MarinGE23/axi-plpuf-ip/README.md

# axi-plpuf-ip
AXI4-Lite PLPUF IP for Xilinx/AMD FPGAs — Verilog core, C drivers, Vivado/Vitis projects, and validation apps for hardware security and embedded systems.
