MarinGE23/axi-plpuf-ip/vivado-axi-plpuf/vivado-axi-plpuf.runs/design_1_clk_wiz_0_0_synth_1/.vivado.begin.rst

<?xml version="1.0"?>
<ProcessHandle Version="1" Minor="0">
    <Process Command="vivado.bat" Owner="emari" Host="EMANUEL" Pid="20808" HostCore="8" HostMemory="014968041472">
    </Process>
</ProcessHandle>
