MarinGE23/axi-plpuf-ip/documento_tfg_emanuel_marin_overleaf/Documento_TFG_EmanuelMarin/agradecimientos.tex

%% ---------------------------------------------------------------------------
%% agradecimientos.tex
%% Agradecimientos
%% ---------------------------------------------------------------------------

\thispagestyle{empty}
\cleardoublepage

\begin{center}
  \vspace*{1.5cm}
  {\Huge\bfseries Agradecimientos}
\end{center}

\vspace{1.5cm}

A mi querida mamá, a mi familia y a mis amigos, por su apoyo incondicional a lo
largo de toda mi formación universitaria. Su confianza y paciencia fueron el
motor que me permitió llegar hasta aquí.

A los profesores de la Escuela de Ingeniería en Computadores y la Escuela de
Ingeniería en Electrónica del Instituto Tecnológico de Costa Rica, quienes con
su dedicación y exigencia me transmitieron no solo conocimientos técnicos, sino
también la disciplina y la curiosidad necesarias para enfrentar problemas
complejos. Cada curso, cada laboratorio y cada proyecto contribuyó a forjar al
ingeniero que soy hoy.

Agradezco especialmente al Dr.\ Jeferson González Gómez, quien me asignó este
trabajo final de graduación y confió en mis capacidades para llevarlo a cabo. Su
conocimiento en el área de seguridad de hardware fue
determinante para definir el rumbo del proyecto. 

A todos quienes de una u otra forma contribuyeron a la realización de este
proyecto, mi más sincero agradecimiento.

\vspace*{\fill}

\begin{flushright}
\scriptAuthor\\[1mm]
Cartago, June, 2026
\end{flushright}

\cleardoublepage

%%% Local Variables:
%%% mode: latex
%%% TeX-master: "main"
%%% End:
