MarinGE23/axi-plpuf-ip/documento_tfg_emanuel_marin_overleaf/Documento_TFG_EmanuelMarin/titlepage.tex

%% ---------------------------------------------------------------------------
%% titlepage.tex
%%
%% Title page
%%
%% $Id: titlepage.tex 1452 2010-07-07 00:55:16Z palvarado $
%% ---------------------------------------------------------------------------

\thispagestyle{empty} 

\begin{center}

{\large\bf{Tecnológico de Costa Rica}}

\par\vspace{15mm}

{\large\bf{Escuela de Ingeniería en Computadores}}\\
{\normalsize (Computer Engineering School)}

\par\vspace{20mm}

{\large\bf{Programa de Licenciatura en Ingeniería en Computadores}} \\
{\normalsize (Licentiate Degree Program in Computer Engineering)}

\par\vspace{15mm}



\par\vspace*{\fill}

{\large\bf{Diseño e Integración de un Módulo PLPUF Programable para Sistemas Embebidos}}
\\
{\normalsize (Design and Integration of a Programmable PLPUF Module for Embedded Systems)}

\par\vspace*{\fill}

{\large \bf{Informe de Trabajo de Graduación para optar por el título de Ingeniero en Computadores con grado académico de Licenciatura}}\\
{\scriptsize(Report of Graduation Work in fulfillment of the requirements for the degree of Licentiate in Computer Engineering)}

\par\vspace{20mm}

\large \bf{Emanuel Antonio Marín Gutiérrez}
\vspace*{\fill}

\normalsize {Cartago, Junio, 2026} \\
\scriptsize {(Cartago, June, 2026)}

\end{center}
%\newpage 
%\cleardoublepage 

%%% Local Variables: 
%%% mode: latex
%%% TeX-master: "main"
%%% End:
