MarinGE23/axi-plpuf-ip/documento_tfg_emanuel_marin_overleaf/Documento_TFG_EmanuelMarin/acta.tex

\thispagestyle{empty}

%%
%% Los nombres de lectores y asesor se definen en el archivo tribunal.tex
%%

\begin{center}
  \begin{tabular}{c}
    Instituto Tecnológico de Costa Rica \\
    Escuela de Ingeniería en Computadores \\
    Proyecto de Graduación \\
    Tribunal Evaluador \\
    Acta de Evaluación
  \end{tabular}
\end{center}

\vfill

Proyecto de Graduación defendido ante el presente Tribunal Evaluador como 
requisito para optar por el título de Ingeniero en Computadores con el grado 
académico de Licenciatura, del Instituto Tecnológico de Costa Rica.

\vspace*{15mm}

\begin{center}
  Estudiante: \\
  \emph{Emanuel Antonio Marín Gutiérrez}
\end{center}

\vfill

\begin{center}
  Nombre del Proyecto:\\ \emph{name_here}
\end{center}

\vspace*{20mm}
\begin{center}
 Miembros del Tribunal
\end{center}
\vspace*{8mm}

\vfill

\begin{center}
  \begin{tabular}{ccc}
    \rule{70mm}{0.5pt} & \rule{15mm}{0pt} & \rule{70mm}{0.5pt} \\
    \lectorI && \lectorII \\ %% Nombres definidos en tribunal.tex
    Profesor Lector && Profesor Lector
  \end{tabular}
  
  \vspace{10mm}

  \begin{tabular}{c}
    \rule{6cm}{0.5pt} \\
    \director \\ %% Definido en tribunal.tex
    Profesor Asesor
  \end{tabular}
\end{center}

\vfill

Los miembros de este Tribunal dan fe de que el presente trabajo de graduación
ha sido aprobado y cumple con las normas establecidas por la Escuela de Ingeniería en Computadores.

\vfill

\begin{center}
  Nota final del Proyecto de Graduación: \rule{3cm}{0.5pt}
\end{center}
\vfill

\begin{center}
  Cartago, Julio de 2026\par
\end{center}

\cleardoublepage

%%% Local Variables: 
%%% mode: latex
%%% TeX-master: "main"
%%% End:
