MarinGE23/axi-plpuf-ip/documento_tfg_emanuel_marin_overleaf/Documento_TFG_EmanuelMarin/disclaimer.tex

%\thispagestyle{empty}

\rule{10mm}{0pt}

\vfill

Declaro que el presente Proyecto de Graduación ha sido realizado enteramente por mi persona, utilizando y aplicando literatura referente al tema e introduciendo conocimientos propios.

En los casos en que he utilizado bibliografía he procedido a indicar las fuentes mediante las respectivas citas bibliográficas.  En consecuencia, asumo la responsabilidad total por el trabajo de graduación realizado y por el contenido del presente documento.

\vspace*{8mm}
\hfill
\vspace*{-10mm}
\begin{flushright}
\rule{60mm}{0.1pt} \\
\vspace*{5mm}
  Emanuel Antonio Marín Gutiérrez\par
    Céd: 7-0274-0530\par
  Cartago, [fecha]

\end{flushright}

\cleardoublepage

%%% Local Variables: 
%%% mode: latex
%%% TeX-master: "main"
%%% End:
