MarinGE23/axi-plpuf-ip/documento_tfg_emanuel_marin_overleaf/Documento_TFG_EmanuelMarin/Calificacion.tex

\vspace{3cm}
\includepdf[pages={1},scale=1.05,keepaspectratio, offset=70 -100]{acta_firmada/acta_firmada.pdf}
%\textbf{Pagina Reservada}
