MarinGE23/axi-plpuf-ip/documento_tfg_emanuel_marin_overleaf/Documento_TFG_EmanuelMarin/tribunal.tex

\thispagestyle{empty}

%%
%% Indique los nombres de los lectores y asesor
\newcommand{\lectorI}{name_here}
\newcommand{\lectorII}{name_here}
\newcommand{\director}{name_here}
%% Revise además que 

\begin{center}
  \begin{tabular}{c}
    Instituto Tecnológico de Costa Rica \\
    Escuela de Ingeniería en Computadores \\
    Proyecto de Graduación \\
    Tribunal Evaluador
  \end{tabular}
\end{center}

\vfill

Proyecto de Graduación defendido ante el presente Tribunal Evaluador como 
requisito para optar por el título de Ingeniero en Computadores con el grado 
académico de Licenciatura, del Instituto Tecnológico de Costa Rica.  

\vfill

\vspace*{20mm}
\begin{center}
 Miembros del Tribunal
\end{center}
\vspace*{8mm}

\vfill

\begin{center}
  \begin{tabular}{ccc}
    \rule{70mm}{0.5pt} & \rule{15mm}{0pt} & \rule{70mm}{0.5pt} \\
    \lectorI && \lectorII \\
    Profesor Lector && Profesor Lector
  \end{tabular}
  
  \vspace{10mm}

  \begin{tabular}{c}
    \rule{6cm}{0.5pt} \\
    \director \\
    Profesor Asesor
  \end{tabular}
\end{center}

\vfill

Los miembros de este Tribunal dan fe de que el presente trabajo de graduación
ha sido aprobado y cumple con las normas establecidas por el Área Académica de Ingeniería en Computadores.

\vfill

\begin{center}
  Cartago, Junio 2020\par
\end{center}

%\cleardoublepage

%%% Local Variables: 
%%% mode: latex
%%% TeX-master: "main"
%%% End:
