MarinGE23/axi-plpuf-ip/vivado-axi-plpuf/vivado-axi-plpuf.runs/impl_1/clockInfo.txt

-------------------------------------
| Tool Version : Vivado v.2025.1
| Date         : Thu Apr  2 01:15:43 2026
| Host         : Emanuel
| Design       : design_1
| Device       : xc7a35t-cpg236-1--
-------------------------------------

For more information on clockInfo.txt clock routing debug file see https://support.xilinx.com/s/article/000035660?language=en_US
