MarinGE23/axi-plpuf-ip/documento_tfg_emanuel_marin_overleaf/Documento_TFG_EmanuelMarin/solucion.tex

%% ---------------------------------------------------------------------------
%% solucion.tex
%% Marco metodológico
%% ---------------------------------------------------------------------------

\chapter{Marco metodológico}
\label{ch:solucion}

Este capítulo describe la metodología empleada para el diseño,
implementación, integración y evaluación del módulo PLPUF como
periférico AXI dentro de un \textit{System-on-Chip} basado en MicroBlaze~V.
Se presenta, en primer lugar, la estrategia metodológica adoptada y su
justificación; a continuación, el diagrama de la secuencia del proceso
seguido y la propuesta metodológica desglosada por objetivo específico;
seguidamente, las herramientas de desarrollo utilizadas y el diagrama
general de la solución; y, finalmente, las decisiones de diseño en cada
etapa del proyecto (módulo HDL, interfaz AXI, integración SoC, software
y protocolo de evaluación).

% ============================================================================
\section{Estrategia metodológica}
\label{sec:estrategia}
% ============================================================================

El desarrollo de sistemas digitales integrados que abarcan desde el
diseño de hardware hasta el software embebido y la validación experimental
requiere una estrategia metodológica que garantice la trazabilidad entre
los entregables y la verificación progresiva de cada componente. Dentro
de las aproximaciones disponibles en la ingeniería de sistemas, el modelo
secuencial por fases, también conocido como modelo en cascada, se
caracteriza por organizar el desarrollo en etapas lineales, donde cada
fase produce artefactos verificables que constituyen la entrada directa
de la fase siguiente~\cite{ug994}.

A diferencia de los modelos iterativos o ágiles, que favorecen la
entrega incremental y la retroalimentación temprana del usuario, el
modelo secuencial resulta especialmente adecuado cuando los requisitos
están bien definidos desde el inicio y existe una dependencia estricta
entre los entregables de cada etapa. En el contexto de este proyecto,
la relación de precedencia es clara: el módulo HDL del PLPUF (Fase~1)
es prerrequisito de la interfaz AXI4-Lite (Fase~2); la interfaz
empaquetada como IP es necesaria para la integración del SoC (Fase~3);
y el sistema completo y funcional es indispensable para la evaluación
estadística (Fase~4). Un modelo iterativo habría introducido riesgos de
retrabajo sin beneficio significativo, dado que el alcance del proyecto
estaba bien definido desde el anteproyecto y no se requería la
participación de usuarios finales durante el desarrollo.

Por estas razones, se adoptó una metodología secuencial por
fases organizada en cuatro etapas, cada una alineada con un objetivo
específico del proyecto. La ejecución siguió el orden estricto
Fase~1~$\rightarrow$~Fase~2~$\rightarrow$~Fase~3~$\rightarrow$~Fase~4,
con puntos de verificación al final de cada fase para confirmar que los
entregables satisfacían los criterios de aceptación antes de avanzar a
la siguiente. La verificación en cada punto incluyó revisiones de
simulación, pruebas de síntesis, pruebas de integración y análisis
estadístico, según correspondiera a la naturaleza de los entregables.

% ============================================================================
\section{Diagrama de la secuencia del proceso}
\label{sec:secuencia}
% ============================================================================

La Figura~\ref{fig:methodology_phases} ilustra las cuatro fases del
proyecto, sus relaciones de dependencia y los entregables asociados a
cada fase. Cada fase se alinea con un objetivo específico (OE) y genera
artefactos verificables que habilitan la fase subsiguiente.

\begin{figure}[h]
  \centering
  \begin{tikzpicture}[
      font=\small,
      phase/.style={
        rectangle, draw=black!70, thick, rounded corners=2pt,
        minimum width=3cm, minimum height=1.4cm,
        fill=blue!8, align=center
      },
      deliv/.style={
        rectangle, draw=black!50, dashed,
        minimum width=3cm, minimum height=1.4cm,
        fill=gray!5, align=center, font=\scriptsize
      },
      arrow/.style={-{Latex[length=2.5mm,width=2mm]}, thick, black!70},
      darrow/.style={-{Latex[length=2mm,width=1.6mm]}, dashed, black!50}
    ]
    \node[phase] (f1) at (0,0)    {\textbf{Fase 1}\\Diseño HDL\\\footnotesize(OE1)};
    \node[phase] (f2) at (3.6,0)  {\textbf{Fase 2}\\Interfaz AXI\\\footnotesize(OE2)};
    \node[phase] (f3) at (7.2,0)  {\textbf{Fase 3}\\Integración SoC\\\footnotesize(OE3)};
    \node[phase] (f4) at (10.8,0) {\textbf{Fase 4}\\Evaluación\\\footnotesize(OE4)};

    \draw[arrow] (f1) -- (f2);
    \draw[arrow] (f2) -- (f3);
    \draw[arrow] (f3) -- (f4);

    \node[deliv] (d1) at (0,-2.6)    {Código Verilog\\Reportes síntesis\\Simulación};
    \node[deliv] (d2) at (3.6,-2.6)  {Esclavo AXI4-Lite\\Mapa de registros\\IP empaquetado};
    \node[deliv] (d3) at (7.2,-2.6)  {\textit{Block design}\\\textit{Bitstream}\\\textit{Firmware} en C};
    \node[deliv] (d4) at (10.8,-2.6) {\textit{Dataset} CRPs\\Métricas\\Figuras y análisis};

    \draw[darrow] (f1) -- (d1);
    \draw[darrow] (f2) -- (d2);
    \draw[darrow] (f3) -- (d3);
    \draw[darrow] (f4) -- (d4);

    \node[font=\scriptsize\itshape, anchor=east, rotate=90] at (-2.2,-1.3) {Entregables};
  \end{tikzpicture}
  \caption{Metodología secuencial por fases del proyecto. Cada fase se
    alinea con un objetivo específico (OE) y produce entregables verificables
    que habilitan la fase siguiente.}
  \label{fig:methodology_phases}
\end{figure}

Las cuatro fases se describen a continuación:

\paragraph{Fase~1 -- Diseño del módulo PLPUF en HDL (OE1).}
Se implementó el núcleo PLPUF en Verilog siguiendo la arquitectura propuesta
por Hori~et~al.~\cite{hori_2011_pseudolfsr}. Esta fase incluyó la
definición de los parámetros del diseño, la implementación de la cadena de
inversores y la máquina de estados finitos, la simulación funcional y la
verificación de la síntesis con las restricciones necesarias para preservar
el lazo combinacional.

\paragraph{Fase~2 -- Desarrollo de la interfaz AXI4-Lite (OE2).}
A partir del módulo HDL validado en la fase anterior, se desarrolló la
interfaz esclava AXI4-Lite que expone el PLPUF como periférico controlable
por software. Se definió el mapa de registros, se implementó la lógica de
lectura/escritura y se empaquetó el conjunto como un núcleo IP reutilizable.

\paragraph{Fase~3 -- Integración del sistema SoC (OE3).}
Con el IP empaquetado, se construyó el sistema completo en Vivado
IP~Integrator: procesador MicroBlaze~V, memoria BRAM, UART, módulo de
depuración y el periférico PLPUF. Se generó el \textit{bitstream}, se
exportó el diseño a Vitis y se desarrolló el \textit{firmware} de control en
lenguaje~C, incluyendo el \textit{driver} y las aplicaciones de prueba.

\paragraph{Fase~4 -- Evaluación estadística (OE4).}
Finalmente, sobre el sistema funcional se ejecutó el protocolo de evaluación
exhaustiva: 10~corridas independientes con 20~desafíos, 50~repeticiones y
10~duraciones de activación, acumulando más de 140\,000~evaluaciones. Se
calcularon las métricas de uniformidad, confiabilidad, distancia de Hamming y
efecto avalancha, y se compararon los resultados con la literatura de
referencia.

% ============================================================================
\section{Propuesta metodológica por objetivo}
\label{sec:metodologia_obj}
% ============================================================================

La Tabla~\ref{tab:metodologia} resume la relación detallada entre cada
objetivo específico, las actividades principales realizadas, los
entregables esperados, las herramientas empleadas y las estrategias de
verificación y validación aplicadas.

\begin{table}[htbp]
\centering
\caption{Propuesta metodológica por objetivo específico.}
\label{tab:metodologia}
\small
\renewcommand{\arraystretch}{1.3}
\begin{tabular}{|p{3.0cm}|p{3.0cm}|p{2.5cm}|p{2.5cm}|p{2.5cm}|}
\hline
\textbf{Objetivo específico} &
\textbf{Actividades principales} &
\textbf{Entregables} &
\textbf{Herramientas} &
\textbf{Verificación} \\
\hline

OE1: Implementar el módulo PLPUF en HDL con ancho parametrizable. &
Definir arquitectura PLPUF.\newline
Implementar en Verilog.\newline
Simulación y síntesis.\newline
Optimización de recursos. &
Código HDL del PLPUF.\newline
Reportes de síntesis.\newline
Resultados de simulación. &
Vivado.\newline
Verilog.\newline
\textit{Testbenches}. &
Simulación funcional.\newline
Revisión de tiempos y uso de recursos. \\
\hline

OE2: Desarrollar una interfaz AXI-\textit{slave} para el control del módulo. &
Diseño del mapa de registros.\newline
Implementación AXI-\textit{slave}.\newline
Integración preliminar.\newline
Pruebas de lectura/escritura. &
Módulo AXI-\textit{slave} funcional.\newline
Mapa de registros documentado. &
Vivado IP Integrator.\newline
Plantilla AXI4-Lite. &
Validación con simulación AXI.\newline
Pruebas de comunicación con software. \\
\hline

OE3: Integrar el módulo en un sistema embebido completo con MicroBlaze~V. &
Construcción del SoC.\newline
Conexión del PLPUF vía AXI.\newline
Generación del \textit{bitstream}.\newline
Desarrollo de software en Vitis. &
Sistema SoC funcional.\newline
Software de control.\newline
\textit{Bitstream} final. &
Vivado.\newline
Vitis.\newline
UART.\newline
MicroBlaze~V. &
Comunicación serial exitosa.\newline
Depuración con Vitis. \\
\hline

OE4: Evaluar el PLPUF con métricas de seguridad. &
Pruebas masivas de desafío-respuesta.\newline
Automatización de recolección.\newline
Análisis estadístico.\newline
Comparación con métricas esperadas. &
\textit{Dataset} de respuestas.\newline
Informe de evaluación.\newline
Gráficos y análisis. &
\textit{Scripts} en C.\newline
Python.\newline
Software de prueba. &
Verificación repetida de muestras.\newline
Análisis estadístico.\newline
Revisión de consistencia. \\
\hline
\end{tabular}
\end{table}

% ============================================================================
\section{Herramientas de desarrollo}
\label{sec:herramientas}
% ============================================================================

A continuación se describen las herramientas de hardware y software empleadas
en el proyecto. La selección de cada herramienta se fundamenta en los
requisitos del diseño y en la disponibilidad de recursos proporcionados por
la Escuela de Ingeniería en Computadores del TEC.

% ---------------------------------------------------------------------------
\subsection{Hardware: placa Basys\,3}
\label{sec:hw_basys3}

La plataforma de desarrollo seleccionada es la placa Basys\,3 de Digilent,
descrita en la Sección~\ref{sec:artix7}. Su FPGA Artix-7
(\texttt{XC7A35T-1CPG236C}) ofrece recursos suficientes para instanciar el
procesador MicroBlaze~V junto con el periférico PLPUF y los módulos
auxiliares (UART, controlador de memoria, gestión de reloj). El oscilador de
100\,MHz integrado en la placa proporciona la frecuencia base del sistema, y
el puerto USB-UART permite la comunicación serial con el computador anfitrión
para la extracción de datos de prueba~\cite{basys3rm}.

La placa fue proporcionada por la Escuela de Ingeniería en Computadores y
constituye la única plataforma física de evaluación, lo que implica que los
resultados experimentales corresponden a un único dispositivo FPGA
\cite{wilde_2020_confidence}.

% ---------------------------------------------------------------------------
\subsection{AMD Vivado Design Suite}
\label{sec:hw_vivado}

AMD Vivado Design Suite (versión 2025.1) se utilizó para
todas las tareas de diseño de hardware: creación del \textit{block design}
con IP~Integrator, empaquetado del IP personalizado del PLPUF, síntesis
lógica, implementación física (\textit{place and route}), verificación de
restricciones temporales y generación del \textit{bitstream}~\cite{ug994}.
Vivado también se empleó para la definición de restricciones de síntesis
específicas del PLPUF (lazos combinacionales, atributos \texttt{DONT\_TOUCH})
mediante archivos XDC~\cite{ug1037}.

% ---------------------------------------------------------------------------
\subsection{AMD Vitis}
\label{sec:hw_vitis}

AMD Vitis Unified Software Platform (versión 2025.1) se empleó para el
desarrollo del software embebido. A partir del archivo \texttt{.xsa}
exportado por Vivado, Vitis genera automáticamente la plataforma de hardware,
el \textit{Board Support Package} (BSP) y los controladores de periféricos
\cite{ug1701}. Las aplicaciones de prueba se desarrollaron en lenguaje~C,
compiladas con la cadena de herramientas \texttt{riscv64-unknown-elf-gcc}
incluida en Vitis. La carga del \textit{bitstream} y del ejecutable en la
FPGA se realizó a través de JTAG mediante el puerto USB~J4 de la
Basys\,3~\cite{ug1701}.

% ---------------------------------------------------------------------------
\subsection{Terminal serial y Python}
\label{sec:hw_terminal}

La comunicación entre la FPGA y el computador anfitrión se realizó mediante
el periférico AXI UART~Lite configurado a 9\,600~baudios. Para la captura de
los datos de salida del sistema se utilizó un emulador de terminal serial
(PuTTY). Los datos recolectados en formato texto fueron
procesados posteriormente con \textit{scripts} en Python para generar
gráficos y cálculos estadísticos complementarios.

% ============================================================================
\section{Diagrama general de la solución}
\label{sec:diagrama_general}
% ============================================================================

La
Figura~\ref{fig:system_diagram} muestra el diagrama general del sistema,
donde los componentes se agrupan por colores según su función: en
\textcolor{blue!70}{\textbf{azul}} los componentes del SoC (procesador,
memoria e interconexión), en \textcolor{green!60!black}{\textbf{verde}} el
periférico PLPUF desarrollado en este proyecto, en
\textcolor{orange!80!black}{\textbf{naranja}} los elementos de comunicación
serial y en \textcolor{red!60!black}{\textbf{rojo}} el computador anfitrión
externo. Los números circundados indican el flujo de operación descrito a
continuación.

\begin{figure}[htbp]
  \centering
  \scalebox{0.80}{%
  \begin{tikzpicture}[
      font=\small,
      soc/.style={rectangle, draw=blue!60, thick, fill=blue!6,
        minimum width=2.4cm, minimum height=1.1cm, align=center,
        rounded corners=2pt},
      plpuf/.style={rectangle, draw=green!60!black, thick, fill=green!8,
        minimum width=2.4cm, minimum height=1.1cm, align=center,
        rounded corners=2pt},
      comm/.style={rectangle, draw=orange!70, thick, fill=orange!8,
        minimum width=2.4cm, minimum height=1.1cm, align=center,
        rounded corners=2pt},
      ext/.style={rectangle, draw=red!50, thick, fill=red!6,
        minimum width=2.8cm, minimum height=1.4cm, align=center,
        rounded corners=2pt},
      arrow/.style={-{Latex[length=2.5mm,width=2mm]}, thick, black!70},
      biarrow/.style={{Latex[length=2.5mm,width=2mm]}-{Latex[length=2.5mm,width=2mm]},
        thick, black!70},
      step/.style={circle, draw=black!70, fill=white, inner sep=1pt,
        font=\scriptsize\bfseries, minimum size=14pt}
    ]
    % --- Computador anfitrión ---
    \node[ext] (pc) at (-6.5, 0) {
      \textbf{Computador}\\
      \textbf{anfitrión}\\[-1pt]
      \scriptsize Terminal serial\\[-2pt]
      \scriptsize Scripts Python
    };
    % --- SoC boundary ---
    \draw[dashed, thick, black!40, rounded corners=6pt]
      (-2.6, -4.0) rectangle (8.8, 3.2);
    \node[font=\footnotesize\itshape, anchor=north west, black!50]
      at (-2.5, 3.1) {SoC -- FPGA Artix-7};
    % --- SoC components ---
    \node[soc] (mbv)  at (2.0,  2.0) {
      \textbf{MicroBlaze~V}\\
      \scriptsize RV32I, 100\,MHz
    };
    \node[soc] (bram) at (6.0,  2.0) {
      \textbf{BRAM}\\
      \scriptsize 64\,KB
    };
    \node[soc] (smc)  at (2.0,  0.0) {
      \textbf{SmartConnect}\\
      \scriptsize AXI4-Lite
    };
    \node[soc, minimum width=1.6cm, minimum height=0.7cm]
                (mdm) at (6.8,  0.0) {\scriptsize\textbf{MDM~V}};
    \node[comm] (uart) at (-0.2, -2.4) {
      \textbf{UART Lite}\\
      \scriptsize 9600 baud
    };
    \node[plpuf] (puf) at (5.2, -2.4) {
      \textbf{AXI PLPUF}\\
      \scriptsize 128 bits
    };
    % --- Connections ---
    \draw[biarrow] (mbv)  -- node[above, font=\scriptsize] {LMB} (bram);
    \draw[biarrow] (mbv)  -- node[right, font=\scriptsize] {M\_AXI\_DP} (smc);
    \draw[biarrow] (smc)  -| (uart);
    \draw[biarrow] (smc)  -| (puf);
    \draw[biarrow] (mbv)  -- (mdm);
    % --- UART to PC ---
    \draw[biarrow] (pc) -- node[above, font=\scriptsize] {USB-UART} (uart);
    % --- Flow numbers ---
    \node[step] at (2.0, -0.85)  {1};
    \node[step] at (5.2, -0.85)  {2};
    \node[step] at (5.2, -3.3)   {3};
    \node[step] at (-0.2, -0.85) {4};
    \node[step] at (-4.4,  0.0)  {5};
  \end{tikzpicture}%
  }
  \caption{Diagrama general de la solución: sistema SoC con PLPUF integrado.
    Los colores agrupan los componentes por función y los números indican el
    flujo de operación.}
  \label{fig:system_diagram}
\end{figure}

El sistema se compone de los siguientes grupos de componentes:

\begin{itemize}
  \item \textbf{Componentes del SoC} (\textcolor{blue!70}{\textbf{azul}}): el
    procesador suave MicroBlaze~V ejecuta el software de control; la memoria
    BRAM almacena instrucciones y datos; el AXI SmartConnect interconecta el
    procesador con los periféricos; y el módulo de depuración MDM~V permite
    la carga de programas vía JTAG.

  \item \textbf{Periférico PLPUF} (\textcolor{green!60!black}{\textbf{verde}}): el
    módulo desarrollado en este proyecto, conectado como esclavo AXI4-Lite al
    SmartConnect. Contiene la cadena de inversores generadora de entropía, la
    FSM de control y los registros de interfaz.

  \item \textbf{Comunicación} (\textcolor{orange!80!black}{\textbf{naranja}}): el
    periférico AXI UART~Lite transmite los resultados al exterior a través
    del puerto USB-UART de la Basys\,3.

  \item \textbf{Computador anfitrión} (\textcolor{red!60!black}{\textbf{rojo}}):
    recibe los datos por terminal serial y ejecuta los \textit{scripts} de
    Python para el análisis estadístico.
\end{itemize}

El flujo de operación, indicado por los números circundados en la
Figura~\ref{fig:system_diagram}, es el siguiente:

\begin{enumerate}
  \item[\ding{1}] El software embebido, ejecutándose en MicroBlaze~V, genera un
    desafío de 128~bits y una duración de activación~$c$, y los envía al
    periférico PLPUF a través del bus AXI4-Lite vía el SmartConnect.

  \item[\ding{2}] El SmartConnect enruta la transacción AXI hacia el periférico
    PLPUF, donde se escribe el desafío en los registros CHAL\_0 a
    CHAL\_3, la duración en DURATION y el bit de inicio en CTRL.

  \item[\ding{3}] El núcleo \texttt{plpuf\_core} ejecuta la secuencia FSM:
    \texttt{LOAD} (1~ciclo) $\rightarrow$ \texttt{ACTIVE} ($c$~ciclos)
    $\rightarrow$ \texttt{DONE} (1~ciclo), capturando la respuesta de
    128~bits en los registros RESP\_0 a RESP\_3.

  \item[\ding{4}] El software lee la respuesta y la transmite al computador
    anfitrión a través de la UART.

  \item[\ding{5}] En el computador anfitrión, los datos son capturados por un
    emulador de terminal serial y procesados con \textit{scripts} de Python
    para generar las métricas de evaluación y los gráficos correspondientes.
\end{enumerate}

Este flujo se repite de forma automatizada para todas las combinaciones de
desafíos y duraciones definidas en el protocolo de evaluación
(Sección~\ref{sec:protocolo}), permitiendo la recolección sistemática de los
datos necesarios para la caracterización completa del PLPUF.

Las secciones siguientes describen en detalle el diseño de cada componente
del sistema, comenzando por el núcleo PLPUF, luego la interfaz AXI4-Lite, la
integración del SoC, el software de control y, finalmente, el protocolo de
evaluación.

% ============================================================================
\section{Diseño del módulo PLPUF en HDL}
\label{sec:diseno_plpuf}
% ============================================================================

Esta sección describe las decisiones de diseño adoptadas para la
implementación del núcleo PLPUF en Verilog, correspondiente al archivo
\texttt{plpuf\_core.v}. El diseño sigue la arquitectura propuesta por
Hori~et~al.~\cite{hori_2011_pseudolfsr} y descrita en la
Sección~\ref{sec:plpuf}.

% ---------------------------------------------------------------------------
\subsection{Visión general del módulo}
\label{sec:plpuf_overview}

La Figura~\ref{fig:plpuf_blackbox} presenta el diagrama de primer nivel del
módulo \texttt{plpuf\_core}, mostrando su interfaz externa como caja negra.

\begin{figure}[htbp]
  \centering
  \scalebox{0.80}{%
  \begin{tikzpicture}[
      font=\small,
      port/.style={font=\scriptsize\ttfamily},
      arrow/.style={-{Latex[length=2mm,width=1.5mm]}, thick, black!70}
    ]
    % Main module box
    \draw[thick, fill=blue!5, rounded corners=3pt]
      (0, 0) rectangle (5.5, -5.5);
    \node[font=\normalsize\bfseries] at (2.75, -0.4) {plpuf\_core};
    \draw[thick, black!30] (0, -0.8) -- (5.5, -0.8);

    % Input ports (left side)
    \foreach \y/\name/\width in {
      -1.3/clk/1,
      -2.0/rst\_n/1,
      -2.7/challenge/128,
      -3.4/activation\_duration/16,
      -4.1/start/1%
    }{
      \draw[arrow] (-2.2, \y) -- (0, \y);
      % bus-width sobre la flecha, fuera del cuadro
      \node[port, anchor=south, black!50] at (-1.1, \y) {[\width]};
      % nombre de la señal dentro del cuadro, pegado al borde izquierdo
      \node[port, anchor=west] at (0.15, \y) {\name};
    }

    % Output ports (right side)
    \foreach \y/\name/\width in {
      -1.8/response/128,
      -3.0/done/1,
      -3.7/busy/1%
    }{
      \draw[arrow] (5.5, \y) -- (7.7, \y);
      % bus-width sobre la flecha, fuera del cuadro
      \node[port, anchor=south, black!50] at (6.6, \y) {[\width]};
      % nombre de la señal dentro del cuadro, pegado al borde derecho
      \node[port, anchor=east] at (5.35, \y) {\name};
    }

    % Labels
    \node[font=\scriptsize\itshape, black!50] at (-1.2, -5.0) {Entradas};
    \node[font=\scriptsize\itshape, black!50] at (6.7, -5.0) {Salidas};
  \end{tikzpicture}%
  }
  \caption{Diagrama de primer nivel del módulo \texttt{plpuf\_core}: interfaz
    de puertos con anchos de señal.}
  \label{fig:plpuf_blackbox}
\end{figure}

La Tabla~\ref{tab:plpuf_ports} describe en detalle cada puerto de la
interfaz.

\begin{table}[htbp]
\centering
\caption{Interfaz de puertos del módulo \texttt{plpuf\_core}.}
\label{tab:plpuf_ports}
\begin{tabular}{lclp{7cm}}
\hline
\textbf{Puerto} & \textbf{Ancho} & \textbf{Dir.} & \textbf{Descripción} \\
\hline
\texttt{clk}                  & 1   & E & Reloj del sistema. \\
\texttt{rst\_n}               & 1   & E & \textit{Reset} activo en bajo. \\
\texttt{challenge}            & 128 & E & Desafío de entrada. \\
\texttt{activation\_duration} & 16  & E & Ciclos de oscilación libre ($c$). \\
\texttt{start}                & 1   & E & Pulso de inicio de evaluación. \\
\texttt{response}             & 128 & S & Respuesta generada por el PLPUF. \\
\texttt{done}                 & 1   & S & Pulso de un ciclo al completar. \\
\texttt{busy}                 & 1   & S & Evaluación en curso. \\
\hline
\end{tabular}
\end{table}

El protocolo de operación es sencillo: el maestro escribe el desafío de
128~bits y la duración de activación, emite un pulso en \texttt{start} y
espera a que \texttt{done} se active. Al finalizar, la respuesta de
128~bits está disponible en el puerto \texttt{response}.

El diseño es parametrizable para facilitar su adaptación a diferentes anchos
y polinomios primitivos. La Tabla~\ref{tab:params} resume los cinco
parámetros disponibles y sus valores por defecto.

\begin{table}[htbp]
\centering
\caption{Parámetros configurables del módulo \texttt{plpuf\_core}.}
\label{tab:params}
\begin{tabular}{llp{7cm}}
\hline
\textbf{Parámetro} & \textbf{Valor} & \textbf{Descripción} \\
\hline
\texttt{WIDTH}          & 128 & Ancho en bits del PLPUF (tamaño del desafío y la respuesta). \\
\texttt{DURATION\_BITS} & 16  & Ancho del contador de duración de activación, permite hasta $2^{16}-1 = 65\,535$ ciclos. \\
\texttt{TAP\_1}         & 125 & Posición del primer \textit{tap} XOR (corresponde al término $x^{126}$ del polinomio). \\
\texttt{TAP\_2}         & 101 & Posición del segundo \textit{tap} XOR ($x^{102}$). \\
\texttt{TAP\_3}         & 98  & Posición del tercer \textit{tap} XOR ($x^{99}$). \\
\hline
\end{tabular}
\end{table}

Las posiciones de \textit{tap} corresponden al polinomio primitivo
$p(x) = x^{128} + x^{126} + x^{102} + x^{99} + 1$, el mismo utilizado en la
propuesta original~\cite{hori_2011_pseudolfsr}.

Internamente, el módulo se compone de dos bloques funcionales:

\begin{itemize}
  \item \textbf{Cadena de inversores con retroalimentación XOR:} constituye
    el elemento generador de entropía, aprovechando las variaciones físicas
    del silicio (Sección~\ref{sec:cadena}).
  \item \textbf{Máquina de estados finitos (FSM) de 4~estados:} controla las
    fases de carga del desafío, oscilación libre y captura de la respuesta
    (Sección~\ref{sec:fsm_impl}).
\end{itemize}

% ---------------------------------------------------------------------------
\subsection{Cadena de inversores y retroalimentación}
\label{sec:cadena}

La cadena de inversores constituye el núcleo generador de entropía del
PLPUF. Se compone de 128~celdas idénticas, generadas mediante un bloque
\texttt{generate} de Verilog. Cada celda contiene un multiplexor y un
inversor: durante la fase de carga, el multiplexor selecciona el bit
correspondiente del desafío; durante la fase activa, selecciona la señal de
retroalimentación del vecino, cerrando así el lazo combinacional.

La retroalimentación sigue la topología Fibonacci: la mayoría de las celdas
reciben la salida de la celda adyacente, mientras que las celdas en las
posiciones de \textit{tap} (125, 101 y 98) reciben una XOR entre la salida
de su vecina y la de la celda~0, reproduciendo el polinomio primitivo de
128~bits. Esta estructura forma un lazo puramente combinacional (sin
registros de desplazamiento) que oscila libremente durante la fase activa,
generando la entropía a partir de las variaciones de retardo del
silicio~\cite{hori_2011_pseudolfsr}.

% ---------------------------------------------------------------------------
\subsection{Máquina de estados finitos}
\label{sec:fsm_impl}

El control del PLPUF se implementó mediante una FSM de cuatro estados
codificada en 2~bits, cuyo diagrama de transiciones se muestra en la
Figura~\ref{fig:plpuf_fsm}. La secuencia de operación es la siguiente:

\begin{enumerate}
  \item \textbf{\texttt{S\_IDLE}:} estado de reposo. Al recibir el pulso
    \texttt{start}, la FSM almacena el desafío y la duración de activación, y
    transiciona a la fase de carga.

  \item \textbf{\texttt{S\_LOAD}:} el desafío se propaga a través de la
    cadena de inversores durante un ciclo de reloj, estableciendo el estado
    inicial del lazo.

  \item \textbf{\texttt{S\_ACTIVE}:} la retroalimentación se cierra y la
    cadena oscila libremente durante $c$~ciclos. Al finalizar, el estado de la
    cadena se captura como respuesta.

  \item \textbf{\texttt{S\_DONE}:} se emite el pulso \texttt{done} y la FSM
    retorna a reposo.
\end{enumerate}

% ---------------------------------------------------------------------------
\subsection{Restricciones de síntesis}
\label{sec:constraints}

El lazo combinacional del PLPUF genera violaciones DRC (\texttt{LUTLP-1}) en
Vivado, ya que la herramienta identifica correctamente la existencia de
caminos combinacionales cíclicos. Para permitir la síntesis y la
implementación sin errores, se definieron las siguientes restricciones en el
archivo \texttt{plpuf.xdc}:

\begin{enumerate}
  \item \textbf{\texttt{ALLOW\_COMBINATORIAL\_LOOPS}:} aplicado a las redes
    del lazo (\texttt{*plpuf\_core\_inst/core\_in*}) para permitir que Vivado
    acepte el ciclo combinacional.

  \item \textbf{\texttt{DONT\_TOUCH}:} aplicado a todas las celdas del
    núcleo (\texttt{*plpuf\_core\_inst*}) para prevenir la optimización o
    eliminación de inversores y multiplexores durante la síntesis.

  \item \textbf{\texttt{set\_false\_path}:} aplicado a las mismas redes del
    lazo para indicar al motor de temporización que no analice estos caminos,
    ya que no representan rutas de datos síncronas convencionales.
\end{enumerate}

Los \textit{wildcards} utilizan nombres de redes post-síntesis
(\texttt{core\_in[N]}, \texttt{core\_in\_inferred\_i\_N}) y no los nombres
del bloque \texttt{generate} (\texttt{gen\_core}), ya que estos últimos no
se preservan tras la síntesis.

% ============================================================================
\section{Diseño de la interfaz AXI4-Lite}
\label{sec:diseno_axi}
% ============================================================================

Para integrar el PLPUF como periférico controlable por software, se
implementó una interfaz AXI4-Lite esclava siguiendo la plantilla estándar
generada por Vivado~\cite{ug1037}. Esta interfaz permite al procesador
MicroBlaze~V configurar el desafío y la duración de activación, iniciar la
evaluación y leer la respuesta mediante operaciones de lectura/escritura
sobre registros mapeados en memoria~\cite{ihi0022h}.

La Figura~\ref{fig:axi_design} presenta el diagrama del diseño de la
interfaz, mostrando la relación entre los canales AXI, el bloque de
registros y el núcleo PLPUF.

\begin{figure}[htbp]
  \centering
  \begin{tikzpicture}[
      font=\small,
      block/.style={rectangle, draw=black!60, thick, fill=blue!5,
        minimum width=3cm, minimum height=1.2cm, align=center,
        rounded corners=2pt},
      regblock/.style={rectangle, draw=orange!70, thick, fill=orange!6,
        minimum width=3.2cm, minimum height=4.5cm, align=center,
        rounded corners=2pt},
      coreblock/.style={rectangle, draw=green!60!black, thick, fill=green!6,
        minimum width=3cm, minimum height=4.5cm, align=center,
        rounded corners=2pt},
      arrow/.style={-{Latex[length=2mm,width=1.5mm]}, thick, black!70},
      biarrow/.style={{Latex[length=2mm,width=1.5mm]}-{Latex[length=2mm,width=1.5mm]}, thick, black!70},
      lbl/.style={font=\scriptsize\ttfamily}
    ]
    % AXI channels
    \node[block] (axi) at (0, 0) {
      \textbf{Canales AXI}\\
      \scriptsize AW, W, B, AR, R\\
      \scriptsize \textit{handshake}
    };
    % Register block
    \node[regblock] (reg) at (5.0, 0) {
      \textbf{Registros}\\
      \scriptsize CTRL, STATUS\\
      \scriptsize DURATION\\
      \scriptsize CHAL\_0..3\\
      \scriptsize RESP\_0..3
    };
    % PLPUF core
    \node[coreblock] (core) at (10.0, 0) {
      \textbf{plpuf\_core}\\
      \scriptsize Cadena inversores\\
      \scriptsize FSM 4 estados
    };
    % AXI <-> Registros
    \draw[biarrow] (axi) -- node[above, lbl] {R/W} (reg);

    % Registros -> plpuf_core: entradas
    \draw[arrow] ([yshift=+18mm]reg.east) -- ([yshift=+18mm]core.west)
      node[midway, above=2pt, lbl] {challenge};
    \draw[arrow] ([yshift=+10mm]reg.east) -- ([yshift=+10mm]core.west)
      node[midway, above=2pt, lbl] {duration};
    \draw[arrow] ([yshift=+2mm]reg.east)  -- ([yshift=+2mm]core.west)
      node[midway, above=2pt, lbl] {start};

    % plpuf_core -> Registros: salidas
    \draw[arrow] ([yshift=-6mm]core.west)  -- ([yshift=-6mm]reg.east)
      node[midway, above=2pt, lbl] {response};
    \draw[arrow] ([yshift=-13mm]core.west) -- ([yshift=-13mm]reg.east)
      node[midway, above=2pt, lbl] {done};
    \draw[arrow] ([yshift=-20mm]core.west) -- ([yshift=-20mm]reg.east)
      node[midway, above=2pt, lbl] {busy};

    % From SmartConnect
    \draw[arrow] (-2.8, 0) -- (axi.west)
      node[near start, above, font=\scriptsize] {SmartConnect};
  \end{tikzpicture}
  \caption{Diagrama del diseño de la interfaz AXI4-Lite: los canales AXI
    comunican el bus con el bloque de registros, que a su vez controla el
    núcleo PLPUF.}
  \label{fig:axi_design}
\end{figure}

% ---------------------------------------------------------------------------
\subsection{Mapa de registros}
\label{sec:regmap}

El periférico expone 11~registros activos dentro de un espacio de direcciones
de 64~bytes (\texttt{C\_S\_AXI\_ADDR\_WIDTH\,=\,6}, equivalente a
16~ranuras de 32~bits). La Tabla~\ref{tab:regmap} describe el mapa de
registros completo.

\begin{table}[htbp]
\centering
\caption{Mapa de registros del periférico AXI PLPUF.}
\label{tab:regmap}
\small
\begin{tabular}{cllp{6.5cm}}
\hline
\textbf{Offset} & \textbf{Nombre} & \textbf{R/W} & \textbf{Descripción} \\
\hline
0x00 & CTRL     & R/W & {[0]} \texttt{start}: inicia evaluación (auto-limpia). {[1]} \texttt{soft\_reset}: reinicio del núcleo (auto-limpia). \\
0x04 & STATUS   & R   & {[0]} \texttt{busy}: evaluación en curso. {[1]} \texttt{done}: evaluación completada (persistente). \\
0x08 & DURATION & R/W & {[15:0]} Duración de activación en ciclos de reloj. \\
0x0C & CHAL\_0  & R/W & Bits {[31:0]} del desafío. \\
0x10 & CHAL\_1  & R/W & Bits {[63:32]} del desafío. \\
0x14 & CHAL\_2  & R/W & Bits {[95:64]} del desafío. \\
0x18 & CHAL\_3  & R/W & Bits {[127:96]} del desafío. \\
0x1C & RESP\_0  & R   & Bits {[31:0]} de la respuesta. \\
0x20 & RESP\_1  & R   & Bits {[63:32]} de la respuesta. \\
0x24 & RESP\_2  & R   & Bits {[95:64]} de la respuesta. \\
0x28 & RESP\_3  & R   & Bits {[127:96]} de la respuesta. \\
\hline
\end{tabular}
\end{table}

% ---------------------------------------------------------------------------
\subsection{Lógica del esclavo AXI}
\label{sec:axi_logic}

El módulo \texttt{axi\_plpuf\_slave\_lite\_v1\_0\_S00\_AXI} implementa la
lógica completa del esclavo AXI4-Lite y la instanciación del
\texttt{plpuf\_core}. Las características del diseño son:

\begin{itemize}
  \item \textbf{Máquinas de estado AXI:} se mantuvieron las FSM de la
    plantilla de Vivado para los canales de escritura (estados \texttt{Idle},
    \texttt{Waddr}, \texttt{Wdata}) y lectura (\texttt{Idle}, \texttt{Raddr},
    \texttt{Rdata}), garantizando conformidad con el protocolo
    \textit{handshake} \texttt{VALID}/\texttt{READY}~\cite{ihi0022h}.

  \item \textbf{Escritura con tres niveles de prioridad:} en un único bloque
    \texttt{always} con asignaciones no bloqueantes, se definen tres capas de
    escritura donde la última asignación prevalece:
    \begin{enumerate}
      \item Auto-limpieza de los bits \texttt{CTRL[1:0]} (prioridad baja).
      \item Escrituras del maestro AXI con \textit{byte strobes}
        (\texttt{WSTRB}) (prioridad media).
      \item Actualización de registros STATUS y RESP por el hardware del
        PLPUF (prioridad alta).
    \end{enumerate}

  \item \textbf{Bandera \texttt{done} persistente (\textit{sticky}):} el bit
    \texttt{done} en STATUS se activa con el pulso \texttt{plpuf\_done} y
    permanece activo hasta que el software escribe un nuevo \texttt{start} o
    un \texttt{soft\_reset}.

  \item \textbf{Registros de solo lectura:} los registros RESP\_0 a RESP\_3
    se actualizan exclusivamente desde el hardware; cualquier escritura AXI a
    estas direcciones es sobrescrita en el mismo ciclo por la capa de
    prioridad alta, garantizando la integridad de la respuesta.
\end{itemize}

La interconexión entre los registros y el núcleo PLPUF se realiza de la
siguiente manera: el desafío de 128~bits se forma concatenando los registros
CHAL\_3 a CHAL\_0 (\texttt{\{slv\_reg6, slv\_reg5, slv\_reg4, slv\_reg3\}});
la duración de activación se toma de los 16~bits inferiores de DURATION; y la
señal de \textit{reset} del núcleo combina el \textit{reset} global del bus
AXI con el bit de \texttt{soft\_reset} del registro CTRL.

% ---------------------------------------------------------------------------
\subsection{Empaquetado del IP}
\label{sec:ip_packager}

Para que el módulo PLPUF sea reutilizable dentro de cualquier \textit{block
design} de Vivado, se empaquetó como un IP (\textit{Intellectual Property})
mediante el flujo de IP~Packager de Vivado~\cite{ug1037}. El proceso genera
un descriptor IP-XACT (\texttt{component.xml}) que encapsula:

\begin{itemize}
  \item Los tres archivos HDL: \texttt{axi\_plpuf.v}, \texttt{axi\_plpuf\_slave\_lite\_v1\_0\_S00\_AXI.v}
    (esclavo AXI + núcleo) y \texttt{plpuf\_core.v}.
  \item El \textit{driver} en C (\texttt{axi\_plpuf.h}, \texttt{axi\_plpuf.c})
    para generación automática del \textit{Board Support Package} (BSP) en Vitis.
  \item Los parámetros de la interfaz de reloj
    (\texttt{A\_BUSIF\,=\,S00\_AXI},
    \texttt{A\_RESET\,=\,s00\_axi\_aresetn},
    \texttt{FREQ\_HZ\,=\,100000000}), necesarios para que el SmartConnect
    verifique la compatibilidad de dominios de reloj.
\end{itemize}

La jerarquía de módulos del IP se compone de tres niveles, como se ilustra
en la Figura~\ref{fig:plpuf_hierarchy}.

\begin{figure}[htbp]
  \centering
  \scalebox{0.70}{%
  \begin{tikzpicture}[
      font=\small,
      outer/.style={rectangle, draw=black!60, thick, fill=blue!4,
        rounded corners=3pt, align=center},
      mid/.style={rectangle, draw=blue!50, thick, fill=blue!8,
        rounded corners=3pt, align=center},
      inner/.style={rectangle, draw=green!60!black, thick, fill=green!8,
        rounded corners=3pt, align=center},
      arrow/.style={-{Latex[length=2mm,width=1.5mm]}, thick, black!60},
      lbl/.style={font=\scriptsize\ttfamily}
    ]
    % Outer wrapper
    \node[outer, minimum width=12cm, minimum height=9.2cm]
      (wrapper) at (6.0, -4.6) {};
    \node[font=\normalsize\bfseries, anchor=north] at (6.0, -0.15)
      {axi\_plpuf (wrapper)};
    \node[lbl, anchor=north east, black!40] at (12, -0.2) {Nivel 1};

    % Mid: AXI slave
    \node[mid, minimum width=10.5cm, minimum height=7.5cm]
      (slave) at (6.0, -5.0) {};
    \node[font=\small\bfseries, anchor=north] at (6.0, -1.55)
      {S00\_AXI (esclavo AXI4-Lite)};
    \node[lbl, anchor=north east, black!40] at (11.2, -1.6) {Nivel 2};

    % Registros bajados a y=-3.5 para separar del título
    \node[rectangle, draw=orange!50, fill=orange!6, rounded corners=2pt,
      minimum width=3.2cm, minimum height=1.8cm, align=center]
      (regs) at (5.0, -3.5) {
        \scriptsize\textbf{Registros}\\
        \scriptsize CTRL, STATUS, DURATION\\
        \scriptsize CHAL\_0..3, RESP\_0..3
      };

    % FSM AXI alineado con regs
    \node[rectangle, draw=blue!40, fill=blue!6, rounded corners=2pt,
      minimum width=3.0cm, minimum height=1.8cm, align=center]
      (fsm_axi) at (9.5, -3.5) {
        \scriptsize\textbf{FSM AXI}\\
        \scriptsize state\_write\\
        \scriptsize state\_read
      };

    % plpuf_core bajado en la misma proporción
    \node[inner, minimum width=5.5cm, minimum height=2.0cm]
      (core) at (5.0, -6.8) {};
    \node[font=\small\bfseries] at (5.0, -6.45) {plpuf\_core};
    \node[lbl, anchor=north east, black!40] at (7.7, -5.9) {Nivel 3};
    \node[font=\scriptsize, black!50] at (5.0, -7.15)
      {Cadena inversores + FSM + Contador};

    % --- Flechas verticales ---
    % regs.south ≈ y=-3.5-0.9=-4.4
    % core.north ≈ y=-6.8+1.0=-5.8
    % Tramo: -4.4 a -5.8 = 1.4cm
    % Etiquetas en -4.7, -5.1, -5.5

    % Carril izquierdo x=4.4: regs -> core
    \draw[arrow] (4.4, -4.4) -- (4.4, -5.8);
    \node[lbl, black!50, anchor=east] at (4.3, -4.7) {challenge};
    \node[lbl, black!50, anchor=east] at (4.3, -5.1) {duration};
    \node[lbl, black!50, anchor=east] at (4.3, -5.5) {start};

    % Carril derecho x=5.6: core -> regs
    \draw[arrow] (5.6, -5.8) -- (5.6, -4.4);
    \node[lbl, black!50, anchor=west] at (5.7, -4.7) {response};
    \node[lbl, black!50, anchor=west] at (5.7, -5.1) {done};
    \node[lbl, black!50, anchor=west] at (5.7, -5.5) {busy};

    % AXI4-Lite
    \draw[arrow] (-2.0, -3.5) -- (wrapper.west |- regs.west)
      node[midway, above, font=\scriptsize] {AXI4-Lite};

  \end{tikzpicture}%
  }
  \caption{Jerarquía de módulos del IP AXI PLPUF: tres niveles de
    encapsulamiento con el \textit{wrapper}, el esclavo AXI4-Lite
    (registros y FSM AXI) y el núcleo PLPUF.}
  \label{fig:plpuf_hierarchy}
\end{figure}

El \textit{wrapper} \texttt{axi\_plpuf} expone la interfaz AXI4-Lite al
exterior. El módulo \texttt{S00\_AXI} contiene la lógica de decodificación
de direcciones, los \textit{handshakes} de los cinco canales AXI, los
16~registros de 32~bits (de los cuales 11~están activos) y las máquinas de
estado de escritura y lectura. En el nivel inferior, el módulo
\texttt{plpuf\_core} recibe del esclavo AXI las señales de desafío, duración,
inicio y \textit{reset}, y retorna la respuesta junto con las banderas de
estado.

% ============================================================================
\section{Integración del sistema SoC}
\label{sec:integracion}
% ============================================================================

Esta sección describe la construcción del sistema completo dentro de Vivado
IP~Integrator, el flujo de síntesis e implementación, y la exportación del
diseño hacia Vitis para el desarrollo de software.

% ---------------------------------------------------------------------------
\subsection{Diseño de bloques en Vivado}
\label{sec:block_design}

El sistema SoC se construyó como un \textit{block design} en Vivado
IP~Integrator~\cite{ug994}. La Figura~\ref{fig:block_design} muestra el
diagrama de bloques completo del sistema tal como aparece en el entorno
gráfico de IP~Integrator, donde cada rectángulo representa un núcleo IP con
sus puertos de entrada y salida, y las líneas de interconexión representan
los buses AXI, las señales de reloj, \textit{reset} y depuración. Los
núcleos IP instanciados y sus funciones dentro del sistema son los
siguientes:

\begin{itemize}
  \item \textbf{Clocking Wizard (\texttt{clk\_wiz\_0}):} genera la señal de
    reloj de 100\,MHz a partir del oscilador de la placa (pin~\texttt{W5}).

  \item \textbf{MicroBlaze~V (\texttt{microblaze\_riscv\_0}):} procesador
    suave RISC-V configurado con la ISA base \texttt{RV32I}, \textit{pipeline} de 5~etapas,
    depuración habilitada e interfaces AXI de datos
    (\texttt{M\_AXI\_DP})~\cite{ug1629}.

  \item \textbf{Memoria local (BRAM + LMB):} bloque de memoria RAM, 32\,KB para instrucciones y 32\,KB para datos, conectado al
    procesador mediante el bus local de memoria (LMB)~\cite{ug1711}.

  \item \textbf{MicroBlaze Debug Module~V (\texttt{mdm\_1}):} módulo de
    depuración que permite la conexión JTAG para carga de programas y
    depuración paso a paso~\cite{ug1629}.

  \item \textbf{Processor System Reset (\texttt{rst\_clk\_wiz\_0\_100M}):}
    genera las señales de \textit{reset} sincronizadas para el procesador y
    los periféricos.

  \item \textbf{AXI SmartConnect (\texttt{axi\_smc}):} interconexión AXI con
    un puerto maestro y dos puertos esclavos: uno para el UART y otro para el
    PLPUF. Realiza la traducción de protocolo y el arbitraje de
    direcciones~\cite{ug1037}.

  \item \textbf{AXI UART Lite (\texttt{axi\_uartlite\_0}):} periférico UART
    conectado al puerto USB-UART de la Basys\,3, configurado a 9\,600~baudios
    para la comunicación serial con el computador anfitrión.

  \item \textbf{AXI PLPUF (\texttt{axi\_plpuf\_0}):} el periférico PLPUF
    desarrollado en este proyecto, conectado al segundo puerto esclavo del
    SmartConnect.
\end{itemize}

La asignación de direcciones del sistema se resume en la
Tabla~\ref{tab:addrmap}.

\begin{table}[htbp]
\centering
\caption{Mapa de direcciones del sistema SoC.}
\label{tab:addrmap}
\begin{tabular}{llr}
\hline
\textbf{Periférico} & \textbf{Dirección base} & \textbf{Rango} \\
\hline
BRAM local (datos e instrucciones) & \texttt{0x00000000} & 32\,KB \\
AXI UART Lite                      & \texttt{0x40600000} & 64\,KB \\
AXI PLPUF                          & \texttt{0x44A00000} & 64\,KB \\
\hline
\end{tabular}
\end{table}

\begin{figure}[htbp]
  \centering
  
  \caption{Diseño de bloques del sistema SoC en Vivado IP Integrator,
    mostrando la interconexión entre el procesador MicroBlaze~V, la memoria
    local (BRAM/LMB), el módulo de depuración (MDM~V), el AXI SmartConnect,
    el periférico UART~Lite y el periférico PLPUF desarrollado en este
    proyecto.}
  \label{fig:block_design}
\end{figure}

% ---------------------------------------------------------------------------
\subsection{Flujo de síntesis e implementación}
\label{sec:synth_flow}

El flujo de construcción del \textit{bitstream} siguió los pasos estándar de
Vivado~\cite{ug994}:

\begin{enumerate}
  \item \textbf{Generación de productos de salida:} se generaron los
    productos de salida de todos los IPs del \textit{block design},
    incluyendo los \textit{wrappers} HDL.

  \item \textbf{Síntesis lógica:} Vivado sintetiza el diseño completo. En
    esta etapa se producen las advertencias DRC \texttt{LUTLP-1} por el lazo
    combinacional del PLPUF, las cuales son resueltas por las restricciones
    XDC descritas en la Sección~\ref{sec:constraints}.

  \item \textbf{Implementación:} Vivado realiza el \textit{placement} y
    \textit{routing} del diseño sobre los recursos de la FPGA Artix-7. Las
    restricciones \texttt{DONT\_TOUCH} aseguran que las celdas del PLPUF no
    sean reubicadas ni optimizadas.

  \item \textbf{Verificación de temporización:} se verificó que todas las
    rutas de datos síncronas cumplan las restricciones temporales. Las rutas
    del lazo combinacional están excluidas del análisis mediante
    \texttt{set\_false\_path}.

  \item \textbf{Generación del \textit{bitstream}:} se habilitó la
    compresión del \textit{bitstream} para reducir el tiempo de
    carga.
\end{enumerate}

% ---------------------------------------------------------------------------
\subsection{Exportación a Vitis}
\label{sec:export_xsa}

Una vez generado el \textit{bitstream}, se exportó el hardware desde Vivado
en formato \texttt{.xsa} (\textit{Xilinx Support Archive}), que incluye:

\begin{itemize}
  \item La descripción del hardware (mapa de direcciones, IPs instanciados,
    parámetros).
  \item El \textit{bitstream} de la FPGA.
  \item Los metadatos necesarios para que Vitis genere el BSP con los
    controladores de los periféricos~\cite{ug1701}.
\end{itemize}

En Vitis, se creó una plataforma de hardware a partir del archivo
\texttt{.xsa} y se configuró el procesador MicroBlaze~V como objetivo de
compilación. El BSP generado automáticamente incluye el \textit{driver}
del periférico PLPUF (\texttt{axi\_plpuf.h} y \texttt{axi\_plpuf.c}), gracias
a que estos archivos fueron incluidos en el paquete IP durante el proceso de
empaquetado descrito en la Sección~\ref{sec:ip_packager}~\cite{ug1701}.

% ============================================================================
\section{Desarrollo del software de control}
\label{sec:software}
% ============================================================================

El software embebido se organizó en tres componentes: un \textit{driver}
reutilizable para el periférico PLPUF, una aplicación de validación básica
y una aplicación de evaluación exhaustiva. La
Figura~\ref{fig:sw_architecture} muestra la arquitectura en capas del
software.

\begin{figure}[htbp]
  \centering
  \begin{tikzpicture}[
      font=\small,
      layer/.style={rectangle, draw=black!60, thick, rounded corners=2pt,
        minimum width=10cm, minimum height=1.2cm, align=center},
      arrow/.style={-{Latex[length=2mm,width=1.5mm]}, thick, black!50}
    ]

    % Application layer
    \node[layer, fill=blue!8] (app) at (0, 2.4)
      {\textbf{Capa de aplicación}};
    \node[rectangle, draw=blue!40, fill=blue!4, rounded corners=2pt,
      minimum width=4.2cm, minimum height=0.8cm, align=center]
      (app1) at (-2.3, 1.2) {\scriptsize\texttt{test\_app1}\\[-2pt]
        \scriptsize Validación funcional};
    \node[rectangle, draw=blue!40, fill=blue!4, rounded corners=2pt,
      minimum width=4.2cm, minimum height=0.8cm, align=center]
      (app2) at (2.3, 1.2) {\scriptsize\texttt{test\_app2}\\[-2pt]
        \scriptsize Evaluación exhaustiva};

    % Driver layer
    \node[layer, fill=orange!8] (drv) at (0, -0.2)
      {\textbf{Capa de \textit{driver}}\\[-2pt]
       \scriptsize\texttt{Plpuf\_Initialize}, \texttt{Plpuf\_Evaluate},
       \texttt{Plpuf\_SetChallenge}, \texttt{Plpuf\_GetResponse}, ...};

    % Hardware layer
    \node[layer, fill=green!8] (hw) at (0, -2.0)
      {\textbf{Hardware (registros AXI PLPUF)}\\[-2pt]
       \scriptsize CTRL, STATUS, DURATION, CHAL\_0..3, RESP\_0..3};

    % Arrows
    \draw[arrow] (app1.south) -- ++(0, -0.25) -| (drv.north -| app1);
    \draw[arrow] (app2.south) -- ++(0, -0.25) -| (drv.north -| app2);
    \draw[arrow] (drv.south) -- (hw.north);

    % Labels
    \node[font=\scriptsize\itshape, anchor=west, black!50] at (5.5, 1.2) {C};
    \node[font=\scriptsize\itshape, anchor=west, black!50] at (5.5, -0.2) {C (BSP)};
    \node[font=\scriptsize\itshape, anchor=west, black!50] at (5.5, -2.0) {Verilog};

  \end{tikzpicture}
  \caption{Arquitectura en capas del software de control: las aplicaciones de
    prueba utilizan el \textit{driver} del PLPUF, que a su vez accede a los
    registros del periférico mediante operaciones de lectura/escritura AXI.}
  \label{fig:sw_architecture}
\end{figure}

% ---------------------------------------------------------------------------
\subsection{Driver en C para el PLPUF}
\label{sec:driver}

Se desarrolló un \textit{driver} en C siguiendo las convenciones del
ecosistema AMD/Xilinx (macros \texttt{Xil\_In32}/\texttt{Xil\_Out32},
aserciones \texttt{Xil\_Assert}). El \textit{driver} expone una API
estructurada en tres niveles:

\begin{enumerate}
  \item \textbf{Inicialización y \textit{reset}:}
    \texttt{Plpuf\_Initialize()} configura la dirección base del periférico,
    ejecuta un \textit{soft reset} y establece la duración de activación por
    defecto ($c = 5$). \texttt{Plpuf\_SoftReset()} reinicia el núcleo PLPUF
    mediante el bit~1 del registro CTRL.

  \item \textbf{Configuración y control:}
    \texttt{Plpuf\_SetDuration()} escribe la duración de activación;
    \texttt{Plpuf\_SetChallenge()} escribe los 128~bits del desafío en los
    cuatro registros CHAL; \texttt{Plpuf\_Start()} inicia la evaluación
    escribiendo el bit~0 del registro CTRL.

  \item \textbf{Lectura de resultados:}
    \texttt{Plpuf\_IsBusy()} y \texttt{Plpuf\_IsDone()} consultan el registro
    STATUS; \texttt{Plpuf\_WaitDone()} realiza un ciclo de espera activa hasta
    que la evaluación finalice; \texttt{Plpuf\_GetResponse()} lee los cuatro
    registros RESP y almacena la respuesta de 128~bits.
\end{enumerate}

Adicionalmente, la función de conveniencia \texttt{Plpuf\_Evaluate()} encapsula
el ciclo completo de evaluación en una sola llamada. La
Figura~\ref{fig:plpuf_evaluate} muestra el diagrama de flujo de esta función.

\begin{figure}[htbp]
  \centering
  \begin{tikzpicture}[
      font=\small,
      step/.style={rectangle, draw=black!60, thick, fill=blue!6,
        minimum width=3.5cm, minimum height=0.9cm, align=center,
        rounded corners=2pt},
      startstop/.style={rectangle, draw=black!60, thick, fill=gray!10,
        minimum width=2.5cm, minimum height=0.7cm, align=center,
        rounded corners=10pt},
      arrow/.style={-{Latex[length=2mm,width=1.5mm]}, thick, black!70}
    ]

    \node[startstop] (start) at (0, 0) {\texttt{Plpuf\_Evaluate()}};
    \node[step] (s1) at (0, -1.3) {\texttt{SetChallenge()}};
    \node[step] (s2) at (0, -2.6) {\texttt{Start()}};
    \node[step] (s3) at (0, -3.9) {\texttt{WaitDone()}};
    \node[step] (s4) at (0, -5.2) {\texttt{GetResponse()}};
    \node[startstop] (ret) at (0, -6.5) {Retorna respuesta};

    \draw[arrow] (start) -- (s1);
    \draw[arrow] (s1) -- (s2);
    \draw[arrow] (s2) -- (s3);
    \draw[arrow] (s3) -- (s4);
    \draw[arrow] (s4) -- (ret);

  \end{tikzpicture}
  \caption{Diagrama de flujo de la función \texttt{Plpuf\_Evaluate()}: ciclo
    completo de evaluación desafío-respuesta.}
  \label{fig:plpuf_evaluate}
\end{figure}

% ---------------------------------------------------------------------------
\subsection{Aplicación de validación básica (\texttt{test\_app1})}
\label{sec:test_app1}

La primera aplicación de prueba (\texttt{plpuf\_test\_app1}) se diseñó como
una validación funcional rápida del sistema, verificando que todos los
componentes (procesador, bus AXI, periférico PLPUF, UART) operan
correctamente. Las pruebas realizadas son:

\begin{enumerate}
  \item \textbf{Lectura/escritura de registros:} se escribe un valor conocido
    en DURATION y CHAL y se verifica que la lectura retorne el mismo valor.

  \item \textbf{Evaluación individual:} se ejecuta una evaluación con un
    desafío conocido y se verifica que la respuesta sea no nula (128~bits
    $\neq 0$).

  \item \textbf{Repetibilidad:} se ejecuta el mismo desafío 5~veces
    consecutivas y se comparan las respuestas. Se espera que sean idénticas o
    muy similares (dependiendo de la duración de activación).

  \item \textbf{Unicidad inter-desafío:} se evalúan dos desafíos diferentes y
    se verifica que las respuestas sean distintas.

  \item \textbf{Barrido de duración:} se evalúa un mismo desafío con
    duraciones $c = 1, \ldots, 10$ y se imprimen todas las respuestas por
    UART para verificar que varían con~$c$.
\end{enumerate}

% ---------------------------------------------------------------------------
\subsection{Aplicación de evaluación exhaustiva (\texttt{test\_app2})}
\label{sec:test_app2}

La segunda aplicación (\texttt{plpuf\_test\_app2}) implementa el protocolo
completo de evaluación estadística del PLPUF, ejecutando aproximadamente
14\,000 evaluaciones por corrida sobre el hardware. Los parámetros de configuración son:

\begin{itemize}
  \item 20~desafíos aleatorios (generados por un PRNG \texttt{xorshift32}
    con semilla \texttt{0xDEADBEEF} para reproducibilidad).
  \item 50~repeticiones por par desafío-duración (para votación por mayoría).
  \item 10~duraciones de activación ($c = 1, \ldots, 10$).
  \item 32~posiciones de bit para pruebas de efecto avalancha.
  \item 9~evaluaciones con votación por mayoría para las respuestas
    \textit{golden} del efecto avalancha.
\end{itemize}

La aplicación calcula las siguientes métricas directamente en el dispositivo
utilizando aritmética de punto fijo (multiplicación por 100 o 10\,000 y
división entera para obtener dos decimales):

\begin{itemize}
  \item \textbf{Uniformidad} por desafío y promedio por duración.
  \item \textbf{Confiabilidad} (100\,\% $-$ BER) respecto a una respuesta de
    referencia obtenida por votación por mayoría
    (\texttt{golden\_from\_counts}).
  \item \textbf{BER} (\textit{Bit Error Rate}) promedio.
  \item \textbf{Distancia de Hamming intra-dispositivo} (entre repeticiones
    del mismo desafío).
  \item \textbf{Distancia de Hamming inter-desafío} (entre respuestas
    \textit{golden} de desafíos diferentes con la misma duración).
  \item \textbf{Mapa de estabilidad de bits}: para cada posición de bit, se
    califica de~0 (siempre inestable) a~9 (máxima estabilidad), basado en la
    fracción de repeticiones que coinciden con la respuesta \textit{golden}.
  \item \textbf{Efecto avalancha}: se aplican cambios de un solo bit en el
    desafío y se mide la distancia de Hamming respecto a la respuesta
    \textit{golden} original~\cite{maiti_2012_systematic}.
\end{itemize}

Todos los resultados se imprimen por UART en formato legible para su captura
y procesamiento posterior.

% ============================================================================
\section{Protocolo de evaluación del PLPUF}
\label{sec:protocolo}
% ============================================================================

El protocolo de evaluación sigue las recomendaciones de
Maiti~et~al.~\cite{maiti_2012_systematic} y los criterios experimentales
empleados por Hori~et~al.~\cite{hori_2011_pseudolfsr} en la evaluación
original del PLPUF. La evaluación se realizó sobre un único dispositivo FPGA
(Basys\,3), por lo que las métricas reportadas corresponden a una evaluación
intra-dispositivo~\cite{wilde_2020_confidence}.

% ---------------------------------------------------------------------------
\subsection{Recolección de pares desafío-respuesta}
\label{sec:crp_collect}

La recolección de datos se estructuró de la siguiente manera:

\begin{enumerate}
  \item Para cada duración de activación $c \in \{1, 2, \ldots, 10\}$:
  \begin{enumerate}
    \item Se generan 20~desafíos pseudoaleatorios de 128~bits mediante el
      generador \texttt{xorshift32} con semilla fija.
    \item Para cada desafío, se ejecutan 50~evaluaciones consecutivas,
      obteniendo 50~respuestas de 128~bits.
    \item Se construye la respuesta de referencia (\textit{golden}) mediante
      votación por mayoría bit a bit: para cada posición, el valor del bit
      \textit{golden} es el que aparece en más de 25 de las 50~repeticiones.
  \end{enumerate}
  \item Total de evaluaciones: $10 \times 20 \times 50 = 10\,000$
    evaluaciones principales, más las evaluaciones adicionales para el efecto
    avalancha.
\end{enumerate}

% ---------------------------------------------------------------------------
\subsection{Cálculo de métricas}
\label{sec:metricas_calc}

A partir de los datos recolectados, se calculan las métricas definidas en
la Sección~\ref{sec:metricas} de la siguiente manera:

\begin{itemize}
  \item \textbf{Uniformidad:} para cada respuesta \textit{golden}, se calcula
    el peso de Hamming (\textit{Hamming weight}) y se divide entre~128 para
    obtener la proporción de unos. El valor ideal es 50\,\%
    \cite{maiti_2012_systematic}.

  \item \textbf{Confiabilidad y BER:} para cada par desafío-duración, se
    calcula la distancia de Hamming fraccional entre cada una de las
    50~respuestas y la respuesta \textit{golden}, obteniendo el BER
    promedio. La confiabilidad se define como $100\,\% - \text{BER}$
    \cite{maiti_2012_systematic}.

  \item \textbf{Distancia de Hamming intra-dispositivo:} promedio de las
    distancias de Hamming entre todas las repeticiones y la respuesta
    \textit{golden} para un mismo desafío. El valor ideal es~0
    \cite{hori_2011_pseudolfsr}.

  \item \textbf{Distancia de Hamming inter-desafío:} al disponer de un solo
    dispositivo, la métrica de unicidad inter-dispositivo no puede calcularse
    directamente. Como aproximación, se calcula la distancia de Hamming
    fraccional promedio entre las respuestas \textit{golden} de los
    20~desafíos diferentes para una misma duración. Un valor cercano a 50\,\%
    indica que el PLPUF genera respuestas suficientemente diversas ante
    desafíos distintos~\cite{hori_2011_pseudolfsr}.
\end{itemize}

% ---------------------------------------------------------------------------
\subsection{Efecto avalancha}
\label{sec:avalanche}

El efecto avalancha mide la sensibilidad de la PUF a cambios mínimos en el
desafío: al modificar un solo bit del desafío, idealmente el 50\,\% de los
bits de la respuesta debería cambiar~\cite{maiti_2012_systematic}. El
protocolo implementado es:

\begin{enumerate}
  \item Se selecciona un desafío base y se obtiene su respuesta \textit{golden}
    con votación por mayoría (9~repeticiones).
  \item Para cada una de las primeras 32~posiciones de bit del desafío:
    \begin{enumerate}
      \item Se genera un desafío modificado invirtiendo únicamente el bit en
        la posición~$j$.
      \item Se obtiene la respuesta \textit{golden} del desafío modificado
        (9~repeticiones con votación por mayoría).
      \item Se calcula la distancia de Hamming fraccional entre la respuesta
        original y la modificada.
    \end{enumerate}
  \item Se reporta el promedio de las 32~distancias como el efecto avalancha
    del PLPUF.
\end{enumerate}

Cabe señalar que el PLPUF, al basarse en una estructura LFSR con difusión
limitada, exhibe típicamente un efecto avalancha inferior al 50\,\% ideal.
Alsharkawy~et~al.~\cite{alsharkawy_2024_plpufs} documentaron esta limitación
y su relación con la duración de activación.

%%% Local Variables:
%%% mode: latex
%%% TeX-master: "main"
%%% End:
