MarinGE23/axi-plpuf-ip/documento_tfg_emanuel_marin_overleaf/Documento_TFG_EmanuelMarin/glosario.tex

%% ---------------------------------------------------------------------------
%% glosario.tex
%%
%% Lista de abreviaciones
%%
%% ---------------------------------------------------------------------------

\cleardoublepage
\markboth{Lista de abreviaciones}{Lista de abreviaciones}

\chapter{Lista de abreviaciones}

\begin{longtable}{@{}p{2.2cm}@{}p{\dimexpr\textwidth-2.2cm\relax}@{}}

AMBA   & \textit{Advanced Microcontroller Bus Architecture} -- Arquitectura de bus de microcontrolador avanzado \\[4pt]
ASIC   & \textit{Application-Specific Integrated Circuit} -- Circuito integrado de aplicación específica \\[4pt]
AXI    & \textit{Advanced eXtensible Interface} -- Interfaz extensible avanzada \\[4pt]
BER    & \textit{Bit Error Rate} -- Tasa de error de bit \\[4pt]
BRAM   & \textit{Block RAM} -- Bloque de memoria RAM dentro de la FPGA \\[4pt]
BSP    & \textit{Board Support Package} -- Paquete de soporte de tarjeta \\[4pt]
CRP    & \textit{Challenge-Response Pair} -- Par desafío-respuesta \\[4pt]
DRC    & \textit{Design Rule Check} -- Verificación de reglas de diseño \\[4pt]
DSP    & \textit{Digital Signal Processor} -- Procesador digital de señales \\[4pt]
FAR    & \textit{False Acceptance Rate} -- Tasa de falsa aceptación \\[4pt]
FF     & \textit{Flip-Flop} -- Biestable \\[4pt]
FPGA   & \textit{Field Programmable Gate Array} -- Arreglo de compuertas programable en campo \\[4pt]
FRR    & \textit{False Rejection Rate} -- Tasa de falso rechazo \\[4pt]
FSM    & \textit{Finite State Machine} -- Máquina de estados finitos \\[4pt]
HD     & \textit{Hamming Distance} -- Distancia de Hamming \\[4pt]
HDA    & \textit{Helper Data Algorithm} -- Algoritmo de datos auxiliares \\[4pt]
HDL    & \textit{Hardware Description Language} -- Lenguaje de descripción de hardware \\[4pt]
IoT    & \textit{Internet of Things} -- Internet de las cosas \\[4pt]
IP     & \textit{Intellectual Property} -- Propiedad intelectual (núcleo IP) \\[4pt]
ISA    & \textit{Instruction Set Architecture} -- Arquitectura del conjunto de instrucciones \\[4pt]
JTAG   & \textit{Joint Test Action Group} -- Estándar IEEE 1149.1 de depuración \\[4pt]
LFSR   & \textit{Linear Feedback Shift Register} -- Registro de desplazamiento con retroalimentación lineal \\[4pt]
LMB    & \textit{Local Memory Bus} -- Bus local de memoria \\[4pt]
LUT    & \textit{Look-Up Table} -- Tabla de búsqueda \\[4pt]
MDM    & \textit{MicroBlaze Debug Module} -- Módulo de depuración de MicroBlaze \\[4pt]
MMIO   & \textit{Memory-Mapped I/O} -- Entrada/salida mapeada en memoria \\[4pt]
NCR    & \textit{Number of CRPs} -- Número de pares desafío-respuesta requeridos para modelar una PUF \\[4pt]
NLFSR  & \textit{Non-Linear Feedback Shift Register} -- Registro de desplazamiento con retroalimentación no lineal \\[4pt]
NLPUF  & \textit{Non-Linear PUF} -- PUF basada en lógica no lineal \\[4pt]
PLL    & \textit{Phase-Locked Loop} -- Lazo de fase enganchada \\[4pt]
PLPUF  & \textit{Pseudo-LFSR PUF} -- PUF basada en pseudo-LFSR \\[4pt]
PRNG   & \textit{Pseudo-Random Number Generator} -- Generador de números pseudoaleatorios \\[4pt]
PUF    & \textit{Physical Unclonable Function} -- Función físicamente no clonable \\[4pt]
RISC-V & \textit{Reduced Instruction Set Computer~V} -- Arquitectura abierta de conjunto de instrucciones reducido \\[4pt]
RO-PUF & \textit{Ring Oscillator PUF} -- PUF basada en oscilador de anillo \\[4pt]
SoC    & \textit{System-on-Chip} -- Sistema en chip \\[4pt]
SRAM   & \textit{Static Random Access Memory} -- Memoria estática de acceso aleatorio \\[4pt]
TMR    & \textit{Triple Modular Redundancy} -- Redundancia modular triple \\[4pt]
TTM    & \textit{Time to Model} -- Tiempo computacional para modelar una PUF \\[4pt]
UART   & \textit{Universal Asynchronous Receiver-Transmitter} -- Receptor y transmisor asíncrono universal \\[4pt]
XDC    & \textit{Xilinx Design Constraints} -- Archivo de restricciones de diseño \\[4pt]
XOR    & \textit{Exclusive OR} -- Compuerta lógica O-exclusiva \\[4pt]
XSA    & \textit{Xilinx Support Archive} -- Archivo de soporte de Xilinx \\

\end{longtable}
