MarinGE23/axi-plpuf-ip/documento_tfg_emanuel_marin_overleaf/Documento_TFG_EmanuelMarin/teoria.tex

%% ---------------------------------------------------------------------------
%% teoria.tex
%% Marco de referencia teórico
%% ---------------------------------------------------------------------------

\chapter{Marco de referencia teórico}
\label{ch:marco}

En este capítulo se presentan los fundamentos teóricos y tecnológicos que
sustentan el diseño, la implementación y la evaluación del módulo PLPUF
desarrollado en este trabajo. Se describen, en primer lugar, los conceptos de
\textit{System-on-Chip} (SoC) y las interfaces de comunicación empleadas; a
continuación, la plataforma FPGA y las herramientas de desarrollo; luego, la
teoría de las Funciones Físicamente No Clonables (PUFs) con énfasis en la
variante Pseudo-LFSR; y, finalmente, las métricas de seguridad utilizadas
para la evaluación del módulo.

% ============================================================================
\section{Sistemas en chip (SoC)}
\label{sec:soc}
% ============================================================================

Un \textit{System-on-Chip} (SoC) es una arquitectura de circuito integrado que
incorpora en un solo dispositivo un procesador, memoria, periféricos de
comunicación y lógica personalizada. En el contexto de las FPGAs, los SoC se
construyen instanciando procesadores suaves (\textit{soft processors}) dentro
de la lógica programable, conectados a periféricos mediante buses estándar
\cite{ug994}. Esta aproximación permite crear sistemas embebidos completos en
los que tanto el hardware como el software son altamente configurables.

% ---------------------------------------------------------------------------
\subsection{Arquitectura MicroBlaze~V}
\label{sec:microblaze}

MicroBlaze~V es un procesador suave (\textit{soft processor}) de AMD diseñado
para su implementación en FPGAs de la familia AMD/Xilinx. A diferencia de su
predecesor MicroBlaze, que utiliza un conjunto de instrucciones propietario,
MicroBlaze~V implementa la arquitectura de conjunto de instrucciones abierta
RISC-V, específicamente el conjunto base \texttt{RV32I} \cite{ug1629}. RISC-V es una ISA de estándar abierto mantenida por RISC-V
International, lo que permite a cualquier fabricante desarrollar procesadores
compatibles sin costos de licenciamiento~\cite{ug1629}.

El conjunto fijo de características de MicroBlaze~V incluye 32~registros de
propósito general, un contador de programa extensible de 32~bits, un
\textit{pipeline} de emisión única, una unidad aritmético-lógica (ALU), un
\textit{barrel shifter} y las extensiones \texttt{Zicsr} (instrucciones de
registros de control y estado) y \texttt{Zifencei} (barrera de instrucciones)
\cite{ug1629}.

Adicionalmente, MicroBlaze~V es altamente configurable mediante parámetros
que permiten habilitar selectivamente funcionalidades opcionales. Entre las
extensiones configurables se encuentran: \texttt{M} (multiplicación y
división entera), \texttt{A} (instrucciones atómicas), \texttt{C}
(instrucciones comprimidas de 16~bits), \texttt{F} (punto flotante de
precisión simple), \texttt{D} (punto flotante de doble precisión) y
\texttt{Zb[abcs]} (manipulación de bits)~\cite{ug1629}. La profundidad del
\textit{pipeline} es seleccionable entre 3, 4, 5 y 8~etapas, lo que permite
optimizar el diseño para área o frecuencia según la aplicación
\cite{ug1629}.

En cuanto a la interfaz de memoria, MicroBlaze~V ofrece un bus local de
memoria (LMB) para acceso de baja latencia a BRAM, e interfaces AXI4 para
cachés de instrucciones y datos (\texttt{M\_AXI\_IC}, \texttt{M\_AXI\_DC}),
así como un puerto de datos de periféricos (\texttt{M\_AXI\_DP}) que soporta
el protocolo AXI4-Lite~\cite{ug1629, ug1711}. El procesador también integra
opcionalmente cachés de instrucciones y datos con políticas configurables
(\textit{write-back} o \textit{write-through}), soporte de depuración
mediante el módulo MDM~V (\textit{MicroBlaze Debug Module~V}), y capacidades
de tolerancia a fallos como operación en \textit{lockstep} y redundancia
modular triple (TMR)~\cite{ug1629}.

Como se muestra en la Figura~\ref{fig:microblaze_block}, la arquitectura
interna de MicroBlaze~V se organiza en torno a un decodificador de
instrucciones central que alimenta la ALU, el \textit{barrel shifter}, el
multiplicador y el divisor (estos dos últimos opcionales). El banco de
32~registros de propósito general y los registros de control y estado (CSR)
están conectados directamente al decodificador. En el lado de instrucciones,
un búfer de instrucciones recibe datos desde el bus local de instrucciones
(ILMB) o desde la caché de instrucciones (\texttt{M\_AXI\_IC}); un
decodificador de instrucciones comprimidas (extensión~\texttt{C}) procesa
opcionalmente las instrucciones de 16~bits. En el lado de datos, el
procesador accede a la BRAM mediante el bus local de datos (DLMB) y a los
periféricos mediante el puerto AXI de datos (\texttt{M\_AXI\_DP}); la caché
de datos (\texttt{M\_AXI\_DC}) es configurable como \textit{write-back} o
\textit{write-through}. La unidad de punto flotante (FPU), la unidad de
gestión de memoria (MMU con TLBs) y la caché de predicción de saltos
(\textit{Branch Target Cache}) aparecen sombreadas en el diagrama, indicando
que son características opcionales habilitables mediante parámetros de
configuración.

\begin{figure}[h]
  \centering
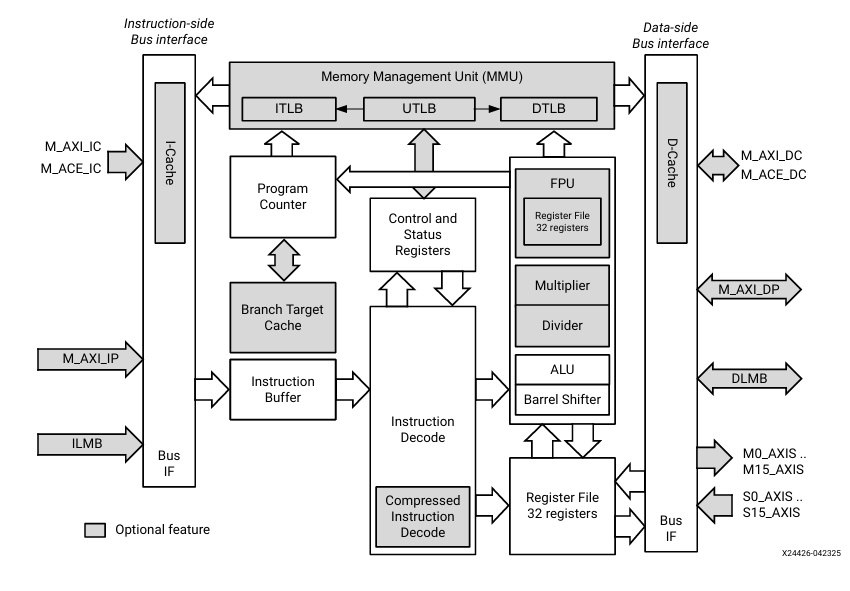
[picture p1: documento_tfg_emanuel_marin_overleaf/Documento_TFG_EmanuelMarin/fig/microblaze_v_block.png]
  
  \caption{Diagrama de bloques del procesador MicroBlaze~V \cite{ug1629}.}
  \label{fig:microblaze_block}
\end{figure}

MicroBlaze~V es totalmente compatible a nivel de hardware con el procesador
MicroBlaze clásico~\cite{ug1629}, lo que permite reutilizar la biblioteca de
periféricos AXI existente del ecosistema AMD/Xilinx. La utilización de
recursos en una configuración básica \texttt{RV32I} optimizada para área
requiere aproximadamente 633~LUTs en una FPGA Spartan-7, mientras que una
configuración \texttt{RV32IMAFC} con extensiones de manipulación de bits
alcanza aproximadamente 4\,826~LUTs~\cite{ug1629}.

% ---------------------------------------------------------------------------
\subsection{Bus AXI4-Lite}
\label{sec:axi}

La interfaz AMBA AXI (\textit{Advanced eXtensible Interface}) es un protocolo
de comunicación \textit{on-chip} desarrollado por Arm Ltd.\ como parte de la
especificación AMBA (\textit{Advanced Microcontroller Bus Architecture})
\cite{ihi0022h}. AMD/Xilinx adoptó AXI como el protocolo estándar de
interconexión para sus FPGAs a partir de la serie~7, reemplazando los buses
PLB y FSL utilizados en generaciones anteriores~\cite{ug1037}.

El protocolo AXI define cinco canales independientes que operan de forma
desacoplada mediante un mecanismo de \textit{handshake} basado en señales
\texttt{VALID} y \texttt{READY}~\cite{ihi0022h}. La
Figura~\ref{fig:axi_channels_writes} ilustra los tres canales involucrados en
una transacción de escritura: el canal de dirección de escritura (AW), por el
que la interfaz maestra (\textit{Manager}) envía la dirección y las señales de
control; el canal de datos de escritura (W), que transporta las palabras de
datos desde el maestro hacia la interfaz subordinada
(\textit{Subordinate}); y el canal de respuesta de escritura (B), por el que
el subordinado retorna el estado de finalización de la transacción. De forma
análoga, la Figura~\ref{fig:axi_channels_reads} muestra los dos canales de
lectura: el canal de dirección de lectura (AR), por el que el maestro emite
la dirección solicitada, y el canal de datos de lectura (R), por el que el
subordinado retorna los datos leídos junto con su estado. Las flechas en
ambos diagramas indican la dirección del flujo de información entre las
interfaces.

\begin{figure}[h]
  \centering
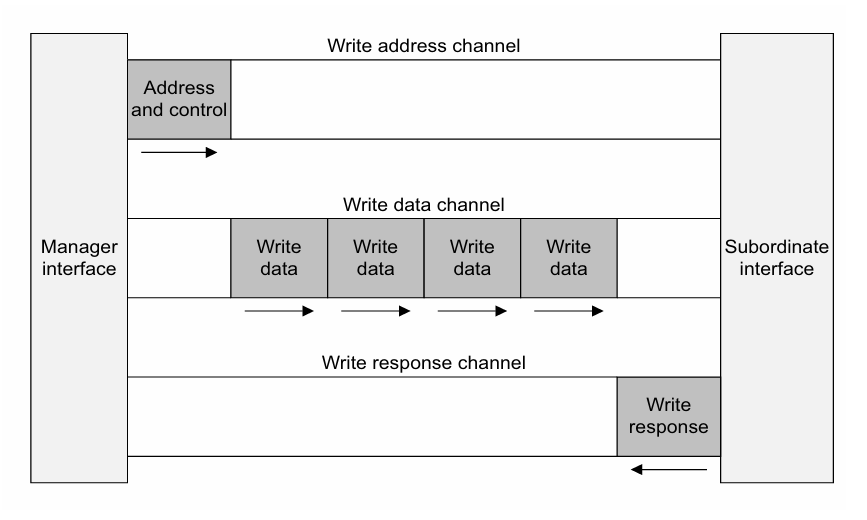
[picture p2: documento_tfg_emanuel_marin_overleaf/Documento_TFG_EmanuelMarin/fig/channel_writes.png]
  
  \caption{Canales de escritura del protocolo AXI: canal de dirección (AW),
    canal de datos (W) y canal de respuesta (B)~\cite{ihi0022h}.}
  \label{fig:axi_channels_writes}
\end{figure}

\begin{figure}[h]
  \centering
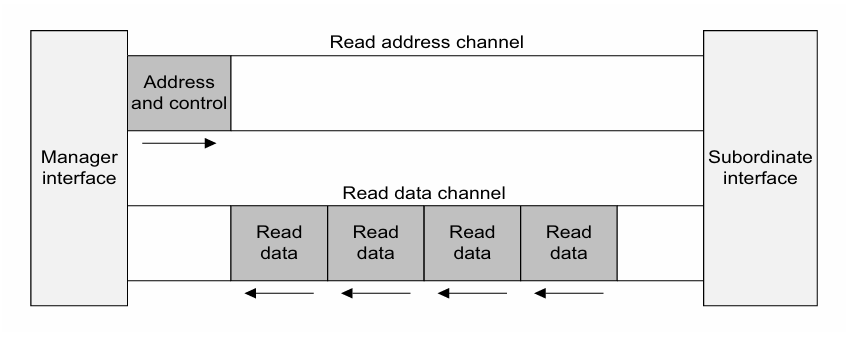
[picture p3: documento_tfg_emanuel_marin_overleaf/Documento_TFG_EmanuelMarin/fig/channel_reads.png]
  
  \caption{Canales de lectura del protocolo AXI: canal de dirección (AR) y
    canal de datos (R)~\cite{ihi0022h}.}
  \label{fig:axi_channels_reads}
\end{figure}

La variante AXI4-Lite es una simplificación del protocolo AXI4 completo
orientada a periféricos de control con mapas de registros accesibles mediante
\textit{memory-mapped I/O} (MMIO). AXI4-Lite restringe las transacciones a
transferencias de una sola palabra (sin ráfagas) y elimina señales avanzadas
como \texttt{AWLEN}, \texttt{AWSIZE} y \texttt{AWBURST}, lo que simplifica
significativamente la lógica del esclavo~\cite{ihi0022h, ug1037}. Cada
transacción se completa cuando el emisor activa \texttt{VALID} y el receptor
responde con \texttt{READY} en el mismo ciclo de reloj.

En el ecosistema Vivado, los periféricos AXI4-Lite se integran en el
\textit{block design} mediante el bloque SmartConnect, que actúa como
interconexión entre el puerto maestro del procesador
(\texttt{M\_AXI\_DP}) y los puertos esclavos de los periféricos. El entorno
IP Integrator automatiza la asignación de direcciones y la conexión de
señales de reloj y \textit{reset}~\cite{ug994, ug1037}.

% ============================================================================
\section{FPGAs y lógica reconfigurable}
\label{sec:fpga}
% ============================================================================

Las FPGAs (\textit{Field Programmable Gate Arrays}) son dispositivos
semiconductores cuya funcionalidad lógica puede ser programada y
reprogramada por el usuario después de su fabricación. A diferencia de los
circuitos integrados de aplicación específica (ASICs), las FPGAs ofrecen
flexibilidad de diseño, menor tiempo de desarrollo y la posibilidad de
actualización en campo, lo que las convierte en plataformas idóneas para
prototipado rápido, sistemas embebidos y aplicaciones de seguridad
\cite{lata_2023_fpgapuf, anandakumar_2021_fpgapufs}.

La naturaleza reconfigurable de las FPGAs resulta particularmente relevante
para la implementación de PUFs, ya que permite explotar las variaciones
físicas inherentes a la lógica programable, como diferencias en los retardos
de propagación de LUTs e interconexiones, para generar identificadores únicos
de dispositivo~\cite{lata_2023_fpgapuf}.

% ---------------------------------------------------------------------------
\subsection{Familia Artix-7 y plataforma Basys\,3}
\label{sec:artix7}

La familia Artix-7 de AMD/Xilinx forma parte de la serie~7 de FPGAs y está
optimizada para aplicaciones que requieren alto rendimiento lógico con bajo
consumo de energía. El presente proyecto utiliza la placa de desarrollo
Basys\,3 de Digilent, que integra una FPGA Artix-7 con número de parte
\texttt{XC7A35T-1CPG236C}~\cite{basys3rm}.

Las principales características del dispositivo \texttt{XC7A35T} son
\cite{basys3rm}:

\begin{itemize}
  \item 33\,280 celdas lógicas distribuidas en 5\,200 \textit{slices}, donde
    cada \textit{slice} contiene cuatro LUTs de 6~entradas y
    8~\textit{flip-flops}.
  \item 1\,800\,Kb de memoria RAM de bloques (BRAM).
  \item 5~\textit{tiles} de gestión de reloj, cada uno con un lazo de fase
    enganchada (PLL).
  \item 90~bloques DSP para operaciones aritméticas aceleradas.
  \item Frecuencias internas de reloj superiores a 450\,MHz.
  \item Conversor analógico-digital integrado (XADC).
\end{itemize}

La placa Basys\,3 complementa la FPGA con periféricos de entrada/salida que
facilitan la validación de diseños: 16~interruptores, 16~LEDs, 5~botones
pulsadores, un \textit{display} de 7~segmentos de 4~dígitos, un puerto
USB-UART para comunicación serial, conectores Pmod para expansión y un puerto
VGA de 12~bits~\cite{basys3rm}. El reloj principal del sistema es un
oscilador de 100\,MHz conectado al pin~\texttt{W5} de la
FPGA~\cite{basys3rm}.

La Figura~\ref{fig:basys3} muestra la disposición física de la placa
Basys\,3 con sus componentes numerados. En la parte central se encuentra el
chip FPGA Artix-7, rodeado por los periféricos de entrada/salida: los
16~interruptores y los 16~LEDs se ubican en el borde inferior de
la placa; los 5~pulsadores se sitúan a la derecha junto a los conectores Pmod
para expansión; el \textit{display} de 7~segmentos de 4~dígitos se encuentra
en la zona inferior izquierda. En el borde superior se localizan el conector
VGA, el puerto USB compartido para UART y JTAG (marcado como \textit{Shared
UART/JTAG USB port}), el conector USB \textit{host} y los controles de
alimentación. El puerto USB-UART compartido (conector~J4) es el que se
utiliza en este proyecto tanto para la carga del \textit{bitstream} vía JTAG
como para la comunicación serial con el computador anfitrión.

La configuración de la FPGA se realiza mediante archivos \textit{bitstream}
generados por Vivado. El \textit{bitstream} del \texttt{XC7A35T} tiene un
tamaño típico de 17\,536\,096~bits y puede cargarse a través de JTAG (puerto
USB~J4), desde la memoria Flash SPI integrada o desde una memoria USB
conectada al puerto HID~\cite{basys3rm}.

\begin{figure}[h]
  \centering
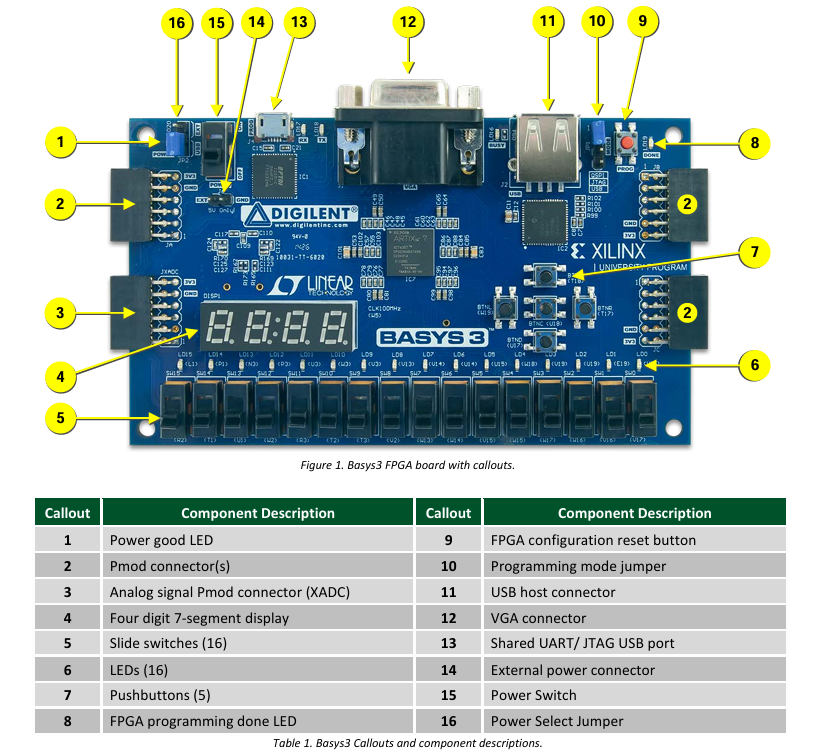
[picture p4: documento_tfg_emanuel_marin_overleaf/Documento_TFG_EmanuelMarin/fig/basys3.png]
  
  \caption{Placa de desarrollo Basys\,3 con FPGA Artix-7 \cite{basys3rm}.}
  \label{fig:basys3}
\end{figure}

% ---------------------------------------------------------------------------
\subsection{Herramientas: Vivado y Vitis}
\label{sec:tools}

El flujo de desarrollo de sistemas embebidos sobre FPGAs de AMD/Xilinx se
sustenta en dos herramientas complementarias: Vivado Design Suite para el
diseño de hardware y Vitis Unified Software Platform para el desarrollo de
software.

\textbf{AMD Vivado Design Suite} es el entorno de diseño para FPGAs de la
serie~7 en adelante. Vivado incluye el módulo IP~Integrator, que permite
construir diseños de bloques (\textit{block designs}) mediante la
interconexión gráfica de núcleos IP (\textit{Intellectual Property}), tales
como procesadores, controladores de memoria, interfaces de comunicación y
periféricos personalizados~\cite{ug994}. El flujo típico de un proyecto en
Vivado comprende: creación del \textit{block design}, generación de productos
de salida de los IPs, síntesis lógica, implementación física (\textit{place
and route}), verificación de restricciones temporales y generación del
\textit{bitstream}~\cite{ug994}. Para integrar periféricos personalizados, como el módulo PLPUF de este proyecto, Vivado ofrece un flujo de
empaquetado de IP que genera la descripción IP-XACT
(\texttt{component.xml}), permitiendo que el periférico sea reutilizable en
cualquier \textit{block design}~\cite{ug1037}.

\textbf{AMD Vitis} es la plataforma unificada de desarrollo de software para
sistemas embebidos basados en procesadores AMD. Vitis importa la descripción
del hardware exportada por Vivado en formato \texttt{.xsa} (\textit{Xilinx
Support Archive}), a partir de la cual genera automáticamente la plataforma
de software, incluyendo el \textit{Board Support Package} (BSP) con
controladores de periféricos y la biblioteca estándar de
C~\cite{ug1701}. El desarrollador crea aplicaciones en C/C++ que se compilan
con la cadena de herramientas GCC para RISC-V (\texttt{riscv64-unknown-elf-gcc})
y se cargan en la FPGA a través de JTAG para su ejecución y
depuración~\cite{ug1701}.

Este flujo HW--SW permite un desarrollo iterativo donde las modificaciones al
hardware (por ejemplo, cambios en el mapa de registros del periférico PLPUF)
se propagan al software mediante la regeneración del archivo~\texttt{.xsa} y
la actualización de la plataforma en Vitis~\cite{ug994, ug1701}.

% ============================================================================
\section{Funciones físicamente no clonables (PUF)}
\label{sec:puf}
% ============================================================================

Las Funciones Físicamente No Clonables (PUFs, por sus siglas en inglés
\textit{Physical Unclonable Functions}) son primitivas de seguridad de
hardware que explotan las variaciones microscópicas e incontrolables
introducidas durante el proceso de fabricación de circuitos integrados para
generar identificadores únicos y respuestas criptográficamente útiles
\cite{shamsoshoara_2020_puf, handschuh_2011_hardware}. Estas variaciones, como diferencias en el voltaje de umbral de los transistores, el espesor del
óxido de compuerta o los retardos de propagación en las
interconexiones, constituyen una fuente natural de entropía que es
reproducible dentro del mismo dispositivo pero impredecible e imposible de
replicar exactamente en otro chip, incluso del mismo lote de fabricación
\cite{anandakumar_2021_fpgapufs, sudhanya_2016_silicon}.

A diferencia de los mecanismos criptográficos convencionales, que dependen de
claves almacenadas en memorias no volátiles (EEPROM, Flash, SRAM con
respaldo de batería), las PUFs generan sus claves directamente desde las
propiedades físicas del silicio, eliminando la necesidad de almacenamiento
permanente de información sensible~\cite{hou_2019_lightweight, handschuh_2011_hardware}. Esta propiedad las hace intrínsecamente resistentes a
ataques físicos de extracción de claves y las posiciona como una alternativa
prometedora para el establecimiento de raíces de confianza en hardware
\cite{shamsoshoara_2020_puf}.

% ---------------------------------------------------------------------------
\subsection{Fundamentos y taxonomía}
\label{sec:puf_fund}

Una PUF se define formalmente como una función implementada por un sistema
físico que es fácil de evaluar pero extremadamente difícil o imposible de
clonar~\cite{anandakumar_2021_fpgapufs}. La interacción con una PUF se
realiza mediante un mecanismo de desafío-respuesta: ante un estímulo de
entrada (desafío), la PUF produce una salida (respuesta) que depende de las
características físicas únicas del dispositivo. Las propiedades esenciales que
debe exhibir una PUF son~\cite{lata_2023_fpgapuf, anandakumar_2021_fpgapufs}:

\begin{itemize}
  \item \textbf{Reproducibilidad:} la respuesta a un desafío dado debe ser
    consistente a lo largo del tiempo y bajo diferentes condiciones
    ambientales.
  \item \textbf{Unicidad:} diferentes dispositivos deben producir respuestas
    significativamente distintas ante el mismo desafío.
  \item \textbf{Inclonabilidad:} debe ser computacional y físicamente
    inviable construir una réplica del dispositivo o un modelo matemático que
    reproduzca fielmente el comportamiento de la PUF.
  \item \textbf{Impredecibilidad:} no debe ser posible predecir la respuesta
    a un desafío no observado previamente.
  \item \textbf{Evidencia de manipulación (\textit{tamper-evidence}):}
    cualquier alteración física del circuito debe modificar las respuestas de
    forma detectable.
\end{itemize}

Las variaciones del proceso de fabricación que explotan las PUFs se
clasifican en dos categorías~\cite{anandakumar_2021_fpgapufs}: variaciones
\textit{die-to-die}, que afectan a todo el chip de manera uniforme (inter-oblea,
inter-lote); y variaciones \textit{within-die}, que ocurren entre diferentes
elementos del mismo chip. Dentro de estas últimas, las variaciones aleatorias, causadas por la naturaleza estocástica del dopado y el crecimiento del óxido
de compuerta, son la fuente principal de entropía y de la propiedad de
inclonabilidad de las PUFs~\cite{anandakumar_2021_fpgapufs,
sudhanya_2016_silicon}.

Las PUFs se clasifican generalmente según el tamaño de su espacio de pares
desafío-respuesta (CRP) en dos categorías
principales~\cite{shamsoshoara_2020_puf, lata_2023_fpgapuf}:

\begin{itemize}
  \item \textbf{PUF débil (\textit{Weak PUF}):} genera un número limitado de
    CRPs, típicamente uno por instancia. Se utiliza principalmente para
    generación de claves criptográficas y almacenamiento seguro de claves.
    Ejemplos representativos incluyen las PUFs basadas en SRAM y
    \textit{flip-flop}~\cite{lata_2023_fpgapuf, chen_2016_fpga}.
  \item \textbf{PUF fuerte (\textit{Strong PUF}):} posee un espacio de CRPs
    exponencialmente grande en relación con su tamaño de implementación, lo
    que dificulta que un atacante capture todos los pares. Es adecuada para
    protocolos de autenticación donde cada CRP se utiliza una sola vez.
    Ejemplos incluyen la Arbiter PUF y la PUF de oscilador de anillo
    (RO-PUF)~\cite{shamsoshoara_2020_puf, lata_2023_fpgapuf}.
\end{itemize}

Desde la perspectiva de la arquitectura del circuito, las PUFs basadas en
FPGA pueden clasificarse en tres familias principales
\cite{lata_2023_fpgapuf, anandakumar_2021_fpgapufs}:

\begin{enumerate}
  \item \textbf{PUFs basadas en retardo:} explotan las diferencias en los
    tiempos de propagación de señales a través de caminos lógicos nominalmente
    idénticos. Incluyen la Arbiter PUF, la RO-PUF y la
    Pseudo-LFSR PUF (PLPUF)~\cite{hori_2011_pseudolfsr}.
  \item \textbf{PUFs basadas en memoria:} aprovechan el estado de
    encendido aleatorio de elementos de memoria biestables, como celdas SRAM
    o \textit{flip-flops}~\cite{chen_2016_fpga}.
  \item \textbf{PUFs híbridas y reconfigurables:} combinan técnicas de las
    dos familias anteriores o incorporan mecanismos de reconfiguración para
    ampliar el espacio de CRPs~\cite{liu_2019_xor}.
\end{enumerate}

% ---------------------------------------------------------------------------
\subsection{PUFs programables: Pseudo-LFSR PUF (PLPUF)}
\label{sec:plpuf}

La Pseudo-LFSR PUF (PL-PUF o PLPUF) es una arquitectura de PUF propuesta
por Hori~et~al.~\cite{hori_2011_pseudolfsr} que se basa en la estructura de
un registro de desplazamiento con retroalimentación lineal (LFSR), pero a
diferencia de un LFSR convencional, \textbf{no contiene registros de
desplazamiento}. En su lugar, el PLPUF emplea una cadena de lógica
puramente combinacional compuesta por inversores y compuertas XOR dispuestos
en una topología de retroalimentación tipo Fibonacci
\cite{hori_2011_pseudolfsr}. 

\subsubsection{Arquitectura del núcleo}

Para un PLPUF de $n$~bits, el diseño requiere únicamente $n$~inversores y un
número reducido de compuertas XOR determinado por el polinomio primitivo
utilizado. En la configuración de 128~bits propuesta
por~\cite{hori_2011_pseudolfsr}, el polinomio primitivo empleado es:
\begin{equation}
  p(x) = x^{128} + x^{126} + x^{102} + x^{99} + 1
  \label{eq:polynomial}
\end{equation}
lo que implica solamente tres compuertas XOR en las posiciones de
\textit{tap} correspondientes (índices 125, 101 y 98, indexados desde cero)
\cite{hori_2011_pseudolfsr}. Cada celda del PLPUF contiene un multiplexor
que selecciona entre el bit de desafío correspondiente (durante la fase de
carga) o la señal de retroalimentación del vecino (durante la fase activa), y
un inversor cuyo retardo de propagación constituye la fuente de entropía
física. Los inversores llevan el atributo \texttt{DONT\_TOUCH} para evitar
que las herramientas de síntesis optimicen o eliminen el lazo
combinacional.

La Figura~\ref{fig:plpuf_arch} presenta la estructura completa del PLPUF de
128~bits. La cadena está formada por celdas de lógica central (\textit{Core
logic}) conectadas en serie: la salida \texttt{Dout[128]} alimenta la entrada
de la siguiente celda, y así sucesivamente hasta \texttt{Dout[1]}. La línea
de retroalimentación conecta \texttt{Dout[1]} de vuelta a la entrada de la
primera celda, cerrando el lazo. En las posiciones de \textit{tap} (celdas
127, 102 y 100, correspondientes a los términos del polinomio primitivo) se
insertan compuertas XOR ($\oplus$) que combinan la señal de
retroalimentación con la salida del vecino adyacente, introduciendo la no
linealidad necesaria para la difusión de la entropía.

La Figura~\ref{fig:plpuf_core_logic} detalla la estructura interna de una
celda individual. Cada celda recibe dos entradas: \texttt{Din} (señal de
retroalimentación del vecino durante la fase activa) y \texttt{Dinit} (bit
de desafío correspondiente durante la fase de carga). La señal de
selección \texttt{SEL} controla
un multiplexor que elige entre ambas entradas. La señal seleccionada pasa a
través de un inversor, cuyo retardo de propagación (determinado por las variaciones del proceso de fabricación) constituye la
fuente de entropía física. La salida \texttt{Dout} alimenta la siguiente
celda de la cadena.

\begin{figure}[h]
  \centering
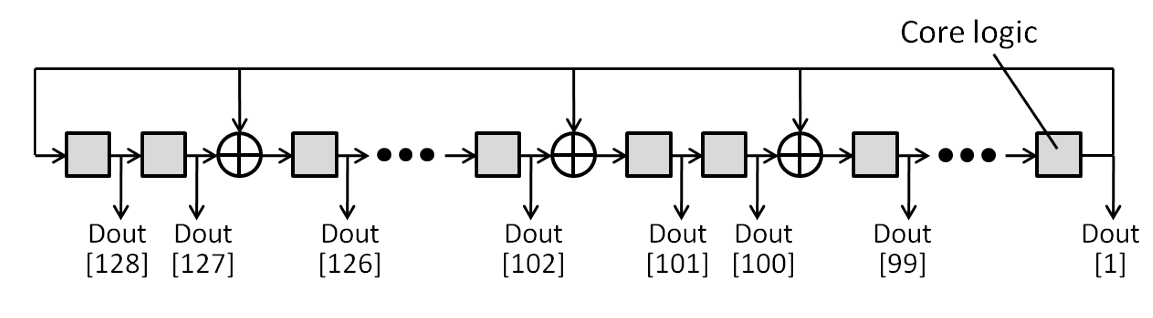
[picture p5: documento_tfg_emanuel_marin_overleaf/Documento_TFG_EmanuelMarin/fig/plpuf1.png]
  
  \caption{Estructura del Pseudo-LFSR PUF de 128~bits: cadena de celdas de
    lógica central con compuertas XOR en las posiciones de \textit{tap} y
    retroalimentación desde \texttt{Dout[1]} hacia la primera
    celda~\cite{hori_2011_pseudolfsr}.}
  \label{fig:plpuf_arch}
\end{figure}

\begin{figure}[h]
  \centering
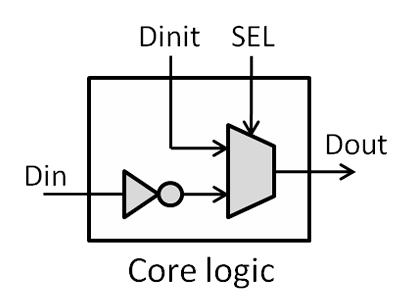
[picture p6: documento_tfg_emanuel_marin_overleaf/Documento_TFG_EmanuelMarin/fig/plpuf2.png]
  
  \caption{Estructura interna de una celda de lógica central: multiplexor
    controlado por \texttt{SEL} e inversor como fuente de
    entropía~\cite{hori_2011_pseudolfsr}.}
  \label{fig:plpuf_core_logic}
\end{figure}

\subsubsection{Operación del PLPUF}

El funcionamiento del PLPUF se controla mediante una máquina de estados
finitos (FSM) con cuatro estados, ilustrada en la
Figura~\ref{fig:plpuf_fsm}~\cite{hori_2011_pseudolfsr}. El diagrama muestra
las transiciones entre estados y las señales de control asociadas a cada uno:

\begin{enumerate}
  \item \textbf{\texttt{IDLE}} (\texttt{enable\,=\,0}, \texttt{busy\,=\,0},
    \texttt{done\,=\,0}): el módulo está inactivo, esperando la señal
    de inicio. Al recibir \texttt{start\,=\,1}, la FSM activa
    \texttt{busy\,=\,1} y transiciona a \texttt{LOAD}.
  \item \textbf{\texttt{LOAD}} (1~ciclo): el desafío de $n$~bits se propaga
    a través de los inversores con la señal de habilitación desactivada
    (\texttt{enable\,=\,0}), permitiendo que la cadena se estabilice en un
    estado determinado por el desafío. Como se observa en la figura, en este
    estado el desafío (\texttt{challenge}) se propaga por la cadena mientras
    \texttt{enable} permanece en cero. Esta fase dura un solo ciclo de reloj,
    tras lo cual \texttt{enable} pasa a~1 y la FSM avanza a \texttt{ACTIVE}.
  \item \textbf{\texttt{ACTIVE}} (\texttt{enable\,=\,1}): el lazo de
    retroalimentación se cierra y el circuito oscila libremente a una
    frecuencia determinada por los retardos acumulados de propagación de cada
    inversor y compuerta XOR, retardos que son únicos para cada chip
    fabricado. Esta fase dura exactamente $c$~ciclos de reloj, donde $c$ es
    la \textbf{duración de activación} configurable por software. Cuando el
    contador descendente alcanza \texttt{duration\,$-$\,1}, el estado de la
    cadena se captura en el registro de respuesta
    (\texttt{response\,$\leftarrow$\,core\_out}) y la FSM transiciona a
    \texttt{DONE}.
  \item \textbf{\texttt{DONE}} (1~ciclo, \texttt{done\,=\,1},
    \texttt{busy\,=\,0}): la señal \texttt{done} emite un pulso de un ciclo,
    indicando que la respuesta de $n$~bits está disponible en los registros de
    salida. La FSM retorna automáticamente a \texttt{IDLE}, quedando lista
    para una nueva evaluación.
\end{enumerate}

\begin{figure}[h]
  \centering
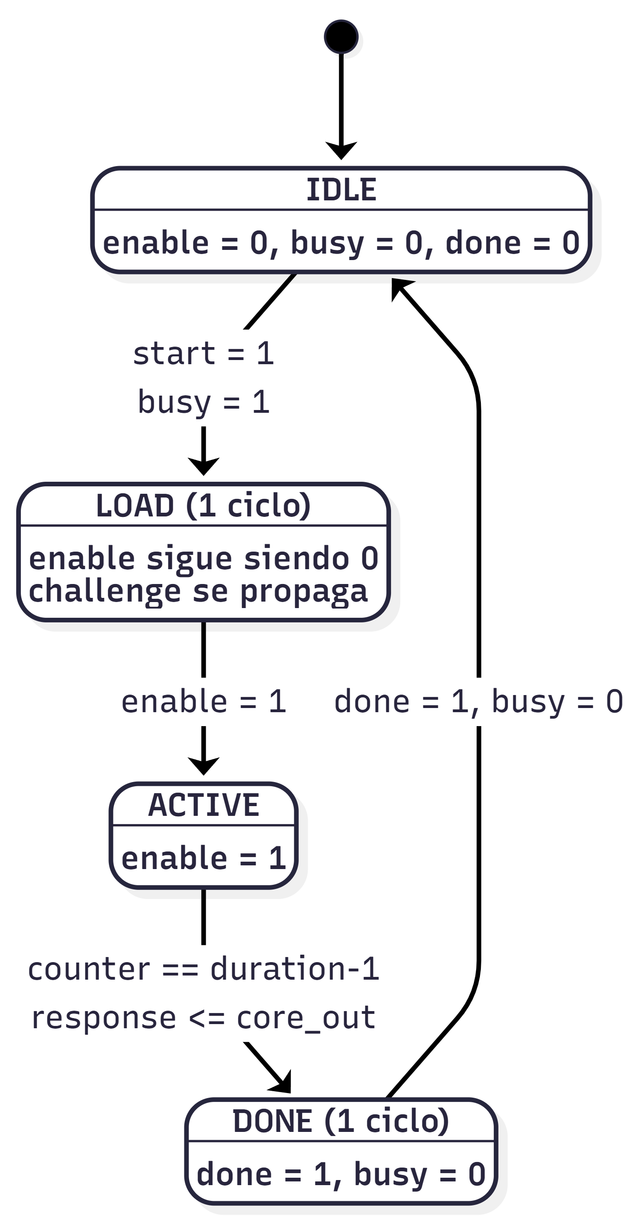
[picture p7: documento_tfg_emanuel_marin_overleaf/Documento_TFG_EmanuelMarin/fig/plpuf_fsm.png]
  
  \caption{Máquina de estados del PLPUF: ciclo de evaluación
           desafío-respuesta con las señales de control y las condiciones de
           transición entre los estados \texttt{IDLE}, \texttt{LOAD},
           \texttt{ACTIVE} y \texttt{DONE}.}
  \label{fig:plpuf_fsm}
\end{figure}

\subsubsection{Propiedades distintivas}

El PLPUF presenta varias propiedades que lo distinguen de otras arquitecturas
de PUF~\cite{hori_2011_pseudolfsr}:

\begin{itemize}
  \item \textbf{Compacidad:} requiere solo $n$~inversores y un número
    reducido de compuertas XOR, en contraste con la Arbiter PUF que necesita
    $2n$~multiplexores para un diseño de $n$~bits.
  \item \textbf{Eficiencia:} genera una respuesta de $n$~bits a partir de un
    solo desafío de $n$~bits en una única evaluación.
  \item \textbf{Multifuncionalidad:} la relación desafío-respuesta puede
    modificarse sin alterar el hardware, simplemente variando la duración de
    activación~$c$. Cada valor de~$c$ genera un mapeo desafío-respuesta
    diferente, lo que equivale conceptualmente a disponer de múltiples
    núcleos PUF dentro de un solo circuito.
  \item \textbf{Configurabilidad de confiabilidad:} la confiabilidad de las
    respuestas puede ajustarse seleccionando un valor adecuado de~$c$. Con
    duraciones cortas ($c < 4$), el PLPUF exhibe una distancia de Hamming
    intra-dispositivo baja (alta confiabilidad); a medida que~$c$ aumenta, la
    variabilidad de las respuestas crece~\cite{hori_2011_pseudolfsr}.
\end{itemize}

\subsubsection{Resultados experimentales de referencia}

Hori~et~al.~\cite{hori_2011_pseudolfsr} implementaron un PLPUF de 128~bits
en 16~FPGAs Virtex-5 \texttt{XC5VLX30} montadas en placas SASEBO-GII,
operando a 24\,MHz con tensión de núcleo de 1,0\,V. Se evaluaron 100~desafíos
aleatorios con 100~repeticiones cada uno para valores de duración de
activación $c = 1, \ldots, 16$. Los resultados mostraron una distancia de
Hamming intra-dispositivo pequeña para valores bajos de~$c$ (por ejemplo,
media de 1,76~bits para $c = 1$) y tasas de falsa aceptación y falso rechazo
(FAR/FRR) iguales a cero para múltiples dispositivos con
$c \leq 4$~\cite{hori_2011_pseudolfsr}.

\subsubsection{Riesgos de la duración de activación}

Investigaciones recientes de Alsharkawy~et~al.~\cite{alsharkawy_2024_plpufs}
demostraron que la duración de activación constituye un parámetro crítico de
seguridad en los PLPUFs. Mediante un análisis de dependencia lineal entre
pares de PLPUFs implementados en 8~FPGAs ARTY~A7 (32~instancias, 8\,192~CRPs
cada una), los autores encontraron que con $c = 1$ la predictibilidad
promedio entre PLPUFs ubicados en la misma posición física alcanza hasta el
96\,\%, mientras que con $c = 31$ la predictibilidad disminuye a
aproximadamente 30\,\%~\cite{alsharkawy_2024_plpufs}. Este hallazgo subraya
la importancia de seleccionar cuidadosamente la duración de activación para
equilibrar confiabilidad y resistencia ante ataques predictivos.

% ---------------------------------------------------------------------------
\subsection{Modelos de desafío-respuesta (CRP)}
\label{sec:crp}

El modelo de desafío-respuesta (\textit{Challenge-Response Pair}, CRP) es el
paradigma fundamental de interacción con una PUF. Un desafío~$C$ es un
estímulo de entrada de $n$~bits que se aplica al circuito PUF, y la
respuesta~$R$ es la salida de $n$~bits producida por la PUF en función de
las características físicas únicas del dispositivo
\cite{shamsoshoara_2020_puf}. Cada dispositivo fabricado genera un conjunto
de CRPs propio y diferente, que actúa como una huella digital del hardware.

El espacio total de CRPs de una PUF determina su clasificación funcional y
sus aplicaciones de seguridad~\cite{shamsoshoara_2020_puf,
alhamarneh_2024_strengthening}:

\begin{itemize}
  \item En una \textbf{PUF débil}, el espacio de CRPs es limitado (a menudo
    un solo par), por lo que se emplea para generación de claves y
    almacenamiento seguro de secretos.
  \item En una \textbf{PUF fuerte}, el espacio crece exponencialmente con el
    tamaño de la implementación ($2^n$ para $n$~bits de desafío), lo que
    permite protocolos de autenticación donde cada CRP se utiliza una sola
    vez para evitar ataques de reproducción
    (\textit{replay attacks})~\cite{shamsoshoara_2020_puf}.
\end{itemize}

En el caso específico del PLPUF, la multifuncionalidad proporcionada por la
duración de activación~$c$ amplía efectivamente el espacio de CRPs: cada
combinación de desafío y duración $(C, c)$ produce una respuesta diferente,
de modo que un PLPUF de $n$~bits con un rango de duraciones de 1 a~$c_{\max}$
ofrece hasta $c_{\max} \times 2^n$ pares desafío-respuesta distintos
\cite{hori_2011_pseudolfsr}.

La seguridad de un esquema basado en CRPs puede evaluarse mediante dos
métricas complementarias~\cite{idriss_2016_puf}: el número de CRPs que un
atacante debe recopilar para modelar exitosamente la PUF con una
predictibilidad del 99\,\% (\textit{NCR, Number of CRPs}); y el tiempo
computacional requerido para construir dicho modelo (\textit{TTM, Time to
Model}). Una PUF es considerada segura cuando ambas métricas exceden los
límites prácticos de un atacante.

% ============================================================================
\section{Seguridad en sistemas embebidos}
\label{sec:seguridad}
% ============================================================================

La seguridad de los sistemas embebidos enfrenta desafíos crecientes debido a
la proliferación de dispositivos IoT en entornos físicamente accesibles, donde
los atacantes pueden realizar ataques invasivos y semi-invasivos sobre el
hardware~\cite{shamsoshoara_2020_puf, parikh_2025_survey}. En este contexto,
las PUFs ofrecen una alternativa de bajo costo y recursos reducidos para
establecer raíces de confianza directamente en el silicio, sin depender de
almacenamiento criptográfico externo~\cite{handschuh_2011_hardware}.

% ---------------------------------------------------------------------------
\subsection{Autenticación de hardware}
\label{sec:autenticacion}

La autenticación de hardware basada en PUFs sigue un esquema de dos fases:
registro (\textit{enrollment}) y verificación
\cite{shamsoshoara_2020_puf, almeer_2023_puf}.

\begin{enumerate}
  \item \textbf{Fase de registro:} en un entorno controlado y seguro, se
    aplican al dispositivo un conjunto de desafíos $\{C_1, C_2, \ldots,
    C_m\}$ y se almacenan las respuestas correspondientes
    $\{R_1, R_2, \ldots, R_m\}$ en una base de datos del servidor
    verificador. Dado que las PUFs no son perfectamente estables, se puede
    emplear votación por mayoría sobre múltiples evaluaciones para obtener
    respuestas de referencia (\textit{golden responses})
    \cite{maiti_2012_systematic}.
  \item \textbf{Fase de verificación:} el servidor envía un desafío~$C_i$ al
    dispositivo y compara la respuesta recibida~$R'_i$ con la respuesta de
    referencia~$R_i$ almacenada. Si la distancia de Hamming entre ambas es
    menor que un umbral predefinido~$t$, el dispositivo se considera
    auténtico~\cite{shamsoshoara_2020_puf}.
\end{enumerate}

Para aplicaciones que requieren generación de claves criptográficas estables
a partir de respuestas PUF ruidosas, se emplean algoritmos de datos
auxiliares (\textit{Helper Data Algorithms}, HDA) que combinan la respuesta
de la PUF con datos públicos y códigos correctores de errores para reproducir
una clave determinística~\cite{delvaux_2015_helper}. Este enfoque permite
derivar claves de hasta 128 o 256~bits con alta confiabilidad, sin almacenar
la clave en sí misma en memoria no volátil~\cite{delvaux_2015_helper,
farha_2019_physical}.

La resistencia de las PUFs a la computación cuántica constituye una ventaja
adicional: dado que la seguridad de las PUFs no depende de la dificultad de
problemas matemáticos (como la factorización de enteros o el logaritmo
discreto), sino de propiedades físicas del silicio, se consideran
intrínsecamente resistentes a ataques cuánticos que amenazan los algoritmos
criptográficos convencionales~\cite{
shamsoshoara_2020_puf, almeer_2023_puf}.

% ---------------------------------------------------------------------------
\subsection{Métricas de evaluación: unicidad, confiabilidad y uniformidad}
\label{sec:metricas}

La evaluación del rendimiento de una PUF requiere un conjunto de métricas
estadísticas bien definidas. Maiti~et~al.~\cite{maiti_2012_systematic}
propusieron un marco sistemático basado en siete parámetros agrupados en tres
dimensiones: dispositivo (variabilidad inter-chip), tiempo (estabilidad
intra-chip) y espacio (distribución de bits). A continuación se describen las
métricas principales empleadas en este trabajo.

\subsubsection{Uniformidad}

La uniformidad mide la distribución de bits en la respuesta de una PUF. Para
una PUF ideal, la proporción de unos en la respuesta debe ser del 50\,\%,
indicando máxima entropía por bit~\cite{maiti_2012_systematic}. Se calcula
como:
\begin{equation}
  \text{Uniformidad} = \frac{1}{n} \sum_{j=1}^{n} r_j \times 100\%
  \label{eq:uniformity}
\end{equation}
donde $r_j$ es el $j$-ésimo bit de la respuesta y $n$ es el ancho en bits de
la PUF. Un valor cercano a 50\,\% indica que la PUF no presenta sesgo
significativo hacia ceros o unos.

\subsubsection{Confiabilidad (fiabilidad)}

La confiabilidad cuantifica la reproducibilidad de las respuestas de una PUF
ante el mismo desafío bajo las mismas condiciones operativas. Se evalúa
midiendo la distancia de Hamming fraccional intra-dispositivo (\textit{intra-HD})
entre la respuesta de referencia y respuestas obtenidas en evaluaciones
sucesivas~\cite{maiti_2012_systematic}:
\begin{equation}
  \text{Confiabilidad} = 100\% - \text{BER}
  \label{eq:reliability}
\end{equation}
donde BER (\textit{Bit Error Rate}) es la tasa de error de bit promedio sobre
$m$~evaluaciones:
\begin{equation}
  \text{BER} = \frac{1}{m} \sum_{i=1}^{m}
    \frac{\text{HD}(R_{\text{ref}},\, R_i)}{n} \times 100\%
  \label{eq:ber}
\end{equation}
con $R_{\text{ref}}$ como la respuesta de referencia (obtenida por votación
por mayoría), $R_i$ como la $i$-ésima respuesta y $\text{HD}(\cdot,\cdot)$ la
distancia de Hamming entre dos vectores binarios. Idealmente, la
confiabilidad debe ser del 100\,\% (BER~$= 0$); en la práctica, valores
superiores al 95\,\% se consideran aceptables para aplicaciones de
identificación~\cite{hori_2011_pseudolfsr, maiti_2012_systematic}.

\subsubsection{Unicidad}

La unicidad mide la capacidad de una PUF para distinguir dispositivos
individuales. Se evalúa mediante la distancia de Hamming fraccional
inter-dispositivo (\textit{inter-HD}) entre las respuestas de referencia de
diferentes chips ante el mismo desafío
\cite{maiti_2012_systematic}:
\begin{equation}
  \text{Inter-HD} = \frac{2}{k(k-1)} \sum_{i=1}^{k-1} \sum_{j=i+1}^{k}
    \frac{\text{HD}(R_i,\, R_j)}{n} \times 100\%
  \label{eq:uniqueness}
\end{equation}
donde $k$ es el número de dispositivos evaluados. El valor ideal es 50\,\%,
lo que indica máxima separación estadística entre los identificadores de
dispositivos diferentes~\cite{maiti_2012_systematic}.

En la evaluación intra-dispositivo (cuando solo se dispone de un chip), la
distancia de Hamming inter-desafío permite estimar indirectamente la
variabilidad: se calculan las respuestas de referencia para $m$~desafíos
diferentes y se mide la HD promedio entre todos los pares de respuestas. Un
valor cercano al 50\,\% indica que el PLPUF es capaz de generar respuestas
suficientemente diversas ante desafíos distintos
\cite{hori_2011_pseudolfsr}.

\subsubsection{Alias de bit (\textit{Bit-Alias})}

El alias de bit mide la tendencia de cada posición individual de la respuesta
a ser predominantemente cero o uno a través de múltiples dispositivos
\cite{wilde_2020_confidence}. Para la posición~$j$, el alias de bit es la
proporción de unos observados en esa posición sobre $k$~dispositivos. El
valor ideal es 0,5 para cada posición; desviaciones significativas indican
bits con baja entropía que podrían ser explotados por un atacante
\cite{wilde_2020_confidence}. Wilde y Pehl~\cite{wilde_2020_confidence}
demostraron la importancia de incorporar intervalos de confianza en la
medición del alias de bit, señalando que se requiere un número elevado de
muestras (del orden de cientos de dispositivos) para obtener estimaciones
estadísticamente confiables.

\subsubsection{Min-entropía}

La min-entropía es una métrica más conservadora que la entropía de Shannon
para cuantificar la impredecibilidad de una PUF, ya que considera la
probabilidad de la respuesta más probable en lugar del
promedio~\cite{frisch_2023_practical}. En sistemas que emplean algoritmos de
datos auxiliares para la corrección de errores, la min-entropía condicional
$\bar{H}_{\infty}(X|Y)$ mide la impredecibilidad residual del secreto dado
el conocimiento de los datos auxiliares públicos~$Y$. Frisch~et~al.\
\cite{frisch_2023_practical} propusieron un método basado en convolución de
histogramas que permite estimar la min-entropía en escenarios con sesgos
arbitrarios y correlaciones realistas, superando las limitaciones de los
enfoques que asumen respuestas independientes e idénticamente distribuidas
(IID).

% ============================================================================

%%% Local Variables:
%%% mode: latex
%%% TeX-master: "main"
%%% End:
