MarinGE23/axi-plpuf-ip/documento_tfg_emanuel_marin_overleaf/Documento_TFG_EmanuelMarin/dedicatoria.tex

%% ---------------------------------------------------------------------------
%% dedicatoria.tex
%% Dedicatoria
%% ---------------------------------------------------------------------------

\thispagestyle{empty}
\cleardoublepage

\vspace*{0.35\textheight}

\begin{center}
  {\Huge\bfseries Dedicatoria}

  \vspace{2cm}

  {\Large\emph{A mi querida mamá, a mi familia y a mis amigos.}}
\end{center}

\vspace*{\fill}
\cleardoublepage

%%% Local Variables:
%%% mode: latex
%%% TeX-master: "main"
%%% End:
