MarinGE23/axi-plpuf-ip/docu/PUFs_PLPUFs/02_PUF_Fundamentals/resumen_02_PUF_Fundamentals.md

# Resumen de la Carpeta: 02_PUF_Fundamentals

Esta sección presenta un análisis detallado de los documentos PDF contenidos en la carpeta `02_PUF_Fundamentals`, enfocándose en los aspectos clave de cada publicación.

---

## A Survey on Physical Unclonable Function (PUF)-based Security Solutions for Internet of Things.pdf

El documento "A Survey on Physical Unclonable Function (PUF)-based Security Solutions for Internet of Things" (Una Encuesta sobre Soluciones de Seguridad Basadas en Funciones Físicas Inclonables (PUF) para el Internet de las Cosas), escrito por Alireza Shamsoshoara, Ashwija Korenda, Fatemeh Afghah y Sherali Zeadally, es una revisión exhaustiva de los desafíos de seguridad en las redes emergentes del Internet de las Cosas (IoT) y explora el papel de las Funciones Físicas Inclonables (PUF) como una solución de seguridad basada en hardware.

**Puntos Clave y Temas Principales Cubiertos:**

El artículo comienza destacando la creciente omnipresencia del IoT en diversas aplicaciones como ciudades inteligentes, transporte, hogares inteligentes, agricultura y salud. A pesar de los beneficios, esta expansión masiva presenta vulnerabilidades de seguridad significativas debido a la gran cantidad de dispositivos, su heterogeneidad, recursos limitados (energía y capacidad computacional) y la falta de estándares de seguridad unificados. Se mencionan ejemplos de ataques notables como ransomware (WannaCry, Petya) y ataques DDoS (Dyn cyber attack) que han afectado a millones de dispositivos y servicios.

El documento clasifica los desafíos de seguridad del IoT en identificación, autenticación, cifrado, confidencialidad, interferencia (jamming), clonación, secuestro y privacidad. Se discute que las soluciones criptográficas convencionales, aunque fundamentales, no son suficientes por sí solas. La generación, distribución y almacenamiento de claves secretas son un desafío particular en entornos IoT a gran escala, ya que las claves suelen almacenarse en memorias no volátiles (NVM) que son susceptibles a ataques físicos invasivos.

El enfoque principal del estudio es la exploración de las **Funciones Físicas Inclonables (PUF)** como una alternativa prometedora para la generación y gestión de claves secretas en dispositivos IoT. Las PUF aprovechan las variaciones microscópicas de fabricación inherentes a cada circuito integrado para generar una "huella digital" única para cada dispositivo, que es intrínseca al hardware y no puede ser clonada. Esto las convierte en una solución atractiva para la identificación y autenticación.

**Ventajas de las PUF:**

*   **Intrínsecas al hardware:** Las claves se derivan directamente de las propiedades físicas del dispositivo, eliminando la necesidad de almacenamiento en NVM y reduciendo la vulnerabilidad a ataques físicos.
*   **Inclonables:** Las variaciones de fabricación son aleatorias y difíciles de replicar, haciendo que cada PUF sea única.
*   **Rentables:** Pueden integrarse en los procesos de fabricación existentes sin costos adicionales significativos.
*   **Eficientes en recursos:** Adecuadas para dispositivos IoT con limitaciones de energía y computación.

**Desafíos y Barreras de las PUF:**

A pesar de sus ventajas, el documento también aborda las limitaciones de las PUF:

*   **Fiabilidad:** La salida de una PUF puede variar ligeramente con cambios de temperatura, voltaje o envejecimiento, lo que requiere mecanismos de corrección de errores.
*   **Unicidad:** Asegurar que cada PUF genere una respuesta suficientemente distinta de otras.
*   **Aleatoriedad:** La imprevisibilidad de la respuesta de la PUF.
*   **Robustez:** Resistencia a ataques de modelado, ataques de aprendizaje automático y otros ataques físicos.

**Metodología Principal y Enfoque de la Encuesta:**

La metodología del documento es una revisión exhaustiva del estado del arte en soluciones de seguridad basadas en PUF para IoT. Se analizan diferentes tipos de PUF y sus aplicaciones, centrándose en cómo abordan los problemas de generación, distribución y almacenamiento de claves. La encuesta compara soluciones basadas en software y hardware, argumentando a favor de estas últimas debido a la creciente amenaza de la computación cuántica contra los algoritmos criptográficos basados en software.

**Prueba de Concepto (Proof-of-Concept):**

El artículo presenta una **prueba de concepto de una solución basada en PUF para la generación de claves secretas utilizando memorias de acceso aleatorio resistivas (ReRAM)** incrustadas en dispositivos IoT. Aunque el extracto proporcionado no detalla completamente la arquitectura o los resultados de esta implementación, la mención indica que el documento va más allá de una mera revisión teórica, proponiendo una aplicación práctica de las PUF. Las ReRAM son un tipo de memoria no volátil que puede exhibir variaciones a nivel de dispositivo que las hacen candidatas para PUF.

**Resultados más Importantes y Conclusiones:**

El documento concluye que las PUF representan una solución prometedora para fortalecer la seguridad de los dispositivos IoT al ofrecer un método robusto y eficiente para la generación y gestión de claves criptográficas. Al aprovechar las características físicas únicas de cada chip, las PUF pueden mitigar los riesgos asociados con el almacenamiento de claves en NVM y los ataques físicos invasivos.

Sin embargo, para que las PUF sean ampliamente adoptadas, es crucial abordar los desafíos de fiabilidad, unicidad y robustez a través de diseños de PUF mejorados y técnicas de post-procesamiento (como códigos de corrección de errores y extractores de entropía). La integración de PUF, especialmente las basadas en ReRAM, podría proporcionar una capa de seguridad de hardware fundamental para el futuro del IoT, protegiendo contra ataques cada vez más sofisticados y la amenaza de la computación cuántica.

En resumen, el documento subraya la necesidad crítica de soluciones de seguridad robustas para el IoT, argumenta que las soluciones tradicionales son insuficientes y posiciona las PUF como una tecnología clave para la seguridad de hardware en el entorno IoT, a la vez que reconoce los desafíos que deben superarse para su implementación a gran escala.

---

## FPGA-Based PUF Designs A Comprehensive Review and Comparative Analysis.pdf

El documento "FPGA-Based PUF Designs: A Comprehensive Review and Comparative Analysis" de Lata y Cenkeramaddi (2023) es una revisión exhaustiva y un análisis comparativo de los diseños de Funciones Físicas Inclonables (PUF) basados en FPGAs. El estudio destaca el papel fundamental de las FPGAs como plataformas dinámicas para la implementación de PUFs, dada su reconfigurabilidad intrínseca y su impacto significativo en la mejora de la seguridad del hardware.

**Puntos Clave y Motivaciones:**

El artículo enfatiza la creciente necesidad de seguridad robusta en los sistemas informáticos modernos, especialmente en el contexto del Internet de las Cosas (IoT). Las PUFs se presentan como una medida de protección de hardware crucial para la autenticación de dispositivos, la generación de claves criptográficas y la fortificación de protocolos de seguridad. Aprovechan las diferencias de fabricación únicas en los componentes de hardware para generar identificadores específicos del dispositivo, añadiendo una capa adicional de defensa contra diversos ataques.

Las FPGAs, con su naturaleza reconfigurable y versatilidad, son una plataforma ideal para implementar PUFs, ofreciendo a los diseñadores la capacidad de construir circuitos digitales únicos a nivel de hardware. Esta combinación fortalece la seguridad de los sistemas de hardware y permite la integración de primitivas de seguridad en una amplia gama de componentes, desde la electrónica de consumo hasta la infraestructura crítica.

El mercado de las FPGAs está en constante crecimiento, proyectándose un aumento significativo en los próximos años. Su flexibilidad, rentabilidad y rápido tiempo de comercialización las convierten en la elección preferida para muchas aplicaciones relacionadas con la seguridad, lo que subraya la importancia de integrar PUFs con FPGAs.

**Aplicaciones de las PUFs basadas en FPGAs:**

El documento ilustra la amplia gama de aplicaciones de las PUFs, incluyendo:
*   Generación de claves secretas.
*   Generación de números aleatorios.
*   Protección de la propiedad intelectual de las FPGAs.
*   Identificación de dispositivos.
*   Autenticación de chips.
*   Protocolos de intercambio/acuerdo de claves.
*   Prevención de falsificaciones.
*   Seguridad del IoT.

**Contribuciones del Estudio:**

Las principales contribuciones del trabajo son:
1.  **Encuesta Exhaustiva de PUFs basadas en FPGAs:** Presenta un estudio detallado de las metodologías actuales y emergentes para el diseño de PUFs basadas en FPGAs, centrándose en sus aplicaciones de seguridad. Se analizan más de 100 publicaciones relevantes para capturar los últimos avances.
2.  **Categorización Profunda de Aplicaciones de PUF:** Clasifica los trabajos de investigación según las diversas aplicaciones de las PUFs basadas en FPGAs, destacando los desafíos específicos de cada tarea y proponiendo soluciones basadas en una extensa investigación bibliográfica.
3.  **Evaluación Crítica del Campo:** Proporciona una evaluación crítica del estado actual del campo, identificando problemas críticos (tanto resueltos como sin resolver) y ofreciendo posibles soluciones para futuros avances.

**Metodología y Estructura del Documento:**

El documento se estructura para ofrecer una comprensión integral de las PUFs y su implementación en FPGAs:
*   **Sección 2:** Introduce los tipos de PUFs y sus implementaciones, enfatizando los conceptos fundamentales.
*   **Sección 3:** Discute la implementación de diferentes tipos de PUFs basadas en FPGAs.
*   **Sección 4:** Define las métricas y criterios utilizados para evaluar y comparar diferentes diseños de PUFs basadas en FPGAs, explicando su importancia para evaluar el rendimiento y la seguridad.
*   **Sección 5:** Explora a fondo las aplicaciones de las PUFs basadas en FPGAs en diversos dominios para fines de seguridad.
*   **Sección 6:** Presenta un análisis comparativo de los diseños de PUFs basadas en FPGAs basado en las métricas definidas.
*   **Sección 7:** Ofrece una discusión y posibles desarrollos futuros para todo el campo.
*   **Sección 8:** Concluye el estudio, ofreciendo soluciones para abordar el rápido desarrollo del campo.

**Características de una Buena PUF:**

El estudio destaca que una buena PUF debe considerar varios parámetros, agrupados en cinco categorías principales:
*   **Sin datos de ayuda:** Idealmente, una PUF no debería requerir datos auxiliares para su operación.
*   **Fiabilidad probada:** La capacidad de la PUF para producir la misma respuesta de manera consistente bajo diferentes condiciones ambientales.
*   **Seguridad:** Resistencia a ataques de modelado, clonación y manipulación física.
*   **Unicidad de las respuestas generadas:** Cada PUF debe generar una respuesta única y distintiva.
*   **Flexibilidad y portabilidad:** La capacidad de la PUF para ser implementada en diferentes plataformas y adaptarse a diversas aplicaciones.

**Resultados Importantes y Análisis Comparativo (Anticipado):**

Aunque el resumen proporcionado no incluye los detalles de la sección de análisis comparativo (Sección 6), se espera que esta sección evalúe los diferentes diseños de PUF basados en FPGA (estáticos, dinámicos e híbridos) en función de métricas como:
*   **Distintividad:** La medida en que las respuestas de diferentes PUFs son únicas.
*   **Fiabilidad:** La consistencia de las respuestas de una misma PUF a lo largo del tiempo y bajo variaciones ambientales.
*   **Resistencia a ataques:** La robustez de la PUF contra ataques físicos y lógicos, incluyendo ataques de modelado, ataques de lectura y ataques de manipulación.
*   **Eficiencia de recursos:** El consumo de área y potencia en la FPGA.
*   **Rendimiento:** La velocidad de generación de respuestas.

**Conclusiones (Anticipadas):**

La investigación tiene como objetivo proporcionar a los diseñadores de sistemas y profesionales de la seguridad la información crucial para seleccionar el diseño de PUF más adecuado para sus aplicaciones específicas. El estudio ofrece una visión completa de la funcionalidad, las capacidades de seguridad y las posibles aplicaciones de los sistemas PUF basados en FPGA, avanzando el campo de la seguridad del hardware y permitiendo la toma de decisiones informadas en la implementación de soluciones PUF basadas en FPGA.

En resumen, el documento es una referencia fundamental para comprender el estado actual de las PUFs basadas en FPGAs, sus aplicaciones, desafíos y las direcciones futuras de investigación en este campo crucial de la seguridad del hardware.

---

## FPGA-based Physical Unclonable Functions A comprehensive overview of theory and architectures.pdf

El documento "FPGA-based Physical Unclonable Functions: A comprehensive overview of theory and architectures" de Nalla Anandakumar, Hashmi y Tehranipoor es una **revisión exhaustiva y un análisis profundo** del estado del arte de las Funciones Físicas Inclonables (PUF) implementadas en FPGAs. Aborda la teoría, arquitecturas, evaluación de rendimiento, ataques y contramedidas, aplicaciones y futuras direcciones de investigación en este campo.

### Puntos Clave del Documento:

1.  **Contexto y Motivación:** El documento destaca el rápido crecimiento del mercado de FPGAs y sus ventajas (menor costo de diseño, tiempo de comercialización, flexibilidad) frente a los ASICs. Sin embargo, subraya las vulnerabilidades de seguridad inherentes a las FPGAs, como la facilidad de clonación de bitstreams y la necesidad de almacenar claves secretas externamente (o en memoria volátil), lo que las hace susceptibles a ataques. Las PUFs se proponen como una solución prometedora para generar y almacenar claves de forma intrínseca y no volátil, aprovechando las variaciones de fabricación microscópicas.

2.  **Concepto de PUF:** Una PUF es una función implementada por un sistema físico que es fácil de evaluar pero difícil o imposible de clonar. Genera una "firma" única a partir de las variaciones intrínsecas del proceso de fabricación del silicio mediante un mecanismo de desafío-respuesta (CRP).

3.  **Características Esenciales de las PUFs:**
    *   **Reproducible:** La respuesta a un desafío dado debe ser consistente a lo largo del tiempo y bajo diferentes condiciones ambientales.
    *   **Única:** Cada dispositivo debe producir respuestas distintivas, incluso si son del mismo diseño.
    *   **Inclonable:** Es extremadamente difícil construir una réplica física o un modelo matemático que imite el comportamiento de la PUF.
    *   **Unidireccional:** A partir de la respuesta, es difícil inferir el desafío que la generó.
    *   **Impredecible:** No es posible predecir nuevas respuestas a desafíos no observados previamente.
    *   **Evidencia de Manipulación (Tamper-evident):** Cualquier alteración física de la PUF debe modificar sus respuestas de manera detectable.

4.  **Variaciones del Dispositivo y su Impacto:** Las PUFs se basan en las variaciones de proceso a nanoescala en la lógica e interconexión de los circuitos integrados. Estas variaciones se clasifican en:
    *   **Variaciones Die-to-Die:** Afectan a todo el chip por igual (inter-wafer, inter-lote, etc.).
    *   **Variaciones Within-Die:** Ocurren entre diferentes elementos del mismo chip. Se subdividen en:
        *   **Sistemáticas:** Causadas por imperfecciones de fabricación con correlación espacial.
        *   **Aleatorias:** No sistemáticas, causadas por la naturaleza estocástica de los dopantes y el grosor del óxido de puerta. Estas últimas son la fuente principal de la aleatoriedad y la inclonabilidad de las PUFs.

5.  **Clasificación de las PUFs:**
    *   **Basadas en Fabricación:**
        *   **Hardware PUFs (Strong PUFs y Weak PUFs):** Implementadas directamente en el hardware.
        *   **Software PUFs:** Basadas en propiedades de software o memoria.
    *   **Basadas en Seguridad (Strong vs. Weak PUFs):**
        *   **Weak PUFs:** Producen un número limitado de CRPs y suelen usarse para generación de claves. Son susceptibles a ataques de modelado si se exponen demasiados CRPs.
        *   **Strong PUFs:** Producen un gran número de CRPs y están diseñadas para autenticación, siendo más resistentes a ataques de modelado.

6.  **Diseños de PUFs Basadas en FPGAs:** El documento explora diversas arquitecturas de PUFs que aprovechan las variaciones de retardo de propagación inherentes a los componentes lógicos de las FPGAs. Las principales categorías son:
    *   **PUFs Basadas en Retardo (Delay-Based PUFs):**
        *   **Arbiter PUF:** Compara los tiempos de propagación de dos caminos idénticos a través de un multiplexor. Suelen ser susceptibles a ataques de modelado.
        *   **Ring Oscillator (RO) PUF:** Se basa en la comparación de las frecuencias de osciladores de anillo idénticos.
        *   **Glitch PUF:** Aprovecha los "glitches" o picos transitorios de voltaje causados por diferencias de retardo.
        *   **Sense Amplifier PUF:** Utiliza amplificadores de sentido para detectar pequeñas diferencias de voltaje.
        *   **Transient Effect Ring Oscillator (TERO) PUF:** Mide los tiempos de estabilización de osciladores.
    *   **PUFs Basadas en Memoria (Memory-Based PUFs):**
        *   **SRAM PUF:** Utiliza el estado inicial aleatorio de las celdas SRAM al encenderse.
        *   **Flip-Flop (FF) PUF:** Aprovecha el estado inicial aleatorio de los flip-flops.
        *   **Latch PUF:** Similar a FF PUF, pero con latches.
        *   **Configurable Logic Block (CLB) PUF:** Explota las características de los bloques lógicos configurables.
        *   **BRAM PUF:** Utiliza el estado inicial de las memorias de bloque (Block RAM) en FPGAs.

7.  **Evaluación de Rendimiento:** Se discuten métricas clave para evaluar la calidad de una PUF:
    *   **Unicidad (Uniqueness):** Mide cuán diferentes son las respuestas de PUFs implementadas en diferentes dispositivos. Se cuantifica con la distancia de Hamming inter-dispositivo idealmente cercana al 50%.
    *   **Fiabilidad (Reliability/Stability):** Mide la consistencia de las respuestas de una misma PUF bajo diferentes condiciones ambientales (temperatura, voltaje) o a lo largo del tiempo. Se cuantifica con la distancia de Hamming intra-dispositivo idealmente cercana al 0%.
    *   **Aleatoriedad (Randomness):** Mide cuán aleatorias son las respuestas generadas. Se evalúa con pruebas estadísticas como las de NIST.
    *   **Entropía (Entropy):** La cantidad de información impredecible en las respuestas.
    *   **Tasa de Error de Bits (BER):** Porcentaje de bits incorrectos en las respuestas.

8.  **Ataques y Contramedidas:**
    *   **Ataques de Modelado:** Un atacante intenta construir un modelo matemático de la PUF observando un conjunto

---

## Hardware Intrinsic Security from Physically Unclonable Functions.pdf

## Resumen Detallado del Artículo "Hardware Intrinsic Security from Physically Unclonable Functions"

El artículo "Hardware Intrinsic Security from Physically Unclonable Functions" de Helena Handschuh, Geert-Jan Schrijen y Pim Tuyls aborda la creciente preocupación por la falsificación de bienes, especialmente electrónicos, y el robo de propiedad intelectual. Propone una solución innovadora basada en la **seguridad intrínseca del hardware (Hardware Intrinsic Security)** mediante el uso de **Funciones Físicamente Inclonables (PUFs)** para generar identificadores secretos e inclonables, utilizándolos en conjunto con técnicas criptográficas para proteger la información crítica.

**1. Introducción y Problema Abordado:**

El documento comienza destacando el impacto negativo de la falsificación en la economía global, la sociedad y la seguridad de infraestructuras críticas. Identifica dos aspectos principales de la falsificación: la clonación de productos y la sobreproducción. Un caso particular y cada vez más peligroso es el robo de Propiedad Intelectual (IP) como software y diseños de hardware.

La solución tradicional de cifrado y autenticación se ve comprometida si la clave secreta puede ser copiada o extraída. Las técnicas actuales para almacenar claves secretas en dispositivos son vulnerables a ataques físicos (ej. microscopios de alta resolución, FIB, cortadores láser) que pueden visualizar y recuperar los bits de la clave. Esto ha llevado a una "carrera armamentista" entre fabricantes de ICs de seguridad y atacantes, donde los métodos tradicionales están alcanzando sus límites, aumentando costos y tiempos de comercialización.

El artículo argumenta que se necesita una tecnología de almacenamiento de claves secretas de bajo costo pero robusta para sistemas de seguridad asequibles, especialmente en smart cards, aplicaciones de defensa, sistemas de e-salud y pasaportes. Un sistema de seguridad es tan fuerte como su eslabón más débil, y el almacenamiento seguro de claves es una parte indispensable.

**2. Limitaciones de los Mecanismos Actuales de Almacenamiento de Claves:**

El documento realiza un análisis crítico de los mecanismos actuales de almacenamiento de claves, tanto volátiles como no volátiles, resaltando sus debilidades:

*   **Memoria ROM:**
    *   **Limitaciones:** Las claves se almacenan permanentemente y son extraíbles con herramientas de análisis de fallos. Son inflexibles (no se pueden cambiar una vez fabricadas) y el tiempo de producción es largo. Las claves ROM suelen ser claves maestras, lo que las hace objetivos atractivos para la ingeniería inversa.
*   **Mecanismos de Almacenamiento Basados en Fusibles (polyfuses, laser fuses, e-fuses, anti-fuses):**
    *   **Limitaciones:** Las claves son permanentes y detectables en el diseño (grandes). Fáciles de analizar con herramientas de fallo. Algunos tipos (anti-fusibles) requieren bombas de carga adicionales, aumentando el costo.
*   **Tecnologías de Puerta Flotante (Flash, EEPROM, EPROM):**
    *   **Limitaciones:** La información es permanente y extraíble con herramientas avanzadas de imagen y análisis de fallos. Vulnerables a ataques de fallos que intentan borrar o modificar valores. No son componentes estándar en todas las tecnologías de proceso y pueden causar retrasos en la comercialización. Requieren de 6 a 10 pasos de máscara adicionales, incrementando significativamente el costo.
*   **RAM con Batería de Respaldo (Battery-backed RAM):**
    *   **Limitaciones:** Requiere un componente adicional (batería), aumentando costo y espacio. Las baterías no siempre son fiables y la pérdida de energía implica la pérdida de la información, pudiendo inutilizar el dispositivo.

La principal limitación común a todos estos mecanismos es la **presencia permanente de la clave en el sistema, incluso cuando está apagado**, lo que los hace vulnerables a ataques persistentes.

**3. Un Nuevo Enfoque Radical para el Almacenamiento Seguro de Claves:**

El artículo propone un enfoque radicalmente nuevo para abordar las limitaciones de los mecanismos actuales, basado en tres criterios fundamentales:

1.  **La clave no debe almacenarse permanentemente en formato digital en el dispositivo.**
2.  **La clave debe extraerse del dispositivo solo cuando sea necesario.** Después de su uso, debe eliminarse de todos los registros internos y memorias para no dejar rastro al apagar el sistema.
3.  **La clave debe estar vinculada de forma única a un dispositivo dado, de modo que no pueda reproducirse ni fabricarse un dispositivo con una clave precisa.**

**4. Metodología Principal: Funciones Físicamente Inclonables (PUFs)**

Aunque el extracto proporcionado no profundiza en la definición y tipos de PUFs, el título y la introducción dejan claro que la solución propuesta son las PUFs. Las PUFs son funciones que, cuando se aplican a un dispositivo físico, producen una respuesta única y no predecible basada en las variaciones microscópicas de fabricación inherentes al propio dispositivo. Estas variaciones son aleatorias y no controlables, lo que hace que cada chip sea ligeramente diferente de otro, incluso si se fabrican en la misma línea de producción.

**5. Conceptos Clave Implicados:**

*   **Seguridad Intrínseca del Hardware:** Utilizar las propiedades físicas inherentes del hardware como base para la seguridad, en lugar de depender únicamente de software o almacenamiento de claves estáticas.
*   **Identificador Inclonable:** Una característica del dispositivo que no puede ser replicada o copiada con precisión, incluso por el fabricante original.
*   **Antifalsificación y Anticlonación:** Mecanismos para detectar y prevenir la creación de copias no autorizadas de productos o IP.
*   **Autenticación:** Proceso para verificar la legitimidad de un dispositivo o componente.

**6. Conclusiones y Propuesta de Valor:**

El artículo concluye que los mecanismos actuales de almacenamiento de claves son insuficientes frente a la sofisticación de los ataques físicos. Propone la seguridad intrínseca del hardware, basada en PUFs, como una solución superior que:

*   Evita el almacenamiento permanente de claves digitales.
*   Genera claves "bajo demanda" a partir de las propiedades físicas del chip.
*   Asegura que las claves sean únicas para cada dispositivo y virtualmente imposibles de clonar.
*   Permite construir sistemas de antifalsificación y anticlonación robustos al combinar PUFs con criptografía.

La capacidad de las PUFs para derivar claves secretas de las propiedades físicas intrínsecas de un chip ofrece una alternativa de bajo costo y alta seguridad a los métodos tradicionales, abordando el dilema de la seguridad y el costo en la fabricación de circuitos integrados. Esta tecnología es crucial para proteger la propiedad intelectual y garantizar la autenticidad de los dispositivos en un mundo donde la falsificación y el robo de IP son amenazas cre

---

## Modeling of physical unclonable functions PUF A systematic literature review.pdf

El documento "Modeling of physical unclonable functions (PUF): A systematic literature review" es una revisión sistemática exhaustiva que analiza las tendencias y el estado del arte en el modelado de Funciones Físicas Inclonables (PUF). El estudio abarca 254 artículos obtenidos a través de un riguroso proceso de búsqueda y cribado, desde 2013 hasta finales de 2024, un período en el que se ha publicado la mayor parte de la investigación en este campo.

**Puntos Clave:**

*   **Tecnología PUF:** Las PUF son tecnologías de huella dactilar de hardware que explotan variaciones de fabricación incontrolables para generar "huellas digitales" intrínsecas del hardware. Estas huellas actúan como secretos altamente sensibles a la manipulación física y se utilizan para la autenticación, la seguridad de la cadena de suministro, el establecimiento de raíces de confianza y operaciones criptográficas en dispositivos interconectados.
*   **Modelado de PUF:** El modelado de PUF se refiere a la capacidad de predecir o manipular estas huellas digitales secretas. Aunque en algunos casos el modelado puede ser beneficioso (por ejemplo, para compartir secretos PUF de forma ligera), generalmente representa una vulnerabilidad significativa que ha impulsado una "carrera armamentista" entre el diseño de PUF seguras y los algoritmos capaces de clonarlas.
*   **Alcance de la Revisión:** La revisión se centra en el modelado de PUF, abordando tanto las vulnerabilidades que introduce como las aplicaciones que habilita. Se clasifican los diseños y protocolos de PUF desde tres perspectivas: aplicación, operación y defensiva. De manera similar, se clasifican las técnicas de modelado basándose en los modelos de PUF definidos y los algoritmos de aprendizaje utilizados.

**Metodología Principal:**

1.  **Búsqueda Sistemática:** Se realizó una búsqueda en las bases de datos Web of Science y Scopus utilizando la siguiente cadena de palabras clave: `(("physical unclonable function(s)" OR "PUF(s)") AND ("model(l)ing" OR "attack(s)" OR "simulatable"))`. La búsqueda se limitó a artículos publicados entre 2013 y finales de 2024.
2.  **Filtrado y Selección:** Inicialmente, una búsqueda amplia arrojó demasiados resultados (más de 1700 por base de datos). Se refinó la búsqueda para que las palabras clave aparecieran solo en el título del documento, resultando en 269 y 263 resultados respectivamente.
3.  **Eliminación de Duplicados y Cribado:** Se combinaron los resultados (532 documentos), se eliminaron duplicados (quedando 367) y se realizó un cribado inicial por título y resumen por uno de los autores.
4.  **Cribado Detallado:** Se realizó un cribado más detallado para identificar artículos directamente relevantes para el modelado de PUF, resultando en los 254 documentos finales analizados.
5.  **Análisis y Clasificación:** Los documentos seleccionados fueron analizados para clasificar los diseños de PUF, los protocolos, las técnicas de modelado (algoritmos y modelos de amenaza), y las medidas defensivas.

**Resultados Más Importantes y Conclusiones:**

*   **Clasificación de PUF:** El estudio proporciona una extensa lista de diseños y protocolos de PUF, clasificados según sus características de seguridad, implementación y métricas de rendimiento.
*   **Técnicas de Modelado y Ataques:** Se identifican y clasifican las diversas técnicas de modelado (ataques) y las medidas defensivas propuestas en la literatura. Esto incluye un análisis de los intentos de modelado (exitosos y no exitosos) contra diferentes tipos de PUF, con y sin medidas defensivas.
*   **Vulnerabilidad vs. Habilitador:** Aunque la mayoría de los trabajos ven las técnicas de modelado como una vulnerabilidad, la revisión también resalta la perspectiva del modelado como un "habilitador" para el intercambio ligero de secretos PUF, donde un modelo puede representar un secreto PUF grande con un costo de memoria bajo.
*   **Tendencias y Brechas:** El estudio identifica tendencias claras y brechas en la investigación actual de PUF.
    *   **Armas de Ataque-Defensa:** Se observa una continua "carrera armamentista" entre el desarrollo de PUF más robustas y los algoritmos de modelado cada vez más sofisticados.
    *   **Enfoque en la Vulnerabilidad:** La mayoría de la investigación se centra en el modelado como una amenaza, lo que indica la necesidad de más investigación sobre las aplicaciones beneficiosas del modelado.
    *   **Necesidad de un Marco Unificado:** Existe una falta de un marco unificado para evaluar la seguridad de las PUF frente al modelado.
    *   **Diversidad de PUF y Modelos:** La gran diversidad de diseños de PUF y las técnicas de modelado utilizadas hacen que sea un campo complejo.
*   **Recomendaciones para el Futuro:** El documento ofrece recomendaciones para futuras direcciones de investigación, tanto en el diseño de sistemas PUF como en las técnicas de modelado, con el objetivo de guiar a investigadores y desarrolladores.

**En resumen,** este trabajo es una revisión sistemática crítica y exhaustiva que compila y analiza el panorama de la investigación sobre el modelado de PUF. Proporciona una base de conocimiento exhaustiva, identifica la evolución de las técnicas de modelado y los diseños de PUF, y destaca la dualidad del modelado como amenaza y como herramienta. Al hacerlo, el documento busca ofrecer una guía clara para la dirección futura de la investigación en seguridad de hardware basada en PUF.

---

## Physically Unclonable Functions - A Survey and Our Direction.pdf

## Resumen Detallado del Artículo: "Physically Unclonable Functions: A Survey and Our Direction"

Este documento, presentado en las "Proceedings of International Conference on Technology and Social Science 2024 (ICTSS 2024)", ofrece una revisión concisa de las Funciones Físicamente Inclonables (PUF) y presenta la dirección de investigación de los autores, enfocada en las PUF basadas en convertidores tiempo-a-digital (TDC PUF). El artículo aborda la creciente amenaza de productos falsificados en la industria de semiconductores y propone las PUF como una solución robusta y de bajo costo para la autenticación de dispositivos y la generación de claves criptográficas.

### 1. Introducción y Contexto

El documento comienza destacando el problema global de los productos falsificados, que no solo causan pérdidas financieras y daño a la imagen de marca, sino que también pueden comprometer la seguridad nacional y la vida de las personas. En la industria de semiconductores, la falsificación conduce a la fuga de información personal y de software, así como al hackeo de dispositivos. Las contramedidas convencionales, como el uso de IDs de autenticación únicos almacenados en memorias no volátiles (EEPROM, flash), son vulnerables a ataques de canal lateral y fáciles de replicar. Aunque las memorias resistentes a la manipulación ofrecen mayor seguridad, su costo es elevado.

Las PUF se presentan como una tecnología de hardware complementaria que utiliza las variaciones inherentes al proceso de fabricación de los dispositivos para generar identificadores únicos. Estas variaciones, como los tiempos de retardo de las señales eléctricas, las corrientes de fuga o el estado inicial de la memoria, son físicas e imposibles de replicar. Las PUF generan cadenas de bits específicas del dispositivo, conocidas como "huellas dactilares del dispositivo", que son reproducibles y reflejan la variabilidad intrínseca de fabricación.

### 2. Conceptos Básicos de PUF

El documento explica los fundamentos de las PUF:

*   **Modelo a Nivel de Sistema:** Una PUF se modela como un sistema de desafío-respuesta (challenge-response system) donde una entrada de desafío `c` produce una salida de respuesta `r`. La respuesta `r` no solo depende del desafío `c`, sino también de las variaciones de fabricación específicas del dispositivo.
*   **Generación de Respuesta Única:** Al aplicar un conjunto común de desafíos (`c1c2...cn`) a diferentes dispositivos con PUF, cada dispositivo generará una secuencia de respuestas (`r11r12...r1n`, `r21r22...r2n`, etc.) que será única para ese dispositivo debido a sus variaciones de fabricación inherentes.
*   **Clasificación: Strong PUF y Weak PUF:**
    *   **Strong PUF:** El número de pares desafío-respuesta (CRP) es exponencial con respecto al área del chip. Se utilizan principalmente para la autenticación de dispositivos y requieren un gran número de CRPs con una pequeña área de chip.
    *   **Weak PUF:** El número de CRPs es lineal con respecto al área del chip. Se utilizan principalmente para la protección de IP y la generación de claves privadas para cifrado. Requieren una mayor fiabilidad que las Strong PUF.

Ambos tipos de PUF requieren suficiente unicidad y reproducibilidad.

### 3. Clasificación de PUF Propuestas

El artículo realiza una breve revisión de los tipos de PUF más comunes propuestos en la literatura académica:

*   **PUF Basadas en Retardo (Delay-Based PUF):** Utilizan la variación en el tiempo de retardo de los circuitos de puerta.
    *   **Arbiter PUF:** Compara los tiempos de retardo de dos líneas de retardo idénticas para generar un bit de respuesta. Es una Strong PUF.
    *   **Ring Oscillator (RO) PUF:** Mide las variaciones en la frecuencia de oscilación de múltiples osciladores en anillo. Es una Weak PUF.
    *   **Loop PUF:** Una Strong PUF que utiliza ROs reconfigurables.
    *   **Ventaja:** Fácil implementación con celdas estándar.
    *   **Desventaja:** Vulnerabilidad a la degradación por envejecimiento.

*   **PUF Basadas en Memoria (Memory-Based PUF):** Aprovechan las variaciones en las características de las celdas de memoria. Generalmente son Weak PUF.
    *   **SRAM PUF:** Utiliza el estado inicial de las celdas SRAM al encenderse, que depende de las variaciones de fabricación.
    *   **DRAM PUF:** Utiliza variaciones en la capacitancia de las celdas DRAM, manifestadas, por ejemplo, en la tasa de decaimiento de la carga (Retention-based DRAM PUF).
    *   **PUF de Memoria No Volátil Emergente:** Utilizan variaciones en el valor de resistencia de celdas de memoria como MRAM (por ejemplo, STT MRAM PUF), ofreciendo alta seguridad y eficiencia, pero con menor fiabilidad.

*   **Otras PUF:**
    *   **PUF de Lógica de Convención Nula (NCL PUF):** Utiliza variaciones características de puertas lógicas en circuitos asíncronos.
    *   **Inverter/Amplifier Analog PUF:** Aprovecha las variaciones en el voltaje de umbral y el voltaje de conmutación de inversores y amplificadores.
    *   **Subthreshold Current PUF:** Utiliza la variación de la corriente subumbral de un dispositivo CMOS como fuente de entropía (Strong PUF).
    *   **RF-PUF:** Basadas en variaciones de características analógicas y de RF en transmisores inalámbricos.
    *   **ADC PUF:** Utilizan variaciones en el array de capacitores dentro de un conversor analógico-digital (CDAC). Las RF-PUF y ADC PUF se suelen usar para autenticación de dispositivos, por lo que su fiabilidad puede ser menor que la de las Weak PUF.

*   **FPGA PUF:** Son PUF implementadas en FPGAs para autenticación de dispositivos FPGA o generación de claves. Pueden ser configuraciones de RO PUF, Arbiter PUF, Loop PUF o Butterfly PUF (usando circuitos de enganche para crear bucles acoplados como celdas SRAM). Su clasificación como Strong o Weak PUF depende de la implementación específica.

### 4. Contribución y Dirección de Investigación de los Autores

Los autores presentan su línea de investigación centrada en las **PUF basadas en convertidores tiempo-a-digital (TDC PUF)**. Al igual que las ADC PUF, las TDC PUF aprovechan las variaciones de componentes existentes del circuito. En el caso de las TDC Flash, se utilizan las variaciones en el retardo de buffer de

---

## Strengthening Internet of Things Security Surveying Physical Unclonable Functions for Authentication, Communication Protocols, Challenges, and Applications.pdf

## Resumen Detallado del Artículo: "Strengthening Internet of Things Security: Surveying Physical Unclonable Functions for Authentication, Communication Protocols, Challenges, and Applications"

Este documento es una **revisión exhaustiva y una taxonomía** sobre las Funciones Físicas Inclonables (PUF, por sus siglas en inglés) aplicadas a la seguridad del Internet de las Cosas (IoT). Aborda la necesidad crítica de fortalecer la seguridad en el IoT frente al creciente número de ciberataques, especialmente los ataques de clonación. Los autores, Raed Ahmed Alhamarneh y Manmeet Mahinderjit Singh, realizan una revisión profunda de la literatura existente y proponen un nuevo modelo conceptual, PUF3S-ML, para la autenticación en IoT.

### 1. Puntos Clave y Temas Principales Cubiertos

El documento se centra en los siguientes puntos clave:

*   **Amenazas de seguridad en el IoT:** Destaca la proliferación de dispositivos IoT y las vulnerabilidades asociadas, con un énfasis particular en los ataques de clonación, suplantación de identidad e interceptación de datos.
*   **Introducción a las PUF:** Explica la naturaleza de las PUF como primitivas de seguridad de hardware que aprovechan las variaciones físicas microscópicas inherentes a los dispositivos para generar respuestas únicas e inclonables a desafíos específicos.
*   **Análisis de la autenticación basada en PUF:** Examina cómo las PUF pueden ser utilizadas para la autenticación de dispositivos y usuarios en entornos IoT.
*   **Protocolos de comunicación basados en PUF:** Revisa los diferentes protocolos que integran PUF para asegurar la comunicación en redes IoT.
*   **Desafíos en la investigación de PUF para IoT:** Identifica y discute once desafíos clave que enfrenta la comunidad investigadora en la implementación y uso de PUF en el IoT.
*   **Aplicaciones de las PUF en IoT:** Presenta diversas aplicaciones donde las PUF pueden mejorar la seguridad.
*   **Ataques de clonación:** Subraya la importancia de abordar los ataques de clonación, que permiten a los atacantes replicar dispositivos legítimos.
*   **Propuesta de un nuevo marco (PUF3S-ML):** Introduce un modelo conceptual para la autenticación de PUF en IoT, diseñado para mitigar ataques de clonación mediante técnicas de cifrado ligero y monitoreo inteligente.

### 2. Metodología Principal

La metodología del estudio se basa en una **revisión sistemática de la literatura**. Los autores realizaron una búsqueda exhaustiva de 125 artículos científicos relacionados con PUF y seguridad en IoT. De estos, identificaron 23 artículos directamente relevantes para su dominio de investigación y, dentro de este subconjunto, 11 estudios que abordaban específicamente la intersección de protocolos de comunicación con PUF.

La revisión se estructura para analizar la arquitectura de las PUF, sus implementaciones, los protocolos de comunicación asociados, los problemas abiertos y las soluciones propuestas, con un enfoque particular en los ataques de clonación.

### 3. Resultados Más Importantes y Tendencias Identificadas

La revisión destaca varias tendencias y hallazgos importantes:

*   **Crecimiento exponencial del IoT:** Se proyecta que el número de dispositivos IoT superará los 64 mil millones para 2025, lo que amplifica la superficie de ataque y la necesidad de soluciones de seguridad robustas.
*   **Insuficiencia de la criptografía tradicional:** Si bien el cifrado es fundamental, no es suficiente por sí solo para prevenir todos los ataques, especialmente aquellos que involucran la suplantación de identidad o la clonación de dispositivos.
*   **Ventajas de las PUF:** Las PUF ofrecen una solución prometedora para la autenticación de hardware debido a su naturaleza única e inclonable, su bajo costo y su resistencia a ataques físicos.
*   **Tipos de PUF:** El documento probablemente clasifica y discute diferentes tipos de PUF (ej., basadas en SRAM, latches, osciladores de anillo) y sus características.
*   **Desafíos en la implementación de PUF:** Los 11 desafíos identificados por el estudio (aunque no se detallan en el extracto, se mencionan como un resultado clave) probablemente incluyen la variabilidad de la respuesta, la estabilidad, la robustez frente a cambios ambientales, la facilidad de modelado (para ataques de aprendizaje automático), el diseño de protocolos eficientes y la integración en dispositivos de bajo consumo.
*   **Necesidad de autenticación multifacética:** Se subraya que la seguridad del IoT requiere no solo cifrado, sino también mecanismos de autenticación sólidos para usuarios y dispositivos.
*   **Ataques de clonación como amenaza crítica:** La capacidad de un atacante para clonar un dispositivo IoT legítimo representa una amenaza significativa, comprometiendo la integridad y la autenticidad de toda la red.

### 4. Modelo Propuesto: PUF3S-ML

El documento propone un **modelo conceptual innovador llamado PUF3S-ML** (que significa "PUF-based Security, Smart, and Sustainable with Machine Learning"). Este modelo está diseñado específicamente para la autenticación de PUF en el IoT y para salvaguardar las redes IoT inteligentes contra ataques de clonación.

**Arquitectura y Componentes Clave:**

El marco PUF3S-ML se compone de tres etapas de autenticación de PUF con dispositivos IoT y una unidad de monitoreo de ciberseguridad inteligente para redes IoT. Aunque el extracto no detalla exhaustivamente las tres etapas, sí menciona los beneficios clave y los componentes innovadores:

*   **Detección y Mitigación de Ataques de Clonación:**
    *   Emplea **algoritmos únicos** durante la fase de procesamiento de datos para identificar irregularidades que sugieran intentos de clonación (ej., ataques de repetición).
    *   Analiza pares Desafío-Respuesta (CRP) y paquetes de bits, utilizando parámetros específicos (como C y R) para detectar desviaciones del comportamiento normal.
    *   Introduce un **algoritmo de cifrado ligero Cipher PRESENT** para asegurar la comunicación y el intercambio de datos, proporcionando una capa adicional de protección contra la clonación.
*   **Utilización Eficiente de Recursos:** El modelo busca un equilibrio óptimo entre rendimiento y consumo de recursos, esencial para los dispositivos IoT restringidos.
*   **Fiabilidad y Resiliencia:**
    *   Incorpora una **unidad especializada de mecanismos de monitoreo vigilante** que examina los comportamientos y patrones de la red.
    *   Genera alertas ante cualquier desviación de la norma, permitiendo respuestas proactivas a amenazas potenciales.
    *   Implementa estrategias para una **rápida restauración del sistema** después de un ataque o fallo, asegurando la continuidad operativa.
*   **Cifrado Ligero para Comunicación Segura (Algoritmo PRESENT):**
    *   Utiliza el **algoritmo PRESENT**, un cif

---

## Study of different silicon Physical Unclonable Functions.pdf

El documento PDF "Study of different silicon Physical Unclonable Functions.pdf" presenta un estudio detallado y una propuesta de diseño para Funciones Físicas Inclonables (PUF) basadas en silicio. El artículo fue revisado por pares y aceptado para ser presentado en la conferencia IEEE WiSPNET 2016.

**Análisis General y Temas Clave:**

Este documento es una revisión exhaustiva de diferentes tipos de PUF de silicio, junto con la propuesta de un nuevo diseño de PUF basado en retardo. Aborda las crecientes preocupaciones sobre la seguridad de los circuitos integrados (CI), como la falsificación, la ingeniería inversa y la manipulación, y posiciona las PUF como una solución prometedora.

Los temas principales cubiertos incluyen:
1.  **Introducción a las PUF:** Definición, concepto de par desafío-respuesta (CRP), propiedades clave (fiabilidad, uniformidad, unicidad) y su cálculo.
2.  **Ventajas y Aplicaciones de las PUF:** Generación de firmas únicas y volátiles, eliminación de la necesidad de memoria no volátil costosa, protección contra ataques, y aplicaciones en identificación de sistemas, generación de claves secretas, generación de números aleatorios y criptografía.
3.  **Objetivos de Diseño de las PUF:** Minimización del área, consumo de energía dinámica y tiempo de evaluación.
4.  **Clasificación y Revisión de PUF Existentes:** Se clasifican las PUF en fuertes y débiles, y basadas en silicio y no silicio. El enfoque principal del documento es en las PUF de silicio, que se subdividen en PUF basadas en electrónica analógica, basadas en memoria y basadas en retardo.
5.  **Propuesta de un Nuevo Diseño de PUF Basado en Retardo:** Aunque el contenido proporcionado se trunca antes de la descripción completa de la propuesta, el resumen indica que se propone un nuevo diseño de PUF basado en retardo.

**Metodología Principal (Revisión de PUF de Silicio):**

El documento realiza una revisión sistemática de las PUF de silicio existentes, categorizándolas y describiendo sus principios de funcionamiento, ventajas y desventajas.

*   **PUF Electrónicas Analógicas:**
    *   **ICID (Identificación de CI):** Utiliza variaciones en las corrientes de drenaje de los transistores. Se considera una PUF débil con un número limitado de CRPs, vulnerable a ataques de lectura exhaustiva.
    *   **PUF de Recubrimiento:** Emplea recubrimientos protectores opacos y químicamente neutros. El desafío es un voltaje con frecuencia y amplitud específicas, y la respuesta es la capacitancia medida.
    *   **Silicio Nanokey:** Explota la varianza de los parámetros eléctricos de transistores MOS de pequeño tamaño, especialmente el voltaje de umbral (Vt).
    *   **LC-PUF:** Consiste en un circuito pasivo LC donde las variaciones de fabricación causan ligeras diferencias en la frecuencia de resonancia pico.
    *   **PUF de Red de Alimentación:** Aprovecha las fluctuaciones de resistencia en la red de alimentación de un chip debido a variaciones aleatorias del proceso de fabricación, afectando las caídas de voltaje.

*   **PUF Basadas en Memoria:**
    *   **SRAM PUF:** Se basa en la asimetría intrínseca de las celdas SRAM (dos inversores acoplados transversalmente) que las hace arrancar en un estado preferido (0 o 1) debido a las variaciones del proceso. Tiene una alta tasa de error y baja fiabilidad si el diseño es demasiado simétrico o sensible a condiciones ambientales.
    *   **Butterfly PUF:** Una versión modificada de la SRAM PUF que utiliza un latch o flip-flop inestable en lugar de inversores. Aprovecha los D-Flip flops comunes en FPGAs, pero requiere un enrutamiento cuidadoso.
    *   **MECCA PUF:** Propuesta para superar la vulnerabilidad de lectura exhaustiva de la SRAM PUF. Utiliza la duración del pulso de escritura como desafío y las fallas de escritura en las celdas de memoria para generar la respuesta. Adecuada solo para memorias embebidas con estructuras específicas.

**Resultados y Conclusiones (hasta el contenido proporcionado):**

El documento establece que las PUF ofrecen una solución eficaz y económica para la autenticación y la seguridad de los CI, abordando amenazas como la falsificación y la ingeniería inversa. Se destaca la importancia de las propiedades de fiabilidad, uniformidad y unicidad para el rendimiento de las PUF.

La revisión de las PUF de silicio existentes muestra una diversidad de enfoques, cada uno con sus propias ventajas y limitaciones:
*   Las **PUF electrónicas analógicas** a menudo tienen un número limitado de CRPs (como ICID), lo que las hace vulnerables a ataques de lectura exhaustiva.
*   Las **PUF basadas en memoria**, como la SRAM PUF, son convenientes para FPGAs pero pueden sufrir de alta tasa de error y baja fiabilidad bajo ciertas condiciones o ser vulnerables a ataques (como la lectura exhaustiva en SRAM PUF estándar). Las variantes como Butterfly PUF y MECCA PUF intentan mitigar estas debilidades.

La conclusión implícita de la revisión es que, si bien existen varias PUF de silicio, hay margen para mejoras en términos de seguridad, fiabilidad y eficiencia. La propuesta de un "nuevo diseño de PUF basado en retardo" sugiere que el documento busca contribuir a este campo ofreciendo una alternativa que podría superar algunas de las limitaciones de los diseños existentes, posiblemente centrándose en las propiedades de retardo de las rutas lógicas o elementos de retardo debido a las variaciones del proceso.

**En resumen, el documento es una importante contribución al campo de la seguridad de hardware, proporcionando una visión general de las PUF de silicio y proponiendo un nuevo diseño para abordar los desafíos existentes en este ámbito.**

---

## Survey on Hardware Security - PUFs, Trojans, and Side-Channel Attacks.pdf

El documento "Survey on Hardware Security: PUFs, Trojans, and Side-Channel Attacks" es una revisión exhaustiva sobre la seguridad de hardware, centrándose en tres áreas críticas: Funciones Físicamente Inclonables (PUFs), troyanos de hardware (HTs) y ataques de canal lateral (SCAs). La publicación, con fecha de enero de 2025, destaca la creciente vulnerabilidad de los sistemas de hardware en sectores críticos como la salud, defensa, automoción y finanzas, y propone un análisis de los avances en mecanismos de seguridad robustos.

**Puntos Clave y Tendencias Identificadas:**

El estudio subraya la necesidad de abordar las vulnerabilidades en hardware debido a la proliferación de dispositivos IoT y la complejidad de las cadenas de suministro globales. Los autores identifican tres desafíos principales:

1.  **Troyanos de Hardware (HTs):** Modificaciones maliciosas en el diseño o fabricación de circuitos integrados (IC) que pueden comprometer la funcionalidad o extraer información sensible. Se mencionan métodos de detección avanzados como pruebas lógicas y análisis de canal lateral, que requieren mayor refinamiento.
2.  **Ataques de Canal Lateral (SCAs):** Explotación de fugas de información no intencionadas (como consumo de energía o emisiones electromagnéticas) para inferir datos críticos, como claves criptográficas. Las contramedidas incluyen enmascaramiento, inyección de ruido y optimizaciones algorítmicas, con el desafío de equilibrar seguridad y rendimiento.
3.  **Clonación y Falsificación de ICs:** Replicación de dispositivos seguros que socava las medidas anti-falsificación, especialmente problemático en dispositivos IoT con recursos limitados.

El documento se enfoca en tres dominios interrelacionados para abordar estos desafíos:

*   **Funciones Físicamente Inclonables (PUFs):** Aprovechan las variaciones intrínsecas de fabricación para generar identificadores únicos para autenticación y generación de claves criptográficas. Se destacan innovaciones como las arquitecturas PUF dinámicas e híbridas para mejorar la seguridad y fiabilidad bajo diversas condiciones ambientales.
*   **Detección y Mitigación de Troyanos de Hardware:** Técnicas modernas que integran ingeniería inversa, análisis de canal lateral y aprendizaje automático para detectar y neutralizar HTs, con la mejora de la precisión mediante protocolos criptográficos híbridos.
*   **Defensas contra Ataques de Canal Lateral:** Métodos criptográficos ligeros, como el enmascaramiento y la escalada dinámica de voltaje, para contrarrestar SCAs en entornos con recursos limitados.

**Metodología Principal y Propuesta Novedosa:**

La metodología del estudio se basa en una revisión exhaustiva de la literatura reciente en seguridad de hardware. Los autores proponen un **modelo PUF híbrido impulsado por IA** para abordar la variabilidad ambiental, los ataques de modelado basados en aprendizaje automático y los desafíos de escalabilidad.

**Resultados y Conclusiones Importantes:**

El estudio sintetiza los avances en seguridad de hardware, destacando:

*   **Evolución de las PUFs:** Se discuten diseños basados en SRAM, Arbiter, XOR y memristores, así como diseños híbridos y ópticos que mejoran la robustez contra la variabilidad y los ataques.
    *   **PUFs SRAM:** Utilizan estados aleatorios de encendido de las celdas SRAM. Ventajas: integración sencilla, bajo overhead. Desafíos: sensibilidad ambiental, vulnerabilidad a la clonación.
    *   **PUFs Arbiter y XOR:** Miden diferencias de retardo en rutas de señal. Ventajas: escalabilidad, resistencia mejorada a ataques ML. Desafíos: mayor complejidad, menor fiabilidad por ruido.
    *   **PUFs basadas en Memristores:** Aprovechan el comportamiento de conmutación estocástico de los memristores. Ventajas: ocultación dinámica, diseño compacto. Desafíos: fabricación compleja, sensibilidad ambiental.
*   **Integración de IA:** El aprendizaje automático se presenta como una herramienta clave para la detección de HTs y la mitigación de SCAs.
*   **Arquitecturas Resilientes a la Cuántica:** Preparación del hardware para las amenazas de la era cuántica.
*   **Eficiencia Energética:** Soluciones que equilibran la seguridad y las limitaciones de recursos para dispositivos IoT y de borde.

Se describe un **Protocolo Avanzado de PUF (APP)** como un avance fundamental para la seguridad basada en PUFs. Sus características clave incluyen:
*   **Transformaciones Dinámicas:** Los desafíos se modifican dinámicamente para aumentar la imprevisibilidad de la respuesta.
*   **Autenticación Mutua:** Ambas partes verifican la autenticidad del otro.
*   **Diseño Libre de Criptografía:** Logra seguridad robusta sin primitivas criptográficas computacionalmente intensivas, ideal para IoT.
*   **Tolerancia a Errores:** Mecanismos para manejar variaciones naturales en las respuestas PUF.

La integración de APP en sistemas de hardware resalta el potencial de las PUFs como soluciones de seguridad ligeras pero robustas. Además, se mencionan avances en protocolos basados en blockchain mejorados con PUFs para verificación de transacciones descentralizadas, y la promesa de protocolos que integran criptografía cuántica-resiliente con PUFs para la seguridad futura.

**Conclusiones Generales:**

El estudio ofrece una hoja de ruta para asegurar los sistemas de hardware modernos. Los hallazgos son especialmente relevantes para industrias donde la confianza, la integridad de los datos y la resiliencia operativa son primordiales. Las futuras direcciones incluyen arquitecturas cuánticas-resilientes, implementaciones energéticamente eficientes y marcos regulatorios escalables para enfrentar las amenazas en evolución. El documento, al ser una revisión, no presenta una arquitectura o implementación específica propia, sino que analiza y propone la dirección de la investigación y desarrollo en el campo.

---
