MarinGE23/axi-plpuf-ip/docu/PUFs_PLPUFs/05_ML_Attacks_Security/resumen_05_ML_Attacks_Security.md

# Resumen de la Carpeta: 05_ML_Attacks_Security

Esta sección presenta un análisis detallado de los documentos PDF contenidos en la carpeta `05_ML_Attacks_Security`, enfocándose en los aspectos clave de cada publicación.

---

## A Lightweight PUF With Immunity to Machine Learning AtacksBased on a Weak-PUF-Assisted Reconfigurable LFSR and TemporalFeedback.pdf

El documento "A Lightweight PUF With Immunity to Machine Learning Atacks Based on a Weak-PUF-Assisted Reconfigurable LFSR and Temporal Feedback" aborda una problemática crítica en la seguridad de hardware para dispositivos IoT: la vulnerabilidad de las Strong Physical Unclonable Functions (PUFs) a los ataques de modelado basados en Machine Learning (ML). Los autores proponen una nueva arquitectura de Strong PUF que transforma el mapeo desafío-respuesta de una función estáticamente aproximable a una Función Pseudoaleatoria con Clave (Keyed-PRF) matemáticamente rigurosa, logrando inmunidad contra estos ataques.

**Problema Abordado:**
Las Strong PUFs tradicionales, a pesar de su gran espacio de Pares Desafío-Respuesta (CRP), son susceptibles a ataques de modelado ML. Esto se debe a que la relación entre desafíos y respuestas a menudo exhibe una naturaleza aditiva lineal o una estructura matemática predecible, lo que permite a los atacantes entrenar modelos ML con un subconjunto de CRPs para predecir respuestas futuras con alta precisión, logrando una "clonación matemática" del dispositivo. Las soluciones previas, como las PUFs XOR o IPUF, que se basan en la simple adición de no linealidad o lógica de ofuscación, aumentan el consumo de hardware y energía, y siguen siendo vulnerables a ataques ML avanzados. La raíz del problema es que la complejidad de ingeniería no cambia las propiedades matemáticas inherentes de las PUFs, que a menudo exhiben baja sensibilidad promedio y sensibilidad al ruido, facilitando el modelado.

**Metodología y Arquitectura Propuesta:**
La propuesta principal es un cambio de paradigma: en lugar de solo ofuscación estructural, la PUF debe incorporar una clave secreta para elevar el mapeo físico a una Keyed-PRF. Esto hace que la seguridad dependa de la dureza criptográfica de distinguir una función pseudoaleatoria de un oráculo aleatorio, haciendo ineficaces las estrategias de aprendizaje basadas en gradientes.

La arquitectura propuesta, diseñada para ser ligera y resistente a ML, se basa en dos innovaciones principales:

1.  **Mecanismo de Configuración Basado en Esponja (SCM - Sponge-Based Configuration Mechanism):**
    *   Utiliza Weak PUFs confiables (como SRAM o Butterfly PUFs) para configurar dinámicamente el polinomio de retroalimentación de un Registro de Desplazamiento de Retroalimentación Lineal (LFSR).
    *   Esto crea una clave secreta específica del dispositivo en tiempo real, derivada de las variaciones de proceso intrínsecas.
    *   La clave es generada "on-demand" y se utiliza para configurar el LFSR.

2.  **Mecanismo de Evolución de Estado Modulado por Respuesta (RM-SEM - Response-Modulated State Evolution Mechanism):**
    *   Las respuestas físicas instantáneas de una Arbiter PUF subyacente determinan el tamaño del paso de evolución del LFSR.
    *   Esto introduce un bucle de retroalimentación temporal profundo, transformando el sistema en un Modelo Oculto de Markov (HMM).
    *   La naturaleza HMM bloquea las estrategias de aprendizaje basadas en gradientes al dificultar la obtención de información de gradiente válida para el optimizador.

Adicionalmente, se introduce una **estrategia de cribado de fiabilidad** basada en un umbral estricto de tasa de error de bits para asegurar la estabilidad del sistema.

**Resultados Clave:**
Los experimentos se realizaron en FPGAs Xilinx Artix-7, y los resultados demuestran la efectividad de la propuesta:

*   **Resistencia a Ataques ML:** La PUF propuesta mantiene una precisión de predicción de aproximadamente el 50% (equivalente a un lanzamiento de moneda aleatorio) frente a cuatro ataques de modelado ML principales, incluso cuando se entrenan con 1 millón de Pares Desafío-Respuesta (CRPs). Esto indica una fuerte inmunidad a los ataques de modelado.
*   **Propiedades de Seguridad:** El diseño exhibe excelentes propiedades de uniformidad, unicidad y fiabilidad.
*   **Eficiencia de Hardware:** Logra estas propiedades de seguridad con una sobrecarga de hardware mínima, lo que la hace adecuada para dispositivos IoT con recursos limitados.

**Conclusiones:**
El documento concluye que la nueva arquitectura de Strong PUF, que combina un LFSR reconfigurable asistido por Weak PUF y una retroalimentación temporal, ofrece una solución robusta y ligera para la autenticación en IoT. Al transformar el mapeo desafío-respuesta en una Keyed-PRF y al introducir un bucle de retroalimentación temporal que crea un HMM, la PUF propuesta logra una inmunidad significativa contra los ataques de modelado basados en Machine Learning, un desafío persistente para las PUFs Strong tradicionales. La capacidad de mantener una precisión de predicción cercana al 50% frente a ataques sofisticados, junto con un bajo overhead de hardware, valida su potencial para establecer una Root of Trust segura en el Internet de las Cosas.

---

## A lightweight general PUF framework for resisting machine learning attacks.pdf

El documento "A lightweight general PUF framework for resisting machine learning attacks" propone un marco de trabajo ligero y general para funciones físicamente inclonables (PUF) que resiste eficazmente los ataques de aprendizaje automático. El artículo aborda la vulnerabilidad de las PUF clásicas a estos ataques y el consumo excesivo de recursos de las soluciones existentes.

**Puntos Clave y Metodología Principal:**

1.  **Vulnerabilidad de las PUF y Limitaciones de Soluciones Actuales:** Las PUF son primitivas de seguridad de bajo costo que aprovechan las variaciones físicas durante la fabricación. Se dividen en PUF débiles (pocos pares desafío-respuesta, CRPs) y PUF fuertes (gran número de CRPs). Las PUF fuertes, como las Arbiter PUF (APUF), son particularmente vulnerables a ataques de aprendizaje automático (ML) debido a la correlación espacial entre los CRPs y la capacidad de los atacantes para construir modelos predictivos. Las defensas existentes, como estructuras no lineales, ofuscación de la relación desafío-respuesta y protección criptográfica, a menudo conllevan un alto consumo de recursos, lo que las hace inadecuadas para dispositivos con recursos limitados.

2.  **Marco de Trabajo Propuesto:** El artículo introduce un marco de trabajo que combina una **estructura no lineal** con la **ofuscación de desafíos** para mejorar la resistencia a los ataques de ML con un bajo consumo de recursos.
    *   **Procesamiento por Segmentos (Estructura No Lineal):** El marco emplea un procesamiento por segmentos que introduce no linealidades estructurales para la autoprotección. Esto se logra mediante una configuración multi-etapa de PUFs y multiplexores (MUX). Una PUF actúa como etapa frontal, su respuesta controla la selección de una de las PUF de la siguiente etapa a través de un MUX. Esta selección dinámica genera una no linealidad en la relación desafío-respuesta.
    *   **Ofuscación de Desafíos (Unidad CXOR):** Para la ofuscación de desafíos, se diseña una unidad de ofuscación llamada **CXOR (Challenge XOR)**. Esta unidad utiliza compuertas XOR para transformar de manera única el desafío de la etapa frontal, la respuesta de la etapa frontal y el desafío de la siguiente etapa. Esto dificulta enormemente la extracción de CRPs auténticos por parte de un adversario, ya que la relación entre los desafíos originales y las respuestas finales se vuelve más compleja y menos predecible.

3.  **PUF de Oscilador de Anillo Basada en MUX (MRO):** Para las PUF de oscilador de anillo configurables (CRO-PUF), se propone una nueva estructura llamada **MRO (MUX-based RO)**. Esta MRO está diseñada para ahorrar recursos, logrando una reducción del 50% en comparación con implementaciones anteriores.

4.  **Implementación y Evaluación:**
    *   El marco propuesto es flexible y escalable, permitiendo configuraciones de dos, tres o más etapas según los requisitos del diseñador.
    *   Se implementan y evalúan seis estructuras diferentes de PUF fuertes dentro del marco propuesto: MRO-MRO, APUF-MRO, APUF-APUF, APUF-MPUF, MPUF-MPUF y 3-APUF.
    *   Se realizan pruebas de resistencia a ataques de aprendizaje automático utilizando algoritmos como Regresión Logística (LR), Estrategia de Evolución de Matriz de Covarianza Adaptativa (CMA-ES) y Redes Neuronales Artificiales (ANN).

**Resultados Más Importantes:**

*   **Resistencia a Ataques ML:** Las pruebas demuestran que las seis configuraciones de PUF implementadas dentro del marco alcanzan tasas de predicción cercanas al 50% bajo los ataques LR, CMA-ES y ANN. Una tasa de predicción del 50% indica que el modelo de aprendizaje automático no puede predecir las respuestas de la PUF mejor que un lanzamiento de moneda aleatorio, lo que significa una fuerte resistencia al ataque.
*   **Ahorro de Recursos:** La MRO propuesta reduce el consumo de recursos en un 50% en comparación con trabajos anteriores. El diseño general del marco, con su estructura simple y la unidad CXOR basada en XOR, contribuye a un bajo consumo de hardware.
*   **Métricas de Calidad de PUF:** Para una instancia de dos segmentos MRO-MRO basada en el marco, la uniformidad, unicidad y fiabilidad son cercanas a los valores ideales. Específicamente, se prueban en Xilinx Virtex-7 y Xilinx Spartan-6, mostrando un rendimiento robusto.
*   **Generalización:** El marco demuestra ser generalizable, mejorando la resistencia a ML para diferentes tipos de PUF fuertes (APUF, MRO, MPUF).

**Conclusiones:**

El documento concluye que el marco de trabajo propuesto es una solución eficaz y eficiente para mejorar la resistencia de las PUF a los ataques de aprendizaje automático. Sus principales ventajas son:

*   **Escalabilidad:** El marco puede ser configurado en múltiples etapas según las necesidades de diseño.
*   **Bajo Consumo de Recursos:** Gracias a la MRO y la unidad CXOR ligera, el consumo de hardware es significativamente reducido.
*   **Fuerte Resistencia a Ataques ML:** Las no linealidades introducidas por el procesamiento por segmentos y la ofuscación de desafíos a través de la unidad CXOR hacen que los modelos de aprendizaje automático sean ineficaces para predecir las respuestas de la PUF.
*   **Alto Rendimiento de PUF:** Las implementaciones demuestran una excelente uniformidad, unicidad y fiabilidad, métricas cruciales para la calidad de una PUF.

En resumen, el trabajo presenta una contribución significativa al campo de la seguridad de hardware al ofrecer una arquitectura PUF robusta, ligera y resistente a los ataques de modelado, adecuada para dispositivos con recursos limitados.

---

## A temperature-invariant and ML-resilient, RO PUF design with improved security and performance metrics.pdf

El documento "A temperature-invariant and ML-resilient, RO PUF design with improved security and performance metrics" presenta un diseño novedoso de Función Físicamente Inclonable (PUF) basada en Oscilador de Anillo (RO) que aborda las limitaciones críticas de los diseños convencionales, como la sensibilidad a la temperatura, el consumo de energía y la vulnerabilidad a ataques de aprendizaje automático (ML). El trabajo fue realizado por Nitish Kumar, Aditya Antil, Himanshu Kesarwani, Dhirendra Kumar, Kavindra Kandpal y Manish Goswami, de instituciones como el Indian Institute of Information Technology, Allahabad, y GLA University, Mathura.

**1. Introducción y Problemas Abordados:**

Las PUF son esenciales para la autenticación y generación segura de claves, explotando las variaciones intrínsecas del proceso de fabricación de semiconductores para crear identificadores únicos. Las PUF de RO son populares por su simplicidad y compatibilidad CMOS, pero sufren de:
*   **Sensibilidad ambiental:** Especialmente a las variaciones de temperatura, que degradan la fiabilidad.
*   **Vulnerabilidad a ataques ML:** Las linealidades en los patrones de frecuencia permiten a los atacantes predecir respuestas con alta precisión usando un número limitado de pares desafío-respuesta.
*   **Alto consumo de energía:** La oscilación continua de múltiples RO consume mucha energía, lo que es problemático para dispositivos de baja potencia y aumenta el riesgo de ataques de canal lateral.

El artículo propone un diseño de PUF de RO que busca mejorar la seguridad y el rendimiento, centrándose en la invarianza a la temperatura, la resistencia a ataques ML y la eficiencia energética.

**2. Metodología Principal y Arquitectura Propuesta:**

La arquitectura propuesta integra varias innovaciones clave:

*   **Osciladores de Anillo con Inversores de Corriente Limitada (CSI):** En lugar de inversores push-pull convencionales, se utilizan CSI en los RO. Esto permite un control preciso sobre el flujo de corriente, reduciendo el consumo de energía dinámico y amplificando la sensibilidad al retardo de las variaciones del proceso. Al polarizar los transistores limitadores de corriente en el punto de Coeficiente de Temperatura Cero (ZTC), se logra una mayor estabilidad térmica, mitigando los cambios de frecuencia inducidos por la temperatura.
*   **Circuito Metaestable:** Se incorpora un circuito metaestable para aleatorizar aún más la respuesta de la PUF, mejorando la impredecibilidad.
*   **Registro de Desplazamiento de Retroalimentación Lineal (LFSR):** Un LFSR de 4 bits genera desafíos internos que se utilizan para seleccionar dinámicamente uno de los 16 RO. Esta generación interna de desafíos dificulta los ataques de modelado al ofuscar el mapeo directo entre los desafíos de entrada y las respuestas de salida.
*   **Contador Único Bidireccional de Subida/Bajada:** A diferencia de los diseños convencionales que usan dos contadores y un comparador, la propuesta utiliza un solo contador bidireccional. Este contador incrementa o decrementa basado en los recuentos de transición de los RO seleccionados consecutivamente, reduciendo el overhead de hardware y el consumo de energía.
*   **Bloque de Lógica Combinacional:** La salida del contador se procesa a través de un bloque de lógica combinacional (compuesto por puertas NOR, NAND y AND) para generar un valor binario intermedio antes de pasar por el circuito metaestable.

**3. Resultados Clave y Mejoras:**

El diseño propuesto demuestra mejoras significativas en varias métricas:

*   **Fiabilidad:** La fiabilidad aumenta del 91.06% al 98.96%, indicando una robustez mejorada contra las variaciones ambientales.
*   **Métricas de PUF:**
    *   Unicidad: 49.24%
    *   Uniformidad: 50.27%
    *   Alias de bits: 49.87%
    Estos valores cercanos al 50% son ideales para características de PUF.
*   **Invarianza a la Temperatura:** El diseño opera de manera consistente en un amplio rango de temperatura (–40 °C a 120 °C) gracias a la estrategia ZTC de los inversores CSI.
*   **Eficiencia Energética:** El consumo de energía se reduce aproximadamente 2.14 veces en comparación con una PUF de RO convencional.
*   **Retraso:** Las simulaciones pre-layout y post-layout reportan retrasos de 1.11 ns y 2.3 ns, respectivamente.
*   **Aleatoriedad:** Las pruebas NIST confirman la aleatoriedad de las respuestas generadas.
*   **Resistencia a Ataques ML:** El diseño resiste ataques de modelado basados en ML, limitando la precisión de predicción entre el 45% y el 65%. Este rango bajo indica una fuerte resistencia, ya que una precisión cercana al 50% significa que el modelo no puede hacer predicciones significativamente mejores que el azar.
*   **Implementación en FPGA:** La implementación en una FPGA Basys-3 Artix-7 utilizando Vivado requiere un hardware mínimo y logra una tasa de generación de bits de 80 Mb/s.

**4. Comparación con Diseños Convencionales:**

El artículo compara el diseño propuesto con el diseño de PUF de RO convencional. Los diseños convencionales utilizan un array de RO con inversores push-pull, dos contadores y un comparador. Este enfoque es sensible a la temperatura y vulnerable a ataques ML. El diseño propuesto supera estas limitaciones mediante la integración de CSI, LFSR, un solo contador bidireccional y un circuito metaestable, lo que resulta en un menor consumo de energía, menor área de chip y mayor seguridad.

**5. Conclusiones:**

El documento concluye que el diseño propuesto de PUF de RO representa un avance significativo en la seguridad de hardware. Al abordar los desafíos críticos de la sensibilidad a la temperatura, el consumo de energía y la vulnerabilidad a los ataques de aprendizaje automático, el diseño ofrece una solución robusta y eficiente para la autenticación digital segura. La combinación de inversores CSI polarizados en ZTC, la aleatorización por LFSR y un circuito metaestable, junto con una arquitectura de contador simplificada, no solo mejora las métricas de rendimiento (fiabilidad, unicidad, uniformidad) sino que también fortalece la resistencia a los ataques de modelado, haciendo que sea una opción prometedora para futuras aplicaciones de seguridad.

---

## Authentication scheme resistant to machine learning based on obfuscation of multiple PUF responses.pdf

El documento "Authentication scheme resistant to machine learning based on obfuscation of multiple PUF responses" propone una nueva arquitectura de Función Físicamente Inclonable (PUF) llamada **multi-Arbiter-PUF obfuscation PUF (MAO PUF)** para mejorar la resistencia de los protocolos de autenticación basados en PUF contra ataques de modelado basados en aprendizaje automático (ML). La investigación aborda la vulnerabilidad de las PUF tradicionales, especialmente en el contexto de la Internet de las Cosas (IoT), donde los dispositivos a menudo carecen de los recursos para mecanismos de seguridad convencionales robustos.

**Puntos Clave y Metodología Principal:**

1.  **Vulnerabilidad de PUFs Tradicionales:** Los protocolos de autenticación basados en PUF fuertes, a pesar de sus ventajas, son susceptibles a ataques de modelado ML que intentan predecir las respuestas de la PUF.
2.  **Arquitectura (n,k)-MAO PUF:**
    *   La propuesta central es la arquitectura (n,k)-MAO PUF, que integra **n Arbiter PUFs (APUFs)** con un **Registro de Desplazamiento con Retroalimentación Lineal (LFSR) de k etapas**.
    *   La innovación radica en usar las respuestas de las APUFs para **ofuscar los parámetros de configuración del LFSR**. Específicamente, las respuestas de `k` APUFs se utilizan como **semilla inicial** para el LFSR, mientras que las respuestas de las `n-k` APUFs restantes se emplean como **coeficientes de retroalimentación** para el proceso de ciclado del LFSR.
    *   Para lograr una ofuscación exhaustiva, la respuesta final se lee en el recuento máximo de ciclos del LFSR, `T = 2^k - 1`.
    *   Esta ofuscación dinámica de los parámetros del LFSR con las respuestas de múltiples APUFs dificulta significativamente que los modelos de ML aprendan la relación desafío-respuesta subyacente.
3.  **Protocolo de Autenticación Propuesto:** Basado en la estructura (n,k)-MAO PUF, el documento también presenta un **protocolo de autenticación altamente seguro** diseñado específicamente para sistemas IoT.
4.  **Mecanismo de Detección de CRPs Confiables:** Se introduce un mecanismo de detección (screening) de Pares Desafío-Respuesta (CRPs) para mejorar la fiabilidad de la PUF en la autenticación y reducir la tasa de error de juicio, utilizando solo CRPs confiables.
5.  **Implementación y Evaluación:** La arquitectura (n,k)-MAO PUF fue implementada en una plataforma **Xilinx Virtex-7 FPGA** para su evaluación.

**Resultados Más Importantes:**

1.  **Rendimiento Óptimo de (5,3)-MAO PUF:** Los experimentos demostraron que la configuración **(5,3)-MAO PUF** (cinco APUFs ofuscando una LFSR de 3 etapas) logra un equilibrio óptimo entre el consumo de recursos y las métricas de rendimiento. En esta configuración, las respuestas de cinco APUFs ofuscan tanto la semilla inicial como los coeficientes de retroalimentación de una LFSR de tres etapas.
2.  **Resistencia a Ataques ML:**
    *   La (5,3)-MAO PUF redujo la **precisión de predicción** de tres ataques de aprendizaje automático principales (CMA-ES, regresión logística (LR) y redes neuronales artificiales (ANN)) a **casi el 50%**. Una precisión del 50% indica que el modelo de ML no puede hacer predicciones mejor que una suposición aleatoria, lo que demuestra una fuerte resistencia.
3.  **Características Estadísticas Cercanas a las Ideales:** La (5,3)-MAO PUF mantuvo características estadísticas cercanas a los valores ideales:
    *   Una tasa de **uniformidad del 50.9%**, indicando una distribución equitativa de 0s y 1s en las respuestas.
    *   Una tasa de **unicidad del 49.90%**, lo que sugiere una alta diferenciación entre las respuestas de diferentes PUFs.
4.  **Bajo Costo de Área:** La arquitectura propuesta logra una mejora en la seguridad con un bajo costo de área, haciéndola adecuada para dispositivos IoT con recursos limitados.
5.  **Verificación de Seguridad del Protocolo:** El protocolo de registro y autenticación propuesto superó la verificación de seguridad estándar.

**Conclusiones:**

El documento presenta una solución prometedora para la vulnerabilidad de las PUF frente a los ataques de modelado basados en aprendizaje automático. La arquitectura (n,k)-MAO PUF, mediante la ofuscación de los parámetros del LFSR con las respuestas de múltiples APUFs, introduce una capa de complejidad que frustra eficazmente los intentos de los algoritmos de ML de predecir las respuestas de la PUF. La implementación en FPGA y los resultados experimentales confirman que la (5,3)-MAO PUF ofrece una resistencia robusta a los ataques ML mientras mantiene características estadísticas deseables y un bajo consumo de recursos, lo que la convierte en una opción viable para la autenticación segura en entornos IoT. El protocolo de autenticación asociado complementa la arquitectura, proporcionando un esquema de seguridad integral.

---

## Deep neural network modeling attacks on arbiter-PUF-based designs.pdf

## Resumen Detallado: Ataques de Modelado con Redes Neuronales Profundas en Diseños Basados en Arbiter-PUF

El documento "Deep neural network modeling attacks on arbiter-PUF-based designs" de Wang et al. (2025) aborda la creciente amenaza de ataques de modelado basados en aprendizaje profundo (Deep Learning, DL) contra Funciones Físicas Inclonables (PUF), específicamente enfocándose en PUF de tipo Strong PUF basadas en la operación lógica de Arbiter PUF (APUF).

**1. Introducción y Contexto:**

Las PUF son estructuras de circuito novedosas que aprovechan las variaciones aleatorias inherentes al proceso de fabricación de semiconductores para proporcionar soluciones de seguridad de hardware ligeras, sin claves y resistentes a manipulaciones. Son utilizadas en aplicaciones como el diseño de chips, IoT, autenticación, protección de la privacidad y tecnología blockchain. Se clasifican en Weak PUF (número limitado de pares desafío-respuesta, CRPs) y Strong PUF (gran número de CRPs, exponencialmente relacionados con los componentes de hardware). Arbiter PUF (APUF) y sus variantes como XOR APUF son ejemplos prominentes de Strong PUF.

Aunque las PUF se concibieron inicialmente como inclonables, se ha demostrado que las Strong PUF son vulnerables a ataques de modelado. El aprendizaje automático (Machine Learning, ML) ha sido una amenaza principal, donde un atacante puede entrenar un modelo para simular el comportamiento de una PUF a partir de CRPs. El documento señala que los ataques clásicos de ML tienen limitaciones en la eficiencia y la capacidad de modelar Strong PUF de estructura compleja. Los ataques de canal lateral, por otro lado, son costosos. Por lo tanto, el aprendizaje profundo emerge como una opción efectiva y eficiente para atacar PUF de estructura compleja.

**2. Contribuciones Principales del Documento:**

*   **Aplicación pionera de DNN a PUF combinacionales:** Por primera vez, se aplica una red neuronal profunda (DNN) para evaluar la resiliencia al modelado de PUF basadas en operaciones lógicas combinacionales (OR, AND, XOR) que utilizan APUF como componentes (denominadas OAX-PUF). Investigaciones anteriores se centraron principalmente en operaciones XOR y métodos de ML clásicos.
*   **Análisis de seguridad de OAX-PUF:** Se completa el modelado y el análisis de seguridad de las OAX-PUF.
*   **Evaluación cuantitativa y límites de seguridad:** Se construye un conjunto de datos de CRPs y se entrena un modelo DNN de 4 capas para realizar la validación experimental y la evaluación cuantitativa de cualquier combinación de las tres operaciones lógicas (OR, AND, XOR) en OAX-PUF, con el fin de determinar los límites de seguridad.
*   **Identificación de patrones de seguridad:** Se exploran los patrones regulares de seguridad en la resiliencia al modelado.
*   **Impacto del sesgo en las respuestas de PUF:** Se demuestra, por primera vez, que el sesgo en las respuestas de PUF puede reducir o incluso destruir la seguridad de las PUF.
*   **Influencia de las operaciones lógicas:** Las operaciones lógicas OR y AND no proporcionan ningún beneficio de seguridad en el diseño de PUF, mientras que las operaciones XOR mejoran la seguridad de las PUF.

**3. Metodología Principal:**

El estudio se enfoca en las OAX-PUF, un modelo de PUF propuesto en 2022, que es una combinación de operaciones lógicas OR, AND y XOR, construida sobre instancias de APUF. Las n-XOR PUF son una variante de APUF ampliamente utilizada y representativa de las Strong PUF.

*   **Modelo de Ataque:** Se emplea un modelo de Red Neuronal Profunda (DNN) de 4 capas. Este modelo se entrena utilizando pares desafío-respuesta (CRPs) obtenidos de las OAX-PUF.
*   **Generación de Datos:** Se construye un conjunto de datos de CRPs para las diferentes configuraciones de OAX-PUF (que incluyen combinaciones de OR, AND y XOR).
*   **Evaluación de la Resiliencia:** La resiliencia al modelado de las PUF se evalúa en función de la capacidad de la DNN para predecir correctamente las respuestas de la PUF. Una mayor precisión del modelo DNN indica una menor resiliencia de la PUF al ataque.
*   **Análisis del Sesgo:** Se investiga cómo el sesgo en las respuestas de la PUF afecta la capacidad de modelado de la DNN.

**4. Resultados y Hallazgos Clave:**

*   **Efectividad de las DNN:** Las redes neuronales profundas son una herramienta efectiva y eficiente para modelar Strong PUF de estructura compleja, superando las limitaciones de los ataques clásicos de ML en ciertos escenarios.
*   **Impacto del Sesgo:** El sesgo en las respuestas de las PUF es un factor crítico que puede comprometer seriamente su seguridad. Las PUF con respuestas más sesgadas son significativamente más fáciles de modelar.
*   **Rol de las Operaciones Lógicas:**
    *   **OR y AND:** Las operaciones lógicas OR y AND, cuando se usan en la construcción de PUF, no aportan beneficios de seguridad. Por el contrario, pueden introducir sesgos o patrones que facilitan los ataques de modelado.
    *   **XOR:** Las operaciones XOR mejoran la seguridad de las PUF. Esto se debe a su naturaleza no lineal, que dificulta la extracción de patrones y el modelado por parte de los algoritmos de ML/DL.
*   **Límites de Seguridad:** El estudio permite establecer límites de seguridad para las OAX-PUF, identificando qué combinaciones de operaciones lógicas y qué niveles de sesgo las hacen vulnerables a ataques de modelado con DNN.

**5. Conclusiones:**

El estudio de Wang et al. (2025) subraya la importancia de considerar la vulnerabilidad a ataques de modelado basados en aprendizaje profundo al diseñar Strong PUF. Demuestra que no todas las operaciones lógicas contribuyen por igual a la seguridad de una PUF. Específicamente, las operaciones XOR son cruciales para mejorar la resiliencia al modelado, mientras que OR y AND pueden ser contraproducentes. Además, el sesgo en las respuestas de la PUF es una métrica crítica de seguridad que debe minimizarse durante el diseño para resistir los ataques de modelado. Los hallazgos proporcionan pautas importantes para el diseño de PUF más robustas contra las crecientes capacidades de los ataques de aprendizaje profundo.

---

## Design of a dynamic obfuscation-based strong PUF resistant to modeling attacks and mutual authentication protocol.pdf

El documento titulado "Design of a dynamic obfuscation-based strong PUF resistant to modeling attacks and mutual authentication protocol" propone una novedosa Función Física Inclonable (PUF) basada en ofuscación dinámica para resistir ataques de modelado mediante aprendizaje automático (ML), y un protocolo de autenticación mutua para sistemas IoT.

**1. Contexto y Motivación:**

El auge del Internet de las Cosas (IoT) ha traído consigo desafíos significativos en la seguridad de los dispositivos. Los protocolos de autenticación convencionales (AES, RSA, Hash) a menudo no son adecuados para dispositivos IoT con recursos computacionales limitados. Las PUFs, que aprovechan las variaciones de fabricación para generar características únicas e intrínsecas del chip, han surgido como una solución prometedora para la seguridad del hardware. Sin embargo, las PUFs fuertes, como la Arbiter PUF (APUF), son vulnerables a ataques de modelado basados en ML, donde un atacante puede predecir las respuestas de la PUF con alta precisión tras recopilar suficientes pares desafío-respuesta (CRP). El documento señala que una APUF puede ser modelada con una precisión del 99% con solo 2555 CRPs usando Regresión Logística.

**2. Problema Abordado:**

El trabajo busca resolver dos problemas principales:
*   La vulnerabilidad de las PUFs fuertes (especialmente APUF) a ataques de modelado basados en ML.
*   La necesidad de un protocolo de autenticación seguro y eficiente para dispositivos IoT, que sea resistente a diversos ataques.

**3. Metodología Principal: PUF de Ofuscación Dinámica (DO PUF)**

El núcleo de la propuesta es una estructura PUF que incorpora **Ofuscación Dinámica (DO)**. Esta estructura no modifica la PUF subyacente (lo que la hace aplicable a una amplia gama de PUFs existentes), sino que utiliza un circuito periférico para ofuscar dinámicamente los desafíos.

**Componentes Clave de la DO PUF:**

*   **Registros de Desplazamiento de Retroalimentación Lineal (LFSRs):** Se utilizan dos LFSRs.
    *   **LFSR 1 (LFSR_A):** Su estado inicial se determina a partir de la respuesta de la PUF. Esto lo hace incontrolable para un atacante, ya que la respuesta de la PUF es intrínseca y única. El estado actualizado de este LFSR determina el bit ofuscado de cada desafío de entrada.
    *   **LFSR 2 (LFSR_B):** [Aunque el extracto no detalla explícitamente el segundo LFSR, el resumen de las contribuciones menciona "dos LFSRs" y que el método "altera las posiciones de los bits de ofuscación y los parámetros". Esto sugiere que el segundo LFSR podría estar involucrado en la selección de la posición del bit a ofuscar o en la generación de los parámetros de ofuscación, contribuyendo a la naturaleza dinámica.]
*   **PUF Subyacente:** La PUF original (por ejemplo, una APUF) que genera la respuesta fundamental.
*   **Puertas Lógicas:** Para implementar la lógica de ofuscación y la interconexión entre los componentes.

**Características de la Ofuscación Dinámica (DO):**

1.  **Estado Inicial Incontrolable del LFSR:** El estado inicial del LFSR se deriva de la respuesta de la PUF, lo que significa que un atacante no puede controlarlo ni predecirlo fácilmente.
2.  **Mapeo Dinámico Desafío-Respuesta:** El estado actualizado del LFSR determina qué bit del desafío de entrada se ofusca. Esto crea un mapeo dinámico y cambiante entre los desafíos y las respuestas, haciendo que la relación funcional sea mucho más compleja y difícil de modelar. Cada CRP tiene un mapeo único debido a esta dinámica.

**4. Protocolo de Autenticación Mutua:**

El documento propone un protocolo de autenticación mutua basado en esta DO PUF, diseñado para sistemas IoT. Este protocolo incorpora:
*   **Números Aleatorios (Nonces):** Para prevenir ataques de repetición.
*   **Marcas de Tiempo:** Para asegurar la frescura de los mensajes y prevenir ataques de reenvío.
*   **Mecanismos de Etiquetado:** [El extracto no detalla este punto, pero sugiere una forma de identificar o categorizar las comunicaciones o dispositivos.]

**5. Implementación y Evaluación:**

*   **Implementación:** Se implementó una **DO APUF de 64 y 128 etapas** en una **FPGA Xilinx Artix-7**.
*   **Evaluación de Resistencia a Ataques de Modelado:**
    *   Se probó la DO APUF contra **cinco algoritmos de aprendizaje automático** (no especificados en el extracto, pero inferidos como los comúnmente usados en ataques a PUFs como Regresión Logística, SVM, ANN, etc.).
    *   **Resultados Clave:** La precisión de predicción de estos algoritmos se redujo significativamente a **casi el 50%**. Una precisión del 50% es equivalente a una adivinación aleatoria, lo que indica una resistencia efectiva a los ataques de modelado.
    *   **Análisis Matemático:** Se realizó un análisis matemático para substanciar la robustez de la PUF propuesta contra los ataques de modelado.
*   **Evaluación del Protocolo de Autenticación:**
    *   **Resultados Clave:** El protocolo propuesto demostró ser efectivo contra diversos tipos de ataques, incluyendo:
        *   **Eavesdropping (Escucha):** La información intercambiada no puede ser interceptada y utilizada.
        *   **Replay Attacks (Ataques de Repetición):** El uso de nonces y marcas de tiempo impide que mensajes antiguos sean retransmitidos con éxito.
        *   **Physical Cloning (Clonación Física):** La naturaleza inclonable de la PUF subyacente y la ofuscación dinámica dificultan la clonación.
        *   **DoS Attacks (Ataques de Denegación de Servicio):** [El extracto no detalla cómo se mitiga esto, pero es una afirmación importante del protocolo.]

**6. Contribuciones Principales del Trabajo:**

1.  **Nueva Estructura de Ofuscación de CRP:** Propone una estructura que ofusca dinámicamente los desafíos sin modificar la PUF subyacente, utilizando dos LFSRs para alterar las posiciones y parámetros de ofuscación, creando un mapeo único para cada CRP y mejorando la seguridad.
2.  **Evaluación Rigurosa y Resistencia Superior:** Demuestra en FPGA que la DO APUF reduce la precisión de predicción de algoritmos de ML a casi el 50%, superando a otras estructuras

---

## Efficient, reliable, and secure PUF architecture with temperature invariance and ML attack resilience.pdf

## Resumen Detallado del Artículo: "Efficient, reliable, and secure PUF architecture with temperature invariance and ML attack resilience"

Este documento presenta una novedosa arquitectura de Función Físicamente Inclonable (PUF) diseñada para superar las limitaciones de las PUF convencionales, particularmente en términos de confiabilidad ante variaciones de temperatura, efectos de envejecimiento y vulnerabilidad a ataques de aprendizaje automático (ML). Las PUF son soluciones de hardware esenciales para la autenticación segura y la generación de claves, aprovechando las variaciones inherentes e impredecibles que surgen durante la fabricación de semiconductores para crear identificadores únicos e inclonables para cada dispositivo.

### 1. Introducción y Motivación

La seguridad de hardware es crucial en el panorama actual de dispositivos conectados. Las PUF ofrecen una forma robusta de proteger los sistemas digitales, generando "huellas dactilares" únicas para cada chip. A pesar de su promesa, las PUF existentes, especialmente las basadas en Arbiter, enfrentan desafíos significativos:
* **Sensibilidad a la temperatura:** Las variaciones de temperatura pueden afectar la confiabilidad de las respuestas de la PUF.
* **Efectos de envejecimiento:** Fenómenos como la inestabilidad de polarización negativa por temperatura (NBTI) y la inyección de portadores calientes (HCI) degradan el rendimiento del transistor con el tiempo, comprometiendo la estabilidad de la PUF.
* **Vulnerabilidad a ataques de ML:** Los atacantes pueden construir modelos predictivos de las respuestas de la PUF, comprometiendo su seguridad.

El documento aborda estas limitaciones proponiendo una arquitectura de PUF Arbiter optimizada que integra inversores "current-starved" (CSI) con punto de coeficiente de temperatura cero (ZTC) e inversores resistentes al envejecimiento (ARI), junto con una lógica de recombinación de respuesta no lineal para mejorar la resistencia a los ataques de ML.

### 2. Contribuciones Clave del Artículo

Las principales contribuciones de este trabajo son:

1.  **Integración de Inversores "Current-Starved" (CS) e Inversores Resistentes al Envejecimiento (ARI):**
    *   Los inversores CS polarizados en el punto ZTC, combinados con los inversores ARI, mejoran significativamente la resistencia a las fluctuaciones de temperatura y a los efectos de envejecimiento (NBTI y HCI), asegurando la confiabilidad a largo plazo.

2.  **Robustez Contra Ataques de Aprendizaje Automático (ML):**
    *   La arquitectura propuesta utiliza una combinación de operaciones bit a bit MAX y MIN (equivalentes a AND y OR), junto con operaciones XOR y modificaciones arquitectónicas en la recombinación de la PUF. Esto se anticipa para mejorar significativamente la resiliencia contra ataques de modelado. La predicción de los ataques de ML sobre las respuestas de la PUF oscila entre aproximadamente el 55% y el 79.3%, lo que indica una seguridad mejorada.

3.  **Confiabilidad en un Amplio Rango de Temperaturas:**
    *   El diseño logra una mejora de la confiabilidad de hasta el 98.06% en un amplio rango de temperaturas (de -40 °C a 120 °C), abordando una limitación crítica en los diseños de PUF convencionales.

4.  **Validación Experimental y Alto Rendimiento:**
    *   La implementación en una FPGA (Digilent Basys 3 Artix-7) demuestra la aplicabilidad práctica y la efectividad del diseño propuesto, con una alta tasa de generación de bits de 95 Mb/s y un uso mínimo de recursos de hardware.

### 3. Metodología Principal y Arquitectura Propuesta

La arquitectura propuesta se basa en la PUF Arbiter convencional, pero introduce varias modificaciones clave:

*   **Inversores "Current-Starved" (CSI):** Se utilizan CSI en las rutas de retardo de la PUF Arbiter. Los CSI son inversores CMOS modificados que incorporan transistores PMOS y NMOS adicionales para limitar el flujo de corriente, permitiendo un ajuste preciso del retardo de propagación. Al operar en el punto de coeficiente de temperatura cero (ZTC), los CSI minimizan el impacto de las variaciones de temperatura en el retardo, asegurando respuestas estables y consistentes.

*   **Inversores Resistentes al Envejecimiento (ARI):** Los ARI están diseñados para contrarrestar los cambios de umbral de voltaje debido a la degradación NBTI (en PMOS) y los efectos HCI (en NMOS). Para mitigar el envejecimiento, se utilizan transistores de "sleep" para aliviar periódicamente el estrés de los dispositivos PMOS, y se emplean bucles de retroalimentación de equilibrio de carga.

*   **Lógica de Recombinación de Respuesta Mejorada:** Para mejorar la resistencia a los ataques de ML, se utiliza una lógica de recombinación no lineal que combina operaciones bit a bit MAX y MIN (AND y OR) junto con operaciones XOR. Esta combinación de operaciones dificulta que los atacantes construyan modelos precisos de las respuestas de la PUF.

La arquitectura propuesta se implementa reemplazando los inversores tradicionales en las rutas de retardo de la PUF Arbiter con elementos CSI y ARI, y modificando la etapa final del árbitro con la lógica de recombinación no lineal.

### 4. Resultados y Evaluación

Los resultados de la evaluación demuestran la eficacia de la arquitectura propuesta:

*   **Confiabilidad:** La confiabilidad se incrementa significativamente del 80.06% al 98.06% en un amplio rango de temperaturas (de -40 °C a 120 °C).
*   **Unicidad, Uniformidad y "Bit-Aliasing":** Se lograron valores de 49.21% para unicidad, 50.08% para uniformidad y 50.08% para "bit-aliasing", que son métricas ideales para PUFs.
*   **Disipación de Potencia:** La disipación de potencia se reduce aproximadamente 1.57 veces en comparación con la PUF Arbiter convencional.
*   **Retardo:** Los resultados de simulación pre-layout y post-layout mostraron retardos de 1.08 ns y 1.95 ns, respectivamente.
*   **Aleatoriedad:** Las pruebas NIST confirmaron la aleatoriedad en las respuestas del diseño propuesto.
*   **Implementación en FPGA:** El diseño se verificó experimentalmente utilizando Xilinx Vivado e implementado en una FPGA Digilent Basys 3 Artix-7, demostrando un bajo uso de recursos de hardware y una alta tasa de generación de bits de 95 Mb/s.
*   **Resistencia a Ataques ML:** El diseño exhibe una resiliencia notable contra ataques de aprendizaje automático,

---

## Modeling and physical attack resistant authentication protocol with double PUFs.pdf

El documento "Modeling and physical attack resistant authentication protocol with double PUFs" propone un protocolo de autenticación mutua de dispositivos basado en PUFs dobles, diseñado para sistemas IoT de bajo costo. El objetivo principal es mejorar la resistencia contra ataques de modelado basados en aprendizaje automático (ML) y ataques físicos, que son vulnerabilidades comunes en las Funciones Físicas Inclonables (PUF) existentes.

**Puntos Clave y Contribuciones Principales:**

1.  **Unidad de Ofuscación Dinámicamente Configurable (DLFSR):** Se introduce una unidad de ofuscación para PUFs que utiliza un Registro de Desplazamiento de Retroalimentación Lineal Dinámico (DLFSR). Esta unidad tiene una estructura y parámetros configurables que cambian con el ciclo de reloj, aumentando significativamente la no linealidad del sistema sin una sobrecarga de hardware adicional. Esto dificulta el modelado de la PUF por parte de algoritmos de ML.

2.  **Protocolo de Autenticación con Doble PUF:** Se propone un protocolo de autenticación mutua de dispositivos que emplea dos instancias de PUF. Este diseño de "doble etapa" (dual-stage) y autenticación "dispositivo a servidor" limita la cantidad de datos que un atacante puede obtener, mejorando la robustez contra ataques de intermediario (man-in-the-middle) y de manipulación.

3.  **Mecanismo de Patrón Aleatorio contra Ataques Físicos:** Se incorpora un mecanismo basado en patrones aleatorios a nivel de protocolo para fortalecer la resistencia contra ataques físicos invasivos. Este enfoque añade una capa adicional de seguridad que no depende únicamente de las propiedades físicas de las PUFs.

4.  **Análisis Teórico y Experimental Riguroso:** Se presenta un modelo matemático de la unidad propuesta y se realiza un análisis de seguridad teórico. El diseño se implementa completamente en FPGA utilizando instancias de Arbiter PUF (APUF) y se evalúa con estándares de seguridad más rigurosos, demostrando su simplicidad, fiabilidad y ligereza.

**Metodología Principal:**

El trabajo aborda la vulnerabilidad de las PUFs a los ataques de modelado, donde un atacante utiliza algoritmos de ML para predecir pares de desafío-respuesta (CRP) no observados. La APUF, aunque es un diseño de PUF robusto y ligero, es susceptible a estos ataques debido a su estructura lineal.

El protocolo propuesto se basa en las siguientes ideas:
*   **Ofuscación a nivel de hardware:** La unidad de ofuscación DLFSR se intercala con la PUF para introducir no linealidad dinámica. El DLFSR genera una secuencia de bits que modifica el desafío de entrada a la PUF de manera impredecible, haciendo que la relación entre el desafío original y la respuesta de la PUF sea mucho más compleja y difícil de modelar. La estructura y los parámetros del DLFSR pueden cambiar, lo que complica aún más el modelado.
*   **Autenticación en dos etapas (Dual-PUF):** El protocolo utiliza dos PUFs separadas en dos etapas de autenticación. Esto significa que un atacante necesitaría modelar dos PUFs diferentes o comprometer dos procesos de autenticación para obtener información suficiente, lo que aumenta la complejidad del ataque. La limitación de la exposición de CRPs es crucial.
*   **Resistencia a ataques físicos:** Se introduce un mecanismo a nivel de protocolo que implica el uso de patrones aleatorios. Si el dispositivo detecta un intento de ataque físico (por ejemplo, mediante sensores de manipulación o análisis de potencia), puede alterar su comportamiento o invalidar los CRPs, frustrando el ataque. El documento explora un escenario típico de ataque físico y propone mejoras para mitigarlo.

**Resultados Más Importantes:**

*   **Resistencia a ataques de ML:** Los resultados experimentales en FPGA demuestran que el diseño es eficaz para resistir ataques basados en ML. La unidad de ofuscación DLFSR aumenta la complejidad de la relación desafío-respuesta, haciendo que los modelos de ML requieran una cantidad significativamente mayor de CRPs para lograr una precisión aceptable, o que no puedan modelar la PUF con la precisión necesaria.
*   **Resistencia a ataques físicos:** El protocolo con patrones aleatorios y el diseño de doble PUF mejora la robustez contra ataques físicos, incluyendo la extracción de claves y la manipulación del dispositivo.
*   **Ligereza y eficiencia:** El diseño es ligero y adecuado para sistemas IoT con recursos limitados, lo que contrasta con las soluciones de seguridad tradicionales que tienen una alta sobrecarga computacional y de memoria.
*   **Fiabilidad:** Las evaluaciones indican que el sistema es más fiable en comparación con las PUFs simples frente a diversas amenazas.

**Conclusiones:**

El documento concluye que el protocolo de autenticación propuesto, que combina una unidad de ofuscación DLFSR con un esquema de doble PUF y un mecanismo de patrón aleatorio, ofrece una solución robusta y ligera para la autenticación de dispositivos en sistemas IoT. Supera las limitaciones de las PUFs tradicionales al proporcionar una fuerte resistencia contra ataques de modelado basados en ML y ataques físicos. La implementación en FPGA valida la viabilidad y eficacia del enfoque, presentando una alternativa prometedora para mejorar la seguridad en dispositivos con recursos limitados. El trabajo sugiere futuras investigaciones para explorar variantes de la unidad de ofuscación y otros mecanismos de seguridad a nivel de protocolo.

---

## Neural Network Modeling Attacks on Arbiter-PUF-Based Designs.pdf

Este documento, titulado "Neural Network Modeling Attacks on Arbiter-PUF-Based Designs", aborda la seguridad de las Funciones Físicas Inclonables (PUFs) basadas en Arbiter PUF y sus variantes, mediante el análisis de ataques de modelado basados en redes neuronales. Los autores revisan, mejoran y extienden ataques existentes, demostrando que las redes neuronales pueden superar a los métodos tradicionales en eficiencia y alcance.

**1. Contexto y Problema Principal:**

Las PUFs son dispositivos que aprovechan las variaciones físicas intrínsecas de los semiconductores para generar claves criptográficas o identidades únicas, ofreciendo una alternativa a la seguridad basada en el almacenamiento de secretos. Sin embargo, las PUFs son vulnerables a ataques de modelado, donde un adversario utiliza pares desafío-respuesta (CRP) observados para construir un modelo matemático que predice el comportamiento de la PUF. Si este modelo es preciso, la seguridad de la PUF se colapsa.

Tradicionalmente, los ataques de modelado se basaban en modelos físicamente motivados. Sin embargo, el reciente auge de las redes neuronales (NN) como herramientas de aprendizaje genéricas ha abierto nuevas vías para ataques de modelado más potátiles y eficientes, incluso sin un conocimiento físico detallado de la PUF. El problema principal que aborda este trabajo es entender la efectividad de estos ataques basados en NN en las Arbiter PUF y sus variantes, y cómo se comparan con los métodos tradicionales. Se busca responder a preguntas clave sobre la complejidad de datos y tiempo, las probabilidades de éxito, y la configuración de hiperparámetros de estos ataques.

**2. Metodología Principal:**

El estudio se centra en las Arbiter PUF y sus variantes (XOR Arbiter PUF, Feed-Forward Arbiter PUF, Interpose PUF), que son comúnmente usadas como puntos de referencia o bloques de construcción. La metodología se basa en la implementación y comparación de varios ataques de modelado:

*   **Ataques de Redes Neuronales (NN):** Se replican y extienden tres ataques basados en redes neuronales de la literatura. Estos ataques utilizan modelos genéricos que no dependen de un conocimiento físico explícito de la PUF. Se utilizan marcos de aprendizaje automático populares como Keras para su implementación.
*   **Ataque de Regresión Logística (LRA):** Este ataque sirve como línea base de comparación, ya que es un método tradicional y bien estudiado basado en un modelo físicamente motivado (el modelo de retardo aditivo).
*   **Comparación Exhaustiva y Justa:** Se realiza una comparación detallada del rendimiento de todos los ataques, considerando la complejidad de datos (número de CRPs requeridos), la complejidad de tiempo (velocidad del ataque) y la capacidad de atacar PUFs con parámetros de seguridad más grandes.
*   **Evaluación en Simulación y Datos de Silicio:** Los ataques se evalúan tanto en datos simulados como en datos reales obtenidos de PUFs implementadas en silicio.
*   **Implementación de Código Abierto:** Se proporciona una implementación unificada y fácil de usar de todos los ataques en Python bajo una licencia de código abierto, integrada en el framework `pypuf`.

**3. Resultados Clave:**

Los hallazgos del estudio son significativos y demuestran la superioridad de los ataques basados en redes neuronales en varios aspectos:

*   **Mayor Velocidad y Alcance:** Los ataques basados en redes neuronales pueden atacar las XOR Arbiter PUFs más rápidamente y con parámetros de seguridad más grandes de lo que se conocía anteriormente.
*   **Menor Complejidad de Datos:** Estos ataques requieren un orden de magnitud menor de pares desafío-respuesta (CRPs) en comparación con los ataques tradicionales, tanto en simulaciones como en datos de silicio. Esto refuta afirmaciones previas sobre la seguridad de las XOR Arbiter PUFs y la relevancia de los ataques basados en NN.
*   **Implicaciones Amplias:** La mejora en el rendimiento de los ataques basados en NN no solo afecta a las XOR Arbiter PUFs, sino que también reduce la complejidad de datos del "Splitting Attack" en la Interpose PUF y permite ataques a la Feed-Forward Arbiter PUF.
*   **Refutación de Afirmaciones Anteriores:** El estudio refuta una afirmación reciente sobre una muy baja complejidad de datos para los ataques de modelado de XOR Arbiter PUF.
*   **Herramienta Esencial para el Análisis de Seguridad:** Los resultados sugieren que los ataques de modelado basados en redes neuronales deben convertirse en una parte estándar del conjunto de herramientas para el análisis de seguridad de las PUFs.

**4. Conclusiones:**

El documento concluye que los ataques de modelado basados en redes neuronales representan una amenaza considerable para la seguridad de las Arbiter PUF y sus variantes. Han demostrado ser más eficientes en términos de datos y tiempo que los ataques tradicionales de regresión logística, pudiendo comprometer PUFs con mayores parámetros de seguridad. La capacidad de estos ataques para operar con muchos menos CRPs es particularmente preocupante, ya que reduce drásticamente el esfuerzo y los recursos que un atacante necesita para modelar una PUF.

Los autores enfatizan la necesidad de incorporar estos ataques basados en NN en el arsenal estándar para la evaluación de la seguridad de las PUFs. La implementación de código abierto proporcionada en este trabajo facilita a otros investigadores la replicación de estos resultados y la extensión del análisis a otros diseños de PUFs. Este trabajo subraya que el rápido avance en el aprendizaje automático requiere una reevaluación continua de las garantías de seguridad de los diseños de PUFs existentes y futuros.

---
