MarinGE23/axi-plpuf-ip/docu/PUFs_PLPUFs/06_Authentication_Protocols/resumen_06_Authentication_Protocols.md

# Resumen de la Carpeta: 06_Authentication_Protocols

Esta sección presenta un análisis detallado de los documentos PDF contenidos en la carpeta `06_Authentication_Protocols`, enfocándose en los aspectos clave de cada publicación.

---

## A Lightweight PUF-Based Authentication Protocol Using Secret Pattern Recognition for Constrained IoT Devices.pdf

El documento "A Lightweight PUF-Based Authentication Protocol Using Secret Pattern Recognition for Constrained IoT Devices" aborda el desafío de proporcionar soluciones de seguridad ligeras y robustas para dispositivos IoT con recursos limitados, utilizando funciones físicamente inclonables (PUF).

**1. Introducción y Problema Abordado:**

Los dispositivos IoT restringidos, como las etiquetas RFID o los implantes médicos, tienen limitaciones significativas en consumo de energía, área de implementación y costo. Las soluciones criptográficas estándar son a menudo demasiado exigentes para estos dispositivos. Las PUF (Physical Unclonable Functions) emergen como una alternativa prometedora, aprovechando la aleatoriedad inherente del proceso de fabricación de CMOS para generar respuestas únicas a desafíos específicos.

Sin embargo, las soluciones de seguridad basadas en PUF existentes a menudo carecen de características de seguridad esenciales como la autenticación mutua, el cifrado de mensajes o la resistencia a ataques de denegación de servicio (DoS). Además, las PUF, especialmente las PUF fuertes, son vulnerables a ataques de modelado, donde un atacante recopila pares desafío-respuesta (CRP) y utiliza algoritmos de aprendizaje automático para crear un modelo de software capaz de predecir respuestas futuras. Para contrarrestar esto, se suelen requerir PUF muy grandes o cálculos costosos (cifrado, hashing), lo que anula la ventaja de ser "ligero".

Este trabajo se propone introducir un protocolo de autenticación basado en PUF ligero que:
* Ofrezca autenticación mutua ilimitada y un intercambio seguro de mensajes secretos.
* Sea resistente a ataques de modelado y ataques Man-in-the-Middle (MITM).
* Evite el uso de funciones criptográficas o hash complejas para mantener su naturaleza ligera.

**2. Metodología Principal y Arquitectura del Protocolo (LPA):**

El protocolo propuesto, denominado **LPA (Lightweight PUF-Based Authentication)**, se basa en el reconocimiento de patrones secretos y utiliza varias técnicas para introducir no linealidad y robustez.

**Componentes Clave:**
* **PUF Fuerte:** El protocolo puede emplear cualquier circuito PUF fuerte para el cual se pueda generar un modelo de software (aunque el protocolo busca evitar que un atacante genere dicho modelo). El documento examina específicamente la PUF de árbitro de retardo como ejemplo.
* **Generador de Números Verdaderamente Aleatorios (TRNG):** Esencial para la generación de desafíos y la aleatoriedad necesaria en el protocolo.
* **Operaciones a Nivel de Bit:** El protocolo se basa principalmente en operaciones lógicas a nivel de bit, lo que contribuye a su ligereza.
* **Patrones Secretos Ocultos:** Un conjunto de patrones de intercambio ocultos y únicos asignados a cada dispositivo, que son clave para la resiliencia contra ataques de modelado.

**Fases del Protocolo LPA:**

1.  **Generación de Patrón Secreto (Registro):**
    *   Durante el registro, el servidor genera un conjunto de desafíos $C_0, C_1, ..., C_n$.
    *   El dispositivo (con su PUF) responde a estos desafíos generando $R_0, R_1, ..., R_n$.
    *   El servidor y el dispositivo acuerdan un patrón secreto $P_i$. Este patrón es una secuencia de índices que determina qué respuestas PUF se utilizarán en una sesión de autenticación.
    *   El servidor almacena $C_i$, $R_i$ y $P_i$ para cada dispositivo.
    *   El dispositivo solo necesita almacenar $P_i$ y su PUF.

2.  **Funciones de Transformación de Desafío (para protección MITM):**
    *   El protocolo introduce funciones de transformación de desafío que pueden convertir desafíos altamente correlacionados (como los de las PUF de árbitro) en múltiples desafíos únicos y no correlacionados.
    *   Estas funciones son vitales para proteger el protocolo contra ataques MITM, ya que un atacante no puede simplemente reenviar desafíos y respuestas.

3.  **Autenticación Mutua:**
    *   El protocolo utiliza un proceso de desafío-respuesta modificado. En lugar de enviar un desafío y esperar una respuesta directa, el servidor y el dispositivo intercambian "desafíos" que se derivan de las respuestas PUF y los patrones secretos.
    *   La autenticación se logra verificando que el dispositivo puede generar la secuencia correcta de respuestas (derivadas del patrón secreto) y que el servidor puede validar estas respuestas.
    *   La naturaleza "mutua" implica que ambas partes (dispositivo y servidor) se autentican entre sí.

4.  **Intercambio de Mensajes Secretos Autenticados:**
    *   El protocolo extiende la autenticación para permitir el cifrado y la autenticación de mensajes secretos.
    *   Esto se logra mediante la derivación de claves de sesión a partir de las respuestas PUF y los patrones secretos, que luego se utilizan para cifrar y autenticar el mensaje.

**3. Análisis de Seguridad y Resistencia a Ataques:**

El documento realiza un análisis de seguridad detallado y pruebas de resiliencia contra ataques conocidos:

*   **Ataques de Modelado (Machine Learning):**
    *   El protocolo se prueba contra algoritmos de aprendizaje automático como Estrategias de Evolución (ES), Redes Neuronales Artificiales (ANN) y Máquinas de Vectores de Soporte (SVM).
    *   La clave para la resistencia es la introducción de no linealidad y la dependencia de patrones secretos ocultos. Un atacante que observe CRPs no puede inferir el modelo de la PUF porque los desafíos y respuestas utilizados en la autenticación real están ofuscados por los patrones secretos y las transformaciones de desafío.
    *   El protocolo asegura que los CRP expuestos a un atacante no son suficientes para entrenar un modelo predictivo con alta precisión.

*   **Ataques Man-in-the-Middle (MITM):**
    *   Las funciones de transformación de desafío son cruciales para mitigar los ataques MITM. Estas funciones aseguran que los desafíos no puedan ser simplemente interceptados y reenviados, ya que se transforman dinámicamente.

*   **Ataques de Denegación de Servicio (DoS):**
    *   El diseño del protocolo busca evitar vulnerabilidades que podrían llevar a ataques DoS, aunque el documento no detalla explícitamente las contramedidas específicas más allá de la autenticación mutua y la dificultad de predecir respuestas.

*   **Ataques de Replay:**
    *   El uso de un TRNG para generar desafíos aleatorios y la naturaleza dinámica de los patrones de intercambio hacen que los ataques de replay sean ineficaces, ya que una sesión anterior no puede ser simplemente repetida.

**4. Resultados y Evaluaciones:**

*   **Ligeridad:** El protocolo evita el uso de funciones criptográficas

---

## Advanced PUF Protocol A Machine Learning Resilient PUF-based Protocol for Lightweight Mutual Authentication.pdf

El documento "Advanced PUF Protocol: A Machine Learning Resilient PUF-based Protocol for Lightweight Mutual Authentication" presenta un protocolo de autenticación mutua ligero basado en Funciones Físicas Inclonables (PUF) que es resistente a los ataques de modelado basados en Machine Learning (ML). Los autores, Tarek Idriss, Haytham Idriss y Magdy Bayoumi de la Universidad de Louisiana en Lafayette, abordan la vulnerabilidad conocida de las PUF fuertes a los ataques de modelado, que comprometen su utilidad como primitivas de seguridad para dispositivos con recursos limitados en el Internet de las Cosas (IoT).

**1. Problema Principal y Motivación:**

Los dispositivos IoT tienen restricciones significativas en términos de consumo de energía, área de implementación y costo. Las soluciones criptográficas estándar son demasiado costosas para muchos de estos dispositivos. Las PUF fuertes, que explotan la aleatoriedad inherente del proceso de fabricación para generar respuestas únicas a desafíos específicos, ofrecen una alternativa ligera. Sin embargo, se ha demostrado que son vulnerables a ataques de modelado donde un adversario puede recolectar pares desafío-respuesta (CRP) y usar algoritmos de ML para crear un modelo de software de la PUF, prediciendo así sus respuestas futuras. Esto compromete la seguridad de los protocolos de autenticación basados en PUF. Las soluciones existentes para mitigar esto (PUF más grandes o criptografía adicional) anulan la ventaja de ligereza de las PUF.

**2. Contribuciones Principales:**

El trabajo propone un "Advanced PUF Protocol" (APP) que busca superar esta vulnerabilidad sin sacrificar la ligereza. Las contribuciones clave son:

*   **Protocolo de autenticación mutua ligero basado en PUF:** Introduce un nuevo protocolo de intercambio desafío-desafío que oculta las respuestas y los desafíos de la PUF. Se demuestra su seguridad y excepcional resistencia a los ataques de ML mediante simulaciones.
*   **Funciones de transformación de desafío novedosas:** Desarrolla funciones que pueden transformar los desafíos altamente correlacionados de las PUF basadas en Arbiter en múltiples desafíos únicos no correlacionados, con una sobrecarga de implementación mínima.
*   **Análisis de seguridad exhaustivo:** Se realiza un análisis de seguridad del protocolo y se compara con otros protocolos de autenticación ligeros basados en PUF, destacando las ventajas del APP.

**3. Metodología y Arquitectura del Protocolo (APP):**

El APP se basa en varias técnicas para introducir no linealidad y ocultar la correlación desafío-respuesta, haciéndolo resistente a los ataques de modelado.

*   **No linealidad y ocultamiento de correlaciones:** El protocolo utiliza la transformación condicional de los desafíos para enmascarar las correlaciones desafío-respuesta de la PUF subyacente.
*   **Intercambio desafío-desafío:** A diferencia de los protocolos tradicionales que intercambian desafío-respuesta, el APP intercambia desafíos generados por un generador de números aleatorios verdaderos (TRNG). La autenticación se logra verificando una correlación específica entre los desafíos intercambiados, correlaciones que están ocultas por funciones de transformación condicionales.
*   **Componentes clave:** Requiere un circuito PUF simple y un TRNG. Evita el uso de funciones criptográficas o hash para mantener su naturaleza ligera.
*   **Función de Transformación de Desafío (CTF):** Estas funciones son cruciales para la resistencia del protocolo. Transforman dinámicamente los desafíos transmitidos antes de usarlos como entradas al circuito PUF. Esto impide que un atacante recopile CRPs "limpios" para construir un modelo preciso. El documento detalla el diseño de estas funciones, especialmente para PUF basadas en Arbiter, que tienen desafíos naturalmente correlacionados.

**4. Análisis de Seguridad y Resistencia a Ataques de ML:**

El documento evalúa la seguridad del protocolo contra ataques de modelado.

*   **Vulnerabilidad de las PUF fuertes:** Se reitera que las PUF fuertes, como la Arbiter PUF y sus variantes (XOR-Arbiter PUF, LS PUF), son vulnerables a ataques de ML (e.g., Regresión Lineal, Estrategias de Evolución). Estos ataques pueden predecir las respuestas de la PUF con alta precisión con un número relativamente bajo de CRPs.
*   **Resistencia del APP:** La clave de la resistencia del APP radica en las funciones de transformación de desafío. Estas funciones ocultan la relación directa entre el desafío transmitido por el servidor y el desafío aplicado a la PUF, así como la respuesta generada por la PUF. Esto dificulta que un atacante recoja suficientes CRPs útiles para entrenar un modelo de ML.
*   **Evaluación de la resiliencia:** El protocolo se evalúa probando el rendimiento de ataques conocidos de ML contra él en un entorno simulado. Se demuestra que el APP tiene una "figura de resiliencia excepcional". Esto significa que incluso con un gran número de CRPs observados, los algoritmos de ML tienen dificultades para construir un modelo preciso de la PUF subyacente cuando el APP está en uso.

**5. Resultados y Conclusiones:**

*   **Resiliencia superior:** El APP demuestra una resiliencia significativamente mayor contra los ataques de modelado de ML en comparación con otros protocolos basados en PUF existentes. Esto devuelve la confianza en las PUF fuertes como primitivas de autenticación.
*   **Ligereza:** El protocolo mantiene la característica de ligereza al evitar criptografía pesada y funciones hash, lo que lo hace adecuado para dispositivos con recursos limitados.
*   **Autenticación mutua ilimitada:** El APP permite un número ilimitado de autenticaciones mutuas, un aspecto importante para aplicaciones IoT donde los dispositivos necesitan interactuar frecuentemente.
*   **Comparación con trabajos relacionados:** El documento compara el APP con otros protocolos basados en PUF y señala sus vulnerabilidades de seguridad y otras deficiencias. El APP ofrece ventajas significativas en términos de seguridad y número de autenticaciones posibles sin sacrificar la ligereza.
*   **Tolerancia a errores:** El documento también ilustra la tolerancia a errores del protocolo, un aspecto importante para la robustez en entornos reales.

En resumen, el "Advanced PUF Protocol" (APP) es una propuesta innovadora para la autenticación ligera en dispositivos IoT. Aborda la principal debilidad de las PUF fuertes, su vulnerabilidad a los ataques de modelado, mediante un protocolo de intercambio desafío-desafío y funciones de transformación de desafío que introducen no linealidad y ocultan las correlaciones. Esto permite el uso de PUF simples y ligeras sin comprometer la seguridad, ofreciendo una solución robusta y escalable para las crecientes amenazas de seguridad en IoT.

---

## DPReF Decentralized Key Generation Using Physical-Related Functions.pdf

El documento "DPReF: Decentralized Key Generation Using Physical-Related Functions" presenta una propuesta innovadora para la generación de claves criptográficas en entornos de Internet de las Cosas (IoT) mediante el uso de Funciones Físicas Relacionadas (PReF) de manera descentralizada. El trabajo aborda las limitaciones de las implementaciones PReF existentes, que dependen de una Tercera Parte de Confianza (TTP) para identificar desafíos relativos, introduciendo un riesgo de seguridad significativo si la TTP es comprometida.

**1. Contexto y Problema Abordado:**

El crecimiento del IoT ha hecho que la seguridad sea crucial, especialmente en dispositivos con recursos limitados. Las funciones físicamente inclonables (PUF) son una solución ligera para generar claves criptográficas basadas en las propiedades físicas inherentes de un dispositivo, actuando como una "huella digital" para cada circuito integrado. Sin embargo, las PUF por sí solas no resuelven problemas de intercambio y almacenamiento seguro de claves, ya que cada PUF genera una respuesta única para un desafío dado, lo que requiere que los dispositivos acuerden una clave compartida.

Las PReF extienden el concepto de PUF permitiendo que múltiples dispositivos generen claves similares sin necesidad de intercambiarlas o almacenarlas. Esto se logra identificando "desafíos relativos", que son desafíos específicos que producen respuestas similares en diferentes PUF. La clave puede ser regenerada bajo demanda, eliminando la necesidad de almacenamiento y reduciendo el riesgo de ataques Man-in-the-Middle (MITM) durante el intercambio.

El problema central que aborda este trabajo es que las implementaciones actuales de PReF requieren una TTP durante la fase de configuración para recopilar las listas de Pares Desafío-Respuesta (CRP) de los dispositivos y encontrar los desafíos relativos. Si esta TTP es comprometida, toda la seguridad del sistema se ve comprometida, ya que un atacante podría acceder a todas las claves. Además, la dependencia de una TTP centralizada plantea preocupaciones sobre la privacidad de las claves.

**2. Propuesta y Metodología Principal (DPReF):**

El trabajo propone DPReF (Decentralized Key Generation Using Physical-Related Functions), el primer protocolo PReF descentralizado que elimina la necesidad de una TTP. En lugar de una entidad central, DPReF permite que los dispositivos identifiquen los desafíos relativos directamente entre sí, de forma descentralizada.

La metodología principal de DPReF se basa en la interacción directa entre los nodos. En la fase de configuración, en lugar de enviar sus listas de CRP a una TTP, los nodos interactúan mutuamente para descubrir los desafíos relativos. Aunque el documento no detalla explícitamente los pasos de esta interacción en el extracto proporcionado, se infiere que implica un proceso de intercambio selectivo de información o pruebas para identificar desafíos que generen respuestas dentro de un umbral de distancia de Hamming predefinido ($\lambda$).

**3. Modelo Matemático y Generalidad:**

El trabajo formaliza un modelo matemático para estimar el número mínimo de dispositivos necesarios para construir una red DPReF. Este modelo se basa en el tamaño de la PUF (la longitud de la respuesta) y el tamaño del CRP compartido (el número de pares desafío-respuesta que se utilizan para la comparación).

La generalidad del modelo se demuestra verificándolo con diferentes tipos de PUF de vanguardia:
*   **ANV-PUF (Arbiter-based Non-Volatile Memory PUF):** Una PUF basada en arbiter con memoria no volátil.
*   **PLPUF (Pseudo Linear Feedback Shift Register PUF):** Una PUF basada en registros de desplazamiento de retroalimentación lineal pseudoaleatorios.

Esta verificación con diferentes arquitecturas de PUF sugiere que el modelo propuesto es robusto y aplicable a una variedad de implementaciones de hardware.

**4. Resultados y Logros Clave:**

*   **Generación de Clave Criptográfica Descentralizada:** El protocolo DPReF logra establecer una clave criptográfica de 128 bits de manera descentralizada, lo que iguala la seguridad de las soluciones PReF existentes pero sin la dependencia de una TTP. Esto representa un avance significativo en la seguridad y privacidad de las claves.
*   **Reducción de Riesgos de Seguridad:** Al eliminar la TTP, DPReF mitiga el riesgo de un punto único de falla y la vulnerabilidad a compromisos de la TTP, protegiendo la privacidad de las claves.
*   **Aplicación en Redes de Atestación Asistidas por Hardware:** El protocolo se demuestra capaz de construir redes de atestación asistidas por hardware utilizando implementaciones ANV-PUF y PLPUF. En este contexto, se establece un secreto compartido de 16 bits que permite tanto la verificación de integridad como la de identidad. Esto subraya la versatilidad de DPReF más allá de la mera generación de claves.
*   **Validación del Modelo Matemático:** El modelo para determinar el número mínimo de dispositivos se valida con éxito en diferentes tipos de PUF, lo que proporciona una herramienta útil para el diseño de redes DPReF.

**5. Conclusiones:**

El trabajo "DPReF: Decentralized Key Generation Using Physical-Related Functions" presenta una solución fundamental al problema de la dependencia de una TTP en los protocolos PReF existentes. Al permitir que los dispositivos identifiquen desafíos relativos directamente entre sí, DPReF mejora significativamente la seguridad y la privacidad en la generación de claves para dispositivos IoT con recursos limitados. La capacidad de establecer claves criptográficas de 128 bits de forma descentralizada y su aplicación en redes de atestación demuestran el potencial práctico y la robustez de la propuesta. El modelo matemático formalizado y su verificación con diferentes PUF añaden una base teórica sólida al diseño e implementación de sistemas DPReF. En resumen, DPReF ofrece un enfoque más seguro, resiliente y privado para la generación de claves en el ecosistema IoT.

---

## Helper Data Algorithms for PUF-Based Key Generation - Overview and Analysis.pdf

El documento "Helper Data Algorithms for PUF-Based Key Generation: Overview and Analysis" de Delvaux et al. es una **revisión exhaustiva y un análisis crítico de los Algoritmos de Datos Auxiliares (HDA, por sus siglas en inglés) utilizados en la generación de claves basada en Funciones Físicamente Inclonables (PUF)**. Los autores se proponen ser los primeros en ofrecer una visión profunda y completa de los HDA, identificar nuevas amenazas de seguridad relacionadas con la fuga y manipulación de datos auxiliares, y señalar las lagunas existentes en la investigación actual.

**Puntos Clave del Documento:**

1.  **Contexto y Problema:** La generación y el almacenamiento seguro de claves criptográficas son un desafío, especialmente para dispositivos embebidos de bajo costo y recursos limitados, donde un atacante puede tener acceso físico al chip. Las PUF emergen como una alternativa prometedora a la memoria no volátil tradicional, ya que extraen bits de las variaciones inevitables del proceso de fabricación de un circuito integrado, actuando como una "huella digital" única. Sin embargo, la salida cruda de una PUF no puede usarse directamente como clave debido a la falta de reproducibilidad, la entropía no máxima (debido a sesgos y correlaciones) y la necesidad de control sobre la clave generada. Aquí es donde entran en juego los HDA.

2.  **Necesidad de HDA:** Los HDA son indispensables para post-procesar las respuestas de las PUF y cumplir con los requisitos estrictos de una clave criptográfica:
    *   **Reproducibilidad:** La clave debe ser la misma cada vez que se extrae, a pesar del ruido en las mediciones de la PUF.
    *   **Alta Entropía:** La clave debe ser impredecible para un atacante.
    *   **Control:** La clave debe poder ser generada y, en algunos casos, actualizada o revocada.

3.  **Modelo de Fiabilidad de la PUF:** El documento enfatiza la importancia de un modelo de fiabilidad genérico y preciso para las PUF. Critica los modelos "ingenuos y homogéneos" que asignan una tasa de error idéntica a cada bit, ya que no corresponden con la realidad de las PUF. Propone y describe un **modelo heterogéneo más preciso**, donde la tasa de error para cada bit se extrae de una distribución de probabilidad. Este modelo incorpora dos variables ocultas (variabilidad de fabricación y ruido) que se asumen aditivas, independientes y normalmente distribuidas. Esto permite cuantificar la probabilidad de error ($P_e$) para cada bit, que depende de la distancia al umbral de conversión analógico-digital y del ruido.

4.  **Marco de Alto Nivel para HDA:** El documento presenta un marco general para los HDA, que incluye las siguientes etapas o componentes:
    *   **Compresión de Entropía:** Aborda el problema de que las respuestas de las PUF a menudo tienen un sesgo (los 0s y 1s no ocurren con igual probabilidad) y correlaciones, lo que reduce la entropía real de los bits.
    *   **Corrección de Errores:** Permite la recuperación de la clave original a pesar de las fluctuaciones de ruido que causan errores en las lecturas de la PUF.
    *   **Selección de Bits:** Elige los bits más estables o confiables de la PUF para la generación de claves.
    *   **Detección de Manipulación:** Implementa mecanismos para detectar si los datos auxiliares o la propia PUF han sido alterados.

5.  **Contribuciones Novedosas (Análisis de Seguridad y Lagunas):**

    *   **Visión General Completa:** Se presenta como la primera revisión en profundidad de los HDA, abarcando una década de investigación y cubriendo esquemas para compresión de entropía, corrección de errores, selección de bits y detección de manipulación. Las PUF se tratan como una caja negra para mantener la generalidad.

    *   **Nuevas Amenazas de Seguridad (Fuga y Manipulación de Datos Auxiliares):** Este es un punto central del trabajo. Los autores demuestran que los datos auxiliares, que son públicos, pueden filtrar información sensible sobre la clave secreta si no se diseñan cuidadosamente.
        *   **Códigos de Repetición:** Derivan una fórmula exacta para la fuga de información de los códigos de repetición en caso de sesgo, mostrando que el límite superior $(n-k)$ comúnmente asumido es demasiado pesimista.
        *   **Codificación de Decisión Suave (Soft-Decision Coding):** Argumentan que la fuga de información en la codificación de decisión suave ha sido subestimada.
        *   **Ataques de Manipulación "Divide y Vencerás":** Describen ataques de manipulación para códigos paralelos, códigos concatenados y códigos de decisión suave.
        *   **Esquemas de Selección de Bits:** Refutan la suposición intuitiva de que los esquemas de selección de bits no tienen fugas de información.

    *   **Identificación de Lagunas en la Investigación:** Se identifican problemas abiertos en la investigación actual, proporcionando una base para futuros trabajos. Esto incluye:
        *   La necesidad de modelos de fiabilidad más precisos que capturen la heterogeneidad de las PUF.
        *   La investigación de HDA que sean inherentemente más resistentes a la fuga de información y a los ataques de manipulación.
        *   El desarrollo de métricas y metodologías estandarizadas para evaluar la seguridad de los HDA.
        *   La exploración de PUF y HDA que consideren el ciclo de vida completo del producto, incluyendo la revocación y actualización de claves.

**Metodología Principal:**

El documento emplea un enfoque de **revisión sistemática y análisis crítico**. Los autores analizan la literatura existente sobre HDA, clasificando los diferentes esquemas y técnicas. Luego, aplican un análisis teórico de seguridad para identificar vulnerabilidades y fugas de información que no habían sido completamente reconocidas. Esto implica:

*   **Análisis Matemático:** Derivación de fórmulas exactas para la fuga de entropía en escenarios específicos (ej. códigos de repetición con sesgo).
*   **Análisis de Ataques:** Descripción de ataques específicos de manipulación contra diferentes tipos de HDA.
*   **Evaluación de Modelos:** Comparación de la precisión de los modelos de fiabilidad de PUF.

**Conclusiones:**

El documento concluye que, si bien las PUF son una tecnología prometedora para la generación segura de claves de bajo costo, la implementación de HDA es crítica y compleja. Los HDA deben ser diseñados con una profunda consideración de la seguridad para evitar fugas de información y ataques de manipulación. La investigación actual ha subestimado ciertas vulnerabilidades,

---

## Lightweight encryption with data and device integrity using NLFSR and PUF for the Internet of Medical Things.pdf

El documento "Lightweight encryption with data and device integrity using NLFSR and PUF for the Internet of Medical Things" presenta un esquema de cifrado ligero para garantizar la privacidad, la integridad de los datos y la integridad del dispositivo en entornos de Internet de las Cosas Médicas (IoMT). Los dispositivos IoMT, debido a sus recursos computacionales limitados, no pueden emplear técnicas de seguridad convencionales. La propuesta se centra en un cifrado de flujo basado en un Registro de Desplazamiento con Retroalimentación No Lineal (NLFSR) y un Código de Autenticación de Mensajes (MAC) que utiliza una Función Físicamente Inclonable (PUF).

**1. Puntos Clave:**

*   **Enfoque en IoMT:** Aborda las necesidades de seguridad específicas de los dispositivos IoMT, que son inherentemente limitados en recursos.
*   **Cifrado Ligero:** Propone un cifrado de flujo basado en NLFSR para la confidencialidad de los datos.
*   **Integridad de Datos y Dispositivos:** Introduce un MAC para proteger tanto la integridad de los datos como la autenticidad del dispositivo.
*   **Uso de PUF:** Incorpora una PUF (específicamente, una Arbiter PUF) para generar un parámetro único del dispositivo, resistiendo ataques de clonación y ataques físicos.
*   **Hash Ligero:** Emplea una función hash ligera (Neeva hash function) para la generación del MAC, optimizando el rendimiento en dispositivos con recursos limitados.
*   **Evaluación Rigurosa:** Utiliza el conjunto de pruebas estadísticas NIST 800-22 para evaluar la calidad del cifrado y compara los resultados con cifrados de flujo existentes como RC4, RCCM y PARCCM.

**2. Metodología Principal:**

La propuesta se basa en el diseño de un cifrado de flujo ligero que integra NLFSR y PUF para proporcionar una solución de seguridad integral.

*   **Cifrado de Flujo Basado en NLFSR:**
    *   El NLFSR genera una secuencia de bits pseudoaleatorios (keystream) utilizada para cifrar el texto plano mediante una operación XOR.
    *   La naturaleza no lineal del NLFSR busca mejorar la aleatoriedad y la seguridad del keystream, haciéndolo más resistente a ataques criptoanalíticos.

*   **Mecanismo MAC para Integridad de Datos y Dispositivos:**
    *   El MAC se construye concatenando dos elementos clave:
        1.  **Respuesta de la PUF (Arbiter PUF):** Esta respuesta es única para cada dispositivo y se genera a partir de variaciones físicas microscópicas inherentes al hardware, lo que la hace prácticamente imposible de clonar o falsificar. Sirve para asegurar la autenticidad del dispositivo.
        2.  **Hash del Texto Plano:** Se utiliza una función hash ligera (Neeva hash function) para calcular un hash del mensaje original (texto plano). Esto garantiza la integridad de los datos, detectando cualquier modificación no autorizada.
    *   El MAC resultante se envía junto con el texto cifrado. En el lado del receptor, se recalcula el MAC utilizando la respuesta de la PUF del dispositivo receptor y el hash del texto plano descifrado. La coincidencia de ambos MACs confirma tanto la integridad de los datos como la autenticidad del dispositivo.

*   **Evaluación de la Calidad del Keystream:**
    *   Se utiliza el conjunto de pruebas estadísticas NIST 800-22 para evaluar la aleatoriedad y las propiedades estadísticas del keystream generado por el cifrado propuesto.
    *   Los resultados se comparan con cifrados de flujo conocidos como RC4, RC4 basado en mapeo caótico (RCCM) y RC4 de álgebra de producto (PARCCM) utilizando un conjunto de datos de enfermedades cardíacas.

**3. Resultados Más Importantes:**

*   **Rendimiento en Pruebas NIST 800-22:** El esquema propuesto demuestra un buen rendimiento en las pruebas estadísticas NIST 800-22, superando o igualando a los cifrados de flujo existentes (RC4, RCCM, PARCCM) en términos de aleatoriedad del keystream. Esto valida la calidad criptográfica del NLFSR diseñado.
*   **Confidencialidad y Integridad:** El esquema asegura la confidencialidad de los datos médicos sensibles a través del cifrado de flujo y garantiza la integridad de los datos y la autenticidad del dispositivo mediante el MAC basado en PUF y hash.
*   **Resistencia a Ataques de Clonación:** La integración de la PUF confiere al esquema una resistencia inherente a los ataques de clonación de dispositivos, un problema crítico en entornos IoMT donde los dispositivos pueden ser físicamente accesibles.
*   **Ligereza:** El uso de NLFSR y una función hash ligera, junto con la naturaleza hardware de la PUF, hace que la solución sea adecuada para dispositivos IoMT con recursos limitados, evitando la necesidad de almacenamiento de claves secretas en memoria volátil o costosa.

**4. Conclusiones:**

El documento concluye que el esquema propuesto ofrece una solución de seguridad robusta y ligera para el Internet de las Cosas Médicas. Al combinar un cifrado de flujo basado en NLFSR para la privacidad de los datos con un MAC que utiliza una PUF para la integridad del dispositivo y de los datos, el sistema aborda los desafíos críticos de seguridad en IoMT. La evaluación mediante las pruebas NIST 800-22 demuestra la calidad criptográfica del cifrado. La capacidad de resistir ataques de clonación y la optimización para dispositivos con recursos limitados hacen que esta propuesta sea una opción viable y prometedora para proteger la información médica sensible y garantizar la fiabilidad de los dispositivos en un entorno IoMT. El esquema contribuye a la protección de la privacidad del paciente y al cumplimiento normativo en el ámbito de la salud digital.

---

## PMF-UAV A lightweight and robust PUF-enabled multi-factor authentication and key agreement protocol for UAV-assisted secure communication.pdf

El documento "PMF-UAV: A lightweight and robust PUF-enabled multi-factor authentication and key agreement protocol for UAV-assisted secure communication" aborda la necesidad crítica de una comunicación segura en operaciones de rescate asistidas por Vehículos Aéreos No Tripulados (UAVs).

**1. Problema Abordado:**
Las operaciones de rescate asistidas por UAVs son esenciales para la recolección de datos en zonas de desastre, el monitoreo del tráfico y el retransmisión de señales. Sin embargo, los métodos de autenticación tradicionales que almacenan claves criptográficas en Memoria No Volátil (NVM) hacen que los UAVs sean vulnerables a ataques de suplantación o clonación, especialmente en entornos de alta altitud no supervisados. Las soluciones convencionales requieren hardware adicional o mecanismos de detección, lo que impone una carga computacional significativa en UAVs con capacidades de procesamiento limitadas. Además, los protocolos de autenticación y acuerdo de claves (AKA) basados en PUF existentes sufren riesgos de ataques de modelado debido al almacenamiento explícito de pares de desafío-respuesta (CRP). Los esquemas de autenticación multifactor existentes no han logrado proporcionar las garantías de seguridad prometidas y son susceptibles a ataques de insiders privilegiados y desincronización, además de carecer de seguridad hacia adelante.

**2. Solución Propuesta (PMF-UAV):**
Los autores proponen PMF-UAV, un marco de comunicación segura que integra la función física inclonable (PUF) con autenticación multifactor y un protocolo de acuerdo de claves para sistemas asistidos por UAV. El objetivo principal es proporcionar una solución ligera y robusta que aborde las vulnerabilidades de seguridad y las limitaciones de recursos de los UAVs.

**2.1. Metodología y Componentes Clave:**
*   **Criptografía de Hardware Basada en PUF:** Previene la suplantación física o la clonación de dispositivos de usuario y UAVs. Las PUF se incrustan tanto en los dispositivos de usuario como en los UAVs.
*   **Seguridad Mejorada en el Lado del Usuario:** Incorpora contraseñas y tecnologías biométricas para fortalecer la seguridad del usuario.
*   **Capacidades Anti-Modelado:**
    *   Las respuestas PUF de los UAVs se enmascaran utilizando seudónimos dinámicos.
    *   Las respuestas PUF de los dispositivos de usuario se protegen mediante un mecanismo de fusión de tres factores, evitando la extracción de CRPs.
*   **Mapa Caótico de Chebyshev:** Se emplea durante la negociación de claves de sesión para mejorar la seguridad de la sesión. Este enfoque reduce significativamente los requisitos computacionales y de almacenamiento, conservando la energía del UAV.
*   **Centro de Rescate (RC) como Entidad Honesta pero Curiosa:** El RC participa solo en el proceso de autenticación, excluyéndose del proceso de negociación de la clave de sesión. Esto reduce sustancialmente los riesgos de exposición de la clave de sesión causados por posibles comportamientos maliciosos del RC.

**2.2. Contribuciones Principales:**
1.  **Protocolo de Seguridad Mejorada PMF-UAV:** Integra contraseñas, biometría y respuestas PUF para mejorar la seguridad del lado del usuario. Las PUF incrustadas en dispositivos de usuario y UAVs mitigan las amenazas de suplantación y clonación. Se introduce una técnica novedosa de enmascaramiento de respuestas PUF para resistir ataques de modelado, ocultando las respuestas PUF de los UAVs dentro de seudónimos y encapsulando las respuestas PUF de los dispositivos de usuario a través de un mecanismo de fusión multifactor.
2.  **Negociación de Claves de Sesión con Mapa Caótico de Chebyshev:** Reduce significativamente los requisitos computacionales y de almacenamiento sin comprometer la seguridad, conservando la energía del UAV. La exclusión del RC de la negociación de la clave de sesión reduce los riesgos de exposición de la clave.
3.  **Validación Formal de Seguridad:**
    *   La seguridad de la clave de sesión se verifica rigurosamente utilizando el modelo ROR (Real-or-Random).
    *   La resistencia contra ataques de repetición y Man-in-the-Middle (MITM) se valida eficazmente mediante la herramienta de verificación AVISPA.
    *   Un análisis de seguridad informal integral demuestra una defensa robusta contra ataques de insiders privilegiados, ataques de clonación, ataques de desincronización y ataques de modelado.

**3. Resultados y Evaluación:**
*   **Rendimiento y Eficiencia:** Los experimentos de referencia realizados en un sistema de escritorio y la plataforma Raspberry Pi 5B demuestran que PMF-UAV exhibe un rendimiento superior y ventajas de seguridad mejoradas en comparación con otros enfoques relacionados. Mejora significativamente la eficiencia computacional y reduce la sobrecarga de almacenamiento y comunicación.
*   **Viabilidad y Efectividad:** Una implementación realizada en el simulador de red NS3 con el estándar de comunicación IEEE 802.11p valida la viabilidad y efectividad del esquema propuesto en sistemas asistidos por UAV.

**4. Conclusiones:**
PMF-UAV ofrece una solución integral y robusta para la comunicación segura en entornos asistidos por UAV. Al combinar PUF con autenticación multifactor, técnicas anti-modelado, y el uso de mapas caóticos de Chebyshev, el protocolo aborda eficazmente las limitaciones de recursos y las vulnerabilidades de seguridad inherentes a los UAVs. La validación formal de seguridad y las evaluaciones de rendimiento demuestran que PMF-UAV logra un equilibrio óptimo entre eficiencia y seguridad, convirtiéndolo en un candidato prometedor para futuras implementaciones en escenarios de rescate. El enfoque de diseño ligero y las fuertes garantías de seguridad lo distinguen de las soluciones existentes, que a menudo carecen de resistencia contra ataques de modelado o imponen una carga computacional excesiva.

---

## PUF Based Authenticated Key Exchange Protocol for IoT without Verifiers and Explicit CRPs.pdf

El documento "PUF Based Authenticated Key Exchange Protocol for IoT without Verifiers and Explicit CRPs" aborda un problema crítico en la seguridad del Internet de las Cosas (IoT): la necesidad de que los dispositivos IoT puedan autenticarse entre sí y establecer claves de sesión seguras sin depender de servidores o verificadores externos ni de pares de desafío-respuesta (CRPs) explícitos.

**Puntos Clave y Problema Abordado:**

1.  **Limitaciones de los Protocolos AKE basados en PUF Existentes:** La mayoría de los protocolos de intercambio de claves autenticado (AKE) basados en Funciones Físicas Inclonables (PUF) existentes están diseñados para la autenticación entre un dispositivo IoT y un servidor/verificador específico con el que se registró. Un número limitado de protocolos permite la autenticación entre dispositivos IoT, pero todos requieren la ayuda de verificadores o el uso de CRPs explícitos. Esta dependencia introduce cuellos de botella, puntos únicos de fallo y complejidades en escenarios donde los dispositivos IoT necesitan interactuar de forma ad-hoc.
2.  **La Importancia de las PUF en IoT:** Las PUF proporcionan una "huella digital digital" única para cada dispositivo físico, lo que las convierte en una solución atractiva para la identificación y autenticación en el vasto ecosistema de IoT, que se espera que crezca a 75 mil millones de dispositivos para 2025.
3.  **El Desafío de la Autenticación Peer-to-Peer en IoT:** En entornos como redes ad-hoc inalámbricas (WANET), redes ad-hoc móviles (MANET) o redes ad-hoc vehiculares (VANET), los dispositivos IoT necesitan autenticarse directamente entre sí para establecer comunicaciones seguras. Los protocolos existentes no satisfacen esta necesidad de manera eficiente y segura sin dependencias externas.

**Metodología Principal y Propuesta:**

Los autores proponen el **primer protocolo AKE basado en PUF para IoT que no requiere verificadores ni CRPs explícitos**, permitiendo que los nodos IoT se autentiquen libremente entre sí y creen una clave de sesión de forma autónoma. La metodología se basa en la integración inteligente de las PUF con primitivas criptográficas robustas para lograr autenticación mutua y establecimiento de claves.

Aunque el extracto no detalla el diseño arquitectónico específico, la descripción sugiere que el protocolo:

*   **Evita el Almacenamiento Explícito de CRPs:** Esto es crucial para la seguridad, ya que el almacenamiento de CRPs puede ser vulnerable a ataques de modelado. El protocolo probablemente deriva información necesaria de la PUF de una manera que no requiere almacenar o transmitir CRPs completos.
*   **Elimina la Necesidad de un Verificador Centralizado:** Los dispositivos IoT pueden realizar la autenticación de forma distribuida, lo que es ideal para escenarios ad-hoc y reduce la latencia y la dependencia de la infraestructura.
*   **Utiliza Funciones de un Solo Sentido (PUF):** La naturaleza intrínseca de las PUF, que producen una respuesta única para un desafío dado, es fundamental para la identidad del dispositivo.

**Resultados y Evaluación (Según el Resumen del Documento):**

1.  **Superioridad del Protocolo:** El protocolo propuesto se compara con 27 protocolos AKE basados en PUF relevantes, destacando su superioridad al abordar las limitaciones de la autenticación sin verificadores y CRPs explícitos.
2.  **Eficiencia Computacional:** Se analiza el costo computacional para cada entidad en el protocolo propuesto para demostrar su eficiencia, un aspecto crítico para los dispositivos IoT con recursos limitados.
3.  **Modelo Adversario y Prueba Formal de Seguridad:** Se define un modelo adversario específico para protocolos AKE basados en PUF en IoT. La seguridad del protocolo se prueba formalmente en el modelo de oráculo aleatorio.
4.  **Fundamentos Criptográficos:** La seguridad del protocolo se basa en problemas matemáticos difíciles ampliamente aceptados, como el logaritmo discreto de curva elíptica (ECDL), el problema de Diffie-Hellman computacional de curva elíptica (ECCDH) y el problema de Diffie-Hellman bilineal decisional (DBDH). Esto confiere una fuerte base criptográfica al esquema.

**Conclusiones:**

El documento presenta una contribución significativa al campo de la seguridad de IoT al proponer un protocolo AKE basado en PUF innovador. La principal conclusión es que es posible lograr la autenticación mutua y el intercambio de claves entre dispositivos IoT sin la necesidad de verificadores externos o el manejo explícito de CRPs, lo que resuelve una limitación importante de los protocolos existentes. Esto abre nuevas posibilidades para arquitecturas de seguridad más descentralizadas y robustas en el IoT, especialmente en escenarios ad-hoc. La eficiencia y la seguridad formalmente probada del protocolo, basadas en problemas criptográficos bien establecidos, lo posicionan como una solución prometedora para la autenticación de dispositivos IoT en el futuro.

---

## PUF-IPA - A PUF-based Identity Preserving Protocol for Internet of Things Authentication.pdf

El documento "PUF-IPA: A PUF-based Identity Preserving Protocol for Internet of Things Authentication" propone un protocolo de autenticación basado en PUF para dispositivos IoT que aborda vulnerabilidades de seguridad en enfoques anteriores, especialmente frente a ataques de modelado y brechas en el servidor.

**1. Puntos Clave y Problema Abordado:**

*   **Vulnerabilidad de los sistemas de autenticación basados en PUF:** Los sistemas de autenticación basados en PUF son susceptibles a ataques de repetición (replay attacks) y, más críticamente, a ataques de modelado, donde un atacante puede crear un modelo de software del comportamiento de la PUF del dispositivo a partir de pares de desafío-respuesta (CRP) observados.
*   **Brechas en el servidor:** Las soluciones existentes asumen que el servidor que almacena las credenciales de la PUF es seguro. Sin embargo, si el servidor es comprometido, toda la red de dispositivos IoT puede verse comprometida, ya que los atacantes tendrían acceso a los CRPs o modelos de software de las PUF.
*   **Conservación de la identidad y privacidad:** Es un desafío mantener la identidad y privacidad de la PUF (y por ende del dispositivo) durante la autenticación, especialmente cuando la información crítica se almacena centralmente.
*   **PUF-IPA como solución:** El protocolo PUF-IPA está diseñado para ser robusto contra ataques de fuerza bruta, repetición y modelado, incluso bajo un modelo de amenaza donde el adversario puede realizar ataques pasivos o activos y puede comprometer el servidor que almacena las credenciales de la PUF.

**2. Metodología Principal y Arquitectura:**

PUF-IPA introduce un protocolo de autenticación que no almacena pares de desafío-respuesta (CRPs) completos o parciales, ni modelos de software asociados a la PUF en el servidor. En su lugar, el servidor almacena información ofuscada y no correlacionada sobre la PUF del dispositivo.

*   **Fases del protocolo:**
    *   **Fase de Enrolamiento:** Ocurre en un entorno seguro. Los datos del dispositivo (CRPs) se recolectan. A cada dispositivo se le asigna un identificador único (idx). Se genera una clave de encriptación (K_enc) para cada dispositivo.
    *   **Fase de Autenticación:** Ocurre en un entorno inseguro.
*   **Componentes Clave:**
    *   **Lado del Servidor:** Incorpora un sistema de encriptación AES-128, un comparador y un mecanismo de consulta. Almacena una única clave de encriptación por dispositivo.
    *   **Lado del Dispositivo:**
        *   **Bloque de Autenticación de Flujo (Stream Authentication - SA):** Es el componente central. Verifica la entrada a la PUF. Sus dos propósitos principales son:
            1.  **Preservar la privacidad:** Genera desafíos "sobre la marcha" dentro del dispositivo sin almacenar explícitamente CRPs o un modelo en la base de datos del servidor.
            2.  **Inaccesibilidad del dispositivo:** Hace que el dispositivo sea inaccesible si un adversario intenta suplantar a un verificador legítimo y emite desafíos aleatorios para modelar la PUF subyacente.
        *   **PUF:** La función físicamente inclonable del dispositivo.
        *   **Mecanismo de mezclas de bits (Bit Shuffling):** Los desafíos se generan "sobre la marcha" dentro del dispositivo mediante un algoritmo de mezcla de bits.
        *   **Mecanismo de autocorrección (Self-checking):** PUF-IPA mejora la precisión de la respuesta de la PUF mediante un mecanismo de autocorrección, eliminando la necesidad de costosos códigos de corrección de errores (ECC).

**3. Modelo de Amenaza:**

A diferencia de los enfoques anteriores, PUF-IPA considera un modelo de amenaza más agresivo donde el adversario puede:

*   **Escuchar, manipular y/o repetir datos** en todos los enlaces de comunicación (entre el servidor y los dispositivos, y entre el servidor y sus bases de datos).
*   **Realizar intentos de modelado** en los dispositivos de la red.
*   **Consultar con fuerza bruta** la interfaz abierta del dispositivo con mensajes/desafíos pasados o futuros predichos.
*   **Comprometer el servidor:** El adversario tiene capacidad de "breach" el servidor y acceder a la información almacenada.

**4. Contribuciones Principales:**

*   **Autenticación que preserva la identidad:** Autentica el dispositivo sin almacenar CRPs o un modelo en la memoria del servidor. El servidor autentica basándose en información ofuscada y no correlacionada. La seguridad de los dispositivos permanece intacta incluso si el servidor es comprometido.
*   **Control de acceso a la PUF:** El acceso a la PUF en el dispositivo IoT está controlado. No se emite un desafío ni se genera una respuesta sin la aplicación de un flujo de entrada correcto al dispositivo. Esto bloquea el dispositivo contra el acceso no autorizado y, por lo tanto, inhibe completamente cualquier capacidad de construcción de modelos en la PUF subyacente.
*   **Mecanismo eficiente y ligero:** Ofrece un mecanismo de autenticación ligero con menor sobrecarga de área en comparación con otros mecanismos basados en PUF, al tiempo que proporciona ventajas de seguridad adicionales.
*   **Mejora de la precisión de la respuesta de la PUF:** PUF-IPA mejora la precisión de la respuesta de la PUF del 89% al 98% sin el uso de códigos de corrección de errores (ECC) costosos en hardware.

**5. Resultados y Conclusiones Más Importantes:**

*   **Resiliencia a ataques:** El protocolo PUF-IPA demuestra una mayor resiliencia contra ataques de seguridad (fuerza bruta, repetición, modelado) en comparación con enfoques anteriores, incluso bajo un modelo de amenaza donde el servidor puede ser comprometido.
*   **No almacenamiento de CRPs:** El servidor no almacena CRPs ni modelos de software, lo que lo hace inmune a las brechas de servidor en términos de exposición de la PUF. La información sobre los CRPs de la PUF solo es conocida por el dispositivo.
*   **Generación de desafíos on-the-fly:** Los desafíos se generan "sobre la marcha" dentro del dispositivo mediante un algoritmo de mezcla de bits, lo que reduce la exposición de los CRPs.
*   **Capacidad de "bloqueo" del dispositivo:** El protocolo es el primero en tener la capacidad de bloquear el dispositivo sin siquiera invocar la PUF interna, inhibiendo completamente la capacidad de construcción de modelos.
*   **Mejora de la precisión de la PUF:** Los resultados experimentales muestran que PUF-IPA mejora la precisión de la

---

## PUFatt - Embedded Platform Attestation Based on Novel Processor-Based PUFs.pdf

El documento "PUFatt - Embedded Platform Attestation Based on Novel Processor-Based PUFs" presenta una solución innovadora para la atestación de plataformas embebidas, abordando las limitaciones de los métodos existentes.

**Puntos Clave del Documento:**

*   **Problema Abordado:** Las técnicas de atestación de software actuales, aunque ligeras, son vulnerables a ataques de suplantación de identidad porque no vinculan la atestación a las características únicas del hardware. Las soluciones basadas en hardware seguro (como TPMs) son demasiado costosas y complejas para sistemas embebidos de recursos limitados.
*   **Solución Propuesta (PUFatt):** Un nuevo método automatizable que vincula la atestación basada en software a las características intrínsecas del dispositivo mediante una Función Físicamente Inclonable (PUF) basada en el procesador, llamada **ALU PUF**.
*   **ALU PUF:** Una PUF novedosa que explota las diferencias de retardo en dos Unidades Lógico-Aritméticas (ALUs) idénticamente diseñadas y redundantemente disponibles dentro de un procesador, causadas por variaciones en el proceso de fabricación.
*   **Ventajas de PUFatt:**
    *   Permite la atestación remota y temporizada.
    *   Especialmente adecuada para dispositivos embebidos y de bajo costo.
    *   Bajo overhead de hardware.
    *   Resistente a ataques de suplantación de identidad al vincular la atestación a características de hardware únicas.
    *   El anclaje de confianza (ALU PUF) está estrechamente acoplado a la arquitectura del procesador, frustrando ataques basados en hardware.
*   **Implementación y Evaluación:** Se presenta una implementación de prueba de concepto en FPGA que demuestra la efectividad, aplicabilidad y practicidad del enfoque.
*   **Análisis de Seguridad:** Se analiza el esquema de atestación bajo supuestos realistas, mostrando su solidez y seguridad contra suplantación de identidad y ataques básicos de hardware.

**Metodología Principal:**

1.  **Diseño de la ALU PUF:**
    *   Se basa en la explotación de las diferencias de retardo en rutas simétricas dentro de ALUs idénticas, de manera similar a las Arbiter PUFs.
    *   Las ALUs, componentes fundamentales de cualquier procesador, suelen tener redundancias. El diseño aprovecha estas redundancias.
    *   Para un ejemplo de 4 bits, se utilizan dos ALUs idénticas. Las señales de entrada (el desafío PUF) se aplican simultáneamente a ambas ALUs mediante una lógica de sincronización.
    *   Las salidas de las ALUs se comparan mediante árbitros, que determinan qué señal llega primero, generando así los bits de respuesta de la PUF.
    *   El diseño se puede automatizar fácilmente durante la fase de diseño del procesador, añadiendo una lógica de sincronización mínima y árbitros implementables con flip-flops.
    *   La ALU PUF se consulta utilizando la instrucción "add" del ensamblador. Cuando la ALU está en modo PUF, la instrucción "add" lee el desafío (operandos) de los registros y realiza la operación. La diferencia de tiempo en la disponibilidad de los bits de salida se usa para generar la respuesta PUF.
    *   El diseño se centra en la propagación de acarreo en sumadores de acarreo por propagación, que son componentes básicos de las ALUs.

2.  **Esquema de Atestación Remota PUFatt:**
    *   Construido sobre la ALU PUF, previene ataques de suplantación de identidad al vincular la atestación de software a las características únicas del hardware.
    *   El anclaje de confianza (ALU PUF) está profundamente integrado en la arquitectura del procesador.

3.  **Implementación y Evaluación en FPGA:**
    *   Se implementa la ALU PUF en un FPGA para demostrar su viabilidad.
    *   Se evalúan propiedades clave de las PUF: robustez (estabilidad de la respuesta ante el mismo desafío), inclonabilidad (imposibilidad de producir dos PUFs indistinguibles) e impredecibilidad (dificultad para predecir respuestas a desafíos desconocidos).

4.  **Verificación de Respuestas PUF:**
    *   Se proponen dos enfoques:
        *   Uso de una base de datos de pares desafío/respuesta (CRP) registrados antes del despliegue.
        *   Uso de una PUF de emulación basada en un modelo simple de la PUF (ej. tabla de retardos a nivel de compuerta) generada durante la fabricación.

**Resultados Más Importantes:**

*   La implementación en FPGA valida que la ALU PUF tiene un **bajo overhead de hardware** y es **aplicable** en sistemas embebidos.
*   Se demuestra que la ALU PUF exhibe las propiedades fundamentales de una PUF: **inconabilidad y estabilidad** (robustez). Las variaciones en el proceso de fabricación son suficientes para crear respuestas únicas y consistentes.
*   El esquema PUFatt logra vincular efectivamente la atestación de software al hardware subyacente, superando la vulnerabilidad de suplantación de identidad de los métodos puramente basados en software.
*   El acoplamiento estrecho de la ALU PUF con el procesador la hace resistente a ataques físicos y de hardware.
*   El impacto en el rendimiento de la integración de la ALU PUF es **negligible** en arquitecturas de procesadores segmentados, ya que la etapa de acceso a memoria suele ser el camino crítico.

**Conclusiones:**

El documento "PUFatt" introduce una solución práctica y eficiente para la atestación segura de plataformas embebidas. Al proponer la **ALU PUF**, una novedosa Función Físicamente Inclonable basada en las variaciones de fabricación de las ALUs de un procesador, los autores logran un mecanismo de anclaje de confianza de bajo costo y alto rendimiento. Este enfoque supera las limitaciones de las atestaciones puramente por software (vulnerables a suplantación) y las soluciones de hardware seguro (demasiado costosas para sistemas embebidos). La implementación y evaluación en FPGA confirman la viabilidad y las propiedades de seguridad de la ALU PUF, haciendo de PUFatt una propuesta prometedora para garantizar la integridad y autenticidad de dispositivos en entornos con recursos limitados. La capacidad de automatizar el diseño de la ALU PUF y su mínima sobrecarga de hardware son factores clave para su adopción en la industria.

---
