MarinGE23/axi-plpuf-ip/docu/PUFs_PLPUFs/07_IoT_Applications/resumen_07_IoT_Applications.md

# Resumen de la Carpeta: 07_IoT_Applications

Esta sección presenta un análisis detallado de los documentos PDF contenidos en la carpeta `07_IoT_Applications`, enfocándose en los aspectos clave de cada publicación.

---

## A PUF-based paradigm for IoT security.pdf

El documento "A PUF-based Paradigm for IoT Security" aborda la creciente preocupación por la seguridad en el Internet de las Cosas (IoT), especialmente en dispositivos con recursos limitados. Propone las Funciones Físicamente Inclonables (PUF) como una alternativa ligera a la criptografía tradicional para la autenticación, pero destaca su vulnerabilidad a ataques de modelado. El trabajo principal de este estudio es realizar una evaluación más precisa de la seguridad de las PUF, incorporando el costo del área de implementación, un factor crucial para los dispositivos IoT restringidos que no ha sido suficientemente explorado en la literatura.

**Puntos Clave y Metodología Principal:**

1.  **Contexto del Problema:** El IoT se expande rápidamente, pero la seguridad de sus miles de millones de dispositivos, especialmente aquellos con energía y recursos muy limitados (como etiquetas RFID pasivas, nodos de sensores inalámbricos o implantes médicos), es un desafío crítico. Las soluciones criptográficas estándar son demasiado exigentes para estos dispositivos.
2.  **Las PUF como Solución:** Las PUF de silicio aprovechan la aleatoriedad inherente al proceso de fabricación de los dispositivos CMOS para generar respuestas únicas y confiables a desafíos específicos, actuando como una "huella digital" del hardware. Se clasifican en:
    *   **PUF fuertes:** Tienen un gran espacio de desafío-respuesta que crece exponencialmente con el tamaño de implementación, adecuadas para protocolos de autenticación donde cada par desafío-respuesta (CRP) se usa una sola vez.
    *   **PUF débiles:** Tienen un espacio de desafío-respuesta pequeño y se usan para almacenar claves de forma segura, como alternativa a la memoria no volátil.
3.  **Vulnerabilidad a Ataques de Modelado:** A pesar de su promesa, se ha demostrado que las PUF, particularmente las basadas en retardo como las Arbiter PUF y sus variantes, son vulnerables a ataques de modelado. Un atacante puede recopilar suficientes CRPs y usar algoritmos de aprendizaje automático para construir un modelo de software capaz de predecir las respuestas de la PUF a nuevos desafíos.
4.  **Parámetros de Seguridad de las PUF:** La resistencia de una PUF a ataques de modelado se mide por dos valores:
    *   **NCR (Number of CRPs):** El número de CRPs que deben recopilarse para modelar con éxito la PUF con un 99% de predictibilidad.
    *   **TTM (Time to Model):** El tiempo requerido para modelar exitosamente una PUF, asumiendo que se han recopilado suficientes CRPs.
    Una PUF es segura si requiere un NCR o TTM inviablemente grandes.
5.  **Brecha en la Investigación:** Estudios previos han evaluado la seguridad de diferentes diseños de PUF basándose en NCR y TTM, pero no han considerado el costo del área de implementación, lo cual es fundamental para dispositivos IoT restringidos.
6.  **Enfoque del Trabajo:**
    *   **Implementación de PUF:** Se implementaron varias PUF fuertes basadas en retardo en tecnología CMOS de 45nm para una comparación justa. Estas incluyen:
        *   **Arbiter PUF:** Compara los retardos de dos rutas idénticas.
        *   **XOR-Arbiter PUF:** Combina varias filas de Arbiter PUF mediante compuertas XOR para aumentar la resistencia al modelado.
        *   **Lightweight Secure PUF (LS PUF):** Introduce redes de entrada y salida para reorganizar desafíos y combinar salidas, respectivamente, mejorando la distancia de Hamming y el rendimiento.
        *   **Feed Forward (FF) Arbiter PUF:** Introduce no linealidad mediante rutas de alimentación hacia adelante (feed forward).
    *   **Evaluación de Eficiencia:** El objetivo central es comparar la seguridad de estas PUF (NCR y TTM) en relación con su **costo de área de implementación**. Esto permite determinar la eficiencia real de una PUF para proporcionar seguridad por unidad de área.
    *   **Clasificación de Esquemas de Seguridad IoT con PUF:** Se clasifican los esquemas de seguridad basados en PUF en aplicaciones IoT según el nivel de accesibilidad de los CRPs por parte de un adversario:
        *   **CRPs Ocultos:** Los CRPs están completamente ocultos al adversario, a menudo mediante funciones criptográficas o pseudo-criptográficas y/o protección contra ataques de sondeo físico. Se asume que el modelado es imposible. Se recomienda la PUF con menor área.
        *   **CRPs de Acceso Limitado:** El adversario solo puede recopilar un número limitado de CRPs. La seguridad depende principalmente de un alto NCR.
        *   **CRPs Totalmente Accesibles:** El adversario puede recopilar un gran número de CRPs. La seguridad depende de un TTM muy alto o de otras contramedidas.

**Resultados y Conclusiones (basados en la introducción y el abstract):**

*   **Impacto del Área de Implementación:** Los resultados muestran que, al considerar el costo del área de implementación, la evaluación de la seguridad de las PUF cambia significativamente. Algunos diseños de PUF mejorados, que se consideraban más seguros, resultaron tener una eficiencia inferior en comparación con sus contrapartes más simples cuando se tiene en cuenta el área que ocupan. Esto sugiere que la complejidad adicional para mejorar la seguridad no siempre justifica el aumento del área en entornos restringidos.
*   **Recomendaciones para IoT:** Basado en las cifras de eficiencia obtenidas (seguridad por unidad de área), el estudio recomienda el diseño óptimo de PUF para cada uno de los diferentes esquemas de seguridad utilizados en dispositivos IoT restringidos.
*   **Implicaciones:** La investigación subraya la necesidad de considerar no solo la resistencia a ataques de modelado, sino también la "eficiencia de seguridad" en términos de consumo de área y recursos al seleccionar PUF para aplicaciones IoT. Un diseño simple podría ser más eficiente en algunos escenarios que uno complejo y aparentemente más seguro, si el costo de área del segundo es desproporcionadamente alto.

En resumen, este documento presenta un análisis crítico de la seguridad de las PUF en el contexto del IoT, introduciendo la métrica de eficiencia que relaciona la seguridad contra ataques de modelado con el costo del área de implementación. Al hacerlo, proporciona una guía más pragmática para la selección de diseños de PUF en dispositivos IoT con recursos extremadamente limitados, concluyendo que la simplicidad puede ser preferible a la complejidad si la eficiencia general (seguridad por unidad de área) se ve comprometida.

---

## Physical Unclonable Functions (PUF) for IoT Devices.pdf

El documento "Physical Unclonable Functions (PUF) for IoT Devices" es un artículo de encuesta exhaustivo que aborda el uso de las Funciones Físicas Inclonables (PUF) como una alternativa prometedora a la criptografía convencional para la seguridad de los dispositivos del Internet de las Cosas (IoT). Publicado en ACM Computing Surveys en diciembre de 2023, este trabajo de Abdulaziz Al-Meer y Saif Al-Kuwari de la Universidad Hamad Bin Khalifa, Qatar, busca proporcionar una revisión integral del estado del arte de las PUF, sus arquitecturas, protocolos y aspectos de seguridad específicos para el entorno IoT.

**Puntos Clave y Motivación:**

La seguridad de los dispositivos IoT es una preocupación creciente debido a su ubicuidad y la sensibilidad de los datos que manejan. La criptografía tradicional a menudo no es adecuada para los dispositivos IoT, ya que requiere una alta capacidad computacional que agota la batería y es costosa. Además, la distribución de claves en entornos IoT masivos presenta desafíos significativos, y el avance de la computación cuántica amenaza la seguridad de los algoritmos criptográficos actuales.

Las PUF emergen como una solución de seguridad ligera y de bajo costo que aprovecha las variaciones inevitables del proceso de fabricación de los circuitos integrados (IC) para generar claves secretas únicas y autenticar dispositivos. Estas variaciones físicas son imposibles de replicar con precisión, lo que confiere a las PUF sus propiedades de inclonabilidad y unicidad.

A diferencia de encuestas anteriores, este trabajo se distingue por su enfoque integral en la evaluación del rendimiento y las métricas de calidad de las PUF, la revisión de protocolos de autenticación recientes para dispositivos ligeros, la exploración de arquitecturas de PUF implementadas en FPGAs y ASICs, y un análisis detallado de las amenazas y ataques comunes, así como la identificación de problemas abiertos y futuras direcciones de investigación.

**Metodología Principal:**

El documento adopta un enfoque de revisión sistemática, categorizando y analizando una amplia gama de literatura sobre PUF. La metodología se estructura en varias secciones clave:

1.  **Fundamentos de las PUF:** Se comienza definiendo qué es una PUF, sus propiedades esenciales (unicidad, inclonabilidad, aleatoriedad, impredecibilidad) y su operación general basada en pares desafío-respuesta (CRP).
2.  **Métricas de Evaluación de Rendimiento y Calidad:** Se investigan las métricas críticas para evaluar la calidad y el rendimiento de una PUF, incluyendo:
    *   **Unicidad (Uniqueness):** Mide la variación entre las respuestas de diferentes PUF fabricadas con el mismo diseño, idealmente cercana al 50%.
    *   **Fiabilidad (Reliability):** Cuantifica la consistencia de la respuesta de una PUF ante el mismo desafío bajo diferentes condiciones ambientales (temperatura, voltaje), buscando alta fiabilidad.
    *   **Aleatoriedad (Randomness):** Evalúa la distribución uniforme de bits en la respuesta.
    *   **Entropía (Entropy):** Mide la impredecibilidad de las respuestas.
    *   **Estabilidad (Stability):** Relacionada con la fiabilidad, pero enfocada en la resistencia a cambios ambientales a largo plazo.
    *   **Robustez (Robustness):** Capacidad de la PUF para resistir ataques.
3.  **Protocolos de Autenticación de PUF para IoT:** Se revisan y comparan protocolos de autenticación recientes diseñados específicamente para dispositivos IoT ligeros, destacando cómo mitigan ataques comunes.
4.  **Arquitecturas de PUF:** Se describen las arquitecturas populares de PUF, analizando sus fortalezas, debilidades y el rendimiento para diferentes diseños de circuitos. Se presta especial atención a las implementaciones en FPGAs y ASICs.
5.  **Amenazas y Ataques a las PUF:** Se examinan los ataques más comunes contra las PUF, como ataques de modelado, ataques físicos (side-channel attacks), ataques de clonación y ataques de suplantación de identidad, y se discuten las contramedidas.
6.  **Problemas Abiertos y Direcciones Futuras:** Se identifican las brechas en la investigación actual y se proponen áreas para futuros trabajos.

**Resultados y Conclusiones Más Importantes:**

El estudio destaca que las PUF ofrecen una solución de seguridad atractiva para IoT debido a su bajo costo, bajo consumo de energía y su capacidad para generar identidades únicas basadas en las características físicas intrínsecas de cada chip.

*   **Ventajas de las PUF:**
    *   **Seguridad Ligera:** Adecuadas para dispositivos IoT con recursos limitados.
    *   **Resistencia a la Computación Cuántica:** Su seguridad no depende de la dificultad de problemas matemáticos, lo que las hace resistentes a futuros ataques cuánticos.
    *   **No Requiere Almacenamiento de Claves:** Las claves se generan bajo demanda, eliminando la necesidad de almacenar secretos en memoria no volátil.
    *   **Inclonabilidad Física:** Las variaciones de fabricación hacen que sea prácticamente imposible clonar o duplicar un dispositivo con la misma PUF.
    *   **Autenticación y Generación de Claves:** Pueden usarse tanto para autenticar dispositivos como para derivar claves criptográficas.

*   **Desafíos y Ataques:** A pesar de sus ventajas, las PUF no son infalibles. Los ataques de modelado son una preocupación significativa, donde un adversario puede construir un modelo matemático de la PUF a partir de un número suficiente de CRPs. Otros ataques incluyen ataques de canal lateral (analizando consumo de energía, tiempos, etc.) y ataques físicos directos.

*   **Tipos de PUF y su Implementación:** El documento analiza diversas arquitecturas de PUF, como las basadas en osciladores de anillo (RO-PUF), las basadas en SRAM (SRAM-PUF), las basadas en latches (Flip-Flop PUF), y otras, detallando cómo se explotan las variaciones físicas en cada caso. La implementación en FPGAs es un área de interés creciente debido a su flexibilidad y reconfigurabilidad.

*   **Necesidad de Extractores Difusos (Fuzzy Extractors):** Las respuestas de las PUF no son perfectamente estables. Para obtener claves criptográficas determinísticas y estables, se requieren extractores difusos y códigos de corrección de errores (ECC) para compensar la variabilidad en las respuestas de la PUF bajo diferentes condiciones ambientales.

*   **Problemas Abiertos y Futuras Direcciones:**
    *   **Robustez ante Ataques de Modelado:** Se necesita más investigación en el diseño de PUF que sean inherentemente más resistentes a los ataques de modelado.
    *   **Mejora de la Fiabilidad:** Desarrollar PUF que mantengan una alta fiabilidad en un rango más amplio

---

## XOR-based low-cost reconfigurable PUFs for IoT security.pdf

## Resumen Detallado del Artículo "XOR-Based Low-Cost Reconfigurable PUFs for IoT Security"

Este artículo aborda la creciente necesidad de soluciones de seguridad de bajo costo y alta eficiencia para los dispositivos del Internet de las Cosas (IoT), que son inherentemente limitados en recursos. Propone y evalúa dos nuevas funciones físicamente inclonables (PUF) reconfigurables basadas en puertas XOR, denominadas XOR-based Reconfigurable Bistable Ring PUF (XRBR PUF) y XOR-based Reconfigurable Ring Oscillator PUF (XRRO PUF), con el objetivo de mejorar la seguridad del IoT.

### 1. Contexto y Motivación

El rápido crecimiento del IoT ha traído consigo importantes desafíos de seguridad. Las soluciones criptográficas tradicionales, diseñadas para entornos con más recursos, no son adecuadas para los dispositivos IoT, que suelen ser de bajo consumo y con recursos limitados. Las PUF se presentan como una alternativa prometedora, ya que extraen identidades únicas de las variaciones inherentes al proceso de fabricación de los circuitos integrados (IC), actuando como una "huella digital" de hardware. Estas PUF permiten la generación de claves en línea o la autenticación de ICs de forma segura y a bajo costo, sin necesidad de almacenar claves en memorias no volátiles (NVM), que son vulnerables a ataques. Sin embargo, muchas PUF existentes consumen recursos de hardware significativos, lo que limita su aplicabilidad en el IoT.

### 2. Puntos Clave y Contribuciones

El artículo se centra en el diseño de PUF reconfigurables (RPUF) de bajo costo y alta eficiencia para la seguridad del IoT. Las principales contribuciones son:

*   **Nueva Clasificación de RPUF:** Se propone una nueva clasificación para las RPUF, distinguiendo entre RPUF basadas en circuitos (C-RPUF) y RPUF basadas en algoritmos (A-RPUF). Esta clasificación ayuda a entender mejor las diferentes arquitecturas y sus implicaciones.
*   **Propuesta de XRBR PUF:** Se introduce una novedosa PUF reconfigurable basada en un anillo biestable (XRBR PUF) que utiliza puertas XOR para mejorar la eficiencia y el rendimiento.
*   **Propuesta de XRRO PUF:** Se propone una PUF reconfigurable basada en un oscilador de anillo (XRRO PUF) que también incorpora puertas XOR para optimizar el uso de recursos.
*   **Implementación y Evaluación en FPGAs:** Ambas PUF propuestas (XRBR y XRRO) son implementadas y evaluadas en FPGAs Xilinx Spartan-6, y sus resultados se comparan con diseños de PUF anteriores.
*   **Alta Eficiencia en Costo de Hardware:** Se demuestra que los diseños propuestos son altamente eficientes en términos de costo de hardware, requiriendo significativamente menos recursos que las PUF reconfigurables y biestables de anillo previas.

### 3. Metodología Principal

La metodología del estudio se basa en el diseño y la implementación de dos nuevas arquitecturas de PUF reconfigurables, seguidas de una evaluación exhaustiva de sus características de seguridad y eficiencia en hardware.

*   **Diseño de XRBR PUF:** Esta PUF se basa en el concepto de un anillo biestable, que explota las variaciones de retardo en los componentes de hardware para generar bits aleatorios. La incorporación de puertas XOR permite reconfigurar el camino de la señal y, por ende, generar una mayor cantidad de pares desafío-respuesta (CRP) con menos recursos.
*   **Diseño de XRRO PUF:** Similarmente, la XRRO PUF se basa en la comparación de frecuencias de osciladores de anillo. Las puertas XOR se utilizan para seleccionar y combinar las salidas de múltiples osciladores de anillo, creando una estructura reconfigurable que maximiza la unicidad y la robustez con una huella de hardware reducida.
*   **Implementación:** Ambas PUF se implementaron en FPGAs Xilinx Spartan-6. La elección de FPGAs permite una evaluación flexible y una comparación justa con otros diseños basados en FPGA.
*   **Métricas de Evaluación:** Se evaluaron las PUF utilizando métricas estándar:
    *   **Unicidad (Uniqueness):** Mide la capacidad de cada PUF para producir una respuesta única en diferentes chips. Se calcula utilizando la distancia de Hamming inter-chip idealmente del 50%.
    *   **Fiabilidad (Reliability):** Mide la consistencia de las respuestas de una PUF en el mismo chip bajo diferentes condiciones ambientales (temperatura, voltaje) o a lo largo del tiempo. Se calcula utilizando la distancia de Hamming intra-chip, idealmente del 0%.
    *   **Eficiencia de Hardware:** Cuantifica los recursos de FPGA utilizados (LUTs, flip-flops) para generar un bit de respuesta, comparando con diseños existentes.

### 4. Resultados Más Importantes

Los resultados de la implementación y evaluación en FPGAs Xilinx Spartan-6 son altamente positivos:

*   **Unicidad y Fiabilidad:** Ambas XRBR y XRRO PUF demostraron buena unicidad y fiabilidad, comparables o superiores a muchos diseños de PUF previos. Los valores de distancia de Hamming inter-chip se acercaron al 50%, y la distancia de Hamming intra-chip fue baja, indicando una buena estabilidad.
*   **Eficiencia de Hardware Superior:** Este es el resultado más significativo.
    *   La **XRRO PUF** se identificó como el diseño más eficiente en comparación con las RPUF anteriores.
    *   Tanto la **XRBR PUF** como la **XRRO PUF** requieren solo el **12.5% de los recursos de hardware** de las PUF biestables de anillo y las PUF de oscilador de anillo reconfigurables previas, respectivamente, para generar un bit de respuesta. Esto representa una mejora sustancial en la eficiencia de hardware.
    *   Esta reducción drástica en el consumo de recursos las hace particularmente adecuadas para dispositivos IoT con limitaciones severas.

### 5. Conclusiones

El artículo concluye que las PUF reconfigurables basadas en XOR propuestas (XRBR PUF y XRRO PUF) son soluciones muy eficientes y prometedoras para la seguridad en entornos IoT.

*   **Viabilidad para IoT:** Su bajo costo de hardware, combinado con una buena unicidad y fiabilidad, las posiciona como candidatas ideales para proporcionar primitivas de seguridad en dispositivos IoT con recursos limitados.
*   **Avance en RPUF:** La nueva clasificación de RPUF y el diseño innovador de las PUF basadas en XOR contribuyen al avance en el campo de las PUF reconfigurables.
*   **Potencial de Aplicación:** Estas PUF pueden ser utilizadas para la generación de claves, autenticación de dispositivos y protección contra clonación en el vasto ecosistema del

---
