MarinGE23/axi-plpuf-ip/docu/Informe_TFG_EmanuelMarin.pdf

### Tecnológico de Costa Rica

### Escuela de Ingeniería en Computadores

(Computer Engineering School)

### Programa de Licenciatura en Ingeniería en Computadores

(Licentiate Degree Program in Computer Engineering)

### Diseño e Integración de un Módulo PLPUF Programable para Sistemas Embebidos

(Design and Integration of a Programmable PLPUF Module for Embedded Systems)

### Informe de Trabajo de Graduación para optar por el título de Ingeniero en Computadores con grado académico de Licenciatura

(Report of Graduation Work in fulfillment of the requirements for the degree of Licentiate in Computer Engineering)

### Emanuel Antonio Marín Gutiérrez

Cartago, Junio, 2026

(Cartago, June, 2026)

# Dedicatoria

A mi querida mamá, a mi familia y a mis amigos.

# Agradecimientos

A mi querida mamá, a mi familia y a mis amigos, por su apoyo incondicional a lo largo de toda mi formación universitaria. Su confianza y paciencia fueron el motor que me permitió llegar hasta aquí.

A los profesores de la Escuela de Ingeniería en Computadores y la Escuela de Ingeniería en Electrónica del Instituto Tecnológico de Costa Rica, quienes con su dedicación y exigencia me transmitieron no solo conocimientos técnicos, sino también la disciplina y la curiosidad necesarias para enfrentar problemas complejos. Cada curso, cada laboratorio y cada proyecto contribuyó a forjar al ingeniero que soy hoy.

Agradezco especialmente al Dr. Jeferson González Gómez, quien me asignó este trabajo final de graduación y confió en mis capacidades para llevarlo a cabo. Su conocimiento en el área de seguridad de hardware fue determinante para definir el rumbo del proyecto.

A todos quienes de una u otra forma contribuyeron a la realización de este proyecto, mi más sincero agradecimiento.

Emanuel Antonio Marín Gutiérrez

Cartago, June, 2026

# Resumen

Este proyecto presenta el diseño, implementación e integración de un módulo de Función Físicamente No Clonable basado en la arquitectura Pseudo-LFSR (PLPUF) como periférico dentro de un System-on-Chip (SoC) sobre FPGA. El módulo explota las variaciones físicas inherentes al proceso de fabricación del silicio para generar identificadores de hardware únicos de 128 bits, eliminando la necesidad de almacenar claves criptográficas en memorias no volátiles. El sistema completo integra el PLPUF como periférico AXI4-Lite controlado por el procesador suave MicroBlaze V sobre la plataforma Basys 3 con FP-GA Artix-7, permitiendo la evaluación automatizada de pares desafío-respuesta mediante comunicación UART.

Para el desarrollo del proyecto se utilizó el lenguaje de descripción de hardware Verilog para la implementación del núcleo PLPUF y la interfaz AXI4-Lite, AMD Vivado para la síntesis, implementación y generación del bitstream, y AMD Vitis para el desarrollo del firmware de control en lenguaje C. La evaluación estadística del módulo se realizó mediante 10 ejecuciones independientes sobre un mismo dispositivo FPGA, acumulando más de 140 000 evaluaciones del PLPUF. Se midieron las métricas estándar de la literatura: uniformidad (47–51 %), confiabilidad (98.97 % para duración de activación c = 1), distancia de Hamming intra-dispositivo (1.31 bits) y distancia de Hamming inter-desafío (48.48 %).

Los resultados demuestran que el módulo implementado exhibe propiedades estadísticas consistentes con las reportadas para la arquitectura PLPUF original, validando su correcta portabilidad a la familia FPGA Artix-7 y aportando una plataforma abierta y reproducible para la investigación en seguridad de hardware basada en PUFs.

Palabras clave: PUF, PLPUF, FPGA, AXI4, MicroBlaze V, Seguridad de hardware.

# Abstract

This project presents the design, implementation and integration of a Physical Unclonable Function module based on the Pseudo-LFSR (PLPUF) architecture as a peripheral within an FPGA-based System-on-Chip (SoC). The module exploits the inherent physical variations of the silicon manufacturing process to generate unique 128-bit hardware identifiers, eliminating the need to store cryptographic keys in non-volatile memories. The complete system integrates the PLPUF as an AXI4-Lite peripheral controlled by the MicroBlaze V soft processor on the Basys 3 platform with an Artix-7 FPGA, enabling automated challenge-response pair evaluation through UART communication.

For the development of this project, the Verilog hardware description language was used for the implementation of the PLPUF core and the AXI4-Lite interface, AMD Vivado for synthesis, implementation and bitstream generation, and AMD Vitis for the development of the control firmware in C. The statistical evaluation of the module was performed through 10 independent runs on a single FPGA device, accumulating over 140 000 PLPUF evaluations. Standard metrics from the literature were measured: uniformity (47–51 %), reliability (98.97 % for activation duration c = 1), intra-device Hamming distance (1.31 bits) and inter-challenge Hamming distance (48.48 %).

The results demonstrate that the implemented module exhibits statistical properties consistent with those reported for the original PLPUF architecture, validating its correct portability to the Artix-7 FPGA family and providing an open and reproducible platform for hardware security research based on PUFs.

Keywords: PUF, PLPUF, FPGA, AXI4, MicroBlaze V, Hardware security.

´

# Indice general

Página

1.1.2 | Area de conocimiento del proyecto | ´ | 2

Índice general | ii
2.4.2 | Métricas de evaluación: unicidad, confiabilidad y uniformidad .... | 20

Índice general | iii

´

# Indice de figuras

Página

2.1 Diagrama de bloques del procesador MicroBlaze V [1] | 9
2.2 Canales de escritura del protocolo AXI: canal de dirección (AW),
canal de datos (W) y canal de respuesta (B) [2] | 10
2.3 Canales de lectura del protocolo AXI: canal de dirección (AR)
y canal de datos (R) [2] | | 10
2.4 Placa de desarrollo Basys 3 con FPGA Artix-7 [3] | | 12
2.5 Estructura del Pseudo-LFSR PUF de 128 bits: cadena de celdas
de lógica central con compuertas XOR en las posiciones de tap
y retroalimentación desde Dout[1] hacia la primera celda [4] | 16
2.6 Estructura interna de una celda de lógica central: multiplexor
controlado por SEL e inversor como fuente de entropía [4] | 16
2.7 Máquina de estados del PLPUF: ciclo de evaluación desafío-respuesta con las señales de control y las condiciones de tran-
sición entre los estados IDLE, LOAD, ACTIVE y DONE | 17

3.1 Metodología secuencial por fases del proyecto. Cada fase se
alinea con un objetivo específico (OE) y produce entregables
verificables que habilitan la fase siguiente | 24
3.2 Diagrama general de la solución: sistema SoC con PLPUF integrado. Los colores agrupan los componentes por función y los
números indican el flujo de operación | 28
3.3 Diagrama de primer nivel del módulo plpuf core: interfaz de
puertos con anchos de señal | 29
3.4 Diagrama del diseño de la interfaz AXI4-Lite: los canales AXI
comunican el bus con el bloque de registros, que a su vez controla
el núcleo PLPUF | 32
3.5 Jerarquía de módulos del IP AXI PLPUF: tres niveles de encapsulamiento con el wrapper, el esclavo AXI4-Lite (registros y
FSM AXI) y el núcleo PLPUF | 34

Índice de figuras | v

3.6 Diseño de bloques del sistema SoC en Vivado IP Integrator,
mostrando la interconexión entre el procesador MicroBlaze V, la
memoria local (BRAM/LMB), el módulo de depuración (MDM V),
el AXI SmartConnect, el periférico UART Lite y el periférico
PLPUF desarrollado en este proyecto | 36
3.7 Arquitectura en capas del software de control: las aplicaciones
de prueba utilizan el driver del PLPUF, que a su vez accede a los
registros del periférico mediante operaciones de lectura/escritura AXI. ... 37 3.8 Diagrama de flujo de la función Plpuf Evaluate(): ciclo com-
pleto de evaluación desafío-respuesta | | 38
4.1 Resultados obtenidos al ejecutar test app1 | | 46
4.2 Verificación de la interfaz de registros y funcionalidad de reinicio suave. .. | 47
4.3 Barrido de duración de activación (c = 1 . . . 10): uniformidad,
fiabilidad, BER, IntraHD e InterHD | 48
4.4 Respuestas crudas (50 evaluaciones) y respuesta golden (mayoría
de votos) para el desafío 0 con c = 5 | 49
4.5 Mapa de estabilidad por bit (grado 9 = estable, 0 = ruidoso) e
histograma de distancias de Hamming intra-dispositivo para c = 5 | 50
4.6 Efecto avalancha para c = 5: distancia de Hamming (en bits y
porcentaje) al modificar cada bit del desafío | 51
4.7 Resumen de métricas del PLPUF en función de la duración de
activación c. Las barras de error representan ±1σ sobre 10 ejecuciones independientes. (a) Uniformidad, (b) confiabilidad,
(c) HD intra-dispositivo, (d) HD inter-desafío | 53
4.8 Uniformidad del PLPUF en función de la duración de activación c (media ±1σ, n = 10). La línea discontinua roja indica
el valor ideal de 50 % | 54
4.9 Confiabilidad (eje izquierdo) y BER (eje derecho) en función de
la duración de activación c (media ±1σ, n = 10) | 55
4.10 Distancia de Hamming intra-dispositivo promedio en función de
la duración de activación c (media ±1σ, n = 10) | 55
4.11 Distancia de Hamming inter-desafío (como porcentaje de los
128 bits) en función de la duración de activación c (media ±1σ,
n = 10). La línea discontinua roja indica el ideal de 50 % | 56
4.12 Efecto avalancha del PLPUF a c = 5: porcentaje de bits que
cambian en la respuesta al invertir un solo bit del desafío (media
±1σ, n = 10). La línea discontinua roja indica el ideal de 50 %
y la línea punteada verde el promedio observado | 57

´

# Indice de tablas

Página

3.1 Propuesta metodológica por objetivo específico | | 26
3.2 Interfaz de puertos del módulo plpuf core | | 29
3.3 Parámetros configurables del módulo plpuf core | | 30
3.4 Mapa de registros del periférico AXI PLPUF | | 32
3.5 Mapa de direcciones del sistema SoC | | 35

4.1 Utilización de recursos del sistema SoC completo sobre la FPGA
Artix-7 XC7A35T tras la implementación física | 45
4.2 Utilización de recursos del periférico AXI PLPUF y del proce-
sador MicroBlaze V, según el reporte de síntesis individual | 45
4.3 Resultados del barrido de duración (media ± desviación estándar,
n = 10 ejecuciones, 20 desafíos × 50 repeticiones por corrida) | | 52
4.4 Comparación de resultados con la evaluación de referencia de Hori et al. [4]. | 57

# Lista de abreviaciones

AMBA | Advanced Microcontroller Bus Architecture – Arquitectura de bus de micro-
| controlador avanzado
ASIC | Application-Specific Integrated Circuit – Circuito integrado de aplicación es-
| pecífica
AXI | Advanced eXtensible Interface – Interfaz extensible avanzada
BER | Bit Error Rate – Tasa de error de bit
BRAM | Block RAM – Bloque de memoria RAM dentro de la FPGA
BSP | Board Support Package – Paquete de soporte de tarjeta
CRP | Challenge-Response Pair – Par desafío-respuesta
DRC | Design Rule Check – Verificación de reglas de diseño
DSP | Digital Signal Processor – Procesador digital de señales
FAR | False Acceptance Rate – Tasa de falsa aceptación
FF | Flip-Flop – Biestable
FPGA | Field Programmable Gate Array – Arreglo de compuertas programable en
| campo
FRR | False Rejection Rate – Tasa de falso rechazo
FSM | Finite State Machine – Máquina de estados finitos
HD | Hamming Distance – Distancia de Hamming
HDA | Helper Data Algorithm – Algoritmo de datos auxiliares
HDL | Hardware Description Language – Lenguaje de descripción de hardware
IoT | Internet of Things – Internet de las cosas
IP | Intellectual Property – Propiedad intelectual (núcleo IP)
ISA | Instruction Set Architecture – Arquitectura del conjunto de instrucciones
JTAG | Joint Test Action Group – Estándar IEEE 1149.1 de depuración
LFSR | Linear Feedback Shift Register – Registro de desplazamiento con retroalimen-
| tación lineal
LMB | Local Memory Bus – Bus local de memoria
LUT | Look-Up Table – Tabla de búsqueda
MDM | MicroBlaze Debug Module – Módulo de depuración de MicroBlaze

vii

Índice de tablas | viii
MMIO | Memory-Mapped I/O – Entrada/salida mapeada en memoria
NCR | Number of CRPs – Número de pares desafío-respuesta requeridos para mo-
delar una PUF
NLFSR Non-Linear Feedback Shift Register – Registro de desplazamiento con retroalimentación no lineal
NLPUF | Non-Linear PUF – PUF basada en lógica no lineal
PLL | Phase-Locked Loop – Lazo de fase enganchada
PLPUF | Pseudo-LFSR PUF – PUF basada en pseudo-LFSR
PRNG | Pseudo-Random Number Generator – Generador de números pseudoaleato-
rios
PUF | Physical Unclonable Function – Función físicamente no clonable
RISC-V | Reduced Instruction Set Computer V – Arquitectura abierta de conjunto de
instrucciones reducido
RO-PUF | Ring Oscillator PUF – PUF basada en oscilador de anillo
SoC | System-on-Chip – Sistema en chip
SRAM | Static Random Access Memory – Memoria estática de acceso aleatorio
TMR | Triple Modular Redundancy – Redundancia modular triple
TTM | Time to Model – Tiempo computacional para modelar una PUF
UART | Universal Asynchronous Receiver-Transmitter – Receptor y transmisor
asíncrono universal
XDC | Xilinx Design Constraints – Archivo de restricciones de diseño
XOR | Exclusive OR – Compuerta lógica O-exclusiva
XSA | Xilinx Support Archive – Archivo de soporte de Xilinx

# Capítulo 1

# Introducción

La seguridad en los sistemas embebidos ha adquirido un papel fundamental debido al crecimiento acelerado del Internet de las Cosas (IoT), los dispositivos móviles y las infraestructuras industriales interconectadas. En este nuevo escenario tecnológico, millones de dispositivos operan de forma distribuida y, en muchos casos, en entornos físicamente accesibles, lo que incrementa significativamente la superficie de ataque [5]. Como consecuencia, garantizar la autenticidad, integridad y confiabilidad de cada dispositivo se convierte en un requisito esencial para prevenir clonación, falsificación y accesos no autorizados.

Tradicionalmente, la seguridad criptográfica se fundamenta en el uso de claves secretas almacenadas en memorias no volátiles. Sin embargo, este enfoque introduce una debilidad estructural: la información sensible permanece físicamente almacenada dentro del dispositivo, quedando expuesta a ataques invasivos y semi-invasivos capaces de extraer las claves directamente del hardware [6]. Esta problemática es especialmente crítica en plataformas embebidas de bajo costo y recursos limitados, donde la incorporación de mecanismos avanzados de protección física resulta compleja o económicamente inviable.

Ante esta limitación, las Funciones Físicamente No Clonables (PUFs, por sus siglas en inglés Physical Unclonable Functions) han emergido como una alternativa prometedora para el establecimiento de raíces de confianza en hardware. Las PUFs explotan las variaciones físicas inherentes al proceso de fabricación de los circuitos integrados para generar respuestas únicas e irrepetibles, eliminando la necesidad de almacenar claves criptográficas de forma permanente. Gracias a esta propiedad, las PUFs permiten implementar mecanismos de autenticación, identificación de dispositivos y generación dinámica de claves con un nivel elevado de resistencia frente a ataques físicos [5, 7].

Dentro de las múltiples arquitecturas existentes, la variante PLPUF (Pseudo Linear Feedback Shift Register PUF) representa una solución particularmente atractiva para plataformas reconfigurables. A diferencia de otras implementaciones basadas en retardos o elementos de memoria, el PLPUF emplea lógica combinacional para generar respuestas multibit a partir de un único desafío, logrando una implementación compacta, eficiente en

1

1 Introducción | 2

área y altamente parametrizable [4]. Estas características lo convierten en un candidato idóneo para su integración en sistemas embebidos modernos basados en FPGA.

En este contexto, el presente trabajo propone el diseño, implementación e integración de un módulo PLPUF programable como periférico dentro de un System-on-Chip (SoC) basado en FPGA. El módulo se conecta mediante la interfaz estándar AXI y es controlado por el procesador suave MicroBlaze V sobre la plataforma Basys3 con FPGA Artix-7. Este enfoque elimina la dependencia de almacenamiento persistente de claves, fortaleciendo la seguridad a nivel físico, y provee una plataforma experimental para evaluar esquemas de autenticación y generación dinámica de claves en sistemas embebidos con recursos limitados.

De esta manera, el proyecto se posiciona en la intersección entre el diseño de sistemas embebidos y la seguridad de hardware, contribuyendo al desarrollo de soluciones abiertas, reconfigurables y reproducibles orientadas a fortalecer la seguridad desde el propio nivel físico del dispositivo.

## 1.1 Antecedentes del proyecto

### 1.1.1 Descripción de la institución

El Instituto Tecnológico de Costa Rica (TEC) es una institución pública de educación superior fundada en 1971 con el propósito de impulsar el desarrollo científico y tecnológico del país. A lo largo de su trayectoria, el TEC se ha consolidado como un referente nacional en formación profesional e investigación aplicada, destacándose por su enfoque en innovación tecnológica, excelencia académica y compromiso con el desarrollo sostenible [8].

El presente proyecto se desarrolla en la Escuela de Ingeniería en Computadores, unidad académica orientada a la integración de conocimientos en Electrónica y Ciencias de la Computación. Esta escuela promueve activamente la participación estudiantil en proyectos de investigación y desarrollo en áreas como diseño digital, sistemas embebidos, verificación de hardware, inteligencia artificial y seguridad informática.

### 1.1.2 Area de conocimiento del proyecto ´

El trabajo se enmarca dentro del área de Sistemas Embebidos, al involucrar el diseño e implementación de un módulo hardware sobre una arquitectura reconfigurable (FPGA) y su integración dentro de un System-on-Chip (SoC) con procesador y periféricos de comunicación.

Paralelamente, el proyecto se vincula con la Seguridad de Hardware mediante la implementación de una Función Físicamente No Clonable (PUF) como raíz de confianza,

1 Introducción | 3

orientada a la generación de identificadores únicos, protección de datos y autenticación de dispositivos sin requerir almacenamiento permanente de claves criptográficas.

### 1.1.3 Trabajos similares

La arquitectura Pseudo-LFSR PUF (PLPUF) fue propuesta por Hori et al. [4], quienes demostraron que una cadena de inversores con retroalimentación tipo Fibonacci, equivalente a un LFSR implementado de forma puramente combinacional, es capaz de generar respuestas multibit compactas y eficientes en área sobre FPGAs Xilinx Spartan. Su diseño alcanzó niveles competitivos de uniformidad y unicidad con un consumo reducido de recursos lógicos. Más recientemente, Alsharkawy et al. [9] analizaron los riesgos ocultos de la duración de activación en PLPUFs, evidenciando que una selección inadecuada de este parámetro puede comprometer la calidad de las respuestas y, por ende, la seguridad del sistema.

Diversas investigaciones han explorado variantes de PUFs basadas en registros de desplazamiento y lógica reconfigurable sobre FPGAs. Srilakshmi et al. [10] propusieron una PUF fuerte construida con un LFSR de bajo consumo, orientada a dispositivos con restricciones de energía. Hou et al. [6] presentaron una PUF LFSR ligera con seguridad mejorada implementada en FPGA, mientras que Huang et al. [11] extendieron el concepto hacia registros de desplazamiento no lineales (NLFSR PUF) para aumentar la resistencia frente a ataques de modelado por aprendizaje automático. Liu et al. [12] exploraron PUFs reconfigurables basadas en compuertas XOR como solución de bajo costo para seguridad en IoT. Las revisiones exhaustivas de Lata y Cenkeramaddi [13] y de Anandakumar et al.
[14] ofrecen un panorama amplio del estado del arte en diseños de PUFs sobre FPGAs, abarcando desde arquitecturas basadas en retardos hasta implementaciones basadas en memoria.

En el ámbito de la integración de PUFs dentro de sistemas embebidos y protocolos de seguridad para IoT, Chen et al. [15] implementaron generadores de números pseudoaleatorios criptográficamente seguros basados en SRAM PUFs sobre FPGA. Idriss et al. [16] propusieron un protocolo de autenticación ligero basado en PUFs para dispositivos IoT con recursos limitados, mientras que Hou et al. [17] desarrollaron un protocolo de autenticación con doble PUF resistente a ataques de modelado físico. Estos trabajos evidencian una tendencia creciente hacia la incorporación de primitivas PUF como raíces de confianza en arquitecturas embebidas.

No obstante, a pesar de los avances descritos, no se identificó en la literatura un módulo PLPUF de código abierto, parametrizable y empaquetado como núcleo IP compatible con la interfaz AXI4-Lite y el procesador MicroBlaze V. La mayoría de las implementaciones reportadas se limitan a evaluaciones aisladas del núcleo PUF sin ofrecer integración dentro de un SoC completo ni controladores de software reutilizables. El presente proyecto aborda este vacío al proporcionar una solución integrada, desde el diseño HDL hasta el software de evaluación, orientada a entornos académicos y de investigación.

1 Introducción | 4

## 1.2 Planteamiento del problema

### 1.2.1 Contexto del problema

La implementación de sistemas seguros en plataformas reconfigurables, como las FPGAs, se ha convertido en una necesidad crítica frente al incremento de amenazas relacionadas con clonación de dispositivos, falsificación de hardware y accesos no autorizados. Los mecanismos criptográficos convencionales dependen de claves almacenadas en memorias no volátiles, tales como EEPROM, Flash o SRAM con respaldo de batería. Sin embargo, estas tecnologías no garantizan protección frente a ataques físicos capaces de extraer información sensible directamente del dispositivo [6].

Esta situación resulta especialmente crítica en el contexto del IoT y sistemas embebidos desplegados en entornos abiertos, donde los dispositivos operan con restricciones de energía, área y capacidad computacional. La incorporación de módulos adicionales de seguridad puede representar una sobrecarga significativa de recursos, dificultando la adopción de soluciones robustas [5, 18].

Durante la fabricación de circuitos integrados surgen variaciones físicas inevitables, tales como diferencias en el voltaje de umbral o el espesor del óxido de compuerta. Aunque estas variaciones no afectan la funcionalidad lógica del circuito, constituyen una fuente de entropía reproducible que puede explotarse para generar identificadores únicos de hardware [19].

### 1.2.2 Justificación del problema

Actualmente no se dispone de un módulo PUF de código abierto, programable y compatible con el procesador MicroBlaze V mediante la interfaz AXI. Muchas implementaciones reportadas en la literatura presentan limitaciones de accesibilidad, flexibilidad o integración dentro de arquitecturas modernas de sistemas embebidos, restringiendo su uso en entornos académicos y de investigación [13, 14]. Esta brecha es especialmente significativa en el ámbito educativo, donde las soluciones comerciales se encuentran protegidas por licencias o patentes que las hacen inaccesibles para instituciones formativas y estudiantes en formación.

El desarrollo de un módulo PLPUF programable e integrable directamente en un SoC permite eliminar la dependencia de almacenamiento persistente de claves, mejorar la seguridad a nivel físico y habilitar plataformas experimentales para la evaluación de técnicas criptográficas emergentes [20, 21]. A diferencia de implementaciones aisladas del núcleo PUF, una solución integrada como periférico AXI permite ejercitar simultáneamente todas las capas del sistema (HDL, interfaz de bus, firmware, comunicación serial y análisis de datos), proporcionando una plataforma realista para validar protocolos de autenticación basados en PUFs en condiciones equivalentes a un despliegue embebido real [16, 17].

1 Introducción | 5

Adicionalmente, la arquitectura PLPUF resulta especialmente atractiva para este propósito debido a su compacidad y a la posibilidad de modificar la relación desafío-respuesta mediante un único parámetro (la duración de activación), lo cual la convierte en una primitiva versátil para experimentar con distintos compromisos entre confiabilidad y entropía [4, 9]. Finalmente, el desarrollo de este módulo facilita su adopción en contextos educativos y prototipos de investigación dentro del ámbito nacional, contribuyendo a la formación de ingenieros capacitados en el diseño de sistemas embebidos seguros, área estratégica para el desarrollo tecnológico del país.

### 1.2.3 Enunciado del problema

Existe una vulnerabilidad crítica en sistemas embebidos basados en FPGA con procesadores suaves debido a la dependencia de claves criptográficas almacenadas en memorias no volátiles, las cuales pueden ser extraídas mediante ataques físicos. Esta vulnerabilidad se ve agravada por la ausencia de módulos de seguridad de hardware abiertos, programables y fácilmente integrables mediante estándares como AXI en arquitecturas basadas en MicroBlaze V dentro de FPGAs de la familia Artix-7.

## 1.3 Objetivos del proyecto

### 1.3.1 Objetivo general

Diseñar un módulo PLPUF programable compatible con el procesador MicroBlaze V y la interfaz AXI, mediante lenguajes de descripción de hardware y herramientas de síntesis en FPGA, para su integración en sistemas embebidos orientados a la seguridad.

### 1.3.2 Objetivos específicos

1. Implementar el módulo PLPUF en HDL con ancho parametrizable que genere identificadores únicos aprovechando variaciones físicas del hardware mediante síntesis en FPGA con AMD Vivado.
2. Desarrollar una interfaz AXI-slave que permita el control del módulo desde el procesador MicroBlaze V mediante registros de control y estado.
3. Integrar el módulo dentro de un sistema embebido completo con MicroBlaze V, memoria y UART, utilizando AMD Vitis para el desarrollo del software de control.
4. Evaluar el PLPUF mediante métricas de seguridad como uniformidad, unicidad y confiabilidad utilizando pruebas automatizadas de desafío-respuesta y análisis estadístico.

1 Introducción | 6

## 1.4 Alcances, entregables y limitaciones

### 1.4.1 Alcances

El proyecto comprende el diseño, implementación e integración de un módulo PLPUF programable en la placa Basys3 con FPGA Artix-7 (XC7A35T-1CPG236C). El módulo será incorporado como periférico AXI-slave dentro de un sistema SoC con procesador MicroBlaze V, memoria local y comunicación UART. Se desarrollará además el firmware de control en lenguaje C utilizando AMD Vitis y se realizará la evaluación estadística del módulo mediante métricas estándar de PUFs: uniformidad, unicidad y confiabilidad [22, 23].

### 1.4.2 Entregables

1. Código HDL del módulo PLPUF parametrizable con reportes de síntesis.
2. Módulo AXI-slave funcional con documentación del mapa de registros.
3. Sistema SoC completo con diseño en Vivado, bitstream y software de control.
4. Dataset de pares desafío-respuesta e informe de evaluación estadística.

### 1.4.3 Limitaciones

- El diseño está condicionado por los recursos disponibles en la FPGA Artix-7 asig-

nada, lo que puede limitar parámetros como el ancho del PLPUF.

- Las herramientas utilizadas serán exclusivamente AMD Vivado y AMD Vitis.
- La evaluación estadística se realizará sobre un único dispositivo FPGA, por lo que los resultados pueden no generalizarse a otros lotes de fabricación [23].

# Capítulo 2

# Marco de referencia teórico

En este capítulo se presentan los fundamentos teóricos y tecnológicos que sustentan el diseño, la implementación y la evaluación del módulo PLPUF desarrollado en este trabajo. Se describen, en primer lugar, los conceptos de System-on-Chip (SoC) y las interfaces de comunicación empleadas; a continuación, la plataforma FPGA y las herramientas de desarrollo; luego, la teoría de las Funciones Físicamente No Clonables (PUFs) con énfasis en la variante Pseudo-LFSR; y, finalmente, las métricas de seguridad utilizadas para la evaluación del módulo.

## 2.1 Sistemas en chip (SoC)

Un System-on-Chip (SoC) es una arquitectura de circuito integrado que incorpora en un solo dispositivo un procesador, memoria, periféricos de comunicación y lógica personalizada. En el contexto de las FPGAs, los SoC se construyen instanciando procesadores suaves (soft processors) dentro de la lógica programable, conectados a periféricos mediante buses estándar [24]. Esta aproximación permite crear sistemas embebidos completos en los que tanto el hardware como el software son altamente configurables.

### 2.1.1 Arquitectura MicroBlaze V

MicroBlaze V es un procesador suave (soft processor ) de AMD diseñado para su implementación en FPGAs de la familia AMD/Xilinx. A diferencia de su predecesor MicroBlaze, que utiliza un conjunto de instrucciones propietario, MicroBlaze V implementa la arquitectura de conjunto de instrucciones abierta RISC-V, específicamente el conjunto base RV32I [1]. RISC-V es una ISA de estándar abierto mantenida por RISC-V International, lo que permite a cualquier fabricante desarrollar procesadores compatibles sin costos de licenciamiento [1].

El conjunto fijo de características de MicroBlaze V incluye 32 registros de propósito

7

2 Marco de referencia teórico | 8

general, un contador de programa extensible de 32 bits, un pipeline de emisión única, una unidad aritmético-lógica (ALU), un barrel shifter y las extensiones Zicsr (instrucciones de registros de control y estado) y Zifencei (barrera de instrucciones) [1].

Adicionalmente, MicroBlaze V es altamente configurable mediante parámetros que permiten habilitar selectivamente funcionalidades opcionales. Entre las extensiones configurables se encuentran: M (multiplicación y división entera), A (instrucciones atómicas), C (instrucciones comprimidas de 16 bits), F (punto flotante de precisión simple), D (punto flotante de doble precisión) y Zb[abcs] (manipulación de bits) [1]. La profundidad del pipeline es seleccionable entre 3, 4, 5 y 8 etapas, lo que permite optimizar el diseño para área o frecuencia según la aplicación [1].

En cuanto a la interfaz de memoria, MicroBlaze V ofrece un bus local de memoria (LMB) para acceso de baja latencia a BRAM, e interfaces AXI4 para cachés de instrucciones y datos (M AXI IC, M AXI DC), así como un puerto de datos de periféricos (M AXI DP) que soporta el protocolo AXI4-Lite [1, 25]. El procesador también integra opcionalmente cachés de instrucciones y datos con políticas configurables (write-back o write-through), soporte de depuración mediante el módulo MDM V (MicroBlaze Debug Module V ), y capacidades de tolerancia a fallos como operación en lockstep y redundancia modular triple (TMR) [1].

Como se muestra en la Figura 2.1, la arquitectura interna de MicroBlaze V se organiza en torno a un decodificador de instrucciones central que alimenta la ALU, el barrel shifter, el multiplicador y el divisor (estos dos últimos opcionales). El banco de 32 registros de propósito general y los registros de control y estado (CSR) están conectados directamente al decodificador. En el lado de instrucciones, un búfer de instrucciones recibe datos desde el bus local de instrucciones (ILMB) o desde la caché de instrucciones (M AXI IC); un decodificador de instrucciones comprimidas (extensión C) procesa opcionalmente las instrucciones de 16 bits. En el lado de datos, el procesador accede a la BRAM mediante el bus local de datos (DLMB) y a los periféricos mediante el puerto AXI de datos (M AXI DP); la caché de datos (M AXI DC) es configurable como write-back o write-through. La unidad de punto flotante (FPU), la unidad de gestión de memoria (MMU con TLBs) y la caché de predicción de saltos (Branch Target Cache) aparecen sombreadas en el diagrama, indicando que son características opcionales habilitables mediante parámetros de configuración.

MicroBlaze V es totalmente compatible a nivel de hardware con el procesador MicroBlaze clásico [1], lo que permite reutilizar la biblioteca de periféricos AXI existente del ecosistema AMD/Xilinx. La utilización de recursos en una configuración básica RV32I optimizada para área requiere aproximadamente 633 LUTs en una FPGA Spartan-7, mientras que una configuración RV32IMAFC con extensiones de manipulación de bits alcanza aproximadamente 4 826 LUTs [1].

2 Marco de referencia teórico | 9

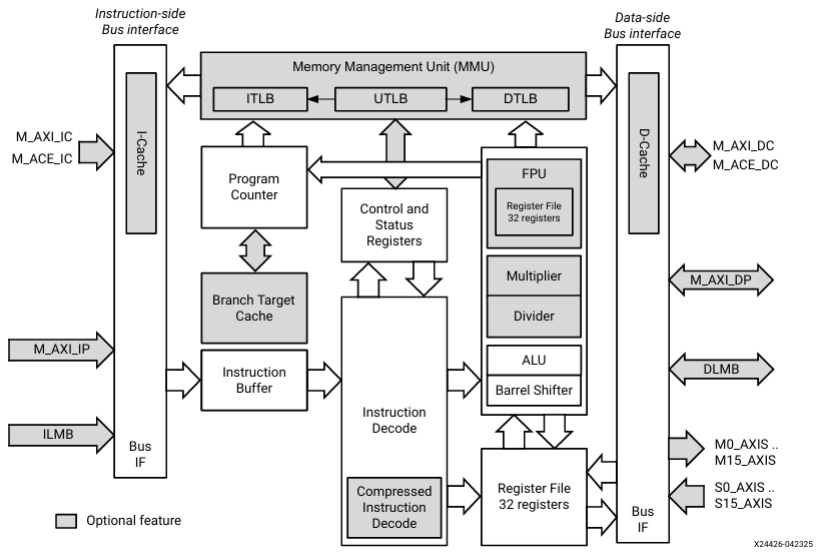
[picture p8: figure]

Figura 2.1: Diagrama de bloques del procesador MicroBlaze V [1].

### 2.1.2 Bus AXI4-Lite

La interfaz AMBA AXI (Advanced eXtensible Interface) es un protocolo de comunicación on-chip desarrollado por Arm Ltd. como parte de la especificación AMBA (Advanced Microcontroller Bus Architecture) [2]. AMD/Xilinx adoptó AXI como el protocolo estándar de interconexión para sus FPGAs a partir de la serie 7, reemplazando los buses PLB y FSL utilizados en generaciones anteriores [26].

El protocolo AXI define cinco canales independientes que operan de forma desacoplada mediante un mecanismo de handshake basado en señales VALID y READY [2]. La Figura 2.2 ilustra los tres canales involucrados en una transacción de escritura: el canal de dirección de escritura (AW), por el que la interfaz maestra (Manager ) envía la dirección y las señales de control; el canal de datos de escritura (W), que transporta las palabras de datos desde el maestro hacia la interfaz subordinada (Subordinate); y el canal de respuesta de escritura (B), por el que el subordinado retorna el estado de finalización de la transacción. De forma análoga, la Figura 2.3 muestra los dos canales de lectura: el canal de dirección de lectura (AR), por el que el maestro emite la dirección solicitada, y el canal de datos de lectura (R), por el que el subordinado retorna los datos leídos junto con su estado. Las flechas en ambos diagramas indican la dirección del flujo de información entre las interfaces.

La variante AXI4-Lite es una simplificación del protocolo AXI4 completo orientada a periféricos de control con mapas de registros accesibles mediante memory-mapped I/O (MMIO). AXI4-Lite restringe las transacciones a transferencias de una sola palabra (sin ráfagas) y elimina señales avanzadas como AWLEN, AWSIZE y AWBURST, lo que simplifica significativamente la lógica del esclavo [2, 26]. Cada transacción se completa cuando el

2 Marco de referencia teórico | 10


Figura 2.2: Canales de escritura del protocolo AXI: canal de dirección (AW), canal de datos
(W) y canal de respuesta (B) [2].


Figura 2.3: Canales de lectura del protocolo AXI: canal de dirección (AR) y canal de datos
(R) [2].

emisor activa VALID y el receptor responde con READY en el mismo ciclo de reloj.

En el ecosistema Vivado, los periféricos AXI4-Lite se integran en el block design mediante el bloque SmartConnect, que actúa como interconexión entre el puerto maestro del procesador (M AXI DP) y los puertos esclavos de los periféricos. El entorno IP Integrator automatiza la asignación de direcciones y la conexión de señales de reloj y reset [24, 26].

## 2.2 FPGAs y lógica reconfigurable

Las FPGAs (Field Programmable Gate Arrays) son dispositivos semiconductores cuya funcionalidad lógica puede ser programada y reprogramada por el usuario después de su fabricación. A diferencia de los circuitos integrados de aplicación específica (ASICs), las FPGAs ofrecen flexibilidad de diseño, menor tiempo de desarrollo y la posibilidad

2 Marco de referencia teórico | 11

de actualización en campo, lo que las convierte en plataformas idóneas para prototipado rápido, sistemas embebidos y aplicaciones de seguridad [13, 14].

La naturaleza reconfigurable de las FPGAs resulta particularmente relevante para la implementación de PUFs, ya que permite explotar las variaciones físicas inherentes a la lógica programable, como diferencias en los retardos de propagación de LUTs e interconexiones, para generar identificadores únicos de dispositivo [13].

### 2.2.1 Familia Artix-7 y plataforma Basys 3

La familia Artix-7 de AMD/Xilinx forma parte de la serie 7 de FPGAs y está optimizada para aplicaciones que requieren alto rendimiento lógico con bajo consumo de energía. El presente proyecto utiliza la placa de desarrollo Basys 3 de Digilent, que integra una FPGA Artix-7 con número de parte XC7A35T-1CPG236C [3].

Las principales características del dispositivo XC7A35T son [3]:

- 33 280 celdas lógicas distribuidas en 5 200 slices, donde cada slice contiene cuatro

LUTs de 6 entradas y 8 flip-flops.

- 1 800 Kb de memoria RAM de bloques (BRAM).
- 5 tiles de gestión de reloj, cada uno con un lazo de fase enganchada (PLL).
- 90 bloques DSP para operaciones aritméticas aceleradas.
- Frecuencias internas de reloj superiores a 450 MHz.
- Conversor analógico-digital integrado (XADC).

La placa Basys 3 complementa la FPGA con periféricos de entrada/salida que facilitan la validación de diseños: 16 interruptores, 16 LEDs, 5 botones pulsadores, un display de 7 segmentos de 4 dígitos, un puerto USB-UART para comunicación serial, conectores Pmod para expansión y un puerto VGA de 12 bits [3]. El reloj principal del sistema es un oscilador de 100 MHz conectado al pin W5 de la FPGA [3].

La Figura 2.4 muestra la disposición física de la placa Basys 3 con sus componentes numerados. En la parte central se encuentra el chip FPGA Artix-7, rodeado por los periféricos de entrada/salida: los 16 interruptores y los 16 LEDs se ubican en el borde inferior de la placa; los 5 pulsadores se sitúan a la derecha junto a los conectores Pmod para expansión; el display de 7 segmentos de 4 dígitos se encuentra en la zona inferior izquierda. En el borde superior se localizan el conector VGA, el puerto USB compartido para UART y JTAG (marcado como Shared UART/JTAG USB port), el conector USB host y los controles de alimentación. El puerto USB-UART compartido (conector J4) es el que se utiliza en este proyecto tanto para la carga del bitstream vía JTAG como para la comunicación serial con el computador anfitrión.

2 Marco de referencia teórico | 12

La configuración de la FPGA se realiza mediante archivos bitstream generados por Vivado. El bitstream del XC7A35T tiene un tamaño típico de 17 536 096 bits y puede cargarse a través de JTAG (puerto USB J4), desde la memoria Flash SPI integrada o desde una memoria USB conectada al puerto HID [3].

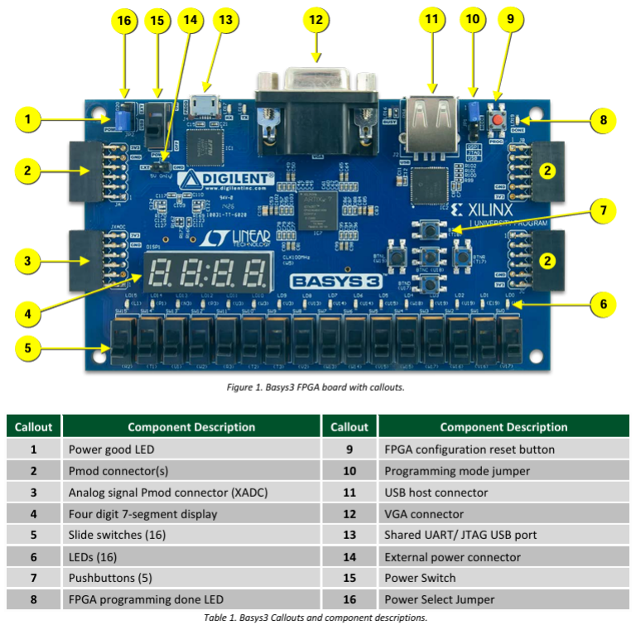
[picture p9: figure]

Figura 2.4: Placa de desarrollo Basys 3 con FPGA Artix-7 [3].

### 2.2.2 Herramientas: Vivado y Vitis

El flujo de desarrollo de sistemas embebidos sobre FPGAs de AMD/Xilinx se sustenta en dos herramientas complementarias: Vivado Design Suite para el diseño de hardware y Vitis Unified Software Platform para el desarrollo de software.

AMD Vivado Design Suite es el entorno de diseño para FPGAs de la serie 7 en adelante. Vivado incluye el módulo IP Integrator, que permite construir diseños de bloques (block designs) mediante la interconexión gráfica de núcleos IP (Intellectual Property), tales como procesadores, controladores de memoria, interfaces de comunicación y periféricos personalizados [24]. El flujo típico de un proyecto en Vivado comprende: creación del block design, generación de productos de salida de los IPs, síntesis lógica, implementación física (place and route), verificación de restricciones temporales y generación del bitstream [24]. Para integrar periféricos personalizados, como el módulo PLPUF de este proyecto, Vivado ofrece un flujo de empaquetado de IP que genera la descripción IP-XACT (component.xml), permitiendo que el periférico sea reutilizable en cualquier block design [26].

2 Marco de referencia teórico | 13

AMD Vitis es la plataforma unificada de desarrollo de software para sistemas embebidos basados en procesadores AMD. Vitis importa la descripción del hardware exportada por Vivado en formato .xsa (Xilinx Support Archive), a partir de la cual genera automáticamente la plataforma de software, incluyendo el Board Support Package (BSP) con controladores de periféricos y la biblioteca estándar de C [27]. El desarrollador crea aplicaciones en C/C++ que se compilan con la cadena de herramientas GCC para RISC-V (riscv64-unknown-elf-gcc) y se cargan en la FPGA a través de JTAG para su ejecución y depuración [27].

Este flujo HW–SW permite un desarrollo iterativo donde las modificaciones al hardware (por ejemplo, cambios en el mapa de registros del periférico PLPUF) se propagan al software mediante la regeneración del archivo .xsa y la actualización de la plataforma en Vitis [24, 27].

## 2.3 Funciones físicamente no clonables (PUF)

Las Funciones Físicamente No Clonables (PUFs, por sus siglas en inglés Physical Unclonable Functions) son primitivas de seguridad de hardware que explotan las variaciones microscópicas e incontrolables introducidas durante el proceso de fabricación de circuitos integrados para generar identificadores únicos y respuestas criptográficamente útiles [5, 7]. Estas variaciones, como diferencias en el voltaje de umbral de los transistores, el espesor del óxido de compuerta o los retardos de propagación en las interconexiones, constituyen una fuente natural de entropía que es reproducible dentro del mismo dispositivo pero impredecible e imposible de replicar exactamente en otro chip, incluso del mismo lote de fabricación [14, 19].

A diferencia de los mecanismos criptográficos convencionales, que dependen de claves almacenadas en memorias no volátiles (EEPROM, Flash, SRAM con respaldo de batería), las PUFs generan sus claves directamente desde las propiedades físicas del silicio, eliminando la necesidad de almacenamiento permanente de información sensible [6, 7]. Esta propiedad las hace intrínsecamente resistentes a ataques físicos de extracción de claves y las posiciona como una alternativa prometedora para el establecimiento de raíces de confianza en hardware [5].

### 2.3.1 Fundamentos y taxonomía

Una PUF se define formalmente como una función implementada por un sistema físico que es fácil de evaluar pero extremadamente difícil o imposible de clonar [14]. La interacción con una PUF se realiza mediante un mecanismo de desafío-respuesta: ante un estímulo de entrada (desafío), la PUF produce una salida (respuesta) que depende de las características físicas únicas del dispositivo. Las propiedades esenciales que debe exhibir una PUF son [13, 14]:

2 Marco de referencia teórico | 14
- Reproducibilidad: la respuesta a un desafío dado debe ser consistente a lo largo

del tiempo y bajo diferentes condiciones ambientales.

- Unicidad: diferentes dispositivos deben producir respuestas significativamente dis-

tintas ante el mismo desafío.

- Inclonabilidad: debe ser computacional y físicamente inviable construir una réplica

del dispositivo o un modelo matemático que reproduzca fielmente el comportamiento de la PUF.

- Impredecibilidad: no debe ser posible predecir la respuesta a un desafío no ob-

servado previamente.

- Evidencia de manipulación (tamper-evidence): cualquier alteración física del

circuito debe modificar las respuestas de forma detectable.

Las variaciones del proceso de fabricación que explotan las PUFs se clasifican en dos categorías [14]: variaciones die-to-die, que afectan a todo el chip de manera uniforme (inter-oblea, inter-lote); y variaciones within-die, que ocurren entre diferentes elementos del mismo chip. Dentro de estas últimas, las variaciones aleatorias, causadas por la naturaleza estocástica del dopado y el crecimiento del óxido de compuerta, son la fuente principal de entropía y de la propiedad de inclonabilidad de las PUFs [14, 19].

Las PUFs se clasifican generalmente según el tamaño de su espacio de pares desafío-respuesta (CRP) en dos categorías principales [5, 13]:

- PUF débil (Weak PUF): genera un número limitado de CRPs, típicamente uno

por instancia. Se utiliza principalmente para generación de claves criptográficas y almacenamiento seguro de claves. Ejemplos representativos incluyen las PUFs basadas en SRAM y flip-flop [13, 15].

- PUF fuerte (Strong PUF): posee un espacio de CRPs exponencialmente grande

en relación con su tamaño de implementación, lo que dificulta que un atacante capture todos los pares. Es adecuada para protocolos de autenticación donde cada CRP se utiliza una sola vez. Ejemplos incluyen la Arbiter PUF y la PUF de oscilador de anillo (RO-PUF) [5, 13].

Desde la perspectiva de la arquitectura del circuito, las PUFs basadas en FPGA pueden clasificarse en tres familias principales [13, 14]:

1. PUFs basadas en retardo: explotan las diferencias en los tiempos de propagación de señales a través de caminos lógicos nominalmente idénticos. Incluyen la Arbiter PUF, la RO-PUF y la Pseudo-LFSR PUF (PLPUF) [4].
2. PUFs basadas en memoria: aprovechan el estado de encendido aleatorio de elementos de memoria biestables, como celdas SRAM o flip-flops [15].

2 Marco de referencia teórico | 15
3. PUFs híbridas y reconfigurables: combinan técnicas de las dos familias anteriores o incorporan mecanismos de reconfiguración para ampliar el espacio de CRPs [12].

### 2.3.2 PUFs programables: Pseudo-LFSR PUF (PLPUF)

La Pseudo-LFSR PUF (PL-PUF o PLPUF) es una arquitectura de PUF propuesta por Hori et al. [4] que se basa en la estructura de un registro de desplazamiento con retroalimentación lineal (LFSR), pero a diferencia de un LFSR convencional, no contiene registros de desplazamiento. En su lugar, el PLPUF emplea una cadena de lógica puramente combinacional compuesta por inversores y compuertas XOR dispuestos en una topología de retroalimentación tipo Fibonacci [4].

Arquitectura del núcleo

Para un PLPUF de n bits, el diseño requiere únicamente n inversores y un número reducido de compuertas XOR determinado por el polinomio primitivo utilizado. En la configuración de 128 bits propuesta por [4], el polinomio primitivo empleado es:

p(x) = x

128 + x

126 + x

102 + x

99 + 1 | (2.1)

lo que implica solamente tres compuertas XOR en las posiciones de tap correspondientes (índices 125, 101 y 98, indexados desde cero) [4]. Cada celda del PLPUF contiene un multiplexor que selecciona entre el bit de desafío correspondiente (durante la fase de carga) o la señal de retroalimentación del vecino (durante la fase activa), y un inversor cuyo retardo de propagación constituye la fuente de entropía física. Los inversores llevan el atributo DONT TOUCH para evitar que las herramientas de síntesis optimicen o eliminen el lazo combinacional.

La Figura 2.5 presenta la estructura completa del PLPUF de 128 bits. La cadena está formada por celdas de lógica central (Core logic) conectadas en serie: la salida Dout[128] alimenta la entrada de la siguiente celda, y así sucesivamente hasta Dout[1]. La línea de retroalimentación conecta Dout[1] de vuelta a la entrada de la primera celda, cerrando el lazo. En las posiciones de tap (celdas 127, 102 y 100, correspondientes a los términos del polinomio primitivo) se insertan compuertas XOR (⊕) que combinan la señal de retroalimentación con la salida del vecino adyacente, introduciendo la no linealidad necesaria para la difusión de la entropía.

La Figura 2.6 detalla la estructura interna de una celda individual. Cada celda recibe dos entradas: Din (señal de retroalimentación del vecino durante la fase activa) y Dinit (bit de desafío correspondiente durante la fase de carga). La señal de selección SEL controla un multiplexor que elige entre ambas entradas. La señal seleccionada pasa a través de un inversor, cuyo retardo de propagación (determinado por las variaciones del proceso de fabricación) constituye la fuente de entropía física. La salida Dout alimenta la siguiente celda de la cadena.

2 Marco de referencia teórico | 16

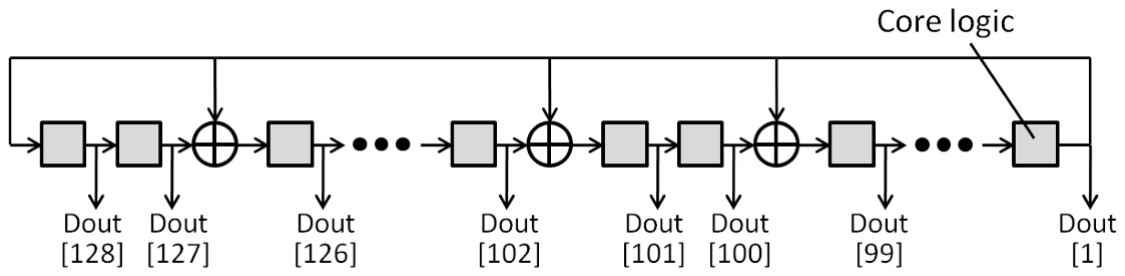
[picture p10: figure]

Figura 2.5: Estructura del Pseudo-LFSR PUF de 128 bits: cadena de celdas de lógica central con compuertas XOR en las posiciones de tap y retroalimentación desde Dout[1] hacia la primera celda [4].


Figura 2.6: Estructura interna de una celda de lógica central: multiplexor controlado por SEL e inversor como fuente de entropía [4].

Operación del PLPUF

El funcionamiento del PLPUF se controla mediante una máquina de estados finitos (FSM) con cuatro estados, ilustrada en la Figura 2.7 [4]. El diagrama muestra las transiciones entre estados y las señales de control asociadas a cada uno:

1. IDLE (enable = 0, busy = 0, done = 0): el módulo está inactivo, esperando la señal de inicio. Al recibir start = 1, la FSM activa busy = 1 y transiciona a LOAD.
2. LOAD (1 ciclo): el desafío de n bits se propaga a través de los inversores con la señal de habilitación desactivada (enable = 0), permitiendo que la cadena se estabilice en un estado determinado por el desafío. Como se observa en la figura, en este estado el desafío (challenge) se propaga por la cadena mientras enable permanece en cero. Esta fase dura un solo ciclo de reloj, tras lo cual enable pasa a 1 y la FSM avanza a ACTIVE.
3. ACTIVE (enable = 1): el lazo de retroalimentación se cierra y el circuito oscila libremente a una frecuencia determinada por los retardos acumulados de propagación de cada inversor y compuerta XOR, retardos que son únicos para cada chip fabricado. Esta fase dura exactamente c ciclos de reloj, donde c es la duración de activación configurable por software. Cuando el contador descendente alcanza duration − 1, el estado de la cadena se captura en el registro de respuesta (response ← core out)

2 Marco de referencia teórico | 17

y la FSM transiciona a DONE.

4. DONE (1 ciclo, done = 1, busy = 0): la señal done emite un pulso de un ciclo, indicando que la respuesta de n bits está disponible en los registros de salida. La FSM retorna automáticamente a IDLE, quedando lista para una nueva evaluación.

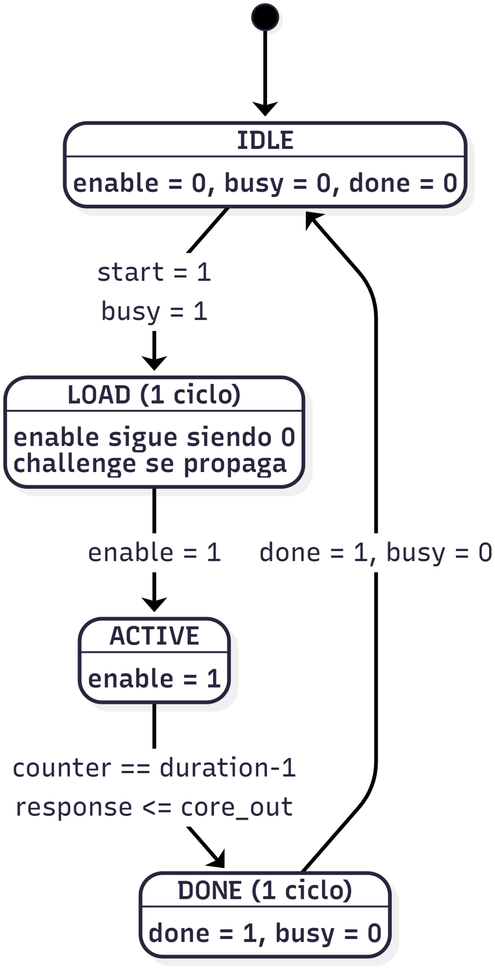
[picture p11: figure]

Figura 2.7: Máquina de estados del PLPUF: ciclo de evaluación desafío-respuesta con las señales de control y las condiciones de transición entre los estados IDLE, LOAD, ACTIVE y DONE.

Propiedades distintivas

El PLPUF presenta varias propiedades que lo distinguen de otras arquitecturas de PUF [4]:

- Compacidad: requiere solo n inversores y un número reducido de compuertas

XOR, en contraste con la Arbiter PUF que necesita 2n multiplexores para un diseño de n bits.

- Eficiencia: genera una respuesta de n bits a partir de un solo desafío de n bits en

una única evaluación.

2 Marco de referencia teórico | 18
- Multifuncionalidad: la relación desafío-respuesta puede modificarse sin alterar el

hardware, simplemente variando la duración de activación c. Cada valor de c genera un mapeo desafío-respuesta diferente, lo que equivale conceptualmente a disponer de múltiples núcleos PUF dentro de un solo circuito.

- Configurabilidad de confiabilidad: la confiabilidad de las respuestas puede ajustarse seleccionando un valor adecuado de c. Con duraciones cortas (c < 4), el PLPUF exhibe una distancia de Hamming intra-dispositivo baja (alta confiabilidad); a medida que c aumenta, la variabilidad de las respuestas crece [4].

Resultados experimentales de referencia

Hori et al. [4] implementaron un PLPUF de 128 bits en 16 FPGAs Virtex-5 XC5VLX30 montadas en placas SASEBO-GII, operando a 24 MHz con tensión de núcleo de 1,0 V. Se evaluaron 100 desafíos aleatorios con 100 repeticiones cada uno para valores de duración de activación c = 1, . . . , 16. Los resultados mostraron una distancia de Hamming intra-dispositivo pequeña para valores bajos de c (por ejemplo, media de 1,76 bits para c = 1) y tasas de falsa aceptación y falso rechazo (FAR/FRR) iguales a cero para múltiples dispositivos con c ≤ 4 [4].

Riesgos de la duración de activación

Investigaciones recientes de Alsharkawy et al. [9] demostraron que la duración de activación constituye un parámetro crítico de seguridad en los PLPUFs. Mediante un análisis de dependencia lineal entre pares de PLPUFs implementados en 8 FPGAs ARTY A7 (32 instancias, 8 192 CRPs cada una), los autores encontraron que con c = 1 la predictibilidad promedio entre PLPUFs ubicados en la misma posición física alcanza hasta el 96 %, mientras que con c = 31 la predictibilidad disminuye a aproximadamente 30 % [9]. Este hallazgo subraya la importancia de seleccionar cuidadosamente la duración de activación para equilibrar confiabilidad y resistencia ante ataques predictivos.

### 2.3.3 Modelos de desafío-respuesta (CRP)

El modelo de desafío-respuesta (Challenge-Response Pair, CRP) es el paradigma fundamental de interacción con una PUF. Un desafío C es un estímulo de entrada de n bits que se aplica al circuito PUF, y la respuesta R es la salida de n bits producida por la PUF en función de las características físicas únicas del dispositivo [5]. Cada dispositivo fabricado genera un conjunto de CRPs propio y diferente, que actúa como una huella digital del hardware.

El espacio total de CRPs de una PUF determina su clasificación funcional y sus aplicaciones de seguridad [5, 18]:

2 Marco de referencia teórico | 19
- En una PUF débil, el espacio de CRPs es limitado (a menudo un solo par), por lo

que se emplea para generación de claves y almacenamiento seguro de secretos.

- En una PUF fuerte, el espacio crece exponencialmente con el tamaño de la implementación (2n para n bits de desafío), lo que permite protocolos de autenticación donde cada CRP se utiliza una sola vez para evitar ataques de reproducción (replay attacks) [5].

En el caso específico del PLPUF, la multifuncionalidad proporcionada por la duración de activación c amplía efectivamente el espacio de CRPs: cada combinación de desafío y duración (C, c) produce una respuesta diferente, de modo que un PLPUF de n bits con un rango de duraciones de 1 a cmax ofrece hasta cmax ×2

n pares desafío-respuesta distintos [4].

La seguridad de un esquema basado en CRPs puede evaluarse mediante dos métricas complementarias [28]: el número de CRPs que un atacante debe recopilar para modelar exitosamente la PUF con una predictibilidad del 99 % (NCR, Number of CRPs); y el tiempo computacional requerido para construir dicho modelo (TTM, Time to Model). Una PUF es considerada segura cuando ambas métricas exceden los límites prácticos de un atacante.

## 2.4 Seguridad en sistemas embebidos

La seguridad de los sistemas embebidos enfrenta desafíos crecientes debido a la proliferación de dispositivos IoT en entornos físicamente accesibles, donde los atacantes pueden realizar ataques invasivos y semi-invasivos sobre el hardware [5, 29]. En este contexto, las PUFs ofrecen una alternativa de bajo costo y recursos reducidos para establecer raíces de confianza directamente en el silicio, sin depender de almacenamiento criptográfico externo [7].

### 2.4.1 Autenticación de hardware

La autenticación de hardware basada en PUFs sigue un esquema de dos fases: registro (enrollment) y verificación [5, 30].

1. Fase de registro: en un entorno controlado y seguro, se aplican al dispositivo un conjunto de desafíos {C1, C2, . . . , Cm} y se almacenan las respuestas correspondientes {R1, R2, . . . , Rm} en una base de datos del servidor verificador. Dado que las PUFs no son perfectamente estables, se puede emplear votación por mayoría sobre múltiples evaluaciones para obtener respuestas de referencia (golden responses) [22].
2. Fase de verificación: el servidor envía un desafío Ci al dispositivo y compara la respuesta recibida R′
i

con la respuesta de referencia Ri almacenada. Si la distancia

2 Marco de referencia teórico | 20

de Hamming entre ambas es menor que un umbral predefinido t, el dispositivo se considera auténtico [5].

Para aplicaciones que requieren generación de claves criptográficas estables a partir de respuestas PUF ruidosas, se emplean algoritmos de datos auxiliares (Helper Data Algorithms, HDA) que combinan la respuesta de la PUF con datos públicos y códigos correctores de errores para reproducir una clave determinística [20]. Este enfoque permite derivar claves de hasta 128 o 256 bits con alta confiabilidad, sin almacenar la clave en sí misma en memoria no volátil [20, 21].

La resistencia de las PUFs a la computación cuántica constituye una ventaja adicional: dado que la seguridad de las PUFs no depende de la dificultad de problemas matemáticos (como la factorización de enteros o el logaritmo discreto), sino de propiedades físicas del silicio, se consideran intrínsecamente resistentes a ataques cuánticos que amenazan los algoritmos criptográficos convencionales [5, 30].

### 2.4.2 Métricas de evaluación: unicidad, confiabilidad y uniformidad

La evaluación del rendimiento de una PUF requiere un conjunto de métricas estadísticas bien definidas. Maiti et al. [22] propusieron un marco sistemático basado en siete parámetros agrupados en tres dimensiones: dispositivo (variabilidad inter-chip), tiempo (estabilidad intra-chip) y espacio (distribución de bits). A continuación se describen las métricas principales empleadas en este trabajo.

Uniformidad

La uniformidad mide la distribución de bits en la respuesta de una PUF. Para una PUF ideal, la proporción de unos en la respuesta debe ser del 50 %, indicando máxima entropía por bit [22]. Se calcula como:

Uniformidad = 1
n

Xn

j=1

rj × 100% | (2.2)

donde rj es el j-ésimo bit de la respuesta y n es el ancho en bits de la PUF. Un valor cercano a 50 % indica que la PUF no presenta sesgo significativo hacia ceros o unos.

Confiabilidad (fiabilidad)

La confiabilidad cuantifica la reproducibilidad de las respuestas de una PUF ante el mismo desafío bajo las mismas condiciones operativas. Se evalúa midiendo la distancia de Hamming fraccional intra-dispositivo (intra-HD) entre la respuesta de referencia y respuestas

2 Marco de referencia teórico | 21

obtenidas en evaluaciones sucesivas [22]:

Confiabilidad = 100% − BER | (2.3)

donde BER (Bit Error Rate) es la tasa de error de bit promedio sobre m evaluaciones:

BER = 1
m

Xm

i=1

HD(Rref, Ri)
n
× 100% | (2.4)

con Rref como la respuesta de referencia (obtenida por votación por mayoría), Ri como la i-ésima respuesta y HD(·, ·) la distancia de Hamming entre dos vectores binarios. Idealmente, la confiabilidad debe ser del 100 % (BER = 0); en la práctica, valores superiores al 95 % se consideran aceptables para aplicaciones de identificación [4, 22].

Unicidad

La unicidad mide la capacidad de una PUF para distinguir dispositivos individuales. Se evalúa mediante la distancia de Hamming fraccional inter-dispositivo (inter-HD) entre las respuestas de referencia de diferentes chips ante el mismo desafío [22]:

Inter-HD = 2 k(k − 1)
X

k−1

i=1

X

k

j=i+1

HD(Ri

, Rj )
n
× 100% | (2.5)

donde k es el número de dispositivos evaluados. El valor ideal es 50 %, lo que indica máxima separación estadística entre los identificadores de dispositivos diferentes [22].

En la evaluación intra-dispositivo (cuando solo se dispone de un chip), la distancia de Hamming inter-desafío permite estimar indirectamente la variabilidad: se calculan las respuestas de referencia para m desafíos diferentes y se mide la HD promedio entre todos los pares de respuestas. Un valor cercano al 50 % indica que el PLPUF es capaz de generar respuestas suficientemente diversas ante desafíos distintos [4].

Alias de bit (Bit-Alias)

El alias de bit mide la tendencia de cada posición individual de la respuesta a ser predominantemente cero o uno a través de múltiples dispositivos [23]. Para la posición j, el alias de bit es la proporción de unos observados en esa posición sobre k dispositivos. El valor ideal es 0,5 para cada posición; desviaciones significativas indican bits con baja entropía que podrían ser explotados por un atacante [23]. Wilde y Pehl [23] demostraron la importancia de incorporar intervalos de confianza en la medición del alias de bit, señalando que se requiere un número elevado de muestras (del orden de cientos de dispositivos) para obtener estimaciones estadísticamente confiables.

2 Marco de referencia teórico | 22

Min-entropía

La min-entropía es una métrica más conservadora que la entropía de Shannon para cuantificar la impredecibilidad de una PUF, ya que considera la probabilidad de la respuesta más probable en lugar del promedio [31]. En sistemas que emplean algoritmos de datos auxiliares para la corrección de errores, la min-entropía condicional H¯∞(X|Y ) mide la im-

predecibilidad residual del secreto dado el conocimiento de los datos auxiliares públicos Y . Frisch et al. [31] propusieron un método basado en convolución de histogramas que permite estimar la min-entropía en escenarios con sesgos arbitrarios y correlaciones realistas, superando las limitaciones de los enfoques que asumen respuestas independientes e idénticamente distribuidas (IID).

# Capítulo 3

# Marco metodológico

Este capítulo describe la metodología empleada para el diseño, implementación, integración y evaluación del módulo PLPUF como periférico AXI dentro de un System-on-Chip basado en MicroBlaze V. Se presenta, en primer lugar, la estrategia metodológica adoptada y su justificación; a continuación, el diagrama de la secuencia del proceso seguido y la propuesta metodológica desglosada por objetivo específico; seguidamente, las herramientas de desarrollo utilizadas y el diagrama general de la solución; y, finalmente, las decisiones de diseño en cada etapa del proyecto (módulo HDL, interfaz AXI, integración SoC, software y protocolo de evaluación).

## 3.1 Estrategia metodológica

El desarrollo de sistemas digitales integrados que abarcan desde el diseño de hardware hasta el software embebido y la validación experimental requiere una estrategia metodológica que garantice la trazabilidad entre los entregables y la verificación progresiva de cada componente. Dentro de las aproximaciones disponibles en la ingeniería de sistemas, el modelo secuencial por fases, también conocido como modelo en cascada, se caracteriza por organizar el desarrollo en etapas lineales, donde cada fase produce artefactos verificables que constituyen la entrada directa de la fase siguiente [24].

A diferencia de los modelos iterativos o ágiles, que favorecen la entrega incremental y la retroalimentación temprana del usuario, el modelo secuencial resulta especialmente adecuado cuando los requisitos están bien definidos desde el inicio y existe una dependencia estricta entre los entregables de cada etapa. En el contexto de este proyecto, la relación de precedencia es clara: el módulo HDL del PLPUF (Fase 1) es prerrequisito de la interfaz AXI4-Lite (Fase 2); la interfaz empaquetada como IP es necesaria para la integración del SoC (Fase 3); y el sistema completo y funcional es indispensable para la evaluación estadística (Fase 4). Un modelo iterativo habría introducido riesgos de retrabajo sin beneficio significativo, dado que el alcance del proyecto estaba bien definido desde el anteproyecto y no se requería la participación de usuarios finales durante el desarrollo.

23

3 Marco metodológico | 24

Por estas razones, se adoptó una metodología secuencial por fases organizada en cuatro etapas, cada una alineada con un objetivo específico del proyecto. La ejecución siguió el orden estricto Fase 1 → Fase 2 → Fase 3 → Fase 4, con puntos de verificación al final de cada fase para confirmar que los entregables satisfacían los criterios de aceptación antes de avanzar a la siguiente. La verificación en cada punto incluyó revisiones de simulación, pruebas de síntesis, pruebas de integración y análisis estadístico, según correspondiera a la naturaleza de los entregables.

## 3.2 Diagrama de la secuencia del proceso

La Figura 3.1 ilustra las cuatro fases del proyecto, sus relaciones de dependencia y los entregables asociados a cada fase. Cada fase se alinea con un objetivo específico (OE) y genera artefactos verificables que habilitan la fase subsiguiente.

Entregables

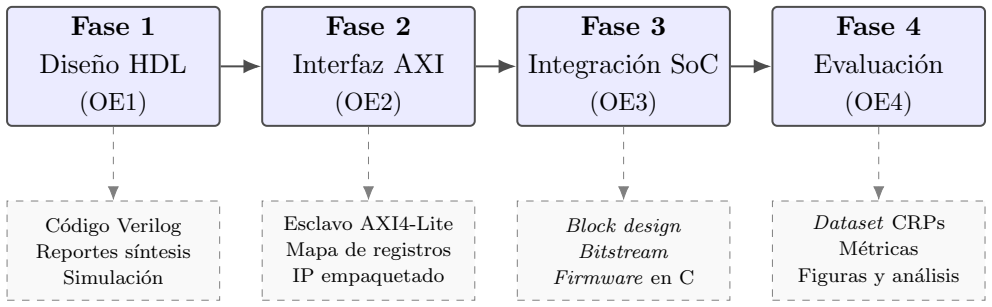
[picture p12: figure]
Fase 1; Diseño HDL; Fase 2; Interfaz AXI; Fase 3; Integración SoC; Fase 4; Evaluación; Código Verilog Reportes síntesis Simulación; Esclavo AXI4-Lite; Mapa de registros IP empaquetado; Block design Bitstream Firmware en C; Dataset CRPs Métricas Figuras y análisis

Figura 3.1: Metodología secuencial por fases del proyecto. Cada fase se alinea con un objetivo específico (OE) y produce entregables verificables que habilitan la fase siguiente.

Las cuatro fases se describen a continuación:

Fase 1 – Diseño del módulo PLPUF en HDL (OE1). Se implementó el núcleo PLPUF en Verilog siguiendo la arquitectura propuesta por Hori et al. [4]. Esta fase incluyó la definición de los parámetros del diseño, la implementación de la cadena de inversores y la máquina de estados finitos, la simulación funcional y la verificación de la síntesis con las restricciones necesarias para preservar el lazo combinacional.

Fase 2 – Desarrollo de la interfaz AXI4-Lite (OE2). A partir del módulo HDL validado en la fase anterior, se desarrolló la interfaz esclava AXI4-Lite que expone el PLPUF como periférico controlable por software. Se definió el mapa de registros, se implementó la lógica de lectura/escritura y se empaquetó el conjunto como un núcleo IP reutilizable.

Fase 3 – Integración del sistema SoC (OE3). Con el IP empaquetado, se construyó el sistema completo en Vivado IP Integrator: procesador MicroBlaze V, memoria BRAM,

3 Marco metodológico | 25

UART, módulo de depuración y el periférico PLPUF. Se generó el bitstream, se exportó el diseño a Vitis y se desarrolló el firmware de control en lenguaje C, incluyendo el driver y las aplicaciones de prueba.

Fase 4 – Evaluación estadística (OE4). Finalmente, sobre el sistema funcional se ejecutó el protocolo de evaluación exhaustiva: 10 corridas independientes con 20 desafíos, 50 repeticiones y 10 duraciones de activación, acumulando más de 140 000 evaluaciones. Se calcularon las métricas de uniformidad, confiabilidad, distancia de Hamming y efecto avalancha, y se compararon los resultados con la literatura de referencia.

## 3.3 Propuesta metodológica por objetivo

La Tabla 3.1 resume la relación detallada entre cada objetivo específico, las actividades principales realizadas, los entregables esperados, las herramientas empleadas y las estrategias de verificación y validación aplicadas.

## 3.4 Herramientas de desarrollo

A continuación se describen las herramientas de hardware y software empleadas en el proyecto. La selección de cada herramienta se fundamenta en los requisitos del diseño y en la disponibilidad de recursos proporcionados por la Escuela de Ingeniería en Computadores del TEC.

### 3.4.1 Hardware: placa Basys 3

La plataforma de desarrollo seleccionada es la placa Basys 3 de Digilent, descrita en la Sección 2.2.1. Su FPGA Artix-7 (XC7A35T-1CPG236C) ofrece recursos suficientes para instanciar el procesador MicroBlaze V junto con el periférico PLPUF y los módulos auxiliares (UART, controlador de memoria, gestión de reloj). El oscilador de 100 MHz integrado en la placa proporciona la frecuencia base del sistema, y el puerto USB-UART permite la comunicación serial con el computador anfitrión para la extracción de datos de prueba [3].

La placa fue proporcionada por la Escuela de Ingeniería en Computadores y constituye la única plataforma física de evaluación, lo que implica que los resultados experimentales corresponden a un único dispositivo FPGA [23].

### 3.4.2 AMD Vivado Design Suite

AMD Vivado Design Suite (versión 2025.1) se utilizó para todas las tareas de diseño de hardware: creación del block design con IP Integrator, empaquetado del IP personaliza-

3 Marco metodológico | 26

Tabla 3.1: Propuesta metodológica por objetivo específico.

Objetivo es-pecífico | Actividades principales | Entregables | Herramientas | Verificación
OE1: Implemen-tar el módulo PLPUF en HDL con ancho para-metrizable. | Definir arquitec-tura PLPUF. Implementar en Verilog. Simulación y síntesis. Optimización de recursos. | Código HDL del PLPUF. Reportes de síntesis. Resultados de simulación. | Vivado. Verilog. Testbenches. | Simulación funcional. Revisión de tiempos y uso de recursos.
OE2: Desarrollar una interfaz AXI-slave para el con-trol del módulo. | Diseño del mapa de registros. Implementación AXI-slave. Integración preli-minar. Pruebas de lectu-ra/escritura. | Módulo AXI-slave funcio-nal. Mapa de registros docu-mentado. | Vivado IP Integrator. Plantilla AXI4-Lite. | Validación con simulación AXI. Pruebas de comunicación con software.
OE3: Integrar el módulo en un sistema embebido completo con MicroBlaze V. | Construcción del SoC. Conexión del PLPUF vía AXI. Generación del bitstream. Desarrollo de software en Vitis. | Sistema SoC funcional. Software de control. Bitstream fi-nal. | Vivado. Vitis. UART. MicroBlaze V. | Comunicación serial exitosa. Depuración con Vitis.
OE4: Evaluar el PLPUF con métricas de segu-ridad. | Pruebas masivas de desafío-respuesta. Automatización de recolección. Análisis es-tadístico. Comparación con métricas espera-das. | Dataset de respuestas. Informe de evaluación. Gráficos y análisis. | Scripts en C. Python. Software de prueba. | Verificación repetida de muestras. Análisis es-tadístico. Revisión de consistencia.

3 Marco metodológico | 27

do del PLPUF, síntesis lógica, implementación física (place and route), verificación de restricciones temporales y generación del bitstream [24]. Vivado también se empleó para la definición de restricciones de síntesis específicas del PLPUF (lazos combinacionales, atributos DONT TOUCH) mediante archivos XDC [26].

### 3.4.3 AMD Vitis

AMD Vitis Unified Software Platform (versión 2025.1) se empleó para el desarrollo del software embebido. A partir del archivo .xsa exportado por Vivado, Vitis genera automáticamente la plataforma de hardware, el Board Support Package (BSP) y los controladores de periféricos [27]. Las aplicaciones de prueba se desarrollaron en lenguaje C, compiladas con la cadena de herramientas riscv64-unknown-elf-gcc incluida en Vitis. La carga del bitstream y del ejecutable en la FPGA se realizó a través de JTAG mediante el puerto USB J4 de la Basys 3 [27].

### 3.4.4 Terminal serial y Python

La comunicación entre la FPGA y el computador anfitrión se realizó mediante el periférico AXI UART Lite configurado a 9 600 baudios. Para la captura de los datos de salida del sistema se utilizó un emulador de terminal serial (PuTTY). Los datos recolectados en formato texto fueron procesados posteriormente con scripts en Python para generar gráficos y cálculos estadísticos complementarios.

## 3.5 Diagrama general de la solución

La Figura 3.2 muestra el diagrama general del sistema, donde los componentes se agrupan por colores según su función: en azul los componentes del SoC (procesador, memoria e interconexión), en verde el periférico PLPUF desarrollado en este proyecto, en naranja los elementos de comunicación serial y en rojo el computador anfitrión externo. Los números circundados indican el flujo de operación descrito a continuación.

El sistema se compone de los siguientes grupos de componentes:

- Componentes del SoC (azul): el procesador suave MicroBlaze V ejecuta el soft-

ware de control; la memoria BRAM almacena instrucciones y datos; el AXI Smart-Connect interconecta el procesador con los periféricos; y el módulo de depuración MDM V permite la carga de programas vía JTAG.

- Periférico PLPUF (verde): el módulo desarrollado en este proyecto, conectado

como esclavo AXI4-Lite al SmartConnect. Contiene la cadena de inversores generadora de entropía, la FSM de control y los registros de interfaz.

3 Marco metodológico | 28

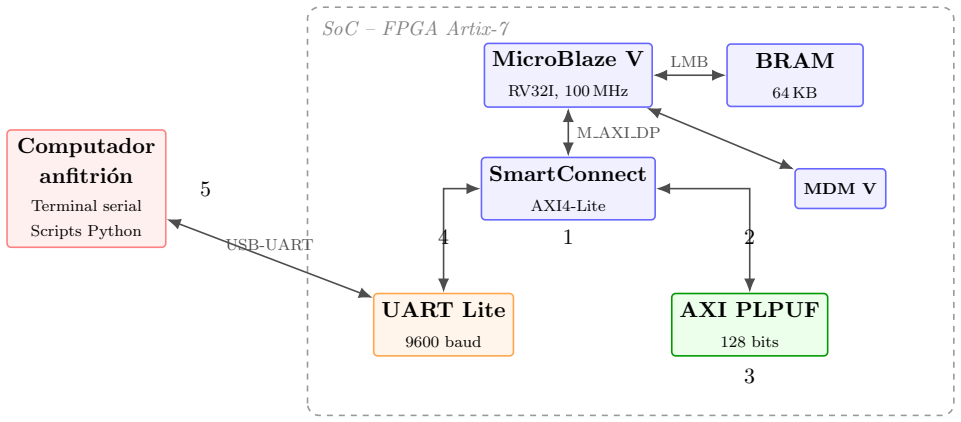
[picture p13: figure]
Computador; anfitrión; Terminal serial; Scripts Python; SoC – FPGA Artix-7; MicroBlaze V; RV32I, 100 MHz; BRAM; SmartConnect; AXI4-Lite; MDM V; UART Lite; 9600 baud; AXI PLPUF; 128 bits; LMB; M AXI DP; USB-UART

Figura 3.2: Diagrama general de la solución: sistema SoC con PLPUF integrado. Los colores agrupan los componentes por función y los números indican el flujo de operación.

- Comunicación (naranja): el periférico AXI UART Lite transmite los resultados

al exterior a través del puerto USB-UART de la Basys 3.

- Computador anfitrión (rojo): recibe los datos por terminal serial y ejecuta los

scripts de Python para el análisis estadístico.

El flujo de operación, indicado por los números circundados en la Figura 3.2, es el siguiente:

1 El software embebido, ejecutándose en MicroBlaze V, genera un desafío de 128 bits y una duración de activación c, y los envía al periférico PLPUF a través del bus AXI4-Lite vía el SmartConnect.

2 El SmartConnect enruta la transacción AXI hacia el periférico PLPUF, donde se escribe el desafío en los registros CHAL 0 a CHAL 3, la duración en DURATION y el bit de inicio en CTRL.

3 El núcleo plpuf core ejecuta la secuencia FSM: LOAD (1 ciclo) → ACTIVE (c ciclos) → DONE (1 ciclo), capturando la respuesta de 128 bits en los registros RESP 0 a RESP 3.

4 El software lee la respuesta y la transmite al computador anfitrión a través de la UART.

5 En el computador anfitrión, los datos son capturados por un emulador de terminal serial y procesados con scripts de Python para generar las métricas de evaluación y los gráficos correspondientes.

Este flujo se repite de forma automatizada para todas las combinaciones de desafíos y duraciones definidas en el protocolo de evaluación (Sección 3.10), permitiendo la recolección sistemática de los datos necesarios para la caracterización completa del PLPUF.

3 Marco metodológico | 29

Las secciones siguientes describen en detalle el diseño de cada componente del sistema, comenzando por el núcleo PLPUF, luego la interfaz AXI4-Lite, la integración del SoC, el software de control y, finalmente, el protocolo de evaluación.

## 3.6 Diseño del módulo PLPUF en HDL

Esta sección describe las decisiones de diseño adoptadas para la implementación del núcleo PLPUF en Verilog, correspondiente al archivo plpuf core.v. El diseño sigue la arquitectura propuesta por Hori et al. [4] y descrita en la Sección 2.3.2.

### 3.6.1 Visión general del módulo

La Figura 3.3 presenta el diagrama de primer nivel del módulo plpuf core, mostrando su interfaz externa como caja negra.

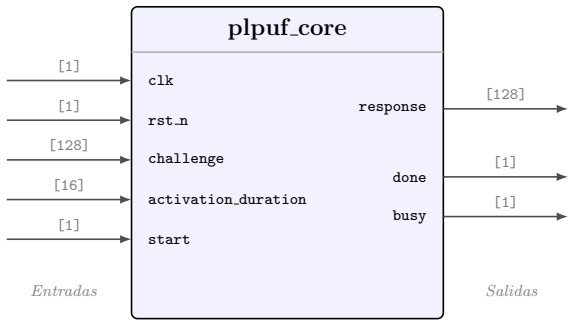
[picture p14: figure]
plpuf core; clk; rst n; challenge; activation duration; start; response; done; busy; Entradas; Salidas

Figura 3.3: Diagrama de primer nivel del módulo plpuf core: interfaz de puertos con anchos de señal.

La Tabla 3.2 describe en detalle cada puerto de la interfaz.

Tabla 3.2: Interfaz de puertos del módulo plpuf core.

Puerto | Ancho Dir. Descripción
clk | 1 | E | Reloj del sistema.
rst n | 1 | E | Reset activo en bajo.
challenge | 128 | E | Desafío de entrada.
activation duration | 16 | E | Ciclos de oscilación libre (c).
start | 1 | E | Pulso de inicio de evaluación.
response | 128 | S | Respuesta generada por el PLPUF.
done | 1 | S | Pulso de un ciclo al completar.
busy | 1 | S | Evaluación en curso.

El protocolo de operación es sencillo: el maestro escribe el desafío de 128 bits y la duración de activación, emite un pulso en start y espera a que done se active. Al finalizar, la respuesta de 128 bits está disponible en el puerto response.

3 Marco metodológico | 30

El diseño es parametrizable para facilitar su adaptación a diferentes anchos y polinomios primitivos. La Tabla 3.3 resume los cinco parámetros disponibles y sus valores por defecto.

Tabla 3.3: Parámetros configurables del módulo plpuf core.

Parámetro | Valor Descripción
WIDTH | 128 | Ancho en bits del PLPUF (tamaño del
| | desafío y la respuesta).
DURATION BITS 16 | Ancho del contador de duración de ac-
| | tivación, permite hasta 2¹⁶−1 = 65 535
| | ciclos.
TAP 1 | 125 | Posición del primer tap XOR (corres-
| | ponde al término x 126 del polinomio).
TAP 2 | 101 | Posición del segundo tap XOR (x 102).
TAP 3 | 98 | Posición del tercer tap XOR (x 99).

Las posiciones de tap corresponden al polinomio primitivo p(x) = x

| | 128+x 126+x

102+x

99+1,
el mismo utilizado en la propuesta original [4].

Internamente, el módulo se compone de dos bloques funcionales:

- Cadena de inversores con retroalimentación XOR: constituye el elemento generador de entropía, aprovechando las variaciones físicas del silicio (Sección 3.6.2).
- Máquina de estados finitos (FSM) de 4 estados: controla las fases de carga del desafío, oscilación libre y captura de la respuesta (Sección 3.6.3).

### 3.6.2 Cadena de inversores y retroalimentación

La cadena de inversores constituye el núcleo generador de entropía del PLPUF. Se compone de 128 celdas idénticas, generadas mediante un bloque generate de Verilog. Cada celda contiene un multiplexor y un inversor: durante la fase de carga, el multiplexor selecciona el bit correspondiente del desafío; durante la fase activa, selecciona la señal de retroalimentación del vecino, cerrando así el lazo combinacional.

La retroalimentación sigue la topología Fibonacci: la mayoría de las celdas reciben la salida de la celda adyacente, mientras que las celdas en las posiciones de tap (125, 101 y 98) reciben una XOR entre la salida de su vecina y la de la celda 0, reproduciendo el polinomio primitivo de 128 bits. Esta estructura forma un lazo puramente combinacional (sin registros de desplazamiento) que oscila libremente durante la fase activa, generando la entropía a partir de las variaciones de retardo del silicio [4].

3 Marco metodológico | 31

### 3.6.3 Máquina de estados finitos

El control del PLPUF se implementó mediante una FSM de cuatro estados codificada en 2 bits, cuyo diagrama de transiciones se muestra en la Figura 2.7. La secuencia de operación es la siguiente:

1. S IDLE: estado de reposo. Al recibir el pulso start, la FSM almacena el desafío y la duración de activación, y transiciona a la fase de carga.
2. S LOAD: el desafío se propaga a través de la cadena de inversores durante un ciclo de reloj, estableciendo el estado inicial del lazo.
3. S ACTIVE: la retroalimentación se cierra y la cadena oscila libremente durante c ciclos. Al finalizar, el estado de la cadena se captura como respuesta.
4. S DONE: se emite el pulso done y la FSM retorna a reposo.

### 3.6.4 Restricciones de síntesis

El lazo combinacional del PLPUF genera violaciones DRC (LUTLP-1) en Vivado, ya que la herramienta identifica correctamente la existencia de caminos combinacionales cíclicos. Para permitir la síntesis y la implementación sin errores, se definieron las siguientes restricciones en el archivo plpuf.xdc:

1. ALLOW COMBINATORIAL LOOPS: aplicado a las redes del lazo (*plpuf core inst/core in*) para permitir que Vivado acepte el ciclo combinacional.
2. DONT TOUCH: aplicado a todas las celdas del núcleo (*plpuf core inst*) para prevenir la optimización o eliminación de inversores y multiplexores durante la síntesis.
3. set false path: aplicado a las mismas redes del lazo para indicar al motor de temporización que no analice estos caminos, ya que no representan rutas de datos síncronas convencionales.

Los wildcards utilizan nombres de redes post-síntesis (core in[N], core in inferred i N) y no los nombres del bloque generate (gen core), ya que estos últimos no se preservan tras la síntesis.

## 3.7 Diseño de la interfaz AXI4-Lite

Para integrar el PLPUF como periférico controlable por software, se implementó una interfaz AXI4-Lite esclava siguiendo la plantilla estándar generada por Vivado [26]. Esta

3 Marco metodológico | 32

interfaz permite al procesador MicroBlaze V configurar el desafío y la duración de activación, iniciar la evaluación y leer la respuesta mediante operaciones de lectura/escritura sobre registros mapeados en memoria [2].

La Figura 3.4 presenta el diagrama del diseño de la interfaz, mostrando la relación entre los canales AXI, el bloque de registros y el núcleo PLPUF.

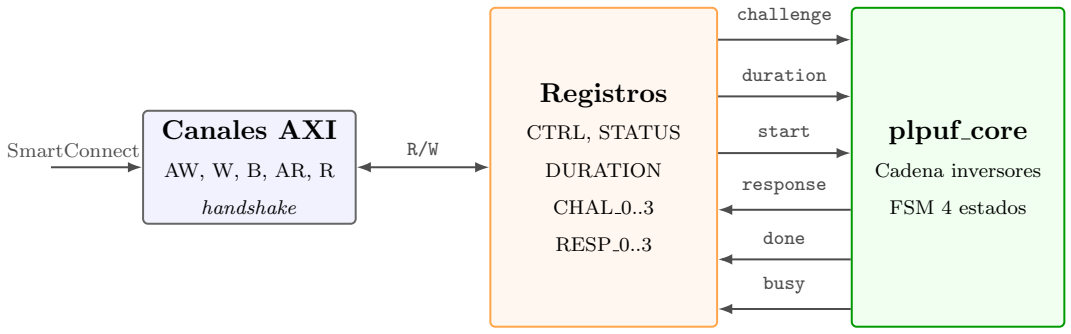
[picture p15: figure]
Canales AXI; handshake; Registros; CTRL, STATUS; DURATION; CHAL 0..3; RESP 0..3; plpuf core; Cadena inversores; FSM 4 estados; challenge; duration; start; response; done; busy; SmartConnect

Figura 3.4: Diagrama del diseño de la interfaz AXI4-Lite: los canales AXI comunican el bus con el bloque de registros, que a su vez controla el núcleo PLPUF.

### 3.7.1 Mapa de registros

El periférico expone 11 registros activos dentro de un espacio de direcciones de 64 bytes (C S AXI ADDR WIDTH = 6, equivalente a 16 ranuras de 32 bits). La Tabla 3.4 describe el mapa de registros completo.

Tabla 3.4: Mapa de registros del periférico AXI PLPUF.

Offset | Nombre | R/W | Descripción
0x00 | CTRL | R/W | [0] start: | inicia evaluación (auto-
limpia). [1] soft reset: reinicio del núcleo (auto-limpia).
0x04 | STATUS | R | [0] busy: evaluación en curso. [1] done:
evaluación completada (persistente).
0x08 | DURATION | R/W | [15:0] Duración de activación en ciclos
| | | de reloj.
0x0C | CHAL 0 | R/W | Bits [31:0] del desafío.
0x10 | CHAL 1 | R/W | Bits [63:32] del desafío.
0x14 | CHAL 2 | R/W | Bits [95:64] del desafío.
0x18 | CHAL 3 | R/W | Bits [127:96] del desafío.
0x1C | RESP 0 | R | Bits [31:0] de la respuesta.
0x20 | RESP 1 | R | Bits [63:32] de la respuesta.
0x24 | RESP 2 | R | Bits [95:64] de la respuesta.
0x28 | RESP 3 | R | Bits [127:96] de la respuesta.

3 Marco metodológico | 33

### 3.7.2 Lógica del esclavo AXI

El módulo axi plpuf slave lite v1 0 S00 AXI implementa la lógica completa del esclavo AXI4-Lite y la instanciación del plpuf core. Las características del diseño son:

- Máquinas de estado AXI: se mantuvieron las FSM de la plantilla de Vivado para los canales de escritura (estados Idle, Waddr, Wdata) y lectura (Idle, Raddr, Rdata), garantizando conformidad con el protocolo handshake VALID/READY [2].
- Escritura con tres niveles de prioridad: en un único bloque always con asigna-

ciones no bloqueantes, se definen tres capas de escritura donde la última asignación prevalece:

1. Auto-limpieza de los bits CTRL[1:0] (prioridad baja).
2. Escrituras del maestro AXI con byte strobes (WSTRB) (prioridad media).
3. Actualización de registros STATUS y RESP por el hardware del PLPUF (prioridad alta).
- Bandera done persistente (sticky): el bit done en STATUS se activa con el

pulso plpuf done y permanece activo hasta que el software escribe un nuevo start o un soft reset.

- Registros de solo lectura: los registros RESP 0 a RESP 3 se actualizan exclusiva-

mente desde el hardware; cualquier escritura AXI a estas direcciones es sobrescrita en el mismo ciclo por la capa de prioridad alta, garantizando la integridad de la respuesta.

La interconexión entre los registros y el núcleo PLPUF se realiza de la siguiente manera: el desafío de 128 bits se forma concatenando los registros CHAL 3 a CHAL 0 ({slv reg6, slv reg5, slv reg4, slv reg3}); la duración de activación se toma de los 16 bits inferiores de DURATION; y la señal de reset del núcleo combina el reset global del bus AXI con el bit de soft reset del registro CTRL.

### 3.7.3 Empaquetado del IP

Para que el módulo PLPUF sea reutilizable dentro de cualquier block design de Vivado, se empaquetó como un IP (Intellectual Property) mediante el flujo de IP Packager de Vivado [26]. El proceso genera un descriptor IP-XACT (component.xml) que encapsula:

- Los tres archivos HDL: axi plpuf.v, axi plpuf slave lite v1 0 S00 AXI.v (esclavo AXI + núcleo) y plpuf core.v.
- El driver en C (axi plpuf.h, axi plpuf.c) para generación automática del Board Support Package (BSP) en Vitis.

3 Marco metodológico | 34
- Los parámetros de la interfaz de reloj (A BUSIF = S00 AXI, A RESET = s00 axi aresetn, FREQ HZ = 100000000), necesarios para que el SmartConnect verifique la compatibilidad de dominios de reloj.

La jerarquía de módulos del IP se compone de tres niveles, como se ilustra en la Figura 3.5.

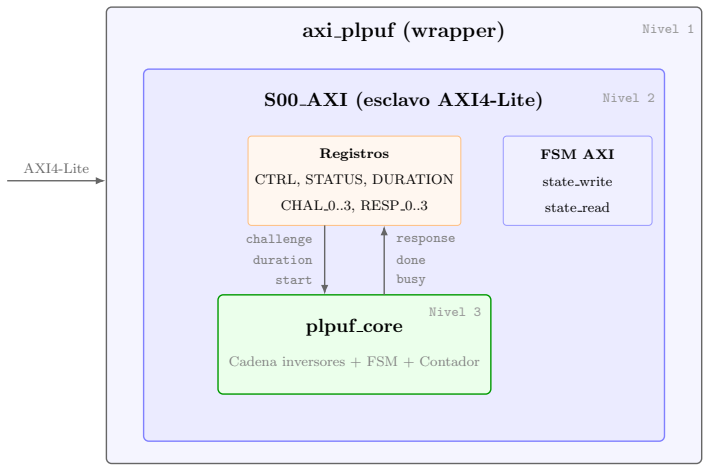
[picture p16: figure]
axi plpuf (wrapper); Nivel 1; S00 AXI (esclavo AXI4-Lite); Nivel 2; Registros; CTRL, STATUS, DURATION; CHAL 0..3, RESP 0..3; FSM AXI; state write; state read; plpuf core; Nivel 3; Cadena inversores + FSM + Contador; challenge; duration; start; response; done; busy; AXI4-Lite

Figura 3.5: Jerarquía de módulos del IP AXI PLPUF: tres niveles de encapsulamiento con el wrapper, el esclavo AXI4-Lite (registros y FSM AXI) y el núcleo PLPUF.

El wrapper axi plpuf expone la interfaz AXI4-Lite al exterior. El módulo S00 AXI contiene la lógica de decodificación de direcciones, los handshakes de los cinco canales AXI, los 16 registros de 32 bits (de los cuales 11 están activos) y las máquinas de estado de escritura y lectura. En el nivel inferior, el módulo plpuf core recibe del esclavo AXI las señales de desafío, duración, inicio y reset, y retorna la respuesta junto con las banderas de estado.

## 3.8 Integración del sistema SoC

Esta sección describe la construcción del sistema completo dentro de Vivado IP Integrator, el flujo de síntesis e implementación, y la exportación del diseño hacia Vitis para el desarrollo de software.

### 3.8.1 Diseño de bloques en Vivado

El sistema SoC se construyó como un block design en Vivado IP Integrator [24]. La Figura 3.6 muestra el diagrama de bloques completo del sistema tal como aparece en el entorno gráfico de IP Integrator, donde cada rectángulo representa un núcleo IP con sus puertos de entrada y salida, y las líneas de interconexión representan los buses AXI, las señales de reloj, reset y depuración. Los núcleos IP instanciados y sus funciones dentro del sistema son los siguientes:

3 Marco metodológico | 35
- Clocking Wizard (clk wiz 0): genera la señal de reloj de 100 MHz a partir del oscilador de la placa (pin W5).
- MicroBlaze V (microblaze riscv 0): procesador suave RISC-V configurado con

la ISA base RV32I, pipeline de 5 etapas, depuración habilitada e interfaces AXI de datos (M AXI DP) [1].

- Memoria local (BRAM + LMB): bloque de memoria RAM, 32 KB para ins-

trucciones y 32 KB para datos, conectado al procesador mediante el bus local de memoria (LMB) [25].

- MicroBlaze Debug Module V (mdm 1): módulo de depuración que permite la conexión JTAG para carga de programas y depuración paso a paso [1].
- Processor System Reset (rst clk wiz 0 100M): genera las señales de reset sin-

cronizadas para el procesador y los periféricos.

- AXI SmartConnect (axi smc): interconexión AXI con un puerto maestro y dos

puertos esclavos: uno para el UART y otro para el PLPUF. Realiza la traducción de protocolo y el arbitraje de direcciones [26].

- AXI UART Lite (axi uartlite 0): periférico UART conectado al puerto USB-

UART de la Basys 3, configurado a 9 600 baudios para la comunicación serial con el computador anfitrión.

- AXI PLPUF (axi plpuf 0): el periférico PLPUF desarrollado en este proyecto,

conectado al segundo puerto esclavo del SmartConnect.

La asignación de direcciones del sistema se resume en la Tabla 3.5.

Tabla 3.5: Mapa de direcciones del sistema SoC.

Periférico | Dirección base Rango
BRAM local (datos e instrucciones) 0x00000000 | 32 KB
AXI UART Lite | 0x40600000 | 64 KB
AXI PLPUF | 0x44A00000 | 64 KB

### 3.8.2 Flujo de síntesis e implementación

El flujo de construcción del bitstream siguió los pasos estándar de Vivado [24]:

1. Generación de productos de salida: se generaron los productos de salida de todos los IPs del block design, incluyendo los wrappers HDL.

3 Marco metodológico | 36

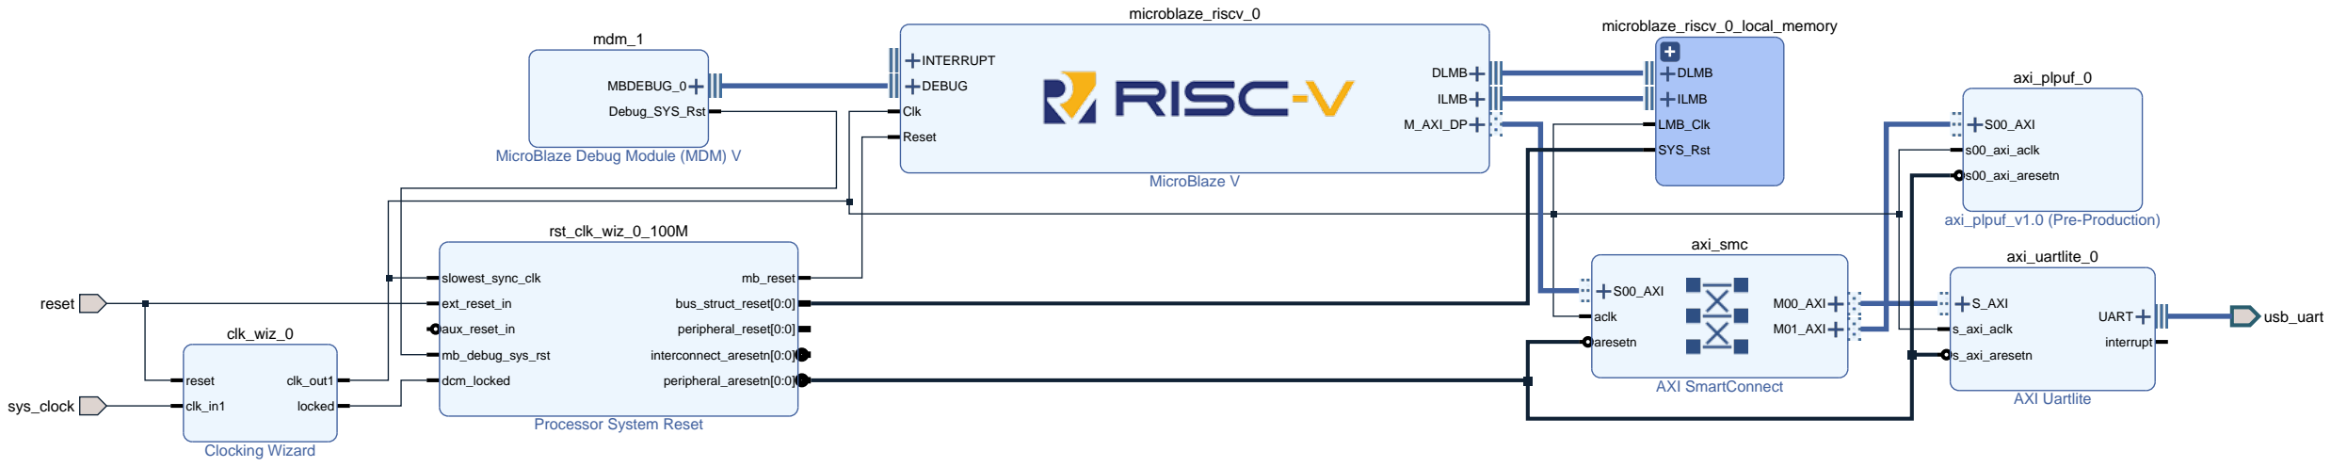
[picture p17: figure]
axi_plpuf_0; axi_plpuf_v1.0 (Pre-Production); S00_AXI; s00_axi_aclk; s00_axi_aresetn; axi_smc; AXI SmartConnect; M00_AXI M01_AXI aclk; aresetn; axi_uartlite_0; AXI Uartlite; S_AXI; UART; s_axi_aclk; s_axi_aresetn; interrupt clk_wiz_0; Clocking Wizard; reset; clk_in1; clk_out1; locked; mdm_1; MicroBlaze Debug Module (MDM) V; MBDEBUG_0 Debug_SYS_Rst; microblaze_riscv_0; MicroBlaze V; INTERRUPT; DLMB; ILMB M_AXI_DP; DEBUG; Clk Reset; microblaze_riscv_0_local_memory; ILMB; LMB_Clk SYS_Rst; sys_clock; rst_clk_wiz_0_100M; Processor System Reset; slowest_sync_clk; ext_reset_in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

Figura 3.6: Diseño de bloques del sistema SoC en Vivado IP Integrator, mostrando la interconexión entre el procesador MicroBlaze V, la memoria local (BRAM/LMB), el módulo de depuración (MDM V), el AXI SmartConnect, el periférico UART Lite y el periférico PLPUF desarrollado en este proyecto.

2. Síntesis lógica: Vivado sintetiza el diseño completo. En esta etapa se producen las advertencias DRC LUTLP-1 por el lazo combinacional del PLPUF, las cuales son resueltas por las restricciones XDC descritas en la Sección 3.6.4.
3. Implementación: Vivado realiza el placement y routing del diseño sobre los recursos de la FPGA Artix-7. Las restricciones DONT TOUCH aseguran que las celdas del PLPUF no sean reubicadas ni optimizadas.
4. Verificación de temporización: se verificó que todas las rutas de datos síncronas cumplan las restricciones temporales. Las rutas del lazo combinacional están excluidas del análisis mediante set false path.
5. Generación del bitstream: se habilitó la compresión del bitstream para reducir el tiempo de carga.

### 3.8.3 Exportación a Vitis

Una vez generado el bitstream, se exportó el hardware desde Vivado en formato .xsa (Xilinx Support Archive), que incluye:

- La descripción del hardware (mapa de direcciones, IPs instanciados, parámetros).
- El bitstream de la FPGA.
- Los metadatos necesarios para que Vitis genere el BSP con los controladores de los periféricos [27].

En Vitis, se creó una plataforma de hardware a partir del archivo .xsa y se configuró el procesador MicroBlaze V como objetivo de compilación. El BSP generado automáticamente incluye el driver del periférico PLPUF (axi plpuf.h y axi plpuf.c),

3 Marco metodológico | 37

gracias a que estos archivos fueron incluidos en el paquete IP durante el proceso de empaquetado descrito en la Sección 3.7.3 [27].

## 3.9 Desarrollo del software de control

El software embebido se organizó en tres componentes: un driver reutilizable para el periférico PLPUF, una aplicación de validación básica y una aplicación de evaluación exhaustiva. La Figura 3.7 muestra la arquitectura en capas del software.

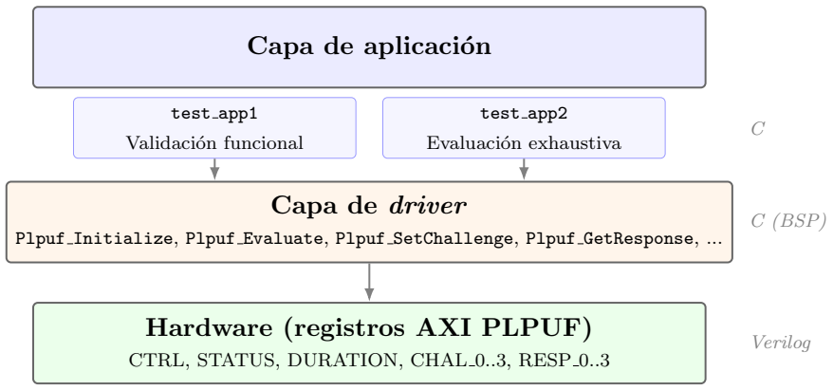
[picture p18: figure]
Capa de aplicación; test app1; Validación funcional; test app2; Evaluación exhaustiva; Capa de driver; Hardware (registros AXI PLPUF); C (BSP); Verilog

Plpuf Initialize, Plpuf Evaluate, Plpuf SetChallenge, Plpuf GetResponse, ...

CTRL, STATUS, DURATION, CHAL 0..3, RESP 0..3

Figura 3.7: Arquitectura en capas del software de control: las aplicaciones de prueba utilizan el driver del PLPUF, que a su vez accede a los registros del periférico mediante operaciones de lectura/escritura AXI.

### 3.9.1 Driver en C para el PLPUF

Se desarrolló un driver en C siguiendo las convenciones del ecosistema AMD/Xilinx (macros Xil In32/Xil Out32, aserciones Xil Assert). El driver expone una API estructurada en tres niveles:

1. Inicialización y reset: Plpuf Initialize() configura la dirección base del periférico, ejecuta un soft reset y establece la duración de activación por defecto (c = 5). Plpuf SoftReset() reinicia el núcleo PLPUF mediante el bit 1 del registro CTRL.
2. Configuración y control: Plpuf SetDuration() escribe la duración de activación; Plpuf SetChallenge() escribe los 128 bits del desafío en los cuatro registros CHAL; Plpuf Start() inicia la evaluación escribiendo el bit 0 del registro CTRL.
3. Lectura de resultados: Plpuf IsBusy() y Plpuf IsDone() consultan el registro STATUS; Plpuf WaitDone() realiza un ciclo de espera activa hasta que la evaluación finalice; Plpuf GetResponse() lee los cuatro registros RESP y almacena la respuesta de 128 bits.

3 Marco metodológico | 38

Adicionalmente, la función de conveniencia Plpuf Evaluate() encapsula el ciclo completo de evaluación en una sola llamada. La Figura 3.8 muestra el diagrama de flujo de esta función.

Plpuf Evaluate()

SetChallenge()

Start()

WaitDone()

GetResponse()

Retorna respuesta

Figura 3.8: Diagrama de flujo de la función Plpuf Evaluate(): ciclo completo de evaluación desafío-respuesta.

### 3.9.2 Aplicación de validación básica (test app1)

La primera aplicación de prueba (plpuf test app1) se diseñó como una validación funcional rápida del sistema, verificando que todos los componentes (procesador, bus AXI, periférico PLPUF, UART) operan correctamente. Las pruebas realizadas son:

1. Lectura/escritura de registros: se escribe un valor conocido en DURATION y CHAL y se verifica que la lectura retorne el mismo valor.
2. Evaluación individual: se ejecuta una evaluación con un desafío conocido y se verifica que la respuesta sea no nula (128 bits ̸= 0).
3. Repetibilidad: se ejecuta el mismo desafío 5 veces consecutivas y se comparan las respuestas. Se espera que sean idénticas o muy similares (dependiendo de la duración de activación).
4. Unicidad inter-desafío: se evalúan dos desafíos diferentes y se verifica que las respuestas sean distintas.
5. Barrido de duración: se evalúa un mismo desafío con duraciones c = 1, . . . , 10 y se imprimen todas las respuestas por UART para verificar que varían con c.

3 Marco metodológico | 39

### 3.9.3 Aplicación de evaluación exhaustiva (test app2)

La segunda aplicación (plpuf test app2) implementa el protocolo completo de evaluación estadística del PLPUF, ejecutando aproximadamente 14 000 evaluaciones por corrida sobre el hardware. Los parámetros de configuración son:

- 20 desafíos aleatorios (generados por un PRNG xorshift32 con semilla 0xDEADBEEF para reproducibilidad).
- 50 repeticiones por par desafío-duración (para votación por mayoría).
- 10 duraciones de activación (c = 1, . . . , 10).
- 32 posiciones de bit para pruebas de efecto avalancha.
- 9 evaluaciones con votación por mayoría para las respuestas golden del efecto ava-

lancha.

La aplicación calcula las siguientes métricas directamente en el dispositivo utilizando aritmética de punto fijo (multiplicación por 100 o 10 000 y división entera para obtener dos decimales):

- Uniformidad por desafío y promedio por duración.
- Confiabilidad (100 % − BER) respecto a una respuesta de referencia obtenida por votación por mayoría (golden from counts).
- BER (Bit Error Rate) promedio.
- Distancia de Hamming intra-dispositivo (entre repeticiones del mismo desafío).
- Distancia de Hamming inter-desafío (entre respuestas golden de desafíos diferentes con la misma duración).
- Mapa de estabilidad de bits: para cada posición de bit, se califica de 0 (siempre inestable) a 9 (máxima estabilidad), basado en la fracción de repeticiones que coinciden con la respuesta golden.
- Efecto avalancha: se aplican cambios de un solo bit en el desafío y se mide la distancia de Hamming respecto a la respuesta golden original [22].

Todos los resultados se imprimen por UART en formato legible para su captura y procesamiento posterior.

3 Marco metodológico | 40

## 3.10 Protocolo de evaluación del PLPUF

El protocolo de evaluación sigue las recomendaciones de Maiti et al. [22] y los criterios experimentales empleados por Hori et al. [4] en la evaluación original del PLPUF. La evaluación se realizó sobre un único dispositivo FPGA (Basys 3), por lo que las métricas reportadas corresponden a una evaluación intra-dispositivo [23].

### 3.10.1 Recolección de pares desafío-respuesta

La recolección de datos se estructuró de la siguiente manera:

1. Para cada duración de activación c ∈ {1, 2, . . . , 10}:
1.1. Se generan 20 desafíos pseudoaleatorios de 128 bits mediante el generador xorshift32 con semilla fija.
1.2. Para cada desafío, se ejecutan 50 evaluaciones consecutivas, obteniendo 50 respuestas de 128 bits.
1.3. Se construye la respuesta de referencia (golden) mediante votación por mayoría bit a bit: para cada posición, el valor del bit golden es el que aparece en más de 25 de las 50 repeticiones.
2. Total de evaluaciones: 10 × 20 × 50 = 10 000 evaluaciones principales, más las evaluaciones adicionales para el efecto avalancha.

### 3.10.2 Cálculo de métricas

A partir de los datos recolectados, se calculan las métricas definidas en la Sección 2.4.2 de la siguiente manera:

- Uniformidad: para cada respuesta golden, se calcula el peso de Hamming (Hamming weight) y se divide entre 128 para obtener la proporción de unos. El valor ideal es 50 % [22].
- Confiabilidad y BER: para cada par desafío-duración, se calcula la distancia

de Hamming fraccional entre cada una de las 50 respuestas y la respuesta golden, obteniendo el BER promedio. La confiabilidad se define como 100 % − BER [22].

- Distancia de Hamming intra-dispositivo: promedio de las distancias de Ham-

ming entre todas las repeticiones y la respuesta golden para un mismo desafío. El valor ideal es 0 [4].

3 Marco metodológico | 41
- Distancia de Hamming inter-desafío: al disponer de un solo dispositivo, la

métrica de unicidad inter-dispositivo no puede calcularse directamente. Como aproximación, se calcula la distancia de Hamming fraccional promedio entre las respuestas golden de los 20 desafíos diferentes para una misma duración. Un valor cercano a 50 % indica que el PLPUF genera respuestas suficientemente diversas ante desafíos distintos [4].

### 3.10.3 Efecto avalancha

El efecto avalancha mide la sensibilidad de la PUF a cambios mínimos en el desafío: al modificar un solo bit del desafío, idealmente el 50 % de los bits de la respuesta debería cambiar [22]. El protocolo implementado es:

1. Se selecciona un desafío base y se obtiene su respuesta golden con votación por mayoría (9 repeticiones).
2. Para cada una de las primeras 32 posiciones de bit del desafío:
2.1. Se genera un desafío modificado invirtiendo únicamente el bit en la posición j.
2.2. Se obtiene la respuesta golden del desafío modificado (9 repeticiones con votación por mayoría).
2.3. Se calcula la distancia de Hamming fraccional entre la respuesta original y la modificada.
3. Se reporta el promedio de las 32 distancias como el efecto avalancha del PLPUF.

Cabe señalar que el PLPUF, al basarse en una estructura LFSR con difusión limitada, exhibe típicamente un efecto avalancha inferior al 50 % ideal. Alsharkawy et al. [9] documentaron esta limitación y su relación con la duración de activación.

# Capítulo 4

# Descripción del trabajo realizado

## 4.1 Proceso para llegar a la solución aplicada

Esta sección detalla el proceso metodológico de ingeniería seguido para diseñar e implementar la solución, abordando secuencialmente cada uno de los objetivos específicos definidos para el proyecto. Se describen las herramientas de análisis empleadas, las abstracciones realizadas y las decisiones de diseño fundamentales que permitieron construir la plataforma de evaluación.

### 4.1.1 Implementación del módulo PLPUF en HDL

El proceso de implementación del núcleo generador de entropía inició con la abstracción del circuito PLPUF propuesto por Hori et al. [4] hacia un modelo de descripción de hardware puramente combinacional. Se decidió emplear el lenguaje Verilog, optando por una arquitectura parametrizable que facilitara el ajuste del ancho del desafío (configurado a 128 bits) y las posiciones de las compuertas lógicas de retroalimentación (polinomio primitivo).

Una decisión de diseño crítica en esta etapa fue cómo preservar el comportamiento oscilatorio del circuito durante la síntesis. Las herramientas de síntesis (EDA), como AMD Vivado, están diseñadas para optimizar la lógica combinacional y eliminar bucles asíncronos que consideran como errores de diseño. Para evitar que el sintetizador eliminara los inversores, que constituyen la fuente de entropía física del sistema, se aplicaron restricciones de diseño explícitas. Se utilizó el atributo DONT TOUCH sobre las celdas del núcleo para prevenir la absorción de lógica, y la restricción ALLOW COMBINATORIAL LOOPS en el archivo XDC para instruir a la herramienta que permitiera la existencia del lazo cerrado. Estas decisiones de síntesis fueron fundamentales para garantizar que el comportamiento analógico del silicio (los retardos de propagación microscópicos de cada compuerta debidos a las variaciones del proceso de fabricación) se preservara y pudiera ser explotado en el entorno digital del FPGA.

42

4 Descripción del trabajo realizado | 43

### 4.1.2 Desarrollo de la interfaz AXI-slave

Para habilitar el control del módulo PLPUF desde un procesador en un sistema embebido, se aplicaron principios de diseño de interfaces estandarizadas, seleccionando el protocolo AMBA AXI4-Lite por su ligereza y amplia adopción. El diseño de la interfaz partió de la definición de un mapa de registros memory-mapped I/O (MMIO) estructurado. Se abstrajo el control del hardware en 11 registros activos de 32 bits, organizados lógicamente para separar funciones de configuración (desafío, duración de activación), control operativo (inicio, reinicio) y estado (bancos de respuesta, banderas).

Una técnica de diseño clave aplicada durante el desarrollo de esta interfaz fue la implementación de una lógica de prioridades de escritura en tres niveles. Este enfoque garantizó que el hardware interno del PLPUF (prioridad alta) siempre pudiera actualizar los registros de respuesta de forma segura y oportuna, evitando condiciones de carrera o sobreescritura frente a las peticiones concurrentes del procesador (prioridad baja/media). Esta abstracción aseguró que los registros de respuesta se comportaran estrictamente como de ≪solo lectura≫ desde la perspectiva del software. Finalmente, el código HDL integrado se sintetizó y se empaquetó como un núcleo de propiedad intelectual (IP) reutilizable utilizando Vivado IP Packager, estandarizando su instanciación para ser compatible con el flujo de diseño gráfico de sistemas.

### 4.1.3 Integración del sistema SoC

La síntesis del sistema completo se realizó empleando la herramienta Vivado IP Integrator, aplicando el principio de diseño modular basado en componentes. Se construyó el System-on-Chip interconectando el módulo IP del PLPUF (creado en la etapa anterior) con componentes de biblioteca estándar: el procesador suave MicroBlaze V (configurado con la arquitectura abierta RV32I para eficiencia de área), bloques de memoria local BRAM de 64 KB para almacenamiento de instrucciones y datos, un controlador UART para comunicación exterior, y el bloque AXI SmartConnect encargado del arbitraje y enrutamiento de transacciones en el bus del sistema.

A nivel de software, el proceso de integración involucró el desarrollo de una arquitectura en capas utilizando la plataforma AMD Vitis. Se programó un controlador (driver ) de bajo nivel en lenguaje C para abstraer las direcciones físicas del hardware en una API de funciones intuitivas (como Plpuf SetChallenge o Plpuf Start). Sobre esta capa de abstracción, se construyeron las rutinas de firmware para la validación funcional y la evaluación exhaustiva. La decisión estratégica de trasladar la lógica de recolección de datos masiva y los cálculos estadísticos preliminares, como el cómputo de respuestas de referencia (golden) por votación mayoritaria, directamente al microprocesador del SoC, permitió optimizar el tiempo de ejecución del experimento y redujo sustancialmente el volumen de datos transferidos hacia el computador anfitrión.

4 Descripción del trabajo realizado | 44

### 4.1.4 Protocolo de evaluación estadística

El proceso de análisis para validar el desempeño de seguridad del módulo requirió la definición y aplicación de un protocolo experimental riguroso, fundamentado en el marco sistemático propuesto por Maiti et al. [22]. Se diseñó un experimento automatizado que ejecutó 10 ejecuciones independientes sobre el sistema físico. Para estructurar adecuadamente el espacio de prueba, se estableció para cada corrida un barrido sobre 10 duraciones de activación diferentes (c = 1, . . . , 10), evaluando en cada paso 20 desafíos pseudoaleatorios fijos, a razón de 50 repeticiones por cada par desafío-duración.

Este diseño metodológico garantizó la representatividad y significancia estadística de los datos, acumulando aproximadamente 140 000 evaluaciones del PLPUF bajo condiciones operativas controladas. El cálculo final de las métricas (uniformidad, confiabilidad, distancia de Hamming y efecto avalancha) se resolvió mediante una estrategia híbrida: el preprocesamiento in-situ en el FPGA y el postprocesamiento en el computador anfitrión mediante scripts de Python, aprovechando librerías de visualización de datos para abstraer las cifras tabulares en representaciones gráficas de análisis.

## 4.2 Análisis de los resultados finales

En esta sección se evidencia el análisis cuantitativo y cualitativo de los resultados generados por el producto desarrollado. La presentación se divide en correspondencia con la validación de cada objetivo específico, proporcionando tablas y figuras que sustentan el grado de cumplimiento técnico y las implicaciones de la plataforma.

### 4.2.1 Implementación del módulo PLPUF en HDL

La validación del diseño HDL se centró en corroborar la viabilidad de implementación en dispositivos con recursos limitados y en demostrar que el circuito efectivamente genera respuestas no predecibles fundamentadas en la entropía física del silicio.

La Tabla 4.1 muestra la utilización de recursos extraída del reporte de síntesis de Vivado tras la fase de place and route. El sistema SoC completo ocupa apenas el 12.29 % de las LUTs y el 6.37 % de los flip-flops disponibles en la FPGA Artix-7 XC7A35T, confirmando que la solución es ampliamente implementable incluso en dispositivos modestos.

Para evaluar la eficiencia del módulo PLPUF de forma aislada, la Tabla 4.2 reporta los recursos consumidos exclusivamente por el periférico axi plpuf 0. Requiere únicamente 484 LUTs (2.33 %) y 651 flip-flops (1.56 %). De estos, 128 LUTs corresponden a los inversores del núcleo combinacional preservados con el atributo DONT TOUCH. Cabe destacar que el módulo no requiere bloques DSP ni memoria BRAM, dejando estos recursos disponibles para funciones de aceleración criptográfica en futuras aplicaciones.

De forma más trascendente, el éxito del OE1 se demuestra mediante el comportamiento

4 Descripción del trabajo realizado | 45

Tabla 4.1: Utilización de recursos del sistema SoC completo sobre la FPGA Artix-7 XC7A35T tras la implementación física.

Recurso | Usados | Disponibles | Util. (%)
Slice LUTs | 2 556 | 20 800 | 12.29
LUT como lógica | 2 449 | 20 800 | 11.77
LUT como memoria | 107 | 9 600 | 1.11
Slice Registers | 2 650 | 41 600 | 6.37
Slices ocupados | 978 | 8 150 | 12.00
F7 Muxes | 83 | 16 300 | 0.51
F8 Muxes | 33 | 8 150 | 0.40
Bloques RAM (RAMB36E1) | 16 | 50 | 32.00

Tabla 4.2: Utilización de recursos del periférico AXI PLPUF y del procesador Micro-Blaze V, según el reporte de síntesis individual.

Componente | LUTs | FFs | F7/F8 Muxes | BRAM
AXI PLPUF (axi plpuf 0) | 484 | 651 | 64 / 32 | 0
MicroBlaze V (microblaze riscv 0) | 1 768 | 1 285 | 19 / 1 | 0

estadístico de la uniformidad de bits en la salida (analizada en detalle en la Sección 4.2.4). Dado que el circuito diseñado es estricta y puramente lógico digital estándar, la única forma de que sus salidas se asemejen a distribuciones pseudoaleatorias con proporciones de ceros y unos balanceadas (∼50 %) es debido a que la lógica está explotando con éxito las minúsculas variaciones físicas de los retardos en los caminos de los transistores. La ausencia de sesgo en las mediciones empíricas certifica que las restricciones impuestas en Vivado funcionaron y el PLPUF extrae la entropía inherente del hardware, en lugar de optimizarse hacia un estado constante.

### 4.2.2 Pruebas de la interfaz AXI

Antes de realizar la evaluación masiva de seguridad, se realizaron pruebas de validación funcional específicas (test app1) ejecutadas por el MicroBlaze V para comprobar rigurosamente el protocolo de comunicación de la interfaz AXI-slave.

En la Figura 4.1 se reproduce la salida completa de la consola serie tras ejecutar la aplicación test app1 en el hardware. Se observan claramente las cinco pruebas implementadas en el código:

1. Prueba de lectura/escritura de registros (Test 1): Se escribe el valor 100 en el registro de duración y se lee posteriormente, obteniendo el mismo valor; análogamente, se escriben y leen sin alteración los registros de desafío (CHAL0

4 Descripción del trabajo realizado | 46

y CHAL1). Todos los pasos se muestran con el marcador [PASS].

2. Evaluación única (Test 2): Se lanza una operación PUF con un desafío fijo y se imprime la respuesta de 128 bits. La salida no es nula, lo que confirma que el núcleo genera una respuesta activa.
3. Prueba de repetibilidad (Test 3): Se ejecuta cinco veces la misma operación (mismo desafío y misma duración, c = 5 por defecto). Las líneas etiquetadas como Run: muestran respuestas ligeramente diferentes en cada iteración.
4. Prueba de unicidad (Test 4): Se comparan las respuestas para dos desafíos distintos. La salida muestra valores claramente diferentes (Challenge A resp vs. Challenge B resp), y el test declara [PASS] al no ser idénticas.
5. Barrido de duración (Test 5): Se varía el parámetro de activación c de 1 a 10, y para cada valor se imprime la respuesta correspondiente. Se aprecia cómo cambia la salida al modificar la duración del pulso de activación.

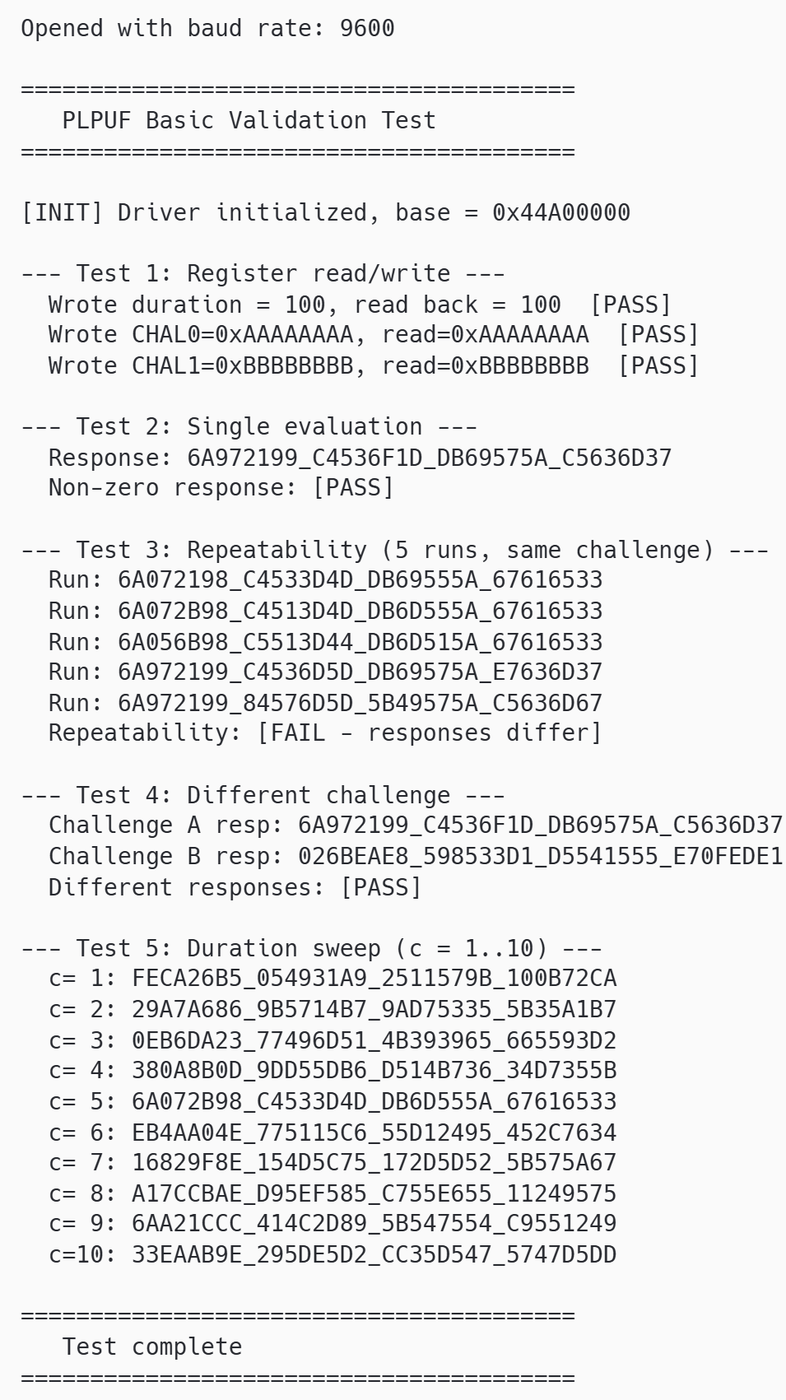
[picture p19: figure]

Figura 4.1: Resultados obtenidos al ejecutar test app1.

4 Descripción del trabajo realizado | 47

### 4.2.3 Prueba de integración del SoC

La prueba integral del SoC se comprobó mediante la ejecución exitosa de la aplicación de evaluación exhaustiva (test app2). Esta prueba demostró la correcta interoperabilidad de todos los componentes del sistema trabajando en conjunto: el procesador MicroBlaze V ejecutando el firmware desde la memoria BRAM, el bloque AXI SmartConnect enrutando exitosamente las transacciones en el bus, el módulo PLPUF respondiendo a las peticiones en hardware y el controlador UART transmitiendo los resultados hacia el computador anfitrión.

La ejecución autónoma del protocolo permitió recolectar aproximadamente 140 000 respuestas del sistema de forma ininterrumpida. La estabilidad operacional lograda a lo largo de las 10 ejecuciones independientes evidencia una comunicación bidireccional USB-UART con cero pérdida de información. Esta prueba de resistencia (end-to-end) constituye la evidencia definitiva del logro exitoso del OE3 y confirma la conformación de un sistema embebido estable, apto para el prototipado en seguridad de la información.

Los resultados obtenidos para 1 de las 10 ejecuciones independientes de test app2 se muestran en las Figuras 4.2 a 4.6. En primer lugar, la Figura 4.2 recoge la verificación de la interfaz de registro y la funcionalidad de reinicio suave (soft reset). Se observa que la lectura y escritura de los registros DURATION, CHAL 0 y CHAL 3 son correctas, mientras que el registro RESP 0 se comporta como solo lectura (no permite escritura). Además, el reinicio suave limpia correctamente el bit done del registro de estado. Todos estos tests superan la validación, lo que confirma que el núcleo PLPUF responde adecuadamente a las transacciones del bus AXI y que la integración del sistema es sólida.

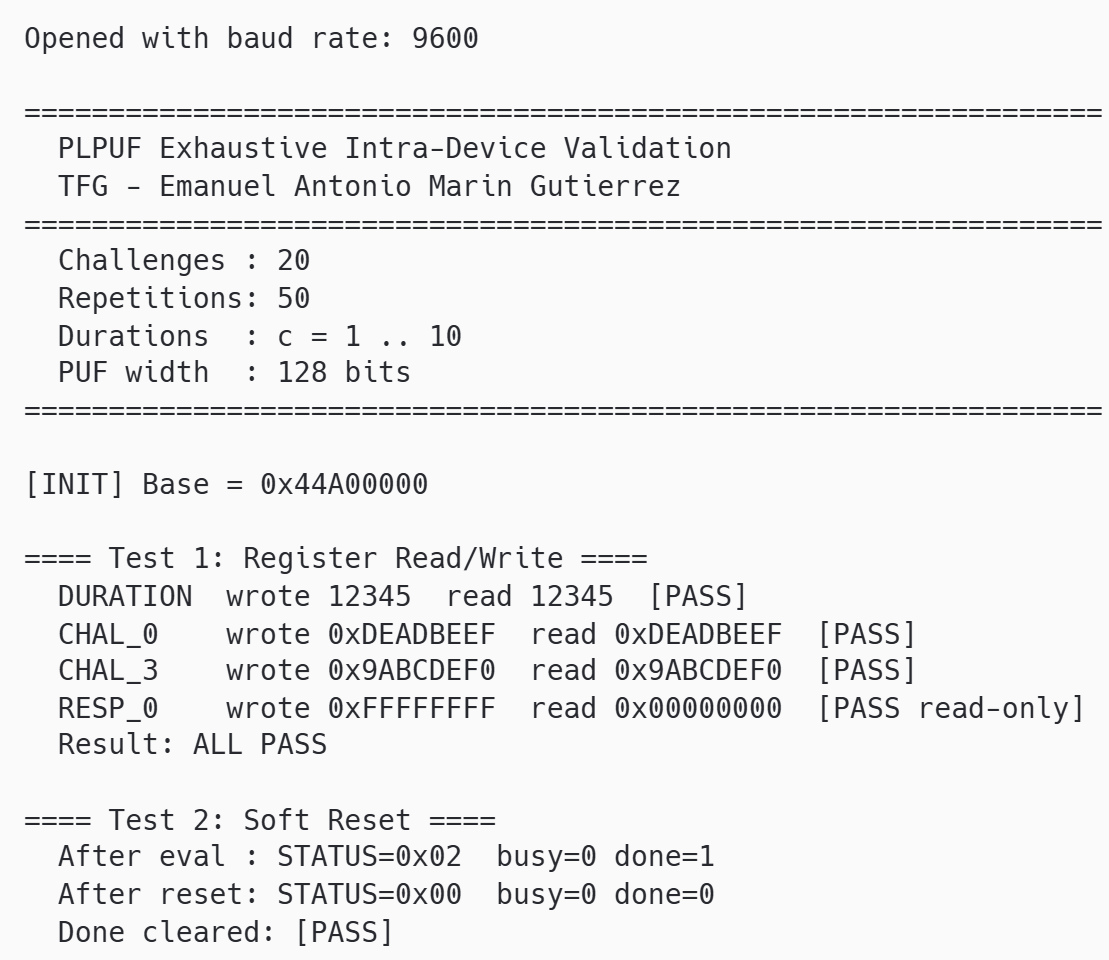
[picture p20: figure]

Figura 4.2: Verificación de la interfaz de registros y funcionalidad de reinicio suave.

4 Descripción del trabajo realizado | 48

La Figura 4.3 presenta el barrido de duración de activación c desde 1 hasta 10. En ella se aprecia claramente la compensación entre fiabilidad y unicidad: para valores pequeños de c (1 a 4) la fiabilidad es superior al 95 % (BER inferior al 5 %), mientras que la uniformidad se mantiene muy próxima al 50 % ideal. A medida que aumenta c, la fiabilidad desciende gradualmente hasta el 89 % para c = 10, y el IntraHD (distancia de Hamming intra-dispositivo) crece hasta 15.67, lo que indica una mayor inestabilidad de la respuesta. Por otra parte, el InterHD (distancia de Hamming entre diferentes desafíos) se aleja del 50 % ideal a medida que c aumenta, pasando de un 48.46 % en c = 1 a un 37.65 % en c = 10. Esto sugiere que para valores altos de c la respuesta del PUF se vuelve menos única y más dependiente del desafío.

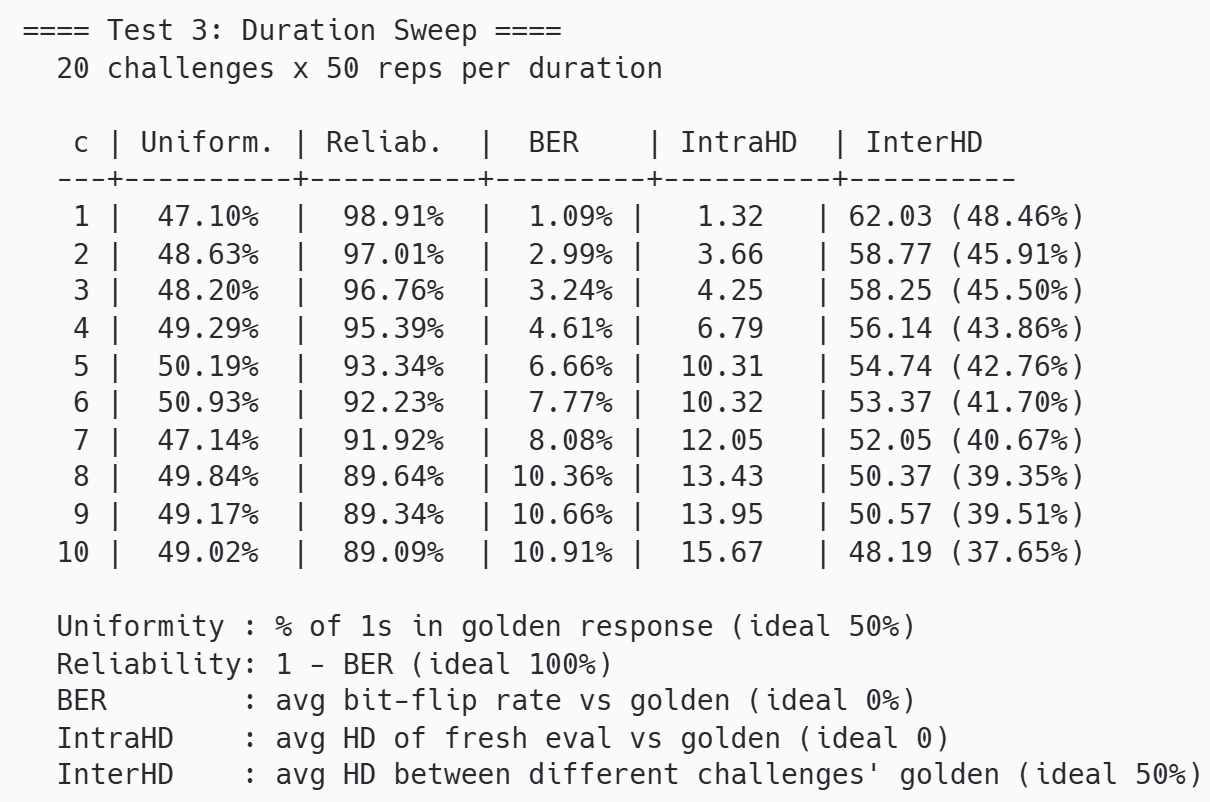
[picture p21: figure]

Figura 4.3: Barrido de duración de activación (c = 1 . . . 10): uniformidad, fiabilidad, BER, IntraHD e InterHD.

La Figura 4.4 muestra las 50 respuestas crudas obtenidas para el primer desafío con c = 5, junto con la respuesta golden calculada por mayoría de votos. Se observan pequeñas variaciones entre las diferentes evaluaciones, como era de esperar por la presencia de ruido y metaestabilidad. Estas variaciones son consistentes con el BER de 6.66 % reportado en la Figura 4.3 para c = 5.

4 Descripción del trabajo realizado | 49

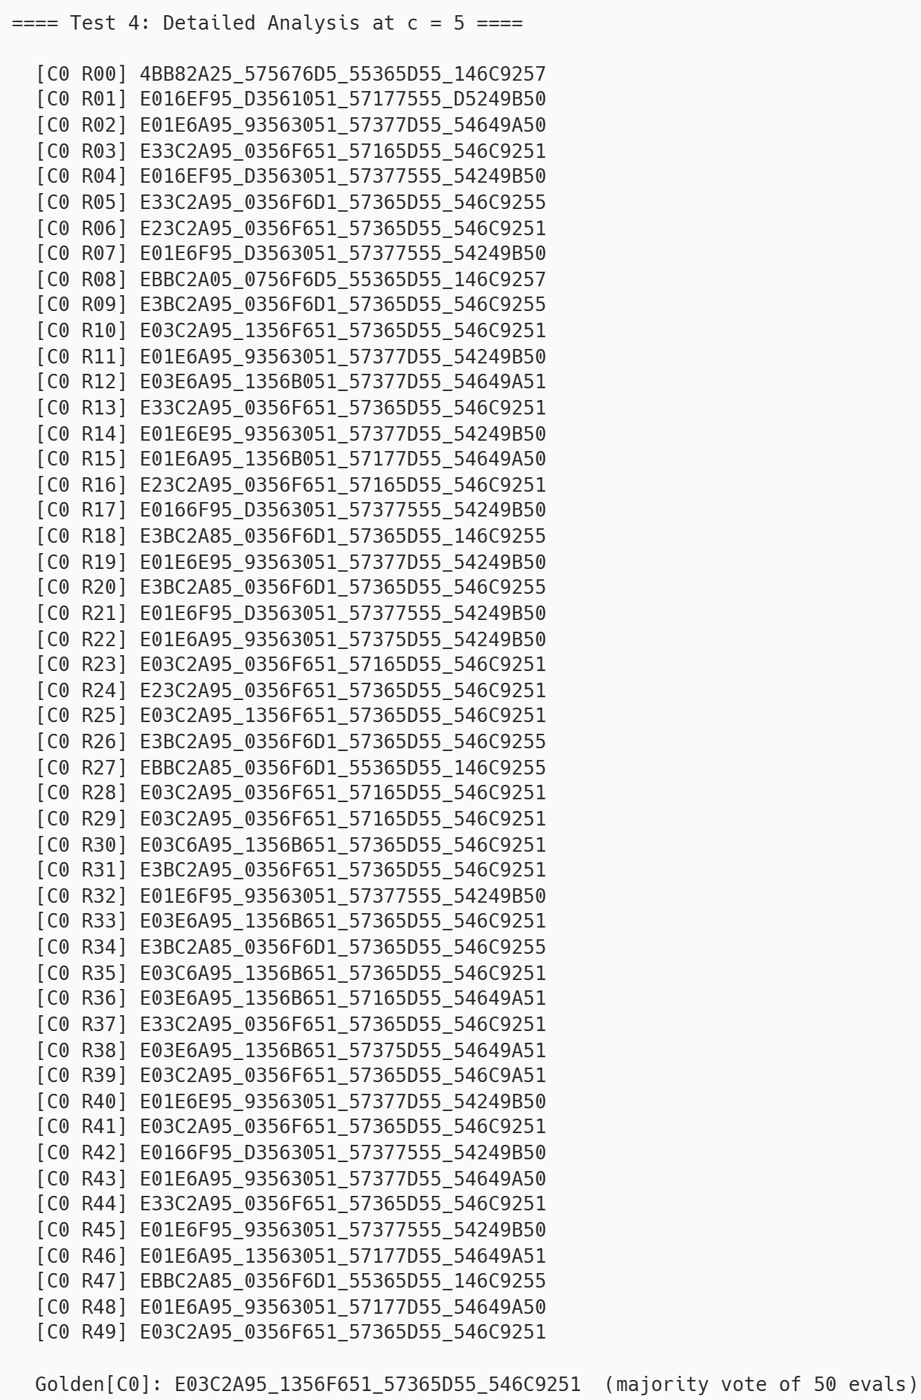
[picture p22: figure]

Figura 4.4: Respuestas crudas (50 evaluaciones) y respuesta golden (mayoría de votos) para el desafío 0 con c = 5.

El análisis de estabilidad por bit y el histograma de distancias intra-dispositivo se presentan en la Figura 4.5. En el mapa de estabilidad (parte superior) se asigna a cada bit un grado de fiabilidad del 0 (muy ruidoso) al 9 (muy estable). Se observa que 40 de los 128 bits son estables (fiabilidad ≥ 95 %) y ningún bit es ruidoso (fiabilidad < 80 %), lo que indica un comportamiento aceptable. El histograma de IntraHD (parte inferior) muestra que la mayoría de las distancias de Hamming entre una evaluación fresca y la respuesta golden se concentran en los primeros 15 bits, con un máximo de 55 ocurrencias en el rango 5–9. No se registran distancias superiores a 29 bits, lo que confirma que las respuestas son bastante repetibles y que la mayoría de las variaciones son pequeñas.

4 Descripción del trabajo realizado | 50

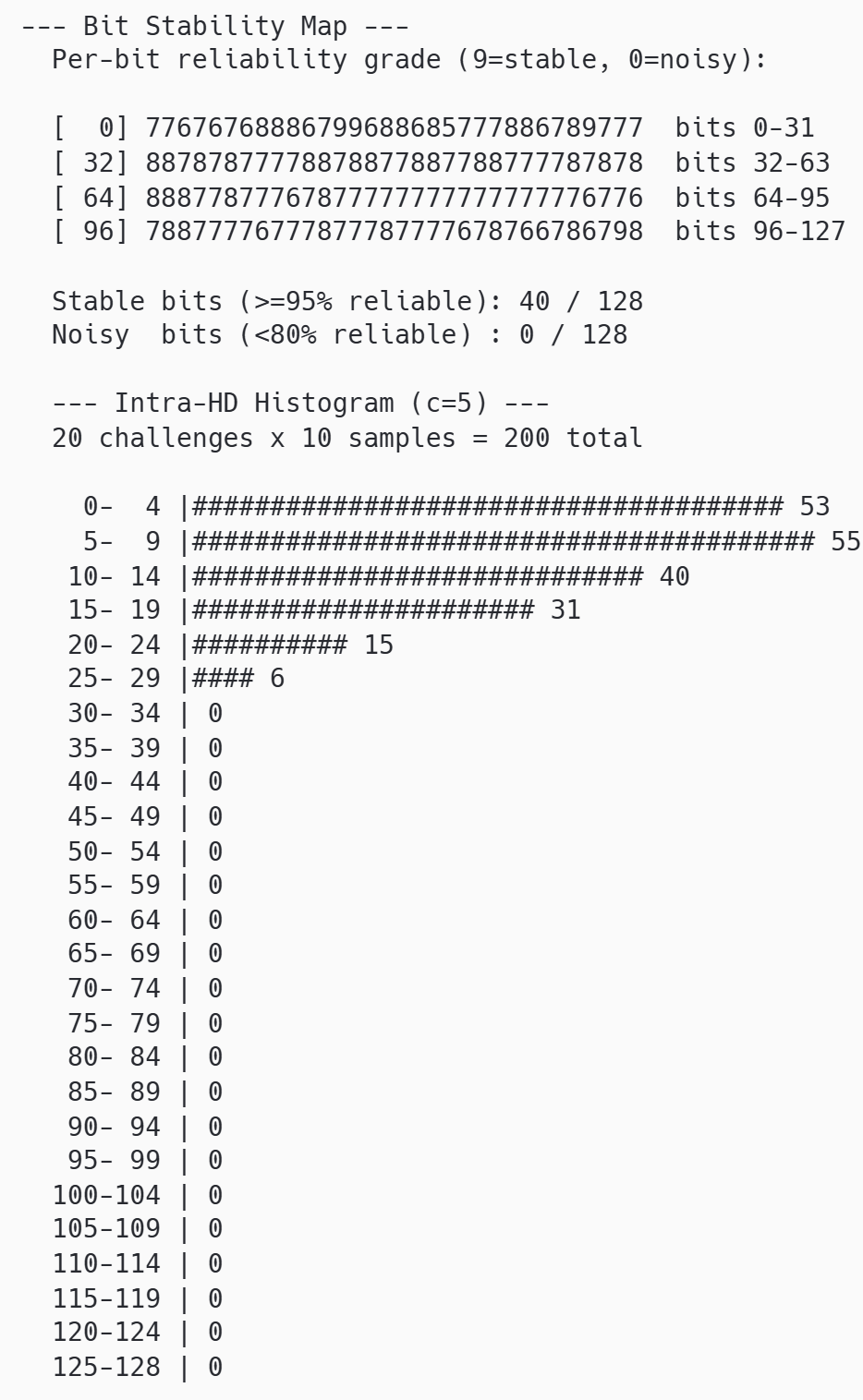
[picture p23: figure]

Figura 4.5: Mapa de estabilidad por bit (grado 9 = estable, 0 = ruidoso) e histograma de distancias de Hamming intra-dispositivo para c = 5.

Finalmente, la Figura 4.6 evalúa el efecto avalancha para c = 5. Se mide la distancia de Hamming entre la respuesta golden del desafío base y la obtenida al modificar un único bit del desafío. El promedio de cambio observado es tan solo del 9.13 %, muy alejado del 50 % ideal que caracterizaría una función criptográficamente fuerte. Esto indica que el PLPUF implementado no presenta un efecto avalancha satisfactorio, lo cual es esperable por tratarse de un PUF basado en osciladores de anillo no lineal (no es una función hash). Este resultado deberá tenerse en cuenta si se pretende utilizar el PUF en aplicaciones que requieran una alta sensibilidad al cambio del desafío.

4 Descripción del trabajo realizado | 51

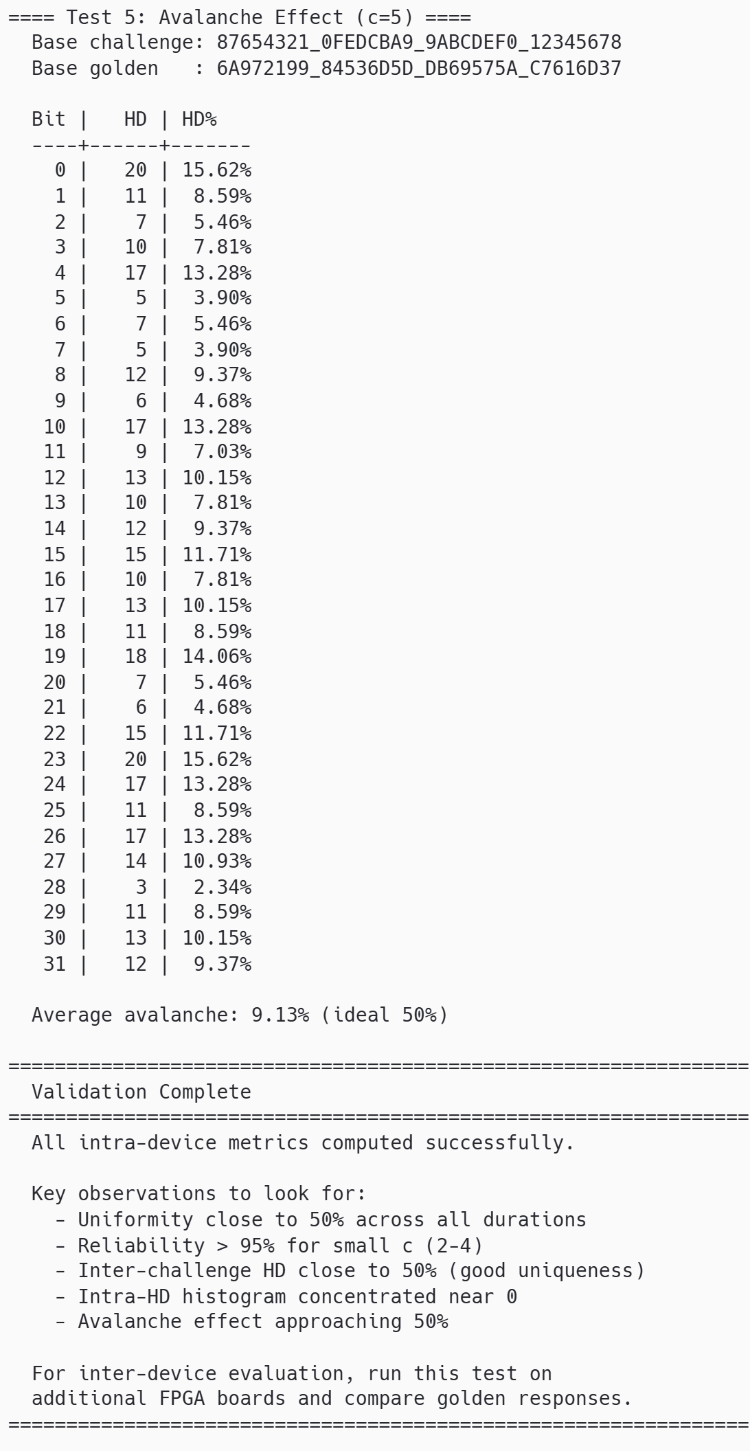
[picture p24: figure]

Figura 4.6: Efecto avalancha para c = 5: distancia de Hamming (en bits y porcentaje) al modificar cada bit del desafío.

4 Descripción del trabajo realizado | 52
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
