MarinGE23/axi-plpuf-ip/docu/Anteproyecto_PLPUF_EmanuelMarin.pdf

## Instituto Tecnológico de Costa Rica

## Escuela de Ingeniería en Computadores

(Computer Engineering School)

## Programa de Licenciatura en Ingeniería en Computadores

(Licentiate Degree Program in Computer Engineering)

## Diseño e integración de un módulo PLPUF programable para sistemas embebidos

(Design and Integration of a Programmable PLPUF Module for Embedded Systems)

### Informe del Anteproyecto para el Trabajo Final de Graduación

(Report of Pre-project for a Graduation Work in fulfillment of the requirements for the degree of Licentiate in Computer Engineering)

## Emanuel Antonio Marín Gutiérrez

## Cartago, Noviembre, 2025

(Cartago, November, 2025)

## Contenidos

## 1. Palabras Clave

PLPUF, Sistemas embebidos, FPGA, MicroBlaze V, Interfaz AXI, Autenticación y Seguridad de hardware.

## 2. Introducción

La creciente demanda por sistemas embebidos seguros en aplicaciones como el Internet de las Cosas (IoT), dispositivos móviles y sistemas industriales ha resaltado la necesidad de mecanismos robustos de autenticación y protección de información. En este contexto, los PUFs (Physical Unclonable Functions) han emergido como una solución prometedora para generar identificadores únicos y seguros directamente desde las características físicas del hardware. Estas funciones permiten aprovechar las variaciones inherentes del proceso de fabricación de los circuitos para producir respuestas irrepetibles frente a desafíos específicos, sin almacenar claves sensibles de forma permanente.

Entre las diferentes arquitecturas de PUFs, la variante denominada PLPUF (Pseudo Linear Feedback Shift Register PUF) destaca por su eficiencia, compacidad y capacidad de personalización mediante la modificación del parámetro de duración de activación. Estas características lo convierten en una opción ideal para sistemas embebidos con recursos limitados, como los basados en FPGAs y procesadores suaves como el MicroBlaze V.

Este anteproyecto plantea el diseño e integración de un módulo PLPUF programable que permita ser incorporado directamente en sistemas System-on-Chip (SoC) a través del estándar de comunicación AXI. El módulo está orientado a su uso dentro de un entorno de desarrollo en FPGA, y su control se realizará desde el procesador MicroBlaze V, permitiendo evaluar su aplicabilidad para generación de claves dinámicas, autenticación de dispositivos y soporte a sistemas criptográficos modernos.

El desarrollo propuesto no solo busca contribuir a la seguridad de los sistemas embebidos, sino también a la investigación académica, proporcionando una plataforma experimental abierta para el estudio de técnicas de protección de hardware y evaluación de la confiabilidad y resistencia de los PUFs ante amenazas modernas.

## 3. Contexto y Antecedentes

### 3.1. Descripción de la empresa

El Instituto Tecnológico de Costa Rica (TEC) es una institución pública de educación superior creada en 1971 con el objetivo de impulsar el desarrollo científico y tecnológico del país. A lo largo de las décadas, el TEC ha consolidado una sólida reputación como referente nacional en formación profesional e investigación aplicada en áreas clave para la transformación productiva y social. Su enfoque se basa en la excelencia académica, la innovación tecnológica y el compromiso con el desarrollo sostenible.

El proyecto propuesto será desarrollado en la Escuela de Ingeniería en Computadores, una unidad académica del TEC orientada a la integración de conocimientos en Electrónica y Ciencias de la Computación. Esta escuela fomenta activamente la participación estudiantil en proyectos de investigación y desarrollo en temas como diseño digital, sistemas embebidos, verificación de hardware, inteligencia artificial y seguridad informática.
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
