MarinGE23/axi-plpuf-ip/documento_tfg_emanuel_marin_overleaf/Documento_TFG_EmanuelMarin/fig/methodology_phases.png

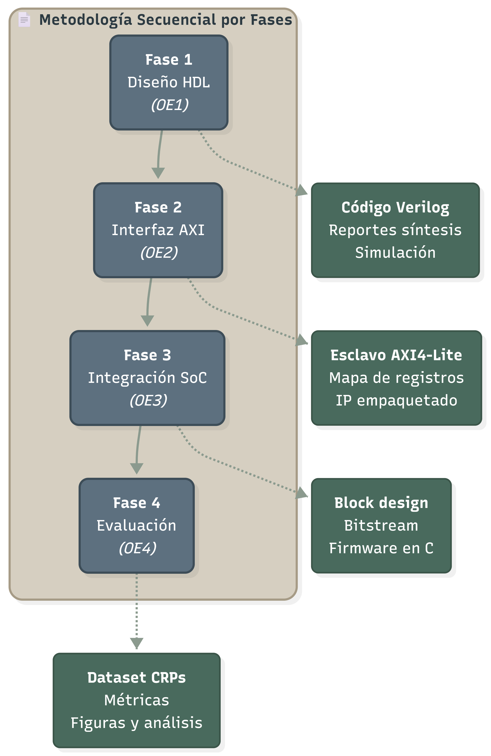
documento_tfg_emanuel_marin_overleaf/Documento_TFG_EmanuelMarin/fig/methodology_phases.png
