MarinGE23/axi-plpuf-ip/documento_tfg_emanuel_marin_overleaf/Documento_TFG_EmanuelMarin/fig/system_diagram.png

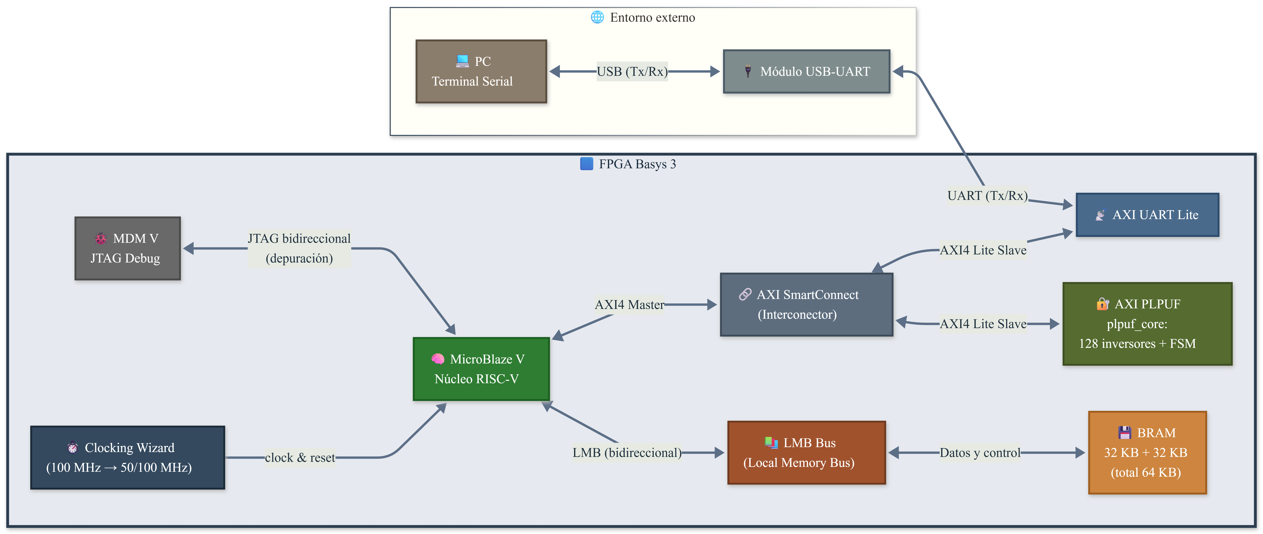
documento_tfg_emanuel_marin_overleaf/Documento_TFG_EmanuelMarin/fig/system_diagram.png
