MarinGE23/axi-plpuf-ip/vitis-axi-plpuf/platform/microblaze_riscv_0/standalone_microblaze_riscv_0/bsp/libsrc/build_configs/gen_bsp/install_manifest.txt

C:/Users/emari/Desktop/axi-plpuf-ip/vitis-axi-plpuf/platform/microblaze_riscv_0/standalone_microblaze_riscv_0/bsp/include/../include/bspconfig.h
C:/Users/emari/Desktop/axi-plpuf-ip/vitis-axi-plpuf/platform/microblaze_riscv_0/standalone_microblaze_riscv_0/bsp/include/../include/fsl.h
C:/Users/emari/Desktop/axi-plpuf-ip/vitis-axi-plpuf/platform/microblaze_riscv_0/standalone_microblaze_riscv_0/bsp/include/../include/riscv_exceptions_g.h
C:/Users/emari/Desktop/axi-plpuf-ip/vitis-axi-plpuf/platform/microblaze_riscv_0/standalone_microblaze_riscv_0/bsp/include/../include/riscv_interface.h
C:/Users/emari/Desktop/axi-plpuf-ip/vitis-axi-plpuf/platform/microblaze_riscv_0/standalone_microblaze_riscv_0/bsp/include/../include/sleep.h
C:/Users/emari/Desktop/axi-plpuf-ip/vitis-axi-plpuf/platform/microblaze_riscv_0/standalone_microblaze_riscv_0/bsp/include/../include/xbasic_types.h
C:/Users/emari/Desktop/axi-plpuf-ip/vitis-axi-plpuf/platform/microblaze_riscv_0/standalone_microblaze_riscv_0/bsp/include/../include/xbram.h
C:/Users/emari/Desktop/axi-plpuf-ip/vitis-axi-plpuf/platform/microblaze_riscv_0/standalone_microblaze_riscv_0/bsp/include/../include/xbram_hw.h
C:/Users/emari/Desktop/axi-plpuf-ip/vitis-axi-plpuf/platform/microblaze_riscv_0/standalone_microblaze_riscv_0/bsp/include/../include/xcommon_drv_config.h
C:/Users/emari/Desktop/axi-plpuf-ip/vitis-axi-plpuf/platform/microblaze_riscv_0/standalone_microblaze_riscv_0/bsp/include/../include/xdebug.h
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
C:/Users/emari/Desktop/axi-plpuf-ip/vitis-axi-plpuf/platform/microblaze_riscv_0/standalone_microblaze_riscv_0/bsp/include/../include/xplatform_info.h
C:/Users/emari/Desktop/axi-plpuf-ip/vitis-axi-plpuf/platform/microblaze_riscv_0/standalone_microblaze_riscv_0/bsp/include/../include/xpseudo_asm.h
C:/Users/emari/Desktop/axi-plpuf-ip/vitis-axi-plpuf/platform/microblaze_riscv_0/standalone_microblaze_riscv_0/bsp/include/../include/xpseudo_asm_gcc.h
C:/Users/emari/Desktop/axi-plpuf-ip/vitis-axi-plpuf/platform/microblaze_riscv_0/standalone_microblaze_riscv_0/bsp/include/../include/xreg_riscv.h
C:/Users/emari/Desktop/axi-plpuf-ip/vitis-axi-plpuf/platform/microblaze_riscv_0/standalone_microblaze_riscv_0/bsp/include/../include/xstatus.h
C:/Users/emari/Desktop/axi-plpuf-ip/vitis-axi-plpuf/platform/microblaze_riscv_0/standalone_microblaze_riscv_0/bsp/include/../include/xtimer_config.h
C:/Users/emari/Desktop/axi-plpuf-ip/vitis-axi-plpuf/platform/microblaze_riscv_0/standalone_microblaze_riscv_0/bsp/include/../include/xuartlite.h
C:/Users/emari/Desktop/axi-plpuf-ip/vitis-axi-plpuf/platform/microblaze_riscv_0/standalone_microblaze_riscv_0/bsp/include/../include/xuartlite_i.h
C:/Users/emari/Desktop/axi-plpuf-ip/vitis-axi-plpuf/platform/microblaze_riscv_0/standalone_microblaze_riscv_0/bsp/include/../include/xuartlite_l.h
