MarinGE23/axi-plpuf-ip/vitis-axi-plpuf/plpuf_test_app2/plpuf_test_app2_tests/plpuf_test_app2_1.txt

Opened with baud rate: 9600

================================================================
  PLPUF Exhaustive Intra-Device Validation
  TFG - Emanuel Antonio Marin Gutierrez
================================================================
  Challenges : 20
  Repetitions: 50
  Durations  : c = 1 .. 10
  PUF width  : 128 bits
================================================================

[INIT] Base = 0x44A00000

==== Test 1: Register Read/Write ====
  DURATION  wrote 12345  read 12345  [PASS]
  CHAL_0    wrote 0xDEADBEEF  read 0xDEADBEEF  [PASS]
  CHAL_3    wrote 0x9ABCDEF0  read 0x9ABCDEF0  [PASS]
  RESP_0    wrote 0xFFFFFFFF  read 0x00000000  [PASS read-only]
  Result: ALL PASS

==== Test 2: Soft Reset ====
  After eval : STATUS=0x02  busy=0 done=1
  After reset: STATUS=0x00  busy=0 done=0
  Done cleared: [PASS]

==== Test 3: Duration Sweep ====
  20 challenges x 50 reps per duration

   c | Uniform. | Reliab.  |  BER    | IntraHD  | InterHD
  ---+----------+----------+---------+----------+----------
   1 |  47.10%  |  98.91%  |  1.09% |   1.32   | 62.03 (48.46%)
   2 |  48.63%  |  97.01%  |  2.99% |   3.66   | 58.77 (45.91%)
   3 |  48.20%  |  96.76%  |  3.24% |   4.25   | 58.25 (45.50%)
   4 |  49.29%  |  95.39%  |  4.61% |   6.79   | 56.14 (43.86%)
   5 |  50.19%  |  93.34%  |  6.66% |  10.31   | 54.74 (42.76%)
   6 |  50.93%  |  92.23%  |  7.77% |  10.32   | 53.37 (41.70%)
   7 |  47.14%  |  91.92%  |  8.08% |  12.05   | 52.05 (40.67%)
   8 |  49.84%  |  89.64%  | 10.36% |  13.43   | 50.37 (39.35%)
   9 |  49.17%  |  89.34%  | 10.66% |  13.95   | 50.57 (39.51%)
  10 |  49.02%  |  89.09%  | 10.91% |  15.67   | 48.19 (37.65%)

  Uniformity : % of 1s in golden response (ideal 50%)
  Reliability: 1 - BER (ideal 100%)
  BER        : avg bit-flip rate vs golden (ideal 0%)
  IntraHD    : avg HD of fresh eval vs golden (ideal 0)
  InterHD    : avg HD between different challenges' golden (ideal 50%)

==== Test 4: Detailed Analysis at c = 5 ====

  [C0 R00] 4BB82A25_575676D5_55365D55_146C9257
  [C0 R01] E016EF95_D3561051_57177555_D5249B50
  [C0 R02] E01E6A95_93563051_57377D55_54649A50
  [C0 R03] E33C2A95_0356F651_57165D55_546C9251
  [C0 R04] E016EF95_D3563051_57377555_54249B50
  [C0 R05] E33C2A95_0356F6D1_57365D55_546C9255
  [C0 R06] E23C2A95_0356F651_57365D55_546C9251
  [C0 R07] E01E6F95_D3563051_57377555_54249B50
  [C0 R08] EBBC2A05_0756F6D5_55365D55_146C9257
  [C0 R09] E3BC2A95_0356F6D1_57365D55_546C9255
  [C0 R10] E03C2A95_1356F651_57365D55_546C9251
  [C0 R11] E01E6A95_93563051_57377D55_54249B50
  [C0 R12] E03E6A95_1356B051_57377D55_54649A51
  [C0 R13] E33C2A95_0356F651_57365D55_546C9251
  [C0 R14] E01E6E95_93563051_57377D55_54249B50
  [C0 R15] E01E6A95_1356B051_57177D55_54649A50
  [C0 R16] E23C2A95_0356F651_57165D55_546C9251
  [C0 R17] E0166F95_D3563051_57377555_54249B50
  [C0 R18] E3BC2A85_0356F6D1_57365D55_146C9255
  [C0 R19] E01E6E95_93563051_57377D55_54249B50
  [C0 R20] E3BC2A85_0356F6D1_57365D55_546C9255
  [C0 R21] E01E6F95_D3563051_57377555_54249B50
  [C0 R22] E01E6A95_93563051_57375D55_54249B50
  [C0 R23] E03C2A95_0356F651_57165D55_546C9251
  [C0 R24] E23C2A95_0356F651_57365D55_546C9251
  [C0 R25] E03C2A95_1356F651_57365D55_546C9251
  [C0 R26] E3BC2A95_0356F6D1_57365D55_546C9255
  [C0 R27] EBBC2A85_0356F6D1_55365D55_146C9255
  [C0 R28] E03C2A95_0356F651_57165D55_546C9251
  [C0 R29] E03C2A95_0356F651_57165D55_546C9251
  [C0 R30] E03C6A95_1356B651_57365D55_546C9251
  [C0 R31] E3BC2A95_0356F651_57365D55_546C9251
  [C0 R32] E01E6F95_93563051_57377555_54249B50
  [C0 R33] E03E6A95_1356B651_57365D55_546C9251
  [C0 R34] E3BC2A85_0356F6D1_57365D55_546C9255
  [C0 R35] E03C6A95_1356B651_57365D55_546C9251
  [C0 R36] E03E6A95_1356B651_57165D55_54649A51
  [C0 R37] E33C2A95_0356F651_57365D55_546C9251
  [C0 R38] E03E6A95_1356B651_57375D55_54649A51
  [C0 R39] E03C2A95_0356F651_57365D55_546C9A51
  [C0 R40] E01E6E95_93563051_57377D55_54249B50
  [C0 R41] E03C2A95_0356F651_57365D55_546C9251
  [C0 R42] E0166F95_D3563051_57377555_54249B50
  [C0 R43] E01E6A95_93563051_57377D55_54649A50
  [C0 R44] E33C2A95_0356F651_57365D55_546C9251
  [C0 R45] E01E6F95_93563051_57377555_54249B50
  [C0 R46] E01E6A95_13563051_57177D55_54649A51
  [C0 R47] EBBC2A85_0356F6D1_55365D55_146C9255
  [C0 R48] E01E6A95_93563051_57177D55_54649A50
  [C0 R49] E03C2A95_0356F651_57365D55_546C9251

  Golden[C0]: E03C2A95_1356F651_57365D55_546C9251  (majority vote of 50 evals)

  --- Bit Stability Map ---
  Per-bit reliability grade (9=stable, 0=noisy):

  [  0] 77676768886799688685777886789777  bits 0-31
  [ 32] 88787877778878877887788777787878  bits 32-63
  [ 64] 88877877767877777777777777776776  bits 64-95
  [ 96] 78877776777877787777678766786798  bits 96-127

  Stable bits (>=95% reliable): 40 / 128
  Noisy  bits (<80% reliable) : 0 / 128

  --- Intra-HD Histogram (c=5) ---
  20 challenges x 10 samples = 200 total

    0-  4 |###################################### 53
    5-  9 |######################################## 55
   10- 14 |############################# 40
   15- 19 |###################### 31
   20- 24 |########## 15
   25- 29 |#### 6
   30- 34 | 0
   35- 39 | 0
   40- 44 | 0
   45- 49 | 0
   50- 54 | 0
   55- 59 | 0
   60- 64 | 0
   65- 69 | 0
   70- 74 | 0
   75- 79 | 0
   80- 84 | 0
   85- 89 | 0
   90- 94 | 0
   95- 99 | 0
  100-104 | 0
  105-109 | 0
  110-114 | 0
  115-119 | 0
  120-124 | 0
  125-128 | 0

==== Test 5: Avalanche Effect (c=5) ====
  Base challenge: 87654321_0FEDCBA9_9ABCDEF0_12345678
  Base golden   : 6A972199_84536D5D_DB69575A_C7616D37

  Bit |   HD | HD%
  ----+------+-------
    0 |   20 | 15.62%
    1 |   11 |  8.59%
    2 |    7 |  5.46%
    3 |   10 |  7.81%
    4 |   17 | 13.28%
    5 |    5 |  3.90%
    6 |    7 |  5.46%
    7 |    5 |  3.90%
    8 |   12 |  9.37%
    9 |    6 |  4.68%
   10 |   17 | 13.28%
   11 |    9 |  7.03%
   12 |   13 | 10.15%
   13 |   10 |  7.81%
   14 |   12 |  9.37%
   15 |   15 | 11.71%
   16 |   10 |  7.81%
   17 |   13 | 10.15%
   18 |   11 |  8.59%
   19 |   18 | 14.06%
   20 |    7 |  5.46%
   21 |    6 |  4.68%
   22 |   15 | 11.71%
   23 |   20 | 15.62%
   24 |   17 | 13.28%
   25 |   11 |  8.59%
   26 |   17 | 13.28%
   27 |   14 | 10.93%
   28 |    3 |  2.34%
   29 |   11 |  8.59%
   30 |   13 | 10.15%
   31 |   12 |  9.37%

  Average avalanche: 9.13% (ideal 50%)

================================================================
  Validation Complete
================================================================
  All intra-device metrics computed successfully.

  Key observations to look for:
    - Uniformity close to 50% across all durations
    - Reliability > 95% for small c (2-4)
    - Inter-challenge HD close to 50% (good uniqueness)
    - Intra-HD histogram concentrated near 0
    - Avalanche effect approaching 50%

  For inter-device evaluation, run this test on
  additional FPGA boards and compare golden responses.
================================================================
