MarinGE23/axi-plpuf-ip/vitis-axi-plpuf/plpuf_test_app2/plpuf_test_app2_tests/plpuf_test_app2_10.txt

Opened with baud rate: 9600

================================================================
  PLPUF Exhaustive Intra-Device Validation
  TFG - Emanuel Antonio Marin Gutierrez
================================================================
  Challenges : 20
  Repetitions: 50
  Durations  : c = 1 .. 10
  PUF width  : 128 bits
================================================================

[INIT] Base = 0x44A00000

==== Test 1: Register Read/Write ====
  DURATION  wrote 12345  read 12345  [PASS]
  CHAL_0    wrote 0xDEADBEEF  read 0xDEADBEEF  [PASS]
  CHAL_3    wrote 0x9ABCDEF0  read 0x9ABCDEF0  [PASS]
  RESP_0    wrote 0xFFFFFFFF  read 0x00000000  [PASS read-only]
  Result: ALL PASS

==== Test 2: Soft Reset ====
  After eval : STATUS=0x02  busy=0 done=1
  After reset: STATUS=0x00  busy=0 done=0
  Done cleared: [PASS]

==== Test 3: Duration Sweep ====
  20 challenges x 50 reps per duration

   c | Uniform. | Reliab.  |  BER    | IntraHD  | InterHD
  ---+----------+----------+---------+----------+----------
   1 |  47.07%  |  99.01%  |  0.99% |   1.27   | 62.01 (48.44%)
   2 |  48.78%  |  97.19%  |  2.81% |   3.63   | 58.92 (46.03%)
   3 |  47.77%  |  96.80%  |  3.20% |   4.11   | 58.55 (45.74%)
   4 |  49.21%  |  95.37%  |  4.63% |   6.25   | 56.23 (43.93%)
   5 |  50.35%  |  93.54%  |  6.46% |   9.68   | 54.53 (42.60%)
   6 |  50.74%  |  92.88%  |  7.12% |  10.15   | 53.81 (42.04%)
   7 |  47.30%  |  91.79%  |  8.21% |  11.14   | 52.24 (40.81%)
   8 |  49.80%  |  90.35%  |  9.65% |  12.96   | 50.75 (39.65%)
   9 |  49.25%  |  89.46%  | 10.54% |  14.11   | 50.86 (39.74%)
  10 |  49.33%  |  88.29%  | 11.71% |  15.49   | 48.84 (38.16%)

  Uniformity : % of 1s in golden response (ideal 50%)
  Reliability: 1 - BER (ideal 100%)
  BER        : avg bit-flip rate vs golden (ideal 0%)
  IntraHD    : avg HD of fresh eval vs golden (ideal 0)
  InterHD    : avg HD between different challenges' golden (ideal 50%)

==== Test 4: Detailed Analysis at c = 5 ====

  [C0 R00] E3BC2A95_0356F651_57365D55_546C9251
  [C0 R01] EBBC2A85_0356F6D1_57365D55_146C9255
  [C0 R02] E01E6A95_93563051_57375D55_54649B50
  [C0 R03] E33C2A95_0356F651_57365D55_546C9251
  [C0 R04] E23C2A95_0356F651_57165D55_546C9251
  [C0 R05] E03E6A95_1356B251_57375D55_54649A51
  [C0 R06] E3BC2A95_0356F6D1_55165D55_546C9255
  [C0 R07] EBBC2A05_0756F6D5_55365D55_146C9257
  [C0 R08] E23C2A95_0356F651_57165D55_546C9251
  [C0 R09] E03C2A95_0356F651_57365D55_546C9251
  [C0 R10] EBBC2A85_0356F6D1_57365D55_546C9255
  [C0 R11] E03C6A95_1356B651_57365D55_54649251
  [C0 R12] E03C2A95_0356F651_57165D55_546C9251
  [C0 R13] E03E6A95_1356B651_57365D55_54649A51
  [C0 R14] E01E6A95_1356B051_57177D55_54649A51
  [C0 R15] E03E6A95_1356B251_57365D55_54649251
  [C0 R16] E03E6A95_1356B651_57165D55_546C9251
  [C0 R17] E33C2A95_0356F651_57365D55_546C9251
  [C0 R18] E01E6A95_93563051_57377D55_54649B50
  [C0 R19] E016EF95_D3563051_57377555_D5249B50
  [C0 R20] E03E6A95_1356B651_57165D55_54649251
  [C0 R21] E016EF95_D1561051_57177555_D5249B50
  [C0 R22] E03E6A95_1356B651_57365D55_54649A51
  [C0 R23] EBBC2A85_0356F6D1_55365D55_146C9255
  [C0 R24] E016EF95_D3563051_57177555_54249B50
  [C0 R25] E3BC2A95_0356F6D1_57165D55_546C9255
  [C0 R26] E03C6A95_1356B651_57365D55_546C9251
  [C0 R27] E13C2A95_0356F651_57365D55_546C9251
  [C0 R28] E23C2A95_0356F651_57365D55_546C9251
  [C0 R29] E016EF95_D3563051_57177555_54249B50
  [C0 R30] E01E6E95_93563051_57177D55_54249B50
  [C0 R31] E03C2A95_0356F651_57165D55_546C9251
  [C0 R32] EBBC2A85_0356F6D1_57365D55_146C9255
  [C0 R33] E3BC2A95_0356F651_57165D55_546C9251
  [C0 R34] E01E6A95_9356B051_57177D55_54649A50
  [C0 R35] E03C6A95_1356B651_57365D55_546C9A51
  [C0 R36] E0166F95_D3563051_57177555_55249B50
  [C0 R37] E33C2A95_0356F651_57165D55_546C9251
  [C0 R38] E01E6A95_93563051_57177D55_54649A50
  [C0 R39] E33C2A85_0356F6D1_55365D55_146C9255
  [C0 R40] E016EF95_D3563051_57177555_54249B50
  [C0 R41] E016EF95_D3563051_57177555_55249B50
  [C0 R42] E03C2A95_0356F651_57165D55_546C9251
  [C0 R43] E01E6E95_93563051_57377D55_54249B50
  [C0 R44] EBBC2A85_0356F6D1_55365D55_146C9255
  [C0 R45] EBBC2A05_0356F6D1_55365D55_146C9255
  [C0 R46] E01E6F95_93563051_57177555_54249B50
  [C0 R47] E01E6A95_1356B051_17377D55_54649A50
  [C0 R48] E03C2A95_0356F651_57165D55_546C9251
  [C0 R49] E03E6A95_1356B251_57377D55_54649A51

  Golden[C0]: E03C6A95_1356B651_57365D55_546C9251  (majority vote of 50 evals)

  --- Bit Stability Map ---
  Per-bit reliability grade (9=stable, 0=noisy):

  [  0] 77777777886799788785778787789777  bits 0-31
  [ 32] 98777887878878877887778776787777  bits 32-63
  [ 64] 88877877767877777877777787775886  bits 64-95
  [ 96] 78877776777878787787678766786798  bits 96-127

  Stable bits (>=95% reliable): 43 / 128
  Noisy  bits (<80% reliable) : 1 / 128

  --- Intra-HD Histogram (c=5) ---
  20 challenges x 10 samples = 200 total

    0-  4 |######################################## 57
    5-  9 |################################### 51
   10- 14 |######################### 36
   15- 19 |################# 25
   20- 24 |############## 21
   25- 29 |###### 9
   30- 34 | 1
   35- 39 | 0
   40- 44 | 0
   45- 49 | 0
   50- 54 | 0
   55- 59 | 0
   60- 64 | 0
   65- 69 | 0
   70- 74 | 0
   75- 79 | 0
   80- 84 | 0
   85- 89 | 0
   90- 94 | 0
   95- 99 | 0
  100-104 | 0
  105-109 | 0
  110-114 | 0
  115-119 | 0
  120-124 | 0
  125-128 | 0

==== Test 5: Avalanche Effect (c=5) ====
  Base challenge: 87654321_0FEDCBA9_9ABCDEF0_12345678
  Base golden   : 6A172199_84536D5D_DB69575A_C5616D37

  Bit |   HD | HD%
  ----+------+-------
    0 |    8 |  6.25%
    1 |    7 |  5.46%
    2 |   12 |  9.37%
    3 |   13 | 10.15%
    4 |   13 | 10.15%
    5 |    5 |  3.90%
    6 |    4 |  3.12%
    7 |    7 |  5.46%
    8 |   15 | 11.71%
    9 |    8 |  6.25%
   10 |   17 | 13.28%
   11 |    9 |  7.03%
   12 |    8 |  6.25%
   13 |   10 |  7.81%
   14 |    9 |  7.03%
   15 |    8 |  6.25%
   16 |   20 | 15.62%
   17 |    6 |  4.68%
   18 |   15 | 11.71%
   19 |   18 | 14.06%
   20 |    6 |  4.68%
   21 |    9 |  7.03%
   22 |    5 |  3.90%
   23 |   18 | 14.06%
   24 |    7 |  5.46%
   25 |    7 |  5.46%
   26 |   12 |  9.37%
   27 |   14 | 10.93%
   28 |   11 |  8.59%
   29 |    8 |  6.25%
   30 |    9 |  7.03%
   31 |   13 | 10.15%

  Average avalanche: 8.08% (ideal 50%)

================================================================
  Validation Complete
================================================================
  All intra-device metrics computed successfully.

  Key observations to look for:
    - Uniformity close to 50% across all durations
    - Reliability > 95% for small c (2-4)
    - Inter-challenge HD close to 50% (good uniqueness)
    - Intra-HD histogram concentrated near 0
    - Avalanche effect approaching 50%

  For inter-device evaluation, run this test on
  additional FPGA boards and compare golden responses.
================================================================
