MarinGE23/axi-plpuf-ip/vitis-axi-plpuf/plpuf_test_app2/plpuf_test_app2_tests/plpuf_test_app2_2.txt

Opened with baud rate: 9600

================================================================
  PLPUF Exhaustive Intra-Device Validation
  TFG - Emanuel Antonio Marin Gutierrez
================================================================
  Challenges : 20
  Repetitions: 50
  Durations  : c = 1 .. 10
  PUF width  : 128 bits
================================================================

[INIT] Base = 0x44A00000

==== Test 1: Register Read/Write ====
  DURATION  wrote 12345  read 12345  [PASS]
  CHAL_0    wrote 0xDEADBEEF  read 0xDEADBEEF  [PASS]
  CHAL_3    wrote 0x9ABCDEF0  read 0x9ABCDEF0  [PASS]
  RESP_0    wrote 0xFFFFFFFF  read 0x00000000  [PASS read-only]
  Result: ALL PASS

==== Test 2: Soft Reset ====
  After eval : STATUS=0x02  busy=0 done=1
  After reset: STATUS=0x00  busy=0 done=0
  Done cleared: [PASS]

==== Test 3: Duration Sweep ====
  20 challenges x 50 reps per duration

   c | Uniform. | Reliab.  |  BER    | IntraHD  | InterHD
  ---+----------+----------+---------+----------+----------
   1 |  47.14%  |  98.92%  |  1.08% |   1.25   | 61.91 (48.36%)
   2 |  48.75%  |  97.08%  |  2.92% |   4.01   | 58.87 (45.99%)
   3 |  47.69%  |  96.85%  |  3.15% |   4.51   | 58.17 (45.44%)
   4 |  49.14%  |  94.97%  |  5.03% |   6.98   | 56.47 (44.12%)
   5 |  50.35%  |  93.44%  |  6.56% |   9.20   | 54.63 (42.68%)
   6 |  51.44%  |  92.59%  |  7.41% |  11.06   | 53.43 (41.74%)
   7 |  46.99%  |  92.15%  |  7.85% |  11.24   | 52.13 (40.72%)
   8 |  49.88%  |  89.81%  | 10.19% |  13.00   | 50.35 (39.33%)
   9 |  49.02%  |  89.75%  | 10.25% |  14.20   | 50.44 (39.41%)
  10 |  49.45%  |  88.92%  | 11.08% |  16.57   | 48.43 (37.83%)

  Uniformity : % of 1s in golden response (ideal 50%)
  Reliability: 1 - BER (ideal 100%)
  BER        : avg bit-flip rate vs golden (ideal 0%)
  IntraHD    : avg HD of fresh eval vs golden (ideal 0)
  InterHD    : avg HD between different challenges' golden (ideal 50%)

==== Test 4: Detailed Analysis at c = 5 ====

  [C0 R00] E3BC2A85_0356F6D1_55365D55_546C9255
  [C0 R01] EBBC2A85_0356F6D1_55365D55_146C9255
  [C0 R02] E03C2A95_1356B651_57365D55_546C9A51
  [C0 R03] E01E6E95_93563051_57377D55_54249B50
  [C0 R04] EBBC2A05_0356F6D1_55365D55_146C9255
  [C0 R05] E0166F95_D3563051_57377555_54249B50
  [C0 R06] E03E2A95_1356B651_57165D55_546C9A51
  [C0 R07] E01E6A95_93563051_57177D55_54649A50
  [C0 R08] E0166E95_93563051_57177D55_54249B50
  [C0 R09] E03C2A95_0356F651_57365D55_546C9251
  [C0 R10] E0166F95_D3563051_57377555_54249B50
  [C0 R11] E03C2A95_1356B651_57165D55_546C9A51
  [C0 R12] E23C2A95_0356F651_57365D55_546C9251
  [C0 R13] E816EF95_D1561051_57577555_D5249B50
  [C0 R14] E03E2A95_1356B651_57365D55_54649A51
  [C0 R15] E01E6A95_93563051_57377D55_54649A50
  [C0 R16] E01E6A95_93563051_57175D55_54649A50
  [C0 R17] E33C2A95_0356F651_57365D55_546C9251
  [C0 R18] E03C6A95_1356B651_17375D55_54649A51
  [C0 R19] E33C2A95_0356F651_57165D55_546C9251
  [C0 R20] E03E6A95_1356B651_57165D55_546C9A51
  [C0 R21] E33C2A95_0356F651_57365D55_546C9251
  [C0 R22] E01E6A95_93563051_57377D55_54649B50
  [C0 R23] E23C2A95_0356F651_57165D55_546C9251
  [C0 R24] E03E6A95_1356B051_57177D55_54649A51
  [C0 R25] E01E6A95_93563051_57177D55_54249B50
  [C0 R26] E016EF95_D3563051_57177555_D5249B50
  [C0 R27] E01E6E95_93563051_57177D55_54249B50
  [C0 R28] E01E6A95_1356B051_57177D55_54649A51
  [C0 R29] E01E6A95_93563051_57177D55_54249B50
  [C0 R30] E03E6A95_13563051_57377D55_54649A50
  [C0 R31] E0166F95_93563051_57177555_54249B50
  [C0 R32] E01E6A95_93563051_57177D55_54249B50
  [C0 R33] E01E6A95_93563051_57377D55_54649B50
  [C0 R34] E3BC2A85_0356F6D1_57165D55_546C9255
  [C0 R35] E3BC2A95_0356F6D1_57365D55_546C9255
  [C0 R36] E01E6A95_13563051_57177D55_54649A50
  [C0 R37] E03E6A95_1356B651_57165D55_546C9A51
  [C0 R38] E03E6A95_13563051_57377D55_54649A50
  [C0 R39] E03C6A95_1356B651_57365D55_546C9A51
  [C0 R40] E23C2A95_0356F651_57365D55_546C9251
  [C0 R41] E03E6A95_1356B651_57375D55_54649251
  [C0 R42] E03E6A95_1356B651_57165D55_54649A51
  [C0 R43] E3BC2A95_0356F6D1_57165D55_546C9255
  [C0 R44] E03E6A95_1356B651_57375D55_54649A51
  [C0 R45] EBBC2A05_0756F6D5_55365D55_146C9257
  [C0 R46] E3BC2A95_0356F6D1_57365D55_546C9251
  [C0 R47] E03E6A95_1356B651_57175D55_54649A51
  [C0 R48] E01E6A95_13563051_57177D55_54649A50
  [C0 R49] E01E6F95_93563051_57377555_54249B50

  Golden[C0]: E03E6A95_1356B651_57375D55_54649A51  (majority vote of 50 evals)

  --- Bit Stability Map ---
  Per-bit reliability grade (9=stable, 0=noisy):

  [  0] 76676768886799789785778786789777  bits 0-31
  [ 32] 97787887778878887887778776788778  bits 32-63
  [ 64] 88877887767877777877777787876887  bits 64-95
  [ 96] 78877776677877787777678766786798  bits 96-127

  Stable bits (>=95% reliable): 46 / 128
  Noisy  bits (<80% reliable) : 0 / 128

  --- Intra-HD Histogram (c=5) ---
  20 challenges x 10 samples = 200 total

    0-  4 |########################### 46
    5-  9 |######################################## 67
   10- 14 |########################## 45
   15- 19 |############## 25
   20- 24 |######### 16
   25- 29 | 1
   30- 34 | 0
   35- 39 | 0
   40- 44 | 0
   45- 49 | 0
   50- 54 | 0
   55- 59 | 0
   60- 64 | 0
   65- 69 | 0
   70- 74 | 0
   75- 79 | 0
   80- 84 | 0
   85- 89 | 0
   90- 94 | 0
   95- 99 | 0
  100-104 | 0
  105-109 | 0
  110-114 | 0
  115-119 | 0
  120-124 | 0
  125-128 | 0

==== Test 5: Avalanche Effect (c=5) ====
  Base challenge: 87654321_0FEDCBA9_9ABCDEF0_12345678
  Base golden   : 6A072198_C4533D4D_DB69575A_E7616D37

  Bit |   HD | HD%
  ----+------+-------
    0 |   12 |  9.37%
    1 |   10 |  7.81%
    2 |    9 |  7.03%
    3 |    9 |  7.03%
    4 |   10 |  7.81%
    5 |    7 |  5.46%
    6 |   12 |  9.37%
    7 |   13 | 10.15%
    8 |    7 |  5.46%
    9 |   12 |  9.37%
   10 |   11 |  8.59%
   11 |    9 |  7.03%
   12 |    9 |  7.03%
   13 |    6 |  4.68%
   14 |   11 |  8.59%
   15 |   11 |  8.59%
   16 |    9 |  7.03%
   17 |    5 |  3.90%
   18 |   13 | 10.15%
   19 |   14 | 10.93%
   20 |   10 |  7.81%
   21 |    7 |  5.46%
   22 |    6 |  4.68%
   23 |   11 |  8.59%
   24 |    9 |  7.03%
   25 |    4 |  3.12%
   26 |    6 |  4.68%
   27 |    8 |  6.25%
   28 |    4 |  3.12%
   29 |    6 |  4.68%
   30 |   14 | 10.93%
   31 |    4 |  3.12%

  Average avalanche: 7.03% (ideal 50%)

================================================================
  Validation Complete
================================================================
  All intra-device metrics computed successfully.

  Key observations to look for:
    - Uniformity close to 50% across all durations
    - Reliability > 95% for small c (2-4)
    - Inter-challenge HD close to 50% (good uniqueness)
    - Intra-HD histogram concentrated near 0
    - Avalanche effect approaching 50%

  For inter-device evaluation, run this test on
  additional FPGA boards and compare golden responses.
================================================================
