MarinGE23/axi-plpuf-ip/vitis-axi-plpuf/plpuf_test_app2/plpuf_test_app2_tests/plpuf_test_app2_3.txt

Opened with baud rate: 9600

================================================================
  PLPUF Exhaustive Intra-Device Validation
  TFG - Emanuel Antonio Marin Gutierrez
================================================================
  Challenges : 20
  Repetitions: 50
  Durations  : c = 1 .. 10
  PUF width  : 128 bits
================================================================

[INIT] Base = 0x44A00000

==== Test 1: Register Read/Write ====
  DURATION  wrote 12345  read 12345  [PASS]
  CHAL_0    wrote 0xDEADBEEF  read 0xDEADBEEF  [PASS]
  CHAL_3    wrote 0x9ABCDEF0  read 0x9ABCDEF0  [PASS]
  RESP_0    wrote 0xFFFFFFFF  read 0x00000000  [PASS read-only]
  Result: ALL PASS

==== Test 2: Soft Reset ====
  After eval : STATUS=0x02  busy=0 done=1
  After reset: STATUS=0x00  busy=0 done=0
  Done cleared: [PASS]

==== Test 3: Duration Sweep ====
  20 challenges x 50 reps per duration

   c | Uniform. | Reliab.  |  BER    | IntraHD  | InterHD
  ---+----------+----------+---------+----------+----------
   1 |  47.10%  |  98.95%  |  1.05% |   1.35   | 62.05 (48.47%)
   2 |  48.67%  |  97.09%  |  2.91% |   3.66   | 58.81 (45.94%)
   3 |  47.92%  |  96.79%  |  3.21% |   4.75   | 58.33 (45.57%)
   4 |  49.25%  |  94.96%  |  5.04% |   7.16   | 56.04 (43.78%)
   5 |  49.96%  |  93.45%  |  6.55% |   9.77   | 54.22 (42.36%)
   6 |  51.09%  |  92.81%  |  7.19% |  11.84   | 53.96 (42.16%)
   7 |  47.18%  |  92.07%  |  7.93% |  11.60   | 52.78 (41.24%)
   8 |  50.11%  |  89.95%  | 10.05% |  13.46   | 50.76 (39.65%)
   9 |  49.37%  |  90.59%  |  9.41% |  13.95   | 50.62 (39.54%)
  10 |  49.37%  |  88.74%  | 11.26% |  15.38   | 48.82 (38.14%)

  Uniformity : % of 1s in golden response (ideal 50%)
  Reliability: 1 - BER (ideal 100%)
  BER        : avg bit-flip rate vs golden (ideal 0%)
  IntraHD    : avg HD of fresh eval vs golden (ideal 0)
  InterHD    : avg HD between different challenges' golden (ideal 50%)

==== Test 4: Detailed Analysis at c = 5 ====

  [C0 R00] E3BC2A95_0356F651_57365D55_546C9251
  [C0 R01] E03C6A95_1356F651_57365D55_546C9A51
  [C0 R02] E0166F95_D3563051_57175555_54249B50
  [C0 R03] E03C2A95_0356F651_57365D55_546C9A51
  [C0 R04] E03E6A95_1356B651_57375D55_54649A51
  [C0 R05] E016EF95_D3563051_57177555_D5249B50
  [C0 R06] E01E6F95_93563051_57377555_54249B50
  [C0 R07] E03C2A95_0356F651_57365D55_546C9251
  [C0 R08] E23C2A95_0356F651_57165D55_546C9251
  [C0 R09] E3BC2A95_0356F651_57365D55_546C9251
  [C0 R10] E03C2A95_1356F651_57365D55_546C9251
  [C0 R11] E3BC2A95_0356F6D1_57365D55_546C9255
  [C0 R12] E03E6A95_13563051_57375D55_54649A50
  [C0 R13] E03C2A95_0356F651_57365D55_546C9A51
  [C0 R14] E016EF95_D3563051_57377555_55249B50
  [C0 R15] E03E2A95_1356B651_57165D55_54649251
  [C0 R16] E03C6A95_1356B651_57365D55_546C9A51
  [C0 R17] E3BC2A95_0356F6D1_57365D55_546C9255
  [C0 R18] E016EF95_D3563051_57377555_55249B50
  [C0 R19] E33C2A95_0356F651_57165D55_546C9251
  [C0 R20] E03C6A95_1356B651_57165D55_54649A51
  [C0 R21] E03C6A95_1356B651_57165D55_546C9A51
  [C0 R22] E01E6F95_93563051_57177555_54249B50
  [C0 R23] E3BC2A85_0356F6D1_55365D55_546C9255
  [C0 R24] E016EF95_D3563051_57377555_D5249B50
  [C0 R25] E23C2A95_0356F651_57365D55_546C9251
  [C0 R26] E01E6A95_93563051_57177D55_54649A50
  [C0 R27] E0166F95_93563051_57177555_54249B50
  [C0 R28] E03E6A95_13563251_57365D55_54649A51
  [C0 R29] E01E6A95_13563051_57177D55_54649A50
  [C0 R30] E3BC2A95_0356F6D1_57365D55_546C9255
  [C0 R31] E33C2A95_0356F651_57365D55_546C9251
  [C0 R32] E01E6F95_93563051_57377D55_54249B50
  [C0 R33] E33C2A95_0356F651_57165D55_546C9251
  [C0 R34] EBBC2A05_1756F6D5_55365D55_146C9257
  [C0 R35] E01E6A95_93563051_57177D55_54649A50
  [C0 R36] E23C2A95_0356F651_57165D55_546C9251
  [C0 R37] E3BC2A85_0356F6D1_57365D55_546C9255
  [C0 R38] E23C2A95_0356F651_57365D55_546C9251
  [C0 R39] E23C2A95_0356F651_57365D55_546C9251
  [C0 R40] E0166F95_93563051_57377555_54249B50
  [C0 R41] E03E6A95_1356B651_57165D55_546C9A51
  [C0 R42] E01E6A95_93563051_57377D55_54649A50
  [C0 R43] E23C2A95_0356F651_57165D55_546C9251
  [C0 R44] E03C2A95_0356F651_57165D55_546C9251
  [C0 R45] E016EF95_D3563051_57177555_54249B50
  [C0 R46] E01E6A95_1356B051_57177D55_54649A51
  [C0 R47] E01E6A95_13563051_57177D55_54649A50
  [C0 R48] E016EF95_D1561051_57177555_D5249B50
  [C0 R49] E33C2A95_0356F651_57165D55_546C9251

  Golden[C0]: E03C6A95_1356B651_57365D55_546C9A51  (majority vote of 50 evals)

  --- Bit Stability Map ---
  Per-bit reliability grade (9=stable, 0=noisy):

  [  0] 77676768786799798785767786799777  bits 0-31
  [ 32] 98777787778878877877778777887777  bits 32-63
  [ 64] 88877877767877777777777777875787  bits 64-95
  [ 96] 78877776777877787777678766786798  bits 96-127

  Stable bits (>=95% reliable): 36 / 128
  Noisy  bits (<80% reliable) : 1 / 128

  --- Intra-HD Histogram (c=5) ---
  20 challenges x 10 samples = 200 total

    0-  4 |################################## 50
    5-  9 |######################################## 58
   10- 14 |############################### 45
   15- 19 |################# 25
   20- 24 |########## 15
   25- 29 |## 4
   30- 34 |## 3
   35- 39 | 0
   40- 44 | 0
   45- 49 | 0
   50- 54 | 0
   55- 59 | 0
   60- 64 | 0
   65- 69 | 0
   70- 74 | 0
   75- 79 | 0
   80- 84 | 0
   85- 89 | 0
   90- 94 | 0
   95- 99 | 0
  100-104 | 0
  105-109 | 0
  110-114 | 0
  115-119 | 0
  120-124 | 0
  125-128 | 0

==== Test 5: Avalanche Effect (c=5) ====
  Base challenge: 87654321_0FEDCBA9_9ABCDEF0_12345678
  Base golden   : 6A172198_C4536D5D_DB69575A_C5616D37

  Bit |   HD | HD%
  ----+------+-------
    0 |   14 | 10.93%
    1 |   11 |  8.59%
    2 |   12 |  9.37%
    3 |   13 | 10.15%
    4 |   15 | 11.71%
    5 |    2 |  1.56%
    6 |    5 |  3.90%
    7 |   10 |  7.81%
    8 |    9 |  7.03%
    9 |    8 |  6.25%
   10 |   11 |  8.59%
   11 |    7 |  5.46%
   12 |    9 |  7.03%
   13 |    6 |  4.68%
   14 |    6 |  4.68%
   15 |   16 | 12.50%
   16 |   14 | 10.93%
   17 |   12 |  9.37%
   18 |   18 | 14.06%
   19 |   18 | 14.06%
   20 |   13 | 10.15%
   21 |    6 |  4.68%
   22 |   14 | 10.93%
   23 |   12 |  9.37%
   24 |    8 |  6.25%
   25 |    6 |  4.68%
   26 |   10 |  7.81%
   27 |    8 |  6.25%
   28 |    7 |  5.46%
   29 |    9 |  7.03%
   30 |   13 | 10.15%
   31 |    5 |  3.90%

  Average avalanche: 7.98% (ideal 50%)

================================================================
  Validation Complete
================================================================
  All intra-device metrics computed successfully.

  Key observations to look for:
    - Uniformity close to 50% across all durations
    - Reliability > 95% for small c (2-4)
    - Inter-challenge HD close to 50% (good uniqueness)
    - Intra-HD histogram concentrated near 0
    - Avalanche effect approaching 50%

  For inter-device evaluation, run this test on
  additional FPGA boards and compare golden responses.
================================================================
