MarinGE23/axi-plpuf-ip/vitis-axi-plpuf/plpuf_test_app2/plpuf_test_app2_tests/plpuf_test_app2_4.txt

Opened with baud rate: 9600

================================================================
  PLPUF Exhaustive Intra-Device Validation
  TFG - Emanuel Antonio Marin Gutierrez
================================================================
  Challenges : 20
  Repetitions: 50
  Durations  : c = 1 .. 10
  PUF width  : 128 bits
================================================================

[INIT] Base = 0x44A00000

==== Test 1: Register Read/Write ====
  DURATION  wrote 12345  read 12345  [PASS]
  CHAL_0    wrote 0xDEADBEEF  read 0xDEADBEEF  [PASS]
  CHAL_3    wrote 0x9ABCDEF0  read 0x9ABCDEF0  [PASS]
  RESP_0    wrote 0xFFFFFFFF  read 0x00000000  [PASS read-only]
  Result: ALL PASS

==== Test 2: Soft Reset ====
  After eval : STATUS=0x02  busy=0 done=1
  After reset: STATUS=0x00  busy=0 done=0
  Done cleared: [PASS]

==== Test 3: Duration Sweep ====
  20 challenges x 50 reps per duration

   c | Uniform. | Reliab.  |  BER    | IntraHD  | InterHD
  ---+----------+----------+---------+----------+----------
   1 |  47.03%  |  98.94%  |  1.06% |   1.38   | 62.09 (48.51%)
   2 |  48.59%  |  97.04%  |  2.96% |   4.51   | 58.92 (46.03%)
   3 |  47.89%  |  96.90%  |  3.10% |   4.82   | 58.32 (45.56%)
   4 |  49.14%  |  95.14%  |  4.86% |   7.03   | 56.28 (43.97%)
   5 |  50.15%  |  93.43%  |  6.57% |   8.46   | 54.47 (42.55%)
   6 |  50.89%  |  92.42%  |  7.58% |  11.09   | 53.74 (41.98%)
   7 |  47.30%  |  92.06%  |  7.94% |  11.50   | 52.12 (40.71%)
   8 |  49.53%  |  90.02%  |  9.98% |  13.35   | 51.06 (39.89%)
   9 |  48.98%  |  89.35%  | 10.65% |  15.27   | 49.78 (38.89%)
  10 |  49.33%  |  88.74%  | 11.26% |  15.29   | 47.66 (37.24%)

  Uniformity : % of 1s in golden response (ideal 50%)
  Reliability: 1 - BER (ideal 100%)
  BER        : avg bit-flip rate vs golden (ideal 0%)
  IntraHD    : avg HD of fresh eval vs golden (ideal 0)
  InterHD    : avg HD between different challenges' golden (ideal 50%)

==== Test 4: Detailed Analysis at c = 5 ====

  [C0 R00] E03C2A95_0357F651_57365D55_546C9251
  [C0 R01] E3BC2A95_0356F651_57165D55_546C9251
  [C0 R02] E01E6F95_93563051_57375555_54249B50
  [C0 R03] E03C2A95_0356F651_57365D55_546C9251
  [C0 R04] E03E6A95_13563051_57377D55_54649A51
  [C0 R05] E03C2A95_1356F651_57165D55_546C9251
  [C0 R06] E3BC2A95_0356F651_57365D55_546C9251
  [C0 R07] EBBC2A85_0356F6D1_55365D55_146C9255
  [C0 R08] E01E6A95_93563051_57177D55_54649B50
  [C0 R09] E01E6E95_93563051_57377D55_54249B50
  [C0 R10] E01E6F95_93563051_57377555_54249B50
  [C0 R11] E01E6F95_D3563051_57377555_54249B50
  [C0 R12] E01E6A95_93563051_57177D55_54649B50
  [C0 R13] E01E6A95_1356B051_57177D55_54649A51
  [C0 R14] E33C2A95_0356F651_57165D55_546C9251
  [C0 R15] E0166F95_93563051_57177555_54249B50
  [C0 R16] E01E6E95_93563051_57177D55_54649B50
  [C0 R17] E03C6A95_1356B651_57365D55_546C9A51
  [C0 R18] E016EF95_D3563051_57177555_D5249B50
  [C0 R19] E01E6A95_93563051_57377D55_54649B50
  [C0 R20] E03C2A95_1356F651_57165D55_546C9251
  [C0 R21] E0166F95_93563051_57177555_54249B50
  [C0 R22] E3BC2A95_0356F651_57165D55_546C9251
  [C0 R23] E03E6A95_1356B051_57377D55_54649A50
  [C0 R24] E01E6A95_93563051_57177D55_54649A50
  [C0 R25] E01E6F95_93563051_57377555_54249B50
  [C0 R26] E03C2A95_0356F651_57365D55_546C9251
  [C0 R27] E03C6A95_1356B651_57165D55_546C9A51
  [C0 R28] E03C2A95_0356F651_57165D55_546C9251
  [C0 R29] E03C2A95_1356F651_57165D55_546C9251
  [C0 R30] E3BC2A95_0356F6D1_57365D55_546C9255
  [C0 R31] E33C2A95_0356F6D1_57165D55_546C9255
  [C0 R32] E01E6F95_93563051_57377D55_54249B50
  [C0 R33] E03C2A95_1356F651_57165D55_546C9251
  [C0 R34] E23C2A95_0356F651_57165D55_546C9251
  [C0 R35] E01E6A95_93563051_57377D55_54649B50
  [C0 R36] E03E6A95_1356B651_57165D55_54649251
  [C0 R37] E01E6A95_93563051_57177D55_54649A50
  [C0 R38] E03C2A95_1356F651_57165D55_546C9251
  [C0 R39] E33C2A95_0356F651_57165D55_546C9251
  [C0 R40] E016EF95_D3563051_57177555_55249B50
  [C0 R41] E01E6A95_1356B051_57177D55_54649A51
  [C0 R42] E016EF95_D3563051_57377555_55249B50
  [C0 R43] E01E6E95_D3563051_57177D55_54649B50
  [C0 R44] EBBC2A85_0356F6D1_57365D55_146C9255
  [C0 R45] E03C2A95_0356F651_57165D55_546C9251
  [C0 R46] E03C6A95_1356B651_57165D55_546C9A51
  [C0 R47] E13C2A95_0356F651_57365D55_546C9251
  [C0 R48] E01E6E95_93563051_57177D55_54249B50
  [C0 R49] EBBC2A85_0356F6D1_57365D55_146C9255

  Golden[C0]: E03C6A95_1356B651_57165D55_54649A51  (majority vote of 50 evals)

  --- Bit Stability Map ---
  Per-bit reliability grade (9=stable, 0=noisy):

  [  0] 76776777886799698785767787789777  bits 0-31
  [ 32] 97777887778878877876778777787877  bits 32-63
  [ 64] 88877877767877777777777776776886  bits 64-95
  [ 96] 78877776677877787777678766786798  bits 96-127

  Stable bits (>=95% reliable): 36 / 128
  Noisy  bits (<80% reliable) : 0 / 128

  --- Intra-HD Histogram (c=5) ---
  20 challenges x 10 samples = 200 total

    0-  4 |###################################### 55
    5-  9 |######################################## 57
   10- 14 |############################# 42
   15- 19 |##################### 30
   20- 24 |####### 10
   25- 29 |## 4
   30- 34 |# 2
   35- 39 | 0
   40- 44 | 0
   45- 49 | 0
   50- 54 | 0
   55- 59 | 0
   60- 64 | 0
   65- 69 | 0
   70- 74 | 0
   75- 79 | 0
   80- 84 | 0
   85- 89 | 0
   90- 94 | 0
   95- 99 | 0
  100-104 | 0
  105-109 | 0
  110-114 | 0
  115-119 | 0
  120-124 | 0
  125-128 | 0

==== Test 5: Avalanche Effect (c=5) ====
  Base challenge: 87654321_0FEDCBA9_9ABCDEF0_12345678
  Base golden   : 6A072998_C4533D4D_DB6D555A_67616533

  Bit |   HD | HD%
  ----+------+-------
    0 |   19 | 14.84%
    1 |   16 | 12.50%
    2 |   16 | 12.50%
    3 |   19 | 14.84%
    4 |    9 |  7.03%
    5 |    3 |  2.34%
    6 |   16 | 12.50%
    7 |   21 | 16.40%
    8 |    5 |  3.90%
    9 |    5 |  3.90%
   10 |    4 |  3.12%
   11 |   10 |  7.81%
   12 |   11 |  8.59%
   13 |    2 |  1.56%
   14 |    6 |  4.68%
   15 |    9 |  7.03%
   16 |   13 | 10.15%
   17 |    4 |  3.12%
   18 |   19 | 14.84%
   19 |   15 | 11.71%
   20 |   19 | 14.84%
   21 |   17 | 13.28%
   22 |    7 |  5.46%
   23 |    7 |  5.46%
   24 |   16 | 12.50%
   25 |   14 | 10.93%
   26 |    7 |  5.46%
   27 |   22 | 17.18%
   28 |   12 |  9.37%
   29 |   16 | 12.50%
   30 |    8 |  6.25%
   31 |    1 |  0.78%

  Average avalanche: 8.98% (ideal 50%)

================================================================
  Validation Complete
================================================================
  All intra-device metrics computed successfully.

  Key observations to look for:
    - Uniformity close to 50% across all durations
    - Reliability > 95% for small c (2-4)
    - Inter-challenge HD close to 50% (good uniqueness)
    - Intra-HD histogram concentrated near 0
    - Avalanche effect approaching 50%

  For inter-device evaluation, run this test on
  additional FPGA boards and compare golden responses.
================================================================
