MarinGE23/axi-plpuf-ip/vitis-axi-plpuf/plpuf_test_app2/plpuf_test_app2_tests/plpuf_test_app2_5.txt

Opened with baud rate: 9600

================================================================
  PLPUF Exhaustive Intra-Device Validation
  TFG - Emanuel Antonio Marin Gutierrez
================================================================
  Challenges : 20
  Repetitions: 50
  Durations  : c = 1 .. 10
  PUF width  : 128 bits
================================================================

[INIT] Base = 0x44A00000

==== Test 1: Register Read/Write ====
  DURATION  wrote 12345  read 12345  [PASS]
  CHAL_0    wrote 0xDEADBEEF  read 0xDEADBEEF  [PASS]
  CHAL_3    wrote 0x9ABCDEF0  read 0x9ABCDEF0  [PASS]
  RESP_0    wrote 0xFFFFFFFF  read 0x00000000  [PASS read-only]
  Result: ALL PASS

==== Test 2: Soft Reset ====
  After eval : STATUS=0x02  busy=0 done=1
  After reset: STATUS=0x00  busy=0 done=0
  Done cleared: [PASS]

==== Test 3: Duration Sweep ====
  20 challenges x 50 reps per duration

   c | Uniform. | Reliab.  |  BER    | IntraHD  | InterHD
  ---+----------+----------+---------+----------+----------
   1 |  47.10%  |  98.98%  |  1.02% |   1.40   | 62.05 (48.47%)
   2 |  48.59%  |  97.11%  |  2.89% |   3.67   | 58.89 (46.01%)
   3 |  47.89%  |  96.70%  |  3.30% |   4.75   | 58.53 (45.73%)
   4 |  49.33%  |  95.18%  |  4.82% |   6.06   | 56.31 (43.99%)
   5 |  50.03%  |  93.39%  |  6.61% |   9.17   | 54.17 (42.32%)
   6 |  51.28%  |  92.40%  |  7.60% |  10.02   | 53.99 (42.18%)
   7 |  47.57%  |  92.12%  |  7.88% |  11.64   | 51.92 (40.56%)
   8 |  49.76%  |  89.24%  | 10.76% |  12.40   | 50.45 (39.41%)
   9 |  48.78%  |  89.45%  | 10.55% |  13.98   | 50.43 (39.40%)
  10 |  49.25%  |  88.46%  | 11.54% |  14.57   | 48.70 (38.04%)

  Uniformity : % of 1s in golden response (ideal 50%)
  Reliability: 1 - BER (ideal 100%)
  BER        : avg bit-flip rate vs golden (ideal 0%)
  IntraHD    : avg HD of fresh eval vs golden (ideal 0)
  InterHD    : avg HD between different challenges' golden (ideal 50%)

==== Test 4: Detailed Analysis at c = 5 ====

  [C0 R00] E01C6A95_13563451_57375D55_54649A50
  [C0 R01] E03C2A95_1356F651_57165D55_546C9251
  [C0 R02] E01E6A95_93563051_57177D55_54649A50
  [C0 R03] E01E6F95_93563051_57377555_54249B50
  [C0 R04] E33C2A95_0356F651_57365D55_546C9251
  [C0 R05] E03E6A95_1356B051_57375D55_54649A50
  [C0 R06] E03C6A95_1356B651_57165D55_54649A51
  [C0 R07] E03C2A95_1356B651_57165D55_546C9A51
  [C0 R08] E01E6A95_93563051_57375D55_54649A50
  [C0 R09] EBBC2A05_1756F6D5_55365D55_146C9257
  [C0 R10] E3BC2A95_0356F651_57365D55_546C9251
  [C0 R11] E33C2A95_0356F651_57165D55_546C9251
  [C0 R12] E01E6A95_93563051_57177D55_54649B50
  [C0 R13] E33C2A95_0356F651_57365D55_546C9251
  [C0 R14] E01E6A95_93563051_57375D55_54649A50
  [C0 R15] E03E6A95_13563051_57377D55_54649A50
  [C0 R16] E33C2A95_0356F651_57365D55_546C9251
  [C0 R17] E33C2A95_0356F6D1_57365D55_546C9255
  [C0 R18] E33C2A85_0356F6D1_55365D55_146C9255
  [C0 R19] E03E6A95_1356B651_57165D55_54649A51
  [C0 R20] E03C6A95_1356B651_57365D55_546C9A51
  [C0 R21] E23C2A95_0356F651_57165D55_546C9251
  [C0 R22] E3BC2A95_0356F6D1_57365D55_546C9255
  [C0 R23] E03E6A95_1356B051_57377D55_54649A51
  [C0 R24] E016EF95_D3563051_57377555_D5249B50
  [C0 R25] E03E6A95_1356B651_57375D55_54649A51
  [C0 R26] E23C2A95_0356F651_57165D55_546C9251
  [C0 R27] E33C2A95_0356F651_57165D55_546C9251
  [C0 R28] E01E6A95_1356B051_57177D55_54649A51
  [C0 R29] E03E6A95_1356B651_57165D55_54649A51
  [C0 R30] E23C2A95_0356F651_57165D55_546C9251
  [C0 R31] CBBC2A05_1756F6D5_55365D55_146C9257
  [C0 R32] E33C2A95_0356F651_57165D55_546C9251
  [C0 R33] E03C6A95_0356B651_57165D55_546C9251
  [C0 R34] E3BC2A95_0356F6D1_57365D55_546C9251
  [C0 R35] E03E6A95_1356B651_57165D55_54649A51
  [C0 R36] E33C2A95_0356F651_57165D55_546C9251
  [C0 R37] E01E6E95_93563051_57377D55_54249B50
  [C0 R38] E01E6F95_93563051_57377555_54249B50
  [C0 R39] E33C2A95_0356F651_57165D55_546C9251
  [C0 R40] E03C6A95_1356B651_57365D55_54649251
  [C0 R41] E01E6E95_93563051_57177D55_54649B50
  [C0 R42] E03C2A95_0356F651_57165D55_546C9251
  [C0 R43] E03E6A95_1356B651_57165D55_54649A51
  [C0 R44] E03E6A95_13563051_57377D55_54649A50
  [C0 R45] E03E6A95_1356B251_57167D55_54649A51
  [C0 R46] E33C2A95_0356F651_57165D55_546C9251
  [C0 R47] E23C2A95_0356F651_57165D55_546C9251
  [C0 R48] E03C6A95_1356B651_57365D55_546C9A51
  [C0 R49] E3BC2A95_0356F651_57365D55_546C9255

  Golden[C0]: E03C6A95_1356B651_57365D55_546C9251  (majority vote of 50 evals)

  --- Bit Stability Map ---
  Per-bit reliability grade (9=stable, 0=noisy):

  [  0] 76676777886799788785778786789777  bits 0-31
  [ 32] 88777887778878887887778777787777  bits 32-63
  [ 64] 88877877777877777777777777876787  bits 64-95
  [ 96] 78877776777877787777678766786798  bits 96-127

  Stable bits (>=95% reliable): 39 / 128
  Noisy  bits (<80% reliable) : 0 / 128

  --- Intra-HD Histogram (c=5) ---
  20 challenges x 10 samples = 200 total

    0-  4 |######################################## 60
    5-  9 |#################################### 54
   10- 14 |########################## 40
   15- 19 |############## 21
   20- 24 |########### 17
   25- 29 |##### 8
   30- 34 | 0
   35- 39 | 0
   40- 44 | 0
   45- 49 | 0
   50- 54 | 0
   55- 59 | 0
   60- 64 | 0
   65- 69 | 0
   70- 74 | 0
   75- 79 | 0
   80- 84 | 0
   85- 89 | 0
   90- 94 | 0
   95- 99 | 0
  100-104 | 0
  105-109 | 0
  110-114 | 0
  115-119 | 0
  120-124 | 0
  125-128 | 0

==== Test 5: Avalanche Effect (c=5) ====
  Base challenge: 87654321_0FEDCBA9_9ABCDEF0_12345678
  Base golden   : 6A872198_C4536D5D_DB69575A_C7616D37

  Bit |   HD | HD%
  ----+------+-------
    0 |   10 |  7.81%
    1 |   12 |  9.37%
    2 |    9 |  7.03%
    3 |    7 |  5.46%
    4 |   11 |  8.59%
    5 |    4 |  3.12%
    6 |    6 |  4.68%
    7 |   12 |  9.37%
    8 |    9 |  7.03%
    9 |   11 |  8.59%
   10 |   12 |  9.37%
   11 |    7 |  5.46%
   12 |    8 |  6.25%
   13 |    9 |  7.03%
   14 |    8 |  6.25%
   15 |   14 | 10.93%
   16 |   15 | 11.71%
   17 |    7 |  5.46%
   18 |   10 |  7.81%
   19 |   12 |  9.37%
   20 |   15 | 11.71%
   21 |    8 |  6.25%
   22 |    9 |  7.03%
   23 |   12 |  9.37%
   24 |    9 |  7.03%
   25 |   13 | 10.15%
   26 |   10 |  7.81%
   27 |    7 |  5.46%
   28 |    6 |  4.68%
   29 |    6 |  4.68%
   30 |   13 | 10.15%
   31 |   11 |  8.59%

  Average avalanche: 7.61% (ideal 50%)

================================================================
  Validation Complete
================================================================
  All intra-device metrics computed successfully.

  Key observations to look for:
    - Uniformity close to 50% across all durations
    - Reliability > 95% for small c (2-4)
    - Inter-challenge HD close to 50% (good uniqueness)
    - Intra-HD histogram concentrated near 0
    - Avalanche effect approaching 50%

  For inter-device evaluation, run this test on
  additional FPGA boards and compare golden responses.
================================================================
