MarinGE23/axi-plpuf-ip/vitis-axi-plpuf/plpuf_test_app2/plpuf_test_app2_tests/plpuf_test_app2_6.txt

Opened with baud rate: 9600

================================================================
  PLPUF Exhaustive Intra-Device Validation
  TFG - Emanuel Antonio Marin Gutierrez
================================================================
  Challenges : 20
  Repetitions: 50
  Durations  : c = 1 .. 10
  PUF width  : 128 bits
================================================================

[INIT] Base = 0x44A00000

==== Test 1: Register Read/Write ====
  DURATION  wrote 12345  read 12345  [PASS]
  CHAL_0    wrote 0xDEADBEEF  read 0xDEADBEEF  [PASS]
  CHAL_3    wrote 0x9ABCDEF0  read 0x9ABCDEF0  [PASS]
  RESP_0    wrote 0xFFFFFFFF  read 0x00000000  [PASS read-only]
  Result: ALL PASS

==== Test 2: Soft Reset ====
  After eval : STATUS=0x02  busy=0 done=1
  After reset: STATUS=0x00  busy=0 done=0
  Done cleared: [PASS]

==== Test 3: Duration Sweep ====
  20 challenges x 50 reps per duration

   c | Uniform. | Reliab.  |  BER    | IntraHD  | InterHD
  ---+----------+----------+---------+----------+----------
   1 |  47.07%  |  98.99%  |  1.01% |   1.29   | 62.05 (48.48%)
   2 |  48.67%  |  97.00%  |  3.00% |   4.04   | 59.00 (46.09%)
   3 |  48.20%  |  96.77%  |  3.23% |   4.78   | 58.55 (45.74%)
   4 |  49.10%  |  95.17%  |  4.83% |   6.68   | 56.63 (44.24%)
   5 |  50.15%  |  93.34%  |  6.66% |   8.94   | 54.40 (42.50%)
   6 |  51.09%  |  92.75%  |  7.25% |  10.41   | 53.64 (41.90%)
   7 |  47.57%  |  91.94%  |  8.06% |  12.79   | 52.32 (40.87%)
   8 |  50.15%  |  89.96%  | 10.04% |  14.28   | 50.32 (39.31%)
   9 |  49.60%  |  89.74%  | 10.26% |  14.78   | 50.11 (39.15%)
  10 |  48.86%  |  88.39%  | 11.61% |  16.08   | 48.76 (38.09%)

  Uniformity : % of 1s in golden response (ideal 50%)
  Reliability: 1 - BER (ideal 100%)
  BER        : avg bit-flip rate vs golden (ideal 0%)
  IntraHD    : avg HD of fresh eval vs golden (ideal 0)
  InterHD    : avg HD between different challenges' golden (ideal 50%)

==== Test 4: Detailed Analysis at c = 5 ====

  [C0 R00] E01E6A95_13563451_57377D55_54649A51
  [C0 R01] E01E6F95_D3563051_57375555_54249B50
  [C0 R02] E03C2A95_1356F651_57165D55_546C9A51
  [C0 R03] EBBC2A05_0356F6D1_55365D55_146C9257
  [C0 R04] EBBC2A85_0356F6D1_57365D55_146C9255
  [C0 R05] E33C2A95_0356F651_57165D55_546C9251
  [C0 R06] E03C2A95_1356F651_57365D55_546C9251
  [C0 R07] E0166F95_D3563051_57377555_54249B50
  [C0 R08] E03E6A95_1356B651_57365D55_54649A51
  [C0 R09] EBBC2A85_0356F6D1_55365D55_146C9255
  [C0 R10] EBBC2A05_0756F6D1_55365D55_146C9257
  [C0 R11] E016EF95_D1561051_57177555_D5249B50
  [C0 R12] E33C2A95_0356F651_57365D55_546C9251
  [C0 R13] E3BC2A95_0356F651_57165D55_546C9251
  [C0 R14] E3BC2A85_0356F6D1_57365D55_146C9255
  [C0 R15] E03C2A95_0356F651_57165D55_546C9251
  [C0 R16] E03C2A95_0356F651_57165D55_546C9251
  [C0 R17] E03E6A95_1356B651_57165D55_54649251
  [C0 R18] E23C2A95_0356F651_57365D55_546C9251
  [C0 R19] E0166F95_93563051_57177555_54249B50
  [C0 R20] E03C6A95_1356B651_57365D55_54649251
  [C0 R21] E01E6F95_93563051_57177D55_54249B50
  [C0 R22] EBBC2A05_0356F6D1_55365D55_146C9255
  [C0 R23] E01E6A95_13563051_57177D55_54649A51
  [C0 R24] E03C6A95_0356F651_57165D55_546C9A51
  [C0 R25] E01E6A95_1356B251_57167D55_54649A51
  [C0 R26] E3BC2A95_0356F6D1_57365D55_546C9251
  [C0 R27] E01E6A95_13563051_57177D55_54649A50
  [C0 R28] E01E6A95_13563051_57177D55_54649A50
  [C0 R29] E03C2A95_0356F651_57165D55_546C9251
  [C0 R30] E03C2A95_1356F651_57365D55_546C9251
  [C0 R31] E03E6A95_1356B651_57175D55_54649A51
  [C0 R32] E01E6F95_93563051_57377555_54249B50
  [C0 R33] E01E6E95_93563051_57377D55_54249B50
  [C0 R34] E03C6A95_1356B651_57365D55_54649251
  [C0 R35] E13C2A95_0356F6D1_57365D55_546C9255
  [C0 R36] E33C2A95_0356F651_57165D55_546C9251
  [C0 R37] E01E6F95_D3563051_57177555_54249B50
  [C0 R38] E0166F95_D3563051_57377555_54249B50
  [C0 R39] E23C2A95_0356F651_57165D55_546C9251
  [C0 R40] E01E6A95_1356B051_57177D55_54649A51
  [C0 R41] E01E6A95_13563051_57177D55_54649A50
  [C0 R42] E03C6A95_1356B651_57165D55_54649A51
  [C0 R43] E03C6A95_1356B651_57365D55_54649A51
  [C0 R44] E13C2A95_0356F651_57165D55_546C9251
  [C0 R45] EBBC2A05_0756F6D1_55365D55_146C9257
  [C0 R46] E03E6A95_1356B651_57165D55_546C9A51
  [C0 R47] E0166F95_93563051_57177555_54249B50
  [C0 R48] E03E6A95_1356B051_57177D55_54649A51
  [C0 R49] EBBC2A85_0356F6D1_57365D55_546C9255

  Golden[C0]: E03C6A95_1356B651_57165D55_54649251  (majority vote of 50 evals)

  --- Bit Stability Map ---
  Per-bit reliability grade (9=stable, 0=noisy):

  [  0] 76677777886799798785767786789777  bits 0-31
  [ 32] 97777887778778887877778776787778  bits 32-63
  [ 64] 88877877767877777777777777775887  bits 64-95
  [ 96] 78877776777877787777778766786798  bits 96-127

  Stable bits (>=95% reliable): 36 / 128
  Noisy  bits (<80% reliable) : 1 / 128

  --- Intra-HD Histogram (c=5) ---
  20 challenges x 10 samples = 200 total

    0-  4 |##################################### 51
    5-  9 |######################################## 54
   10- 14 |############################### 42
   15- 19 |####################### 32
   20- 24 |############## 19
   25- 29 |# 2
   30- 34 | 0
   35- 39 | 0
   40- 44 | 0
   45- 49 | 0
   50- 54 | 0
   55- 59 | 0
   60- 64 | 0
   65- 69 | 0
   70- 74 | 0
   75- 79 | 0
   80- 84 | 0
   85- 89 | 0
   90- 94 | 0
   95- 99 | 0
  100-104 | 0
  105-109 | 0
  110-114 | 0
  115-119 | 0
  120-124 | 0
  125-128 | 0

==== Test 5: Avalanche Effect (c=5) ====
  Base challenge: 87654321_0FEDCBA9_9ABCDEF0_12345678
  Base golden   : 6A972198_84536D5D_DB69575A_C7616D37

  Bit |   HD | HD%
  ----+------+-------
    0 |    9 |  7.03%
    1 |    8 |  6.25%
    2 |    6 |  4.68%
    3 |    8 |  6.25%
    4 |    8 |  6.25%
    5 |    5 |  3.90%
    6 |   14 | 10.93%
    7 |   16 | 12.50%
    8 |   13 | 10.15%
    9 |   10 |  7.81%
   10 |   15 | 11.71%
   11 |   11 |  8.59%
   12 |    7 |  5.46%
   13 |   14 | 10.93%
   14 |   10 |  7.81%
   15 |   17 | 13.28%
   16 |    6 |  4.68%
   17 |    5 |  3.90%
   18 |    9 |  7.03%
   19 |   17 | 13.28%
   20 |   10 |  7.81%
   21 |    7 |  5.46%
   22 |    9 |  7.03%
   23 |   16 | 12.50%
   24 |    9 |  7.03%
   25 |    5 |  3.90%
   26 |    3 |  2.34%
   27 |   12 |  9.37%
   28 |    2 |  1.56%
   29 |   14 | 10.93%
   30 |    5 |  3.90%
   31 |   12 |  9.37%

  Average avalanche: 7.61% (ideal 50%)

================================================================
  Validation Complete
================================================================
  All intra-device metrics computed successfully.

  Key observations to look for:
    - Uniformity close to 50% across all durations
    - Reliability > 95% for small c (2-4)
    - Inter-challenge HD close to 50% (good uniqueness)
    - Intra-HD histogram concentrated near 0
    - Avalanche effect approaching 50%

  For inter-device evaluation, run this test on
  additional FPGA boards and compare golden responses.
================================================================
