MarinGE23/axi-plpuf-ip/vitis-axi-plpuf/plpuf_test_app2/plpuf_test_app2_tests/plpuf_test_app2_7.txt

Opened with baud rate: 9600

================================================================
  PLPUF Exhaustive Intra-Device Validation
  TFG - Emanuel Antonio Marin Gutierrez
================================================================
  Challenges : 20
  Repetitions: 50
  Durations  : c = 1 .. 10
  PUF width  : 128 bits
================================================================

[INIT] Base = 0x44A00000

==== Test 1: Register Read/Write ====
  DURATION  wrote 12345  read 12345  [PASS]
  CHAL_0    wrote 0xDEADBEEF  read 0xDEADBEEF  [PASS]
  CHAL_3    wrote 0x9ABCDEF0  read 0x9ABCDEF0  [PASS]
  RESP_0    wrote 0xFFFFFFFF  read 0x00000000  [PASS read-only]
  Result: ALL PASS

==== Test 2: Soft Reset ====
  After eval : STATUS=0x02  busy=0 done=1
  After reset: STATUS=0x00  busy=0 done=0
  Done cleared: [PASS]

==== Test 3: Duration Sweep ====
  20 challenges x 50 reps per duration

   c | Uniform. | Reliab.  |  BER    | IntraHD  | InterHD
  ---+----------+----------+---------+----------+----------
   1 |  47.07%  |  98.95%  |  1.05% |   1.34   | 62.18 (48.58%)
   2 |  48.59%  |  97.25%  |  2.75% |   3.74   | 59.06 (46.14%)
   3 |  48.20%  |  96.79%  |  3.21% |   4.79   | 58.46 (45.67%)
   4 |  49.29%  |  95.04%  |  4.96% |   6.48   | 56.64 (44.25%)
   5 |  50.03%  |  93.58%  |  6.42% |   9.10   | 54.26 (42.39%)
   6 |  51.01%  |  92.70%  |  7.30% |  11.73   | 53.57 (41.85%)
   7 |  47.18%  |  91.87%  |  8.13% |  11.81   | 52.26 (40.83%)
   8 |  49.92%  |  89.83%  | 10.17% |  13.73   | 50.52 (39.47%)
   9 |  49.10%  |  89.57%  | 10.43% |  14.23   | 50.32 (39.31%)
  10 |  49.29%  |  88.67%  | 11.33% |  15.40   | 48.47 (37.87%)

  Uniformity : % of 1s in golden response (ideal 50%)
  Reliability: 1 - BER (ideal 100%)
  BER        : avg bit-flip rate vs golden (ideal 0%)
  IntraHD    : avg HD of fresh eval vs golden (ideal 0)
  InterHD    : avg HD between different challenges' golden (ideal 50%)

==== Test 4: Detailed Analysis at c = 5 ====

  [C0 R00] EBBC2A05_0357F6D1_55365D55_546C9255
  [C0 R01] E33C2A95_0356F651_57165D55_546C9251
  [C0 R02] E016EF95_D3561051_57177555_D5249B50
  [C0 R03] E03C2A95_0356F651_57365D55_546C9251
  [C0 R04] E33C2A95_0356F651_57165D55_546C9251
  [C0 R05] E03E6A95_1356B051_57375D55_54649A51
  [C0 R06] E03C6A95_1356F651_57365D55_546C9A51
  [C0 R07] E3BC2A95_0356F6D1_57365D55_546C9251
  [C0 R08] E23C2A95_0356F651_57365D55_546C9251
  [C0 R09] E01E6E95_93563051_57377D55_54249B50
  [C0 R10] E03E6A95_1356B051_57377D55_54649A50
  [C0 R11] EBBC2A05_0756F6D1_55365D55_146C9255
  [C0 R12] E03C2A95_1356B651_57165D55_546C9251
  [C0 R13] E016EF95_D3563051_57377555_D5249B50
  [C0 R14] E03C6A95_1356B651_57365D55_54649A51
  [C0 R15] E03C6A95_1356B651_57365D55_54649251
  [C0 R16] E03E6A95_1356B651_57377D55_54649A51
  [C0 R17] E016EF95_D3563051_57177555_55249B50
  [C0 R18] E3BC2A95_0356F6D1_57365D55_546C9251
  [C0 R19] E3BC2A95_0356F6D1_57365D55_546C9251
  [C0 R20] E03C6A95_1356B651_57365D55_546C9251
  [C0 R21] E03E6A95_1356B651_57375D55_54649A51
  [C0 R22] E01E6A95_13563051_57177D55_54649A50
  [C0 R23] E03C6A95_0356F651_57365D55_546C9A51
  [C0 R24] E33C2A95_0356F651_57165D55_546C9251
  [C0 R25] E33C2A95_0356F651_57365D55_546C9251
  [C0 R26] E01E6F95_93563051_57377555_54249B50
  [C0 R27] E01E6A95_93563051_57375D55_54649A50
  [C0 R28] E03C6A95_1356B651_57365D55_546C9251
  [C0 R29] E33C2A95_0356F651_57365D55_546C9251
  [C0 R30] E03C6A95_1356B651_57365D55_54649A51
  [C0 R31] E01E6A95_13563051_57377D55_54649A50
  [C0 R32] E01E6E95_93563051_57377D55_54249B50
  [C0 R33] E016EF95_D1561051_57377555_D5249B50
  [C0 R34] E23C2A95_0356F651_57365D55_546C9251
  [C0 R35] E81E6F95_93563051_57377D55_54249B50
  [C0 R36] E3BC2A85_0356F6D1_57365D55_546C9255
  [C0 R37] E03C2A95_0356F651_57165D55_546C9251
  [C0 R38] E33C2A95_0356F651_57365D55_546C9251
  [C0 R39] E03E6A95_1356B051_57377D55_54649A51
  [C0 R40] E01E6A95_93563051_57177D55_54649B50
  [C0 R41] E03E6A95_1356B451_57365D55_54649A51
  [C0 R42] E01E6A95_1356B451_57175D55_54649A51
  [C0 R43] E03C2A95_1356F651_57165D55_546C9251
  [C0 R44] E03C2A95_0356F651_57165D55_546C9251
  [C0 R45] E0166F95_93563051_57177D55_54249B50
  [C0 R46] E3BC2A95_0356F6D1_57165D55_546C9255
  [C0 R47] E01E6A95_13563051_57177D55_54649A50
  [C0 R48] E33C2A95_0356F651_57365D55_546C9251
  [C0 R49] E03E6A95_1356B651_57165D55_54649A51

  Golden[C0]: E03C6A95_1356B651_57365D55_54649A51  (majority vote of 50 evals)

  --- Bit Stability Map ---
  Per-bit reliability grade (9=stable, 0=noisy):

  [  0] 77777778886799788785778787789777  bits 0-31
  [ 32] 97787887778878877877788777787878  bits 32-63
  [ 64] 88877877767877777877777887776787  bits 64-95
  [ 96] 78877776777877787777678766886798  bits 96-127

  Stable bits (>=95% reliable): 44 / 128
  Noisy  bits (<80% reliable) : 0 / 128

  --- Intra-HD Histogram (c=5) ---
  20 challenges x 10 samples = 200 total

    0-  4 |######################################## 70
    5-  9 |############################## 54
   10- 14 |###################### 39
   15- 19 |########### 20
   20- 24 |###### 12
   25- 29 |## 4
   30- 34 | 1
   35- 39 | 0
   40- 44 | 0
   45- 49 | 0
   50- 54 | 0
   55- 59 | 0
   60- 64 | 0
   65- 69 | 0
   70- 74 | 0
   75- 79 | 0
   80- 84 | 0
   85- 89 | 0
   90- 94 | 0
   95- 99 | 0
  100-104 | 0
  105-109 | 0
  110-114 | 0
  115-119 | 0
  120-124 | 0
  125-128 | 0

==== Test 5: Avalanche Effect (c=5) ====
  Base challenge: 87654321_0FEDCBA9_9ABCDEF0_12345678
  Base golden   : 6A072198_C4532D5D_DB69575A_E7616D37

  Bit |   HD | HD%
  ----+------+-------
    0 |    9 |  7.03%
    1 |   11 |  8.59%
    2 |    6 |  4.68%
    3 |   10 |  7.81%
    4 |   12 |  9.37%
    5 |    6 |  4.68%
    6 |   10 |  7.81%
    7 |   10 |  7.81%
    8 |   11 |  8.59%
    9 |    8 |  6.25%
   10 |    7 |  5.46%
   11 |    7 |  5.46%
   12 |    9 |  7.03%
   13 |   11 |  8.59%
   14 |    8 |  6.25%
   15 |   15 | 11.71%
   16 |   10 |  7.81%
   17 |    8 |  6.25%
   18 |   12 |  9.37%
   19 |   11 |  8.59%
   20 |   11 |  8.59%
   21 |   10 |  7.81%
   22 |    8 |  6.25%
   23 |   16 | 12.50%
   24 |   12 |  9.37%
   25 |    7 |  5.46%
   26 |    8 |  6.25%
   27 |   11 |  8.59%
   28 |    2 |  1.56%
   29 |    6 |  4.68%
   30 |   10 |  7.81%
   31 |    7 |  5.46%

  Average avalanche: 7.29% (ideal 50%)

================================================================
  Validation Complete
================================================================
  All intra-device metrics computed successfully.

  Key observations to look for:
    - Uniformity close to 50% across all durations
    - Reliability > 95% for small c (2-4)
    - Inter-challenge HD close to 50% (good uniqueness)
    - Intra-HD histogram concentrated near 0
    - Avalanche effect approaching 50%

  For inter-device evaluation, run this test on
  additional FPGA boards and compare golden responses.
================================================================
