MarinGE23/axi-plpuf-ip/vitis-axi-plpuf/plpuf_test_app2/plpuf_test_app2_tests/plpuf_test_app2_8.txt

Opened with baud rate: 9600

================================================================
  PLPUF Exhaustive Intra-Device Validation
  TFG - Emanuel Antonio Marin Gutierrez
================================================================
  Challenges : 20
  Repetitions: 50
  Durations  : c = 1 .. 10
  PUF width  : 128 bits
================================================================

[INIT] Base = 0x44A00000

==== Test 1: Register Read/Write ====
  DURATION  wrote 12345  read 12345  [PASS]
  CHAL_0    wrote 0xDEADBEEF  read 0xDEADBEEF  [PASS]
  CHAL_3    wrote 0x9ABCDEF0  read 0x9ABCDEF0  [PASS]
  RESP_0    wrote 0xFFFFFFFF  read 0x00000000  [PASS read-only]
  Result: ALL PASS

==== Test 2: Soft Reset ====
  After eval : STATUS=0x02  busy=0 done=1
  After reset: STATUS=0x00  busy=0 done=0
  Done cleared: [PASS]

==== Test 3: Duration Sweep ====
  20 challenges x 50 reps per duration

   c | Uniform. | Reliab.  |  BER    | IntraHD  | InterHD
  ---+----------+----------+---------+----------+----------
   1 |  47.18%  |  99.00%  |  1.00% |   1.23   | 62.03 (48.46%)
   2 |  48.71%  |  97.07%  |  2.93% |   3.85   | 59.01 (46.10%)
   3 |  47.73%  |  96.91%  |  3.09% |   4.68   | 58.50 (45.70%)
   4 |  49.57%  |  95.01%  |  4.99% |   6.98   | 56.63 (44.24%)
   5 |  49.92%  |  93.16%  |  6.84% |   9.32   | 54.65 (42.69%)
   6 |  51.13%  |  92.98%  |  7.02% |  11.04   | 53.71 (41.96%)
   7 |  47.50%  |  92.10%  |  7.90% |  11.33   | 52.28 (40.84%)
   8 |  50.39%  |  90.28%  |  9.72% |  14.18   | 50.76 (39.66%)
   9 |  49.33%  |  89.56%  | 10.44% |  14.61   | 50.67 (39.59%)
  10 |  49.37%  |  88.58%  | 11.42% |  15.50   | 48.70 (38.05%)

  Uniformity : % of 1s in golden response (ideal 50%)
  Reliability: 1 - BER (ideal 100%)
  BER        : avg bit-flip rate vs golden (ideal 0%)
  IntraHD    : avg HD of fresh eval vs golden (ideal 0)
  InterHD    : avg HD between different challenges' golden (ideal 50%)

==== Test 4: Detailed Analysis at c = 5 ====

  [C0 R00] E03C6A95_1357B651_57365D55_546C9A51
  [C0 R01] E01E6A95_93563051_57177D55_54649A50
  [C0 R02] E03C6A95_0356F651_57365D55_546C9251
  [C0 R03] E03E6A95_1356B651_57165D55_546C9A51
  [C0 R04] E3BC2A85_0356F6D1_57365D55_146C9255
  [C0 R05] EBBC2A05_0756F6D1_55365D55_146C9255
  [C0 R06] E01E6F95_93563051_57377D55_54249B50
  [C0 R07] E0166F95_D3563051_57377555_54249B50
  [C0 R08] E03C2A95_0356F651_57165D55_546C9251
  [C0 R09] E0166F95_93563051_57177555_54249B50
  [C0 R10] E01E6A95_93563051_57177D55_54649A50
  [C0 R11] E33C2A85_0356F6D1_55165D55_546C9255
  [C0 R12] E33C2A95_0356F6D1_57165D55_546C9251
  [C0 R13] E23C2A95_0356F651_57165D55_546C9251
  [C0 R14] E0166F95_D3563051_57377555_D4249B50
  [C0 R15] E01E6A95_13563051_57177D55_54649A51
  [C0 R16] E0166F95_D3563051_57377555_D4249B50
  [C0 R17] E0166F95_93563051_57177555_54249B50
  [C0 R18] E03C2A95_0356F651_57165D55_546C9251
  [C0 R19] E33C2A95_0356F651_57365D55_546C9251
  [C0 R20] E01E6A95_1356B651_57177D55_54649A51
  [C0 R21] E33C2A95_0356F651_57165D55_546C9251
  [C0 R22] E03C2A95_0356F651_57165D55_546C9251
  [C0 R23] EBBC2A05_1756F6D5_55365D55_146C9257
  [C0 R24] E01E6E95_93563051_57177D55_54249B50
  [C0 R25] E016EF95_D3563051_57177555_D5249B50
  [C0 R26] E03C2A95_0356F651_57165D55_546C9251
  [C0 R27] E23C2A95_0356F651_57165D55_546C9251
  [C0 R28] EBBC2A85_0356F6D1_57365D55_146C9255
  [C0 R29] E016EF95_D3563051_57177555_D5249B50
  [C0 R30] E03E6A95_1356B651_57165D55_546C9251
  [C0 R31] E016EF95_D3563051_57175555_54249B50
  [C0 R32] E016EF95_D3563051_57177555_55249B50
  [C0 R33] E01E6A95_13563051_57377D55_54649A50
  [C0 R34] E01E6A95_13563051_57177D55_54649A50
  [C0 R35] E03E6A95_1356B051_57377D55_54649A51
  [C0 R36] E01E6A95_1356B651_57175D55_54649A51
  [C0 R37] E03E6A95_1356B651_57175D55_54649A51
  [C0 R38] E3BC2A95_0356F6D1_57165D55_546C9255
  [C0 R39] E3BC2A95_0356F6D1_57165D55_546C9251
  [C0 R40] E0166F95_D3563051_57177555_54249B50
  [C0 R41] E03E6A95_1356B651_57165D55_546C9A51
  [C0 R42] E03C2A95_0356F651_57165D55_546C9251
  [C0 R43] E03E6A95_1356B251_57165D55_54649251
  [C0 R44] EBBC2A85_0356F6D1_55365D55_146C9255
  [C0 R45] E01E6A95_13563051_57377D55_54649A50
  [C0 R46] E01E6A95_13563051_57177D55_54649A50
  [C0 R47] E03E6A95_1356B651_57165D55_54649A51
  [C0 R48] E33C2A95_0356F651_57165D55_546C9251
  [C0 R49] E03E6A95_1356B651_57165D55_54649A51

  Golden[C0]: E03E6A95_1356B651_57165D55_54649A51  (majority vote of 50 evals)

  --- Bit Stability Map ---
  Per-bit reliability grade (9=stable, 0=noisy):

  [  0] 76777777886799798785767786789777  bits 0-31
  [ 32] 87787887778878877887778777888877  bits 32-63
  [ 64] 88877877767877777877777777776886  bits 64-95
  [ 96] 78877776777877787777678766786798  bits 96-127

  Stable bits (>=95% reliable): 41 / 128
  Noisy  bits (<80% reliable) : 1 / 128

  --- Intra-HD Histogram (c=5) ---
  20 challenges x 10 samples = 200 total

    0-  4 |######################################## 57
    5-  9 |############################### 45
   10- 14 |##################################### 53
   15- 19 |################## 27
   20- 24 |####### 10
   25- 29 |## 4
   30- 34 |## 3
   35- 39 | 1
   40- 44 | 0
   45- 49 | 0
   50- 54 | 0
   55- 59 | 0
   60- 64 | 0
   65- 69 | 0
   70- 74 | 0
   75- 79 | 0
   80- 84 | 0
   85- 89 | 0
   90- 94 | 0
   95- 99 | 0
  100-104 | 0
  105-109 | 0
  110-114 | 0
  115-119 | 0
  120-124 | 0
  125-128 | 0

==== Test 5: Avalanche Effect (c=5) ====
  Base challenge: 87654321_0FEDCBA9_9ABCDEF0_12345678
  Base golden   : 6A972199_84536D5D_5B49575A_C5636D37

  Bit |   HD | HD%
  ----+------+-------
    0 |    9 |  7.03%
    1 |   19 | 14.84%
    2 |    6 |  4.68%
    3 |    7 |  5.46%
    4 |    8 |  6.25%
    5 |    6 |  4.68%
    6 |   14 | 10.93%
    7 |   19 | 14.84%
    8 |    6 |  4.68%
    9 |   20 | 15.62%
   10 |   21 | 16.40%
   11 |    9 |  7.03%
   12 |   15 | 11.71%
   13 |   19 | 14.84%
   14 |   10 |  7.81%
   15 |    8 |  6.25%
   16 |   18 | 14.06%
   17 |   17 | 13.28%
   18 |   13 | 10.15%
   19 |   18 | 14.06%
   20 |   18 | 14.06%
   21 |   15 | 11.71%
   22 |    6 |  4.68%
   23 |   23 | 17.96%
   24 |    7 |  5.46%
   25 |    3 |  2.34%
   26 |   17 | 13.28%
   27 |   19 | 14.84%
   28 |   18 | 14.06%
   29 |   20 | 15.62%
   30 |   19 | 14.84%
   31 |   19 | 14.84%

  Average avalanche: 10.88% (ideal 50%)

================================================================
  Validation Complete
================================================================
  All intra-device metrics computed successfully.

  Key observations to look for:
    - Uniformity close to 50% across all durations
    - Reliability > 95% for small c (2-4)
    - Inter-challenge HD close to 50% (good uniqueness)
    - Intra-HD histogram concentrated near 0
    - Avalanche effect approaching 50%

  For inter-device evaluation, run this test on
  additional FPGA boards and compare golden responses.
================================================================
