MarinGE23/axi-plpuf-ip/vitis-axi-plpuf/plpuf_test_app2/plpuf_test_app2_tests/plpuf_test_app2_9.txt

Opened with baud rate: 9600

================================================================
  PLPUF Exhaustive Intra-Device Validation
  TFG - Emanuel Antonio Marin Gutierrez
================================================================
  Challenges : 20
  Repetitions: 50
  Durations  : c = 1 .. 10
  PUF width  : 128 bits
================================================================

[INIT] Base = 0x44A00000

==== Test 1: Register Read/Write ====
  DURATION  wrote 12345  read 12345  [PASS]
  CHAL_0    wrote 0xDEADBEEF  read 0xDEADBEEF  [PASS]
  CHAL_3    wrote 0x9ABCDEF0  read 0x9ABCDEF0  [PASS]
  RESP_0    wrote 0xFFFFFFFF  read 0x00000000  [PASS read-only]
  Result: ALL PASS

==== Test 2: Soft Reset ====
  After eval : STATUS=0x02  busy=0 done=1
  After reset: STATUS=0x00  busy=0 done=0
  Done cleared: [PASS]

==== Test 3: Duration Sweep ====
  20 challenges x 50 reps per duration

   c | Uniform. | Reliab.  |  BER    | IntraHD  | InterHD
  ---+----------+----------+---------+----------+----------
   1 |  47.14%  |  99.01%  |  0.99% |   1.24   | 62.15 (48.55%)
   2 |  48.86%  |  97.10%  |  2.90% |   4.40   | 58.98 (46.08%)
   3 |  47.85%  |  96.87%  |  3.13% |   4.82   | 58.44 (45.66%)
   4 |  49.33%  |  95.06%  |  4.94% |   6.88   | 56.37 (44.04%)
   5 |  50.23%  |  93.17%  |  6.83% |  10.03   | 54.53 (42.60%)
   6 |  51.13%  |  92.80%  |  7.20% |   9.53   | 53.52 (41.81%)
   7 |  47.22%  |  91.89%  |  8.11% |  12.13   | 52.28 (40.85%)
   8 |  50.11%  |  89.79%  | 10.21% |  13.11   | 50.65 (39.57%)
   9 |  49.37%  |  89.60%  | 10.40% |  14.39   | 50.41 (39.38%)
  10 |  49.14%  |  88.57%  | 11.43% |  16.26   | 49.00 (38.28%)

  Uniformity : % of 1s in golden response (ideal 50%)
  Reliability: 1 - BER (ideal 100%)
  BER        : avg bit-flip rate vs golden (ideal 0%)
  IntraHD    : avg HD of fresh eval vs golden (ideal 0)
  InterHD    : avg HD between different challenges' golden (ideal 50%)

==== Test 4: Detailed Analysis at c = 5 ====

  [C0 R00] E03C2A95_1356F651_57365D55_546C9A51
  [C0 R01] EBBC2A85_0356F6D1_55365D55_546C9255
  [C0 R02] E03E6A95_1356B451_57375D55_54649A51
  [C0 R03] E3BC2A95_0356F651_57365D55_546C9251
  [C0 R04] E3BC2A85_0356F6D1_57365D55_546C9255
  [C0 R05] EBBC2A85_0356F6D1_57365D55_146C9255
  [C0 R06] E03E6A95_1356B051_57377D55_54649A50
  [C0 R07] E0166F95_93563051_57177555_54249B50
  [C0 R08] E01E6A95_93563051_57177D55_54649B50
  [C0 R09] E93C2A85_0356F6D1_55365D55_146C9255
  [C0 R10] E3BC2A95_0356F651_57165D55_546C9251
  [C0 R11] E03C6A95_1356B651_57375D55_54649A51
  [C0 R12] E23C2A95_0356F651_57165D55_546C9251
  [C0 R13] E33C2A95_0356F651_57165D55_546C9251
  [C0 R14] E01E6A95_1356B051_57177D55_54649A51
  [C0 R15] E01E6F95_93563051_57377555_54249B50
  [C0 R16] E016EF95_D3561051_57377555_D5249B50
  [C0 R17] E23C2A95_0356F651_57165D55_546C9251
  [C0 R18] E23C2A95_0356F651_57365D55_546C9251
  [C0 R19] E03E6A95_1356B651_57365D55_54649A51
  [C0 R20] E01E6A95_93563051_57177D55_54649A50
  [C0 R21] E016EF95_D3563051_57377555_D4249B50
  [C0 R22] E23C2A95_0356F651_57365D55_546C9251
  [C0 R23] E01E6E95_93563051_57377D55_54649B50
  [C0 R24] E01E6A95_1356B051_57177D55_54649A51
  [C0 R25] E01E6A95_93563051_57377D55_54649A50
  [C0 R26] E03C2A95_0356F651_57365D55_546C9251
  [C0 R27] E23C2A95_0356F651_57365D55_546C9251
  [C0 R28] E03C2A95_0356F651_57365D55_546C9251
  [C0 R29] E01E6A95_93563051_57177D55_54649A50
  [C0 R30] E016EF95_D3563051_57177555_D5249B50
  [C0 R31] E8166F95_D3563051_57177555_54249B50
  [C0 R32] E03C6A95_1356B651_57165D55_546C9A51
  [C0 R33] E01E6A95_93563051_57377D55_54649A50
  [C0 R34] EBBC2A85_0356F6D1_55365D55_146C9255
  [C0 R35] E016EF95_D3563051_57377555_55249B50
  [C0 R36] E3BC2A95_0356F6D1_57365D55_546C9251
  [C0 R37] E01E6F95_D3563051_57177555_54249B50
  [C0 R38] EBBC2A85_0356F6D1_55365D55_146C9255
  [C0 R39] E3BC2A95_0356F6D1_57165D55_546C9255
  [C0 R40] E01E6A95_93563051_57177D55_54649A51
  [C0 R41] E03C6A95_0356B651_57165D55_546C9A51
  [C0 R42] E01E6A95_13563451_57175D55_54649A51
  [C0 R43] E01E6E95_93563051_57377D55_54249B50
  [C0 R44] E016EF95_D3563051_57177555_D5249B50
  [C0 R45] E03C2A95_1356B651_57165D55_546C9251
  [C0 R46] E01E6A95_13563051_57177D55_54649A50
  [C0 R47] E03E2A95_1356B651_57365D55_54649A51
  [C0 R48] E03C2A95_0356F651_57365D55_546C9251
  [C0 R49] EBBC2A85_0356F6D1_55365D55_146C9255

  Golden[C0]: E03C6A95_1356B651_57365D55_54649A51  (majority vote of 50 evals)

  --- Bit Stability Map ---
  Per-bit reliability grade (9=stable, 0=noisy):

  [  0] 76677777786799788785777786789777  bits 0-31
  [ 32] 87777887778778877887778776787877  bits 32-63
  [ 64] 88877877767877777777777776776786  bits 64-95
  [ 96] 78877776677877787777678766786798  bits 96-127

  Stable bits (>=95% reliable): 34 / 128
  Noisy  bits (<80% reliable) : 1 / 128

  --- Intra-HD Histogram (c=5) ---
  20 challenges x 10 samples = 200 total

    0-  4 |######################################## 53
    5-  9 |################################## 46
   10- 14 |########################### 36
   15- 19 |############################# 39
   20- 24 |############# 18
   25- 29 |##### 7
   30- 34 | 1
   35- 39 | 0
   40- 44 | 0
   45- 49 | 0
   50- 54 | 0
   55- 59 | 0
   60- 64 | 0
   65- 69 | 0
   70- 74 | 0
   75- 79 | 0
   80- 84 | 0
   85- 89 | 0
   90- 94 | 0
   95- 99 | 0
  100-104 | 0
  105-109 | 0
  110-114 | 0
  115-119 | 0
  120-124 | 0
  125-128 | 0

==== Test 5: Avalanche Effect (c=5) ====
  Base challenge: 87654321_0FEDCBA9_9ABCDEF0_12345678
  Base golden   : 6A072998_C4532D4D_DB69555A_67616533

  Bit |   HD | HD%
  ----+------+-------
    0 |    7 |  5.46%
    1 |    8 |  6.25%
    2 |    9 |  7.03%
    3 |   12 |  9.37%
    4 |   15 | 11.71%
    5 |   15 | 11.71%
    6 |   15 | 11.71%
    7 |   15 | 11.71%
    8 |   17 | 13.28%
    9 |   15 | 11.71%
   10 |    8 |  6.25%
   11 |    5 |  3.90%
   12 |   12 |  9.37%
   13 |    7 |  5.46%
   14 |    6 |  4.68%
   15 |   15 | 11.71%
   16 |   18 | 14.06%
   17 |    8 |  6.25%
   18 |   16 | 12.50%
   19 |    8 |  6.25%
   20 |   17 | 13.28%
   21 |   16 | 12.50%
   22 |   14 | 10.93%
   23 |    7 |  5.46%
   24 |   15 | 11.71%
   25 |   16 | 12.50%
   26 |   10 |  7.81%
   27 |   16 | 12.50%
   28 |   14 | 10.93%
   29 |   20 | 15.62%
   30 |   13 | 10.15%
   31 |    7 |  5.46%

  Average avalanche: 9.66% (ideal 50%)

================================================================
  Validation Complete
================================================================
  All intra-device metrics computed successfully.

  Key observations to look for:
    - Uniformity close to 50% across all durations
    - Reliability > 95% for small c (2-4)
    - Inter-challenge HD close to 50% (good uniqueness)
    - Intra-HD histogram concentrated near 0
    - Avalanche effect approaching 50%

  For inter-device evaluation, run this test on
  additional FPGA boards and compare golden responses.
================================================================
