MarinGE23/axi-plpuf-ip/documento_tfg_emanuel_marin_overleaf/Documento_TFG_EmanuelMarin/fig/plpuf_evaluate.png

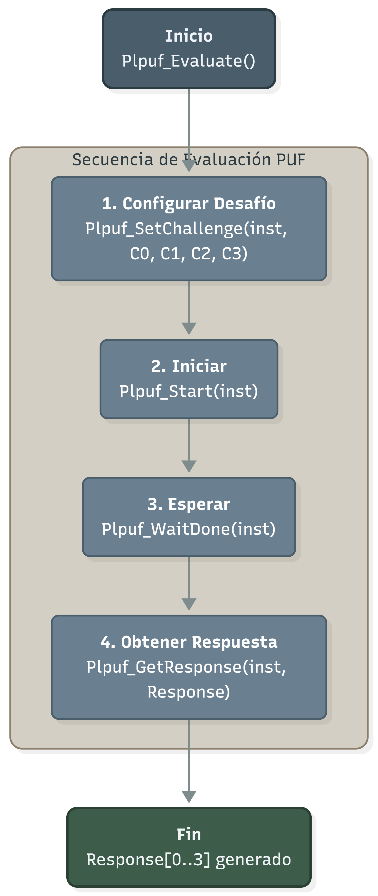
documento_tfg_emanuel_marin_overleaf/Documento_TFG_EmanuelMarin/fig/plpuf_evaluate.png
