MarinGE23/axi-plpuf-ip/documento_tfg_emanuel_marin_overleaf/Documento_TFG_EmanuelMarin/fig/block_design.pdf

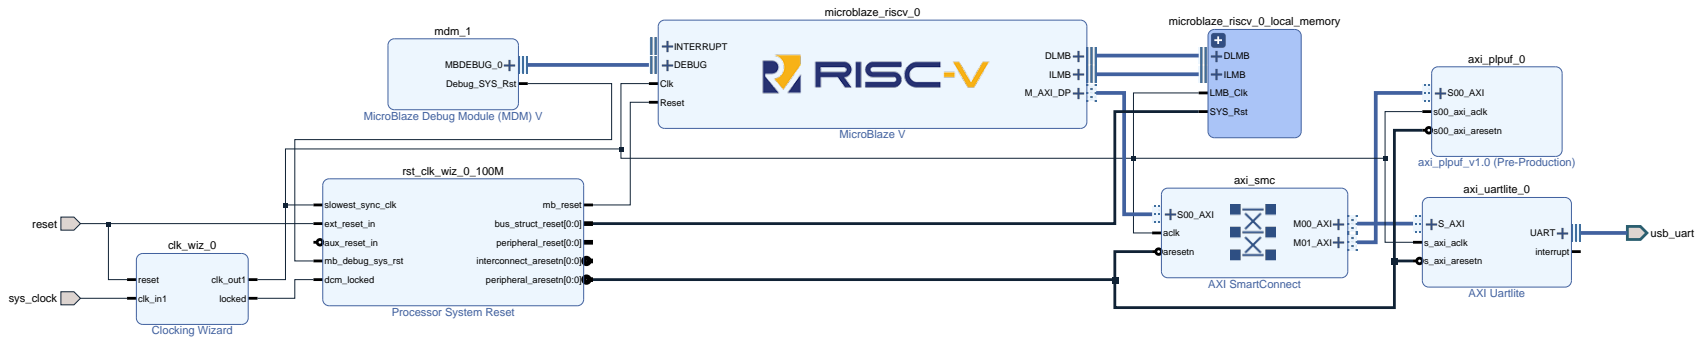
[picture p29: page 1]
axi_plpuf_0; axi_plpuf_v1.0 (Pre-Production); S00_AXI; s00_axi_aclk; s00_axi_aresetn; axi_smc; AXI SmartConnect; M00_AXI M01_AXI; aclk; aresetn; axi_uartlite_0; AXI Uartlite; S_AXI; UART; s_axi_aclk; s_axi_aresetn; interrupt clk_wiz_0; Clocking Wizard; reset; clk_in1; clk_out1; locked; mdm_1; MBDEBUG_0; Debug_SYS_Rst; microblaze_riscv_0; MicroBlaze V; INTERRUPT; DLMB; ILMB M_AXI_DP; DEBUG; Clk; Reset; microblaze_riscv_0_local_memory; ILMB; LMB_Clk; SYS_Rst; sys_clock; rst_clk_wiz_0_100M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

MicroBlaze Debug Module (MDM) V

Processor System Reset
