MarinGE23/axi-plpuf-ip/documento_tfg_emanuel_marin_overleaf/Documento_TFG_EmanuelMarin/fig/res_inter_hd.pdf

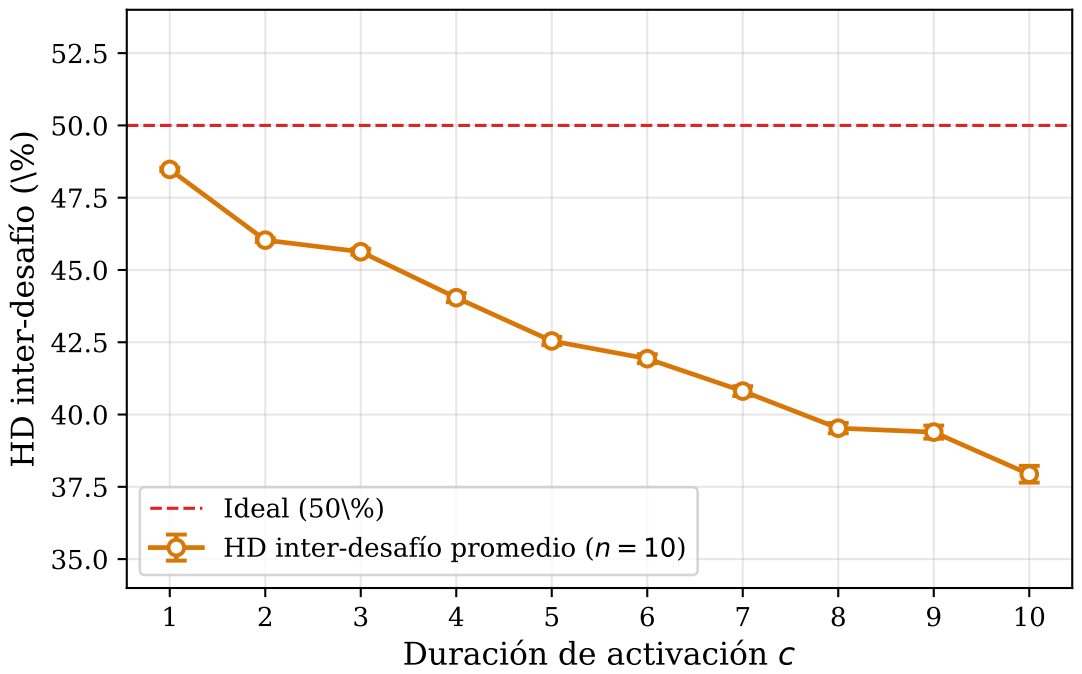
[picture p30: page 1]

HD inter-desafío (\%)

Ideal (50\%) HD inter-des
