MarinGE23/axi-plpuf-ip/documento_tfg_emanuel_marin_overleaf/Documento_TFG_EmanuelMarin/fig/res_summary_4panel.pdf

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

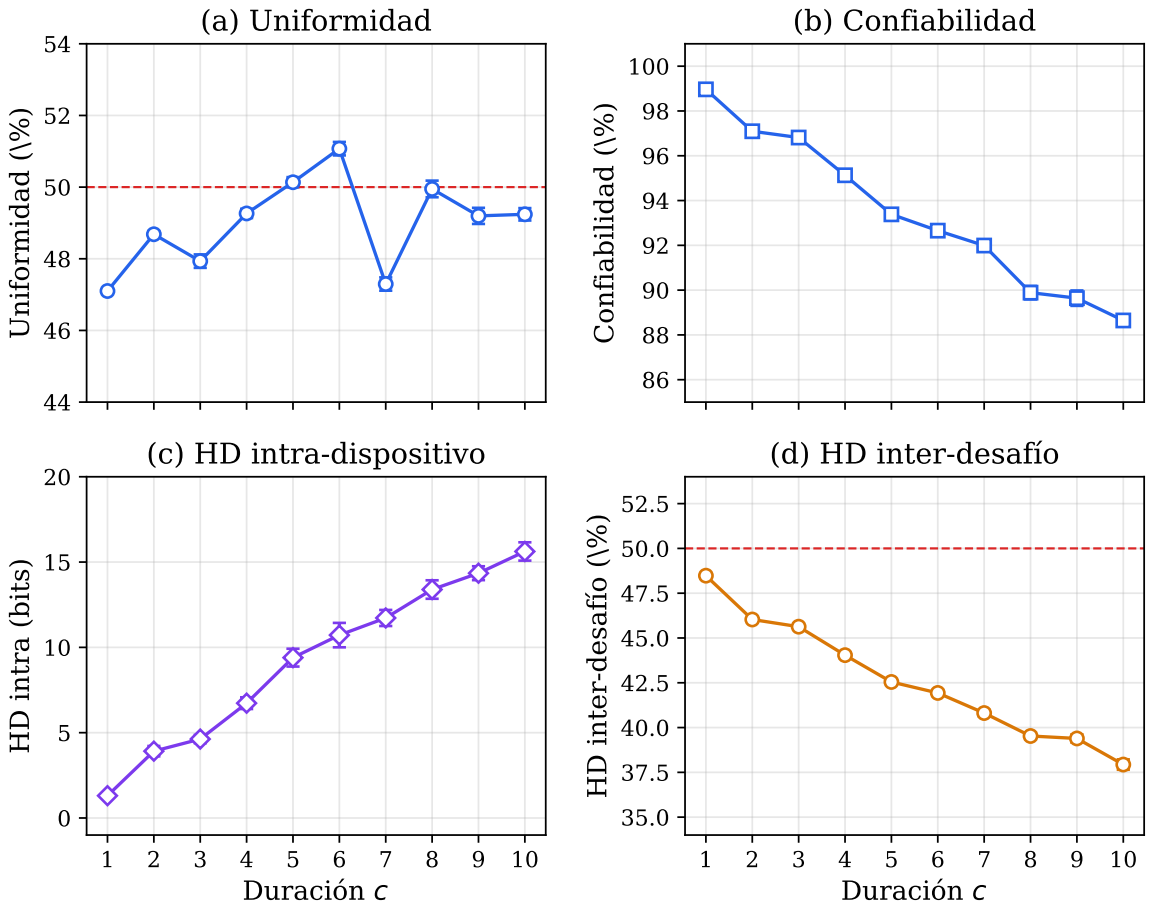
[picture p31: page 1]
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
