MarinGE23/axi-plpuf-ip/documento_tfg_emanuel_marin_overleaf/Documento_TFG_EmanuelMarin/fig/res_uniformity.pdf

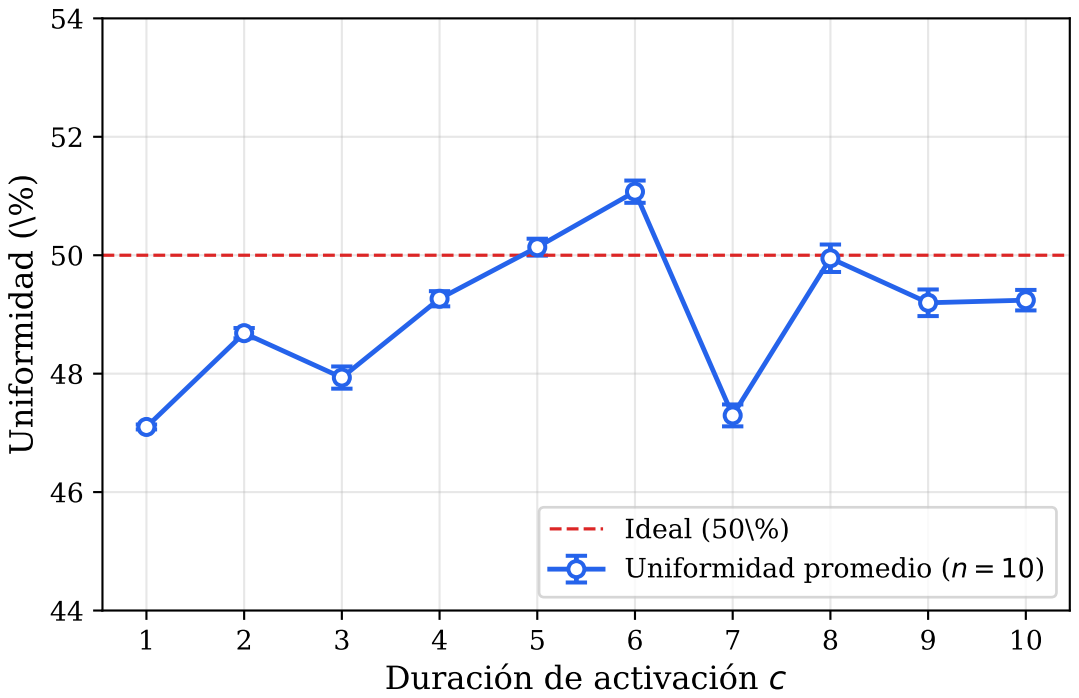
[picture p32: page 1]
Uniformidad (\%); Ideal (50\%) Uniformidad
