MarinGE23/axi-plpuf-ip/vivado-axi-plpuf/vivado-axi-plpuf.runs/design_1_mdm_1_0_synth_1/.Xil/design_1_mdm_1_0_propImpl.xdc

set_property SRC_FILE_INFO {cfile:c:/Users/emari/Desktop/axi-plpuf-ip/vivado-axi-plpuf/vivado-axi-plpuf.gen/sources_1/bd/design_1/ip/design_1_mdm_1_0/design_1_mdm_1_0.xdc rfile:../../../vivado-axi-plpuf.gen/sources_1/bd/design_1/ip/design_1_mdm_1_0/design_1_mdm_1_0.xdc id:1 order:LATE scoped_inst:U0} [current_design]
current_instance U0
set_property src_info {type:SCOPED_XDC file:1 line:15 export:INPUT save:INPUT read:READ} [current_design]
create_waiver -internal -user mdm_riscv -tags IPCPG-503 -type CDC -id CDC-10 -description "Debug protocol ensures stable signals" -from [get_pins -quiet MDM_Core_I1/JTAG_CONTROL_I/*/C]
set_property src_info {type:SCOPED_XDC file:1 line:18 export:INPUT save:INPUT read:READ} [current_design]
create_waiver -internal -scoped -user mdm_riscv -tags IPCPG-503 -type METHODOLOGY -id TIMING-54 -object [get_clocks -quiet -of_objects [get_pins "Use*.BSCAN*/*/UPDATE"]] -description "Avoid warning for valid UPDATE clock constraint"
set_property src_info {type:SCOPED_XDC file:1 line:21 export:INPUT save:INPUT read:READ} [current_design]
create_waiver -internal -scoped -user mdm_riscv -tags IPCPG-503 -type METHODOLOGY -id TIMING-54 -object [get_clocks -quiet -of_objects [get_pins "Use*.BSCAN*/*/TCK"]] -description "Avoid warning for valid TCK clock constraint"
set_property src_info {type:SCOPED_XDC file:1 line:24 export:INPUT save:INPUT read:READ} [current_design]
create_waiver -internal -scoped -user mdm_riscv -tags IPCPG-503 -type METHODOLOGY -id TIMING-54 -object [get_clocks -quiet -of_objects [get_pins */*/*.BUFG_UPDATE/*/O]] -description "Avoid warning for valid UPDATE clock constraint"
set_property src_info {type:SCOPED_XDC file:1 line:29 export:INPUT save:INPUT read:READ} [current_design]
create_waiver -internal -user mdm_riscv -tags IPCPG-503 -type CDC -id CDC-1  -description "Debug protocol ensures stable signals" -from [get_pins -quiet MDM_Core_I1/JTAG_CONTROL_I/*/C]
set_property src_info {type:SCOPED_XDC file:1 line:30 export:INPUT save:INPUT read:READ} [current_design]
create_waiver -internal -user mdm_riscv -tags IPCPG-503 -type CDC -id CDC-1  -description "Debug protocol ensures stable signals" -from [get_pins -quiet Use_E2.BSCAN_I/Use_E2.BSCANE2_I/INTERNAL_TDI]
set_property src_info {type:SCOPED_XDC file:1 line:31 export:INPUT save:INPUT read:READ} [current_design]
create_waiver -internal -user mdm_riscv -tags IPCPG-503 -type CDC -id CDC-1  -description "Debug protocol ensures stable signals" -from [get_pins -quiet Use_E2.BSCAN_I/Use_E2.BSCANE2_I/INTERNAL_TCK]
set_property src_info {type:SCOPED_XDC file:1 line:32 export:INPUT save:INPUT read:READ} [current_design]
create_waiver -internal -user mdm_riscv -tags IPCPG-503 -type CDC -id CDC-1  -description "Debug protocol ensures stable signals" -from [get_pins -quiet Use_E2.BSCAN_I/Use_E2.BSCANE2_I/UPDATE]
set_property src_info {type:SCOPED_XDC file:1 line:33 export:INPUT save:INPUT read:READ} [current_design]
create_waiver -internal -user mdm_riscv -tags IPCPG-503 -type CDC -id CDC-1  -description "Debug protocol ensures stable signals" -to [get_pins -quiet MDM_Core_I1/JTAG_CONTROL_I/*/CE]
set_property src_info {type:SCOPED_XDC file:1 line:34 export:INPUT save:INPUT read:READ} [current_design]
create_waiver -internal -user mdm_riscv -tags IPCPG-503 -type CDC -id CDC-1  -description "Debug protocol ensures stable signals" -to [get_pins -quiet MDM_Core_I1/JTAG_CONTROL_I/*/D]
set_property src_info {type:SCOPED_XDC file:1 line:35 export:INPUT save:INPUT read:READ} [current_design]
create_waiver -internal -user mdm_riscv -tags IPCPG-503 -type CDC -id CDC-1  -description "Debug protocol ensures stable signals" -to [get_pins -quiet MDM_Core_I1/JTAG_CONTROL_I/*/R]
set_property src_info {type:SCOPED_XDC file:1 line:36 export:INPUT save:INPUT read:READ} [current_design]
create_waiver -internal -user mdm_riscv -tags IPCPG-503 -type CDC -id CDC-1  -description "Debug protocol ensures stable signals" -to [get_pins -quiet Use_JTAG_BSCAN.*/CE]
set_property src_info {type:SCOPED_XDC file:1 line:37 export:INPUT save:INPUT read:READ} [current_design]
create_waiver -internal -user mdm_riscv -tags IPCPG-503 -type CDC -id CDC-1  -description "Debug protocol ensures stable signals" -to [get_pins -quiet Use_JTAG_BSCAN.*/D]
set_property src_info {type:SCOPED_XDC file:1 line:38 export:INPUT save:INPUT read:READ} [current_design]
create_waiver -internal -user mdm_riscv -tags IPCPG-503 -type CDC -id CDC-1  -description "Debug protocol ensures stable signals" -to [get_pins -quiet Use_JTAG_BSCAN.*/R]
set_property src_info {type:SCOPED_XDC file:1 line:39 export:INPUT save:INPUT read:READ} [current_design]
create_waiver -internal -user mdm_riscv -tags IPCPG-503 -type CDC -id CDC-2  -description "Debug protocol ensures stable signals" -from [get_pins -quiet Use_E2.BSCAN_I/Use_E2.BSCANE2_I/INTERNAL_TCK]
set_property src_info {type:SCOPED_XDC file:1 line:40 export:INPUT save:INPUT read:READ} [current_design]
create_waiver -internal -user mdm_riscv -tags IPCPG-503 -type CDC -id CDC-7  -description "Debug protocol ensures stable signals" -from [get_pins -quiet Use_E2.BSCAN_I/Use_E2.BSCANE2_I/INTERNAL_TCK]
set_property src_info {type:SCOPED_XDC file:1 line:41 export:INPUT save:INPUT read:READ} [current_design]
create_waiver -internal -user mdm_riscv -tags IPCPG-503 -type CDC -id CDC-10 -description "Debug protocol ensures stable signals" -from [get_pins -quiet Use_E2.BSCAN_I/Use_E2.BSCANE2_I/INTERNAL_TCK]
set_property src_info {type:SCOPED_XDC file:1 line:42 export:INPUT save:INPUT read:READ} [current_design]
create_waiver -internal -user mdm_riscv -tags IPCPG-503 -type CDC -id CDC-11 -description "Debug protocol ensures stable signals" -from [get_pins -quiet Use_E2.BSCAN_I/Use_E2.BSCANE2_I/INTERNAL_TCK]
set_property src_info {type:SCOPED_XDC file:1 line:43 export:INPUT save:INPUT read:READ} [current_design]
create_waiver -internal -user mdm_riscv -tags IPCPG-503 -type CDC -id CDC-13 -description "Debug protocol ensures stable signals" -from [get_pins -quiet MDM_Core_I1/JTAG_CONTROL_I/*/C]
set_property src_info {type:SCOPED_XDC file:1 line:44 export:INPUT save:INPUT read:READ} [current_design]
create_waiver -internal -user mdm_riscv -tags IPCPG-503 -type CDC -id CDC-13 -description "Debug protocol ensures stable signals" -from [get_pins -quiet Use_JTAG_BSCAN.*/C]
set_property src_info {type:SCOPED_XDC file:1 line:45 export:INPUT save:INPUT read:READ} [current_design]
create_waiver -internal -user mdm_riscv -tags IPCPG-503 -type CDC -id CDC-13 -description "Debug protocol ensures stable signals" -from [get_pins -quiet MDM_Core_I1/JTAG_CONTROL_I/*/*/O]
set_property src_info {type:SCOPED_XDC file:1 line:46 export:INPUT save:INPUT read:READ} [current_design]
create_waiver -internal -user mdm_riscv -tags IPCPG-503 -type CDC -id CDC-13 -description "Debug protocol ensures stable signals" -from [get_pins -quiet Use_E2.BSCAN_I/Use_E2.BSCANE2_I/INTERNAL_TDI]
set_property src_info {type:SCOPED_XDC file:1 line:47 export:INPUT save:INPUT read:READ} [current_design]
create_waiver -internal -user mdm_riscv -tags IPCPG-503 -type CDC -id CDC-15 -description "Debug protocol ensures stable signals" -from [get_pins -quiet MDM_Core_I1/JTAG_CONTROL_I/*/C]
set_property src_info {type:SCOPED_XDC file:1 line:48 export:INPUT save:INPUT read:READ} [current_design]
create_waiver -internal -user mdm_riscv -tags IPCPG-503 -type CDC -id CDC-15 -description "Debug protocol ensures stable signals" -from [get_pins -quiet Use_E2.BSCAN_I/Use_E2.BSCANE2_I/INTERNAL_TDI]
set_property src_info {type:SCOPED_XDC file:1 line:49 export:INPUT save:INPUT read:READ} [current_design]
create_waiver -internal -user mdm_riscv -tags IPCPG-503 -type CDC -id CDC-15 -description "Debug protocol ensures stable signals" -from [get_pins -quiet Use_E2.BSCAN_I/Use_E2.BSCANE2_I/INTERNAL_TCK]
set_property src_info {type:SCOPED_XDC file:1 line:50 export:INPUT save:INPUT read:READ} [current_design]
create_waiver -internal -user mdm_riscv -tags IPCPG-503 -type CDC -id CDC-15 -description "Debug protocol ensures stable signals" -from [get_pins -quiet Use_E2.BSCAN_I/Use_E2.BSCANE2_I/UPDATE]
set_property src_info {type:SCOPED_XDC file:1 line:51 export:INPUT save:INPUT read:READ} [current_design]
create_waiver -internal -user mdm_riscv -tags IPCPG-503 -type CDC -id CDC-15 -description "Debug protocol ensures stable signals" -to [get_pins -quiet MDM_Core_I1/JTAG_CONTROL_I/*/R]
set_property src_info {type:SCOPED_XDC file:1 line:52 export:INPUT save:INPUT read:READ} [current_design]
create_waiver -internal -user mdm_riscv -tags IPCPG-503 -type CDC -id CDC-15 -description "Debug protocol ensures stable signals" -to [get_pins -quiet Use_JTAG_BSCAN.*/R]
set_property src_info {type:SCOPED_XDC file:1 line:54 export:INPUT save:INPUT read:READ} [current_design]
create_waiver -internal -user mdm_riscv -tags IPCPG-503 -type CDC -id CDC-1  -description "Debug protocol ensures stable signals" -to [get_pins -quiet Internal_BSCANID.bscanid*reg/D]
set_property src_info {type:SCOPED_XDC file:1 line:55 export:INPUT save:INPUT read:READ} [current_design]
create_waiver -internal -user mdm_riscv -tags IPCPG-503 -type CDC -id CDC-1  -description "Debug protocol ensures stable signals" -to [get_pins -quiet Internal_BSCANID.bscanid*reg/CE]
