MarinGE23/axi-plpuf-ip/vivado-axi-plpuf/vivado-axi-plpuf.runs/design_1_microblaze_riscv_0_0_synth_1/.Xil/design_1_microblaze_riscv_0_0_propImpl.xdc

set_property SRC_FILE_INFO {cfile:c:/Users/emari/Desktop/axi-plpuf-ip/vivado-axi-plpuf/vivado-axi-plpuf.gen/sources_1/bd/design_1/ip/design_1_microblaze_riscv_0_0/design_1_microblaze_riscv_0_0.xdc rfile:../../../vivado-axi-plpuf.gen/sources_1/bd/design_1/ip/design_1_microblaze_riscv_0_0/design_1_microblaze_riscv_0_0.xdc id:1 order:EARLY scoped_inst:U0} [current_design]
current_instance U0
set_property src_info {type:SCOPED_XDC file:1 line:4 export:INPUT save:INPUT read:READ} [current_design]
create_waiver -internal -scoped -user microblaze_riscv -tags IPCPG-502 -type CDC -id CDC-1  -description "Debug protocol ensures stable signals" -from [get_pins -quiet riscv_core_I/*.Core/*Debug_Logic.Master_Core.Debug*/Serial_Dbg_Intf.*/C]
set_property src_info {type:SCOPED_XDC file:1 line:5 export:INPUT save:INPUT read:READ} [current_design]
create_waiver -internal -scoped -user microblaze_riscv -tags IPCPG-502 -type CDC -id CDC-3  -description "Debug protocol ensures stable signals" -from [get_pins -quiet riscv_core_I/*.Core/*Debug_Logic.Master_Core.Debug*/Serial_Dbg_Intf.*/C]
set_property src_info {type:SCOPED_XDC file:1 line:6 export:INPUT save:INPUT read:READ} [current_design]
create_waiver -internal -scoped -user microblaze_riscv -tags IPCPG-502 -type CDC -id CDC-7  -description "Debug protocol ensures stable signals" -from [get_pins -quiet riscv_core_I/*.Core/*Debug_Logic.Master_Core.Debug*/Serial_Dbg_Intf.*/C]
set_property src_info {type:SCOPED_XDC file:1 line:7 export:INPUT save:INPUT read:READ} [current_design]
create_waiver -internal -scoped -user microblaze_riscv -tags IPCPG-502 -type CDC -id CDC-10 -description "Debug protocol ensures stable signals" -from [get_pins -quiet riscv_core_I/*.Core/*Debug_Logic.Master_Core.Debug*/Serial_Dbg_Intf.*/C]
set_property src_info {type:SCOPED_XDC file:1 line:8 export:INPUT save:INPUT read:READ} [current_design]
create_waiver -internal -scoped -user microblaze_riscv -tags IPCPG-502 -type CDC -id CDC-13 -description "Debug protocol ensures stable signals" -from [get_pins -quiet riscv_core_I/*.Core/*Debug_Logic.Master_Core.Debug*/Serial_Dbg_Intf.*/C]
set_property src_info {type:SCOPED_XDC file:1 line:9 export:INPUT save:INPUT read:READ} [current_design]
create_waiver -internal -scoped -user microblaze_riscv -tags IPCPG-502 -type CDC -id CDC-15 -description "Debug protocol ensures stable signals" -from [get_pins -quiet riscv_core_I/*.Core/*Debug_Logic.Master_Core.Debug*/Serial_Dbg_Intf.*/C]
set_property src_info {type:SCOPED_XDC file:1 line:10 export:INPUT save:INPUT read:READ} [current_design]
create_waiver -internal -scoped -user microblaze_riscv -tags IPCPG-502 -type CDC -id CDC-15 -description "Debug protocol ensures stable signals" -from [get_pins -quiet riscv_core_I/*.Core/*Debug_Logic.Master_Core.Debug*/*/C]
set_property src_info {type:SCOPED_XDC file:1 line:12 export:INPUT save:INPUT read:READ} [current_design]
create_waiver -internal -scoped -user microblaze_riscv -tags IPCPG-502 -type CDC -id CDC-1  -description "Debug protocol ensures stable signals" -to [get_pins -quiet riscv_core_I/*.Core/*Debug_Logic.Master_Core.Debug*/Serial_Dbg_Intf.*/D]
set_property src_info {type:SCOPED_XDC file:1 line:13 export:INPUT save:INPUT read:READ} [current_design]
create_waiver -internal -scoped -user microblaze_riscv -tags IPCPG-502 -type CDC -id CDC-1  -description "Debug protocol ensures stable signals" -to [get_pins -quiet riscv_core_I/*.Core/*Debug_Logic.Master_Core.Debug*/Serial_Dbg_Intf.*/CE]
set_property src_info {type:SCOPED_XDC file:1 line:14 export:INPUT save:INPUT read:READ} [current_design]
create_waiver -internal -scoped -user microblaze_riscv -tags IPCPG-502 -type CDC -id CDC-1  -description "Debug protocol ensures stable signals" -to [get_pins -quiet riscv_core_I/*.Core/*Debug_Logic.Master_Core.Debug*/Serial_Dbg_Intf.*/*/D]
set_property src_info {type:SCOPED_XDC file:1 line:15 export:INPUT save:INPUT read:READ} [current_design]
create_waiver -internal -scoped -user microblaze_riscv -tags IPCPG-502 -type CDC -id CDC-7  -description "Debug protocol ensures stable signals" -to [get_pins -quiet riscv_core_I/*.Core/*Debug_Logic.Master_Core.Debug*/Serial_Dbg_Intf.*/CLR]
set_property src_info {type:SCOPED_XDC file:1 line:16 export:INPUT save:INPUT read:READ} [current_design]
create_waiver -internal -scoped -user microblaze_riscv -tags IPCPG-502 -type CDC -id CDC-7  -description "Debug protocol ensures stable signals" -to [get_pins -quiet riscv_core_I/*.Core/*Debug_Logic.Master_Core.Debug*/Serial_Dbg_Intf.*/PRE]
set_property src_info {type:SCOPED_XDC file:1 line:17 export:INPUT save:INPUT read:READ} [current_design]
create_waiver -internal -scoped -user microblaze_riscv -tags IPCPG-502 -type CDC -id CDC-15 -description "Debug protocol ensures stable signals" -to [get_pins -quiet riscv_core_I/*.Core/*Debug_Logic.Master_Core.Debug*/Serial_Dbg_Intf.*/CLR]
