MarinGE23/axi-plpuf-ip/vitis-axi-plpuf/platform/microblaze_riscv_0/standalone_microblaze_riscv_0/bsp/include/xparameters.h

#ifndef XPARAMETERS_H   /* prevent circular inclusions */
#define XPARAMETERS_H   /* by using protection macros */

#define XPAR_XBRAM_NUM_INSTANCES 1

/* Definitions for peripheral MICROBLAZE_RISCV_0_LOCAL_MEMORY_DLMB_BRAM_IF_CNTLR */
#define XPAR_MICROBLAZE_RISCV_0_LOCAL_MEMORY_DLMB_BRAM_IF_CNTLR_COMPATIBLE "xlnx,lmb-bram-if-cntlr-4.0"
#define XPAR_MICROBLAZE_RISCV_0_LOCAL_MEMORY_DLMB_BRAM_IF_CNTLR_BASEADDR 0x0
#define XPAR_MICROBLAZE_RISCV_0_LOCAL_MEMORY_DLMB_BRAM_IF_CNTLR_HIGHADDR 0x7fff
#define XPAR_MICROBLAZE_RISCV_0_LOCAL_MEMORY_DLMB_BRAM_IF_CNTLR_DATA_WIDTH 0x20
#define XPAR_MICROBLAZE_RISCV_0_LOCAL_MEMORY_DLMB_BRAM_IF_CNTLR_ECC 0x0
#define XPAR_MICROBLAZE_RISCV_0_LOCAL_MEMORY_DLMB_BRAM_IF_CNTLR_FAULT_INJECT 0x0
#define XPAR_MICROBLAZE_RISCV_0_LOCAL_MEMORY_DLMB_BRAM_IF_CNTLR_CE_FAILING_REGISTERS 0x0
#define XPAR_MICROBLAZE_RISCV_0_LOCAL_MEMORY_DLMB_BRAM_IF_CNTLR_UE_FAILING_REGISTERS 0x0
#define XPAR_MICROBLAZE_RISCV_0_LOCAL_MEMORY_DLMB_BRAM_IF_CNTLR_ECC_ONOFF_REGISTER 0x0
#define XPAR_MICROBLAZE_RISCV_0_LOCAL_MEMORY_DLMB_BRAM_IF_CNTLR_ECC_ONOFF_RESET_VALUE 0x1
#define XPAR_MICROBLAZE_RISCV_0_LOCAL_MEMORY_DLMB_BRAM_IF_CNTLR_WRITE_ACCESS 0x2

/* Canonical definitions for peripheral MICROBLAZE_RISCV_0_LOCAL_MEMORY_DLMB_BRAM_IF_CNTLR */
#define XPAR_XBRAM_0_BASEADDR 0x0
#define XPAR_XBRAM_0_HIGHADDR 0x7fff
#define XPAR_XBRAM_0_COMPATIBLE "xlnx,lmb-bram-if-cntlr-4.0"
#define XPAR_XBRAM_0_CE_FAILING_REGISTERS 0x0
#define XPAR_XBRAM_0_DATA_WIDTH 0x20
#define XPAR_XBRAM_0_ECC 0x0
#define XPAR_XBRAM_0_ECC_ONOFF_REGISTER 0x0
#define XPAR_XBRAM_0_ECC_ONOFF_RESET_VALUE 0x1
#define XPAR_XBRAM_0_FAULT_INJECT 0x0
#define XPAR_XBRAM_0_UE_FAILING_REGISTERS 0x0
#define XPAR_XBRAM_0_WRITE_ACCESS 0x2

#define XPAR_XUARTLITE_NUM_INSTANCES 1

/* Definitions for peripheral AXI_UARTLITE_0 */
#define XPAR_AXI_UARTLITE_0_COMPATIBLE "xlnx,axi-uartlite-2.0"
#define XPAR_AXI_UARTLITE_0_BASEADDR 0x40600000
#define XPAR_AXI_UARTLITE_0_HIGHADDR 0x4060ffff
#define XPAR_AXI_UARTLITE_0_BAUDRATE 0x2580
#define XPAR_AXI_UARTLITE_0_USE_PARITY 0x0
#define XPAR_AXI_UARTLITE_0_ODD_PARITY 0x0
#define XPAR_AXI_UARTLITE_0_DATA_BITS 0x8

/* Canonical definitions for peripheral AXI_UARTLITE_0 */
#define XPAR_XUARTLITE_0_BASEADDR 0x40600000
#define XPAR_XUARTLITE_0_HIGHADDR 0x4060ffff
#define XPAR_XUARTLITE_0_BAUDRATE 0x2580
#define XPAR_XUARTLITE_0_COMPATIBLE "xlnx,axi-uartlite-2.0"
#define XPAR_XUARTLITE_0_DATA_BITS 0x8
#define XPAR_XUARTLITE_0_ODD_PARITY 0x0
#define XPAR_XUARTLITE_0_USE_PARITY 0x0

/* Definitions for peripheral AXI_PLPUF_0 */
#define XPAR_AXI_PLPUF_0_BASEADDR 0x44a00000
#define XPAR_AXI_PLPUF_0_HIGHADDR 0x44a0ffff

/*  BOARD definition */
#define XPS_BOARD_BASYS3

#define XPAR_LMB_BRAM_0_BASEADDRESS 0x0
#define XPAR_LMB_BRAM_0_HIGHADDRESS 0x7fff

/*  CPU parameters definition */
#define XPAR_MICROBLAZE_RISCV_TIMEBASE_FREQUENCY 100000000
#define XPAR_MICROBLAZE_RISCV_FREQ 100000000
#define XPAR_MICROBLAZE_RISCV_BASE_VECTORS 0
#define XPAR_MICROBLAZE_RISCV_USE_MMU 0
#define XPAR_MICROBLAZE_RISCV_USE_DCACHE 0
#define XPAR_MICROBLAZE_RISCV_USE_ICACHE 0
#define XPAR_MICROBLAZE_RISCV_USE_MULDIV 0
#define XPAR_MICROBLAZE_RISCV_USE_ATOMIC 0
#define XPAR_MICROBLAZE_RISCV_USE_FPU 0
#define XPAR_MICROBLAZE_RISCV_DATA_SIZE 32
#define XPAR_MICROBLAZE_RISCV_D_CACHE_SIZE 8192
#define XPAR_MICROBLAZE_RISCV_D_CACHE_LINE_SIZE 16
#define XPAR_MICROBLAZE_RISCV_DCACHE_USE_WRITEBACK 0
#define XPAR_MICROBLAZE_RISCV_DCACHE_LINE_LEN 4
#define XPAR_MICROBLAZE_RISCV_D_CACHE_BASEADDR 0
#define XPAR_MICROBLAZE_RISCV_D_CACHE_HIGHADDR 1073741823
#define XPAR_MICROBLAZE_RISCV_ICACHE_LINE_LEN 4
#define XPAR_MICROBLAZE_RISCV_REG 0

#define XPAR_CPU_CORE_CLOCK_FREQ_HZ 100000000

#define XPAR_MICROBLAZE_RISCV_USE_DCACHE 0

#define XPAR_MICROBLAZE_RISCV_DCACHE_LINE_LEN 4

#define XPAR_MICROBLAZE_RISCV_DCACHE_BYTE_SIZE 8192

#define XPAR_MICROBLAZE_RISCV_USE_ICACHE 0

#define XPAR_MICROBLAZE_RISCV_ICACHE_LINE_LEN 4

#define XPAR_MICROBLAZE_RISCV_ICACHE_BYTE_SIZE 8192

#define XPAR_MICROBLAZE_RISCV_USE_FPU 0

#define XPAR_MICROBLAZE_RISCV_USE_MMU 0

#define XPAR_MICROBLAZE_RISCV_USE_SLEEP 0

#define XPAR_MICROBLAZE_RISCV_FAULT_TOLERANT 0

#define XPAR_MICROBLAZE_RISCV_D_LMB 1

#define XPAR_MICROBLAZE_RISCV_USE_BRANCH_TARGET_CACHE 0

#define XPAR_MICROBLAZE_RISCV_BRANCH_TARGET_CACHE_SIZE 0

/* Number of SLRs */
#define NUMBER_OF_SLRS 0x1

/* Device ID */
#define XPAR_DEVICE_ID "7a35t"

#endif  /* end of protection macro */
