MarinGE23/axi-plpuf-ip/vitis-axi-plpuf/_ide/.peers.ini

DefaultTarget=true
ServiceManagerID=c910f74e-835e-4af9-a2bb-42cb96cdca9a
TransportName=TCP
AutoSetJtagFrequency=false
PeerTypeId=LINUX_EMULATION
UserName=emari
Port=1440
Host=127.0.0.1
OSName=Windows 11
ID=LinuxEmulation
AgentID=c910f74e-835e-4af9-a2bb-42cb96cdca9a
Name=LinuxEmulation

DefaultTarget=true
ServiceManagerID=c910f74e-835e-4af9-a2bb-42cb96cdca9a
TransportName=TCP
AutoSetJtagFrequency=false
PeerTypeId=XRT_SERVER
UserName=emari
Port=1222
Host=127.0.0.1
OSName=Windows 11
ID=XRTServer
AgentID=c910f74e-835e-4af9-a2bb-42cb96cdca9a
Name=XRTServer

DefaultTarget=true
ServiceManagerID=c910f74e-835e-4af9-a2bb-42cb96cdca9a
TransportName=TCP
AutoSetJtagFrequency=true
PeerTypeId=HARDWARE_SERVER
UserName=emari
Port=3121
Host=127.0.0.1
OSName=Windows 11
ID=Local
AgentID=c910f74e-835e-4af9-a2bb-42cb96cdca9a
Name=Local

DefaultTarget=true
ServiceManagerID=c910f74e-835e-4af9-a2bb-42cb96cdca9a
TransportName=TCP
AutoSetJtagFrequency=false
PeerTypeId=LINUX_TCF_AGENT
UserName=emari
Port=1534
Host=192.168.0.1
OSName=Windows 11
ID=Linux Agent
AgentID=c910f74e-835e-4af9-a2bb-42cb96cdca9a
Name=Linux Agent

DefaultTarget=true
ServiceManagerID=c910f74e-835e-4af9-a2bb-42cb96cdca9a
TransportName=TCP
AutoSetJtagFrequency=false
PeerTypeId=QEMU_TCF_GDB_CLIENT
UserName=emari
Port=1138
Host=127.0.0.1
OSName=Windows 11
ID=QEMU
AgentID=c910f74e-835e-4af9-a2bb-42cb96cdca9a
Name=QEMU
