MarinGE23/axi-plpuf-ip/vivado-axi-plpuf/vivado-axi-plpuf.runs/synth_1/.Xil/design_1_wrapper_propImpl.xdc

set_property SRC_FILE_INFO {cfile:C:/Users/emari/Desktop/axi-plpuf-ip/vivado-axi-plpuf/vivado-axi-plpuf.srcs/constrs_1/new/plpuf.xdc rfile:../../../vivado-axi-plpuf.srcs/constrs_1/new/plpuf.xdc id:1} [current_design]
set_property src_info {type:XDC file:1 line:7 export:INPUT save:INPUT read:READ} [current_design]
set_property -dict { PACKAGE_PIN W5   IOSTANDARD LVCMOS33 } [get_ports sys_clock]
set_property src_info {type:XDC file:1 line:21 export:INPUT save:INPUT read:READ} [current_design]
set_property ALLOW_COMBINATORIAL_LOOPS TRUE [get_nets -hier -filter {NAME =~ *plpuf_core_inst/core_in*}]
set_property src_info {type:XDC file:1 line:24 export:INPUT save:INPUT read:READ} [current_design]
set_property DONT_TOUCH TRUE [get_cells -hier -filter {NAME =~ *plpuf_core_inst*}]
set_property src_info {type:XDC file:1 line:27 export:INPUT save:INPUT read:READ} [current_design]
set_false_path -through [get_nets -hier -filter {NAME =~ *plpuf_core_inst/core_in*}]
set_property src_info {type:XDC file:1 line:90 export:INPUT save:INPUT read:READ} [current_design]
set_property -dict { PACKAGE_PIN U18   IOSTANDARD LVCMOS33 } [get_ports reset]
