MarinGE23/axi-plpuf-ip/vivado-axi-plpuf/vivado-axi-plpuf.cache/ip/2025.1/8/c/8cfa717d64d4d956/design_1_axi_smc_0_stub.v

// Copyright 1986-2022 Xilinx, Inc. All Rights Reserved.
// Copyright 2022-2025 Advanced Micro Devices, Inc. All Rights Reserved.
// --------------------------------------------------------------------------------
// Tool Version: Vivado v.2025.1 (win64) Build 6140274 Thu May 22 00:12:29 MDT 2025
// Date        : Thu Apr  2 01:10:57 2026
// Host        : Emanuel running 64-bit major release  (build 9200)
// Command     : write_verilog -force -mode synth_stub -rename_top decalper_eb_ot_sdeen_pot_pi_dehcac_xnilix -prefix
//               decalper_eb_ot_sdeen_pot_pi_dehcac_xnilix_ design_1_axi_smc_0_stub.v
// Design      : design_1_axi_smc_0
// Purpose     : Stub declaration of top-level module interface
// Device      : xc7a35tcpg236-1
// --------------------------------------------------------------------------------

// This empty module with port declaration file causes synthesis tools to infer a black box for IP.
// The synthesis directives are for Synopsys Synplify support to prevent IO buffer insertion.
// Please paste the declaration into a Verilog source file or add the file as an additional source.
(* CHECK_LICENSE_TYPE = "design_1_axi_smc_0,bd_afc3,{}" *) (* CORE_GENERATION_INFO = "design_1_axi_smc_0,bd_afc3,{x_ipProduct=Vivado 2025.1,x_ipVendor=xilinx.com,x_ipLibrary=ip,x_ipName=smartconnect,x_ipVersion=1.0,x_ipCoreRevision=27,x_ipLanguage=VERILOG,x_ipSimLanguage=MIXED}" *) (* DowngradeIPIdentifiedWarnings = "yes" *) 
(* X_CORE_INFO = "bd_afc3,Vivado 2025.1" *) 
module decalper_eb_ot_sdeen_pot_pi_dehcac_xnilix(aclk, aresetn, S00_AXI_awaddr, S00_AXI_awprot, 
  S00_AXI_awvalid, S00_AXI_awready, S00_AXI_wdata, S00_AXI_wstrb, S00_AXI_wvalid, 
  S00_AXI_wready, S00_AXI_bresp, S00_AXI_bvalid, S00_AXI_bready, S00_AXI_araddr, 
  S00_AXI_arprot, S00_AXI_arvalid, S00_AXI_arready, S00_AXI_rdata, S00_AXI_rresp, 
  S00_AXI_rvalid, S00_AXI_rready, M00_AXI_awaddr, M00_AXI_awprot, M00_AXI_awvalid, 
  M00_AXI_awready, M00_AXI_wdata, M00_AXI_wstrb, M00_AXI_wvalid, M00_AXI_wready, 
  M00_AXI_bresp, M00_AXI_bvalid, M00_AXI_bready, M00_AXI_araddr, M00_AXI_arprot, 
  M00_AXI_arvalid, M00_AXI_arready, M00_AXI_rdata, M00_AXI_rresp, M00_AXI_rvalid, 
  M00_AXI_rready, M01_AXI_awaddr, M01_AXI_awprot, M01_AXI_awvalid, M01_AXI_awready, 
  M01_AXI_wdata, M01_AXI_wstrb, M01_AXI_wvalid, M01_AXI_wready, M01_AXI_bresp, 
  M01_AXI_bvalid, M01_AXI_bready, M01_AXI_araddr, M01_AXI_arprot, M01_AXI_arvalid, 
  M01_AXI_arready, M01_AXI_rdata, M01_AXI_rresp, M01_AXI_rvalid, M01_AXI_rready)
/* synthesis syn_black_box black_box_pad_pin="aresetn,S00_AXI_awaddr[31:0],S00_AXI_awprot[2:0],S00_AXI_awvalid,S00_AXI_awready,S00_AXI_wdata[31:0],S00_AXI_wstrb[3:0],S00_AXI_wvalid,S00_AXI_wready,S00_AXI_bresp[1:0],S00_AXI_bvalid,S00_AXI_bready,S00_AXI_araddr[31:0],S00_AXI_arprot[2:0],S00_AXI_arvalid,S00_AXI_arready,S00_AXI_rdata[31:0],S00_AXI_rresp[1:0],S00_AXI_rvalid,S00_AXI_rready,M00_AXI_awaddr[3:0],M00_AXI_awprot[2:0],M00_AXI_awvalid,M00_AXI_awready,M00_AXI_wdata[31:0],M00_AXI_wstrb[3:0],M00_AXI_wvalid,M00_AXI_wready,M00_AXI_bresp[1:0],M00_AXI_bvalid,M00_AXI_bready,M00_AXI_araddr[3:0],M00_AXI_arprot[2:0],M00_AXI_arvalid,M00_AXI_arready,M00_AXI_rdata[31:0],M00_AXI_rresp[1:0],M00_AXI_rvalid,M00_AXI_rready,M01_AXI_awaddr[5:0],M01_AXI_awprot[2:0],M01_AXI_awvalid,M01_AXI_awready,M01_AXI_wdata[31:0],M01_AXI_wstrb[3:0],M01_AXI_wvalid,M01_AXI_wready,M01_AXI_bresp[1:0],M01_AXI_bvalid,M01_AXI_bready,M01_AXI_araddr[5:0],M01_AXI_arprot[2:0],M01_AXI_arvalid,M01_AXI_arready,M01_AXI_rdata[31:0],M01_AXI_rresp[1:0],M01_AXI_rvalid,M01_AXI_rready" */
/* synthesis syn_force_seq_prim="aclk" */;
  (* X_INTERFACE_INFO = "xilinx.com:signal:clock:1.0 CLK.aclk CLK" *) (* X_INTERFACE_MODE = "slave" *) (* X_INTERFACE_PARAMETER = "XIL_INTERFACENAME CLK.aclk, FREQ_HZ 100000000, FREQ_TOLERANCE_HZ 0, PHASE 0.0, CLK_DOMAIN /clk_wiz_0_clk_out1, ASSOCIATED_BUSIF M00_AXI:M01_AXI:S00_AXI, INSERT_VIP 0, ASSOCIATED_CLKEN s_sc_aclken" *) input aclk /* synthesis syn_isclock = 1 */;
  (* X_INTERFACE_INFO = "xilinx.com:signal:reset:1.0 RST.aresetn RST" *) (* X_INTERFACE_MODE = "slave" *) (* X_INTERFACE_PARAMETER = "XIL_INTERFACENAME RST.aresetn, POLARITY ACTIVE_LOW, INSERT_VIP 0" *) input aresetn;
  (* X_INTERFACE_INFO = "xilinx.com:interface:aximm:1.0 S00_AXI AWADDR" *) (* X_INTERFACE_MODE = "slave" *) (* X_INTERFACE_PARAMETER = "XIL_INTERFACENAME S00_AXI, DATA_WIDTH 32, PROTOCOL AXI4LITE, FREQ_HZ 100000000, ID_WIDTH 0, ADDR_WIDTH 32, AWUSER_WIDTH 0, ARUSER_WIDTH 0, WUSER_WIDTH 0, RUSER_WIDTH 0, BUSER_WIDTH 0, READ_WRITE_MODE READ_WRITE, HAS_BURST 0, HAS_LOCK 0, HAS_PROT 1, HAS_CACHE 0, HAS_QOS 0, HAS_REGION 0, HAS_WSTRB 1, HAS_BRESP 1, HAS_RRESP 1, SUPPORTS_NARROW_BURST 0, NUM_READ_OUTSTANDING 1, NUM_WRITE_OUTSTANDING 1, MAX_BURST_LENGTH 1, PHASE 0.0, CLK_DOMAIN /clk_wiz_0_clk_out1, NUM_READ_THREADS 1, NUM_WRITE_THREADS 1, RUSER_BITS_PER_BYTE 0, WUSER_BITS_PER_BYTE 0, INSERT_VIP 0" *) input [31:0]S00_AXI_awaddr;
  (* X_INTERFACE_INFO = "xilinx.com:interface:aximm:1.0 S00_AXI AWPROT" *) input [2:0]S00_AXI_awprot;
  (* X_INTERFACE_INFO = "xilinx.com:interface:aximm:1.0 S00_AXI AWVALID" *) input S00_AXI_awvalid;
  (* X_INTERFACE_INFO = "xilinx.com:interface:aximm:1.0 S00_AXI AWREADY" *) output S00_AXI_awready;
  (* X_INTERFACE_INFO = "xilinx.com:interface:aximm:1.0 S00_AXI WDATA" *) input [31:0]S00_AXI_wdata;
  (* X_INTERFACE_INFO = "xilinx.com:interface:aximm:1.0 S00_AXI WSTRB" *) input [3:0]S00_AXI_wstrb;
  (* X_INTERFACE_INFO = "xilinx.com:interface:aximm:1.0 S00_AXI WVALID" *) input S00_AXI_wvalid;
  (* X_INTERFACE_INFO = "xilinx.com:interface:aximm:1.0 S00_AXI WREADY" *) output S00_AXI_wready;
  (* X_INTERFACE_INFO = "xilinx.com:interface:aximm:1.0 S00_AXI BRESP" *) output [1:0]S00_AXI_bresp;
  (* X_INTERFACE_INFO = "xilinx.com:interface:aximm:1.0 S00_AXI BVALID" *) output S00_AXI_bvalid;
  (* X_INTERFACE_INFO = "xilinx.com:interface:aximm:1.0 S00_AXI BREADY" *) input S00_AXI_bready;
  (* X_INTERFACE_INFO = "xilinx.com:interface:aximm:1.0 S00_AXI ARADDR" *) input [31:0]S00_AXI_araddr;
  (* X_INTERFACE_INFO = "xilinx.com:interface:aximm:1.0 S00_AXI ARPROT" *) input [2:0]S00_AXI_arprot;
  (* X_INTERFACE_INFO = "xilinx.com:interface:aximm:1.0 S00_AXI ARVALID" *) input S00_AXI_arvalid;
  (* X_INTERFACE_INFO = "xilinx.com:interface:aximm:1.0 S00_AXI ARREADY" *) output S00_AXI_arready;
  (* X_INTERFACE_INFO = "xilinx.com:interface:aximm:1.0 S00_AXI RDATA" *) output [31:0]S00_AXI_rdata;
  (* X_INTERFACE_INFO = "xilinx.com:interface:aximm:1.0 S00_AXI RRESP" *) output [1:0]S00_AXI_rresp;
  (* X_INTERFACE_INFO = "xilinx.com:interface:aximm:1.0 S00_AXI RVALID" *) output S00_AXI_rvalid;
  (* X_INTERFACE_INFO = "xilinx.com:interface:aximm:1.0 S00_AXI RREADY" *) input S00_AXI_rready;
  (* X_INTERFACE_INFO = "xilinx.com:interface:aximm:1.0 M00_AXI AWADDR" *) (* X_INTERFACE_MODE = "master" *) (* X_INTERFACE_PARAMETER = "XIL_INTERFACENAME M00_AXI, DATA_WIDTH 32, PROTOCOL AXI4LITE, FREQ_HZ 100000000, ID_WIDTH 0, ADDR_WIDTH 4, AWUSER_WIDTH 0, ARUSER_WIDTH 0, WUSER_WIDTH 0, RUSER_WIDTH 0, BUSER_WIDTH 0, READ_WRITE_MODE READ_WRITE, HAS_BURST 0, HAS_LOCK 0, HAS_PROT 1, HAS_CACHE 0, HAS_QOS 0, HAS_REGION 0, HAS_WSTRB 1, HAS_BRESP 1, HAS_RRESP 1, SUPPORTS_NARROW_BURST 0, NUM_READ_OUTSTANDING 1, NUM_WRITE_OUTSTANDING 1, MAX_BURST_LENGTH 1, PHASE 0.0, CLK_DOMAIN /clk_wiz_0_clk_out1, NUM_READ_THREADS 1, NUM_WRITE_THREADS 1, RUSER_BITS_PER_BYTE 0, WUSER_BITS_PER_BYTE 0, INSERT_VIP 0" *) output [3:0]M00_AXI_awaddr;
  (* X_INTERFACE_INFO = "xilinx.com:interface:aximm:1.0 M00_AXI AWPROT" *) output [2:0]M00_AXI_awprot;
  (* X_INTERFACE_INFO = "xilinx.com:interface:aximm:1.0 M00_AXI AWVALID" *) output M00_AXI_awvalid;
  (* X_INTERFACE_INFO = "xilinx.com:interface:aximm:1.0 M00_AXI AWREADY" *) input M00_AXI_awready;
  (* X_INTERFACE_INFO = "xilinx.com:interface:aximm:1.0 M00_AXI WDATA" *) output [31:0]M00_AXI_wdata;
  (* X_INTERFACE_INFO = "xilinx.com:interface:aximm:1.0 M00_AXI WSTRB" *) output [3:0]M00_AXI_wstrb;
  (* X_INTERFACE_INFO = "xilinx.com:interface:aximm:1.0 M00_AXI WVALID" *) output M00_AXI_wvalid;
  (* X_INTERFACE_INFO = "xilinx.com:interface:aximm:1.0 M00_AXI WREADY" *) input M00_AXI_wready;
  (* X_INTERFACE_INFO = "xilinx.com:interface:aximm:1.0 M00_AXI BRESP" *) input [1:0]M00_AXI_bresp;
  (* X_INTERFACE_INFO = "xilinx.com:interface:aximm:1.0 M00_AXI BVALID" *) input M00_AXI_bvalid;
  (* X_INTERFACE_INFO = "xilinx.com:interface:aximm:1.0 M00_AXI BREADY" *) output M00_AXI_bready;
  (* X_INTERFACE_INFO = "xilinx.com:interface:aximm:1.0 M00_AXI ARADDR" *) output [3:0]M00_AXI_araddr;
  (* X_INTERFACE_INFO = "xilinx.com:interface:aximm:1.0 M00_AXI ARPROT" *) output [2:0]M00_AXI_arprot;
  (* X_INTERFACE_INFO = "xilinx.com:interface:aximm:1.0 M00_AXI ARVALID" *) output M00_AXI_arvalid;
  (* X_INTERFACE_INFO = "xilinx.com:interface:aximm:1.0 M00_AXI ARREADY" *) input M00_AXI_arready;
  (* X_INTERFACE_INFO = "xilinx.com:interface:aximm:1.0 M00_AXI RDATA" *) input [31:0]M00_AXI_rdata;
  (* X_INTERFACE_INFO = "xilinx.com:interface:aximm:1.0 M00_AXI RRESP" *) input [1:0]M00_AXI_rresp;
  (* X_INTERFACE_INFO = "xilinx.com:interface:aximm:1.0 M00_AXI RVALID" *) input M00_AXI_rvalid;
  (* X_INTERFACE_INFO = "xilinx.com:interface:aximm:1.0 M00_AXI RREADY" *) output M00_AXI_rready;
  (* X_INTERFACE_INFO = "xilinx.com:interface:aximm:1.0 M01_AXI AWADDR" *) (* X_INTERFACE_MODE = "master" *) (* X_INTERFACE_PARAMETER = "XIL_INTERFACENAME M01_AXI, DATA_WIDTH 32, PROTOCOL AXI4LITE, FREQ_HZ 100000000, ID_WIDTH 0, ADDR_WIDTH 6, AWUSER_WIDTH 0, ARUSER_WIDTH 0, WUSER_WIDTH 0, RUSER_WIDTH 0, BUSER_WIDTH 0, READ_WRITE_MODE READ_WRITE, HAS_BURST 0, HAS_LOCK 0, HAS_PROT 1, HAS_CACHE 0, HAS_QOS 0, HAS_REGION 0, HAS_WSTRB 1, HAS_BRESP 1, HAS_RRESP 1, SUPPORTS_NARROW_BURST 0, NUM_READ_OUTSTANDING 1, NUM_WRITE_OUTSTANDING 1, MAX_BURST_LENGTH 1, PHASE 0.0, CLK_DOMAIN /clk_wiz_0_clk_out1, NUM_READ_THREADS 1, NUM_WRITE_THREADS 1, RUSER_BITS_PER_BYTE 0, WUSER_BITS_PER_BYTE 0, INSERT_VIP 0" *) output [5:0]M01_AXI_awaddr;
  (* X_INTERFACE_INFO = "xilinx.com:interface:aximm:1.0 M01_AXI AWPROT" *) output [2:0]M01_AXI_awprot;
  (* X_INTERFACE_INFO = "xilinx.com:interface:aximm:1.0 M01_AXI AWVALID" *) output M01_AXI_awvalid;
  (* X_INTERFACE_INFO = "xilinx.com:interface:aximm:1.0 M01_AXI AWREADY" *) input M01_AXI_awready;
  (* X_INTERFACE_INFO = "xilinx.com:interface:aximm:1.0 M01_AXI WDATA" *) output [31:0]M01_AXI_wdata;
  (* X_INTERFACE_INFO = "xilinx.com:interface:aximm:1.0 M01_AXI WSTRB" *) output [3:0]M01_AXI_wstrb;
  (* X_INTERFACE_INFO = "xilinx.com:interface:aximm:1.0 M01_AXI WVALID" *) output M01_AXI_wvalid;
  (* X_INTERFACE_INFO = "xilinx.com:interface:aximm:1.0 M01_AXI WREADY" *) input M01_AXI_wready;
  (* X_INTERFACE_INFO = "xilinx.com:interface:aximm:1.0 M01_AXI BRESP" *) input [1:0]M01_AXI_bresp;
  (* X_INTERFACE_INFO = "xilinx.com:interface:aximm:1.0 M01_AXI BVALID" *) input M01_AXI_bvalid;
  (* X_INTERFACE_INFO = "xilinx.com:interface:aximm:1.0 M01_AXI BREADY" *) output M01_AXI_bready;
  (* X_INTERFACE_INFO = "xilinx.com:interface:aximm:1.0 M01_AXI ARADDR" *) output [5:0]M01_AXI_araddr;
  (* X_INTERFACE_INFO = "xilinx.com:interface:aximm:1.0 M01_AXI ARPROT" *) output [2:0]M01_AXI_arprot;
  (* X_INTERFACE_INFO = "xilinx.com:interface:aximm:1.0 M01_AXI ARVALID" *) output M01_AXI_arvalid;
  (* X_INTERFACE_INFO = "xilinx.com:interface:aximm:1.0 M01_AXI ARREADY" *) input M01_AXI_arready;
  (* X_INTERFACE_INFO = "xilinx.com:interface:aximm:1.0 M01_AXI RDATA" *) input [31:0]M01_AXI_rdata;
  (* X_INTERFACE_INFO = "xilinx.com:interface:aximm:1.0 M01_AXI RRESP" *) input [1:0]M01_AXI_rresp;
  (* X_INTERFACE_INFO = "xilinx.com:interface:aximm:1.0 M01_AXI RVALID" *) input M01_AXI_rvalid;
  (* X_INTERFACE_INFO = "xilinx.com:interface:aximm:1.0 M01_AXI RREADY" *) output M01_AXI_rready;
endmodule
