MarinGE23/axi-plpuf-ip/vivado-axi-plpuf/vivado-axi-plpuf.cache/ip/2025.1/8/c/8cfa717d64d4d956/design_1_axi_smc_0_stub.vhdl

-- Copyright 1986-2022 Xilinx, Inc. All Rights Reserved.
-- Copyright 2022-2025 Advanced Micro Devices, Inc. All Rights Reserved.
-- --------------------------------------------------------------------------------
-- Tool Version: Vivado v.2025.1 (win64) Build 6140274 Thu May 22 00:12:29 MDT 2025
-- Date        : Thu Apr  2 01:10:57 2026
-- Host        : Emanuel running 64-bit major release  (build 9200)
-- Command     : write_vhdl -force -mode synth_stub -rename_top decalper_eb_ot_sdeen_pot_pi_dehcac_xnilix -prefix
--               decalper_eb_ot_sdeen_pot_pi_dehcac_xnilix_ design_1_axi_smc_0_stub.vhdl
-- Design      : design_1_axi_smc_0
-- Purpose     : Stub declaration of top-level module interface
-- Device      : xc7a35tcpg236-1
-- --------------------------------------------------------------------------------
library IEEE;
use IEEE.STD_LOGIC_1164.ALL;

entity decalper_eb_ot_sdeen_pot_pi_dehcac_xnilix is
  Port ( 
    aclk : in STD_LOGIC;
    aresetn : in STD_LOGIC;
    S00_AXI_awaddr : in STD_LOGIC_VECTOR ( 31 downto 0 );
    S00_AXI_awprot : in STD_LOGIC_VECTOR ( 2 downto 0 );
    S00_AXI_awvalid : in STD_LOGIC;
    S00_AXI_awready : out STD_LOGIC;
    S00_AXI_wdata : in STD_LOGIC_VECTOR ( 31 downto 0 );
    S00_AXI_wstrb : in STD_LOGIC_VECTOR ( 3 downto 0 );
    S00_AXI_wvalid : in STD_LOGIC;
    S00_AXI_wready : out STD_LOGIC;
    S00_AXI_bresp : out STD_LOGIC_VECTOR ( 1 downto 0 );
    S00_AXI_bvalid : out STD_LOGIC;
    S00_AXI_bready : in STD_LOGIC;
    S00_AXI_araddr : in STD_LOGIC_VECTOR ( 31 downto 0 );
    S00_AXI_arprot : in STD_LOGIC_VECTOR ( 2 downto 0 );
    S00_AXI_arvalid : in STD_LOGIC;
    S00_AXI_arready : out STD_LOGIC;
    S00_AXI_rdata : out STD_LOGIC_VECTOR ( 31 downto 0 );
    S00_AXI_rresp : out STD_LOGIC_VECTOR ( 1 downto 0 );
    S00_AXI_rvalid : out STD_LOGIC;
    S00_AXI_rready : in STD_LOGIC;
    M00_AXI_awaddr : out STD_LOGIC_VECTOR ( 3 downto 0 );
    M00_AXI_awprot : out STD_LOGIC_VECTOR ( 2 downto 0 );
    M00_AXI_awvalid : out STD_LOGIC;
    M00_AXI_awready : in STD_LOGIC;
    M00_AXI_wdata : out STD_LOGIC_VECTOR ( 31 downto 0 );
    M00_AXI_wstrb : out STD_LOGIC_VECTOR ( 3 downto 0 );
    M00_AXI_wvalid : out STD_LOGIC;
    M00_AXI_wready : in STD_LOGIC;
    M00_AXI_bresp : in STD_LOGIC_VECTOR ( 1 downto 0 );
    M00_AXI_bvalid : in STD_LOGIC;
    M00_AXI_bready : out STD_LOGIC;
    M00_AXI_araddr : out STD_LOGIC_VECTOR ( 3 downto 0 );
    M00_AXI_arprot : out STD_LOGIC_VECTOR ( 2 downto 0 );
    M00_AXI_arvalid : out STD_LOGIC;
    M00_AXI_arready : in STD_LOGIC;
    M00_AXI_rdata : in STD_LOGIC_VECTOR ( 31 downto 0 );
    M00_AXI_rresp : in STD_LOGIC_VECTOR ( 1 downto 0 );
    M00_AXI_rvalid : in STD_LOGIC;
    M00_AXI_rready : out STD_LOGIC;
    M01_AXI_awaddr : out STD_LOGIC_VECTOR ( 5 downto 0 );
    M01_AXI_awprot : out STD_LOGIC_VECTOR ( 2 downto 0 );
    M01_AXI_awvalid : out STD_LOGIC;
    M01_AXI_awready : in STD_LOGIC;
    M01_AXI_wdata : out STD_LOGIC_VECTOR ( 31 downto 0 );
    M01_AXI_wstrb : out STD_LOGIC_VECTOR ( 3 downto 0 );
    M01_AXI_wvalid : out STD_LOGIC;
    M01_AXI_wready : in STD_LOGIC;
    M01_AXI_bresp : in STD_LOGIC_VECTOR ( 1 downto 0 );
    M01_AXI_bvalid : in STD_LOGIC;
    M01_AXI_bready : out STD_LOGIC;
    M01_AXI_araddr : out STD_LOGIC_VECTOR ( 5 downto 0 );
    M01_AXI_arprot : out STD_LOGIC_VECTOR ( 2 downto 0 );
    M01_AXI_arvalid : out STD_LOGIC;
    M01_AXI_arready : in STD_LOGIC;
    M01_AXI_rdata : in STD_LOGIC_VECTOR ( 31 downto 0 );
    M01_AXI_rresp : in STD_LOGIC_VECTOR ( 1 downto 0 );
    M01_AXI_rvalid : in STD_LOGIC;
    M01_AXI_rready : out STD_LOGIC
  );

  attribute CHECK_LICENSE_TYPE : string;
  attribute CHECK_LICENSE_TYPE of decalper_eb_ot_sdeen_pot_pi_dehcac_xnilix : entity is "design_1_axi_smc_0,bd_afc3,{}";
  attribute CORE_GENERATION_INFO : string;
  attribute CORE_GENERATION_INFO of decalper_eb_ot_sdeen_pot_pi_dehcac_xnilix : entity is "design_1_axi_smc_0,bd_afc3,{x_ipProduct=Vivado 2025.1,x_ipVendor=xilinx.com,x_ipLibrary=ip,x_ipName=smartconnect,x_ipVersion=1.0,x_ipCoreRevision=27,x_ipLanguage=VERILOG,x_ipSimLanguage=MIXED}";
  attribute DowngradeIPIdentifiedWarnings : string;
  attribute DowngradeIPIdentifiedWarnings of decalper_eb_ot_sdeen_pot_pi_dehcac_xnilix : entity is "yes";
end decalper_eb_ot_sdeen_pot_pi_dehcac_xnilix;

architecture stub of decalper_eb_ot_sdeen_pot_pi_dehcac_xnilix is
  attribute syn_black_box : boolean;
  attribute black_box_pad_pin : string;
  attribute syn_black_box of stub : architecture is true;
  attribute black_box_pad_pin of stub : architecture is "aclk,aresetn,S00_AXI_awaddr[31:0],S00_AXI_awprot[2:0],S00_AXI_awvalid,S00_AXI_awready,S00_AXI_wdata[31:0],S00_AXI_wstrb[3:0],S00_AXI_wvalid,S00_AXI_wready,S00_AXI_bresp[1:0],S00_AXI_bvalid,S00_AXI_bready,S00_AXI_araddr[31:0],S00_AXI_arprot[2:0],S00_AXI_arvalid,S00_AXI_arready,S00_AXI_rdata[31:0],S00_AXI_rresp[1:0],S00_AXI_rvalid,S00_AXI_rready,M00_AXI_awaddr[3:0],M00_AXI_awprot[2:0],M00_AXI_awvalid,M00_AXI_awready,M00_AXI_wdata[31:0],M00_AXI_wstrb[3:0],M00_AXI_wvalid,M00_AXI_wready,M00_AXI_bresp[1:0],M00_AXI_bvalid,M00_AXI_bready,M00_AXI_araddr[3:0],M00_AXI_arprot[2:0],M00_AXI_arvalid,M00_AXI_arready,M00_AXI_rdata[31:0],M00_AXI_rresp[1:0],M00_AXI_rvalid,M00_AXI_rready,M01_AXI_awaddr[5:0],M01_AXI_awprot[2:0],M01_AXI_awvalid,M01_AXI_awready,M01_AXI_wdata[31:0],M01_AXI_wstrb[3:0],M01_AXI_wvalid,M01_AXI_wready,M01_AXI_bresp[1:0],M01_AXI_bvalid,M01_AXI_bready,M01_AXI_araddr[5:0],M01_AXI_arprot[2:0],M01_AXI_arvalid,M01_AXI_arready,M01_AXI_rdata[31:0],M01_AXI_rresp[1:0],M01_AXI_rvalid,M01_AXI_rready";
  attribute X_INTERFACE_INFO : string;
  attribute X_INTERFACE_INFO of aclk : signal is "xilinx.com:signal:clock:1.0 CLK.aclk CLK";
  attribute X_INTERFACE_MODE : string;
  attribute X_INTERFACE_MODE of aclk : signal is "slave";
  attribute X_INTERFACE_PARAMETER : string;
  attribute X_INTERFACE_PARAMETER of aclk : signal is "XIL_INTERFACENAME CLK.aclk, FREQ_HZ 100000000, FREQ_TOLERANCE_HZ 0, PHASE 0.0, CLK_DOMAIN /clk_wiz_0_clk_out1, ASSOCIATED_BUSIF M00_AXI:M01_AXI:S00_AXI, INSERT_VIP 0, ASSOCIATED_CLKEN s_sc_aclken";
  attribute X_INTERFACE_INFO of aresetn : signal is "xilinx.com:signal:reset:1.0 RST.aresetn RST";
  attribute X_INTERFACE_MODE of aresetn : signal is "slave";
  attribute X_INTERFACE_PARAMETER of aresetn : signal is "XIL_INTERFACENAME RST.aresetn, POLARITY ACTIVE_LOW, INSERT_VIP 0";
  attribute X_INTERFACE_INFO of S00_AXI_awaddr : signal is "xilinx.com:interface:aximm:1.0 S00_AXI AWADDR";
  attribute X_INTERFACE_MODE of S00_AXI_awaddr : signal is "slave";
  attribute X_INTERFACE_PARAMETER of S00_AXI_awaddr : signal is "XIL_INTERFACENAME S00_AXI, DATA_WIDTH 32, PROTOCOL AXI4LITE, FREQ_HZ 100000000, ID_WIDTH 0, ADDR_WIDTH 32, AWUSER_WIDTH 0, ARUSER_WIDTH 0, WUSER_WIDTH 0, RUSER_WIDTH 0, BUSER_WIDTH 0, READ_WRITE_MODE READ_WRITE, HAS_BURST 0, HAS_LOCK 0, HAS_PROT 1, HAS_CACHE 0, HAS_QOS 0, HAS_REGION 0, HAS_WSTRB 1, HAS_BRESP 1, HAS_RRESP 1, SUPPORTS_NARROW_BURST 0, NUM_READ_OUTSTANDING 1, NUM_WRITE_OUTSTANDING 1, MAX_BURST_LENGTH 1, PHASE 0.0, CLK_DOMAIN /clk_wiz_0_clk_out1, NUM_READ_THREADS 1, NUM_WRITE_THREADS 1, RUSER_BITS_PER_BYTE 0, WUSER_BITS_PER_BYTE 0, INSERT_VIP 0";
  attribute X_INTERFACE_INFO of S00_AXI_awprot : signal is "xilinx.com:interface:aximm:1.0 S00_AXI AWPROT";
  attribute X_INTERFACE_INFO of S00_AXI_awvalid : signal is "xilinx.com:interface:aximm:1.0 S00_AXI AWVALID";
  attribute X_INTERFACE_INFO of S00_AXI_awready : signal is "xilinx.com:interface:aximm:1.0 S00_AXI AWREADY";
  attribute X_INTERFACE_INFO of S00_AXI_wdata : signal is "xilinx.com:interface:aximm:1.0 S00_AXI WDATA";
  attribute X_INTERFACE_INFO of S00_AXI_wstrb : signal is "xilinx.com:interface:aximm:1.0 S00_AXI WSTRB";
  attribute X_INTERFACE_INFO of S00_AXI_wvalid : signal is "xilinx.com:interface:aximm:1.0 S00_AXI WVALID";
  attribute X_INTERFACE_INFO of S00_AXI_wready : signal is "xilinx.com:interface:aximm:1.0 S00_AXI WREADY";
  attribute X_INTERFACE_INFO of S00_AXI_bresp : signal is "xilinx.com:interface:aximm:1.0 S00_AXI BRESP";
  attribute X_INTERFACE_INFO of S00_AXI_bvalid : signal is "xilinx.com:interface:aximm:1.0 S00_AXI BVALID";
  attribute X_INTERFACE_INFO of S00_AXI_bready : signal is "xilinx.com:interface:aximm:1.0 S00_AXI BREADY";
  attribute X_INTERFACE_INFO of S00_AXI_araddr : signal is "xilinx.com:interface:aximm:1.0 S00_AXI ARADDR";
  attribute X_INTERFACE_INFO of S00_AXI_arprot : signal is "xilinx.com:interface:aximm:1.0 S00_AXI ARPROT";
  attribute X_INTERFACE_INFO of S00_AXI_arvalid : signal is "xilinx.com:interface:aximm:1.0 S00_AXI ARVALID";
  attribute X_INTERFACE_INFO of S00_AXI_arready : signal is "xilinx.com:interface:aximm:1.0 S00_AXI ARREADY";
  attribute X_INTERFACE_INFO of S00_AXI_rdata : signal is "xilinx.com:interface:aximm:1.0 S00_AXI RDATA";
  attribute X_INTERFACE_INFO of S00_AXI_rresp : signal is "xilinx.com:interface:aximm:1.0 S00_AXI RRESP";
  attribute X_INTERFACE_INFO of S00_AXI_rvalid : signal is "xilinx.com:interface:aximm:1.0 S00_AXI RVALID";
  attribute X_INTERFACE_INFO of S00_AXI_rready : signal is "xilinx.com:interface:aximm:1.0 S00_AXI RREADY";
  attribute X_INTERFACE_INFO of M00_AXI_awaddr : signal is "xilinx.com:interface:aximm:1.0 M00_AXI AWADDR";
  attribute X_INTERFACE_MODE of M00_AXI_awaddr : signal is "master";
  attribute X_INTERFACE_PARAMETER of M00_AXI_awaddr : signal is "XIL_INTERFACENAME M00_AXI, DATA_WIDTH 32, PROTOCOL AXI4LITE, FREQ_HZ 100000000, ID_WIDTH 0, ADDR_WIDTH 4, AWUSER_WIDTH 0, ARUSER_WIDTH 0, WUSER_WIDTH 0, RUSER_WIDTH 0, BUSER_WIDTH 0, READ_WRITE_MODE READ_WRITE, HAS_BURST 0, HAS_LOCK 0, HAS_PROT 1, HAS_CACHE 0, HAS_QOS 0, HAS_REGION 0, HAS_WSTRB 1, HAS_BRESP 1, HAS_RRESP 1, SUPPORTS_NARROW_BURST 0, NUM_READ_OUTSTANDING 1, NUM_WRITE_OUTSTANDING 1, MAX_BURST_LENGTH 1, PHASE 0.0, CLK_DOMAIN /clk_wiz_0_clk_out1, NUM_READ_THREADS 1, NUM_WRITE_THREADS 1, RUSER_BITS_PER_BYTE 0, WUSER_BITS_PER_BYTE 0, INSERT_VIP 0";
  attribute X_INTERFACE_INFO of M00_AXI_awprot : signal is "xilinx.com:interface:aximm:1.0 M00_AXI AWPROT";
  attribute X_INTERFACE_INFO of M00_AXI_awvalid : signal is "xilinx.com:interface:aximm:1.0 M00_AXI AWVALID";
  attribute X_INTERFACE_INFO of M00_AXI_awready : signal is "xilinx.com:interface:aximm:1.0 M00_AXI AWREADY";
  attribute X_INTERFACE_INFO of M00_AXI_wdata : signal is "xilinx.com:interface:aximm:1.0 M00_AXI WDATA";
  attribute X_INTERFACE_INFO of M00_AXI_wstrb : signal is "xilinx.com:interface:aximm:1.0 M00_AXI WSTRB";
  attribute X_INTERFACE_INFO of M00_AXI_wvalid : signal is "xilinx.com:interface:aximm:1.0 M00_AXI WVALID";
  attribute X_INTERFACE_INFO of M00_AXI_wready : signal is "xilinx.com:interface:aximm:1.0 M00_AXI WREADY";
  attribute X_INTERFACE_INFO of M00_AXI_bresp : signal is "xilinx.com:interface:aximm:1.0 M00_AXI BRESP";
  attribute X_INTERFACE_INFO of M00_AXI_bvalid : signal is "xilinx.com:interface:aximm:1.0 M00_AXI BVALID";
  attribute X_INTERFACE_INFO of M00_AXI_bready : signal is "xilinx.com:interface:aximm:1.0 M00_AXI BREADY";
  attribute X_INTERFACE_INFO of M00_AXI_araddr : signal is "xilinx.com:interface:aximm:1.0 M00_AXI ARADDR";
  attribute X_INTERFACE_INFO of M00_AXI_arprot : signal is "xilinx.com:interface:aximm:1.0 M00_AXI ARPROT";
  attribute X_INTERFACE_INFO of M00_AXI_arvalid : signal is "xilinx.com:interface:aximm:1.0 M00_AXI ARVALID";
  attribute X_INTERFACE_INFO of M00_AXI_arready : signal is "xilinx.com:interface:aximm:1.0 M00_AXI ARREADY";
  attribute X_INTERFACE_INFO of M00_AXI_rdata : signal is "xilinx.com:interface:aximm:1.0 M00_AXI RDATA";
  attribute X_INTERFACE_INFO of M00_AXI_rresp : signal is "xilinx.com:interface:aximm:1.0 M00_AXI RRESP";
  attribute X_INTERFACE_INFO of M00_AXI_rvalid : signal is "xilinx.com:interface:aximm:1.0 M00_AXI RVALID";
  attribute X_INTERFACE_INFO of M00_AXI_rready : signal is "xilinx.com:interface:aximm:1.0 M00_AXI RREADY";
  attribute X_INTERFACE_INFO of M01_AXI_awaddr : signal is "xilinx.com:interface:aximm:1.0 M01_AXI AWADDR";
  attribute X_INTERFACE_MODE of M01_AXI_awaddr : signal is "master";
  attribute X_INTERFACE_PARAMETER of M01_AXI_awaddr : signal is "XIL_INTERFACENAME M01_AXI, DATA_WIDTH 32, PROTOCOL AXI4LITE, FREQ_HZ 100000000, ID_WIDTH 0, ADDR_WIDTH 6, AWUSER_WIDTH 0, ARUSER_WIDTH 0, WUSER_WIDTH 0, RUSER_WIDTH 0, BUSER_WIDTH 0, READ_WRITE_MODE READ_WRITE, HAS_BURST 0, HAS_LOCK 0, HAS_PROT 1, HAS_CACHE 0, HAS_QOS 0, HAS_REGION 0, HAS_WSTRB 1, HAS_BRESP 1, HAS_RRESP 1, SUPPORTS_NARROW_BURST 0, NUM_READ_OUTSTANDING 1, NUM_WRITE_OUTSTANDING 1, MAX_BURST_LENGTH 1, PHASE 0.0, CLK_DOMAIN /clk_wiz_0_clk_out1, NUM_READ_THREADS 1, NUM_WRITE_THREADS 1, RUSER_BITS_PER_BYTE 0, WUSER_BITS_PER_BYTE 0, INSERT_VIP 0";
  attribute X_INTERFACE_INFO of M01_AXI_awprot : signal is "xilinx.com:interface:aximm:1.0 M01_AXI AWPROT";
  attribute X_INTERFACE_INFO of M01_AXI_awvalid : signal is "xilinx.com:interface:aximm:1.0 M01_AXI AWVALID";
  attribute X_INTERFACE_INFO of M01_AXI_awready : signal is "xilinx.com:interface:aximm:1.0 M01_AXI AWREADY";
  attribute X_INTERFACE_INFO of M01_AXI_wdata : signal is "xilinx.com:interface:aximm:1.0 M01_AXI WDATA";
  attribute X_INTERFACE_INFO of M01_AXI_wstrb : signal is "xilinx.com:interface:aximm:1.0 M01_AXI WSTRB";
  attribute X_INTERFACE_INFO of M01_AXI_wvalid : signal is "xilinx.com:interface:aximm:1.0 M01_AXI WVALID";
  attribute X_INTERFACE_INFO of M01_AXI_wready : signal is "xilinx.com:interface:aximm:1.0 M01_AXI WREADY";
  attribute X_INTERFACE_INFO of M01_AXI_bresp : signal is "xilinx.com:interface:aximm:1.0 M01_AXI BRESP";
  attribute X_INTERFACE_INFO of M01_AXI_bvalid : signal is "xilinx.com:interface:aximm:1.0 M01_AXI BVALID";
  attribute X_INTERFACE_INFO of M01_AXI_bready : signal is "xilinx.com:interface:aximm:1.0 M01_AXI BREADY";
  attribute X_INTERFACE_INFO of M01_AXI_araddr : signal is "xilinx.com:interface:aximm:1.0 M01_AXI ARADDR";
  attribute X_INTERFACE_INFO of M01_AXI_arprot : signal is "xilinx.com:interface:aximm:1.0 M01_AXI ARPROT";
  attribute X_INTERFACE_INFO of M01_AXI_arvalid : signal is "xilinx.com:interface:aximm:1.0 M01_AXI ARVALID";
  attribute X_INTERFACE_INFO of M01_AXI_arready : signal is "xilinx.com:interface:aximm:1.0 M01_AXI ARREADY";
  attribute X_INTERFACE_INFO of M01_AXI_rdata : signal is "xilinx.com:interface:aximm:1.0 M01_AXI RDATA";
  attribute X_INTERFACE_INFO of M01_AXI_rresp : signal is "xilinx.com:interface:aximm:1.0 M01_AXI RRESP";
  attribute X_INTERFACE_INFO of M01_AXI_rvalid : signal is "xilinx.com:interface:aximm:1.0 M01_AXI RVALID";
  attribute X_INTERFACE_INFO of M01_AXI_rready : signal is "xilinx.com:interface:aximm:1.0 M01_AXI RREADY";
  attribute X_CORE_INFO : string;
  attribute X_CORE_INFO of stub : architecture is "bd_afc3,Vivado 2025.1";
begin
end;
