MarinGE23/axi-plpuf-ip/vivado-axi-plpuf/vivado-axi-plpuf.gen/sources_1/bd/design_1/ip/design_1_axi_smc_0/bd_0/synth/bd_afc3.v

//Copyright 1986-2022 Xilinx, Inc. All Rights Reserved.
//Copyright 2022-2025 Advanced Micro Devices, Inc. All Rights Reserved.
//--------------------------------------------------------------------------------
//Command: generate_target bd_afc3.bd
//Design : bd_afc3
//Purpose: IP block netlist
//--------------------------------------------------------------------------------
`timescale 1 ps / 1 ps

(* CORE_GENERATION_INFO = "bd_afc3,IP_Integrator,{x_ipVendor=xilinx.com,x_ipLibrary=BlockDiagram,x_ipName=bd_afc3,x_ipVersion=1.00.a,x_ipLanguage=VERILOG,numBlks=49,numReposBlks=40,numNonXlnxBlks=0,numHierBlks=9,maxHierDepth=2,numSysgenBlks=0,numHlsBlks=0,numHdlrefBlks=0,numPkgbdBlks=0,bdsource=SBD,synth_mode=None}" *) (* HW_HANDOFF = "design_1_axi_smc_0.hwdef" *) 
module bd_afc3
   (M00_AXI_araddr,
    M00_AXI_arprot,
    M00_AXI_arready,
    M00_AXI_arvalid,
    M00_AXI_awaddr,
    M00_AXI_awprot,
    M00_AXI_awready,
    M00_AXI_awvalid,
    M00_AXI_bready,
    M00_AXI_bresp,
    M00_AXI_bvalid,
    M00_AXI_rdata,
    M00_AXI_rready,
    M00_AXI_rresp,
    M00_AXI_rvalid,
    M00_AXI_wdata,
    M00_AXI_wready,
    M00_AXI_wstrb,
    M00_AXI_wvalid,
    M01_AXI_araddr,
    M01_AXI_arprot,
    M01_AXI_arready,
    M01_AXI_arvalid,
    M01_AXI_awaddr,
    M01_AXI_awprot,
    M01_AXI_awready,
    M01_AXI_awvalid,
    M01_AXI_bready,
    M01_AXI_bresp,
    M01_AXI_bvalid,
    M01_AXI_rdata,
    M01_AXI_rready,
    M01_AXI_rresp,
    M01_AXI_rvalid,
    M01_AXI_wdata,
    M01_AXI_wready,
    M01_AXI_wstrb,
    M01_AXI_wvalid,
    S00_AXI_araddr,
    S00_AXI_arprot,
    S00_AXI_arready,
    S00_AXI_arvalid,
    S00_AXI_awaddr,
    S00_AXI_awprot,
    S00_AXI_awready,
    S00_AXI_awvalid,
    S00_AXI_bready,
    S00_AXI_bresp,
    S00_AXI_bvalid,
    S00_AXI_rdata,
    S00_AXI_rready,
    S00_AXI_rresp,
    S00_AXI_rvalid,
    S00_AXI_wdata,
    S00_AXI_wready,
    S00_AXI_wstrb,
    S00_AXI_wvalid,
    aclk,
    aresetn);
  (* X_INTERFACE_INFO = "xilinx.com:interface:aximm:1.0 M00_AXI ARADDR" *) (* X_INTERFACE_MODE = "Master" *) (* X_INTERFACE_PARAMETER = "XIL_INTERFACENAME M00_AXI, ADDR_WIDTH 4, ARUSER_WIDTH 0, AWUSER_WIDTH 0, BUSER_WIDTH 0, CLK_DOMAIN /clk_wiz_0_clk_out1, DATA_WIDTH 32, FREQ_HZ 100000000, HAS_BRESP 1, HAS_BURST 0, HAS_CACHE 0, HAS_LOCK 0, HAS_PROT 1, HAS_QOS 0, HAS_REGION 0, HAS_RRESP 1, HAS_WSTRB 1, ID_WIDTH 0, INSERT_VIP 0, MAX_BURST_LENGTH 1, NUM_READ_OUTSTANDING 1, NUM_READ_THREADS 1, NUM_WRITE_OUTSTANDING 1, NUM_WRITE_THREADS 1, PHASE 0.0, PROTOCOL AXI4LITE, READ_WRITE_MODE READ_WRITE, RUSER_BITS_PER_BYTE 0, RUSER_WIDTH 0, SUPPORTS_NARROW_BURST 0, WUSER_BITS_PER_BYTE 0, WUSER_WIDTH 0" *) output [3:0]M00_AXI_araddr;
  (* X_INTERFACE_INFO = "xilinx.com:interface:aximm:1.0 M00_AXI ARPROT" *) output [2:0]M00_AXI_arprot;
  (* X_INTERFACE_INFO = "xilinx.com:interface:aximm:1.0 M00_AXI ARREADY" *) input M00_AXI_arready;
  (* X_INTERFACE_INFO = "xilinx.com:interface:aximm:1.0 M00_AXI ARVALID" *) output M00_AXI_arvalid;
  (* X_INTERFACE_INFO = "xilinx.com:interface:aximm:1.0 M00_AXI AWADDR" *) output [3:0]M00_AXI_awaddr;
  (* X_INTERFACE_INFO = "xilinx.com:interface:aximm:1.0 M00_AXI AWPROT" *) output [2:0]M00_AXI_awprot;
  (* X_INTERFACE_INFO = "xilinx.com:interface:aximm:1.0 M00_AXI AWREADY" *) input M00_AXI_awready;
  (* X_INTERFACE_INFO = "xilinx.com:interface:aximm:1.0 M00_AXI AWVALID" *) output M00_AXI_awvalid;
  (* X_INTERFACE_INFO = "xilinx.com:interface:aximm:1.0 M00_AXI BREADY" *) output M00_AXI_bready;
  (* X_INTERFACE_INFO = "xilinx.com:interface:aximm:1.0 M00_AXI BRESP" *) input [1:0]M00_AXI_bresp;
  (* X_INTERFACE_INFO = "xilinx.com:interface:aximm:1.0 M00_AXI BVALID" *) input M00_AXI_bvalid;
  (* X_INTERFACE_INFO = "xilinx.com:interface:aximm:1.0 M00_AXI RDATA" *) input [31:0]M00_AXI_rdata;
  (* X_INTERFACE_INFO = "xilinx.com:interface:aximm:1.0 M00_AXI RREADY" *) output M00_AXI_rready;
  (* X_INTERFACE_INFO = "xilinx.com:interface:aximm:1.0 M00_AXI RRESP" *) input [1:0]M00_AXI_rresp;
  (* X_INTERFACE_INFO = "xilinx.com:interface:aximm:1.0 M00_AXI RVALID" *) input M00_AXI_rvalid;
  (* X_INTERFACE_INFO = "xilinx.com:interface:aximm:1.0 M00_AXI WDATA" *) output [31:0]M00_AXI_wdata;
  (* X_INTERFACE_INFO = "xilinx.com:interface:aximm:1.0 M00_AXI WREADY" *) input M00_AXI_wready;
  (* X_INTERFACE_INFO = "xilinx.com:interface:aximm:1.0 M00_AXI WSTRB" *) output [3:0]M00_AXI_wstrb;
  (* X_INTERFACE_INFO = "xilinx.com:interface:aximm:1.0 M00_AXI WVALID" *) output M00_AXI_wvalid;
  (* X_INTERFACE_INFO = "xilinx.com:interface:aximm:1.0 M01_AXI ARADDR" *) (* X_INTERFACE_MODE = "Master" *) (* X_INTERFACE_PARAMETER = "XIL_INTERFACENAME M01_AXI, ADDR_WIDTH 6, ARUSER_WIDTH 0, AWUSER_WIDTH 0, BUSER_WIDTH 0, CLK_DOMAIN /clk_wiz_0_clk_out1, DATA_WIDTH 32, FREQ_HZ 100000000, HAS_BRESP 1, HAS_BURST 0, HAS_CACHE 0, HAS_LOCK 0, HAS_PROT 1, HAS_QOS 0, HAS_REGION 0, HAS_RRESP 1, HAS_WSTRB 1, ID_WIDTH 0, INSERT_VIP 0, MAX_BURST_LENGTH 1, NUM_READ_OUTSTANDING 1, NUM_READ_THREADS 1, NUM_WRITE_OUTSTANDING 1, NUM_WRITE_THREADS 1, PHASE 0.0, PROTOCOL AXI4LITE, READ_WRITE_MODE READ_WRITE, RUSER_BITS_PER_BYTE 0, RUSER_WIDTH 0, SUPPORTS_NARROW_BURST 0, WUSER_BITS_PER_BYTE 0, WUSER_WIDTH 0" *) output [5:0]M01_AXI_araddr;
  (* X_INTERFACE_INFO = "xilinx.com:interface:aximm:1.0 M01_AXI ARPROT" *) output [2:0]M01_AXI_arprot;
  (* X_INTERFACE_INFO = "xilinx.com:interface:aximm:1.0 M01_AXI ARREADY" *) input M01_AXI_arready;
  (* X_INTERFACE_INFO = "xilinx.com:interface:aximm:1.0 M01_AXI ARVALID" *) output M01_AXI_arvalid;
  (* X_INTERFACE_INFO = "xilinx.com:interface:aximm:1.0 M01_AXI AWADDR" *) output [5:0]M01_AXI_awaddr;
  (* X_INTERFACE_INFO = "xilinx.com:interface:aximm:1.0 M01_AXI AWPROT" *) output [2:0]M01_AXI_awprot;
  (* X_INTERFACE_INFO = "xilinx.com:interface:aximm:1.0 M01_AXI AWREADY" *) input M01_AXI_awready;
  (* X_INTERFACE_INFO = "xilinx.com:interface:aximm:1.0 M01_AXI AWVALID" *) output M01_AXI_awvalid;
  (* X_INTERFACE_INFO = "xilinx.com:interface:aximm:1.0 M01_AXI BREADY" *) output M01_AXI_bready;
  (* X_INTERFACE_INFO = "xilinx.com:interface:aximm:1.0 M01_AXI BRESP" *) input [1:0]M01_AXI_bresp;
  (* X_INTERFACE_INFO = "xilinx.com:interface:aximm:1.0 M01_AXI BVALID" *) input M01_AXI_bvalid;
  (* X_INTERFACE_INFO = "xilinx.com:interface:aximm:1.0 M01_AXI RDATA" *) input [31:0]M01_AXI_rdata;
  (* X_INTERFACE_INFO = "xilinx.com:interface:aximm:1.0 M01_AXI RREADY" *) output M01_AXI_rready;
  (* X_INTERFACE_INFO = "xilinx.com:interface:aximm:1.0 M01_AXI RRESP" *) input [1:0]M01_AXI_rresp;
  (* X_INTERFACE_INFO = "xilinx.com:interface:aximm:1.0 M01_AXI RVALID" *) input M01_AXI_rvalid;
  (* X_INTERFACE_INFO = "xilinx.com:interface:aximm:1.0 M01_AXI WDATA" *) output [31:0]M01_AXI_wdata;
  (* X_INTERFACE_INFO = "xilinx.com:interface:aximm:1.0 M01_AXI WREADY" *) input M01_AXI_wready;
  (* X_INTERFACE_INFO = "xilinx.com:interface:aximm:1.0 M01_AXI WSTRB" *) output [3:0]M01_AXI_wstrb;
  (* X_INTERFACE_INFO = "xilinx.com:interface:aximm:1.0 M01_AXI WVALID" *) output M01_AXI_wvalid;
  (* X_INTERFACE_INFO = "xilinx.com:interface:aximm:1.0 S00_AXI ARADDR" *) (* X_INTERFACE_MODE = "Slave" *) (* X_INTERFACE_PARAMETER = "XIL_INTERFACENAME S00_AXI, ADDR_WIDTH 32, ARUSER_WIDTH 0, AWUSER_WIDTH 0, BUSER_WIDTH 0, CLK_DOMAIN /clk_wiz_0_clk_out1, DATA_WIDTH 32, FREQ_HZ 100000000, HAS_BRESP 1, HAS_BURST 0, HAS_CACHE 0, HAS_LOCK 0, HAS_PROT 1, HAS_QOS 0, HAS_REGION 0, HAS_RRESP 1, HAS_WSTRB 1, ID_WIDTH 0, INSERT_VIP 0, MAX_BURST_LENGTH 1, NUM_READ_OUTSTANDING 1, NUM_READ_THREADS 1, NUM_WRITE_OUTSTANDING 1, NUM_WRITE_THREADS 1, PHASE 0.0, PROTOCOL AXI4LITE, READ_WRITE_MODE READ_WRITE, RUSER_BITS_PER_BYTE 0, RUSER_WIDTH 0, SUPPORTS_NARROW_BURST 0, WUSER_BITS_PER_BYTE 0, WUSER_WIDTH 0" *) input [31:0]S00_AXI_araddr;
  (* X_INTERFACE_INFO = "xilinx.com:interface:aximm:1.0 S00_AXI ARPROT" *) input [2:0]S00_AXI_arprot;
  (* X_INTERFACE_INFO = "xilinx.com:interface:aximm:1.0 S00_AXI ARREADY" *) output S00_AXI_arready;
  (* X_INTERFACE_INFO = "xilinx.com:interface:aximm:1.0 S00_AXI ARVALID" *) input S00_AXI_arvalid;
  (* X_INTERFACE_INFO = "xilinx.com:interface:aximm:1.0 S00_AXI AWADDR" *) input [31:0]S00_AXI_awaddr;
  (* X_INTERFACE_INFO = "xilinx.com:interface:aximm:1.0 S00_AXI AWPROT" *) input [2:0]S00_AXI_awprot;
  (* X_INTERFACE_INFO = "xilinx.com:interface:aximm:1.0 S00_AXI AWREADY" *) output S00_AXI_awready;
  (* X_INTERFACE_INFO = "xilinx.com:interface:aximm:1.0 S00_AXI AWVALID" *) input S00_AXI_awvalid;
  (* X_INTERFACE_INFO = "xilinx.com:interface:aximm:1.0 S00_AXI BREADY" *) input S00_AXI_bready;
  (* X_INTERFACE_INFO = "xilinx.com:interface:aximm:1.0 S00_AXI BRESP" *) output [1:0]S00_AXI_bresp;
  (* X_INTERFACE_INFO = "xilinx.com:interface:aximm:1.0 S00_AXI BVALID" *) output S00_AXI_bvalid;
  (* X_INTERFACE_INFO = "xilinx.com:interface:aximm:1.0 S00_AXI RDATA" *) output [31:0]S00_AXI_rdata;
  (* X_INTERFACE_INFO = "xilinx.com:interface:aximm:1.0 S00_AXI RREADY" *) input S00_AXI_rready;
  (* X_INTERFACE_INFO = "xilinx.com:interface:aximm:1.0 S00_AXI RRESP" *) output [1:0]S00_AXI_rresp;
  (* X_INTERFACE_INFO = "xilinx.com:interface:aximm:1.0 S00_AXI RVALID" *) output S00_AXI_rvalid;
  (* X_INTERFACE_INFO = "xilinx.com:interface:aximm:1.0 S00_AXI WDATA" *) input [31:0]S00_AXI_wdata;
  (* X_INTERFACE_INFO = "xilinx.com:interface:aximm:1.0 S00_AXI WREADY" *) output S00_AXI_wready;
  (* X_INTERFACE_INFO = "xilinx.com:interface:aximm:1.0 S00_AXI WSTRB" *) input [3:0]S00_AXI_wstrb;
  (* X_INTERFACE_INFO = "xilinx.com:interface:aximm:1.0 S00_AXI WVALID" *) input S00_AXI_wvalid;
  (* X_INTERFACE_INFO = "xilinx.com:signal:clock:1.0 CLK.ACLK CLK" *) (* X_INTERFACE_PARAMETER = "XIL_INTERFACENAME CLK.ACLK, ASSOCIATED_BUSIF M00_AXI:M01_AXI:S00_AXI, ASSOCIATED_CLKEN s_sc_aclken, CLK_DOMAIN /clk_wiz_0_clk_out1, FREQ_HZ 100000000, FREQ_TOLERANCE_HZ 0, INSERT_VIP 0, PHASE 0.0" *) input aclk;
  (* X_INTERFACE_INFO = "xilinx.com:signal:reset:1.0 RST.ARESETN RST" *) (* X_INTERFACE_PARAMETER = "XIL_INTERFACENAME RST.ARESETN, INSERT_VIP 0, POLARITY ACTIVE_LOW" *) input aresetn;

  wire [3:0]M00_AXI_araddr;
  wire [2:0]M00_AXI_arprot;
  wire M00_AXI_arready;
  wire M00_AXI_arvalid;
  wire [3:0]M00_AXI_awaddr;
  wire [2:0]M00_AXI_awprot;
  wire M00_AXI_awready;
  wire M00_AXI_awvalid;
  wire M00_AXI_bready;
  wire [1:0]M00_AXI_bresp;
  wire M00_AXI_bvalid;
  wire [31:0]M00_AXI_rdata;
  wire M00_AXI_rready;
  wire [1:0]M00_AXI_rresp;
  wire M00_AXI_rvalid;
  wire [31:0]M00_AXI_wdata;
  wire M00_AXI_wready;
  wire [3:0]M00_AXI_wstrb;
  wire M00_AXI_wvalid;
  wire [5:0]M01_AXI_araddr;
  wire [2:0]M01_AXI_arprot;
  wire M01_AXI_arready;
  wire M01_AXI_arvalid;
  wire [5:0]M01_AXI_awaddr;
  wire [2:0]M01_AXI_awprot;
  wire M01_AXI_awready;
  wire M01_AXI_awvalid;
  wire M01_AXI_bready;
  wire [1:0]M01_AXI_bresp;
  wire M01_AXI_bvalid;
  wire [31:0]M01_AXI_rdata;
  wire M01_AXI_rready;
  wire [1:0]M01_AXI_rresp;
  wire M01_AXI_rvalid;
  wire [31:0]M01_AXI_wdata;
  wire M01_AXI_wready;
  wire [3:0]M01_AXI_wstrb;
  wire M01_AXI_wvalid;
  wire [31:0]S00_AXI_araddr;
  wire [2:0]S00_AXI_arprot;
  wire S00_AXI_arready;
  wire S00_AXI_arvalid;
  wire [31:0]S00_AXI_awaddr;
  wire [2:0]S00_AXI_awprot;
  wire S00_AXI_awready;
  wire S00_AXI_awvalid;
  wire S00_AXI_bready;
  wire [1:0]S00_AXI_bresp;
  wire S00_AXI_bvalid;
  wire [31:0]S00_AXI_rdata;
  wire S00_AXI_rready;
  wire [1:0]S00_AXI_rresp;
  wire S00_AXI_rvalid;
  wire [31:0]S00_AXI_wdata;
  wire S00_AXI_wready;
  wire [3:0]S00_AXI_wstrb;
  wire S00_AXI_wvalid;
  wire [0:0]S_SC_AR_1_INFO;
  wire [140:0]S_SC_AR_1_PAYLD;
  wire [0:0]S_SC_AR_1_RECV;
  wire S_SC_AR_1_REQ;
  wire S_SC_AR_1_SEND;
  wire [0:0]S_SC_AR_2_INFO;
  wire [140:0]S_SC_AR_2_PAYLD;
  wire [0:0]S_SC_AR_2_RECV;
  wire [0:0]S_SC_AR_2_REQ;
  wire [0:0]S_SC_AR_2_SEND;
  wire [0:0]S_SC_AR_3_INFO;
  wire [140:0]S_SC_AR_3_PAYLD;
  wire [0:0]S_SC_AR_3_RECV;
  wire [0:0]S_SC_AR_3_REQ;
  wire [0:0]S_SC_AR_3_SEND;
  wire [0:0]S_SC_AW_1_INFO;
  wire [140:0]S_SC_AW_1_PAYLD;
  wire [0:0]S_SC_AW_1_RECV;
  wire S_SC_AW_1_REQ;
  wire S_SC_AW_1_SEND;
  wire [0:0]S_SC_AW_2_INFO;
  wire [140:0]S_SC_AW_2_PAYLD;
  wire [0:0]S_SC_AW_2_RECV;
  wire [0:0]S_SC_AW_2_REQ;
  wire [0:0]S_SC_AW_2_SEND;
  wire [0:0]S_SC_AW_3_INFO;
  wire [140:0]S_SC_AW_3_PAYLD;
  wire [0:0]S_SC_AW_3_RECV;
  wire [0:0]S_SC_AW_3_REQ;
  wire [0:0]S_SC_AW_3_SEND;
  wire [0:0]S_SC_B_1_INFO;
  wire [6:0]S_SC_B_1_PAYLD;
  wire [0:0]S_SC_B_1_RECV;
  wire [0:0]S_SC_B_1_REQ;
  wire [0:0]S_SC_B_1_SEND;
  wire [0:0]S_SC_B_2_INFO;
  wire [6:0]S_SC_B_2_PAYLD;
  wire [0:0]S_SC_B_2_RECV;
  wire S_SC_B_2_REQ;
  wire S_SC_B_2_SEND;
  wire [0:0]S_SC_B_3_INFO;
  wire [6:0]S_SC_B_3_PAYLD;
  wire [0:0]S_SC_B_3_RECV;
  wire S_SC_B_3_REQ;
  wire S_SC_B_3_SEND;
  wire [0:0]S_SC_R_1_INFO;
  wire [52:0]S_SC_R_1_PAYLD;
  wire [0:0]S_SC_R_1_RECV;
  wire [0:0]S_SC_R_1_REQ;
  wire [0:0]S_SC_R_1_SEND;
  wire [0:0]S_SC_R_2_INFO;
  wire [52:0]S_SC_R_2_PAYLD;
  wire [0:0]S_SC_R_2_RECV;
  wire S_SC_R_2_REQ;
  wire S_SC_R_2_SEND;
  wire [0:0]S_SC_R_3_INFO;
  wire [52:0]S_SC_R_3_PAYLD;
  wire [0:0]S_SC_R_3_RECV;
  wire S_SC_R_3_REQ;
  wire S_SC_R_3_SEND;
  wire [0:0]S_SC_W_1_INFO;
  wire [54:0]S_SC_W_1_PAYLD;
  wire [0:0]S_SC_W_1_RECV;
  wire S_SC_W_1_REQ;
  wire S_SC_W_1_SEND;
  wire [0:0]S_SC_W_2_INFO;
  wire [54:0]S_SC_W_2_PAYLD;
  wire [0:0]S_SC_W_2_RECV;
  wire [0:0]S_SC_W_2_REQ;
  wire [0:0]S_SC_W_2_SEND;
  wire [0:0]S_SC_W_3_INFO;
  wire [54:0]S_SC_W_3_PAYLD;
  wire [0:0]S_SC_W_3_RECV;
  wire [0:0]S_SC_W_3_REQ;
  wire [0:0]S_SC_W_3_SEND;
  wire aclk;
  wire aresetn;
  wire aresetn_net;
  wire clk_map_M00_ACLK;
  wire [0:0]clk_map_M00_ARESETN;
  wire clk_map_M01_ACLK;
  wire clk_map_S00_ACLK;
  wire [0:0]clk_map_S00_ARESETN;
  wire [0:0]m00_nodes_M_SC_AR_INFO;
  wire [140:0]m00_nodes_M_SC_AR_PAYLD;
  wire m00_nodes_M_SC_AR_RECV;
  wire [0:0]m00_nodes_M_SC_AR_REQ;
  wire [0:0]m00_nodes_M_SC_AR_SEND;
  wire [0:0]m00_nodes_M_SC_AW_INFO;
  wire [140:0]m00_nodes_M_SC_AW_PAYLD;
  wire m00_nodes_M_SC_AW_RECV;
  wire [0:0]m00_nodes_M_SC_AW_REQ;
  wire [0:0]m00_nodes_M_SC_AW_SEND;
  wire [0:0]m00_nodes_M_SC_B_INFO;
  wire [6:0]m00_nodes_M_SC_B_PAYLD;
  wire [0:0]m00_nodes_M_SC_B_RECV;
  wire [0:0]m00_nodes_M_SC_B_REQ;
  wire [0:0]m00_nodes_M_SC_B_SEND;
  wire [0:0]m00_nodes_M_SC_R_INFO;
  wire [52:0]m00_nodes_M_SC_R_PAYLD;
  wire [0:0]m00_nodes_M_SC_R_RECV;
  wire [0:0]m00_nodes_M_SC_R_REQ;
  wire [0:0]m00_nodes_M_SC_R_SEND;
  wire [0:0]m00_nodes_M_SC_W_INFO;
  wire [54:0]m00_nodes_M_SC_W_PAYLD;
  wire m00_nodes_M_SC_W_RECV;
  wire [0:0]m00_nodes_M_SC_W_REQ;
  wire [0:0]m00_nodes_M_SC_W_SEND;
  wire [3:0]m00_sc2axi_M_AXI_ARADDR;
  wire [3:0]m00_sc2axi_M_AXI_ARCACHE;
  wire [0:0]m00_sc2axi_M_AXI_ARID;
  wire [7:0]m00_sc2axi_M_AXI_ARLEN;
  wire [0:0]m00_sc2axi_M_AXI_ARLOCK;
  wire [2:0]m00_sc2axi_M_AXI_ARPROT;
  wire [3:0]m00_sc2axi_M_AXI_ARQOS;
  wire m00_sc2axi_M_AXI_ARREADY;
  wire [1023:0]m00_sc2axi_M_AXI_ARUSER;
  wire m00_sc2axi_M_AXI_ARVALID;
  wire [3:0]m00_sc2axi_M_AXI_AWADDR;
  wire [3:0]m00_sc2axi_M_AXI_AWCACHE;
  wire [0:0]m00_sc2axi_M_AXI_AWID;
  wire [7:0]m00_sc2axi_M_AXI_AWLEN;
  wire [0:0]m00_sc2axi_M_AXI_AWLOCK;
  wire [2:0]m00_sc2axi_M_AXI_AWPROT;
  wire [3:0]m00_sc2axi_M_AXI_AWQOS;
  wire m00_sc2axi_M_AXI_AWREADY;
  wire [1023:0]m00_sc2axi_M_AXI_AWUSER;
  wire m00_sc2axi_M_AXI_AWVALID;
  wire [0:0]m00_sc2axi_M_AXI_BID;
  wire m00_sc2axi_M_AXI_BREADY;
  wire [1:0]m00_sc2axi_M_AXI_BRESP;
  wire [1023:0]m00_sc2axi_M_AXI_BUSER;
  wire m00_sc2axi_M_AXI_BVALID;
  wire [31:0]m00_sc2axi_M_AXI_RDATA;
  wire [0:0]m00_sc2axi_M_AXI_RID;
  wire m00_sc2axi_M_AXI_RLAST;
  wire m00_sc2axi_M_AXI_RREADY;
  wire [1:0]m00_sc2axi_M_AXI_RRESP;
  wire [1023:0]m00_sc2axi_M_AXI_RUSER;
  wire m00_sc2axi_M_AXI_RVALID;
  wire [31:0]m00_sc2axi_M_AXI_WDATA;
  wire m00_sc2axi_M_AXI_WLAST;
  wire m00_sc2axi_M_AXI_WREADY;
  wire [3:0]m00_sc2axi_M_AXI_WSTRB;
  wire [1023:0]m00_sc2axi_M_AXI_WUSER;
  wire m00_sc2axi_M_AXI_WVALID;
  wire [0:0]m01_nodes_M_SC_AR_INFO;
  wire [140:0]m01_nodes_M_SC_AR_PAYLD;
  wire m01_nodes_M_SC_AR_RECV;
  wire [0:0]m01_nodes_M_SC_AR_REQ;
  wire [0:0]m01_nodes_M_SC_AR_SEND;
  wire [0:0]m01_nodes_M_SC_AW_INFO;
  wire [140:0]m01_nodes_M_SC_AW_PAYLD;
  wire m01_nodes_M_SC_AW_RECV;
  wire [0:0]m01_nodes_M_SC_AW_REQ;
  wire [0:0]m01_nodes_M_SC_AW_SEND;
  wire [0:0]m01_nodes_M_SC_B_INFO;
  wire [6:0]m01_nodes_M_SC_B_PAYLD;
  wire [0:0]m01_nodes_M_SC_B_RECV;
  wire [0:0]m01_nodes_M_SC_B_REQ;
  wire [0:0]m01_nodes_M_SC_B_SEND;
  wire [0:0]m01_nodes_M_SC_R_INFO;
  wire [52:0]m01_nodes_M_SC_R_PAYLD;
  wire [0:0]m01_nodes_M_SC_R_RECV;
  wire [0:0]m01_nodes_M_SC_R_REQ;
  wire [0:0]m01_nodes_M_SC_R_SEND;
  wire [0:0]m01_nodes_M_SC_W_INFO;
  wire [54:0]m01_nodes_M_SC_W_PAYLD;
  wire m01_nodes_M_SC_W_RECV;
  wire [0:0]m01_nodes_M_SC_W_REQ;
  wire [0:0]m01_nodes_M_SC_W_SEND;
  wire [5:0]m01_sc2axi_M_AXI_ARADDR;
  wire [3:0]m01_sc2axi_M_AXI_ARCACHE;
  wire [0:0]m01_sc2axi_M_AXI_ARID;
  wire [7:0]m01_sc2axi_M_AXI_ARLEN;
  wire [0:0]m01_sc2axi_M_AXI_ARLOCK;
  wire [2:0]m01_sc2axi_M_AXI_ARPROT;
  wire [3:0]m01_sc2axi_M_AXI_ARQOS;
  wire m01_sc2axi_M_AXI_ARREADY;
  wire [1023:0]m01_sc2axi_M_AXI_ARUSER;
  wire m01_sc2axi_M_AXI_ARVALID;
  wire [5:0]m01_sc2axi_M_AXI_AWADDR;
  wire [3:0]m01_sc2axi_M_AXI_AWCACHE;
  wire [0:0]m01_sc2axi_M_AXI_AWID;
  wire [7:0]m01_sc2axi_M_AXI_AWLEN;
  wire [0:0]m01_sc2axi_M_AXI_AWLOCK;
  wire [2:0]m01_sc2axi_M_AXI_AWPROT;
  wire [3:0]m01_sc2axi_M_AXI_AWQOS;
  wire m01_sc2axi_M_AXI_AWREADY;
  wire [1023:0]m01_sc2axi_M_AXI_AWUSER;
  wire m01_sc2axi_M_AXI_AWVALID;
  wire [0:0]m01_sc2axi_M_AXI_BID;
  wire m01_sc2axi_M_AXI_BREADY;
  wire [1:0]m01_sc2axi_M_AXI_BRESP;
  wire [1023:0]m01_sc2axi_M_AXI_BUSER;
  wire m01_sc2axi_M_AXI_BVALID;
  wire [31:0]m01_sc2axi_M_AXI_RDATA;
  wire [0:0]m01_sc2axi_M_AXI_RID;
  wire m01_sc2axi_M_AXI_RLAST;
  wire m01_sc2axi_M_AXI_RREADY;
  wire [1:0]m01_sc2axi_M_AXI_RRESP;
  wire [1023:0]m01_sc2axi_M_AXI_RUSER;
  wire m01_sc2axi_M_AXI_RVALID;
  wire [31:0]m01_sc2axi_M_AXI_WDATA;
  wire m01_sc2axi_M_AXI_WLAST;
  wire m01_sc2axi_M_AXI_WREADY;
  wire [3:0]m01_sc2axi_M_AXI_WSTRB;
  wire [1023:0]m01_sc2axi_M_AXI_WUSER;
  wire m01_sc2axi_M_AXI_WVALID;
  wire [0:0]m_axi_aresetn_1;
  wire [31:0]s00_entry_pipeline_m_axi_ARADDR;
  wire [3:0]s00_entry_pipeline_m_axi_ARCACHE;
  wire [0:0]s00_entry_pipeline_m_axi_ARID;
  wire [7:0]s00_entry_pipeline_m_axi_ARLEN;
  wire [0:0]s00_entry_pipeline_m_axi_ARLOCK;
  wire [2:0]s00_entry_pipeline_m_axi_ARPROT;
  wire [3:0]s00_entry_pipeline_m_axi_ARQOS;
  wire s00_entry_pipeline_m_axi_ARREADY;
  wire [1023:0]s00_entry_pipeline_m_axi_ARUSER;
  wire s00_entry_pipeline_m_axi_ARVALID;
  wire [31:0]s00_entry_pipeline_m_axi_AWADDR;
  wire [3:0]s00_entry_pipeline_m_axi_AWCACHE;
  wire [0:0]s00_entry_pipeline_m_axi_AWID;
  wire [7:0]s00_entry_pipeline_m_axi_AWLEN;
  wire [0:0]s00_entry_pipeline_m_axi_AWLOCK;
  wire [2:0]s00_entry_pipeline_m_axi_AWPROT;
  wire [3:0]s00_entry_pipeline_m_axi_AWQOS;
  wire s00_entry_pipeline_m_axi_AWREADY;
  wire [1023:0]s00_entry_pipeline_m_axi_AWUSER;
  wire s00_entry_pipeline_m_axi_AWVALID;
  wire [0:0]s00_entry_pipeline_m_axi_BID;
  wire s00_entry_pipeline_m_axi_BREADY;
  wire [1:0]s00_entry_pipeline_m_axi_BRESP;
  wire [1023:0]s00_entry_pipeline_m_axi_BUSER;
  wire s00_entry_pipeline_m_axi_BVALID;
  wire [31:0]s00_entry_pipeline_m_axi_RDATA;
  wire [0:0]s00_entry_pipeline_m_axi_RID;
  wire s00_entry_pipeline_m_axi_RLAST;
  wire s00_entry_pipeline_m_axi_RREADY;
  wire [1:0]s00_entry_pipeline_m_axi_RRESP;
  wire [1023:0]s00_entry_pipeline_m_axi_RUSER;
  wire s00_entry_pipeline_m_axi_RVALID;
  wire [31:0]s00_entry_pipeline_m_axi_WDATA;
  wire s00_entry_pipeline_m_axi_WLAST;
  wire s00_entry_pipeline_m_axi_WREADY;
  wire [3:0]s00_entry_pipeline_m_axi_WSTRB;
  wire [1023:0]s00_entry_pipeline_m_axi_WUSER;
  wire s00_entry_pipeline_m_axi_WVALID;
  wire [0:0]s00_nodes_M_SC_AR_INFO;
  wire [140:0]s00_nodes_M_SC_AR_PAYLD;
  wire [0:0]s00_nodes_M_SC_AR_RECV;
  wire [0:0]s00_nodes_M_SC_AR_REQ;
  wire [0:0]s00_nodes_M_SC_AR_SEND;
  wire [0:0]s00_nodes_M_SC_AW_INFO;
  wire [140:0]s00_nodes_M_SC_AW_PAYLD;
  wire [0:0]s00_nodes_M_SC_AW_RECV;
  wire [0:0]s00_nodes_M_SC_AW_REQ;
  wire [0:0]s00_nodes_M_SC_AW_SEND;
  wire [0:0]s00_nodes_M_SC_B_INFO;
  wire [6:0]s00_nodes_M_SC_B_PAYLD;
  wire s00_nodes_M_SC_B_RECV;
  wire [0:0]s00_nodes_M_SC_B_REQ;
  wire [0:0]s00_nodes_M_SC_B_SEND;
  wire [0:0]s00_nodes_M_SC_R_INFO;
  wire [52:0]s00_nodes_M_SC_R_PAYLD;
  wire s00_nodes_M_SC_R_RECV;
  wire [0:0]s00_nodes_M_SC_R_REQ;
  wire [0:0]s00_nodes_M_SC_R_SEND;
  wire [0:0]s00_nodes_M_SC_W_INFO;
  wire [54:0]s00_nodes_M_SC_W_PAYLD;
  wire [0:0]s00_nodes_M_SC_W_RECV;
  wire [0:0]s00_nodes_M_SC_W_REQ;
  wire [0:0]s00_nodes_M_SC_W_SEND;
  wire swbd_aclk_net;
  wire [0:0]swbd_aresetn_net;

  clk_map_imp_5Y9LOC clk_map
       (.M00_ACLK(clk_map_M00_ACLK),
        .M00_ARESETN(clk_map_M00_ARESETN),
        .M01_ACLK(clk_map_M01_ACLK),
        .M01_ARESETN(m_axi_aresetn_1),
        .S00_ACLK(clk_map_S00_ACLK),
        .S00_ARESETN(clk_map_S00_ARESETN),
        .aclk(aclk),
        .aresetn(aresetn),
        .aresetn_out(aresetn_net),
        .swbd_aclk(swbd_aclk_net),
        .swbd_aresetn(swbd_aresetn_net));
  m00_exit_pipeline_imp_1TZX5BB m00_exit_pipeline
       (.aclk(clk_map_M00_ACLK),
        .aresetn(clk_map_M00_ARESETN),
        .m_axi_araddr(M00_AXI_araddr),
        .m_axi_arprot(M00_AXI_arprot),
        .m_axi_arready(M00_AXI_arready),
        .m_axi_arvalid(M00_AXI_arvalid),
        .m_axi_awaddr(M00_AXI_awaddr),
        .m_axi_awprot(M00_AXI_awprot),
        .m_axi_awready(M00_AXI_awready),
        .m_axi_awvalid(M00_AXI_awvalid),
        .m_axi_bready(M00_AXI_bready),
        .m_axi_bresp(M00_AXI_bresp),
        .m_axi_bvalid(M00_AXI_bvalid),
        .m_axi_rdata(M00_AXI_rdata),
        .m_axi_rready(M00_AXI_rready),
        .m_axi_rresp(M00_AXI_rresp),
        .m_axi_rvalid(M00_AXI_rvalid),
        .m_axi_wdata(M00_AXI_wdata),
        .m_axi_wready(M00_AXI_wready),
        .m_axi_wstrb(M00_AXI_wstrb),
        .m_axi_wvalid(M00_AXI_wvalid),
        .s_axi_araddr(m00_sc2axi_M_AXI_ARADDR),
        .s_axi_arcache(m00_sc2axi_M_AXI_ARCACHE),
        .s_axi_arid(m00_sc2axi_M_AXI_ARID),
        .s_axi_arlen(m00_sc2axi_M_AXI_ARLEN),
        .s_axi_arlock(m00_sc2axi_M_AXI_ARLOCK),
        .s_axi_arprot(m00_sc2axi_M_AXI_ARPROT),
        .s_axi_arqos(m00_sc2axi_M_AXI_ARQOS),
        .s_axi_arready(m00_sc2axi_M_AXI_ARREADY),
        .s_axi_aruser(m00_sc2axi_M_AXI_ARUSER),
        .s_axi_arvalid(m00_sc2axi_M_AXI_ARVALID),
        .s_axi_awaddr(m00_sc2axi_M_AXI_AWADDR),
        .s_axi_awcache(m00_sc2axi_M_AXI_AWCACHE),
        .s_axi_awid(m00_sc2axi_M_AXI_AWID),
        .s_axi_awlen(m00_sc2axi_M_AXI_AWLEN),
        .s_axi_awlock(m00_sc2axi_M_AXI_AWLOCK),
        .s_axi_awprot(m00_sc2axi_M_AXI_AWPROT),
        .s_axi_awqos(m00_sc2axi_M_AXI_AWQOS),
        .s_axi_awready(m00_sc2axi_M_AXI_AWREADY),
        .s_axi_awuser(m00_sc2axi_M_AXI_AWUSER),
        .s_axi_awvalid(m00_sc2axi_M_AXI_AWVALID),
        .s_axi_bid(m00_sc2axi_M_AXI_BID),
        .s_axi_bready(m00_sc2axi_M_AXI_BREADY),
        .s_axi_bresp(m00_sc2axi_M_AXI_BRESP),
        .s_axi_buser(m00_sc2axi_M_AXI_BUSER),
        .s_axi_bvalid(m00_sc2axi_M_AXI_BVALID),
        .s_axi_rdata(m00_sc2axi_M_AXI_RDATA),
        .s_axi_rid(m00_sc2axi_M_AXI_RID),
        .s_axi_rlast(m00_sc2axi_M_AXI_RLAST),
        .s_axi_rready(m00_sc2axi_M_AXI_RREADY),
        .s_axi_rresp(m00_sc2axi_M_AXI_RRESP),
        .s_axi_ruser(m00_sc2axi_M_AXI_RUSER),
        .s_axi_rvalid(m00_sc2axi_M_AXI_RVALID),
        .s_axi_wdata(m00_sc2axi_M_AXI_WDATA),
        .s_axi_wlast(m00_sc2axi_M_AXI_WLAST),
        .s_axi_wready(m00_sc2axi_M_AXI_WREADY),
        .s_axi_wstrb(m00_sc2axi_M_AXI_WSTRB),
        .s_axi_wuser(m00_sc2axi_M_AXI_WUSER),
        .s_axi_wvalid(m00_sc2axi_M_AXI_WVALID));
  m00_nodes_imp_1GOYQYZ m00_nodes
       (.M_SC_AR_info(m00_nodes_M_SC_AR_INFO),
        .M_SC_AR_payld(m00_nodes_M_SC_AR_PAYLD),
        .M_SC_AR_recv(m00_nodes_M_SC_AR_RECV),
        .M_SC_AR_req(m00_nodes_M_SC_AR_REQ),
        .M_SC_AR_send(m00_nodes_M_SC_AR_SEND),
        .M_SC_AW_info(m00_nodes_M_SC_AW_INFO),
        .M_SC_AW_payld(m00_nodes_M_SC_AW_PAYLD),
        .M_SC_AW_recv(m00_nodes_M_SC_AW_RECV),
        .M_SC_AW_req(m00_nodes_M_SC_AW_REQ),
        .M_SC_AW_send(m00_nodes_M_SC_AW_SEND),
        .M_SC_B_info(m00_nodes_M_SC_B_INFO),
        .M_SC_B_payld(m00_nodes_M_SC_B_PAYLD),
        .M_SC_B_recv(m00_nodes_M_SC_B_RECV),
        .M_SC_B_req(m00_nodes_M_SC_B_REQ),
        .M_SC_B_send(m00_nodes_M_SC_B_SEND),
        .M_SC_R_info(m00_nodes_M_SC_R_INFO),
        .M_SC_R_payld(m00_nodes_M_SC_R_PAYLD),
        .M_SC_R_recv(m00_nodes_M_SC_R_RECV),
        .M_SC_R_req(m00_nodes_M_SC_R_REQ),
        .M_SC_R_send(m00_nodes_M_SC_R_SEND),
        .M_SC_W_info(m00_nodes_M_SC_W_INFO),
        .M_SC_W_payld(m00_nodes_M_SC_W_PAYLD),
        .M_SC_W_recv(m00_nodes_M_SC_W_RECV),
        .M_SC_W_req(m00_nodes_M_SC_W_REQ),
        .M_SC_W_send(m00_nodes_M_SC_W_SEND),
        .S_SC_AR_info(S_SC_AR_2_INFO),
        .S_SC_AR_payld(S_SC_AR_2_PAYLD),
        .S_SC_AR_recv(S_SC_AR_2_RECV),
        .S_SC_AR_req(S_SC_AR_2_REQ),
        .S_SC_AR_send(S_SC_AR_2_SEND),
        .S_SC_AW_info(S_SC_AW_2_INFO),
        .S_SC_AW_payld(S_SC_AW_2_PAYLD),
        .S_SC_AW_recv(S_SC_AW_2_RECV),
        .S_SC_AW_req(S_SC_AW_2_REQ),
        .S_SC_AW_send(S_SC_AW_2_SEND),
        .S_SC_B_info(S_SC_B_2_INFO),
        .S_SC_B_payld(S_SC_B_2_PAYLD),
        .S_SC_B_recv(S_SC_B_2_RECV),
        .S_SC_B_req(S_SC_B_2_REQ),
        .S_SC_B_send(S_SC_B_2_SEND),
        .S_SC_R_info(S_SC_R_2_INFO),
        .S_SC_R_payld(S_SC_R_2_PAYLD),
        .S_SC_R_recv(S_SC_R_2_RECV),
        .S_SC_R_req(S_SC_R_2_REQ),
        .S_SC_R_send(S_SC_R_2_SEND),
        .S_SC_W_info(S_SC_W_2_INFO),
        .S_SC_W_payld(S_SC_W_2_PAYLD),
        .S_SC_W_recv(S_SC_W_2_RECV),
        .S_SC_W_req(S_SC_W_2_REQ),
        .S_SC_W_send(S_SC_W_2_SEND),
        .m_axi_aclk(clk_map_M00_ACLK),
        .m_axi_aresetn(clk_map_M00_ARESETN),
        .s_axi_aclk(clk_map_M00_ACLK),
        .s_axi_aresetn(clk_map_M00_ARESETN));
  bd_afc3_m00s2a_0 m00_sc2axi
       (.aclk(clk_map_M00_ACLK),
        .m_axi_araddr(m00_sc2axi_M_AXI_ARADDR),
        .m_axi_arcache(m00_sc2axi_M_AXI_ARCACHE),
        .m_axi_arid(m00_sc2axi_M_AXI_ARID),
        .m_axi_arlen(m00_sc2axi_M_AXI_ARLEN),
        .m_axi_arlock(m00_sc2axi_M_AXI_ARLOCK),
        .m_axi_arprot(m00_sc2axi_M_AXI_ARPROT),
        .m_axi_arqos(m00_sc2axi_M_AXI_ARQOS),
        .m_axi_arready(m00_sc2axi_M_AXI_ARREADY),
        .m_axi_aruser(m00_sc2axi_M_AXI_ARUSER),
        .m_axi_arvalid(m00_sc2axi_M_AXI_ARVALID),
        .m_axi_awaddr(m00_sc2axi_M_AXI_AWADDR),
        .m_axi_awcache(m00_sc2axi_M_AXI_AWCACHE),
        .m_axi_awid(m00_sc2axi_M_AXI_AWID),
        .m_axi_awlen(m00_sc2axi_M_AXI_AWLEN),
        .m_axi_awlock(m00_sc2axi_M_AXI_AWLOCK),
        .m_axi_awprot(m00_sc2axi_M_AXI_AWPROT),
        .m_axi_awqos(m00_sc2axi_M_AXI_AWQOS),
        .m_axi_awready(m00_sc2axi_M_AXI_AWREADY),
        .m_axi_awuser(m00_sc2axi_M_AXI_AWUSER),
        .m_axi_awvalid(m00_sc2axi_M_AXI_AWVALID),
        .m_axi_bid(m00_sc2axi_M_AXI_BID),
        .m_axi_bready(m00_sc2axi_M_AXI_BREADY),
        .m_axi_bresp(m00_sc2axi_M_AXI_BRESP),
        .m_axi_buser(m00_sc2axi_M_AXI_BUSER),
        .m_axi_bvalid(m00_sc2axi_M_AXI_BVALID),
        .m_axi_rdata(m00_sc2axi_M_AXI_RDATA),
        .m_axi_rid(m00_sc2axi_M_AXI_RID),
        .m_axi_rlast(m00_sc2axi_M_AXI_RLAST),
        .m_axi_rready(m00_sc2axi_M_AXI_RREADY),
        .m_axi_rresp(m00_sc2axi_M_AXI_RRESP),
        .m_axi_ruser(m00_sc2axi_M_AXI_RUSER),
        .m_axi_rvalid(m00_sc2axi_M_AXI_RVALID),
        .m_axi_wdata(m00_sc2axi_M_AXI_WDATA),
        .m_axi_wlast(m00_sc2axi_M_AXI_WLAST),
        .m_axi_wready(m00_sc2axi_M_AXI_WREADY),
        .m_axi_wstrb(m00_sc2axi_M_AXI_WSTRB),
        .m_axi_wuser(m00_sc2axi_M_AXI_WUSER),
        .m_axi_wvalid(m00_sc2axi_M_AXI_WVALID),
        .m_sc_b_info(S_SC_B_2_INFO),
        .m_sc_b_payld(S_SC_B_2_PAYLD),
        .m_sc_b_recv(S_SC_B_2_RECV),
        .m_sc_b_req(S_SC_B_2_REQ),
        .m_sc_b_send(S_SC_B_2_SEND),
        .m_sc_r_info(S_SC_R_2_INFO),
        .m_sc_r_payld(S_SC_R_2_PAYLD),
        .m_sc_r_recv(S_SC_R_2_RECV),
        .m_sc_r_req(S_SC_R_2_REQ),
        .m_sc_r_send(S_SC_R_2_SEND),
        .s_sc_ar_info(m00_nodes_M_SC_AR_INFO),
        .s_sc_ar_payld(m00_nodes_M_SC_AR_PAYLD),
        .s_sc_ar_recv(m00_nodes_M_SC_AR_RECV),
        .s_sc_ar_req(m00_nodes_M_SC_AR_REQ),
        .s_sc_ar_send(m00_nodes_M_SC_AR_SEND),
        .s_sc_aw_info(m00_nodes_M_SC_AW_INFO),
        .s_sc_aw_payld(m00_nodes_M_SC_AW_PAYLD),
        .s_sc_aw_recv(m00_nodes_M_SC_AW_RECV),
        .s_sc_aw_req(m00_nodes_M_SC_AW_REQ),
        .s_sc_aw_send(m00_nodes_M_SC_AW_SEND),
        .s_sc_w_info(m00_nodes_M_SC_W_INFO),
        .s_sc_w_payld(m00_nodes_M_SC_W_PAYLD),
        .s_sc_w_recv(m00_nodes_M_SC_W_RECV),
        .s_sc_w_req(m00_nodes_M_SC_W_REQ),
        .s_sc_w_send(m00_nodes_M_SC_W_SEND));
  m01_exit_pipeline_imp_1XMPFJB m01_exit_pipeline
       (.aclk(clk_map_M01_ACLK),
        .aresetn(m_axi_aresetn_1),
        .m_axi_araddr(M01_AXI_araddr),
        .m_axi_arprot(M01_AXI_arprot),
        .m_axi_arready(M01_AXI_arready),
        .m_axi_arvalid(M01_AXI_arvalid),
        .m_axi_awaddr(M01_AXI_awaddr),
        .m_axi_awprot(M01_AXI_awprot),
        .m_axi_awready(M01_AXI_awready),
        .m_axi_awvalid(M01_AXI_awvalid),
        .m_axi_bready(M01_AXI_bready),
        .m_axi_bresp(M01_AXI_bresp),
        .m_axi_bvalid(M01_AXI_bvalid),
        .m_axi_rdata(M01_AXI_rdata),
        .m_axi_rready(M01_AXI_rready),
        .m_axi_rresp(M01_AXI_rresp),
        .m_axi_rvalid(M01_AXI_rvalid),
        .m_axi_wdata(M01_AXI_wdata),
        .m_axi_wready(M01_AXI_wready),
        .m_axi_wstrb(M01_AXI_wstrb),
        .m_axi_wvalid(M01_AXI_wvalid),
        .s_axi_araddr(m01_sc2axi_M_AXI_ARADDR),
        .s_axi_arcache(m01_sc2axi_M_AXI_ARCACHE),
        .s_axi_arid(m01_sc2axi_M_AXI_ARID),
        .s_axi_arlen(m01_sc2axi_M_AXI_ARLEN),
        .s_axi_arlock(m01_sc2axi_M_AXI_ARLOCK),
        .s_axi_arprot(m01_sc2axi_M_AXI_ARPROT),
        .s_axi_arqos(m01_sc2axi_M_AXI_ARQOS),
        .s_axi_arready(m01_sc2axi_M_AXI_ARREADY),
        .s_axi_aruser(m01_sc2axi_M_AXI_ARUSER),
        .s_axi_arvalid(m01_sc2axi_M_AXI_ARVALID),
        .s_axi_awaddr(m01_sc2axi_M_AXI_AWADDR),
        .s_axi_awcache(m01_sc2axi_M_AXI_AWCACHE),
        .s_axi_awid(m01_sc2axi_M_AXI_AWID),
        .s_axi_awlen(m01_sc2axi_M_AXI_AWLEN),
        .s_axi_awlock(m01_sc2axi_M_AXI_AWLOCK),
        .s_axi_awprot(m01_sc2axi_M_AXI_AWPROT),
        .s_axi_awqos(m01_sc2axi_M_AXI_AWQOS),
        .s_axi_awready(m01_sc2axi_M_AXI_AWREADY),
        .s_axi_awuser(m01_sc2axi_M_AXI_AWUSER),
        .s_axi_awvalid(m01_sc2axi_M_AXI_AWVALID),
        .s_axi_bid(m01_sc2axi_M_AXI_BID),
        .s_axi_bready(m01_sc2axi_M_AXI_BREADY),
        .s_axi_bresp(m01_sc2axi_M_AXI_BRESP),
        .s_axi_buser(m01_sc2axi_M_AXI_BUSER),
        .s_axi_bvalid(m01_sc2axi_M_AXI_BVALID),
        .s_axi_rdata(m01_sc2axi_M_AXI_RDATA),
        .s_axi_rid(m01_sc2axi_M_AXI_RID),
        .s_axi_rlast(m01_sc2axi_M_AXI_RLAST),
        .s_axi_rready(m01_sc2axi_M_AXI_RREADY),
        .s_axi_rresp(m01_sc2axi_M_AXI_RRESP),
        .s_axi_ruser(m01_sc2axi_M_AXI_RUSER),
        .s_axi_rvalid(m01_sc2axi_M_AXI_RVALID),
        .s_axi_wdata(m01_sc2axi_M_AXI_WDATA),
        .s_axi_wlast(m01_sc2axi_M_AXI_WLAST),
        .s_axi_wready(m01_sc2axi_M_AXI_WREADY),
        .s_axi_wstrb(m01_sc2axi_M_AXI_WSTRB),
        .s_axi_wuser(m01_sc2axi_M_AXI_WUSER),
        .s_axi_wvalid(m01_sc2axi_M_AXI_WVALID));
  m01_nodes_imp_94N5OD m01_nodes
       (.M_SC_AR_info(m01_nodes_M_SC_AR_INFO),
        .M_SC_AR_payld(m01_nodes_M_SC_AR_PAYLD),
        .M_SC_AR_recv(m01_nodes_M_SC_AR_RECV),
        .M_SC_AR_req(m01_nodes_M_SC_AR_REQ),
        .M_SC_AR_send(m01_nodes_M_SC_AR_SEND),
        .M_SC_AW_info(m01_nodes_M_SC_AW_INFO),
        .M_SC_AW_payld(m01_nodes_M_SC_AW_PAYLD),
        .M_SC_AW_recv(m01_nodes_M_SC_AW_RECV),
        .M_SC_AW_req(m01_nodes_M_SC_AW_REQ),
        .M_SC_AW_send(m01_nodes_M_SC_AW_SEND),
        .M_SC_B_info(m01_nodes_M_SC_B_INFO),
        .M_SC_B_payld(m01_nodes_M_SC_B_PAYLD),
        .M_SC_B_recv(m01_nodes_M_SC_B_RECV),
        .M_SC_B_req(m01_nodes_M_SC_B_REQ),
        .M_SC_B_send(m01_nodes_M_SC_B_SEND),
        .M_SC_R_info(m01_nodes_M_SC_R_INFO),
        .M_SC_R_payld(m01_nodes_M_SC_R_PAYLD),
        .M_SC_R_recv(m01_nodes_M_SC_R_RECV),
        .M_SC_R_req(m01_nodes_M_SC_R_REQ),
        .M_SC_R_send(m01_nodes_M_SC_R_SEND),
        .M_SC_W_info(m01_nodes_M_SC_W_INFO),
        .M_SC_W_payld(m01_nodes_M_SC_W_PAYLD),
        .M_SC_W_recv(m01_nodes_M_SC_W_RECV),
        .M_SC_W_req(m01_nodes_M_SC_W_REQ),
        .M_SC_W_send(m01_nodes_M_SC_W_SEND),
        .S_SC_AR_info(S_SC_AR_3_INFO),
        .S_SC_AR_payld(S_SC_AR_3_PAYLD),
        .S_SC_AR_recv(S_SC_AR_3_RECV),
        .S_SC_AR_req(S_SC_AR_3_REQ),
        .S_SC_AR_send(S_SC_AR_3_SEND),
        .S_SC_AW_info(S_SC_AW_3_INFO),
        .S_SC_AW_payld(S_SC_AW_3_PAYLD),
        .S_SC_AW_recv(S_SC_AW_3_RECV),
        .S_SC_AW_req(S_SC_AW_3_REQ),
        .S_SC_AW_send(S_SC_AW_3_SEND),
        .S_SC_B_info(S_SC_B_3_INFO),
        .S_SC_B_payld(S_SC_B_3_PAYLD),
        .S_SC_B_recv(S_SC_B_3_RECV),
        .S_SC_B_req(S_SC_B_3_REQ),
        .S_SC_B_send(S_SC_B_3_SEND),
        .S_SC_R_info(S_SC_R_3_INFO),
        .S_SC_R_payld(S_SC_R_3_PAYLD),
        .S_SC_R_recv(S_SC_R_3_RECV),
        .S_SC_R_req(S_SC_R_3_REQ),
        .S_SC_R_send(S_SC_R_3_SEND),
        .S_SC_W_info(S_SC_W_3_INFO),
        .S_SC_W_payld(S_SC_W_3_PAYLD),
        .S_SC_W_recv(S_SC_W_3_RECV),
        .S_SC_W_req(S_SC_W_3_REQ),
        .S_SC_W_send(S_SC_W_3_SEND),
        .m_axi_aclk(clk_map_M01_ACLK),
        .m_axi_aresetn(m_axi_aresetn_1),
        .s_axi_aclk(clk_map_M00_ACLK),
        .s_axi_aresetn(clk_map_M00_ARESETN));
  bd_afc3_m01s2a_0 m01_sc2axi
       (.aclk(clk_map_M01_ACLK),
        .m_axi_araddr(m01_sc2axi_M_AXI_ARADDR),
        .m_axi_arcache(m01_sc2axi_M_AXI_ARCACHE),
        .m_axi_arid(m01_sc2axi_M_AXI_ARID),
        .m_axi_arlen(m01_sc2axi_M_AXI_ARLEN),
        .m_axi_arlock(m01_sc2axi_M_AXI_ARLOCK),
        .m_axi_arprot(m01_sc2axi_M_AXI_ARPROT),
        .m_axi_arqos(m01_sc2axi_M_AXI_ARQOS),
        .m_axi_arready(m01_sc2axi_M_AXI_ARREADY),
        .m_axi_aruser(m01_sc2axi_M_AXI_ARUSER),
        .m_axi_arvalid(m01_sc2axi_M_AXI_ARVALID),
        .m_axi_awaddr(m01_sc2axi_M_AXI_AWADDR),
        .m_axi_awcache(m01_sc2axi_M_AXI_AWCACHE),
        .m_axi_awid(m01_sc2axi_M_AXI_AWID),
        .m_axi_awlen(m01_sc2axi_M_AXI_AWLEN),
        .m_axi_awlock(m01_sc2axi_M_AXI_AWLOCK),
        .m_axi_awprot(m01_sc2axi_M_AXI_AWPROT),
        .m_axi_awqos(m01_sc2axi_M_AXI_AWQOS),
        .m_axi_awready(m01_sc2axi_M_AXI_AWREADY),
        .m_axi_awuser(m01_sc2axi_M_AXI_AWUSER),
        .m_axi_awvalid(m01_sc2axi_M_AXI_AWVALID),
        .m_axi_bid(m01_sc2axi_M_AXI_BID),
        .m_axi_bready(m01_sc2axi_M_AXI_BREADY),
        .m_axi_bresp(m01_sc2axi_M_AXI_BRESP),
        .m_axi_buser(m01_sc2axi_M_AXI_BUSER),
        .m_axi_bvalid(m01_sc2axi_M_AXI_BVALID),
        .m_axi_rdata(m01_sc2axi_M_AXI_RDATA),
        .m_axi_rid(m01_sc2axi_M_AXI_RID),
        .m_axi_rlast(m01_sc2axi_M_AXI_RLAST),
        .m_axi_rready(m01_sc2axi_M_AXI_RREADY),
        .m_axi_rresp(m01_sc2axi_M_AXI_RRESP),
        .m_axi_ruser(m01_sc2axi_M_AXI_RUSER),
        .m_axi_rvalid(m01_sc2axi_M_AXI_RVALID),
        .m_axi_wdata(m01_sc2axi_M_AXI_WDATA),
        .m_axi_wlast(m01_sc2axi_M_AXI_WLAST),
        .m_axi_wready(m01_sc2axi_M_AXI_WREADY),
        .m_axi_wstrb(m01_sc2axi_M_AXI_WSTRB),
        .m_axi_wuser(m01_sc2axi_M_AXI_WUSER),
        .m_axi_wvalid(m01_sc2axi_M_AXI_WVALID),
        .m_sc_b_info(S_SC_B_3_INFO),
        .m_sc_b_payld(S_SC_B_3_PAYLD),
        .m_sc_b_recv(S_SC_B_3_RECV),
        .m_sc_b_req(S_SC_B_3_REQ),
        .m_sc_b_send(S_SC_B_3_SEND),
        .m_sc_r_info(S_SC_R_3_INFO),
        .m_sc_r_payld(S_SC_R_3_PAYLD),
        .m_sc_r_recv(S_SC_R_3_RECV),
        .m_sc_r_req(S_SC_R_3_REQ),
        .m_sc_r_send(S_SC_R_3_SEND),
        .s_sc_ar_info(m01_nodes_M_SC_AR_INFO),
        .s_sc_ar_payld(m01_nodes_M_SC_AR_PAYLD),
        .s_sc_ar_recv(m01_nodes_M_SC_AR_RECV),
        .s_sc_ar_req(m01_nodes_M_SC_AR_REQ),
        .s_sc_ar_send(m01_nodes_M_SC_AR_SEND),
        .s_sc_aw_info(m01_nodes_M_SC_AW_INFO),
        .s_sc_aw_payld(m01_nodes_M_SC_AW_PAYLD),
        .s_sc_aw_recv(m01_nodes_M_SC_AW_RECV),
        .s_sc_aw_req(m01_nodes_M_SC_AW_REQ),
        .s_sc_aw_send(m01_nodes_M_SC_AW_SEND),
        .s_sc_w_info(m01_nodes_M_SC_W_INFO),
        .s_sc_w_payld(m01_nodes_M_SC_W_PAYLD),
        .s_sc_w_recv(m01_nodes_M_SC_W_RECV),
        .s_sc_w_req(m01_nodes_M_SC_W_REQ),
        .s_sc_w_send(m01_nodes_M_SC_W_SEND));
  bd_afc3_s00a2s_0 s00_axi2sc
       (.aclk(clk_map_S00_ACLK),
        .m_sc_ar_info(S_SC_AR_1_INFO),
        .m_sc_ar_payld(S_SC_AR_1_PAYLD),
        .m_sc_ar_recv(S_SC_AR_1_RECV),
        .m_sc_ar_req(S_SC_AR_1_REQ),
        .m_sc_ar_send(S_SC_AR_1_SEND),
        .m_sc_aw_info(S_SC_AW_1_INFO),
        .m_sc_aw_payld(S_SC_AW_1_PAYLD),
        .m_sc_aw_recv(S_SC_AW_1_RECV),
        .m_sc_aw_req(S_SC_AW_1_REQ),
        .m_sc_aw_send(S_SC_AW_1_SEND),
        .m_sc_w_info(S_SC_W_1_INFO),
        .m_sc_w_payld(S_SC_W_1_PAYLD),
        .m_sc_w_recv(S_SC_W_1_RECV),
        .m_sc_w_req(S_SC_W_1_REQ),
        .m_sc_w_send(S_SC_W_1_SEND),
        .s_axi_araddr(s00_entry_pipeline_m_axi_ARADDR),
        .s_axi_arcache(s00_entry_pipeline_m_axi_ARCACHE),
        .s_axi_arid(s00_entry_pipeline_m_axi_ARID),
        .s_axi_arlen(s00_entry_pipeline_m_axi_ARLEN),
        .s_axi_arlock(s00_entry_pipeline_m_axi_ARLOCK),
        .s_axi_arprot(s00_entry_pipeline_m_axi_ARPROT),
        .s_axi_arqos(s00_entry_pipeline_m_axi_ARQOS),
        .s_axi_arready(s00_entry_pipeline_m_axi_ARREADY),
        .s_axi_aruser(s00_entry_pipeline_m_axi_ARUSER),
        .s_axi_arvalid(s00_entry_pipeline_m_axi_ARVALID),
        .s_axi_awaddr(s00_entry_pipeline_m_axi_AWADDR),
        .s_axi_awcache(s00_entry_pipeline_m_axi_AWCACHE),
        .s_axi_awid(s00_entry_pipeline_m_axi_AWID),
        .s_axi_awlen(s00_entry_pipeline_m_axi_AWLEN),
        .s_axi_awlock(s00_entry_pipeline_m_axi_AWLOCK),
        .s_axi_awprot(s00_entry_pipeline_m_axi_AWPROT),
        .s_axi_awqos(s00_entry_pipeline_m_axi_AWQOS),
        .s_axi_awready(s00_entry_pipeline_m_axi_AWREADY),
        .s_axi_awuser(s00_entry_pipeline_m_axi_AWUSER),
        .s_axi_awvalid(s00_entry_pipeline_m_axi_AWVALID),
        .s_axi_bid(s00_entry_pipeline_m_axi_BID),
        .s_axi_bready(s00_entry_pipeline_m_axi_BREADY),
        .s_axi_bresp(s00_entry_pipeline_m_axi_BRESP),
        .s_axi_buser(s00_entry_pipeline_m_axi_BUSER),
        .s_axi_bvalid(s00_entry_pipeline_m_axi_BVALID),
        .s_axi_rdata(s00_entry_pipeline_m_axi_RDATA),
        .s_axi_rid(s00_entry_pipeline_m_axi_RID),
        .s_axi_rlast(s00_entry_pipeline_m_axi_RLAST),
        .s_axi_rready(s00_entry_pipeline_m_axi_RREADY),
        .s_axi_rresp(s00_entry_pipeline_m_axi_RRESP),
        .s_axi_ruser(s00_entry_pipeline_m_axi_RUSER),
        .s_axi_rvalid(s00_entry_pipeline_m_axi_RVALID),
        .s_axi_wdata(s00_entry_pipeline_m_axi_WDATA),
        .s_axi_wlast(s00_entry_pipeline_m_axi_WLAST),
        .s_axi_wready(s00_entry_pipeline_m_axi_WREADY),
        .s_axi_wstrb(s00_entry_pipeline_m_axi_WSTRB),
        .s_axi_wuser(s00_entry_pipeline_m_axi_WUSER),
        .s_axi_wvalid(s00_entry_pipeline_m_axi_WVALID),
        .s_sc_b_info(s00_nodes_M_SC_B_INFO),
        .s_sc_b_payld(s00_nodes_M_SC_B_PAYLD),
        .s_sc_b_recv(s00_nodes_M_SC_B_RECV),
        .s_sc_b_req(s00_nodes_M_SC_B_REQ),
        .s_sc_b_send(s00_nodes_M_SC_B_SEND),
        .s_sc_r_info(s00_nodes_M_SC_R_INFO),
        .s_sc_r_payld(s00_nodes_M_SC_R_PAYLD),
        .s_sc_r_recv(s00_nodes_M_SC_R_RECV),
        .s_sc_r_req(s00_nodes_M_SC_R_REQ),
        .s_sc_r_send(s00_nodes_M_SC_R_SEND));
  s00_entry_pipeline_imp_USCCV8 s00_entry_pipeline
       (.aclk(clk_map_S00_ACLK),
        .aresetn(clk_map_S00_ARESETN),
        .m_axi_araddr(s00_entry_pipeline_m_axi_ARADDR),
        .m_axi_arcache(s00_entry_pipeline_m_axi_ARCACHE),
        .m_axi_arid(s00_entry_pipeline_m_axi_ARID),
        .m_axi_arlen(s00_entry_pipeline_m_axi_ARLEN),
        .m_axi_arlock(s00_entry_pipeline_m_axi_ARLOCK),
        .m_axi_arprot(s00_entry_pipeline_m_axi_ARPROT),
        .m_axi_arqos(s00_entry_pipeline_m_axi_ARQOS),
        .m_axi_arready(s00_entry_pipeline_m_axi_ARREADY),
        .m_axi_aruser(s00_entry_pipeline_m_axi_ARUSER),
        .m_axi_arvalid(s00_entry_pipeline_m_axi_ARVALID),
        .m_axi_awaddr(s00_entry_pipeline_m_axi_AWADDR),
        .m_axi_awcache(s00_entry_pipeline_m_axi_AWCACHE),
        .m_axi_awid(s00_entry_pipeline_m_axi_AWID),
        .m_axi_awlen(s00_entry_pipeline_m_axi_AWLEN),
        .m_axi_awlock(s00_entry_pipeline_m_axi_AWLOCK),
        .m_axi_awprot(s00_entry_pipeline_m_axi_AWPROT),
        .m_axi_awqos(s00_entry_pipeline_m_axi_AWQOS),
        .m_axi_awready(s00_entry_pipeline_m_axi_AWREADY),
        .m_axi_awuser(s00_entry_pipeline_m_axi_AWUSER),
        .m_axi_awvalid(s00_entry_pipeline_m_axi_AWVALID),
        .m_axi_bid(s00_entry_pipeline_m_axi_BID),
        .m_axi_bready(s00_entry_pipeline_m_axi_BREADY),
        .m_axi_bresp(s00_entry_pipeline_m_axi_BRESP),
        .m_axi_buser(s00_entry_pipeline_m_axi_BUSER),
        .m_axi_bvalid(s00_entry_pipeline_m_axi_BVALID),
        .m_axi_rdata(s00_entry_pipeline_m_axi_RDATA),
        .m_axi_rid(s00_entry_pipeline_m_axi_RID),
        .m_axi_rlast(s00_entry_pipeline_m_axi_RLAST),
        .m_axi_rready(s00_entry_pipeline_m_axi_RREADY),
        .m_axi_rresp(s00_entry_pipeline_m_axi_RRESP),
        .m_axi_ruser(s00_entry_pipeline_m_axi_RUSER),
        .m_axi_rvalid(s00_entry_pipeline_m_axi_RVALID),
        .m_axi_wdata(s00_entry_pipeline_m_axi_WDATA),
        .m_axi_wlast(s00_entry_pipeline_m_axi_WLAST),
        .m_axi_wready(s00_entry_pipeline_m_axi_WREADY),
        .m_axi_wstrb(s00_entry_pipeline_m_axi_WSTRB),
        .m_axi_wuser(s00_entry_pipeline_m_axi_WUSER),
        .m_axi_wvalid(s00_entry_pipeline_m_axi_WVALID),
        .s_axi_araddr(S00_AXI_araddr),
        .s_axi_arprot(S00_AXI_arprot),
        .s_axi_arready(S00_AXI_arready),
        .s_axi_arvalid(S00_AXI_arvalid),
        .s_axi_awaddr(S00_AXI_awaddr),
        .s_axi_awprot(S00_AXI_awprot),
        .s_axi_awready(S00_AXI_awready),
        .s_axi_awvalid(S00_AXI_awvalid),
        .s_axi_bready(S00_AXI_bready),
        .s_axi_bresp(S00_AXI_bresp),
        .s_axi_bvalid(S00_AXI_bvalid),
        .s_axi_rdata(S00_AXI_rdata),
        .s_axi_rready(S00_AXI_rready),
        .s_axi_rresp(S00_AXI_rresp),
        .s_axi_rvalid(S00_AXI_rvalid),
        .s_axi_wdata(S00_AXI_wdata),
        .s_axi_wready(S00_AXI_wready),
        .s_axi_wstrb(S00_AXI_wstrb),
        .s_axi_wvalid(S00_AXI_wvalid));
  s00_nodes_imp_Y7M43I s00_nodes
       (.M_SC_AR_info(s00_nodes_M_SC_AR_INFO),
        .M_SC_AR_payld(s00_nodes_M_SC_AR_PAYLD),
        .M_SC_AR_recv(s00_nodes_M_SC_AR_RECV),
        .M_SC_AR_req(s00_nodes_M_SC_AR_REQ),
        .M_SC_AR_send(s00_nodes_M_SC_AR_SEND),
        .M_SC_AW_info(s00_nodes_M_SC_AW_INFO),
        .M_SC_AW_payld(s00_nodes_M_SC_AW_PAYLD),
        .M_SC_AW_recv(s00_nodes_M_SC_AW_RECV),
        .M_SC_AW_req(s00_nodes_M_SC_AW_REQ),
        .M_SC_AW_send(s00_nodes_M_SC_AW_SEND),
        .M_SC_B_info(s00_nodes_M_SC_B_INFO),
        .M_SC_B_payld(s00_nodes_M_SC_B_PAYLD),
        .M_SC_B_recv(s00_nodes_M_SC_B_RECV),
        .M_SC_B_req(s00_nodes_M_SC_B_REQ),
        .M_SC_B_send(s00_nodes_M_SC_B_SEND),
        .M_SC_R_info(s00_nodes_M_SC_R_INFO),
        .M_SC_R_payld(s00_nodes_M_SC_R_PAYLD),
        .M_SC_R_recv(s00_nodes_M_SC_R_RECV),
        .M_SC_R_req(s00_nodes_M_SC_R_REQ),
        .M_SC_R_send(s00_nodes_M_SC_R_SEND),
        .M_SC_W_info(s00_nodes_M_SC_W_INFO),
        .M_SC_W_payld(s00_nodes_M_SC_W_PAYLD),
        .M_SC_W_recv(s00_nodes_M_SC_W_RECV),
        .M_SC_W_req(s00_nodes_M_SC_W_REQ),
        .M_SC_W_send(s00_nodes_M_SC_W_SEND),
        .S_SC_AR_info(S_SC_AR_1_INFO),
        .S_SC_AR_payld(S_SC_AR_1_PAYLD),
        .S_SC_AR_recv(S_SC_AR_1_RECV),
        .S_SC_AR_req(S_SC_AR_1_REQ),
        .S_SC_AR_send(S_SC_AR_1_SEND),
        .S_SC_AW_info(S_SC_AW_1_INFO),
        .S_SC_AW_payld(S_SC_AW_1_PAYLD),
        .S_SC_AW_recv(S_SC_AW_1_RECV),
        .S_SC_AW_req(S_SC_AW_1_REQ),
        .S_SC_AW_send(S_SC_AW_1_SEND),
        .S_SC_B_info(S_SC_B_1_INFO),
        .S_SC_B_payld(S_SC_B_1_PAYLD),
        .S_SC_B_recv(S_SC_B_1_RECV),
        .S_SC_B_req(S_SC_B_1_REQ),
        .S_SC_B_send(S_SC_B_1_SEND),
        .S_SC_R_info(S_SC_R_1_INFO),
        .S_SC_R_payld(S_SC_R_1_PAYLD),
        .S_SC_R_recv(S_SC_R_1_RECV),
        .S_SC_R_req(S_SC_R_1_REQ),
        .S_SC_R_send(S_SC_R_1_SEND),
        .S_SC_W_info(S_SC_W_1_INFO),
        .S_SC_W_payld(S_SC_W_1_PAYLD),
        .S_SC_W_recv(S_SC_W_1_RECV),
        .S_SC_W_req(S_SC_W_1_REQ),
        .S_SC_W_send(S_SC_W_1_SEND),
        .m_sc_clk(clk_map_S00_ACLK),
        .m_sc_resetn(clk_map_S00_ARESETN),
        .s_sc_clk(clk_map_S00_ACLK),
        .s_sc_resetn(clk_map_S00_ARESETN));
  switchboards_imp_4N4PBE switchboards
       (.M00_SC_AR_info(S_SC_AR_2_INFO),
        .M00_SC_AR_payld(S_SC_AR_2_PAYLD),
        .M00_SC_AR_recv(S_SC_AR_2_RECV),
        .M00_SC_AR_req(S_SC_AR_2_REQ),
        .M00_SC_AR_send(S_SC_AR_2_SEND),
        .M00_SC_AW_info(S_SC_AW_2_INFO),
        .M00_SC_AW_payld(S_SC_AW_2_PAYLD),
        .M00_SC_AW_recv(S_SC_AW_2_RECV),
        .M00_SC_AW_req(S_SC_AW_2_REQ),
        .M00_SC_AW_send(S_SC_AW_2_SEND),
        .M00_SC_B_info(S_SC_B_1_INFO),
        .M00_SC_B_payld(S_SC_B_1_PAYLD),
        .M00_SC_B_recv(S_SC_B_1_RECV),
        .M00_SC_B_req(S_SC_B_1_REQ),
        .M00_SC_B_send(S_SC_B_1_SEND),
        .M00_SC_R_info(S_SC_R_1_INFO),
        .M00_SC_R_payld(S_SC_R_1_PAYLD),
        .M00_SC_R_recv(S_SC_R_1_RECV),
        .M00_SC_R_req(S_SC_R_1_REQ),
        .M00_SC_R_send(S_SC_R_1_SEND),
        .M00_SC_W_info(S_SC_W_2_INFO),
        .M00_SC_W_payld(S_SC_W_2_PAYLD),
        .M00_SC_W_recv(S_SC_W_2_RECV),
        .M00_SC_W_req(S_SC_W_2_REQ),
        .M00_SC_W_send(S_SC_W_2_SEND),
        .M01_SC_AR_info(S_SC_AR_3_INFO),
        .M01_SC_AR_payld(S_SC_AR_3_PAYLD),
        .M01_SC_AR_recv(S_SC_AR_3_RECV),
        .M01_SC_AR_req(S_SC_AR_3_REQ),
        .M01_SC_AR_send(S_SC_AR_3_SEND),
        .M01_SC_AW_info(S_SC_AW_3_INFO),
        .M01_SC_AW_payld(S_SC_AW_3_PAYLD),
        .M01_SC_AW_recv(S_SC_AW_3_RECV),
        .M01_SC_AW_req(S_SC_AW_3_REQ),
        .M01_SC_AW_send(S_SC_AW_3_SEND),
        .M01_SC_W_info(S_SC_W_3_INFO),
        .M01_SC_W_payld(S_SC_W_3_PAYLD),
        .M01_SC_W_recv(S_SC_W_3_RECV),
        .M01_SC_W_req(S_SC_W_3_REQ),
        .M01_SC_W_send(S_SC_W_3_SEND),
        .S00_SC_AR_info(s00_nodes_M_SC_AR_INFO),
        .S00_SC_AR_payld(s00_nodes_M_SC_AR_PAYLD),
        .S00_SC_AR_recv(s00_nodes_M_SC_AR_RECV),
        .S00_SC_AR_req(s00_nodes_M_SC_AR_REQ),
        .S00_SC_AR_send(s00_nodes_M_SC_AR_SEND),
        .S00_SC_AW_info(s00_nodes_M_SC_AW_INFO),
        .S00_SC_AW_payld(s00_nodes_M_SC_AW_PAYLD),
        .S00_SC_AW_recv(s00_nodes_M_SC_AW_RECV),
        .S00_SC_AW_req(s00_nodes_M_SC_AW_REQ),
        .S00_SC_AW_send(s00_nodes_M_SC_AW_SEND),
        .S00_SC_B_info(m00_nodes_M_SC_B_INFO),
        .S00_SC_B_payld(m00_nodes_M_SC_B_PAYLD),
        .S00_SC_B_recv(m00_nodes_M_SC_B_RECV),
        .S00_SC_B_req(m00_nodes_M_SC_B_REQ),
        .S00_SC_B_send(m00_nodes_M_SC_B_SEND),
        .S00_SC_R_info(m00_nodes_M_SC_R_INFO),
        .S00_SC_R_payld(m00_nodes_M_SC_R_PAYLD),
        .S00_SC_R_recv(m00_nodes_M_SC_R_RECV),
        .S00_SC_R_req(m00_nodes_M_SC_R_REQ),
        .S00_SC_R_send(m00_nodes_M_SC_R_SEND),
        .S00_SC_W_info(s00_nodes_M_SC_W_INFO),
        .S00_SC_W_payld(s00_nodes_M_SC_W_PAYLD),
        .S00_SC_W_recv(s00_nodes_M_SC_W_RECV),
        .S00_SC_W_req(s00_nodes_M_SC_W_REQ),
        .S00_SC_W_send(s00_nodes_M_SC_W_SEND),
        .S01_SC_B_info(m01_nodes_M_SC_B_INFO),
        .S01_SC_B_payld(m01_nodes_M_SC_B_PAYLD),
        .S01_SC_B_recv(m01_nodes_M_SC_B_RECV),
        .S01_SC_B_req(m01_nodes_M_SC_B_REQ),
        .S01_SC_B_send(m01_nodes_M_SC_B_SEND),
        .S01_SC_R_info(m01_nodes_M_SC_R_INFO),
        .S01_SC_R_payld(m01_nodes_M_SC_R_PAYLD),
        .S01_SC_R_recv(m01_nodes_M_SC_R_RECV),
        .S01_SC_R_req(m01_nodes_M_SC_R_REQ),
        .S01_SC_R_send(m01_nodes_M_SC_R_SEND),
        .m_sc_aclk(clk_map_M00_ACLK),
        .m_sc_aresetn(clk_map_M00_ARESETN),
        .s_sc_aclk(clk_map_S00_ACLK),
        .s_sc_aresetn(clk_map_S00_ARESETN));
endmodule

module clk_map_imp_5Y9LOC
   (M00_ACLK,
    M00_ARESETN,
    M01_ACLK,
    M01_ARESETN,
    S00_ACLK,
    S00_ARESETN,
    aclk,
    aresetn,
    aresetn_out,
    swbd_aclk,
    swbd_aresetn);
  output M00_ACLK;
  output [0:0]M00_ARESETN;
  output M01_ACLK;
  output [0:0]M01_ARESETN;
  output S00_ACLK;
  output [0:0]S00_ARESETN;
  input aclk;
  input aresetn;
  output aresetn_out;
  output swbd_aclk;
  output [0:0]swbd_aresetn;

  wire aresetn;
  wire [0:0]one_dout;
  wire swbd_aclk;
  wire [0:0]swbd_aresetn;

  assign M00_ACLK = swbd_aclk;
  assign M00_ARESETN[0] = swbd_aresetn;
  assign M01_ACLK = swbd_aclk;
  assign M01_ARESETN[0] = swbd_aresetn;
  assign S00_ACLK = swbd_aclk;
  assign S00_ARESETN[0] = swbd_aresetn;
  assign swbd_aclk = aclk;
  bd_afc3_one_0 one
       (.dout(one_dout));
  bd_afc3_psr_aclk_0 psr_aclk
       (.aux_reset_in(aresetn),
        .dcm_locked(1'b1),
        .ext_reset_in(one_dout),
        .interconnect_aresetn(swbd_aresetn),
        .mb_debug_sys_rst(1'b0),
        .slowest_sync_clk(swbd_aclk));
endmodule

module i_nodes_imp_1MZRIMQ
   (M_SC_AR_info,
    M_SC_AR_payld,
    M_SC_AR_recv,
    M_SC_AR_req,
    M_SC_AR_send,
    M_SC_AW_info,
    M_SC_AW_payld,
    M_SC_AW_recv,
    M_SC_AW_req,
    M_SC_AW_send,
    M_SC_B_info,
    M_SC_B_payld,
    M_SC_B_recv,
    M_SC_B_req,
    M_SC_B_send,
    M_SC_R_info,
    M_SC_R_payld,
    M_SC_R_recv,
    M_SC_R_req,
    M_SC_R_send,
    M_SC_W_info,
    M_SC_W_payld,
    M_SC_W_recv,
    M_SC_W_req,
    M_SC_W_send,
    S_SC_AR_info,
    S_SC_AR_payld,
    S_SC_AR_recv,
    S_SC_AR_req,
    S_SC_AR_send,
    S_SC_AW_info,
    S_SC_AW_payld,
    S_SC_AW_recv,
    S_SC_AW_req,
    S_SC_AW_send,
    S_SC_B_info,
    S_SC_B_payld,
    S_SC_B_recv,
    S_SC_B_req,
    S_SC_B_send,
    S_SC_R_info,
    S_SC_R_payld,
    S_SC_R_recv,
    S_SC_R_req,
    S_SC_R_send,
    S_SC_W_info,
    S_SC_W_payld,
    S_SC_W_recv,
    S_SC_W_req,
    S_SC_W_send,
    m_sc_aclk,
    m_sc_aresetn,
    s_sc_aclk,
    s_sc_aresetn);
  output [1:0]M_SC_AR_info;
  output [140:0]M_SC_AR_payld;
  input [1:0]M_SC_AR_recv;
  output [1:0]M_SC_AR_req;
  output [1:0]M_SC_AR_send;
  output [1:0]M_SC_AW_info;
  output [140:0]M_SC_AW_payld;
  input [1:0]M_SC_AW_recv;
  output [1:0]M_SC_AW_req;
  output [1:0]M_SC_AW_send;
  output [0:0]M_SC_B_info;
  output [6:0]M_SC_B_payld;
  input [0:0]M_SC_B_recv;
  output [0:0]M_SC_B_req;
  output [0:0]M_SC_B_send;
  output [0:0]M_SC_R_info;
  output [52:0]M_SC_R_payld;
  input [0:0]M_SC_R_recv;
  output [0:0]M_SC_R_req;
  output [0:0]M_SC_R_send;
  output [1:0]M_SC_W_info;
  output [54:0]M_SC_W_payld;
  input [1:0]M_SC_W_recv;
  output [1:0]M_SC_W_req;
  output [1:0]M_SC_W_send;
  input [0:0]S_SC_AR_info;
  input [140:0]S_SC_AR_payld;
  output [0:0]S_SC_AR_recv;
  input [0:0]S_SC_AR_req;
  input [0:0]S_SC_AR_send;
  input [0:0]S_SC_AW_info;
  input [140:0]S_SC_AW_payld;
  output [0:0]S_SC_AW_recv;
  input [0:0]S_SC_AW_req;
  input [0:0]S_SC_AW_send;
  input [1:0]S_SC_B_info;
  input [6:0]S_SC_B_payld;
  output [1:0]S_SC_B_recv;
  input [1:0]S_SC_B_req;
  input [1:0]S_SC_B_send;
  input [1:0]S_SC_R_info;
  input [52:0]S_SC_R_payld;
  output [1:0]S_SC_R_recv;
  input [1:0]S_SC_R_req;
  input [1:0]S_SC_R_send;
  input [0:0]S_SC_W_info;
  input [54:0]S_SC_W_payld;
  output [0:0]S_SC_W_recv;
  input [0:0]S_SC_W_req;
  input [0:0]S_SC_W_send;
  input m_sc_aclk;
  input m_sc_aresetn;
  input s_sc_aclk;
  input s_sc_aresetn;

  wire [1:0]M_SC_AR_info;
  wire [140:0]M_SC_AR_payld;
  wire [1:0]M_SC_AR_recv;
  wire [1:0]M_SC_AR_req;
  wire [1:0]M_SC_AR_send;
  wire [1:0]M_SC_AW_info;
  wire [140:0]M_SC_AW_payld;
  wire [1:0]M_SC_AW_recv;
  wire [1:0]M_SC_AW_req;
  wire [1:0]M_SC_AW_send;
  wire [0:0]M_SC_B_info;
  wire [6:0]M_SC_B_payld;
  wire [0:0]M_SC_B_recv;
  wire [0:0]M_SC_B_req;
  wire [0:0]M_SC_B_send;
  wire [0:0]M_SC_R_info;
  wire [52:0]M_SC_R_payld;
  wire [0:0]M_SC_R_recv;
  wire [0:0]M_SC_R_req;
  wire [0:0]M_SC_R_send;
  wire [1:0]M_SC_W_info;
  wire [54:0]M_SC_W_payld;
  wire [1:0]M_SC_W_recv;
  wire [1:0]M_SC_W_req;
  wire [1:0]M_SC_W_send;
  wire [0:0]S_SC_AR_info;
  wire [140:0]S_SC_AR_payld;
  wire [0:0]S_SC_AR_recv;
  wire [0:0]S_SC_AR_req;
  wire [0:0]S_SC_AR_send;
  wire [0:0]S_SC_AW_info;
  wire [140:0]S_SC_AW_payld;
  wire [0:0]S_SC_AW_recv;
  wire [0:0]S_SC_AW_req;
  wire [0:0]S_SC_AW_send;
  wire [1:0]S_SC_B_info;
  wire [6:0]S_SC_B_payld;
  wire [1:0]S_SC_B_recv;
  wire [1:0]S_SC_B_req;
  wire [1:0]S_SC_B_send;
  wire [1:0]S_SC_R_info;
  wire [52:0]S_SC_R_payld;
  wire [1:0]S_SC_R_recv;
  wire [1:0]S_SC_R_req;
  wire [1:0]S_SC_R_send;
  wire [0:0]S_SC_W_info;
  wire [54:0]S_SC_W_payld;
  wire [0:0]S_SC_W_recv;
  wire [0:0]S_SC_W_req;
  wire [0:0]S_SC_W_send;
  wire m_sc_aclk;
  wire m_sc_aresetn;
  wire s_sc_aclk;
  wire s_sc_aresetn;

  bd_afc3_arni_0 i_ar_node
       (.m_sc_aclk(m_sc_aclk),
        .m_sc_aresetn(m_sc_aresetn),
        .m_sc_info(M_SC_AR_info),
        .m_sc_payld(M_SC_AR_payld),
        .m_sc_recv(M_SC_AR_recv),
        .m_sc_req(M_SC_AR_req),
        .m_sc_send(M_SC_AR_send),
        .s_sc_aclk(s_sc_aclk),
        .s_sc_aresetn(s_sc_aresetn),
        .s_sc_info(S_SC_AR_info),
        .s_sc_payld(S_SC_AR_payld),
        .s_sc_recv(S_SC_AR_recv),
        .s_sc_req(S_SC_AR_req),
        .s_sc_send(S_SC_AR_send));
  bd_afc3_awni_0 i_aw_node
       (.m_sc_aclk(m_sc_aclk),
        .m_sc_aresetn(m_sc_aresetn),
        .m_sc_info(M_SC_AW_info),
        .m_sc_payld(M_SC_AW_payld),
        .m_sc_recv(M_SC_AW_recv),
        .m_sc_req(M_SC_AW_req),
        .m_sc_send(M_SC_AW_send),
        .s_sc_aclk(s_sc_aclk),
        .s_sc_aresetn(s_sc_aresetn),
        .s_sc_info(S_SC_AW_info),
        .s_sc_payld(S_SC_AW_payld),
        .s_sc_recv(S_SC_AW_recv),
        .s_sc_req(S_SC_AW_req),
        .s_sc_send(S_SC_AW_send));
  bd_afc3_bni_0 i_b_node
       (.m_sc_aclk(s_sc_aclk),
        .m_sc_aresetn(s_sc_aresetn),
        .m_sc_info(M_SC_B_info),
        .m_sc_payld(M_SC_B_payld),
        .m_sc_recv(M_SC_B_recv),
        .m_sc_req(M_SC_B_req),
        .m_sc_send(M_SC_B_send),
        .s_sc_aclk(m_sc_aclk),
        .s_sc_aresetn(m_sc_aresetn),
        .s_sc_info(S_SC_B_info),
        .s_sc_payld(S_SC_B_payld),
        .s_sc_recv(S_SC_B_recv),
        .s_sc_req(S_SC_B_req),
        .s_sc_send(S_SC_B_send));
  bd_afc3_rni_0 i_r_node
       (.m_sc_aclk(s_sc_aclk),
        .m_sc_aresetn(s_sc_aresetn),
        .m_sc_info(M_SC_R_info),
        .m_sc_payld(M_SC_R_payld),
        .m_sc_recv(M_SC_R_recv),
        .m_sc_req(M_SC_R_req),
        .m_sc_send(M_SC_R_send),
        .s_sc_aclk(m_sc_aclk),
        .s_sc_aresetn(m_sc_aresetn),
        .s_sc_info(S_SC_R_info),
        .s_sc_payld(S_SC_R_payld),
        .s_sc_recv(S_SC_R_recv),
        .s_sc_req(S_SC_R_req),
        .s_sc_send(S_SC_R_send));
  bd_afc3_wni_0 i_w_node
       (.m_sc_aclk(m_sc_aclk),
        .m_sc_aresetn(m_sc_aresetn),
        .m_sc_info(M_SC_W_info),
        .m_sc_payld(M_SC_W_payld),
        .m_sc_recv(M_SC_W_recv),
        .m_sc_req(M_SC_W_req),
        .m_sc_send(M_SC_W_send),
        .s_sc_aclk(s_sc_aclk),
        .s_sc_aresetn(s_sc_aresetn),
        .s_sc_info(S_SC_W_info),
        .s_sc_payld(S_SC_W_payld),
        .s_sc_recv(S_SC_W_recv),
        .s_sc_req(S_SC_W_req),
        .s_sc_send(S_SC_W_send));
endmodule

module m00_exit_pipeline_imp_1TZX5BB
   (aclk,
    aresetn,
    m_axi_araddr,
    m_axi_arprot,
    m_axi_arready,
    m_axi_arvalid,
    m_axi_awaddr,
    m_axi_awprot,
    m_axi_awready,
    m_axi_awvalid,
    m_axi_bready,
    m_axi_bresp,
    m_axi_bvalid,
    m_axi_rdata,
    m_axi_rready,
    m_axi_rresp,
    m_axi_rvalid,
    m_axi_wdata,
    m_axi_wready,
    m_axi_wstrb,
    m_axi_wvalid,
    s_axi_araddr,
    s_axi_arcache,
    s_axi_arid,
    s_axi_arlen,
    s_axi_arlock,
    s_axi_arprot,
    s_axi_arqos,
    s_axi_arready,
    s_axi_aruser,
    s_axi_arvalid,
    s_axi_awaddr,
    s_axi_awcache,
    s_axi_awid,
    s_axi_awlen,
    s_axi_awlock,
    s_axi_awprot,
    s_axi_awqos,
    s_axi_awready,
    s_axi_awuser,
    s_axi_awvalid,
    s_axi_bid,
    s_axi_bready,
    s_axi_bresp,
    s_axi_buser,
    s_axi_bvalid,
    s_axi_rdata,
    s_axi_rid,
    s_axi_rlast,
    s_axi_rready,
    s_axi_rresp,
    s_axi_ruser,
    s_axi_rvalid,
    s_axi_wdata,
    s_axi_wlast,
    s_axi_wready,
    s_axi_wstrb,
    s_axi_wuser,
    s_axi_wvalid);
  input aclk;
  input aresetn;
  output [3:0]m_axi_araddr;
  output [2:0]m_axi_arprot;
  input m_axi_arready;
  output m_axi_arvalid;
  output [3:0]m_axi_awaddr;
  output [2:0]m_axi_awprot;
  input m_axi_awready;
  output m_axi_awvalid;
  output m_axi_bready;
  input [1:0]m_axi_bresp;
  input m_axi_bvalid;
  input [31:0]m_axi_rdata;
  output m_axi_rready;
  input [1:0]m_axi_rresp;
  input m_axi_rvalid;
  output [31:0]m_axi_wdata;
  input m_axi_wready;
  output [3:0]m_axi_wstrb;
  output m_axi_wvalid;
  input [3:0]s_axi_araddr;
  input [3:0]s_axi_arcache;
  input [0:0]s_axi_arid;
  input [7:0]s_axi_arlen;
  input [0:0]s_axi_arlock;
  input [2:0]s_axi_arprot;
  input [3:0]s_axi_arqos;
  output s_axi_arready;
  input [1023:0]s_axi_aruser;
  input s_axi_arvalid;
  input [3:0]s_axi_awaddr;
  input [3:0]s_axi_awcache;
  input [0:0]s_axi_awid;
  input [7:0]s_axi_awlen;
  input [0:0]s_axi_awlock;
  input [2:0]s_axi_awprot;
  input [3:0]s_axi_awqos;
  output s_axi_awready;
  input [1023:0]s_axi_awuser;
  input s_axi_awvalid;
  output [0:0]s_axi_bid;
  input s_axi_bready;
  output [1:0]s_axi_bresp;
  output [1023:0]s_axi_buser;
  output s_axi_bvalid;
  output [31:0]s_axi_rdata;
  output [0:0]s_axi_rid;
  output s_axi_rlast;
  input s_axi_rready;
  output [1:0]s_axi_rresp;
  output [1023:0]s_axi_ruser;
  output s_axi_rvalid;
  input [31:0]s_axi_wdata;
  input s_axi_wlast;
  output s_axi_wready;
  input [3:0]s_axi_wstrb;
  input [1023:0]s_axi_wuser;
  input s_axi_wvalid;

  wire aclk;
  wire aresetn;
  wire [3:0]m_axi_araddr;
  wire [2:0]m_axi_arprot;
  wire m_axi_arready;
  wire m_axi_arvalid;
  wire [3:0]m_axi_awaddr;
  wire [2:0]m_axi_awprot;
  wire m_axi_awready;
  wire m_axi_awvalid;
  wire m_axi_bready;
  wire [1:0]m_axi_bresp;
  wire m_axi_bvalid;
  wire [31:0]m_axi_rdata;
  wire m_axi_rready;
  wire [1:0]m_axi_rresp;
  wire m_axi_rvalid;
  wire [31:0]m_axi_wdata;
  wire m_axi_wready;
  wire [3:0]m_axi_wstrb;
  wire m_axi_wvalid;
  wire [3:0]s_axi_araddr;
  wire [3:0]s_axi_arcache;
  wire [0:0]s_axi_arid;
  wire [7:0]s_axi_arlen;
  wire [0:0]s_axi_arlock;
  wire [2:0]s_axi_arprot;
  wire [3:0]s_axi_arqos;
  wire s_axi_arready;
  wire [1023:0]s_axi_aruser;
  wire s_axi_arvalid;
  wire [3:0]s_axi_awaddr;
  wire [3:0]s_axi_awcache;
  wire [0:0]s_axi_awid;
  wire [7:0]s_axi_awlen;
  wire [0:0]s_axi_awlock;
  wire [2:0]s_axi_awprot;
  wire [3:0]s_axi_awqos;
  wire s_axi_awready;
  wire [1023:0]s_axi_awuser;
  wire s_axi_awvalid;
  wire [0:0]s_axi_bid;
  wire s_axi_bready;
  wire [1:0]s_axi_bresp;
  wire [1023:0]s_axi_buser;
  wire s_axi_bvalid;
  wire [31:0]s_axi_rdata;
  wire [0:0]s_axi_rid;
  wire s_axi_rlast;
  wire s_axi_rready;
  wire [1:0]s_axi_rresp;
  wire [1023:0]s_axi_ruser;
  wire s_axi_rvalid;
  wire [31:0]s_axi_wdata;
  wire s_axi_wlast;
  wire s_axi_wready;
  wire [3:0]s_axi_wstrb;
  wire [1023:0]s_axi_wuser;
  wire s_axi_wvalid;

  bd_afc3_m00e_0 m00_exit
       (.aclk(aclk),
        .aresetn(aresetn),
        .m_axi_araddr(m_axi_araddr),
        .m_axi_arprot(m_axi_arprot),
        .m_axi_arready(m_axi_arready),
        .m_axi_arvalid(m_axi_arvalid),
        .m_axi_awaddr(m_axi_awaddr),
        .m_axi_awprot(m_axi_awprot),
        .m_axi_awready(m_axi_awready),
        .m_axi_awvalid(m_axi_awvalid),
        .m_axi_bready(m_axi_bready),
        .m_axi_bresp(m_axi_bresp),
        .m_axi_bvalid(m_axi_bvalid),
        .m_axi_rdata(m_axi_rdata),
        .m_axi_rready(m_axi_rready),
        .m_axi_rresp(m_axi_rresp),
        .m_axi_rvalid(m_axi_rvalid),
        .m_axi_wdata(m_axi_wdata),
        .m_axi_wready(m_axi_wready),
        .m_axi_wstrb(m_axi_wstrb),
        .m_axi_wvalid(m_axi_wvalid),
        .s_axi_araddr(s_axi_araddr),
        .s_axi_arcache(s_axi_arcache),
        .s_axi_arid(s_axi_arid),
        .s_axi_arlen(s_axi_arlen),
        .s_axi_arlock(s_axi_arlock),
        .s_axi_arprot(s_axi_arprot),
        .s_axi_arqos(s_axi_arqos),
        .s_axi_arready(s_axi_arready),
        .s_axi_aruser(s_axi_aruser),
        .s_axi_arvalid(s_axi_arvalid),
        .s_axi_awaddr(s_axi_awaddr),
        .s_axi_awcache(s_axi_awcache),
        .s_axi_awid(s_axi_awid),
        .s_axi_awlen(s_axi_awlen),
        .s_axi_awlock(s_axi_awlock),
        .s_axi_awprot(s_axi_awprot),
        .s_axi_awqos(s_axi_awqos),
        .s_axi_awready(s_axi_awready),
        .s_axi_awuser(s_axi_awuser),
        .s_axi_awvalid(s_axi_awvalid),
        .s_axi_bid(s_axi_bid),
        .s_axi_bready(s_axi_bready),
        .s_axi_bresp(s_axi_bresp),
        .s_axi_buser(s_axi_buser),
        .s_axi_bvalid(s_axi_bvalid),
        .s_axi_rdata(s_axi_rdata),
        .s_axi_rid(s_axi_rid),
        .s_axi_rlast(s_axi_rlast),
        .s_axi_rready(s_axi_rready),
        .s_axi_rresp(s_axi_rresp),
        .s_axi_ruser(s_axi_ruser),
        .s_axi_rvalid(s_axi_rvalid),
        .s_axi_wdata(s_axi_wdata),
        .s_axi_wlast(s_axi_wlast),
        .s_axi_wready(s_axi_wready),
        .s_axi_wstrb(s_axi_wstrb),
        .s_axi_wuser(s_axi_wuser),
        .s_axi_wvalid(s_axi_wvalid));
endmodule

module m00_nodes_imp_1GOYQYZ
   (M_SC_AR_info,
    M_SC_AR_payld,
    M_SC_AR_recv,
    M_SC_AR_req,
    M_SC_AR_send,
    M_SC_AW_info,
    M_SC_AW_payld,
    M_SC_AW_recv,
    M_SC_AW_req,
    M_SC_AW_send,
    M_SC_B_info,
    M_SC_B_payld,
    M_SC_B_recv,
    M_SC_B_req,
    M_SC_B_send,
    M_SC_R_info,
    M_SC_R_payld,
    M_SC_R_recv,
    M_SC_R_req,
    M_SC_R_send,
    M_SC_W_info,
    M_SC_W_payld,
    M_SC_W_recv,
    M_SC_W_req,
    M_SC_W_send,
    S_SC_AR_info,
    S_SC_AR_payld,
    S_SC_AR_recv,
    S_SC_AR_req,
    S_SC_AR_send,
    S_SC_AW_info,
    S_SC_AW_payld,
    S_SC_AW_recv,
    S_SC_AW_req,
    S_SC_AW_send,
    S_SC_B_info,
    S_SC_B_payld,
    S_SC_B_recv,
    S_SC_B_req,
    S_SC_B_send,
    S_SC_R_info,
    S_SC_R_payld,
    S_SC_R_recv,
    S_SC_R_req,
    S_SC_R_send,
    S_SC_W_info,
    S_SC_W_payld,
    S_SC_W_recv,
    S_SC_W_req,
    S_SC_W_send,
    m_axi_aclk,
    m_axi_aresetn,
    s_axi_aclk,
    s_axi_aresetn);
  output [0:0]M_SC_AR_info;
  output [140:0]M_SC_AR_payld;
  input [0:0]M_SC_AR_recv;
  output [0:0]M_SC_AR_req;
  output [0:0]M_SC_AR_send;
  output [0:0]M_SC_AW_info;
  output [140:0]M_SC_AW_payld;
  input [0:0]M_SC_AW_recv;
  output [0:0]M_SC_AW_req;
  output [0:0]M_SC_AW_send;
  output [0:0]M_SC_B_info;
  output [6:0]M_SC_B_payld;
  input [0:0]M_SC_B_recv;
  output [0:0]M_SC_B_req;
  output [0:0]M_SC_B_send;
  output [0:0]M_SC_R_info;
  output [52:0]M_SC_R_payld;
  input [0:0]M_SC_R_recv;
  output [0:0]M_SC_R_req;
  output [0:0]M_SC_R_send;
  output [0:0]M_SC_W_info;
  output [54:0]M_SC_W_payld;
  input [0:0]M_SC_W_recv;
  output [0:0]M_SC_W_req;
  output [0:0]M_SC_W_send;
  input [0:0]S_SC_AR_info;
  input [140:0]S_SC_AR_payld;
  output [0:0]S_SC_AR_recv;
  input [0:0]S_SC_AR_req;
  input [0:0]S_SC_AR_send;
  input [0:0]S_SC_AW_info;
  input [140:0]S_SC_AW_payld;
  output [0:0]S_SC_AW_recv;
  input [0:0]S_SC_AW_req;
  input [0:0]S_SC_AW_send;
  input [0:0]S_SC_B_info;
  input [6:0]S_SC_B_payld;
  output [0:0]S_SC_B_recv;
  input [0:0]S_SC_B_req;
  input [0:0]S_SC_B_send;
  input [0:0]S_SC_R_info;
  input [52:0]S_SC_R_payld;
  output [0:0]S_SC_R_recv;
  input [0:0]S_SC_R_req;
  input [0:0]S_SC_R_send;
  input [0:0]S_SC_W_info;
  input [54:0]S_SC_W_payld;
  output [0:0]S_SC_W_recv;
  input [0:0]S_SC_W_req;
  input [0:0]S_SC_W_send;
  input m_axi_aclk;
  input m_axi_aresetn;
  input s_axi_aclk;
  input s_axi_aresetn;

  wire [0:0]M_SC_AR_info;
  wire [140:0]M_SC_AR_payld;
  wire [0:0]M_SC_AR_recv;
  wire [0:0]M_SC_AR_req;
  wire [0:0]M_SC_AR_send;
  wire [0:0]M_SC_AW_info;
  wire [140:0]M_SC_AW_payld;
  wire [0:0]M_SC_AW_recv;
  wire [0:0]M_SC_AW_req;
  wire [0:0]M_SC_AW_send;
  wire [0:0]M_SC_B_info;
  wire [6:0]M_SC_B_payld;
  wire [0:0]M_SC_B_recv;
  wire [0:0]M_SC_B_req;
  wire [0:0]M_SC_B_send;
  wire [0:0]M_SC_R_info;
  wire [52:0]M_SC_R_payld;
  wire [0:0]M_SC_R_recv;
  wire [0:0]M_SC_R_req;
  wire [0:0]M_SC_R_send;
  wire [0:0]M_SC_W_info;
  wire [54:0]M_SC_W_payld;
  wire [0:0]M_SC_W_recv;
  wire [0:0]M_SC_W_req;
  wire [0:0]M_SC_W_send;
  wire [0:0]S_SC_AR_info;
  wire [140:0]S_SC_AR_payld;
  wire [0:0]S_SC_AR_recv;
  wire [0:0]S_SC_AR_req;
  wire [0:0]S_SC_AR_send;
  wire [0:0]S_SC_AW_info;
  wire [140:0]S_SC_AW_payld;
  wire [0:0]S_SC_AW_recv;
  wire [0:0]S_SC_AW_req;
  wire [0:0]S_SC_AW_send;
  wire [0:0]S_SC_B_info;
  wire [6:0]S_SC_B_payld;
  wire [0:0]S_SC_B_recv;
  wire [0:0]S_SC_B_req;
  wire [0:0]S_SC_B_send;
  wire [0:0]S_SC_R_info;
  wire [52:0]S_SC_R_payld;
  wire [0:0]S_SC_R_recv;
  wire [0:0]S_SC_R_req;
  wire [0:0]S_SC_R_send;
  wire [0:0]S_SC_W_info;
  wire [54:0]S_SC_W_payld;
  wire [0:0]S_SC_W_recv;
  wire [0:0]S_SC_W_req;
  wire [0:0]S_SC_W_send;
  wire m_axi_aclk;
  wire m_axi_aresetn;
  wire s_axi_aclk;
  wire s_axi_aresetn;

  bd_afc3_m00arn_0 m00_ar_node
       (.m_sc_aclk(m_axi_aclk),
        .m_sc_aresetn(m_axi_aresetn),
        .m_sc_info(M_SC_AR_info),
        .m_sc_payld(M_SC_AR_payld),
        .m_sc_recv(M_SC_AR_recv),
        .m_sc_req(M_SC_AR_req),
        .m_sc_send(M_SC_AR_send),
        .s_sc_aclk(s_axi_aclk),
        .s_sc_aresetn(s_axi_aresetn),
        .s_sc_info(S_SC_AR_info),
        .s_sc_payld(S_SC_AR_payld),
        .s_sc_recv(S_SC_AR_recv),
        .s_sc_req(S_SC_AR_req),
        .s_sc_send(S_SC_AR_send));
  bd_afc3_m00awn_0 m00_aw_node
       (.m_sc_aclk(m_axi_aclk),
        .m_sc_aresetn(m_axi_aresetn),
        .m_sc_info(M_SC_AW_info),
        .m_sc_payld(M_SC_AW_payld),
        .m_sc_recv(M_SC_AW_recv),
        .m_sc_req(M_SC_AW_req),
        .m_sc_send(M_SC_AW_send),
        .s_sc_aclk(s_axi_aclk),
        .s_sc_aresetn(s_axi_aresetn),
        .s_sc_info(S_SC_AW_info),
        .s_sc_payld(S_SC_AW_payld),
        .s_sc_recv(S_SC_AW_recv),
        .s_sc_req(S_SC_AW_req),
        .s_sc_send(S_SC_AW_send));
  bd_afc3_m00bn_0 m00_b_node
       (.m_sc_aclk(s_axi_aclk),
        .m_sc_aresetn(s_axi_aresetn),
        .m_sc_info(M_SC_B_info),
        .m_sc_payld(M_SC_B_payld),
        .m_sc_recv(M_SC_B_recv),
        .m_sc_req(M_SC_B_req),
        .m_sc_send(M_SC_B_send),
        .s_sc_aclk(m_axi_aclk),
        .s_sc_aresetn(m_axi_aresetn),
        .s_sc_info(S_SC_B_info),
        .s_sc_payld(S_SC_B_payld),
        .s_sc_recv(S_SC_B_recv),
        .s_sc_req(S_SC_B_req),
        .s_sc_send(S_SC_B_send));
  bd_afc3_m00rn_0 m00_r_node
       (.m_sc_aclk(s_axi_aclk),
        .m_sc_aresetn(s_axi_aresetn),
        .m_sc_info(M_SC_R_info),
        .m_sc_payld(M_SC_R_payld),
        .m_sc_recv(M_SC_R_recv),
        .m_sc_req(M_SC_R_req),
        .m_sc_send(M_SC_R_send),
        .s_sc_aclk(m_axi_aclk),
        .s_sc_aresetn(m_axi_aresetn),
        .s_sc_info(S_SC_R_info),
        .s_sc_payld(S_SC_R_payld),
        .s_sc_recv(S_SC_R_recv),
        .s_sc_req(S_SC_R_req),
        .s_sc_send(S_SC_R_send));
  bd_afc3_m00wn_0 m00_w_node
       (.m_sc_aclk(m_axi_aclk),
        .m_sc_aresetn(m_axi_aresetn),
        .m_sc_info(M_SC_W_info),
        .m_sc_payld(M_SC_W_payld),
        .m_sc_recv(M_SC_W_recv),
        .m_sc_req(M_SC_W_req),
        .m_sc_send(M_SC_W_send),
        .s_sc_aclk(s_axi_aclk),
        .s_sc_aresetn(s_axi_aresetn),
        .s_sc_info(S_SC_W_info),
        .s_sc_payld(S_SC_W_payld),
        .s_sc_recv(S_SC_W_recv),
        .s_sc_req(S_SC_W_req),
        .s_sc_send(S_SC_W_send));
endmodule

module m01_exit_pipeline_imp_1XMPFJB
   (aclk,
    aresetn,
    m_axi_araddr,
    m_axi_arprot,
    m_axi_arready,
    m_axi_arvalid,
    m_axi_awaddr,
    m_axi_awprot,
    m_axi_awready,
    m_axi_awvalid,
    m_axi_bready,
    m_axi_bresp,
    m_axi_bvalid,
    m_axi_rdata,
    m_axi_rready,
    m_axi_rresp,
    m_axi_rvalid,
    m_axi_wdata,
    m_axi_wready,
    m_axi_wstrb,
    m_axi_wvalid,
    s_axi_araddr,
    s_axi_arcache,
    s_axi_arid,
    s_axi_arlen,
    s_axi_arlock,
    s_axi_arprot,
    s_axi_arqos,
    s_axi_arready,
    s_axi_aruser,
    s_axi_arvalid,
    s_axi_awaddr,
    s_axi_awcache,
    s_axi_awid,
    s_axi_awlen,
    s_axi_awlock,
    s_axi_awprot,
    s_axi_awqos,
    s_axi_awready,
    s_axi_awuser,
    s_axi_awvalid,
    s_axi_bid,
    s_axi_bready,
    s_axi_bresp,
    s_axi_buser,
    s_axi_bvalid,
    s_axi_rdata,
    s_axi_rid,
    s_axi_rlast,
    s_axi_rready,
    s_axi_rresp,
    s_axi_ruser,
    s_axi_rvalid,
    s_axi_wdata,
    s_axi_wlast,
    s_axi_wready,
    s_axi_wstrb,
    s_axi_wuser,
    s_axi_wvalid);
  input aclk;
  input aresetn;
  output [5:0]m_axi_araddr;
  output [2:0]m_axi_arprot;
  input m_axi_arready;
  output m_axi_arvalid;
  output [5:0]m_axi_awaddr;
  output [2:0]m_axi_awprot;
  input m_axi_awready;
  output m_axi_awvalid;
  output m_axi_bready;
  input [1:0]m_axi_bresp;
  input m_axi_bvalid;
  input [31:0]m_axi_rdata;
  output m_axi_rready;
  input [1:0]m_axi_rresp;
  input m_axi_rvalid;
  output [31:0]m_axi_wdata;
  input m_axi_wready;
  output [3:0]m_axi_wstrb;
  output m_axi_wvalid;
  input [5:0]s_axi_araddr;
  input [3:0]s_axi_arcache;
  input [0:0]s_axi_arid;
  input [7:0]s_axi_arlen;
  input [0:0]s_axi_arlock;
  input [2:0]s_axi_arprot;
  input [3:0]s_axi_arqos;
  output s_axi_arready;
  input [1023:0]s_axi_aruser;
  input s_axi_arvalid;
  input [5:0]s_axi_awaddr;
  input [3:0]s_axi_awcache;
  input [0:0]s_axi_awid;
  input [7:0]s_axi_awlen;
  input [0:0]s_axi_awlock;
  input [2:0]s_axi_awprot;
  input [3:0]s_axi_awqos;
  output s_axi_awready;
  input [1023:0]s_axi_awuser;
  input s_axi_awvalid;
  output [0:0]s_axi_bid;
  input s_axi_bready;
  output [1:0]s_axi_bresp;
  output [1023:0]s_axi_buser;
  output s_axi_bvalid;
  output [31:0]s_axi_rdata;
  output [0:0]s_axi_rid;
  output s_axi_rlast;
  input s_axi_rready;
  output [1:0]s_axi_rresp;
  output [1023:0]s_axi_ruser;
  output s_axi_rvalid;
  input [31:0]s_axi_wdata;
  input s_axi_wlast;
  output s_axi_wready;
  input [3:0]s_axi_wstrb;
  input [1023:0]s_axi_wuser;
  input s_axi_wvalid;

  wire aclk;
  wire aresetn;
  wire [5:0]m_axi_araddr;
  wire [2:0]m_axi_arprot;
  wire m_axi_arready;
  wire m_axi_arvalid;
  wire [5:0]m_axi_awaddr;
  wire [2:0]m_axi_awprot;
  wire m_axi_awready;
  wire m_axi_awvalid;
  wire m_axi_bready;
  wire [1:0]m_axi_bresp;
  wire m_axi_bvalid;
  wire [31:0]m_axi_rdata;
  wire m_axi_rready;
  wire [1:0]m_axi_rresp;
  wire m_axi_rvalid;
  wire [31:0]m_axi_wdata;
  wire m_axi_wready;
  wire [3:0]m_axi_wstrb;
  wire m_axi_wvalid;
  wire [5:0]s_axi_araddr;
  wire [3:0]s_axi_arcache;
  wire [0:0]s_axi_arid;
  wire [7:0]s_axi_arlen;
  wire [0:0]s_axi_arlock;
  wire [2:0]s_axi_arprot;
  wire [3:0]s_axi_arqos;
  wire s_axi_arready;
  wire [1023:0]s_axi_aruser;
  wire s_axi_arvalid;
  wire [5:0]s_axi_awaddr;
  wire [3:0]s_axi_awcache;
  wire [0:0]s_axi_awid;
  wire [7:0]s_axi_awlen;
  wire [0:0]s_axi_awlock;
  wire [2:0]s_axi_awprot;
  wire [3:0]s_axi_awqos;
  wire s_axi_awready;
  wire [1023:0]s_axi_awuser;
  wire s_axi_awvalid;
  wire [0:0]s_axi_bid;
  wire s_axi_bready;
  wire [1:0]s_axi_bresp;
  wire [1023:0]s_axi_buser;
  wire s_axi_bvalid;
  wire [31:0]s_axi_rdata;
  wire [0:0]s_axi_rid;
  wire s_axi_rlast;
  wire s_axi_rready;
  wire [1:0]s_axi_rresp;
  wire [1023:0]s_axi_ruser;
  wire s_axi_rvalid;
  wire [31:0]s_axi_wdata;
  wire s_axi_wlast;
  wire s_axi_wready;
  wire [3:0]s_axi_wstrb;
  wire [1023:0]s_axi_wuser;
  wire s_axi_wvalid;

  bd_afc3_m01e_0 m01_exit
       (.aclk(aclk),
        .aresetn(aresetn),
        .m_axi_araddr(m_axi_araddr),
        .m_axi_arprot(m_axi_arprot),
        .m_axi_arready(m_axi_arready),
        .m_axi_arvalid(m_axi_arvalid),
        .m_axi_awaddr(m_axi_awaddr),
        .m_axi_awprot(m_axi_awprot),
        .m_axi_awready(m_axi_awready),
        .m_axi_awvalid(m_axi_awvalid),
        .m_axi_bready(m_axi_bready),
        .m_axi_bresp(m_axi_bresp),
        .m_axi_bvalid(m_axi_bvalid),
        .m_axi_rdata(m_axi_rdata),
        .m_axi_rready(m_axi_rready),
        .m_axi_rresp(m_axi_rresp),
        .m_axi_rvalid(m_axi_rvalid),
        .m_axi_wdata(m_axi_wdata),
        .m_axi_wready(m_axi_wready),
        .m_axi_wstrb(m_axi_wstrb),
        .m_axi_wvalid(m_axi_wvalid),
        .s_axi_araddr(s_axi_araddr),
        .s_axi_arcache(s_axi_arcache),
        .s_axi_arid(s_axi_arid),
        .s_axi_arlen(s_axi_arlen),
        .s_axi_arlock(s_axi_arlock),
        .s_axi_arprot(s_axi_arprot),
        .s_axi_arqos(s_axi_arqos),
        .s_axi_arready(s_axi_arready),
        .s_axi_aruser(s_axi_aruser),
        .s_axi_arvalid(s_axi_arvalid),
        .s_axi_awaddr(s_axi_awaddr),
        .s_axi_awcache(s_axi_awcache),
        .s_axi_awid(s_axi_awid),
        .s_axi_awlen(s_axi_awlen),
        .s_axi_awlock(s_axi_awlock),
        .s_axi_awprot(s_axi_awprot),
        .s_axi_awqos(s_axi_awqos),
        .s_axi_awready(s_axi_awready),
        .s_axi_awuser(s_axi_awuser),
        .s_axi_awvalid(s_axi_awvalid),
        .s_axi_bid(s_axi_bid),
        .s_axi_bready(s_axi_bready),
        .s_axi_bresp(s_axi_bresp),
        .s_axi_buser(s_axi_buser),
        .s_axi_bvalid(s_axi_bvalid),
        .s_axi_rdata(s_axi_rdata),
        .s_axi_rid(s_axi_rid),
        .s_axi_rlast(s_axi_rlast),
        .s_axi_rready(s_axi_rready),
        .s_axi_rresp(s_axi_rresp),
        .s_axi_ruser(s_axi_ruser),
        .s_axi_rvalid(s_axi_rvalid),
        .s_axi_wdata(s_axi_wdata),
        .s_axi_wlast(s_axi_wlast),
        .s_axi_wready(s_axi_wready),
        .s_axi_wstrb(s_axi_wstrb),
        .s_axi_wuser(s_axi_wuser),
        .s_axi_wvalid(s_axi_wvalid));
endmodule

module m01_nodes_imp_94N5OD
   (M_SC_AR_info,
    M_SC_AR_payld,
    M_SC_AR_recv,
    M_SC_AR_req,
    M_SC_AR_send,
    M_SC_AW_info,
    M_SC_AW_payld,
    M_SC_AW_recv,
    M_SC_AW_req,
    M_SC_AW_send,
    M_SC_B_info,
    M_SC_B_payld,
    M_SC_B_recv,
    M_SC_B_req,
    M_SC_B_send,
    M_SC_R_info,
    M_SC_R_payld,
    M_SC_R_recv,
    M_SC_R_req,
    M_SC_R_send,
    M_SC_W_info,
    M_SC_W_payld,
    M_SC_W_recv,
    M_SC_W_req,
    M_SC_W_send,
    S_SC_AR_info,
    S_SC_AR_payld,
    S_SC_AR_recv,
    S_SC_AR_req,
    S_SC_AR_send,
    S_SC_AW_info,
    S_SC_AW_payld,
    S_SC_AW_recv,
    S_SC_AW_req,
    S_SC_AW_send,
    S_SC_B_info,
    S_SC_B_payld,
    S_SC_B_recv,
    S_SC_B_req,
    S_SC_B_send,
    S_SC_R_info,
    S_SC_R_payld,
    S_SC_R_recv,
    S_SC_R_req,
    S_SC_R_send,
    S_SC_W_info,
    S_SC_W_payld,
    S_SC_W_recv,
    S_SC_W_req,
    S_SC_W_send,
    m_axi_aclk,
    m_axi_aresetn,
    s_axi_aclk,
    s_axi_aresetn);
  output [0:0]M_SC_AR_info;
  output [140:0]M_SC_AR_payld;
  input [0:0]M_SC_AR_recv;
  output [0:0]M_SC_AR_req;
  output [0:0]M_SC_AR_send;
  output [0:0]M_SC_AW_info;
  output [140:0]M_SC_AW_payld;
  input [0:0]M_SC_AW_recv;
  output [0:0]M_SC_AW_req;
  output [0:0]M_SC_AW_send;
  output [0:0]M_SC_B_info;
  output [6:0]M_SC_B_payld;
  input [0:0]M_SC_B_recv;
  output [0:0]M_SC_B_req;
  output [0:0]M_SC_B_send;
  output [0:0]M_SC_R_info;
  output [52:0]M_SC_R_payld;
  input [0:0]M_SC_R_recv;
  output [0:0]M_SC_R_req;
  output [0:0]M_SC_R_send;
  output [0:0]M_SC_W_info;
  output [54:0]M_SC_W_payld;
  input [0:0]M_SC_W_recv;
  output [0:0]M_SC_W_req;
  output [0:0]M_SC_W_send;
  input [0:0]S_SC_AR_info;
  input [140:0]S_SC_AR_payld;
  output [0:0]S_SC_AR_recv;
  input [0:0]S_SC_AR_req;
  input [0:0]S_SC_AR_send;
  input [0:0]S_SC_AW_info;
  input [140:0]S_SC_AW_payld;
  output [0:0]S_SC_AW_recv;
  input [0:0]S_SC_AW_req;
  input [0:0]S_SC_AW_send;
  input [0:0]S_SC_B_info;
  input [6:0]S_SC_B_payld;
  output [0:0]S_SC_B_recv;
  input [0:0]S_SC_B_req;
  input [0:0]S_SC_B_send;
  input [0:0]S_SC_R_info;
  input [52:0]S_SC_R_payld;
  output [0:0]S_SC_R_recv;
  input [0:0]S_SC_R_req;
  input [0:0]S_SC_R_send;
  input [0:0]S_SC_W_info;
  input [54:0]S_SC_W_payld;
  output [0:0]S_SC_W_recv;
  input [0:0]S_SC_W_req;
  input [0:0]S_SC_W_send;
  input m_axi_aclk;
  input m_axi_aresetn;
  input s_axi_aclk;
  input s_axi_aresetn;

  wire [0:0]M_SC_AR_info;
  wire [140:0]M_SC_AR_payld;
  wire [0:0]M_SC_AR_recv;
  wire [0:0]M_SC_AR_req;
  wire [0:0]M_SC_AR_send;
  wire [0:0]M_SC_AW_info;
  wire [140:0]M_SC_AW_payld;
  wire [0:0]M_SC_AW_recv;
  wire [0:0]M_SC_AW_req;
  wire [0:0]M_SC_AW_send;
  wire [0:0]M_SC_B_info;
  wire [6:0]M_SC_B_payld;
  wire [0:0]M_SC_B_recv;
  wire [0:0]M_SC_B_req;
  wire [0:0]M_SC_B_send;
  wire [0:0]M_SC_R_info;
  wire [52:0]M_SC_R_payld;
  wire [0:0]M_SC_R_recv;
  wire [0:0]M_SC_R_req;
  wire [0:0]M_SC_R_send;
  wire [0:0]M_SC_W_info;
  wire [54:0]M_SC_W_payld;
  wire [0:0]M_SC_W_recv;
  wire [0:0]M_SC_W_req;
  wire [0:0]M_SC_W_send;
  wire [0:0]S_SC_AR_info;
  wire [140:0]S_SC_AR_payld;
  wire [0:0]S_SC_AR_recv;
  wire [0:0]S_SC_AR_req;
  wire [0:0]S_SC_AR_send;
  wire [0:0]S_SC_AW_info;
  wire [140:0]S_SC_AW_payld;
  wire [0:0]S_SC_AW_recv;
  wire [0:0]S_SC_AW_req;
  wire [0:0]S_SC_AW_send;
  wire [0:0]S_SC_B_info;
  wire [6:0]S_SC_B_payld;
  wire [0:0]S_SC_B_recv;
  wire [0:0]S_SC_B_req;
  wire [0:0]S_SC_B_send;
  wire [0:0]S_SC_R_info;
  wire [52:0]S_SC_R_payld;
  wire [0:0]S_SC_R_recv;
  wire [0:0]S_SC_R_req;
  wire [0:0]S_SC_R_send;
  wire [0:0]S_SC_W_info;
  wire [54:0]S_SC_W_payld;
  wire [0:0]S_SC_W_recv;
  wire [0:0]S_SC_W_req;
  wire [0:0]S_SC_W_send;
  wire m_axi_aclk;
  wire m_axi_aresetn;
  wire s_axi_aclk;
  wire s_axi_aresetn;

  bd_afc3_m01arn_0 m01_ar_node
       (.m_sc_aclk(m_axi_aclk),
        .m_sc_aresetn(m_axi_aresetn),
        .m_sc_info(M_SC_AR_info),
        .m_sc_payld(M_SC_AR_payld),
        .m_sc_recv(M_SC_AR_recv),
        .m_sc_req(M_SC_AR_req),
        .m_sc_send(M_SC_AR_send),
        .s_sc_aclk(s_axi_aclk),
        .s_sc_aresetn(s_axi_aresetn),
        .s_sc_info(S_SC_AR_info),
        .s_sc_payld(S_SC_AR_payld),
        .s_sc_recv(S_SC_AR_recv),
        .s_sc_req(S_SC_AR_req),
        .s_sc_send(S_SC_AR_send));
  bd_afc3_m01awn_0 m01_aw_node
       (.m_sc_aclk(m_axi_aclk),
        .m_sc_aresetn(m_axi_aresetn),
        .m_sc_info(M_SC_AW_info),
        .m_sc_payld(M_SC_AW_payld),
        .m_sc_recv(M_SC_AW_recv),
        .m_sc_req(M_SC_AW_req),
        .m_sc_send(M_SC_AW_send),
        .s_sc_aclk(s_axi_aclk),
        .s_sc_aresetn(s_axi_aresetn),
        .s_sc_info(S_SC_AW_info),
        .s_sc_payld(S_SC_AW_payld),
        .s_sc_recv(S_SC_AW_recv),
        .s_sc_req(S_SC_AW_req),
        .s_sc_send(S_SC_AW_send));
  bd_afc3_m01bn_0 m01_b_node
       (.m_sc_aclk(s_axi_aclk),
        .m_sc_aresetn(s_axi_aresetn),
        .m_sc_info(M_SC_B_info),
        .m_sc_payld(M_SC_B_payld),
        .m_sc_recv(M_SC_B_recv),
        .m_sc_req(M_SC_B_req),
        .m_sc_send(M_SC_B_send),
        .s_sc_aclk(m_axi_aclk),
        .s_sc_aresetn(m_axi_aresetn),
        .s_sc_info(S_SC_B_info),
        .s_sc_payld(S_SC_B_payld),
        .s_sc_recv(S_SC_B_recv),
        .s_sc_req(S_SC_B_req),
        .s_sc_send(S_SC_B_send));
  bd_afc3_m01rn_0 m01_r_node
       (.m_sc_aclk(s_axi_aclk),
        .m_sc_aresetn(s_axi_aresetn),
        .m_sc_info(M_SC_R_info),
        .m_sc_payld(M_SC_R_payld),
        .m_sc_recv(M_SC_R_recv),
        .m_sc_req(M_SC_R_req),
        .m_sc_send(M_SC_R_send),
        .s_sc_aclk(m_axi_aclk),
        .s_sc_aresetn(m_axi_aresetn),
        .s_sc_info(S_SC_R_info),
        .s_sc_payld(S_SC_R_payld),
        .s_sc_recv(S_SC_R_recv),
        .s_sc_req(S_SC_R_req),
        .s_sc_send(S_SC_R_send));
  bd_afc3_m01wn_0 m01_w_node
       (.m_sc_aclk(m_axi_aclk),
        .m_sc_aresetn(m_axi_aresetn),
        .m_sc_info(M_SC_W_info),
        .m_sc_payld(M_SC_W_payld),
        .m_sc_recv(M_SC_W_recv),
        .m_sc_req(M_SC_W_req),
        .m_sc_send(M_SC_W_send),
        .s_sc_aclk(s_axi_aclk),
        .s_sc_aresetn(s_axi_aresetn),
        .s_sc_info(S_SC_W_info),
        .s_sc_payld(S_SC_W_payld),
        .s_sc_recv(S_SC_W_recv),
        .s_sc_req(S_SC_W_req),
        .s_sc_send(S_SC_W_send));
endmodule

module s00_entry_pipeline_imp_USCCV8
   (aclk,
    aresetn,
    m_axi_araddr,
    m_axi_arcache,
    m_axi_arid,
    m_axi_arlen,
    m_axi_arlock,
    m_axi_arprot,
    m_axi_arqos,
    m_axi_arready,
    m_axi_aruser,
    m_axi_arvalid,
    m_axi_awaddr,
    m_axi_awcache,
    m_axi_awid,
    m_axi_awlen,
    m_axi_awlock,
    m_axi_awprot,
    m_axi_awqos,
    m_axi_awready,
    m_axi_awuser,
    m_axi_awvalid,
    m_axi_bid,
    m_axi_bready,
    m_axi_bresp,
    m_axi_buser,
    m_axi_bvalid,
    m_axi_rdata,
    m_axi_rid,
    m_axi_rlast,
    m_axi_rready,
    m_axi_rresp,
    m_axi_ruser,
    m_axi_rvalid,
    m_axi_wdata,
    m_axi_wlast,
    m_axi_wready,
    m_axi_wstrb,
    m_axi_wuser,
    m_axi_wvalid,
    s_axi_araddr,
    s_axi_arprot,
    s_axi_arready,
    s_axi_arvalid,
    s_axi_awaddr,
    s_axi_awprot,
    s_axi_awready,
    s_axi_awvalid,
    s_axi_bready,
    s_axi_bresp,
    s_axi_bvalid,
    s_axi_rdata,
    s_axi_rready,
    s_axi_rresp,
    s_axi_rvalid,
    s_axi_wdata,
    s_axi_wready,
    s_axi_wstrb,
    s_axi_wvalid);
  input aclk;
  input aresetn;
  output [31:0]m_axi_araddr;
  output [3:0]m_axi_arcache;
  output [0:0]m_axi_arid;
  output [7:0]m_axi_arlen;
  output [0:0]m_axi_arlock;
  output [2:0]m_axi_arprot;
  output [3:0]m_axi_arqos;
  input m_axi_arready;
  output [1023:0]m_axi_aruser;
  output m_axi_arvalid;
  output [31:0]m_axi_awaddr;
  output [3:0]m_axi_awcache;
  output [0:0]m_axi_awid;
  output [7:0]m_axi_awlen;
  output [0:0]m_axi_awlock;
  output [2:0]m_axi_awprot;
  output [3:0]m_axi_awqos;
  input m_axi_awready;
  output [1023:0]m_axi_awuser;
  output m_axi_awvalid;
  input [0:0]m_axi_bid;
  output m_axi_bready;
  input [1:0]m_axi_bresp;
  input [1023:0]m_axi_buser;
  input m_axi_bvalid;
  input [31:0]m_axi_rdata;
  input [0:0]m_axi_rid;
  input m_axi_rlast;
  output m_axi_rready;
  input [1:0]m_axi_rresp;
  input [1023:0]m_axi_ruser;
  input m_axi_rvalid;
  output [31:0]m_axi_wdata;
  output m_axi_wlast;
  input m_axi_wready;
  output [3:0]m_axi_wstrb;
  output [1023:0]m_axi_wuser;
  output m_axi_wvalid;
  input [31:0]s_axi_araddr;
  input [2:0]s_axi_arprot;
  output s_axi_arready;
  input s_axi_arvalid;
  input [31:0]s_axi_awaddr;
  input [2:0]s_axi_awprot;
  output s_axi_awready;
  input s_axi_awvalid;
  input s_axi_bready;
  output [1:0]s_axi_bresp;
  output s_axi_bvalid;
  output [31:0]s_axi_rdata;
  input s_axi_rready;
  output [1:0]s_axi_rresp;
  output s_axi_rvalid;
  input [31:0]s_axi_wdata;
  output s_axi_wready;
  input [3:0]s_axi_wstrb;
  input s_axi_wvalid;

  wire aclk;
  wire aresetn;
  wire [31:0]m_axi_araddr;
  wire [3:0]m_axi_arcache;
  wire [0:0]m_axi_arid;
  wire [7:0]m_axi_arlen;
  wire [0:0]m_axi_arlock;
  wire [2:0]m_axi_arprot;
  wire [3:0]m_axi_arqos;
  wire m_axi_arready;
  wire [1023:0]m_axi_aruser;
  wire m_axi_arvalid;
  wire [31:0]m_axi_awaddr;
  wire [3:0]m_axi_awcache;
  wire [0:0]m_axi_awid;
  wire [7:0]m_axi_awlen;
  wire [0:0]m_axi_awlock;
  wire [2:0]m_axi_awprot;
  wire [3:0]m_axi_awqos;
  wire m_axi_awready;
  wire [1023:0]m_axi_awuser;
  wire m_axi_awvalid;
  wire [0:0]m_axi_bid;
  wire m_axi_bready;
  wire [1:0]m_axi_bresp;
  wire [1023:0]m_axi_buser;
  wire m_axi_bvalid;
  wire [31:0]m_axi_rdata;
  wire [0:0]m_axi_rid;
  wire m_axi_rlast;
  wire m_axi_rready;
  wire [1:0]m_axi_rresp;
  wire [1023:0]m_axi_ruser;
  wire m_axi_rvalid;
  wire [31:0]m_axi_wdata;
  wire m_axi_wlast;
  wire m_axi_wready;
  wire [3:0]m_axi_wstrb;
  wire [1023:0]m_axi_wuser;
  wire m_axi_wvalid;
  wire [31:0]s00_mmu_M_AXI_ARADDR;
  wire [1:0]s00_mmu_M_AXI_ARBURST;
  wire [3:0]s00_mmu_M_AXI_ARCACHE;
  wire [7:0]s00_mmu_M_AXI_ARLEN;
  wire [0:0]s00_mmu_M_AXI_ARLOCK;
  wire [2:0]s00_mmu_M_AXI_ARPROT;
  wire [3:0]s00_mmu_M_AXI_ARQOS;
  wire s00_mmu_M_AXI_ARREADY;
  wire [2:0]s00_mmu_M_AXI_ARSIZE;
  wire [1023:0]s00_mmu_M_AXI_ARUSER;
  wire s00_mmu_M_AXI_ARVALID;
  wire [31:0]s00_mmu_M_AXI_AWADDR;
  wire [1:0]s00_mmu_M_AXI_AWBURST;
  wire [3:0]s00_mmu_M_AXI_AWCACHE;
  wire [7:0]s00_mmu_M_AXI_AWLEN;
  wire [0:0]s00_mmu_M_AXI_AWLOCK;
  wire [2:0]s00_mmu_M_AXI_AWPROT;
  wire [3:0]s00_mmu_M_AXI_AWQOS;
  wire s00_mmu_M_AXI_AWREADY;
  wire [2:0]s00_mmu_M_AXI_AWSIZE;
  wire [1023:0]s00_mmu_M_AXI_AWUSER;
  wire s00_mmu_M_AXI_AWVALID;
  wire s00_mmu_M_AXI_BREADY;
  wire [1:0]s00_mmu_M_AXI_BRESP;
  wire [1023:0]s00_mmu_M_AXI_BUSER;
  wire s00_mmu_M_AXI_BVALID;
  wire [31:0]s00_mmu_M_AXI_RDATA;
  wire s00_mmu_M_AXI_RLAST;
  wire s00_mmu_M_AXI_RREADY;
  wire [1:0]s00_mmu_M_AXI_RRESP;
  wire [1023:0]s00_mmu_M_AXI_RUSER;
  wire s00_mmu_M_AXI_RVALID;
  wire [31:0]s00_mmu_M_AXI_WDATA;
  wire s00_mmu_M_AXI_WLAST;
  wire s00_mmu_M_AXI_WREADY;
  wire [3:0]s00_mmu_M_AXI_WSTRB;
  wire [1023:0]s00_mmu_M_AXI_WUSER;
  wire s00_mmu_M_AXI_WVALID;
  wire [31:0]s00_transaction_regulator_M_AXI_ARADDR;
  wire [3:0]s00_transaction_regulator_M_AXI_ARCACHE;
  wire [0:0]s00_transaction_regulator_M_AXI_ARID;
  wire [7:0]s00_transaction_regulator_M_AXI_ARLEN;
  wire [0:0]s00_transaction_regulator_M_AXI_ARLOCK;
  wire [2:0]s00_transaction_regulator_M_AXI_ARPROT;
  wire [3:0]s00_transaction_regulator_M_AXI_ARQOS;
  wire s00_transaction_regulator_M_AXI_ARREADY;
  wire [2:0]s00_transaction_regulator_M_AXI_ARSIZE;
  wire [1023:0]s00_transaction_regulator_M_AXI_ARUSER;
  wire s00_transaction_regulator_M_AXI_ARVALID;
  wire [31:0]s00_transaction_regulator_M_AXI_AWADDR;
  wire [3:0]s00_transaction_regulator_M_AXI_AWCACHE;
  wire [0:0]s00_transaction_regulator_M_AXI_AWID;
  wire [7:0]s00_transaction_regulator_M_AXI_AWLEN;
  wire [0:0]s00_transaction_regulator_M_AXI_AWLOCK;
  wire [2:0]s00_transaction_regulator_M_AXI_AWPROT;
  wire [3:0]s00_transaction_regulator_M_AXI_AWQOS;
  wire s00_transaction_regulator_M_AXI_AWREADY;
  wire [2:0]s00_transaction_regulator_M_AXI_AWSIZE;
  wire [1023:0]s00_transaction_regulator_M_AXI_AWUSER;
  wire s00_transaction_regulator_M_AXI_AWVALID;
  wire [0:0]s00_transaction_regulator_M_AXI_BID;
  wire s00_transaction_regulator_M_AXI_BREADY;
  wire [1:0]s00_transaction_regulator_M_AXI_BRESP;
  wire [1023:0]s00_transaction_regulator_M_AXI_BUSER;
  wire s00_transaction_regulator_M_AXI_BVALID;
  wire [31:0]s00_transaction_regulator_M_AXI_RDATA;
  wire [0:0]s00_transaction_regulator_M_AXI_RID;
  wire s00_transaction_regulator_M_AXI_RLAST;
  wire s00_transaction_regulator_M_AXI_RREADY;
  wire [1:0]s00_transaction_regulator_M_AXI_RRESP;
  wire [1023:0]s00_transaction_regulator_M_AXI_RUSER;
  wire s00_transaction_regulator_M_AXI_RVALID;
  wire [31:0]s00_transaction_regulator_M_AXI_WDATA;
  wire s00_transaction_regulator_M_AXI_WLAST;
  wire s00_transaction_regulator_M_AXI_WREADY;
  wire [3:0]s00_transaction_regulator_M_AXI_WSTRB;
  wire [1023:0]s00_transaction_regulator_M_AXI_WUSER;
  wire s00_transaction_regulator_M_AXI_WVALID;
  wire [31:0]s_axi_araddr;
  wire [2:0]s_axi_arprot;
  wire s_axi_arready;
  wire s_axi_arvalid;
  wire [31:0]s_axi_awaddr;
  wire [2:0]s_axi_awprot;
  wire s_axi_awready;
  wire s_axi_awvalid;
  wire s_axi_bready;
  wire [1:0]s_axi_bresp;
  wire s_axi_bvalid;
  wire [31:0]s_axi_rdata;
  wire s_axi_rready;
  wire [1:0]s_axi_rresp;
  wire s_axi_rvalid;
  wire [31:0]s_axi_wdata;
  wire s_axi_wready;
  wire [3:0]s_axi_wstrb;
  wire s_axi_wvalid;

  bd_afc3_s00mmu_0 s00_mmu
       (.aclk(aclk),
        .aresetn(aresetn),
        .m_axi_araddr(s00_mmu_M_AXI_ARADDR),
        .m_axi_arburst(s00_mmu_M_AXI_ARBURST),
        .m_axi_arcache(s00_mmu_M_AXI_ARCACHE),
        .m_axi_arlen(s00_mmu_M_AXI_ARLEN),
        .m_axi_arlock(s00_mmu_M_AXI_ARLOCK),
        .m_axi_arprot(s00_mmu_M_AXI_ARPROT),
        .m_axi_arqos(s00_mmu_M_AXI_ARQOS),
        .m_axi_arready(s00_mmu_M_AXI_ARREADY),
        .m_axi_arsize(s00_mmu_M_AXI_ARSIZE),
        .m_axi_aruser(s00_mmu_M_AXI_ARUSER),
        .m_axi_arvalid(s00_mmu_M_AXI_ARVALID),
        .m_axi_awaddr(s00_mmu_M_AXI_AWADDR),
        .m_axi_awburst(s00_mmu_M_AXI_AWBURST),
        .m_axi_awcache(s00_mmu_M_AXI_AWCACHE),
        .m_axi_awlen(s00_mmu_M_AXI_AWLEN),
        .m_axi_awlock(s00_mmu_M_AXI_AWLOCK),
        .m_axi_awprot(s00_mmu_M_AXI_AWPROT),
        .m_axi_awqos(s00_mmu_M_AXI_AWQOS),
        .m_axi_awready(s00_mmu_M_AXI_AWREADY),
        .m_axi_awsize(s00_mmu_M_AXI_AWSIZE),
        .m_axi_awuser(s00_mmu_M_AXI_AWUSER),
        .m_axi_awvalid(s00_mmu_M_AXI_AWVALID),
        .m_axi_bready(s00_mmu_M_AXI_BREADY),
        .m_axi_bresp(s00_mmu_M_AXI_BRESP),
        .m_axi_buser(s00_mmu_M_AXI_BUSER),
        .m_axi_bvalid(s00_mmu_M_AXI_BVALID),
        .m_axi_rdata(s00_mmu_M_AXI_RDATA),
        .m_axi_rlast(s00_mmu_M_AXI_RLAST),
        .m_axi_rready(s00_mmu_M_AXI_RREADY),
        .m_axi_rresp(s00_mmu_M_AXI_RRESP),
        .m_axi_ruser(s00_mmu_M_AXI_RUSER),
        .m_axi_rvalid(s00_mmu_M_AXI_RVALID),
        .m_axi_wdata(s00_mmu_M_AXI_WDATA),
        .m_axi_wlast(s00_mmu_M_AXI_WLAST),
        .m_axi_wready(s00_mmu_M_AXI_WREADY),
        .m_axi_wstrb(s00_mmu_M_AXI_WSTRB),
        .m_axi_wuser(s00_mmu_M_AXI_WUSER),
        .m_axi_wvalid(s00_mmu_M_AXI_WVALID),
        .s_axi_araddr(s_axi_araddr),
        .s_axi_arprot(s_axi_arprot),
        .s_axi_arready(s_axi_arready),
        .s_axi_arvalid(s_axi_arvalid),
        .s_axi_awaddr(s_axi_awaddr),
        .s_axi_awprot(s_axi_awprot),
        .s_axi_awready(s_axi_awready),
        .s_axi_awvalid(s_axi_awvalid),
        .s_axi_bready(s_axi_bready),
        .s_axi_bresp(s_axi_bresp),
        .s_axi_bvalid(s_axi_bvalid),
        .s_axi_rdata(s_axi_rdata),
        .s_axi_rready(s_axi_rready),
        .s_axi_rresp(s_axi_rresp),
        .s_axi_rvalid(s_axi_rvalid),
        .s_axi_wdata(s_axi_wdata),
        .s_axi_wready(s_axi_wready),
        .s_axi_wstrb(s_axi_wstrb),
        .s_axi_wvalid(s_axi_wvalid));
  bd_afc3_s00sic_0 s00_si_converter
       (.aclk(aclk),
        .aresetn(aresetn),
        .m_axi_araddr(m_axi_araddr),
        .m_axi_arcache(m_axi_arcache),
        .m_axi_arid(m_axi_arid),
        .m_axi_arlen(m_axi_arlen),
        .m_axi_arlock(m_axi_arlock),
        .m_axi_arprot(m_axi_arprot),
        .m_axi_arqos(m_axi_arqos),
        .m_axi_arready(m_axi_arready),
        .m_axi_aruser(m_axi_aruser),
        .m_axi_arvalid(m_axi_arvalid),
        .m_axi_awaddr(m_axi_awaddr),
        .m_axi_awcache(m_axi_awcache),
        .m_axi_awid(m_axi_awid),
        .m_axi_awlen(m_axi_awlen),
        .m_axi_awlock(m_axi_awlock),
        .m_axi_awprot(m_axi_awprot),
        .m_axi_awqos(m_axi_awqos),
        .m_axi_awready(m_axi_awready),
        .m_axi_awuser(m_axi_awuser),
        .m_axi_awvalid(m_axi_awvalid),
        .m_axi_bid(m_axi_bid),
        .m_axi_bready(m_axi_bready),
        .m_axi_bresp(m_axi_bresp),
        .m_axi_buser(m_axi_buser),
        .m_axi_bvalid(m_axi_bvalid),
        .m_axi_rdata(m_axi_rdata),
        .m_axi_rid(m_axi_rid),
        .m_axi_rlast(m_axi_rlast),
        .m_axi_rready(m_axi_rready),
        .m_axi_rresp(m_axi_rresp),
        .m_axi_ruser(m_axi_ruser),
        .m_axi_rvalid(m_axi_rvalid),
        .m_axi_wdata(m_axi_wdata),
        .m_axi_wlast(m_axi_wlast),
        .m_axi_wready(m_axi_wready),
        .m_axi_wstrb(m_axi_wstrb),
        .m_axi_wuser(m_axi_wuser),
        .m_axi_wvalid(m_axi_wvalid),
        .s_axi_araddr(s00_transaction_regulator_M_AXI_ARADDR),
        .s_axi_arcache(s00_transaction_regulator_M_AXI_ARCACHE),
        .s_axi_arid(s00_transaction_regulator_M_AXI_ARID),
        .s_axi_arlen(s00_transaction_regulator_M_AXI_ARLEN),
        .s_axi_arlock(s00_transaction_regulator_M_AXI_ARLOCK),
        .s_axi_arprot(s00_transaction_regulator_M_AXI_ARPROT),
        .s_axi_arqos(s00_transaction_regulator_M_AXI_ARQOS),
        .s_axi_arready(s00_transaction_regulator_M_AXI_ARREADY),
        .s_axi_arsize(s00_transaction_regulator_M_AXI_ARSIZE),
        .s_axi_aruser(s00_transaction_regulator_M_AXI_ARUSER),
        .s_axi_arvalid(s00_transaction_regulator_M_AXI_ARVALID),
        .s_axi_awaddr(s00_transaction_regulator_M_AXI_AWADDR),
        .s_axi_awcache(s00_transaction_regulator_M_AXI_AWCACHE),
        .s_axi_awid(s00_transaction_regulator_M_AXI_AWID),
        .s_axi_awlen(s00_transaction_regulator_M_AXI_AWLEN),
        .s_axi_awlock(s00_transaction_regulator_M_AXI_AWLOCK),
        .s_axi_awprot(s00_transaction_regulator_M_AXI_AWPROT),
        .s_axi_awqos(s00_transaction_regulator_M_AXI_AWQOS),
        .s_axi_awready(s00_transaction_regulator_M_AXI_AWREADY),
        .s_axi_awsize(s00_transaction_regulator_M_AXI_AWSIZE),
        .s_axi_awuser(s00_transaction_regulator_M_AXI_AWUSER),
        .s_axi_awvalid(s00_transaction_regulator_M_AXI_AWVALID),
        .s_axi_bid(s00_transaction_regulator_M_AXI_BID),
        .s_axi_bready(s00_transaction_regulator_M_AXI_BREADY),
        .s_axi_bresp(s00_transaction_regulator_M_AXI_BRESP),
        .s_axi_buser(s00_transaction_regulator_M_AXI_BUSER),
        .s_axi_bvalid(s00_transaction_regulator_M_AXI_BVALID),
        .s_axi_rdata(s00_transaction_regulator_M_AXI_RDATA),
        .s_axi_rid(s00_transaction_regulator_M_AXI_RID),
        .s_axi_rlast(s00_transaction_regulator_M_AXI_RLAST),
        .s_axi_rready(s00_transaction_regulator_M_AXI_RREADY),
        .s_axi_rresp(s00_transaction_regulator_M_AXI_RRESP),
        .s_axi_ruser(s00_transaction_regulator_M_AXI_RUSER),
        .s_axi_rvalid(s00_transaction_regulator_M_AXI_RVALID),
        .s_axi_wdata(s00_transaction_regulator_M_AXI_WDATA),
        .s_axi_wlast(s00_transaction_regulator_M_AXI_WLAST),
        .s_axi_wready(s00_transaction_regulator_M_AXI_WREADY),
        .s_axi_wstrb(s00_transaction_regulator_M_AXI_WSTRB),
        .s_axi_wuser(s00_transaction_regulator_M_AXI_WUSER),
        .s_axi_wvalid(s00_transaction_regulator_M_AXI_WVALID));
  bd_afc3_s00tr_0 s00_transaction_regulator
       (.aclk(aclk),
        .aresetn(aresetn),
        .m_axi_araddr(s00_transaction_regulator_M_AXI_ARADDR),
        .m_axi_arcache(s00_transaction_regulator_M_AXI_ARCACHE),
        .m_axi_arid(s00_transaction_regulator_M_AXI_ARID),
        .m_axi_arlen(s00_transaction_regulator_M_AXI_ARLEN),
        .m_axi_arlock(s00_transaction_regulator_M_AXI_ARLOCK),
        .m_axi_arprot(s00_transaction_regulator_M_AXI_ARPROT),
        .m_axi_arqos(s00_transaction_regulator_M_AXI_ARQOS),
        .m_axi_arready(s00_transaction_regulator_M_AXI_ARREADY),
        .m_axi_arsize(s00_transaction_regulator_M_AXI_ARSIZE),
        .m_axi_aruser(s00_transaction_regulator_M_AXI_ARUSER),
        .m_axi_arvalid(s00_transaction_regulator_M_AXI_ARVALID),
        .m_axi_awaddr(s00_transaction_regulator_M_AXI_AWADDR),
        .m_axi_awcache(s00_transaction_regulator_M_AXI_AWCACHE),
        .m_axi_awid(s00_transaction_regulator_M_AXI_AWID),
        .m_axi_awlen(s00_transaction_regulator_M_AXI_AWLEN),
        .m_axi_awlock(s00_transaction_regulator_M_AXI_AWLOCK),
        .m_axi_awprot(s00_transaction_regulator_M_AXI_AWPROT),
        .m_axi_awqos(s00_transaction_regulator_M_AXI_AWQOS),
        .m_axi_awready(s00_transaction_regulator_M_AXI_AWREADY),
        .m_axi_awsize(s00_transaction_regulator_M_AXI_AWSIZE),
        .m_axi_awuser(s00_transaction_regulator_M_AXI_AWUSER),
        .m_axi_awvalid(s00_transaction_regulator_M_AXI_AWVALID),
        .m_axi_bid(s00_transaction_regulator_M_AXI_BID),
        .m_axi_bready(s00_transaction_regulator_M_AXI_BREADY),
        .m_axi_bresp(s00_transaction_regulator_M_AXI_BRESP),
        .m_axi_buser(s00_transaction_regulator_M_AXI_BUSER),
        .m_axi_bvalid(s00_transaction_regulator_M_AXI_BVALID),
        .m_axi_rdata(s00_transaction_regulator_M_AXI_RDATA),
        .m_axi_rid(s00_transaction_regulator_M_AXI_RID),
        .m_axi_rlast(s00_transaction_regulator_M_AXI_RLAST),
        .m_axi_rready(s00_transaction_regulator_M_AXI_RREADY),
        .m_axi_rresp(s00_transaction_regulator_M_AXI_RRESP),
        .m_axi_ruser(s00_transaction_regulator_M_AXI_RUSER),
        .m_axi_rvalid(s00_transaction_regulator_M_AXI_RVALID),
        .m_axi_wdata(s00_transaction_regulator_M_AXI_WDATA),
        .m_axi_wlast(s00_transaction_regulator_M_AXI_WLAST),
        .m_axi_wready(s00_transaction_regulator_M_AXI_WREADY),
        .m_axi_wstrb(s00_transaction_regulator_M_AXI_WSTRB),
        .m_axi_wuser(s00_transaction_regulator_M_AXI_WUSER),
        .m_axi_wvalid(s00_transaction_regulator_M_AXI_WVALID),
        .s_axi_araddr(s00_mmu_M_AXI_ARADDR),
        .s_axi_arburst(s00_mmu_M_AXI_ARBURST),
        .s_axi_arcache(s00_mmu_M_AXI_ARCACHE),
        .s_axi_arlen(s00_mmu_M_AXI_ARLEN),
        .s_axi_arlock(s00_mmu_M_AXI_ARLOCK),
        .s_axi_arprot(s00_mmu_M_AXI_ARPROT),
        .s_axi_arqos(s00_mmu_M_AXI_ARQOS),
        .s_axi_arready(s00_mmu_M_AXI_ARREADY),
        .s_axi_arsize(s00_mmu_M_AXI_ARSIZE),
        .s_axi_aruser(s00_mmu_M_AXI_ARUSER),
        .s_axi_arvalid(s00_mmu_M_AXI_ARVALID),
        .s_axi_awaddr(s00_mmu_M_AXI_AWADDR),
        .s_axi_awburst(s00_mmu_M_AXI_AWBURST),
        .s_axi_awcache(s00_mmu_M_AXI_AWCACHE),
        .s_axi_awlen(s00_mmu_M_AXI_AWLEN),
        .s_axi_awlock(s00_mmu_M_AXI_AWLOCK),
        .s_axi_awprot(s00_mmu_M_AXI_AWPROT),
        .s_axi_awqos(s00_mmu_M_AXI_AWQOS),
        .s_axi_awready(s00_mmu_M_AXI_AWREADY),
        .s_axi_awsize(s00_mmu_M_AXI_AWSIZE),
        .s_axi_awuser(s00_mmu_M_AXI_AWUSER),
        .s_axi_awvalid(s00_mmu_M_AXI_AWVALID),
        .s_axi_bready(s00_mmu_M_AXI_BREADY),
        .s_axi_bresp(s00_mmu_M_AXI_BRESP),
        .s_axi_buser(s00_mmu_M_AXI_BUSER),
        .s_axi_bvalid(s00_mmu_M_AXI_BVALID),
        .s_axi_rdata(s00_mmu_M_AXI_RDATA),
        .s_axi_rlast(s00_mmu_M_AXI_RLAST),
        .s_axi_rready(s00_mmu_M_AXI_RREADY),
        .s_axi_rresp(s00_mmu_M_AXI_RRESP),
        .s_axi_ruser(s00_mmu_M_AXI_RUSER),
        .s_axi_rvalid(s00_mmu_M_AXI_RVALID),
        .s_axi_wdata(s00_mmu_M_AXI_WDATA),
        .s_axi_wlast(s00_mmu_M_AXI_WLAST),
        .s_axi_wready(s00_mmu_M_AXI_WREADY),
        .s_axi_wstrb(s00_mmu_M_AXI_WSTRB),
        .s_axi_wuser(s00_mmu_M_AXI_WUSER),
        .s_axi_wvalid(s00_mmu_M_AXI_WVALID));
endmodule

module s00_nodes_imp_Y7M43I
   (M_SC_AR_info,
    M_SC_AR_payld,
    M_SC_AR_recv,
    M_SC_AR_req,
    M_SC_AR_send,
    M_SC_AW_info,
    M_SC_AW_payld,
    M_SC_AW_recv,
    M_SC_AW_req,
    M_SC_AW_send,
    M_SC_B_info,
    M_SC_B_payld,
    M_SC_B_recv,
    M_SC_B_req,
    M_SC_B_send,
    M_SC_R_info,
    M_SC_R_payld,
    M_SC_R_recv,
    M_SC_R_req,
    M_SC_R_send,
    M_SC_W_info,
    M_SC_W_payld,
    M_SC_W_recv,
    M_SC_W_req,
    M_SC_W_send,
    S_SC_AR_info,
    S_SC_AR_payld,
    S_SC_AR_recv,
    S_SC_AR_req,
    S_SC_AR_send,
    S_SC_AW_info,
    S_SC_AW_payld,
    S_SC_AW_recv,
    S_SC_AW_req,
    S_SC_AW_send,
    S_SC_B_info,
    S_SC_B_payld,
    S_SC_B_recv,
    S_SC_B_req,
    S_SC_B_send,
    S_SC_R_info,
    S_SC_R_payld,
    S_SC_R_recv,
    S_SC_R_req,
    S_SC_R_send,
    S_SC_W_info,
    S_SC_W_payld,
    S_SC_W_recv,
    S_SC_W_req,
    S_SC_W_send,
    m_sc_clk,
    m_sc_resetn,
    s_sc_clk,
    s_sc_resetn);
  output [0:0]M_SC_AR_info;
  output [140:0]M_SC_AR_payld;
  input [0:0]M_SC_AR_recv;
  output [0:0]M_SC_AR_req;
  output [0:0]M_SC_AR_send;
  output [0:0]M_SC_AW_info;
  output [140:0]M_SC_AW_payld;
  input [0:0]M_SC_AW_recv;
  output [0:0]M_SC_AW_req;
  output [0:0]M_SC_AW_send;
  output [0:0]M_SC_B_info;
  output [6:0]M_SC_B_payld;
  input [0:0]M_SC_B_recv;
  output [0:0]M_SC_B_req;
  output [0:0]M_SC_B_send;
  output [0:0]M_SC_R_info;
  output [52:0]M_SC_R_payld;
  input [0:0]M_SC_R_recv;
  output [0:0]M_SC_R_req;
  output [0:0]M_SC_R_send;
  output [0:0]M_SC_W_info;
  output [54:0]M_SC_W_payld;
  input [0:0]M_SC_W_recv;
  output [0:0]M_SC_W_req;
  output [0:0]M_SC_W_send;
  input [0:0]S_SC_AR_info;
  input [140:0]S_SC_AR_payld;
  output [0:0]S_SC_AR_recv;
  input [0:0]S_SC_AR_req;
  input [0:0]S_SC_AR_send;
  input [0:0]S_SC_AW_info;
  input [140:0]S_SC_AW_payld;
  output [0:0]S_SC_AW_recv;
  input [0:0]S_SC_AW_req;
  input [0:0]S_SC_AW_send;
  input [0:0]S_SC_B_info;
  input [6:0]S_SC_B_payld;
  output [0:0]S_SC_B_recv;
  input [0:0]S_SC_B_req;
  input [0:0]S_SC_B_send;
  input [0:0]S_SC_R_info;
  input [52:0]S_SC_R_payld;
  output [0:0]S_SC_R_recv;
  input [0:0]S_SC_R_req;
  input [0:0]S_SC_R_send;
  input [0:0]S_SC_W_info;
  input [54:0]S_SC_W_payld;
  output [0:0]S_SC_W_recv;
  input [0:0]S_SC_W_req;
  input [0:0]S_SC_W_send;
  input m_sc_clk;
  input m_sc_resetn;
  input s_sc_clk;
  input s_sc_resetn;

  wire [0:0]M_SC_AR_info;
  wire [140:0]M_SC_AR_payld;
  wire [0:0]M_SC_AR_recv;
  wire [0:0]M_SC_AR_req;
  wire [0:0]M_SC_AR_send;
  wire [0:0]M_SC_AW_info;
  wire [140:0]M_SC_AW_payld;
  wire [0:0]M_SC_AW_recv;
  wire [0:0]M_SC_AW_req;
  wire [0:0]M_SC_AW_send;
  wire [0:0]M_SC_B_info;
  wire [6:0]M_SC_B_payld;
  wire [0:0]M_SC_B_recv;
  wire [0:0]M_SC_B_req;
  wire [0:0]M_SC_B_send;
  wire [0:0]M_SC_R_info;
  wire [52:0]M_SC_R_payld;
  wire [0:0]M_SC_R_recv;
  wire [0:0]M_SC_R_req;
  wire [0:0]M_SC_R_send;
  wire [0:0]M_SC_W_info;
  wire [54:0]M_SC_W_payld;
  wire [0:0]M_SC_W_recv;
  wire [0:0]M_SC_W_req;
  wire [0:0]M_SC_W_send;
  wire [0:0]S_SC_AR_info;
  wire [140:0]S_SC_AR_payld;
  wire [0:0]S_SC_AR_recv;
  wire [0:0]S_SC_AR_req;
  wire [0:0]S_SC_AR_send;
  wire [0:0]S_SC_AW_info;
  wire [140:0]S_SC_AW_payld;
  wire [0:0]S_SC_AW_recv;
  wire [0:0]S_SC_AW_req;
  wire [0:0]S_SC_AW_send;
  wire [0:0]S_SC_B_info;
  wire [6:0]S_SC_B_payld;
  wire [0:0]S_SC_B_recv;
  wire [0:0]S_SC_B_req;
  wire [0:0]S_SC_B_send;
  wire [0:0]S_SC_R_info;
  wire [52:0]S_SC_R_payld;
  wire [0:0]S_SC_R_recv;
  wire [0:0]S_SC_R_req;
  wire [0:0]S_SC_R_send;
  wire [0:0]S_SC_W_info;
  wire [54:0]S_SC_W_payld;
  wire [0:0]S_SC_W_recv;
  wire [0:0]S_SC_W_req;
  wire [0:0]S_SC_W_send;
  wire m_sc_clk;
  wire m_sc_resetn;
  wire s_sc_clk;
  wire s_sc_resetn;

  bd_afc3_sarn_0 s00_ar_node
       (.m_sc_aclk(m_sc_clk),
        .m_sc_aresetn(m_sc_resetn),
        .m_sc_info(M_SC_AR_info),
        .m_sc_payld(M_SC_AR_payld),
        .m_sc_recv(M_SC_AR_recv),
        .m_sc_req(M_SC_AR_req),
        .m_sc_send(M_SC_AR_send),
        .s_sc_aclk(s_sc_clk),
        .s_sc_aresetn(s_sc_resetn),
        .s_sc_info(S_SC_AR_info),
        .s_sc_payld(S_SC_AR_payld),
        .s_sc_recv(S_SC_AR_recv),
        .s_sc_req(S_SC_AR_req),
        .s_sc_send(S_SC_AR_send));
  bd_afc3_sawn_0 s00_aw_node
       (.m_sc_aclk(m_sc_clk),
        .m_sc_aresetn(m_sc_resetn),
        .m_sc_info(M_SC_AW_info),
        .m_sc_payld(M_SC_AW_payld),
        .m_sc_recv(M_SC_AW_recv),
        .m_sc_req(M_SC_AW_req),
        .m_sc_send(M_SC_AW_send),
        .s_sc_aclk(s_sc_clk),
        .s_sc_aresetn(s_sc_resetn),
        .s_sc_info(S_SC_AW_info),
        .s_sc_payld(S_SC_AW_payld),
        .s_sc_recv(S_SC_AW_recv),
        .s_sc_req(S_SC_AW_req),
        .s_sc_send(S_SC_AW_send));
  bd_afc3_sbn_0 s00_b_node
       (.m_sc_aclk(s_sc_clk),
        .m_sc_aresetn(s_sc_resetn),
        .m_sc_info(M_SC_B_info),
        .m_sc_payld(M_SC_B_payld),
        .m_sc_recv(M_SC_B_recv),
        .m_sc_req(M_SC_B_req),
        .m_sc_send(M_SC_B_send),
        .s_sc_aclk(m_sc_clk),
        .s_sc_aresetn(m_sc_resetn),
        .s_sc_info(S_SC_B_info),
        .s_sc_payld(S_SC_B_payld),
        .s_sc_recv(S_SC_B_recv),
        .s_sc_req(S_SC_B_req),
        .s_sc_send(S_SC_B_send));
  bd_afc3_srn_0 s00_r_node
       (.m_sc_aclk(s_sc_clk),
        .m_sc_aresetn(s_sc_resetn),
        .m_sc_info(M_SC_R_info),
        .m_sc_payld(M_SC_R_payld),
        .m_sc_recv(M_SC_R_recv),
        .m_sc_req(M_SC_R_req),
        .m_sc_send(M_SC_R_send),
        .s_sc_aclk(m_sc_clk),
        .s_sc_aresetn(m_sc_resetn),
        .s_sc_info(S_SC_R_info),
        .s_sc_payld(S_SC_R_payld),
        .s_sc_recv(S_SC_R_recv),
        .s_sc_req(S_SC_R_req),
        .s_sc_send(S_SC_R_send));
  bd_afc3_swn_0 s00_w_node
       (.m_sc_aclk(m_sc_clk),
        .m_sc_aresetn(m_sc_resetn),
        .m_sc_info(M_SC_W_info),
        .m_sc_payld(M_SC_W_payld),
        .m_sc_recv(M_SC_W_recv),
        .m_sc_req(M_SC_W_req),
        .m_sc_send(M_SC_W_send),
        .s_sc_aclk(s_sc_clk),
        .s_sc_aresetn(s_sc_resetn),
        .s_sc_info(S_SC_W_info),
        .s_sc_payld(S_SC_W_payld),
        .s_sc_recv(S_SC_W_recv),
        .s_sc_req(S_SC_W_req),
        .s_sc_send(S_SC_W_send));
endmodule
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
