MarinGE23/axi-plpuf-ip/vivado-axi-plpuf/vivado-axi-plpuf.cache/ip/2025.1/2/3/23ae9a1a58d5b7ce/design_1_rst_clk_wiz_0_100M_0_stub.vhdl

-- Copyright 1986-2022 Xilinx, Inc. All Rights Reserved.
-- Copyright 2022-2025 Advanced Micro Devices, Inc. All Rights Reserved.
-- --------------------------------------------------------------------------------
-- Tool Version: Vivado v.2025.1 (win64) Build 6140274 Thu May 22 00:12:29 MDT 2025
-- Date        : Thu Apr  2 01:05:10 2026
-- Host        : Emanuel running 64-bit major release  (build 9200)
-- Command     : write_vhdl -force -mode synth_stub -rename_top decalper_eb_ot_sdeen_pot_pi_dehcac_xnilix -prefix
--               decalper_eb_ot_sdeen_pot_pi_dehcac_xnilix_ design_1_rst_clk_wiz_0_100M_0_stub.vhdl
-- Design      : design_1_rst_clk_wiz_0_100M_0
-- Purpose     : Stub declaration of top-level module interface
-- Device      : xc7a35tcpg236-1
-- --------------------------------------------------------------------------------
library IEEE;
use IEEE.STD_LOGIC_1164.ALL;

entity decalper_eb_ot_sdeen_pot_pi_dehcac_xnilix is
  Port ( 
    slowest_sync_clk : in STD_LOGIC;
    ext_reset_in : in STD_LOGIC;
    aux_reset_in : in STD_LOGIC;
    mb_debug_sys_rst : in STD_LOGIC;
    dcm_locked : in STD_LOGIC;
    mb_reset : out STD_LOGIC;
    bus_struct_reset : out STD_LOGIC_VECTOR ( 0 to 0 );
    peripheral_reset : out STD_LOGIC_VECTOR ( 0 to 0 );
    interconnect_aresetn : out STD_LOGIC_VECTOR ( 0 to 0 );
    peripheral_aresetn : out STD_LOGIC_VECTOR ( 0 to 0 )
  );

  attribute CHECK_LICENSE_TYPE : string;
  attribute CHECK_LICENSE_TYPE of decalper_eb_ot_sdeen_pot_pi_dehcac_xnilix : entity is "design_1_rst_clk_wiz_0_100M_0,proc_sys_reset,{}";
  attribute core_generation_info : string;
  attribute core_generation_info of decalper_eb_ot_sdeen_pot_pi_dehcac_xnilix : entity is "design_1_rst_clk_wiz_0_100M_0,proc_sys_reset,{x_ipProduct=Vivado 2025.1,x_ipVendor=xilinx.com,x_ipLibrary=ip,x_ipName=proc_sys_reset,x_ipVersion=5.0,x_ipCoreRevision=17,x_ipLanguage=VERILOG,x_ipSimLanguage=MIXED,C_FAMILY=artix7,C_EXT_RST_WIDTH=4,C_AUX_RST_WIDTH=4,C_EXT_RESET_HIGH=1,C_AUX_RESET_HIGH=0,C_NUM_BUS_RST=1,C_NUM_PERP_RST=1,C_NUM_INTERCONNECT_ARESETN=1,C_NUM_PERP_ARESETN=1}";
  attribute downgradeipidentifiedwarnings : string;
  attribute downgradeipidentifiedwarnings of decalper_eb_ot_sdeen_pot_pi_dehcac_xnilix : entity is "yes";
end decalper_eb_ot_sdeen_pot_pi_dehcac_xnilix;

architecture stub of decalper_eb_ot_sdeen_pot_pi_dehcac_xnilix is
  attribute syn_black_box : boolean;
  attribute black_box_pad_pin : string;
  attribute syn_black_box of stub : architecture is true;
  attribute black_box_pad_pin of stub : architecture is "slowest_sync_clk,ext_reset_in,aux_reset_in,mb_debug_sys_rst,dcm_locked,mb_reset,bus_struct_reset[0:0],peripheral_reset[0:0],interconnect_aresetn[0:0],peripheral_aresetn[0:0]";
  attribute x_interface_info : string;
  attribute x_interface_info of slowest_sync_clk : signal is "xilinx.com:signal:clock:1.0 clock CLK";
  attribute x_interface_mode : string;
  attribute x_interface_mode of slowest_sync_clk : signal is "slave clock";
  attribute x_interface_parameter : string;
  attribute x_interface_parameter of slowest_sync_clk : signal is "XIL_INTERFACENAME clock, ASSOCIATED_RESET mb_reset:bus_struct_reset:interconnect_aresetn:peripheral_aresetn:peripheral_reset, FREQ_HZ 100000000, FREQ_TOLERANCE_HZ 0, PHASE 0.0, CLK_DOMAIN /clk_wiz_0_clk_out1, INSERT_VIP 0";
  attribute x_interface_info of ext_reset_in : signal is "xilinx.com:signal:reset:1.0 ext_reset RST";
  attribute x_interface_mode of ext_reset_in : signal is "slave ext_reset";
  attribute x_interface_parameter of ext_reset_in : signal is "XIL_INTERFACENAME ext_reset, BOARD.ASSOCIATED_PARAM RESET_BOARD_INTERFACE, POLARITY ACTIVE_HIGH, INSERT_VIP 0";
  attribute x_interface_info of aux_reset_in : signal is "xilinx.com:signal:reset:1.0 aux_reset RST";
  attribute x_interface_mode of aux_reset_in : signal is "slave aux_reset";
  attribute x_interface_parameter of aux_reset_in : signal is "XIL_INTERFACENAME aux_reset, POLARITY ACTIVE_LOW, INSERT_VIP 0";
  attribute x_interface_info of mb_debug_sys_rst : signal is "xilinx.com:signal:reset:1.0 dbg_reset RST";
  attribute x_interface_mode of mb_debug_sys_rst : signal is "slave dbg_reset";
  attribute x_interface_parameter of mb_debug_sys_rst : signal is "XIL_INTERFACENAME dbg_reset, POLARITY ACTIVE_HIGH, INSERT_VIP 0";
  attribute x_interface_info of mb_reset : signal is "xilinx.com:signal:reset:1.0 mb_rst RST";
  attribute x_interface_mode of mb_reset : signal is "master mb_rst";
  attribute x_interface_parameter of mb_reset : signal is "XIL_INTERFACENAME mb_rst, POLARITY ACTIVE_HIGH, TYPE PROCESSOR, INSERT_VIP 0";
  attribute x_interface_info of bus_struct_reset : signal is "xilinx.com:signal:reset:1.0 bus_struct_reset RST";
  attribute x_interface_mode of bus_struct_reset : signal is "master bus_struct_reset";
  attribute x_interface_parameter of bus_struct_reset : signal is "XIL_INTERFACENAME bus_struct_reset, POLARITY ACTIVE_HIGH, TYPE INTERCONNECT, INSERT_VIP 0";
  attribute x_interface_info of peripheral_reset : signal is "xilinx.com:signal:reset:1.0 peripheral_high_rst RST";
  attribute x_interface_mode of peripheral_reset : signal is "master peripheral_high_rst";
  attribute x_interface_parameter of peripheral_reset : signal is "XIL_INTERFACENAME peripheral_high_rst, POLARITY ACTIVE_HIGH, TYPE PERIPHERAL, INSERT_VIP 0";
  attribute x_interface_info of interconnect_aresetn : signal is "xilinx.com:signal:reset:1.0 interconnect_low_rst RST";
  attribute x_interface_mode of interconnect_aresetn : signal is "master interconnect_low_rst";
  attribute x_interface_parameter of interconnect_aresetn : signal is "XIL_INTERFACENAME interconnect_low_rst, POLARITY ACTIVE_LOW, TYPE INTERCONNECT, INSERT_VIP 0";
  attribute x_interface_info of peripheral_aresetn : signal is "xilinx.com:signal:reset:1.0 peripheral_low_rst RST";
  attribute x_interface_mode of peripheral_aresetn : signal is "master peripheral_low_rst";
  attribute x_interface_parameter of peripheral_aresetn : signal is "XIL_INTERFACENAME peripheral_low_rst, POLARITY ACTIVE_LOW, TYPE PERIPHERAL, INSERT_VIP 0";
  attribute x_core_info : string;
  attribute x_core_info of stub : architecture is "proc_sys_reset,Vivado 2025.1";
begin
end;
