MarinGE23/axi-plpuf-ip/(commit log)

2026-04-02 Added PLPUF AXI4-Lite IP core with Vivado/Vitis projects and validation tests
    [cmake_lib_configs.txt]
2026-05-19 Theoretical framework
2026-05-19 Methodological framework
